infomueblesgacela/muebles-gacela-mvp/public/modelos_3d/linea-nordik/A732330/pasos/instructivo-caja-minifix.webp

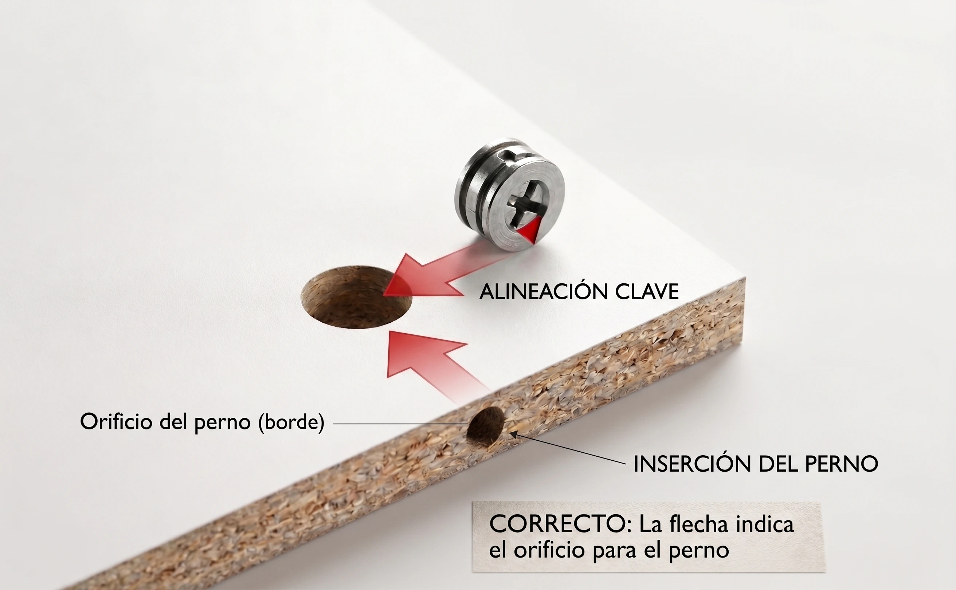
public/modelos_3d/linea-nordik/A732330/pasos/instructivo-caja-minifix.webp
