infomueblesgacela/muebles-gacela-mvp/herrajes/Pasados/cola.png

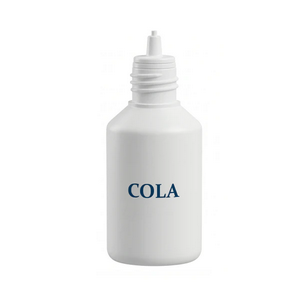
herrajes/Pasados/cola.png
