infomueblesgacela/muebles-gacela-mvp/herrajes/Pasados/manija-con-tornillos-de-3-cm.png

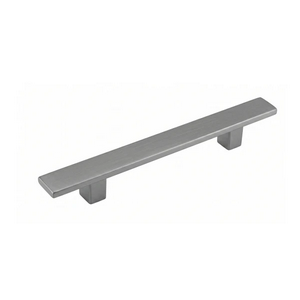
herrajes/Pasados/manija-con-tornillos-de-3-cm.png
