infomueblesgacela/muebles-gacela-mvp/image_0.jpg

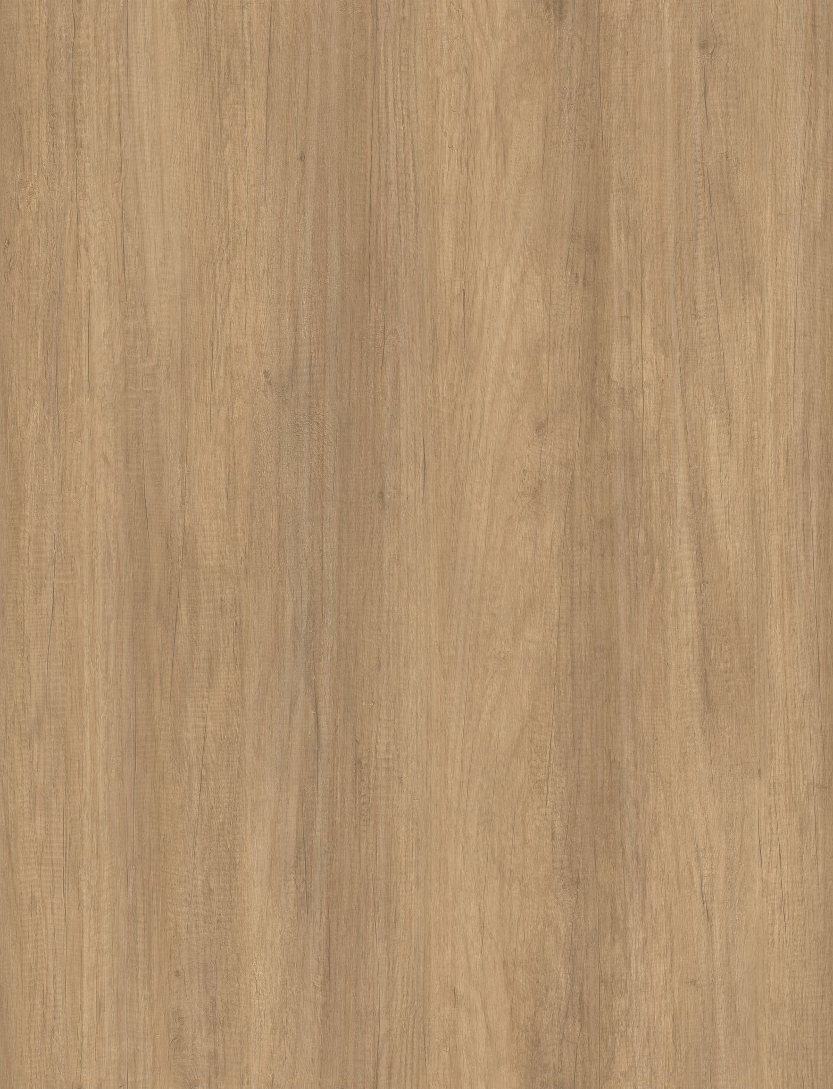
image_0.jpg
