infomueblesgacela/muebles-gacela-mvp/modelos_3d/linea-clasica/A009022/herrajes/tornillo-4-30.webp

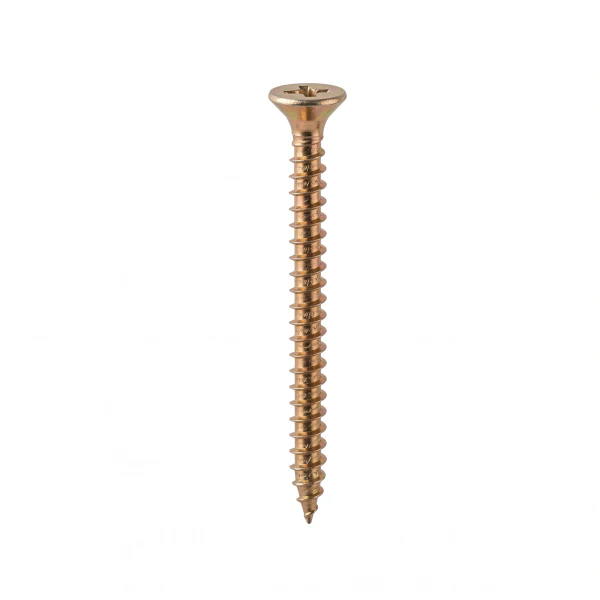
modelos_3d/linea-clasica/A009022/herrajes/tornillo-4-30.webp
