infomueblesgacela/muebles-gacela-mvp/modelos_3d/linea-clasica/A009022/herramientas/destornillador.webp

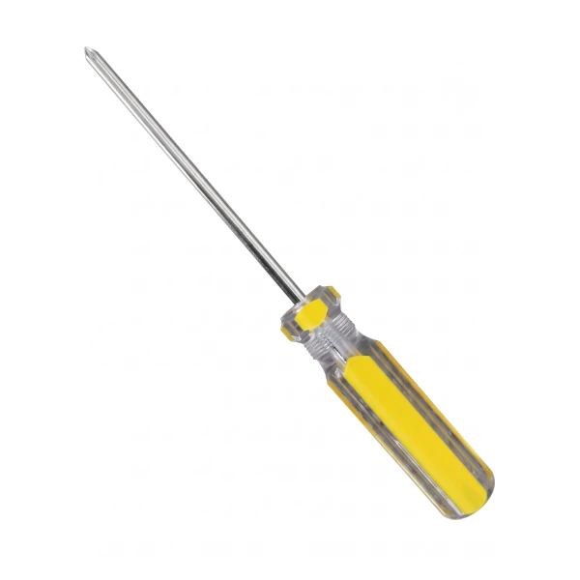
modelos_3d/linea-clasica/A009022/herramientas/destornillador.webp
