infomueblesgacela/muebles-gacela-mvp/modelos_3d/linea-clasica/A710150/herrajes/set-clavos.webp

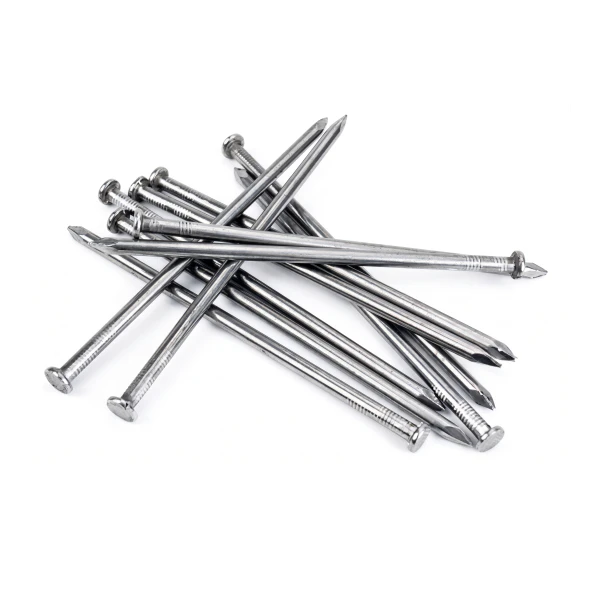
modelos_3d/linea-clasica/A710150/herrajes/set-clavos.webp
