infomueblesgacela/muebles-gacela-mvp/modelos_3d/linea-clasica/A710150/herrajes/tarugo-6-30.webp

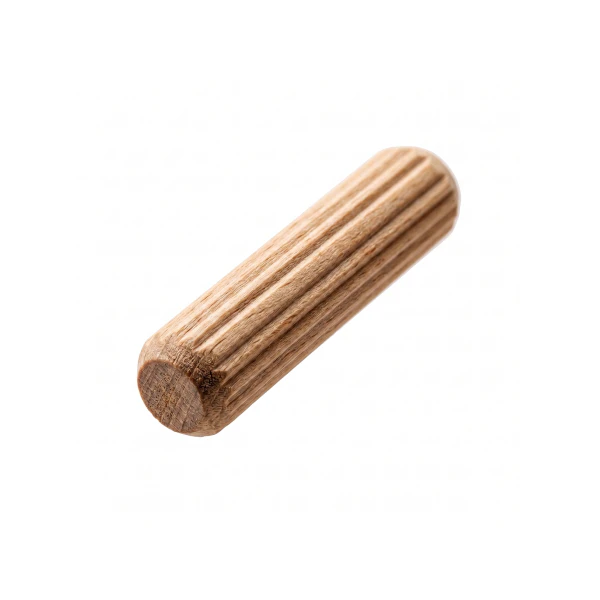
modelos_3d/linea-clasica/A710150/herrajes/tarugo-6-30.webp
