infomueblesgacela/muebles-gacela-mvp/modelos_3d/linea-clasica/A712151/herrajes/guias-metalicas.webp

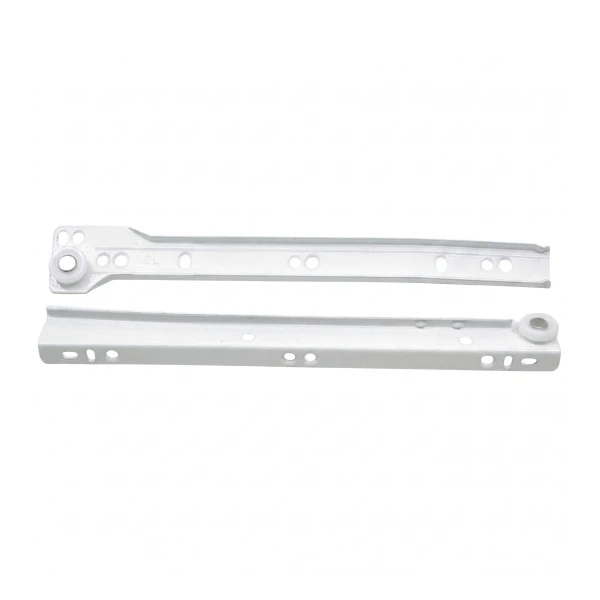
modelos_3d/linea-clasica/A712151/herrajes/guias-metalicas.webp
