infomueblesgacela/muebles-gacela-mvp/modelos_3d/linea-curvalba/A742272/herrajes/escuadra_plastica.webp

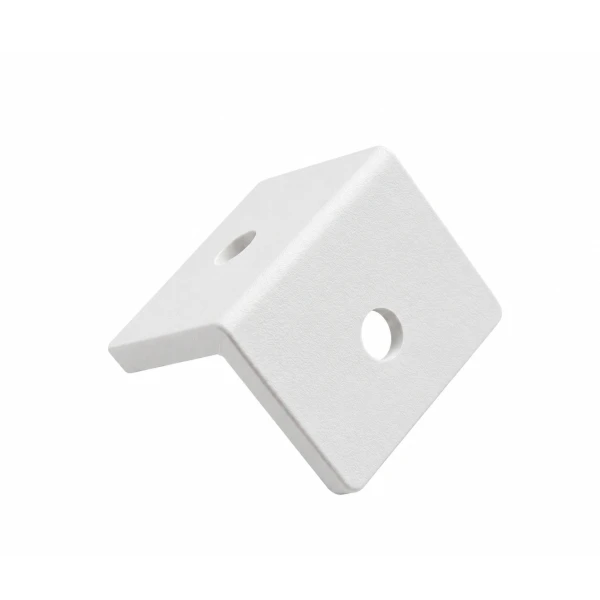
modelos_3d/linea-curvalba/A742272/herrajes/escuadra_plastica.webp
