infomueblesgacela/muebles-gacela-mvp/modelos_3d/linea-kyoto/A315251/herrajes/tornillo_allen.webp

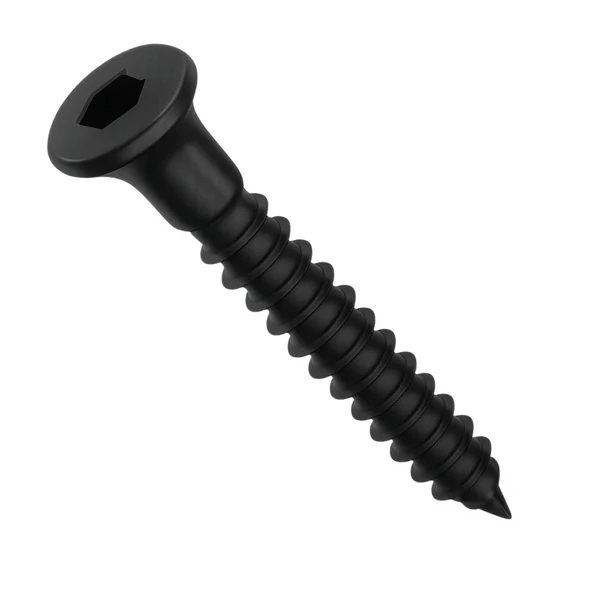
modelos_3d/linea-kyoto/A315251/herrajes/tornillo_allen.webp
