infomueblesgacela/muebles-gacela-mvp/modelos_3d/linea-nordik/A000116/herrajes/tornillo-3-5.webp

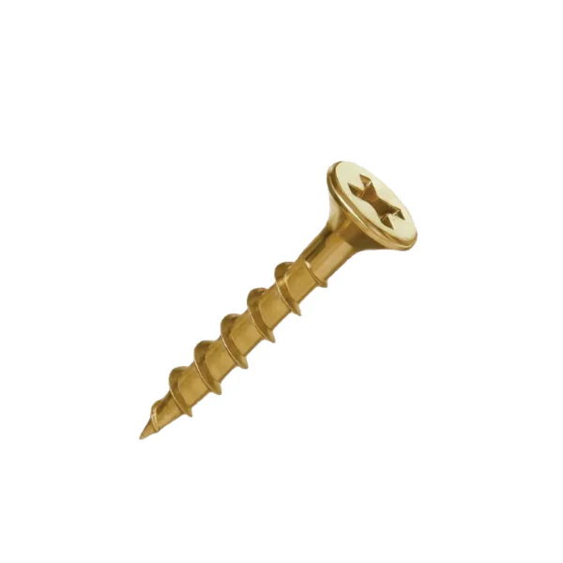
modelos_3d/linea-nordik/A000116/herrajes/tornillo-3-5.webp
