infomueblesgacela/muebles-gacela-mvp/modelos_3d/linea-nordik/A446330/herramientas/llave-allen.webp

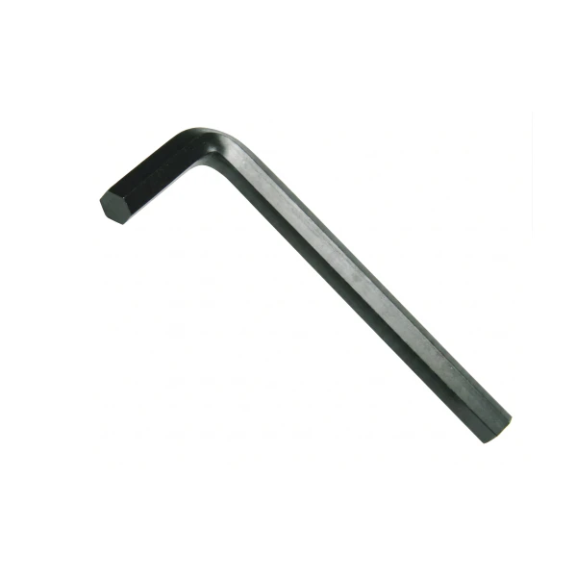
modelos_3d/linea-nordik/A446330/herramientas/llave-allen.webp
