infomueblesgacela/muebles-gacela-mvp/modelos_3d/linea-nordik/A742332/herramientas/martillo.webp

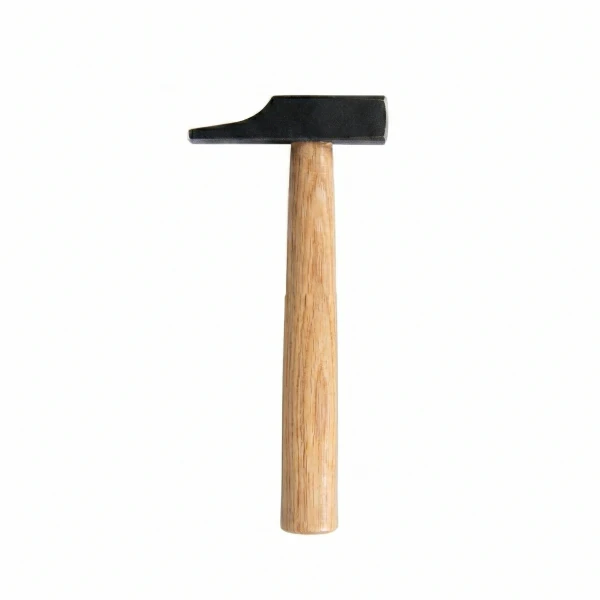
modelos_3d/linea-nordik/A742332/herramientas/martillo.webp
