infomueblesgacela/muebles-gacela-mvp/public/articulos-gacela-muebles-2026/linea-clasica/Art 839-5 (Cómoda ALBA)/roble-blanco/839-5-foto-real-4-v1-a.webp

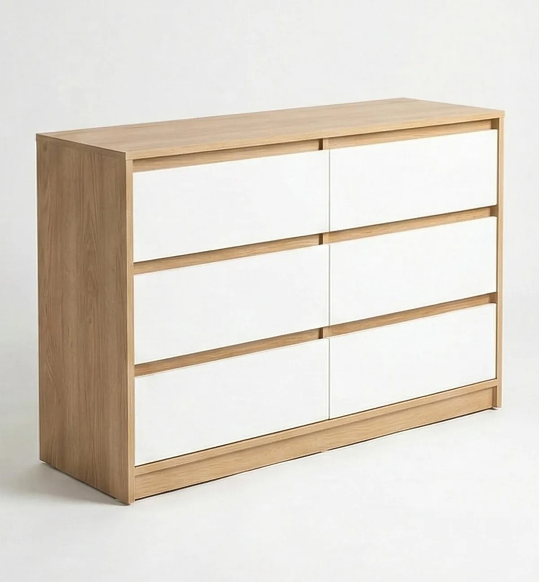
public/articulos-gacela-muebles-2026/linea-clasica/Art 839-5 (Cómoda ALBA)/roble-blanco/839-5-foto-real-4-v1-a.webp
