infomueblesgacela/muebles-gacela-mvp/public/articulos-gacela-muebles-2026/linea-clasica/Art 902-2 (Bahiut GAMMEL)/carvalho/escena-art-902-2-carvalho.webp

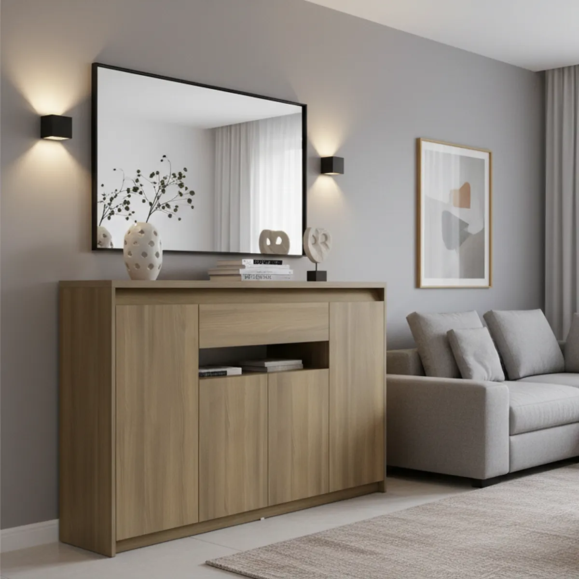
public/articulos-gacela-muebles-2026/linea-clasica/Art 902-2 (Bahiut GAMMEL)/carvalho/escena-art-902-2-carvalho.webp
