infomueblesgacela/muebles-gacela-mvp/public/articulos-gacela-muebles-2026/linea-clasica/art-320-13-placard-specula/art-320-13-medidas.webp

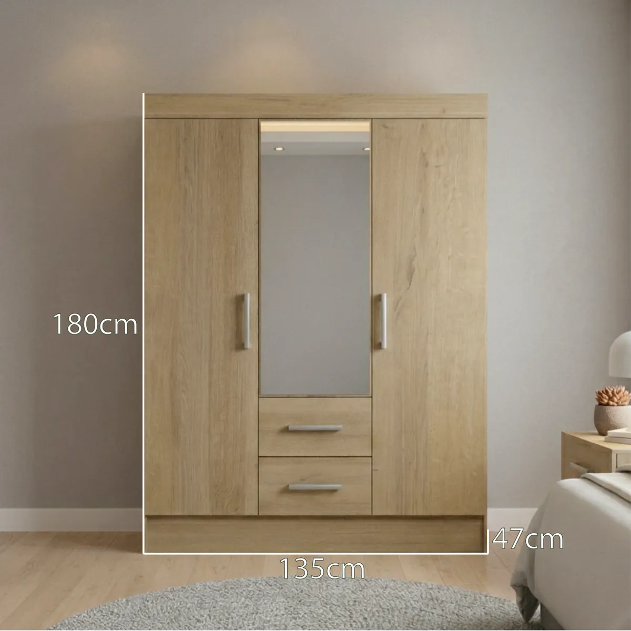
public/articulos-gacela-muebles-2026/linea-clasica/art-320-13-placard-specula/art-320-13-medidas.webp
