infomueblesgacela/muebles-gacela-mvp/public/articulos-gacela-muebles-2026/linea-clasica/art-320-13-placard-specula/escena-art-320-13-carvalho-pf-abierto.webp

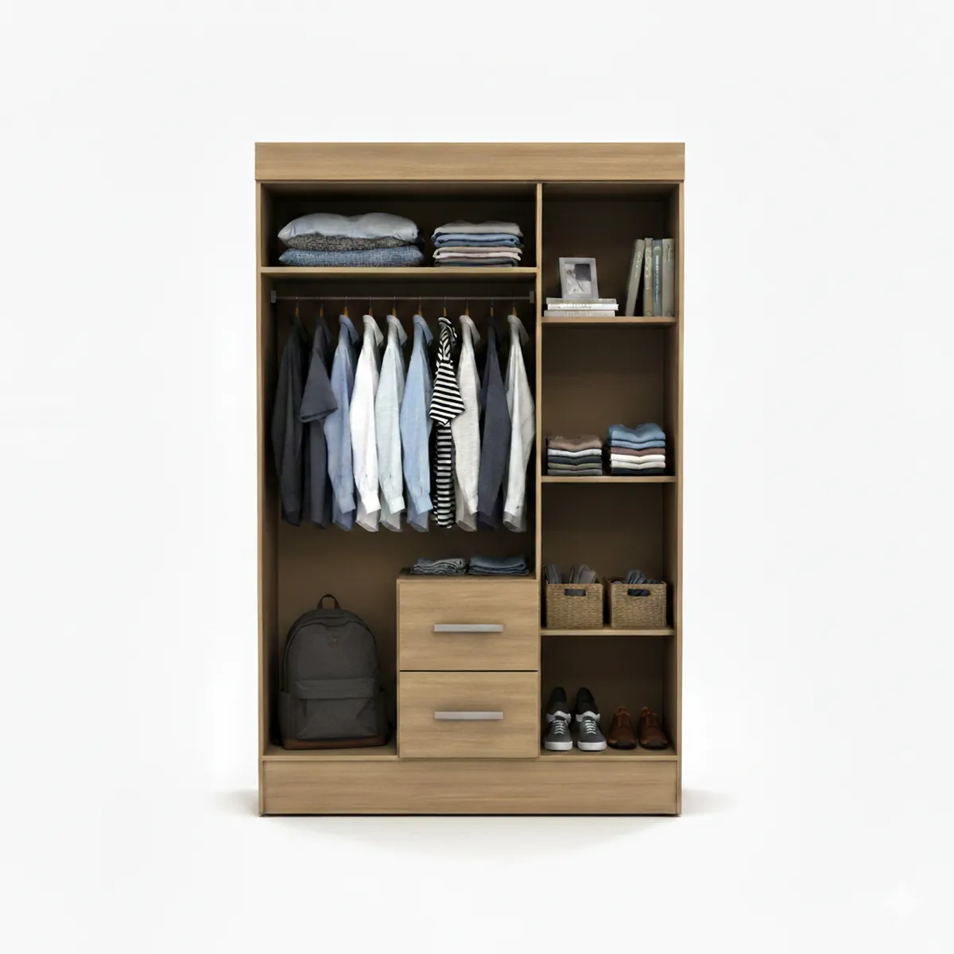
public/articulos-gacela-muebles-2026/linea-clasica/art-320-13-placard-specula/escena-art-320-13-carvalho-pf-abierto.webp
