infomueblesgacela/muebles-gacela-mvp/public/articulos-gacela-muebles-2026/linea-clasica/art-221150-escritorio-opus/art-221150-pf-real-1.webp

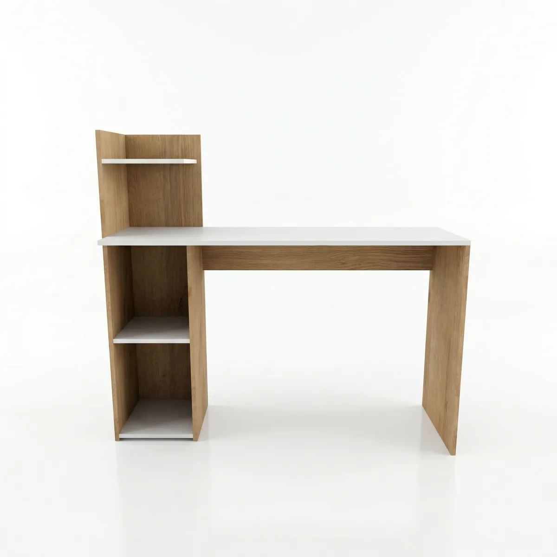
public/articulos-gacela-muebles-2026/linea-clasica/art-221150-escritorio-opus/art-221150-pf-real-1.webp
