infomueblesgacela/muebles-gacela-mvp/public/articulos-gacela-muebles-2026/linea-clasica/art-710150-botinero-arca/art-710150-silueta.webp

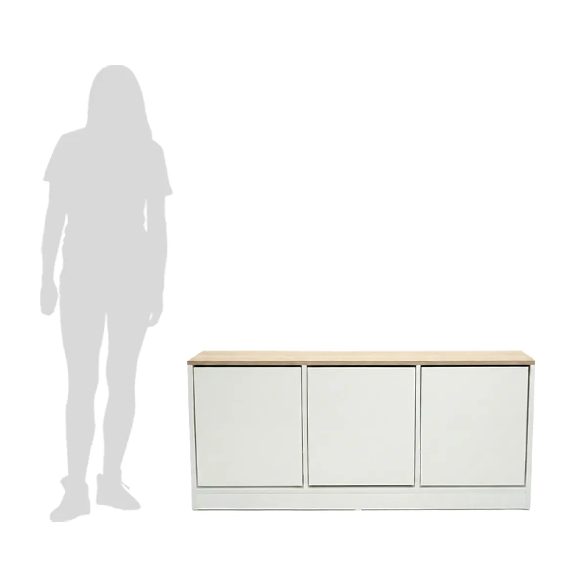
public/articulos-gacela-muebles-2026/linea-clasica/art-710150-botinero-arca/art-710150-silueta.webp
