infomueblesgacela/muebles-gacela-mvp/public/articulos-gacela-muebles-2026/linea-cocina/cocina-lumo/Art-101332.webp

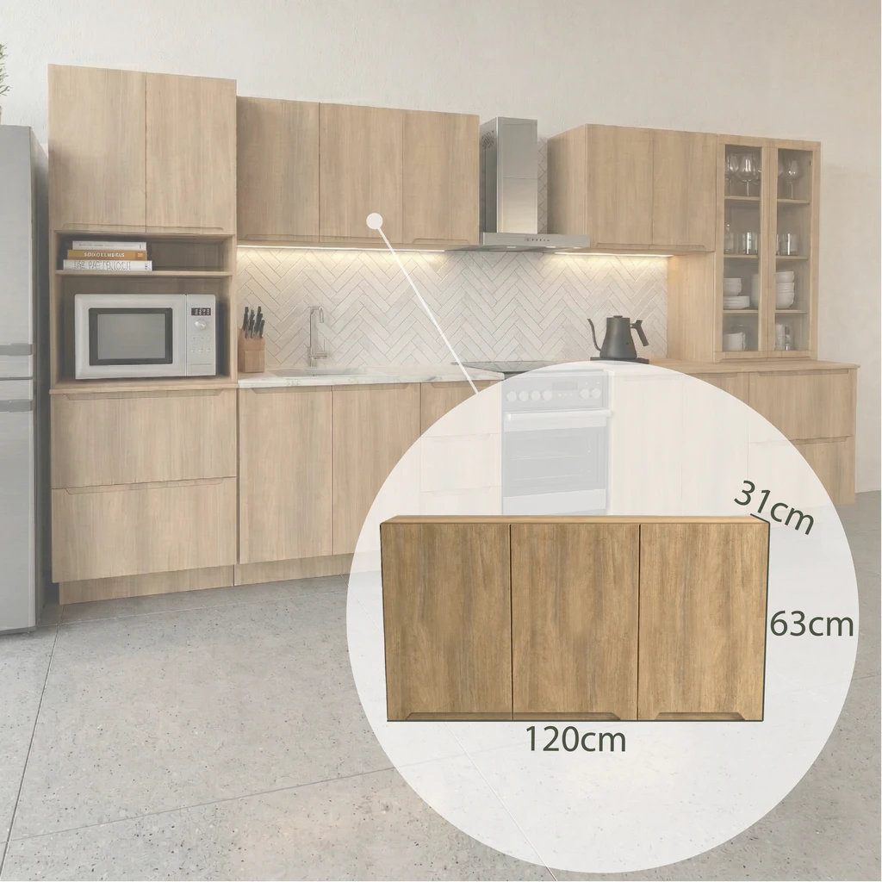
public/articulos-gacela-muebles-2026/linea-cocina/cocina-lumo/Art-101332.webp
