infomueblesgacela/muebles-gacela-mvp/public/articulos-gacela-muebles-2026/linea-comedores/art-557-2-mesa-tampere/art-557-2-pd.webp

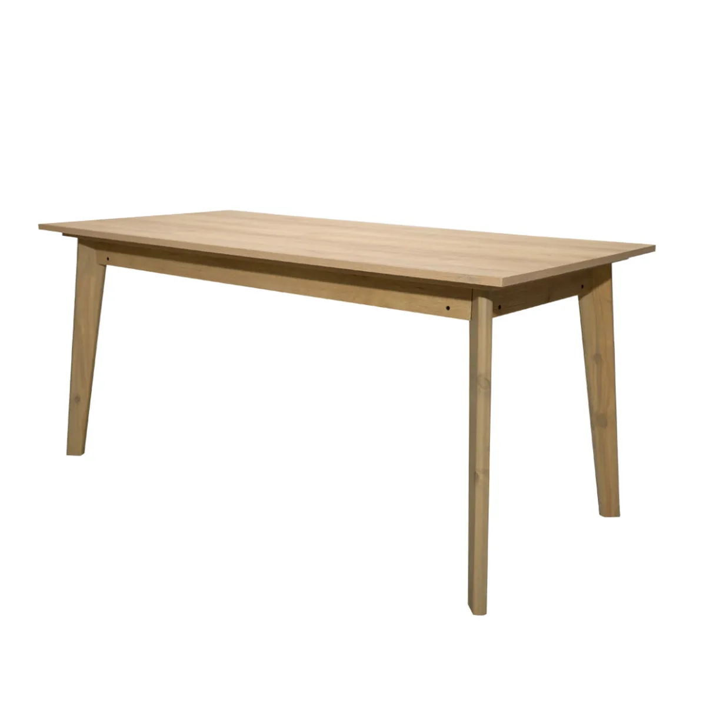
public/articulos-gacela-muebles-2026/linea-comedores/art-557-2-mesa-tampere/art-557-2-pd.webp
