infomueblesgacela/muebles-gacela-mvp/public/articulos-gacela-muebles-2026/linea-comedores/art-557-mesa-leir/art-557-pi.webp

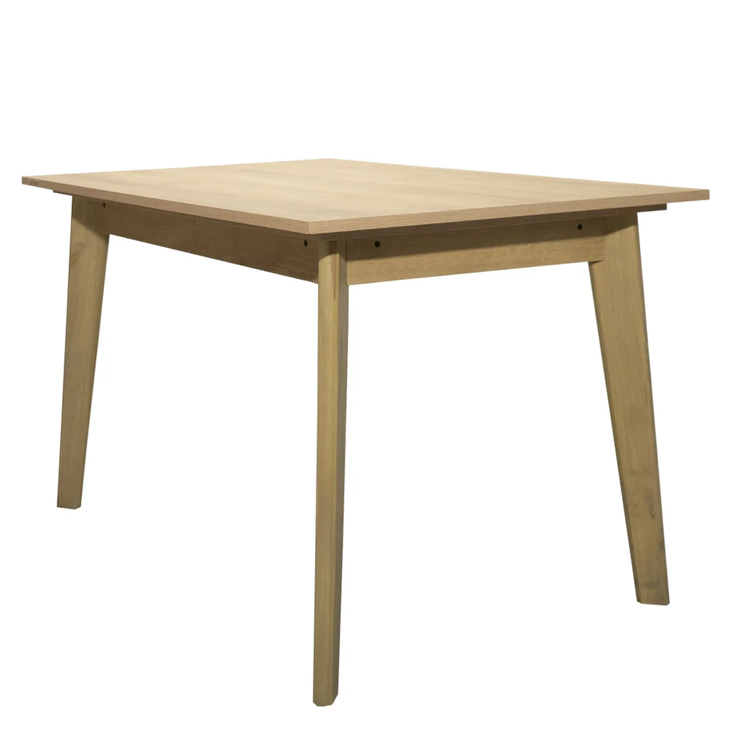
public/articulos-gacela-muebles-2026/linea-comedores/art-557-mesa-leir/art-557-pi.webp
