infomueblesgacela/muebles-gacela-mvp/public/articulos-gacela-muebles-2026/linea-comedores/art-429090-mesa-skien/escena-429090-riviera.webp

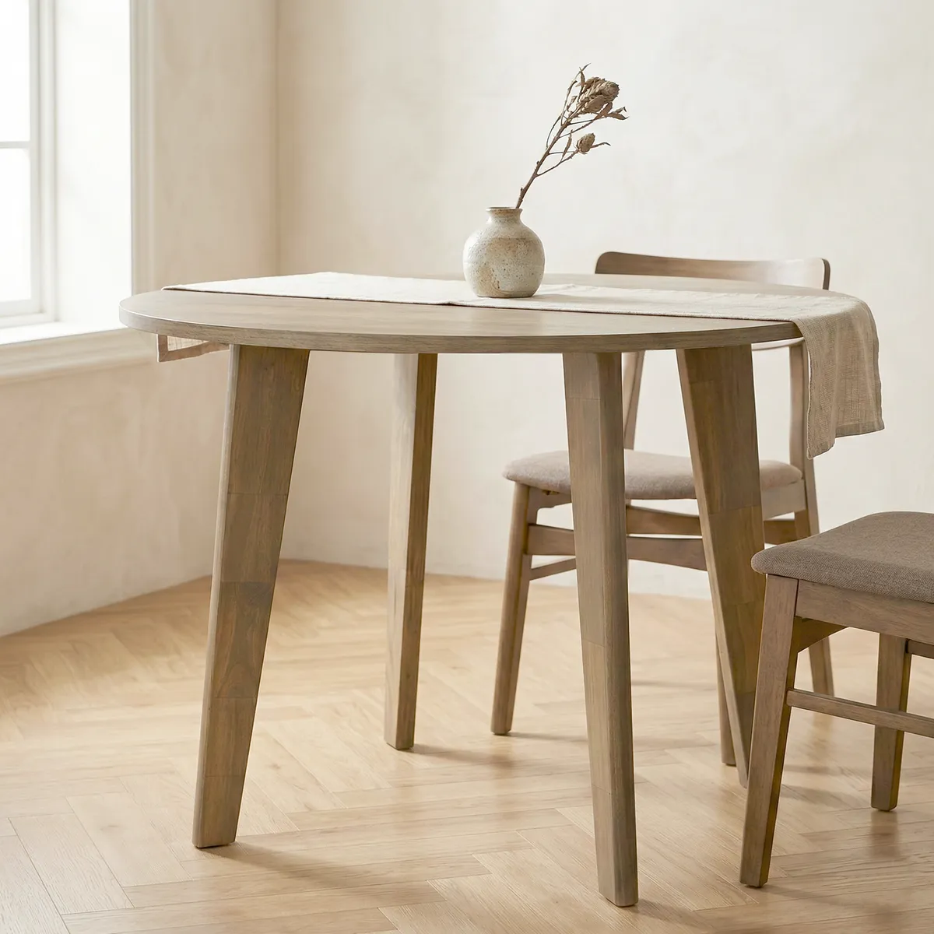
public/articulos-gacela-muebles-2026/linea-comedores/art-429090-mesa-skien/escena-429090-riviera.webp
