infomueblesgacela/muebles-gacela-mvp/public/articulos-gacela-muebles-2026/linea-comedores/art-455090-barra-desayunador-viken/art-455090-silueta.webp

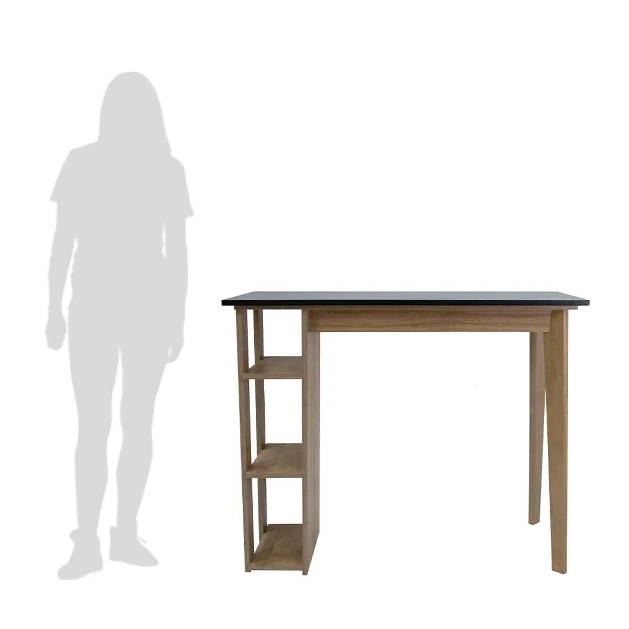
public/articulos-gacela-muebles-2026/linea-comedores/art-455090-barra-desayunador-viken/art-455090-silueta.webp
