infomueblesgacela/muebles-gacela-mvp/public/articulos-gacela-muebles-2026/linea-curvalba/art-372150-set-de-mesas-loire/art-372150-silueta.webp

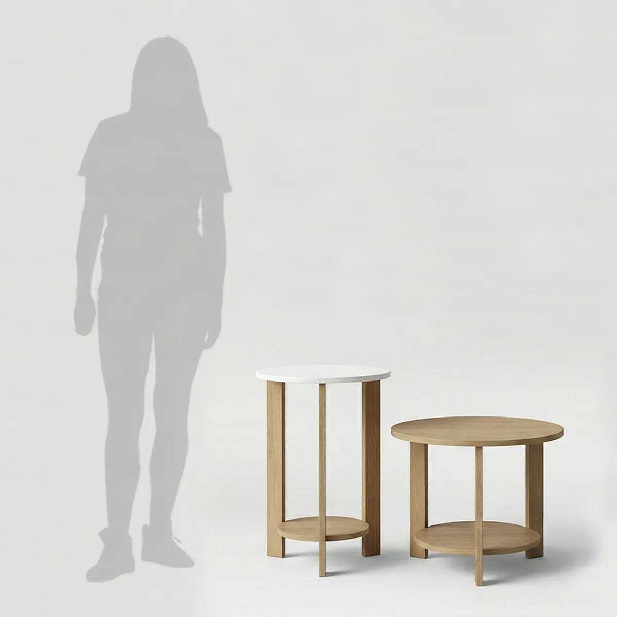
public/articulos-gacela-muebles-2026/linea-curvalba/art-372150-set-de-mesas-loire/art-372150-silueta.webp
