infomueblesgacela/muebles-gacela-mvp/public/articulos-gacela-muebles-2026/linea-curvalba/art-405270-bahiut-tagus/405270-foto-real-5.webp

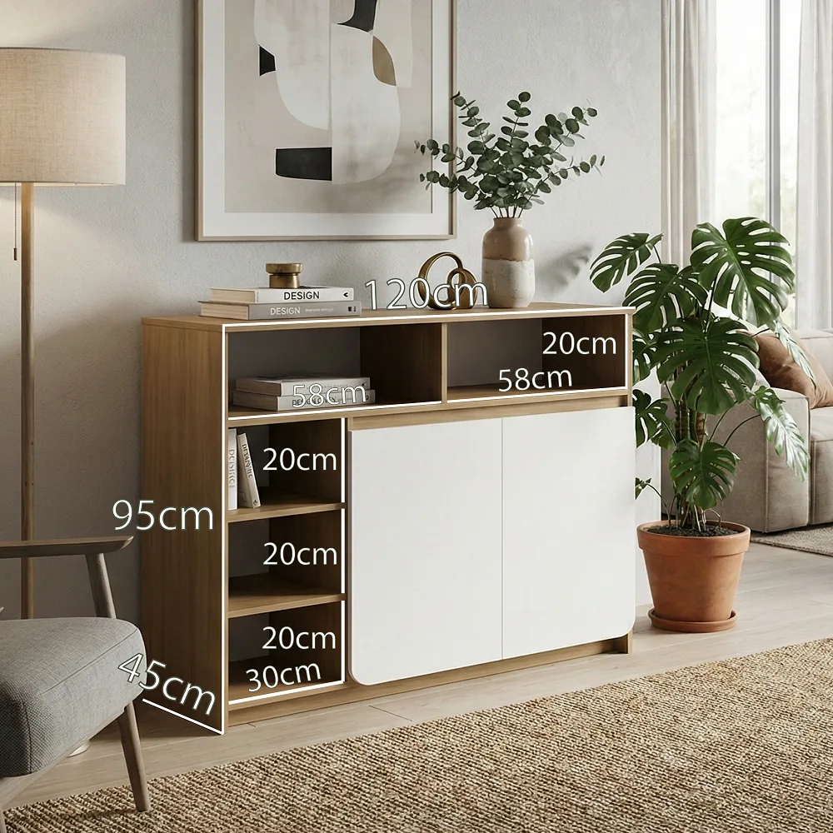
public/articulos-gacela-muebles-2026/linea-curvalba/art-405270-bahiut-tagus/405270-foto-real-5.webp
