infomueblesgacela/muebles-gacela-mvp/public/articulos-gacela-muebles-2026/linea-curvalba/art-732270-mesa-de-luz-limay/732270-foto-real-4.webp

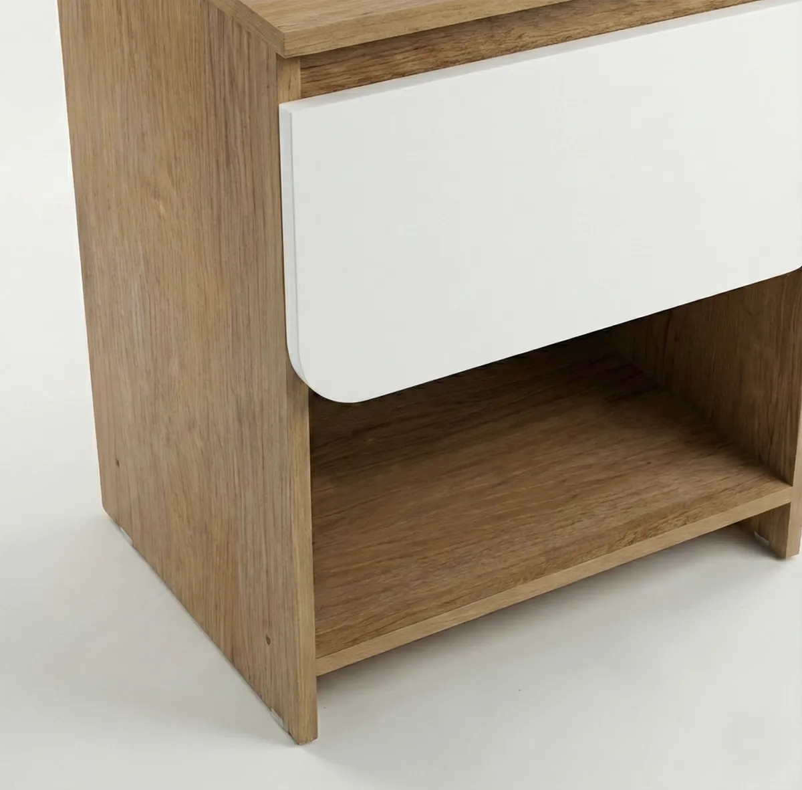
public/articulos-gacela-muebles-2026/linea-curvalba/art-732270-mesa-de-luz-limay/732270-foto-real-4.webp
