infomueblesgacela/muebles-gacela-mvp/public/articulos-gacela-muebles-2026/linea-curvalba/art-742272-placard-volga/art-742272-pi-real-2.webp

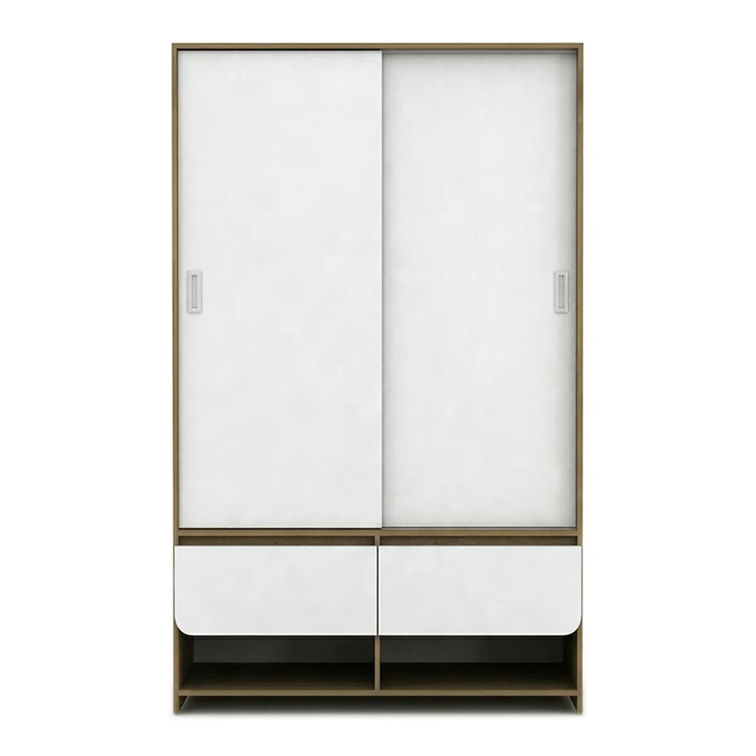
public/articulos-gacela-muebles-2026/linea-curvalba/art-742272-placard-volga/art-742272-pi-real-2.webp
