infomueblesgacela/muebles-gacela-mvp/public/articulos-gacela-muebles-2026/linea-curvalba/art-742273-placard-seine/art-742273-pf-con-ropa.webp

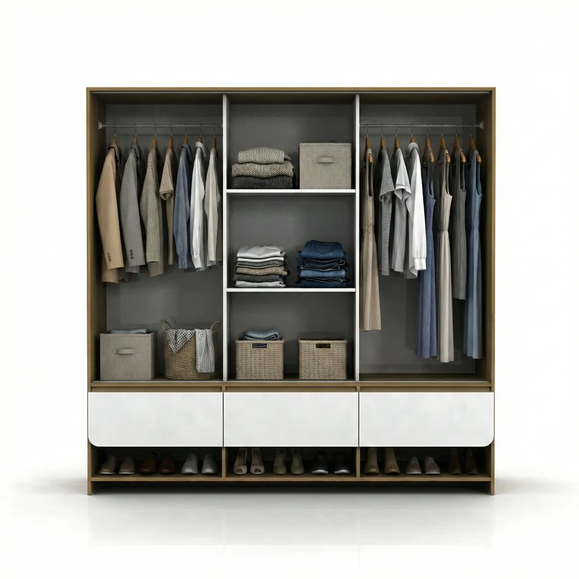
public/articulos-gacela-muebles-2026/linea-curvalba/art-742273-placard-seine/art-742273-pf-con-ropa.webp
