infomueblesgacela/muebles-gacela-mvp/public/articulos-gacela-muebles-2026/linea-gamer/Art 734222 (Escritorio FENIX)/blanco/escena-art-734222-blanco.webp

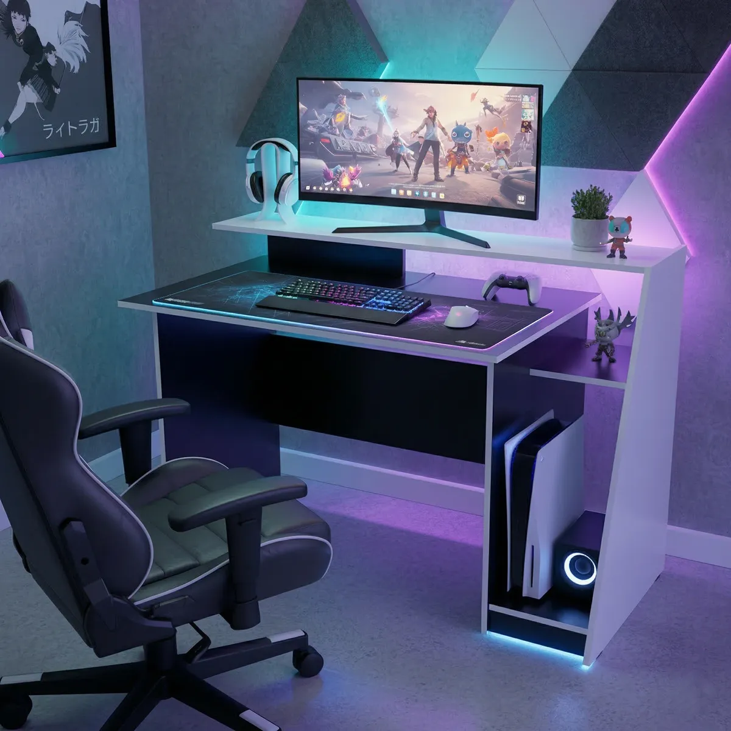
public/articulos-gacela-muebles-2026/linea-gamer/Art 734222 (Escritorio FENIX)/blanco/escena-art-734222-blanco.webp
