infomueblesgacela/muebles-gacela-mvp/public/articulos-gacela-muebles-2026/linea-infantil/art-740151-organizador-capibara/art-740151-capibara-medidas.webp

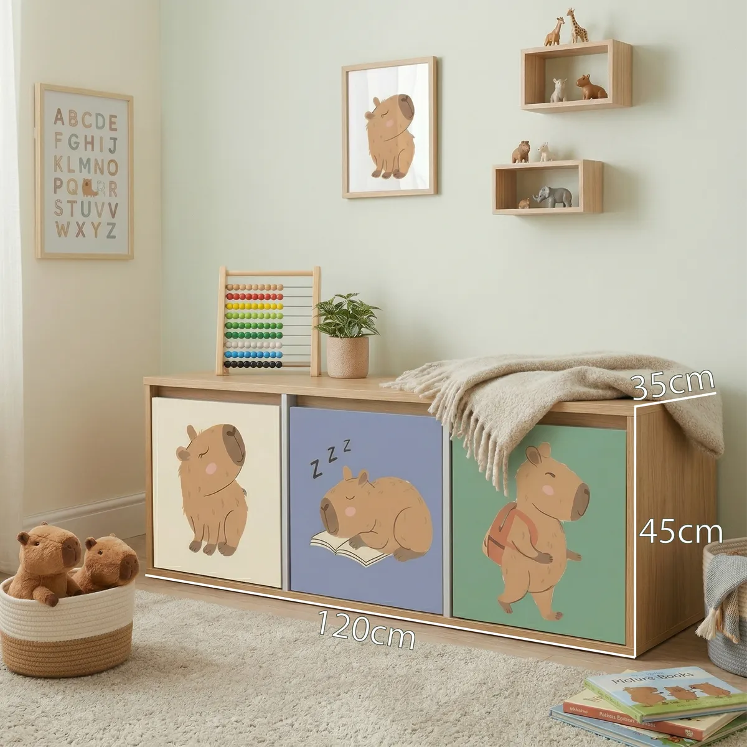
public/articulos-gacela-muebles-2026/linea-infantil/art-740151-organizador-capibara/art-740151-capibara-medidas.webp
