infomueblesgacela/muebles-gacela-mvp/public/articulos-gacela-muebles-2026/linea-kyoto/art-315250-centro-de-entretenimiento-kobe/art-315250-silueta-blanco.webp

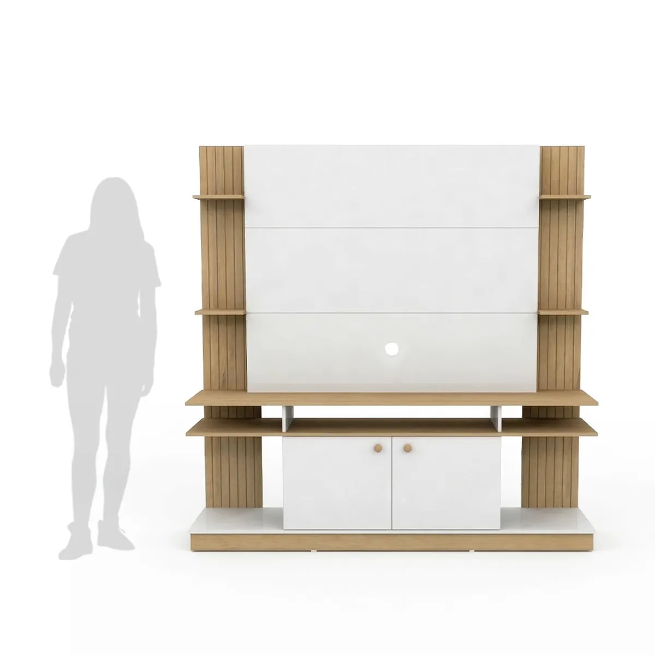
public/articulos-gacela-muebles-2026/linea-kyoto/art-315250-centro-de-entretenimiento-kobe/art-315250-silueta-blanco.webp
