infomueblesgacela/muebles-gacela-mvp/public/articulos-gacela-muebles-2026/linea-kyoto/art-446250-rack-fukuoka/446250-foto-real-1.webp

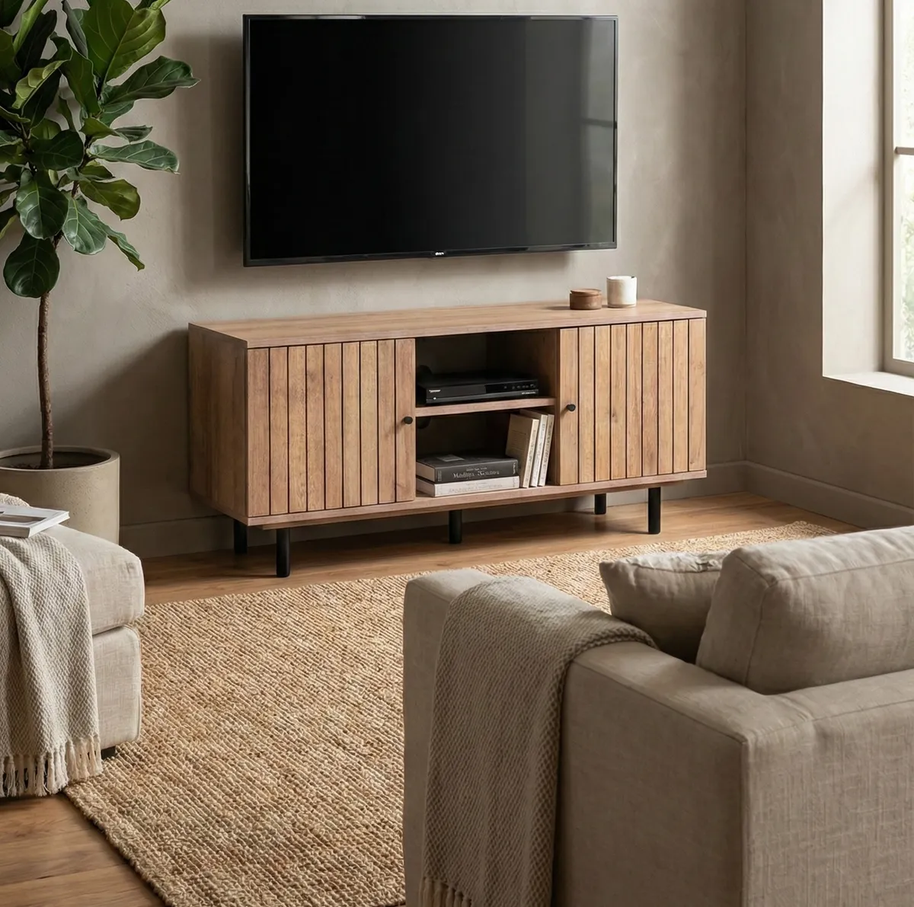
public/articulos-gacela-muebles-2026/linea-kyoto/art-446250-rack-fukuoka/446250-foto-real-1.webp
