infomueblesgacela/muebles-gacela-mvp/public/articulos-gacela-muebles-2026/linea-kyoto/art-760250-bahiut-nagoya/escena-art-760250-a.webp

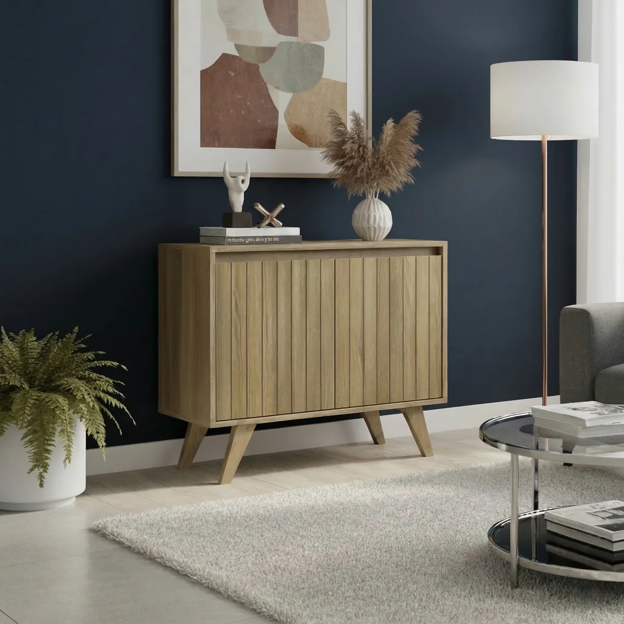
public/articulos-gacela-muebles-2026/linea-kyoto/art-760250-bahiut-nagoya/escena-art-760250-a.webp
