infomueblesgacela/muebles-gacela-mvp/public/articulos-gacela-muebles-2026/linea-nordik/art-234094-escritorio-hamar/234094-foto-real-2.webp

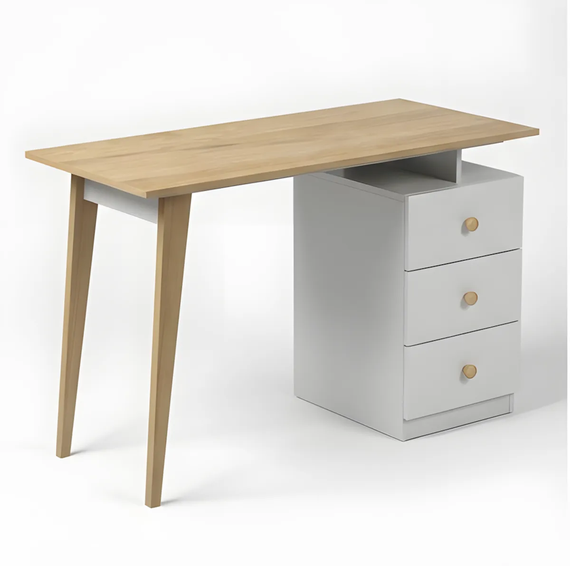
public/articulos-gacela-muebles-2026/linea-nordik/art-234094-escritorio-hamar/234094-foto-real-2.webp
