infomueblesgacela/muebles-gacela-mvp/public/articulos-gacela-muebles-2026/linea-nordik/art-334026-escritorio-skog/art-334026-medidas.webp

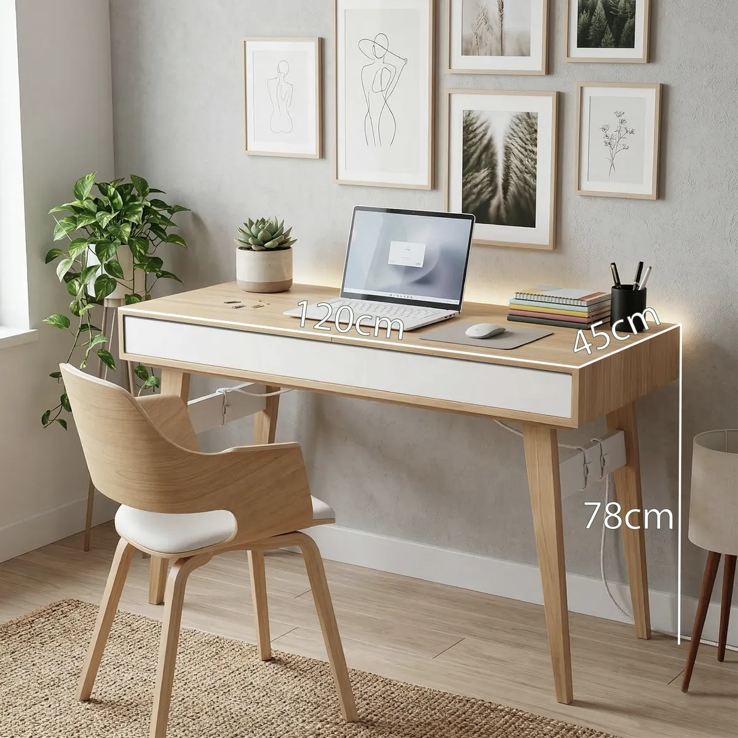
public/articulos-gacela-muebles-2026/linea-nordik/art-334026-escritorio-skog/art-334026-medidas.webp
