infomueblesgacela/muebles-gacela-mvp/public/articulos-gacela-muebles-2026/linea-nordik/art-334330-escritorio-tra/334330-foto-real-1.webp

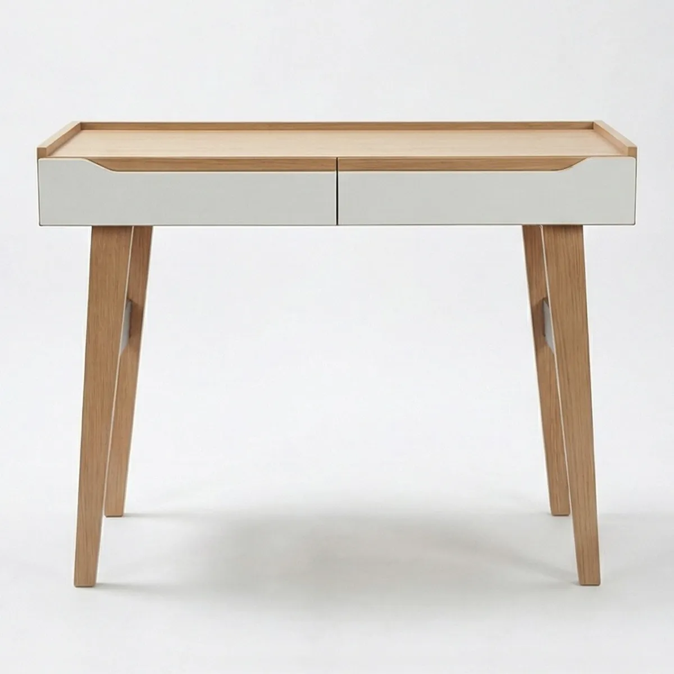
public/articulos-gacela-muebles-2026/linea-nordik/art-334330-escritorio-tra/334330-foto-real-1.webp
