infomueblesgacela/muebles-gacela-mvp/public/articulos-gacela-muebles-2026/linea-nordik/art-372080-set-de-mesas-crux-alde/372080-foto-real-medidas.webp

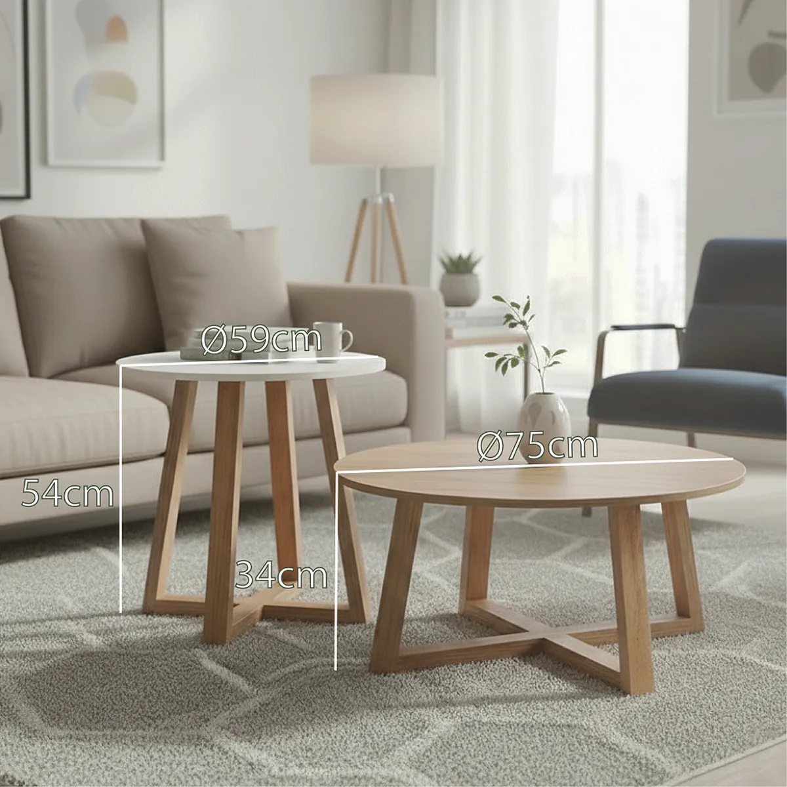
public/articulos-gacela-muebles-2026/linea-nordik/art-372080-set-de-mesas-crux-alde/372080-foto-real-medidas.webp
