infomueblesgacela/muebles-gacela-mvp/public/articulos-gacela-muebles-2026/linea-nordik/art-732330-mesa-de-luz-arka/art-732330-medidas.webp

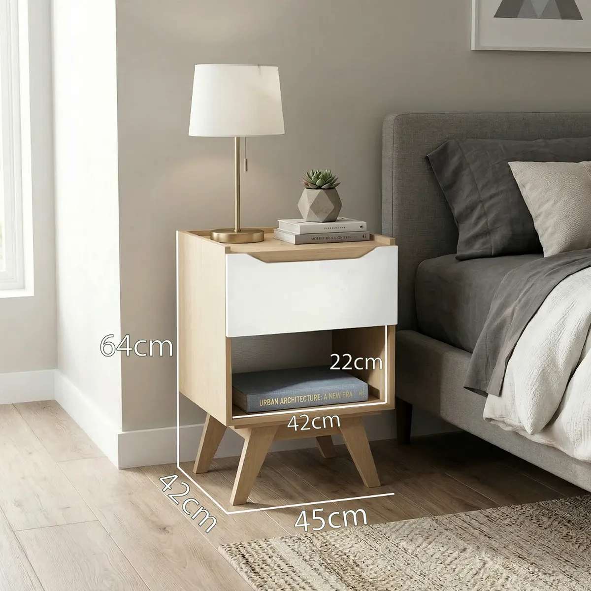
public/articulos-gacela-muebles-2026/linea-nordik/art-732330-mesa-de-luz-arka/art-732330-medidas.webp
