infomueblesgacela/muebles-gacela-mvp/public/images/1991.webp

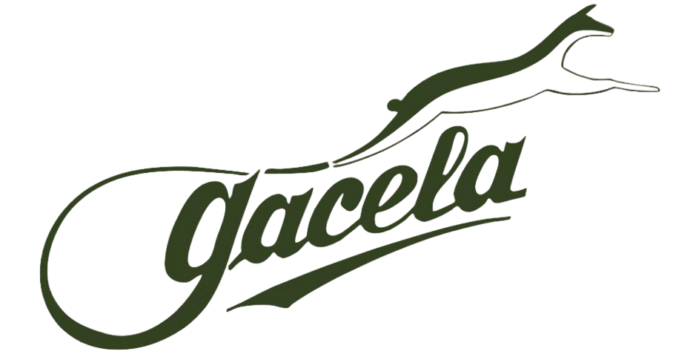
public/images/1991.webp
