infomueblesgacela/muebles-gacela-mvp/public/images/2016.webp

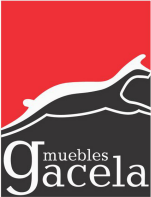
public/images/2016.webp
