infomueblesgacela/muebles-gacela-mvp/public/images/2025.webp

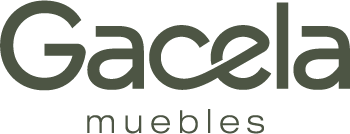
public/images/2025.webp
