infomueblesgacela/muebles-gacela-mvp/public/images/aberturas_obras/20161025_145010.webp

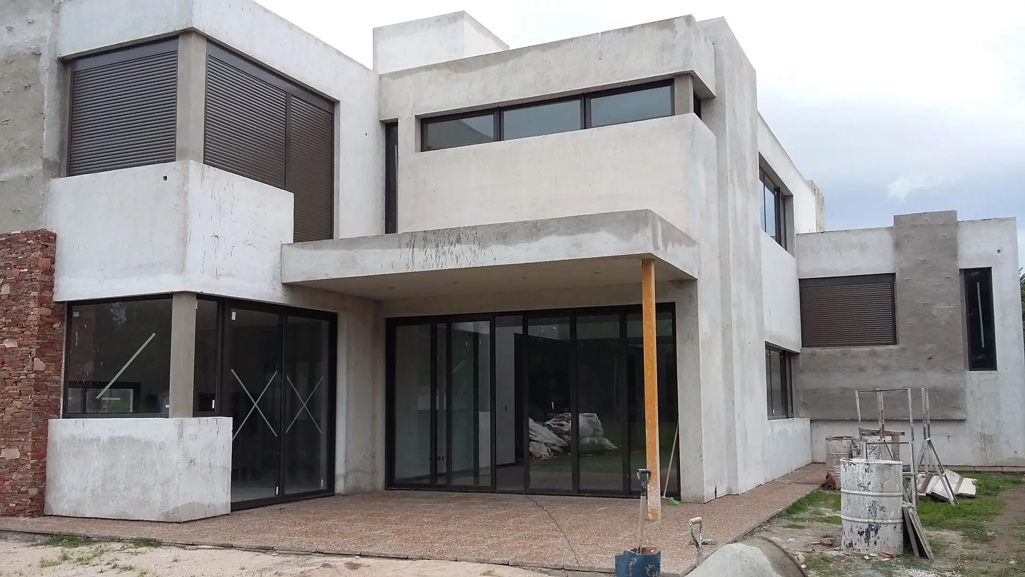
public/images/aberturas_obras/20161025_145010.webp
