infomueblesgacela/muebles-gacela-mvp/public/images/aberturas_obras/470191124_1106952170877088_8938724384557469885_n.webp

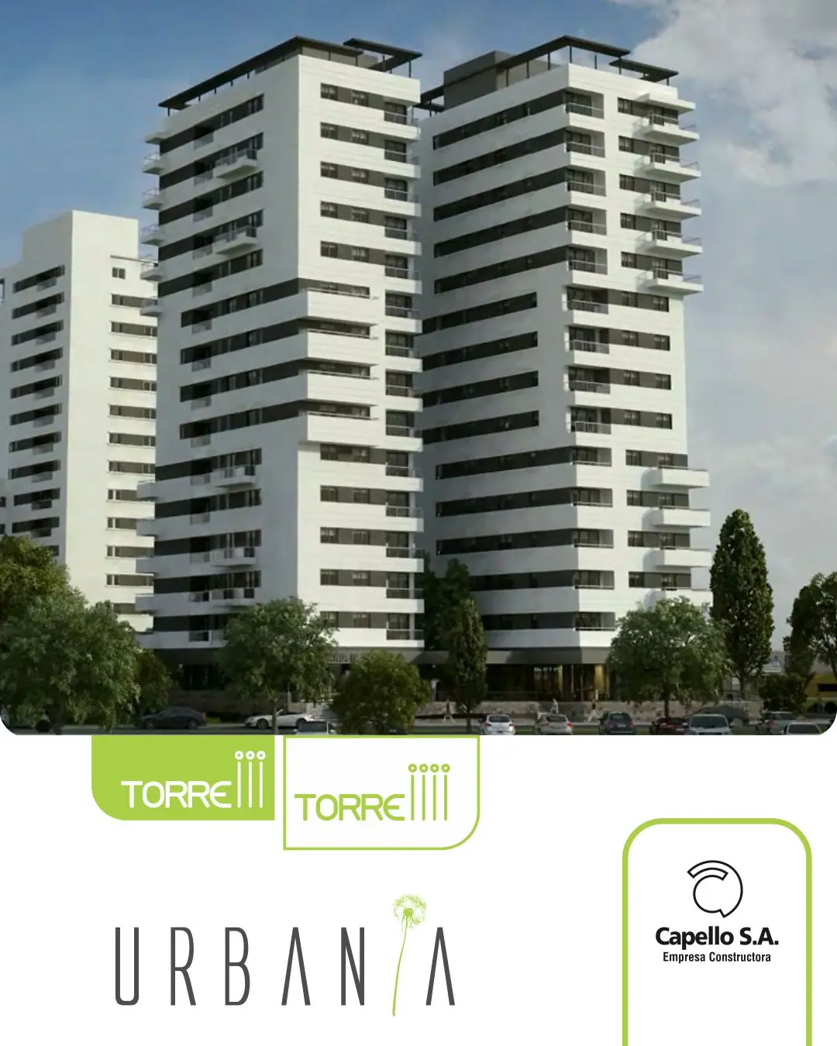
public/images/aberturas_obras/470191124_1106952170877088_8938724384557469885_n.webp
