infomueblesgacela/muebles-gacela-mvp/public/images/aberturas_obras/475082741_608613485253160_1745073460008066477_n.webp

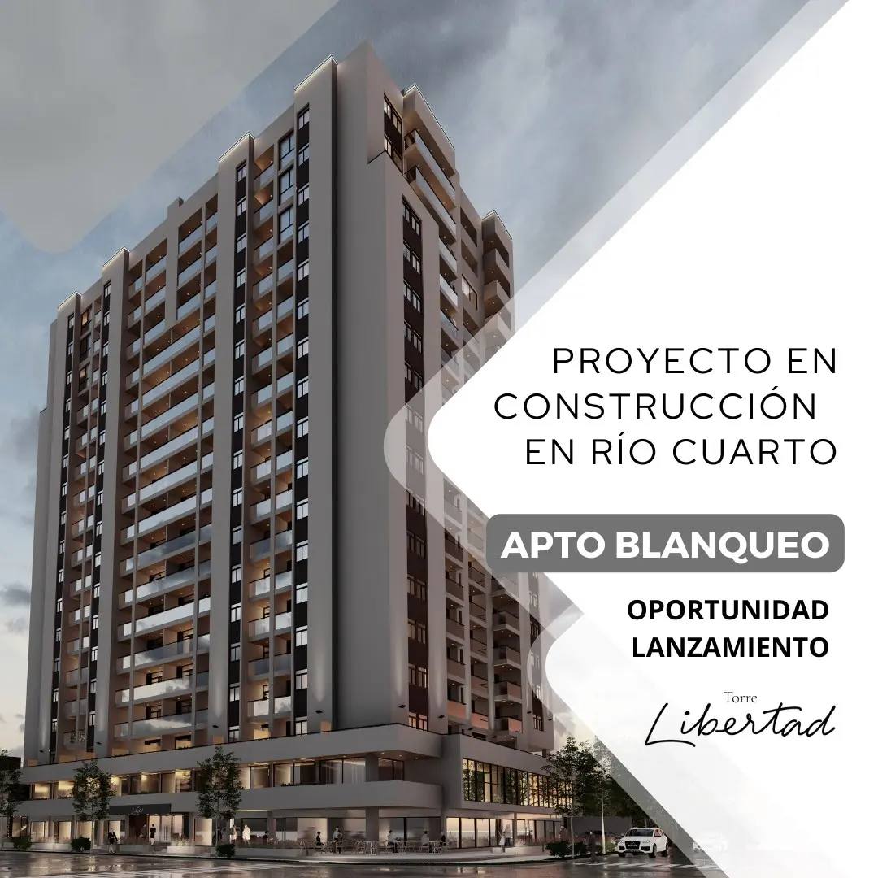
public/images/aberturas_obras/475082741_608613485253160_1745073460008066477_n.webp
