infomueblesgacela/muebles-gacela-mvp/public/images/aberturas_obras/Capello 2.webp

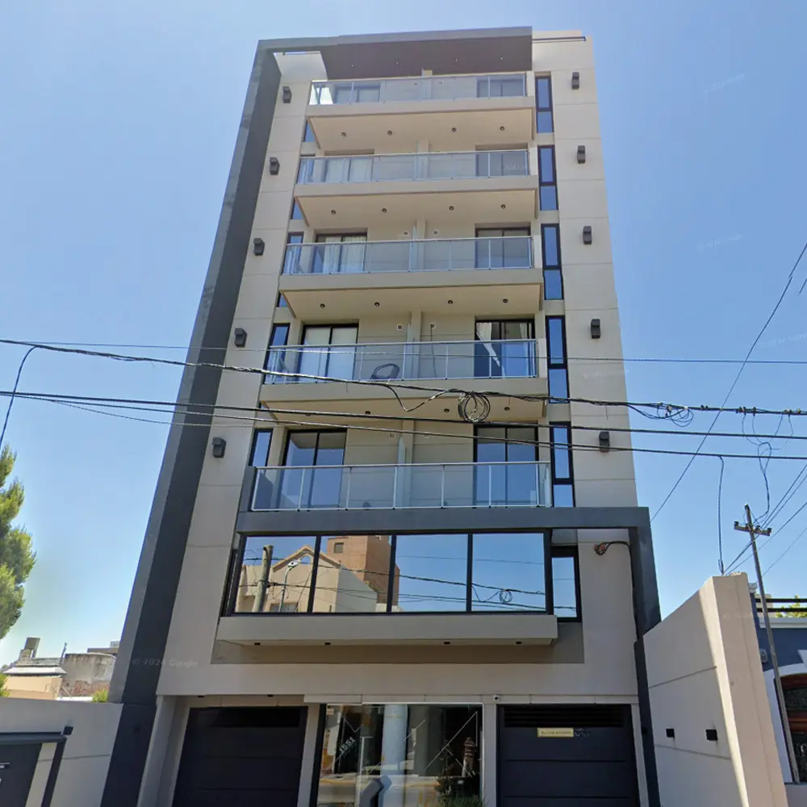
public/images/aberturas_obras/Capello 2.webp
