infomueblesgacela/muebles-gacela-mvp/public/images/aberturas_obras/Insignia-360-Insignia-360-.webp

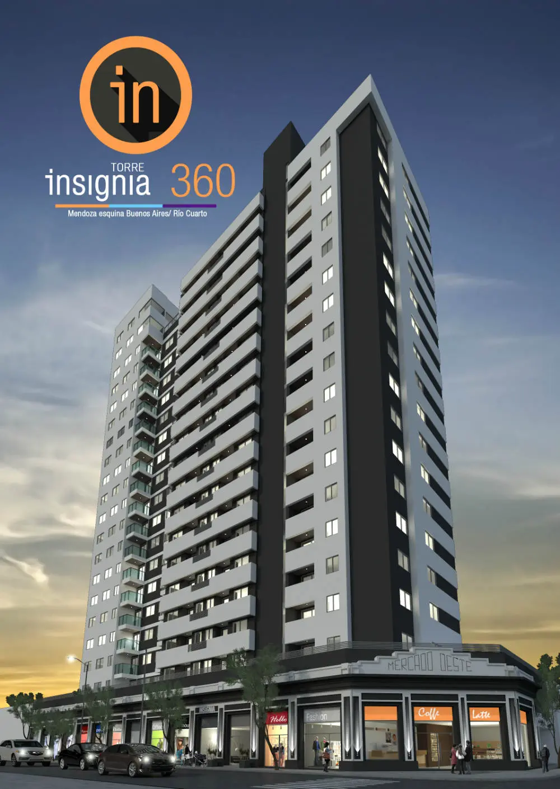
public/images/aberturas_obras/Insignia-360-Insignia-360-.webp
