infomueblesgacela/muebles-gacela-mvp/public/images/aberturas_obras/Sin título-1.webp

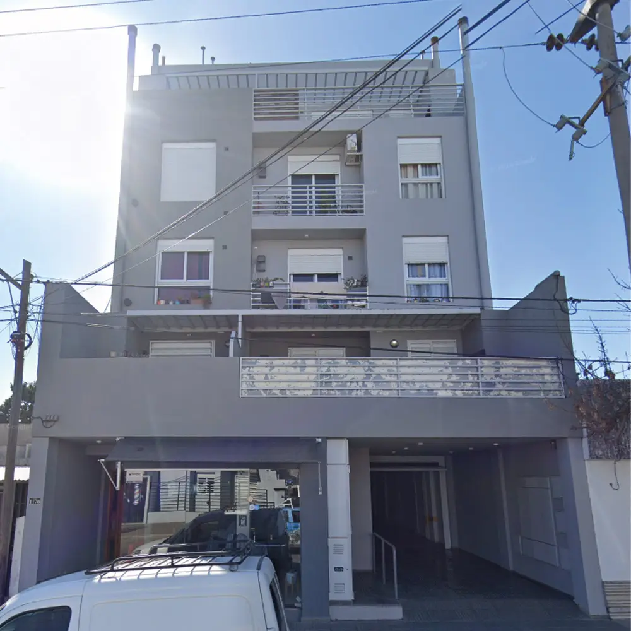
public/images/aberturas_obras/Sin título-1.webp
