infomueblesgacela/muebles-gacela-mvp/public/images/aberturas_obras/WhatsApp Image 2025-07-17 at 3.08.42 PM (1).webp

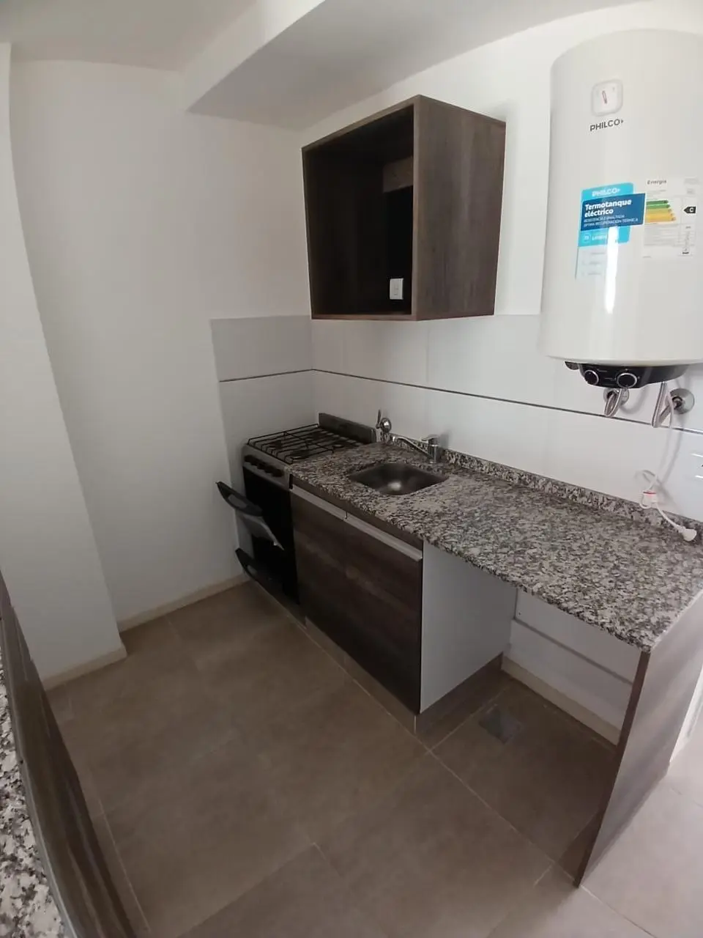
public/images/aberturas_obras/WhatsApp Image 2025-07-17 at 3.08.42 PM (1).webp
