infomueblesgacela/muebles-gacela-mvp/public/images/aberturas_obras/WhatsApp Image 2025-09-16 at 10.07.52.webp

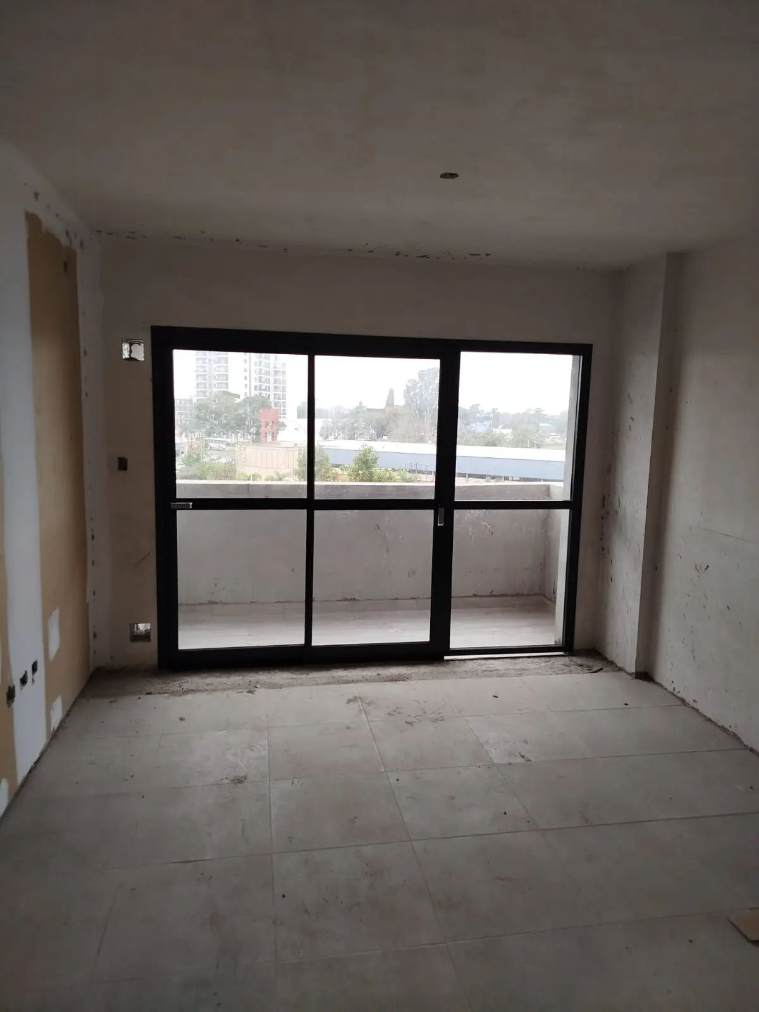
public/images/aberturas_obras/WhatsApp Image 2025-09-16 at 10.07.52.webp
