infomueblesgacela/muebles-gacela-mvp/public/images/aberturas_obras/WhatsApp Image 2025-11-05 at 16.02.42.webp

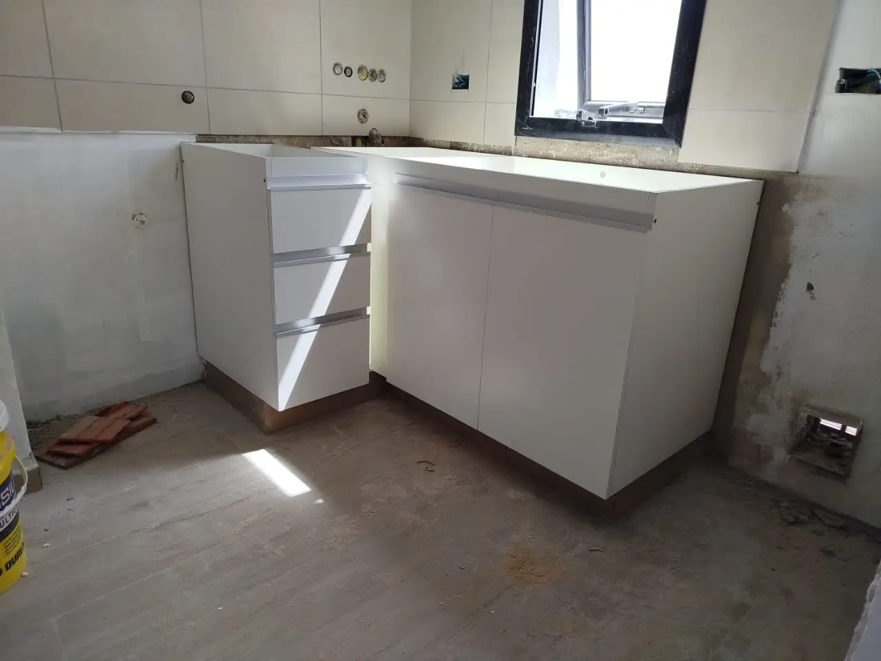
public/images/aberturas_obras/WhatsApp Image 2025-11-05 at 16.02.42.webp
