infomueblesgacela/muebles-gacela-mvp/public/images/aberturas_obras/WhatsApp Image 2025-11-13 at 07.58.39 (1).webp

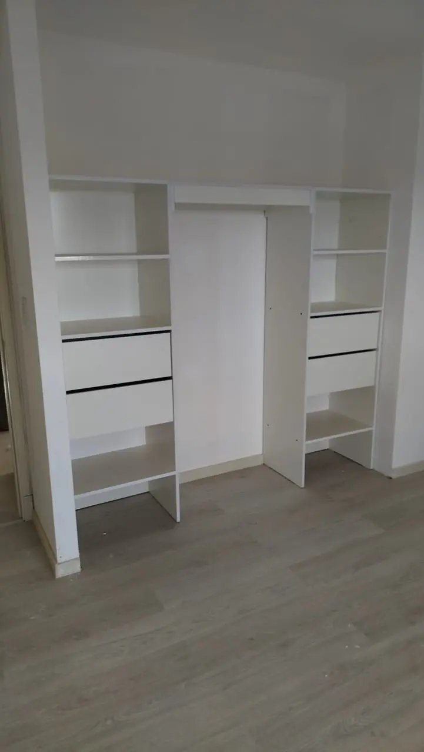
public/images/aberturas_obras/WhatsApp Image 2025-11-13 at 07.58.39 (1).webp
