infomueblesgacela/muebles-gacela-mvp/public/images/clientes/Recurso 4.webp

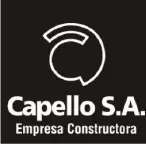
public/images/clientes/Recurso 4.webp
