infomueblesgacela/muebles-gacela-mvp/public/images/clientes/Recurso 5.webp

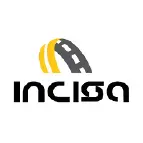
public/images/clientes/Recurso 5.webp
