infomueblesgacela/muebles-gacela-mvp/public/images/clientes/Recurso 6.webp

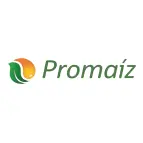
public/images/clientes/Recurso 6.webp
