infomueblesgacela/muebles-gacela-mvp/public/images/clientes/Recurso 7.webp

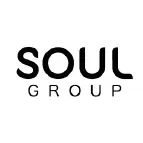
public/images/clientes/Recurso 7.webp
