infomueblesgacela/muebles-gacela-mvp/public/images/Cocina.webp

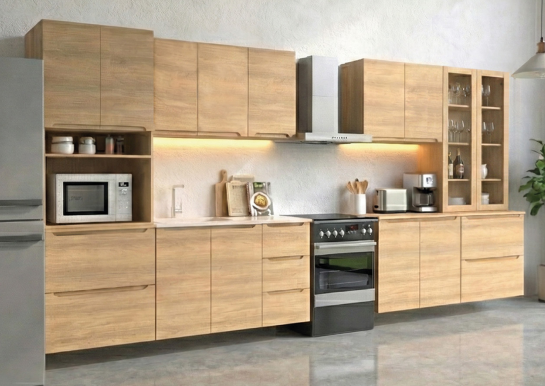
public/images/Cocina.webp
