infomueblesgacela/muebles-gacela-mvp/public/images/eco.png

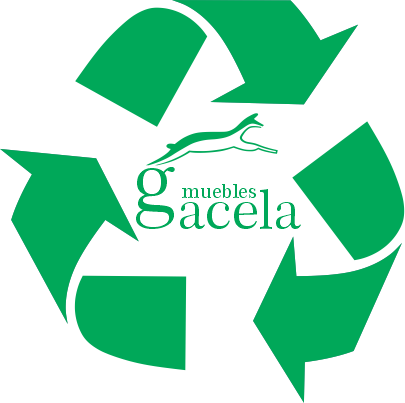
public/images/eco.png
