infomueblesgacela/muebles-gacela-mvp/public/images/Equipo.webp

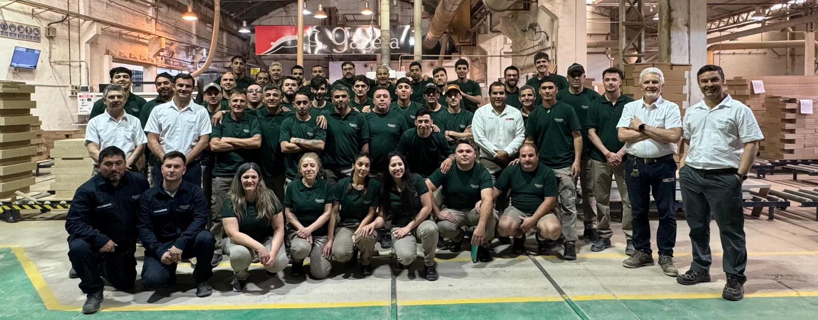
public/images/Equipo.webp
