infomueblesgacela/muebles-gacela-mvp/public/images/Fábrica.webp

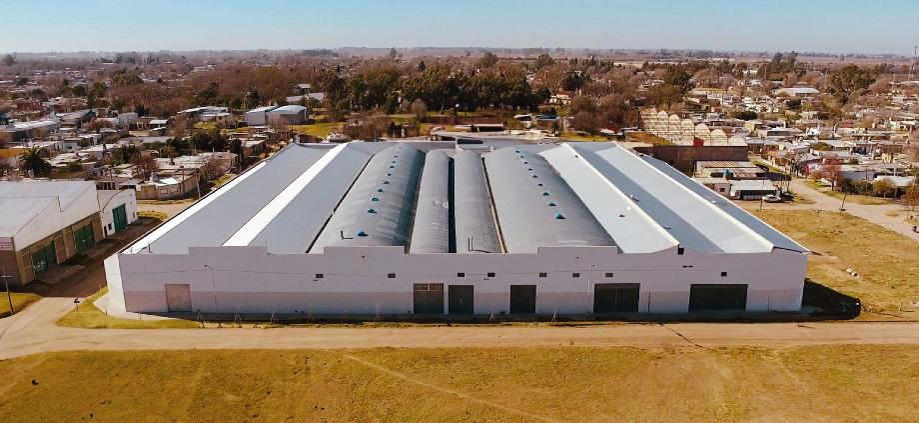
public/images/Fábrica.webp
