infomueblesgacela/muebles-gacela-mvp/public/images/Gacela.webp

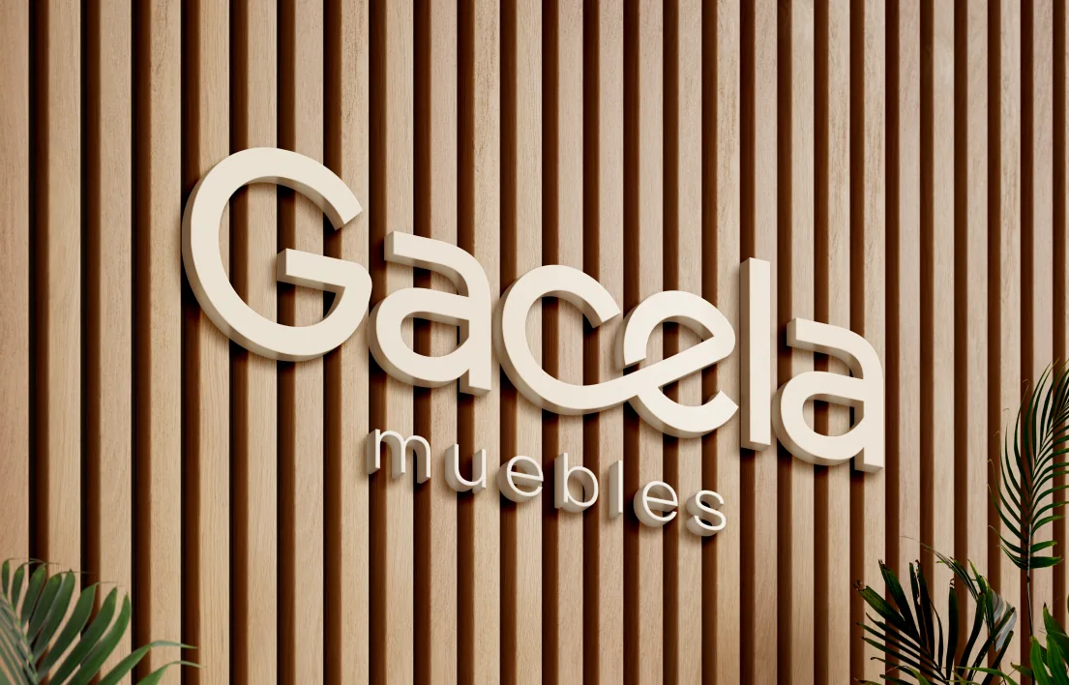
public/images/Gacela.webp
