infomueblesgacela/muebles-gacela-mvp/public/images/Galeria/Escena 315250 (blanco).webp

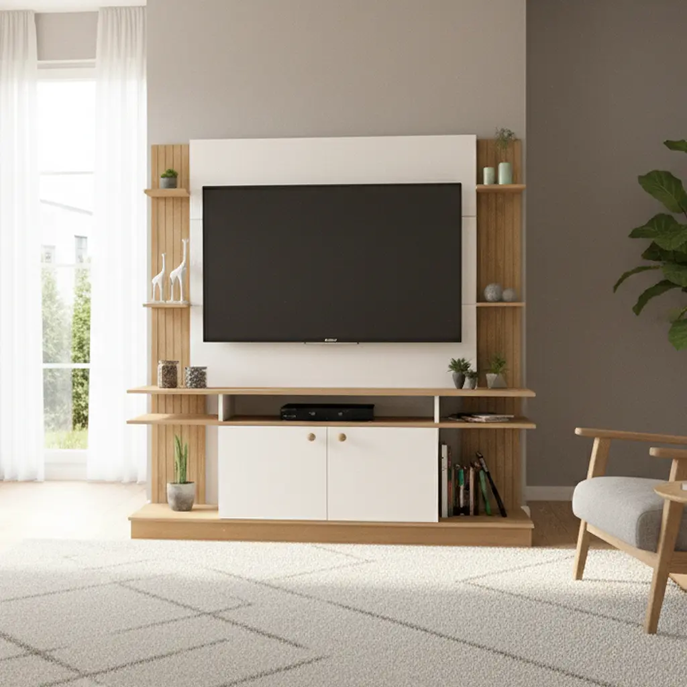
public/images/Galeria/Escena 315250 (blanco).webp
