infomueblesgacela/muebles-gacela-mvp/public/images/Galeria/Escena 326270.webp

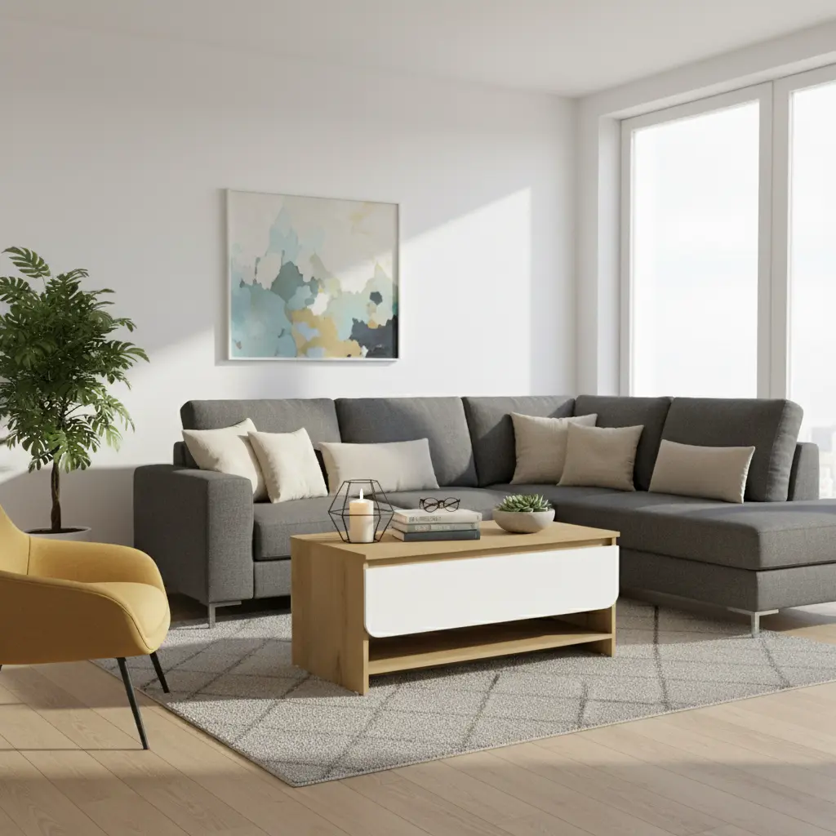
public/images/Galeria/Escena 326270.webp
