infomueblesgacela/muebles-gacela-mvp/public/images/Galeria/Escena 712152.webp

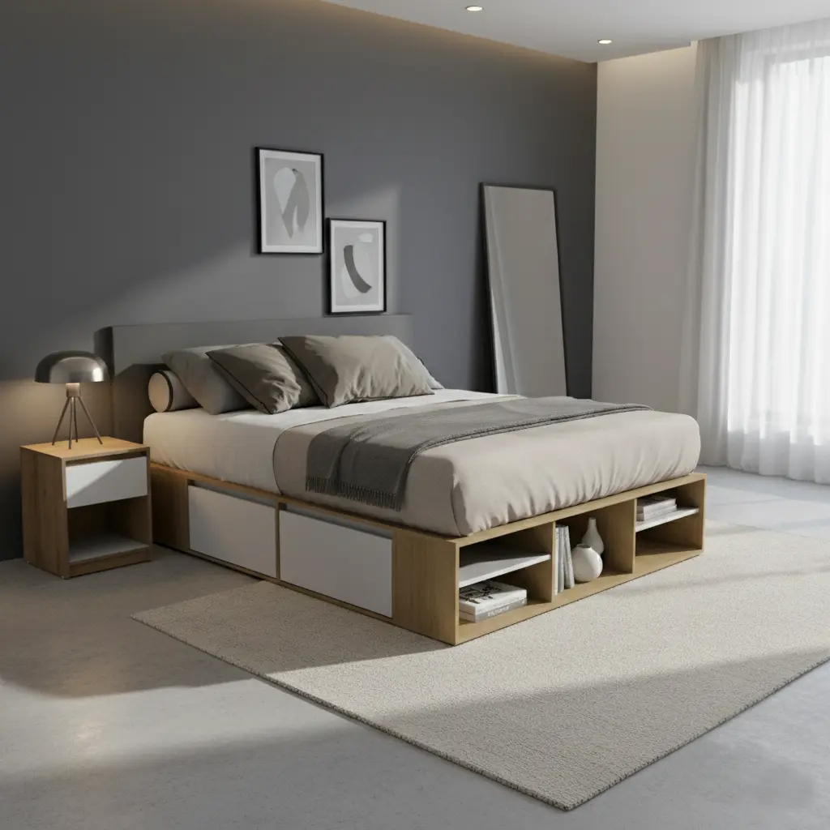
public/images/Galeria/Escena 712152.webp
