infomueblesgacela/muebles-gacela-mvp/public/images/Galeria/Escena Art 234093 (blanco).webp

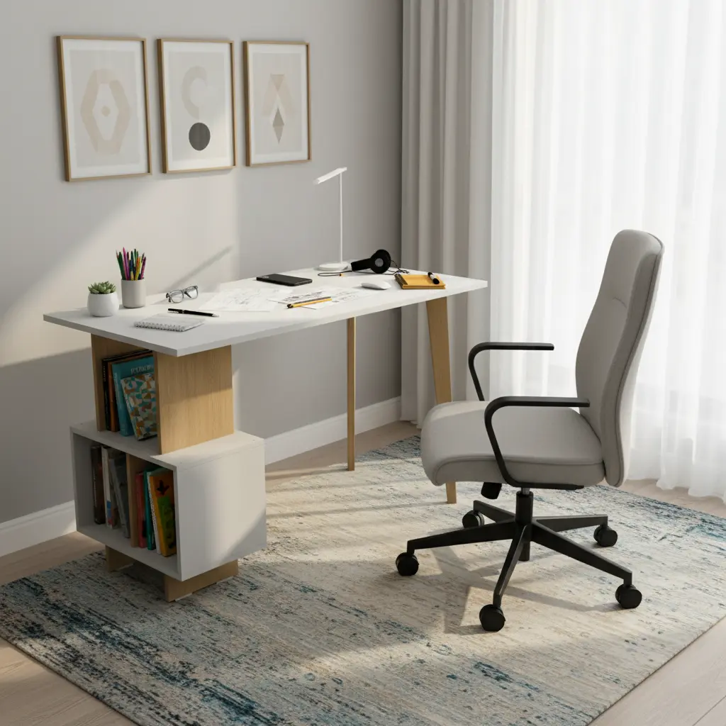
public/images/Galeria/Escena Art 234093 (blanco).webp
