infomueblesgacela/muebles-gacela-mvp/public/images/Galeria/Escena Art 326250.webp

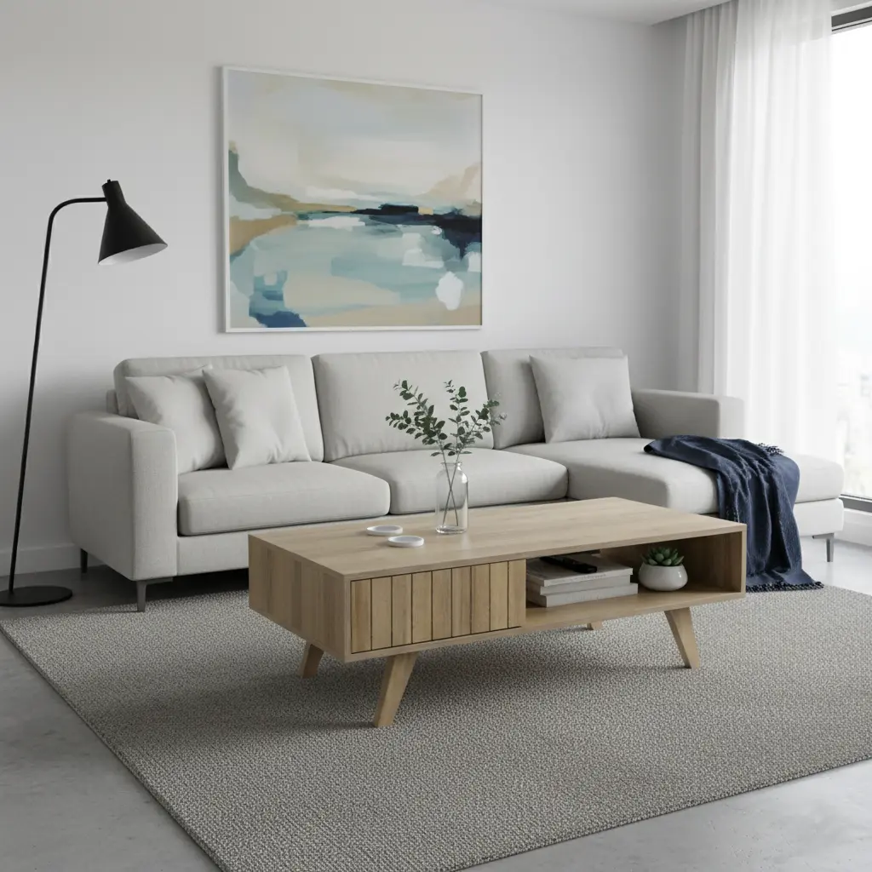
public/images/Galeria/Escena Art 326250.webp
