infomueblesgacela/muebles-gacela-mvp/public/images/Galeria/Escena Art 334093.webp

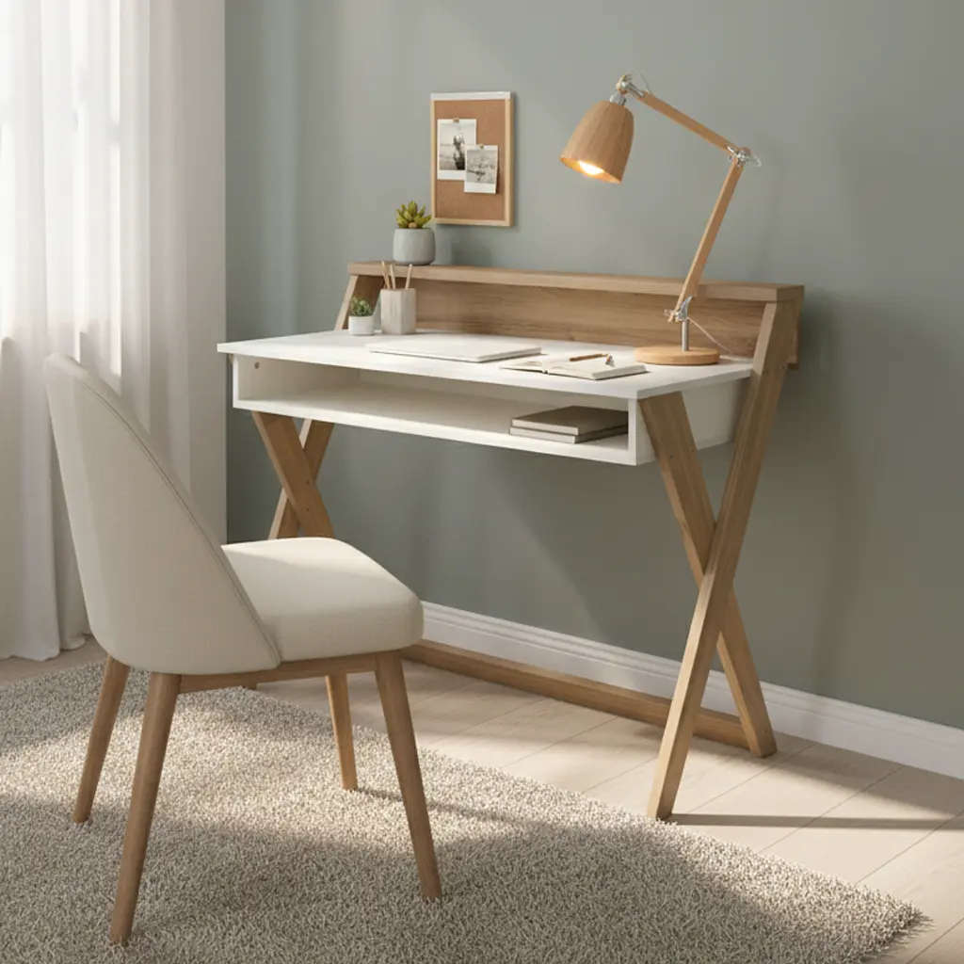
public/images/Galeria/Escena Art 334093.webp
