infomueblesgacela/muebles-gacela-mvp/public/images/Galeria/Escena Art 716270.webp

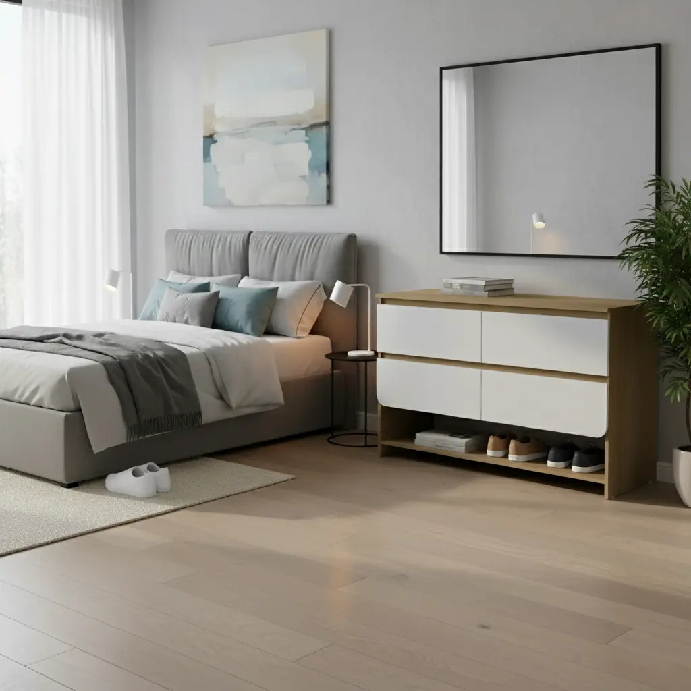
public/images/Galeria/Escena Art 716270.webp
