infomueblesgacela/muebles-gacela-mvp/public/images/Galeria/Escena Art 742026.webp

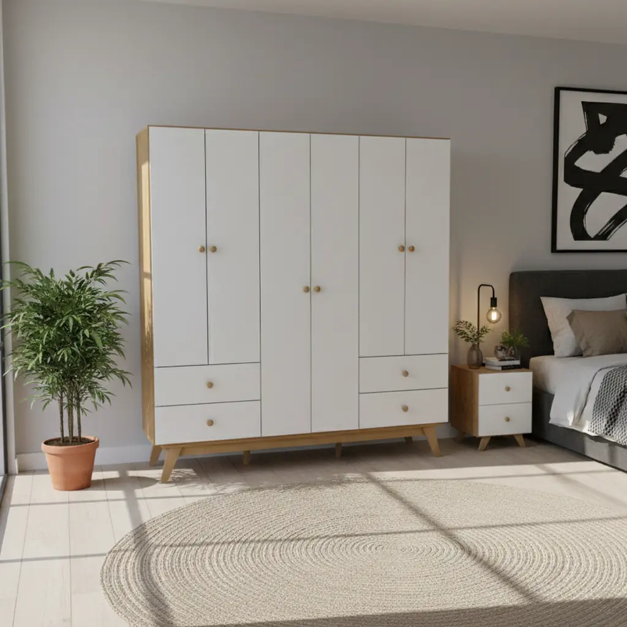
public/images/Galeria/Escena Art 742026.webp
