infomueblesgacela/muebles-gacela-mvp/public/images/Gamer.webp

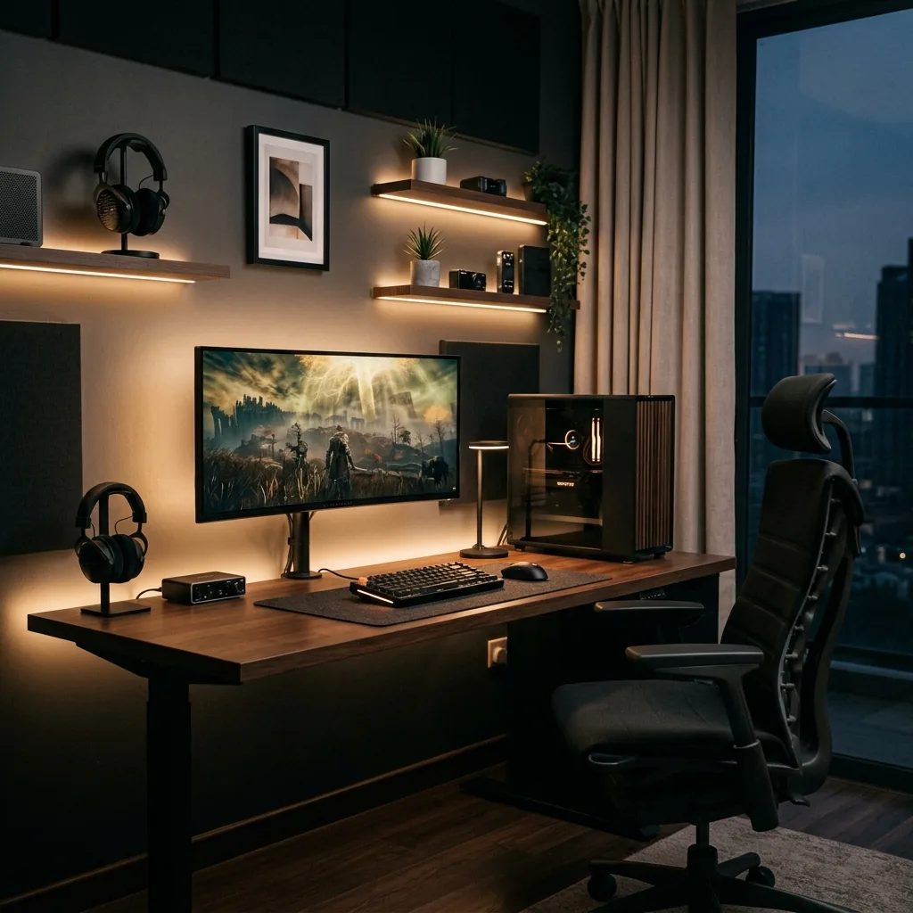
public/images/Gamer.webp
