infomueblesgacela/muebles-gacela-mvp/public/images/hero-home.webp

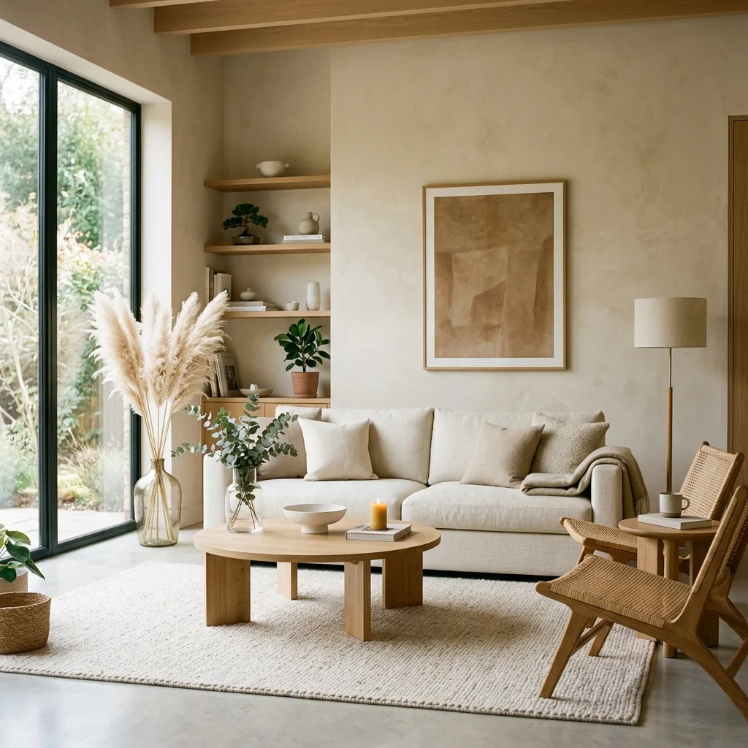
public/images/hero-home.webp
