infomueblesgacela/muebles-gacela-mvp/public/images/hero.webp

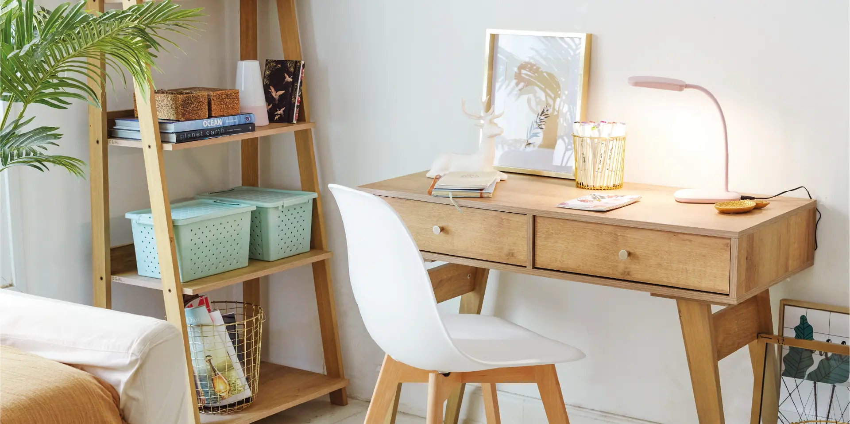
public/images/hero.webp
