infomueblesgacela/muebles-gacela-mvp/public/images/Infantil.webp

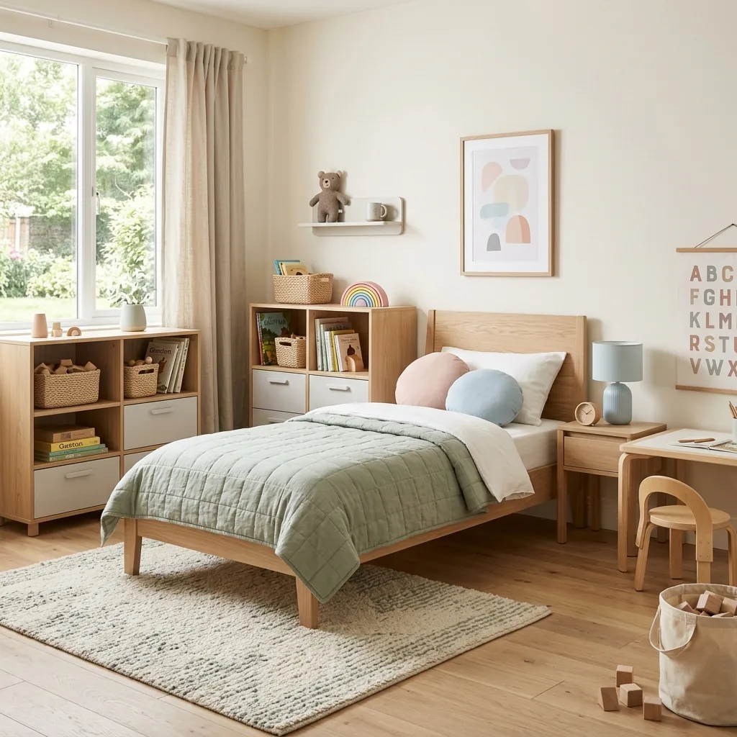
public/images/Infantil.webp
