infomueblesgacela/muebles-gacela-mvp/public/images/iso.png

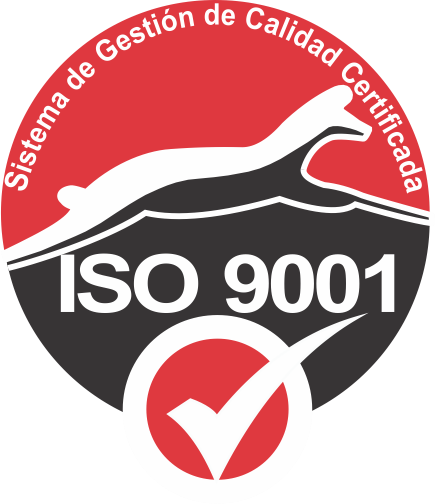
public/images/iso.png
