infomueblesgacela/muebles-gacela-mvp/public/images/Mel Avellana (Carvalho).jpg

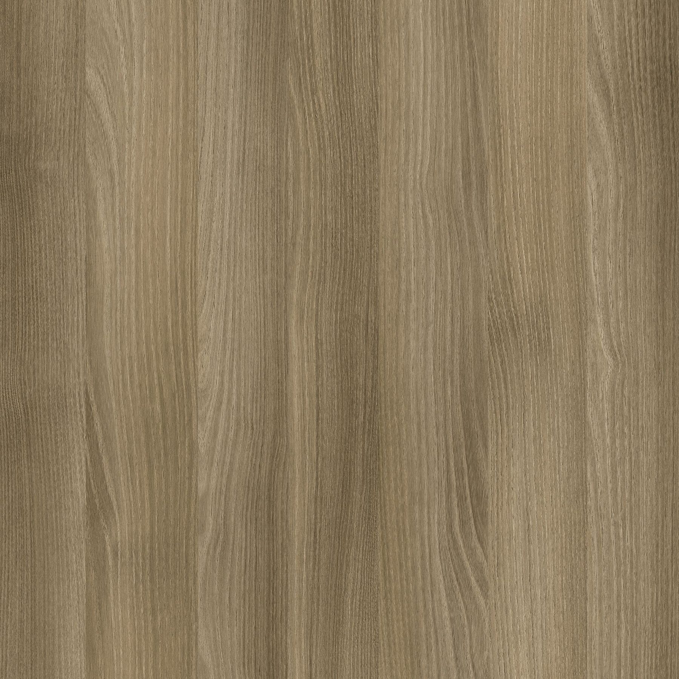
public/images/Mel Avellana (Carvalho).jpg
