infomueblesgacela/muebles-gacela-mvp/public/images/Mel Malta (Natural).jpg

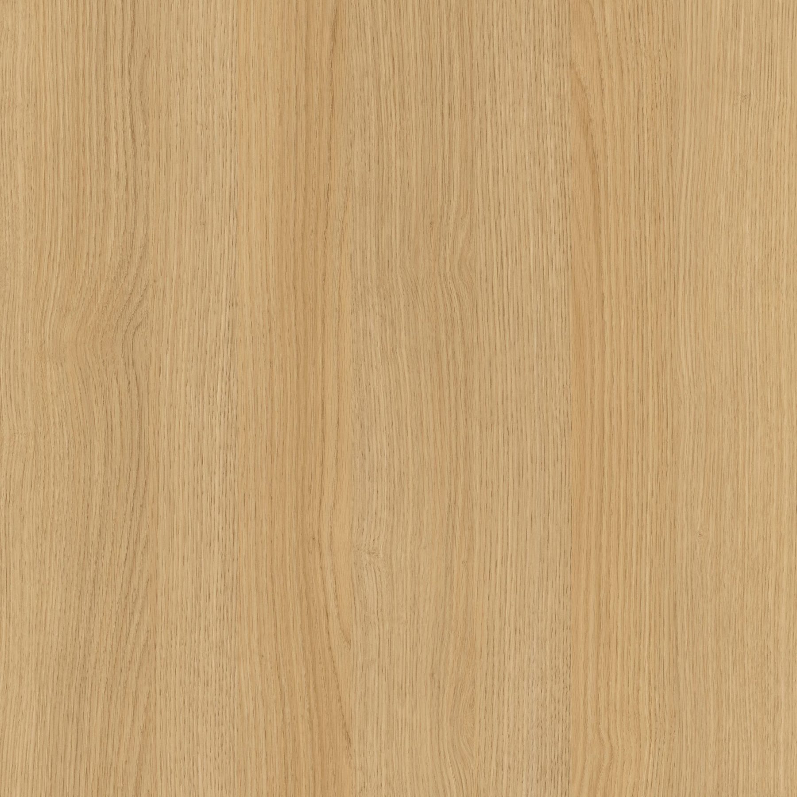
public/images/Mel Malta (Natural).jpg
