infomueblesgacela/muebles-gacela-mvp/public/images/room_industrial.png

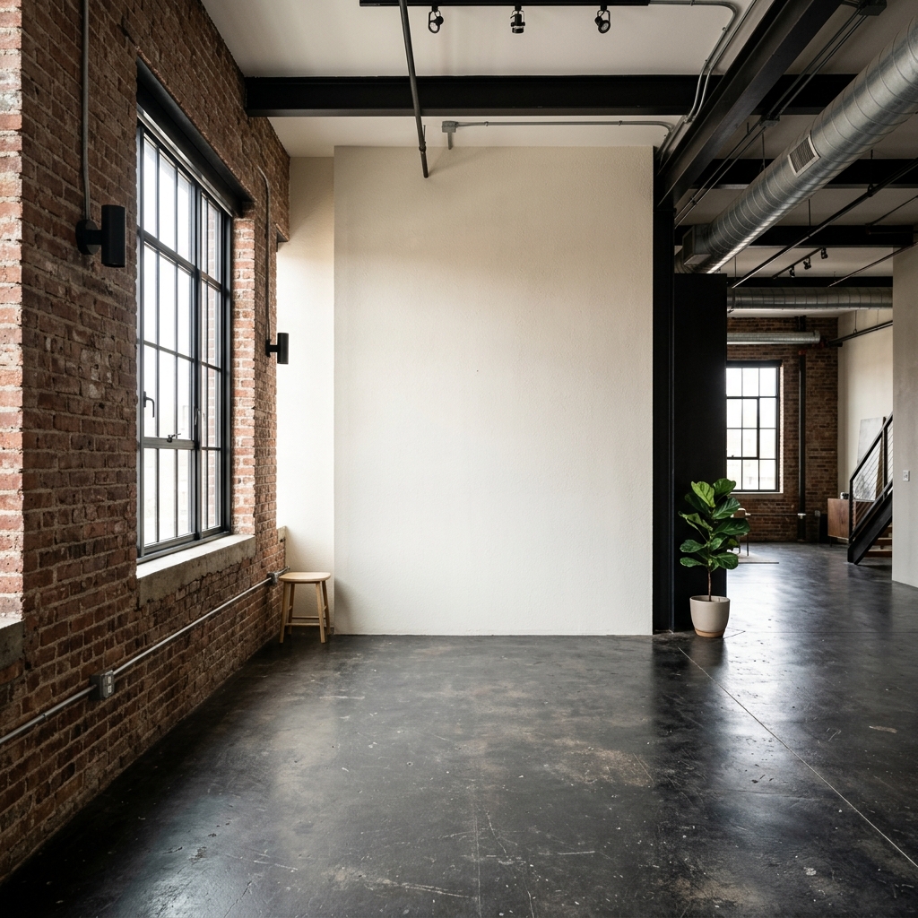
public/images/room_industrial.png
