infomueblesgacela/muebles-gacela-mvp/public/images/room_nordic.png

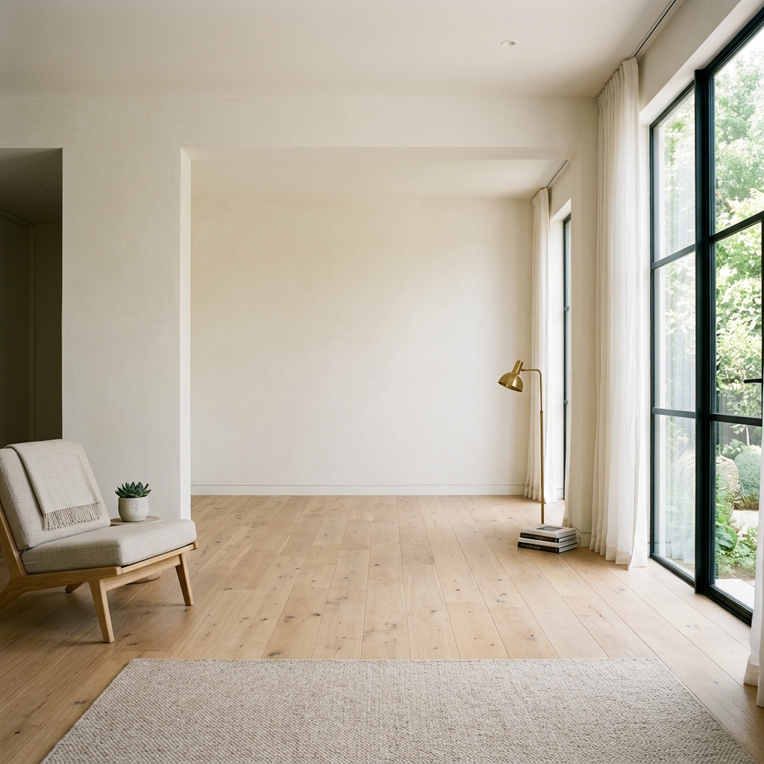
public/images/room_nordic.png
