infomueblesgacela/muebles-gacela-mvp/public/images/room_terracotta.png

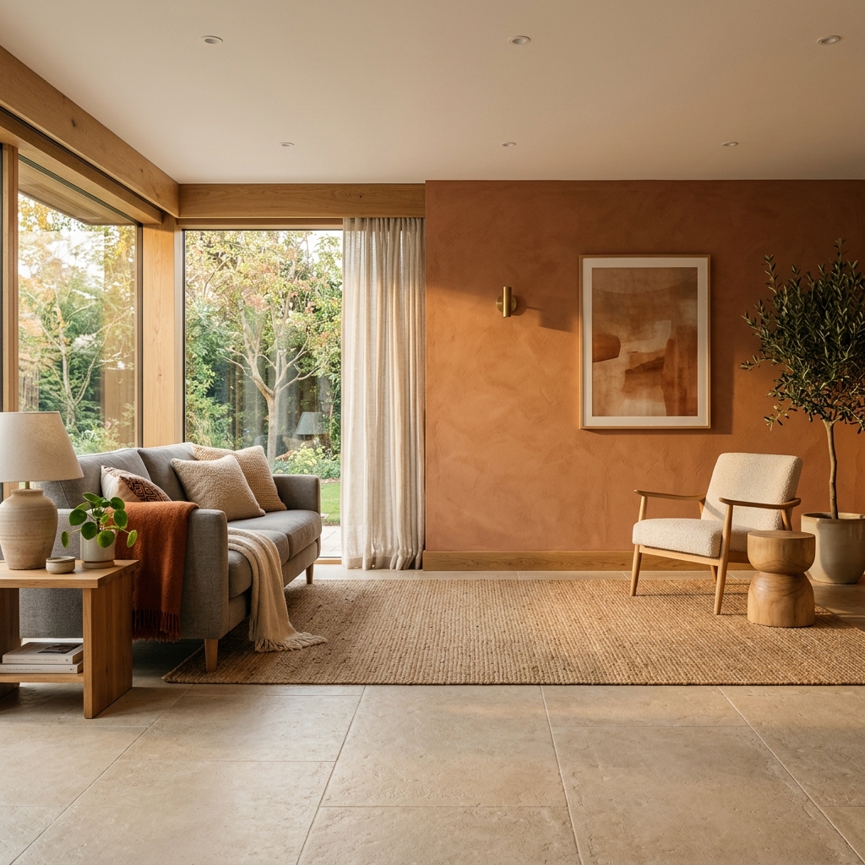
public/images/room_terracotta.png
