infomueblesgacela/muebles-gacela-mvp/public/images/rta.png

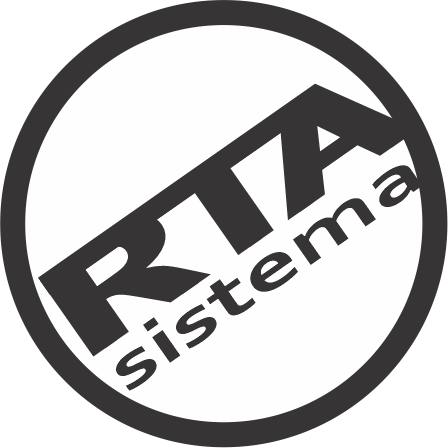
public/images/rta.png
