infomueblesgacela/muebles-gacela-mvp/public/images/talento.webp

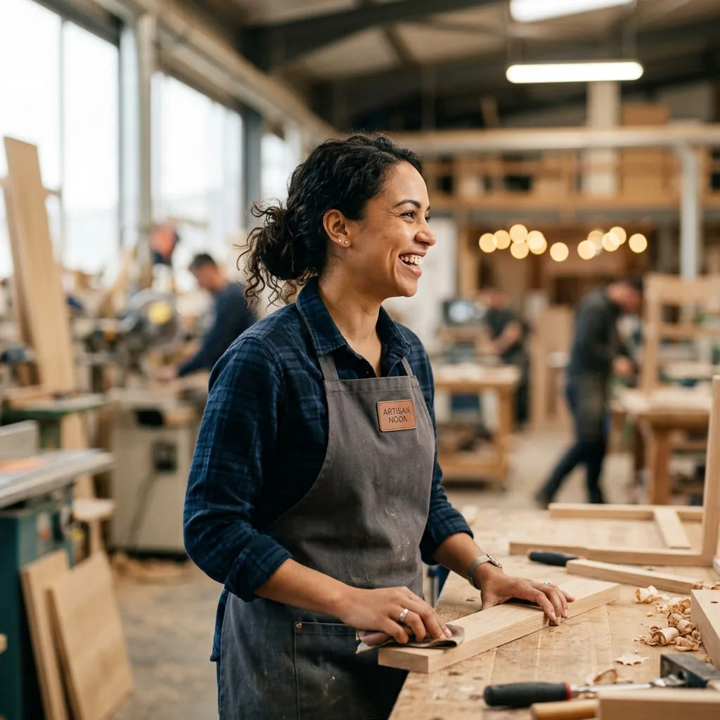
public/images/talento.webp
