infomueblesgacela/muebles-gacela-mvp/public/images/textura_madera.jpg

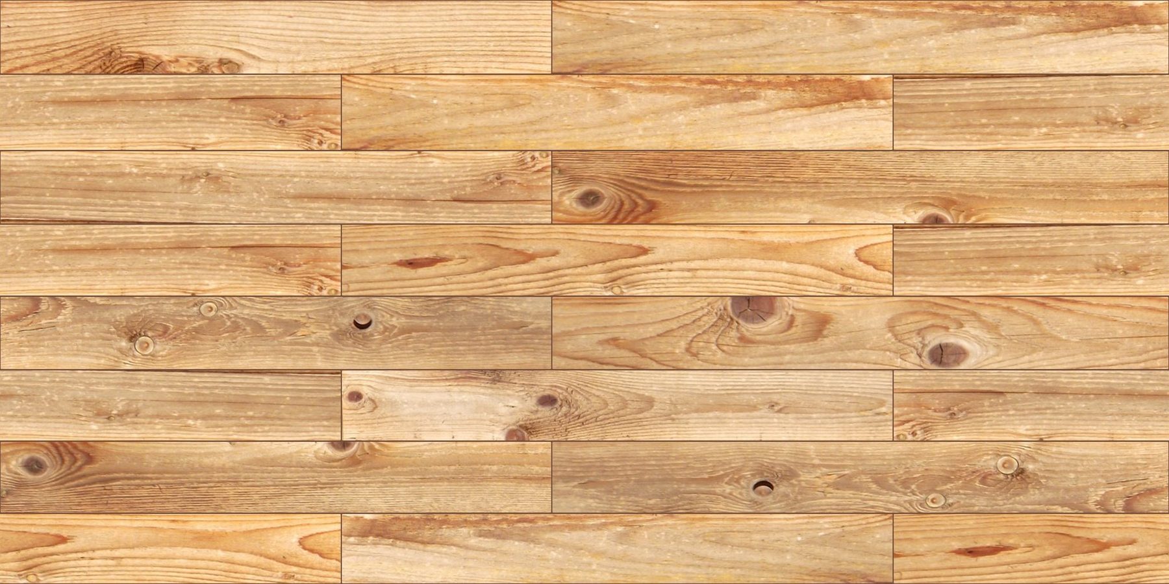
public/images/textura_madera.jpg
