infomueblesgacela/muebles-gacela-mvp/public/images/texture_normal.jpg

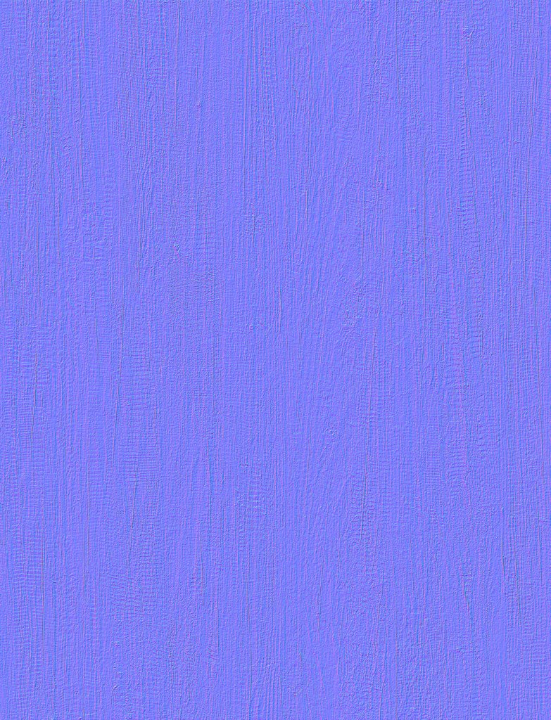
public/images/texture_normal.jpg
