infomueblesgacela/muebles-gacela-mvp/public/images/texture_normal.png

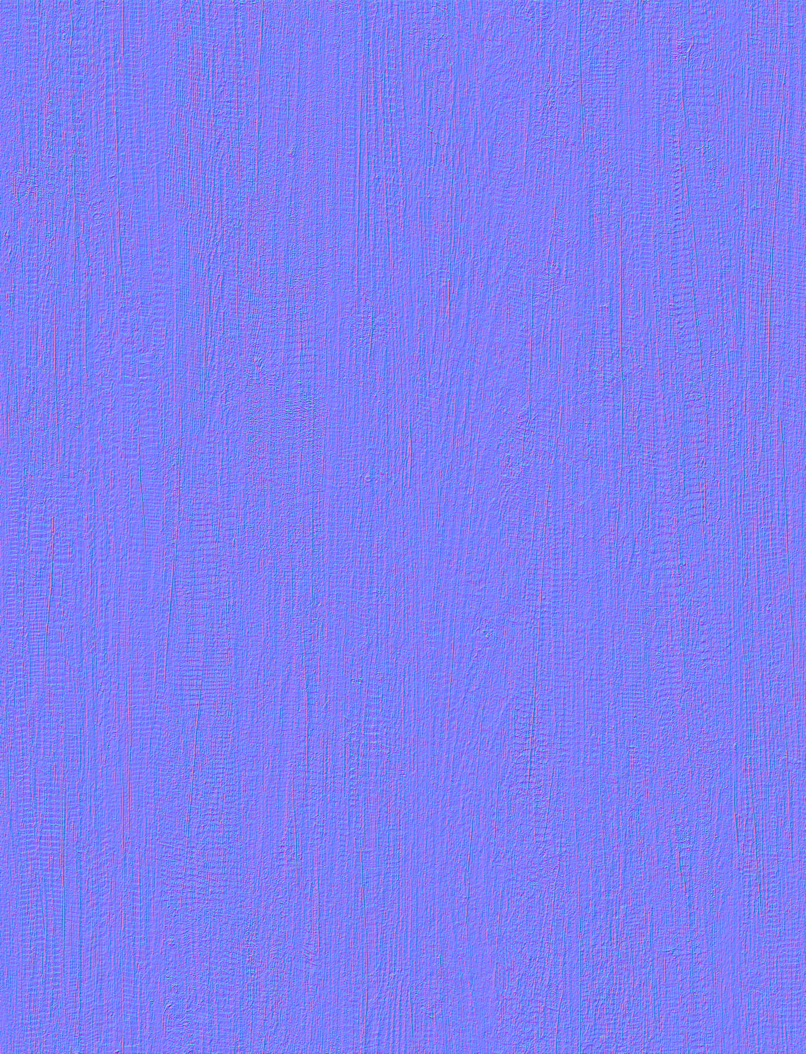
public/images/texture_normal.png
