infomueblesgacela/muebles-gacela-mvp/public/modelos_3d/linea-clasica/A009022/pasos/paso_03.png

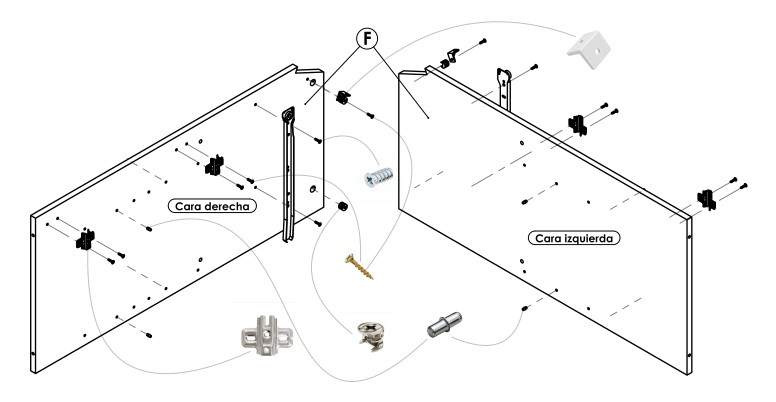
public/modelos_3d/linea-clasica/A009022/pasos/paso_03.png
