infomueblesgacela/muebles-gacela-mvp/public/modelos_3d/linea-clasica/A032013/pasos/paso_03.png

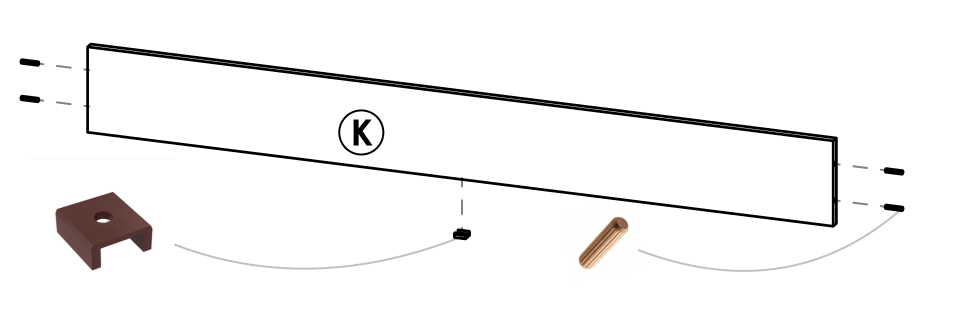
public/modelos_3d/linea-clasica/A032013/pasos/paso_03.png
