infomueblesgacela/muebles-gacela-mvp/public/modelos_3d/linea-comedores/A427091/pasos/paso_03.png

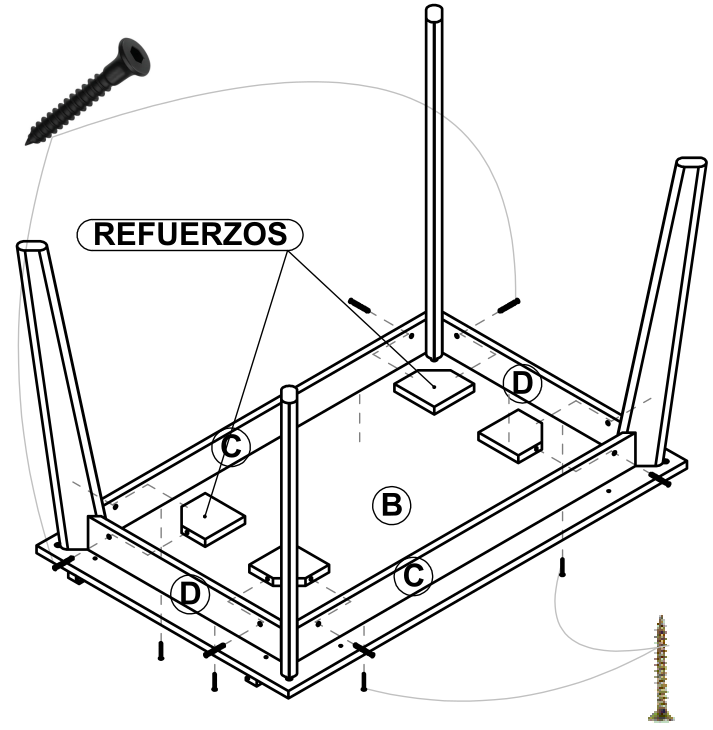
public/modelos_3d/linea-comedores/A427091/pasos/paso_03.png
