infomueblesgacela/muebles-gacela-mvp/public/modelos_3d/linea-curvalba/A326270/pasos/paso_07.png

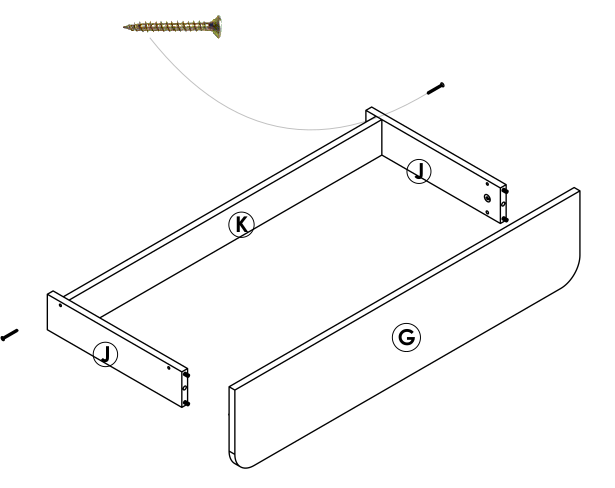
public/modelos_3d/linea-curvalba/A326270/pasos/paso_07.png
