infomueblesgacela/muebles-gacela-mvp/public/modelos_3d/linea-curvalba/A326270/pasos/paso_08.png

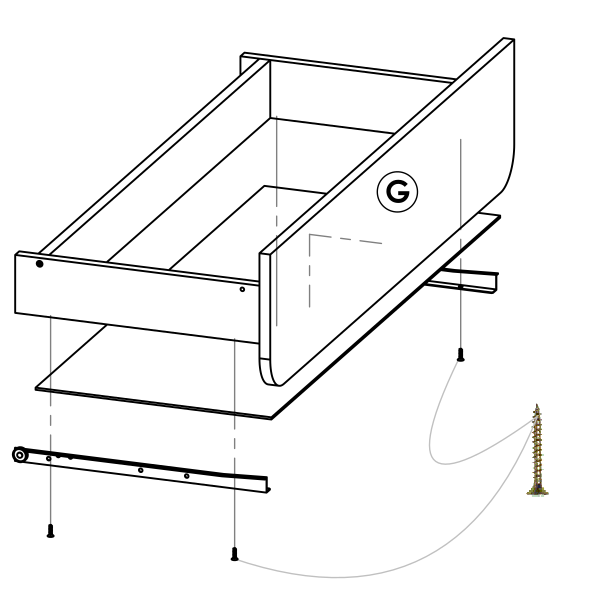
public/modelos_3d/linea-curvalba/A326270/pasos/paso_08.png
