infomueblesgacela/muebles-gacela-mvp/public/modelos_3d/linea-curvalba/A405270/herrajes/bisagra.webp

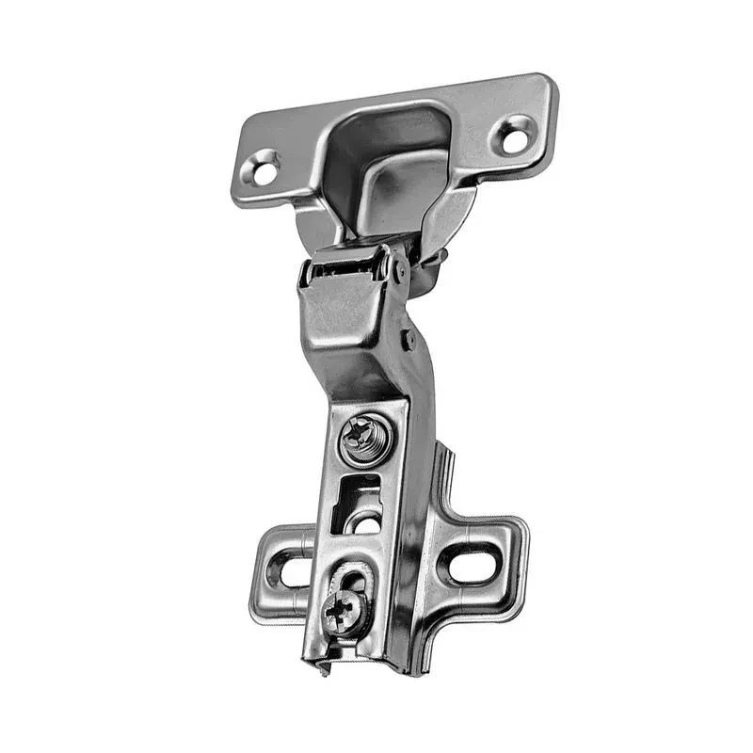
public/modelos_3d/linea-curvalba/A405270/herrajes/bisagra.webp
