infomueblesgacela/muebles-gacela-mvp/public/modelos_3d/linea-curvalba/A732270/pasos/paso_05.png

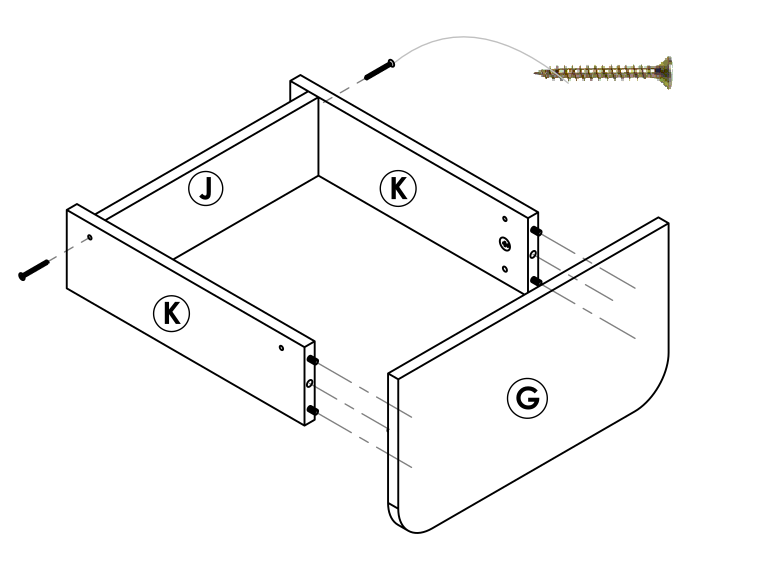
public/modelos_3d/linea-curvalba/A732270/pasos/paso_05.png
