infomueblesgacela/muebles-gacela-mvp/public/modelos_3d/linea-curvalba/A742270/herrajes/soporte-de-canos.webp

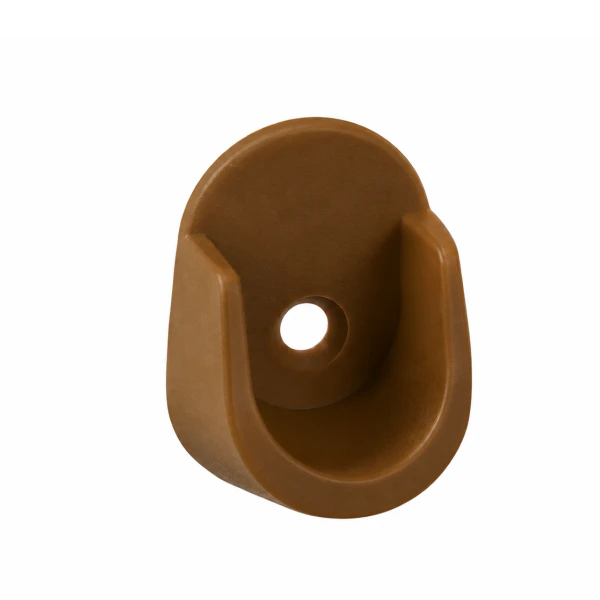
public/modelos_3d/linea-curvalba/A742270/herrajes/soporte-de-canos.webp
