infomueblesgacela/muebles-gacela-mvp/public/modelos_3d/linea-curvalba/A742270/pasos/paso_11.png

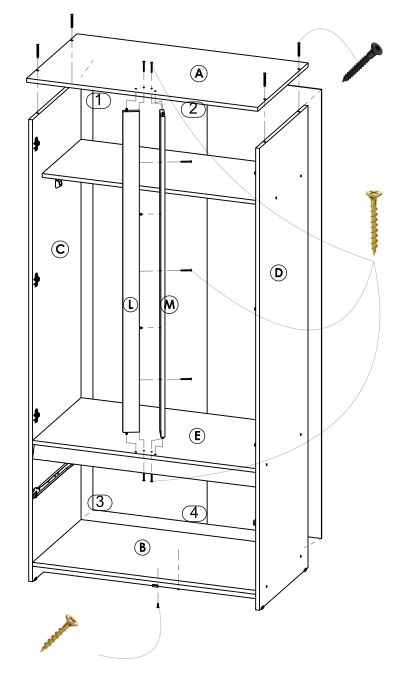
public/modelos_3d/linea-curvalba/A742270/pasos/paso_11.png
