infomueblesgacela/muebles-gacela-mvp/public/modelos_3d/linea-curvalba/A742273/herrajes/manija-athenas.webp

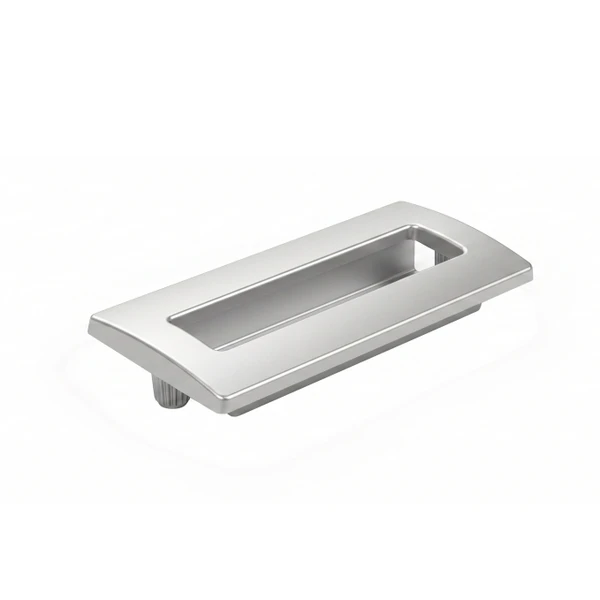
public/modelos_3d/linea-curvalba/A742273/herrajes/manija-athenas.webp
