infomueblesgacela/muebles-gacela-mvp/public/modelos_3d/linea-curvalba/A742273/pasos/paso_01.png

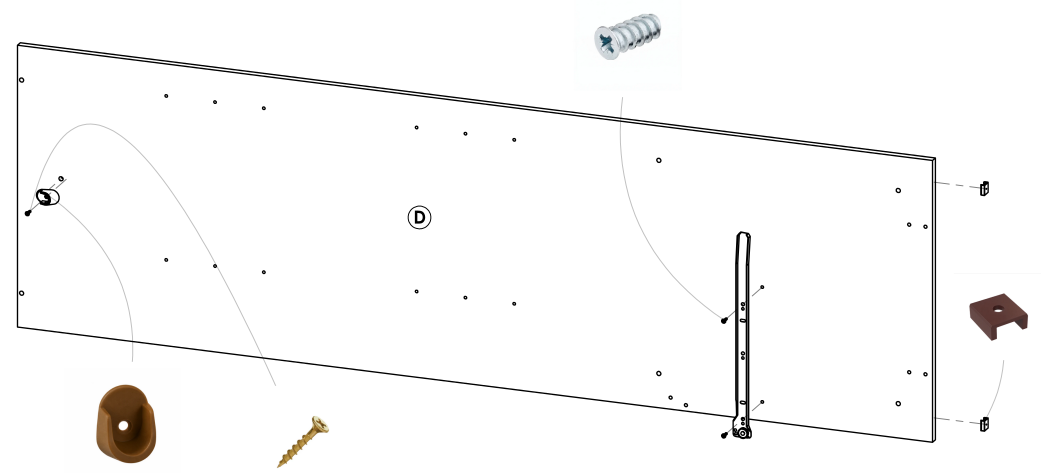
public/modelos_3d/linea-curvalba/A742273/pasos/paso_01.png
