infomueblesgacela/muebles-gacela-mvp/public/modelos_3d/linea-gamer/A734222/pasos/A734222-unboxing.png

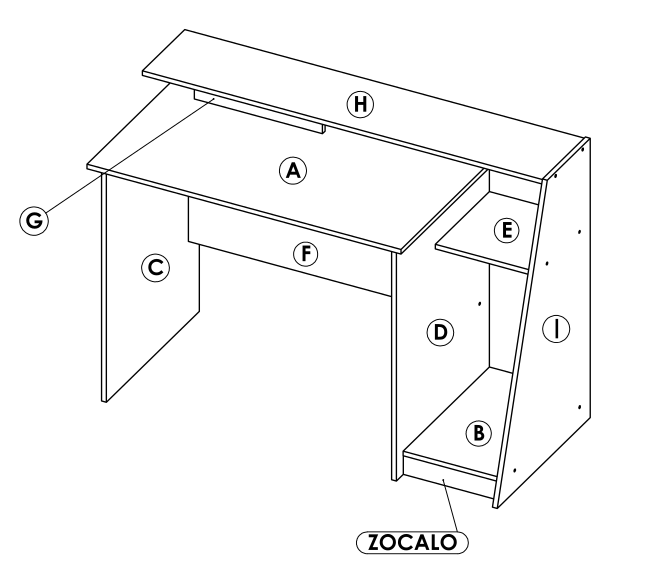
public/modelos_3d/linea-gamer/A734222/pasos/A734222-unboxing.png
