infomueblesgacela/muebles-gacela-mvp/public/modelos_3d/linea-gamer/A734222/pasos/paso_06.png

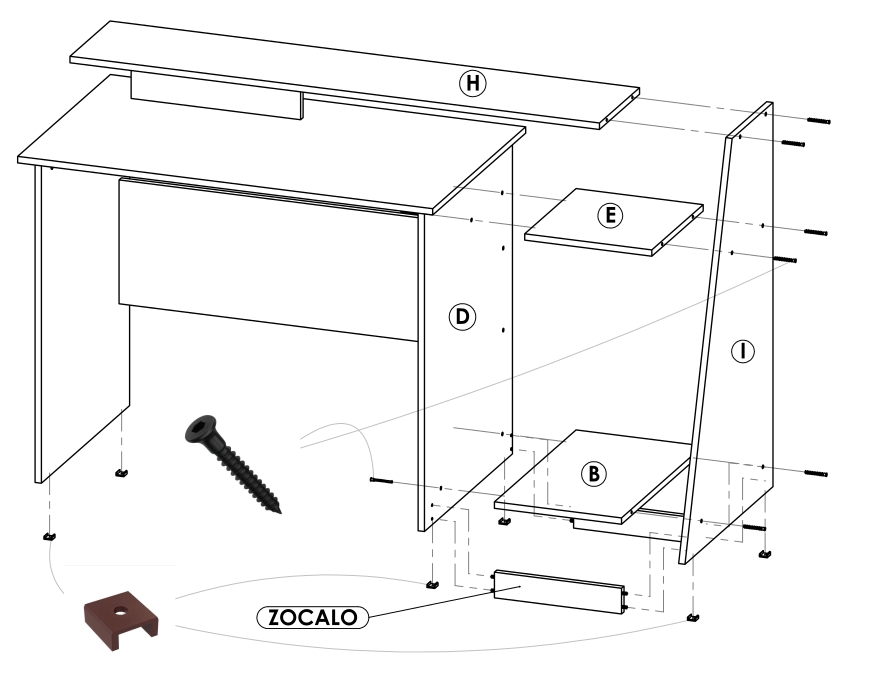
public/modelos_3d/linea-gamer/A734222/pasos/paso_06.png
