infomueblesgacela/muebles-gacela-mvp/public/modelos_3d/linea-infantil/A740150/pasos/paso_07.png

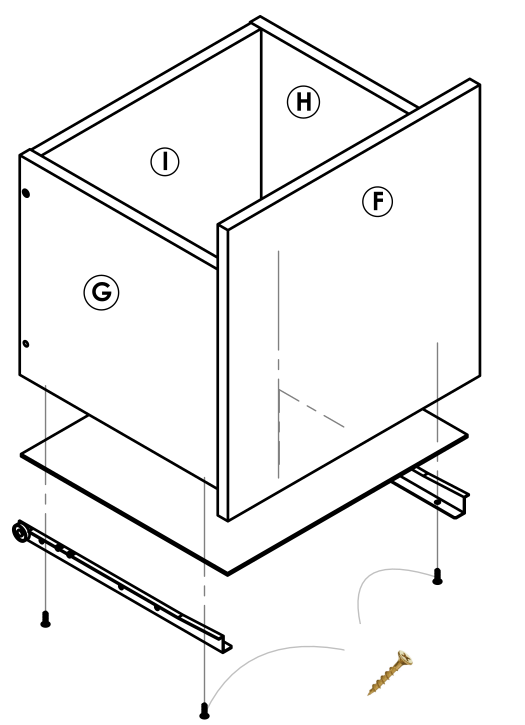
public/modelos_3d/linea-infantil/A740150/pasos/paso_07.png
