infomueblesgacela/muebles-gacela-mvp/public/modelos_3d/linea-infantil/A753153/pasos/paso_01.png

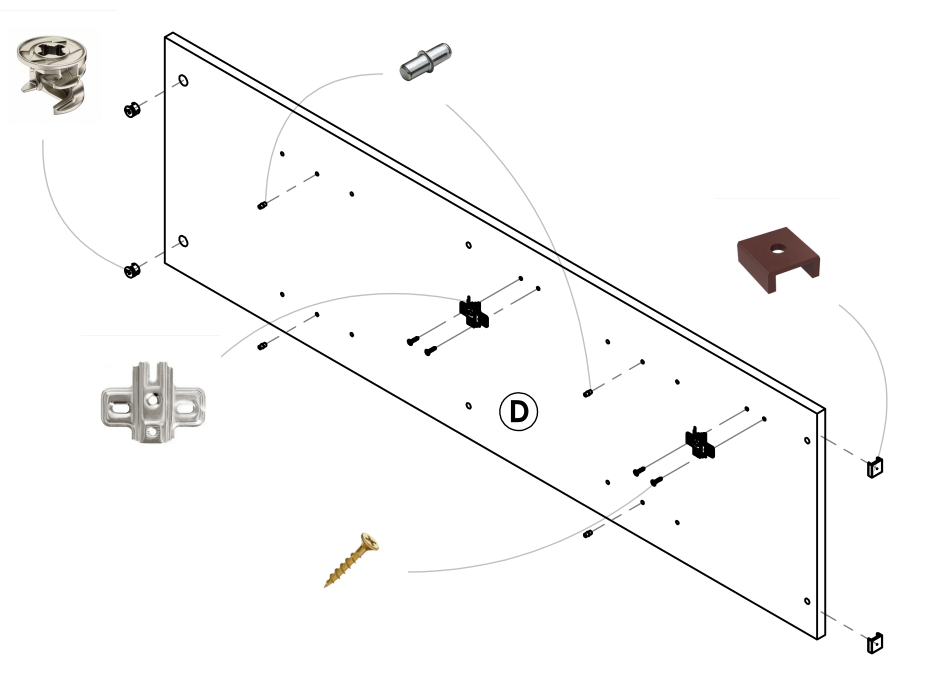
public/modelos_3d/linea-infantil/A753153/pasos/paso_01.png
