infomueblesgacela/muebles-gacela-mvp/public/modelos_3d/linea-kyoto/A315250/pasos/paso_11.png

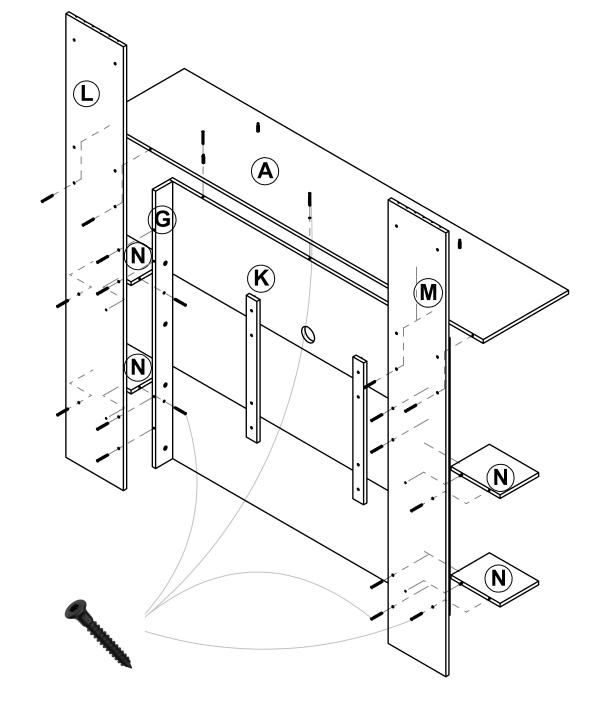
public/modelos_3d/linea-kyoto/A315250/pasos/paso_11.png
