infomueblesgacela/muebles-gacela-mvp/public/modelos_3d/linea-kyoto/A326250/pasos/A326250-unboxing.png

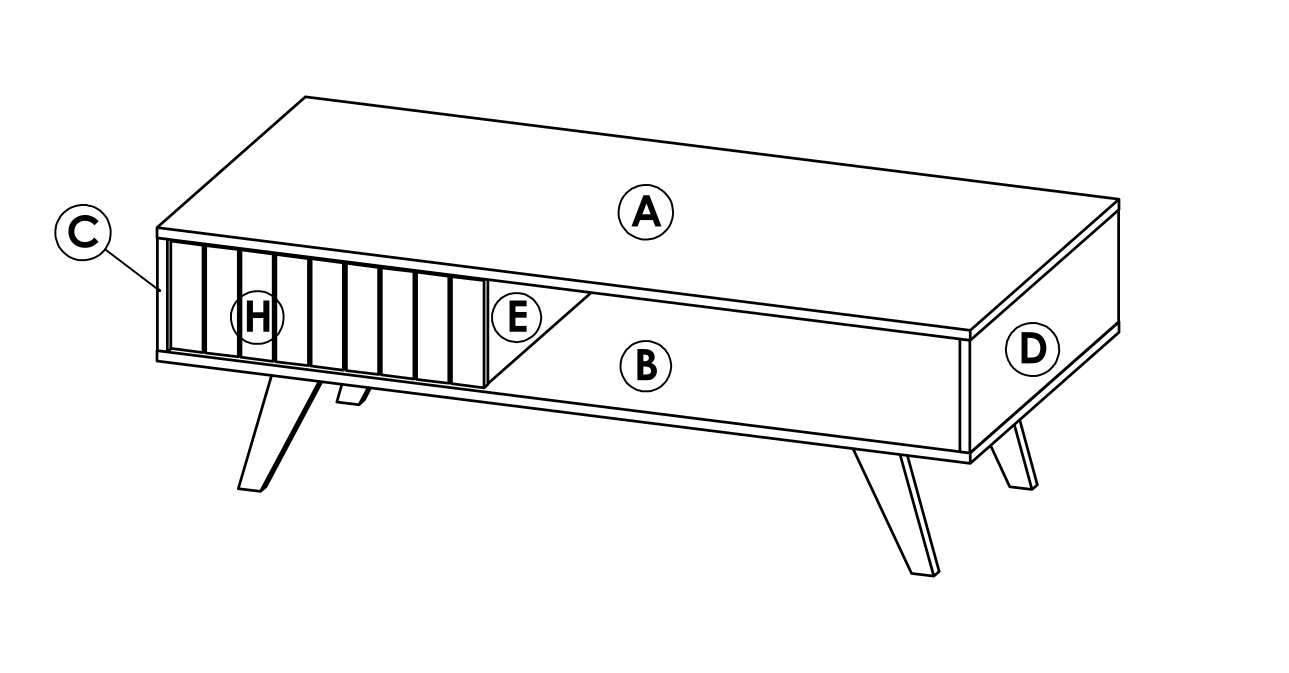
public/modelos_3d/linea-kyoto/A326250/pasos/A326250-unboxing.png
