infomueblesgacela/muebles-gacela-mvp/public/modelos_3d/linea-kyoto/A334250/pasos/paso_07.png

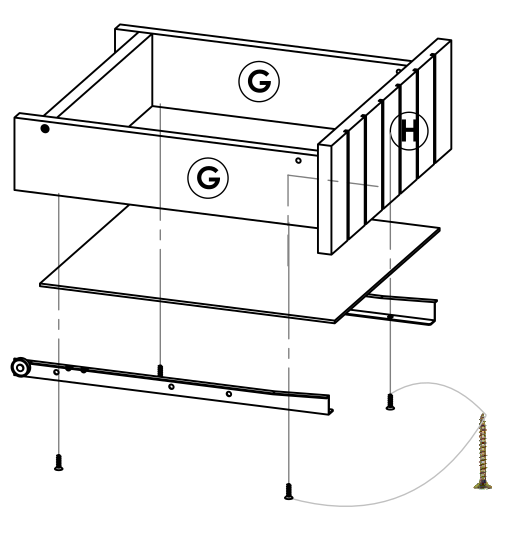
public/modelos_3d/linea-kyoto/A334250/pasos/paso_07.png
