infomueblesgacela/muebles-gacela-mvp/public/modelos_3d/linea-kyoto/A353250/pasos/paso_05.png

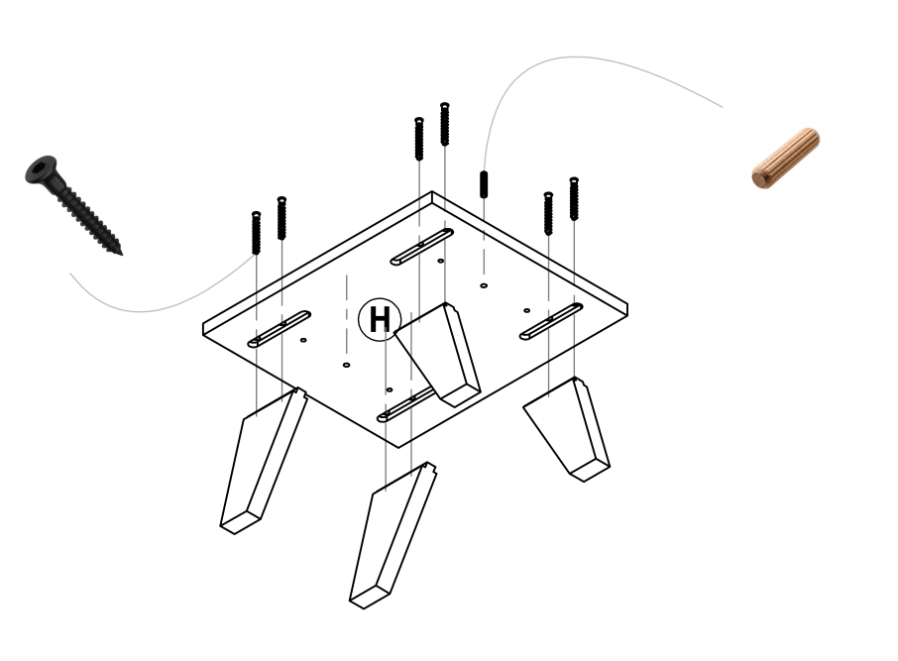
public/modelos_3d/linea-kyoto/A353250/pasos/paso_05.png
