infomueblesgacela/muebles-gacela-mvp/public/modelos_3d/linea-nordik/A321021/pasos/paso_10.png

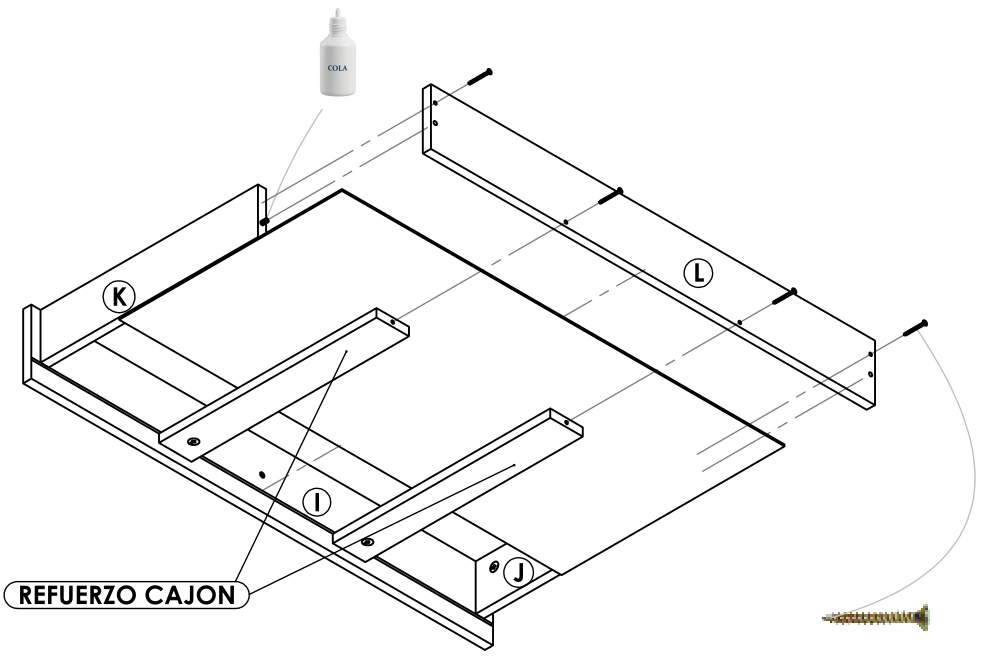
public/modelos_3d/linea-nordik/A321021/pasos/paso_10.png
