infomueblesgacela/muebles-gacela-mvp/public/modelos_3d/linea-nordik/A742332/pasos/paso_01.png

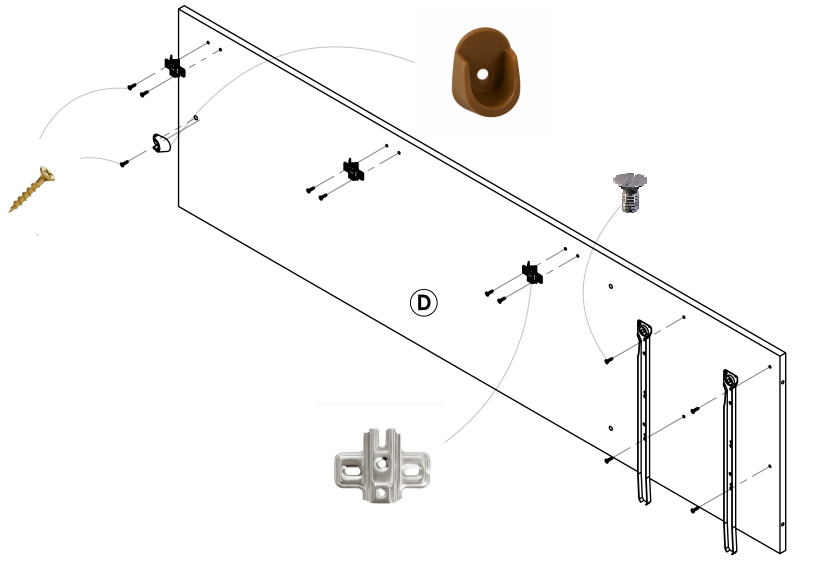
public/modelos_3d/linea-nordik/A742332/pasos/paso_01.png
