infomueblesgacela/muebles-gacela-mvp/public/modelos_3d/linea-nordik/A742334/pasos/paso_08.png

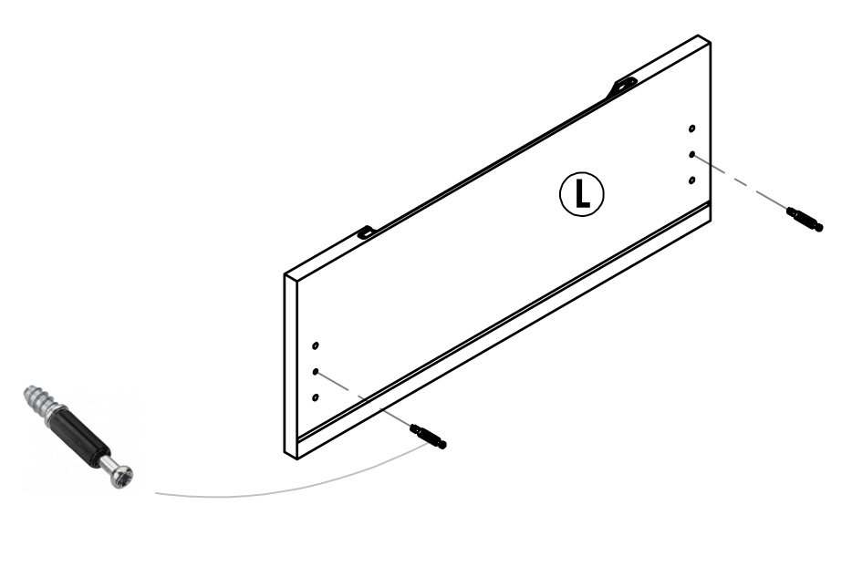
public/modelos_3d/linea-nordik/A742334/pasos/paso_08.png
