infomueblesgacela/muebles-gacela-mvp/public/images/materiales.png

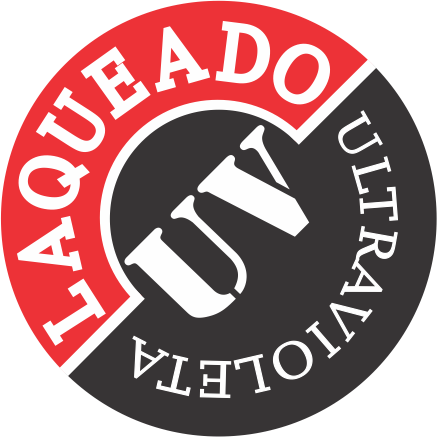
public/images/materiales.png
