infomueblesgacela/muebles-gacela-mvp/public/Modelos 3d/primera pieza terminada.obj

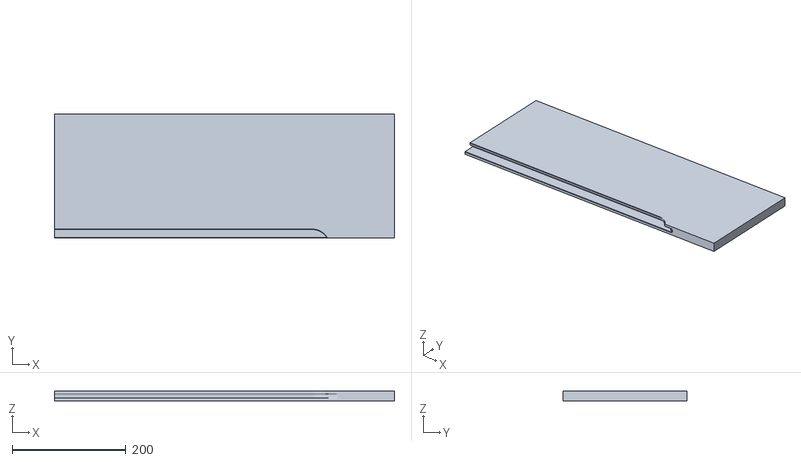
[picture p119: CAD file, 2026-07-28]
public/Modelos 3d/primera pieza terminada.obj
598.0 x 218.5 x 18.0
