infomueblesgacela/muebles-gacela-mvp/modelos_3d/linea-clasica/A008285/A008285.STEP

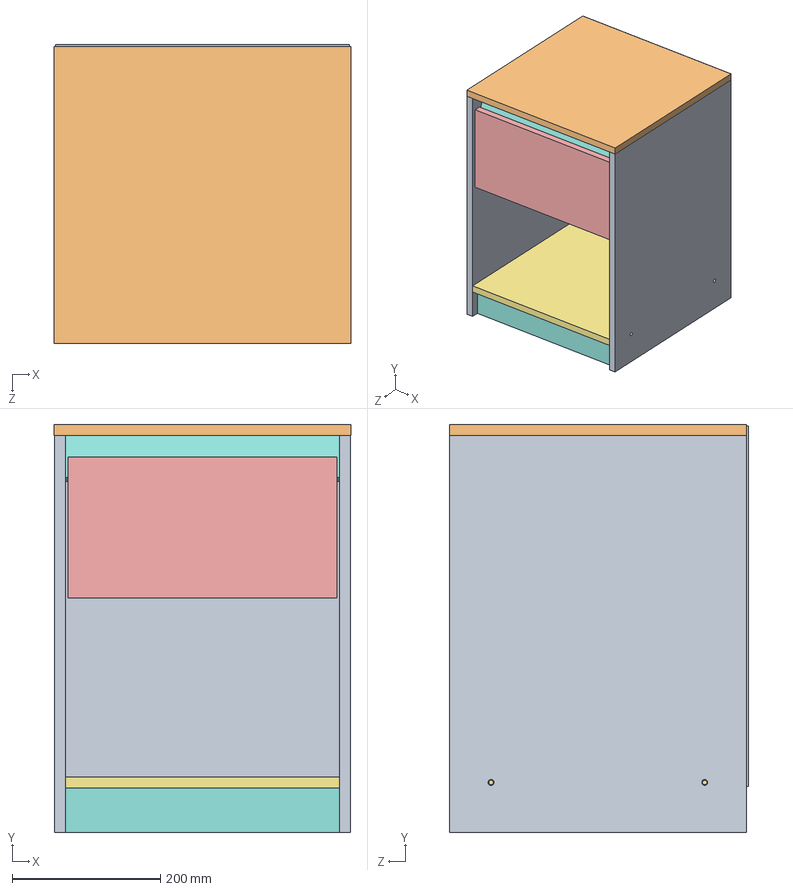
[picture p120: CAD file, 2026-07-28]
modelos_3d/linea-clasica/A008285/A008285.STEP
400.0 x 550.0 x 403.0 mm
A008285-COSTADOSCOST
A008285-TAPASXXXTAPA
SimetríaA008285-COSTADOSCOST
A008285-FONDOSXXCAJO
A008285-COSTADOSCAJO x 2
A008285-FRENTESXCAJO
A008285-PISOSXXCAJON
A008285-PISOSXXXPISO
A008285-ZOCALOSXZOCA
A008285-FAJASXXXFREN
A008285-FONDOSXXMUEB
