infomueblesgacela/muebles-gacela-mvp/modelos_3d/linea-clasica/A008395/A008395.STEP

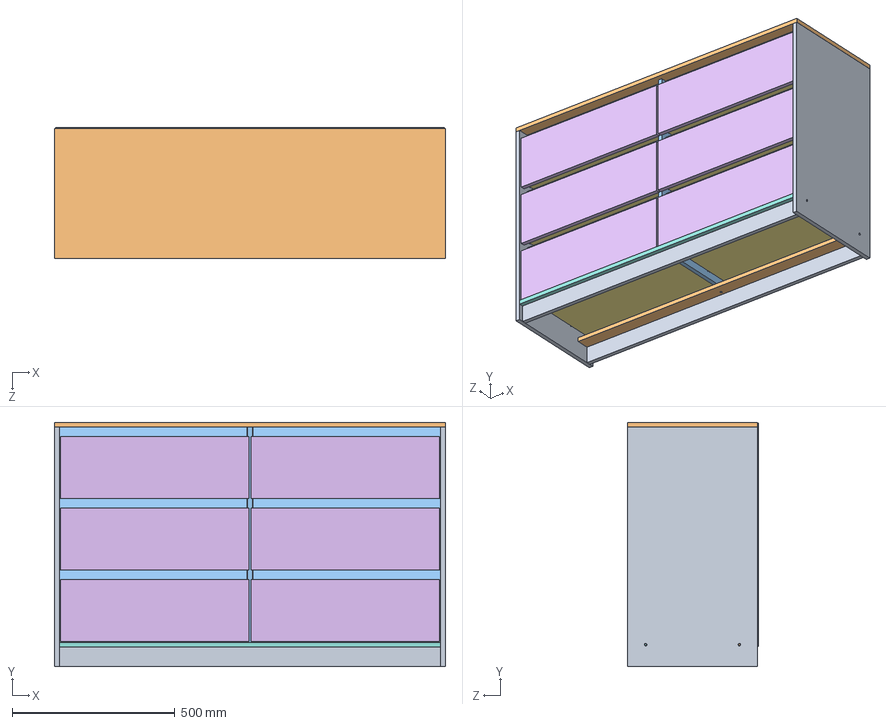
[picture p121: CAD file, 2026-07-28]
modelos_3d/linea-clasica/A008395/A008395.STEP
1200.0 x 750.0 x 403.0 mm
A008395-COSTADOSCOST
A008395-TAPASXXXTAPA
SimetríaA008395-COSTADOSCOST
A008395-SEPDORESSEPA
A008395-FONDOSXXCAJO x 6
A008395-COSTADOSCAJO x 12
A008395-FRENTESXCADE x 3
A008395-PISOSXXCAJON x 6
A008395-PISOSXXXFREN
A008395-ZOCALOSXZOCA x 2
A008395-PISOSXXXATRA
A008395-FAJASXXXFREN x 6
A008395-FRENTESXCAIZ x 3
A008395-FONDOSXXMUEB x 2
