infomueblesgacela/muebles-gacela-mvp/modelos_3d/linea-clasica/A009022/A009022.STEP

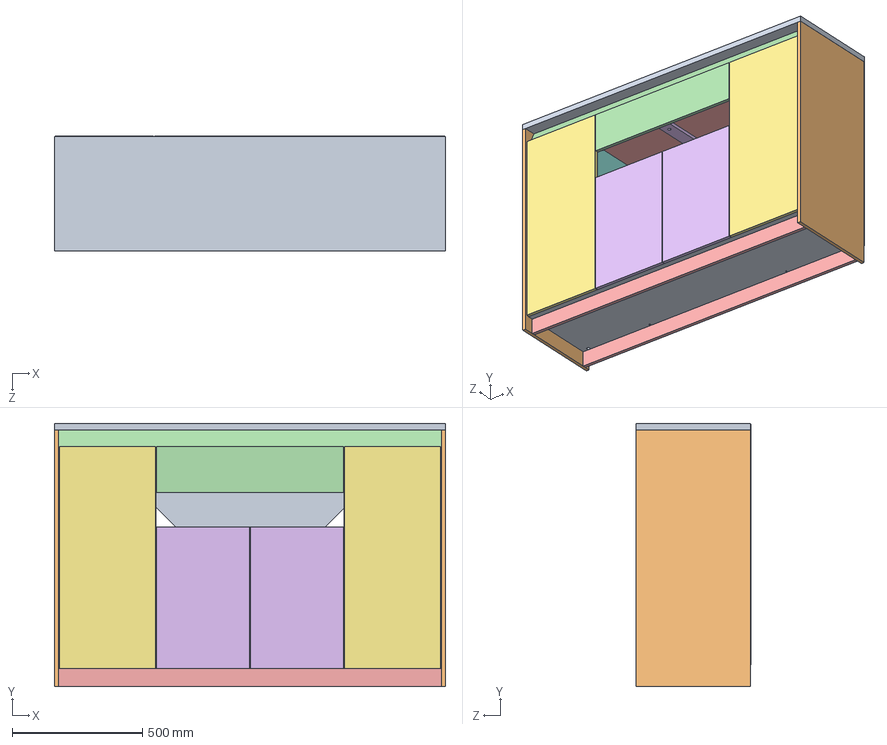
[picture p122: CAD file, 2026-07-28]
modelos_3d/linea-clasica/A009022/A009022.STEP
1500.0 x 1010.0 x 443.0 mm
A009022-PISOSXXXPISO
A009022-COSTADOSCOST
A009022-ESTANTESFIJO
A009022-FRENTESXXFTE
A009022-FRENTESXZOCA x 2
A009022-PUERTASXCHIC x 2
A009022-PUERTASXXGDE x 2
A009022-SEPDORESXSEP
A009022-TAPASXXXTAPA
SimetríaA009022-SEPDORESXSEP
SimetríaA009022-COSTADOSCOST
A009022-COSTADOSCAJO x 2
A009022-FONDOXXCAJON
A009022-FRENTEXCAJON
A009022-PISOXXXCAJON
A009022-REFUERZOCAJO
A009022-ESTXMOVXCHIC x 2
A009022-ESTXMOVXGRAN
A009022-FONDOMUEBLEY
A009022-FONDOMUEBLEZ x 2
A009022-FONDOMUEBLEX x 2
