infomueblesgacela/muebles-gacela-mvp/modelos_3d/linea-clasica/A032012/A032012.STEP

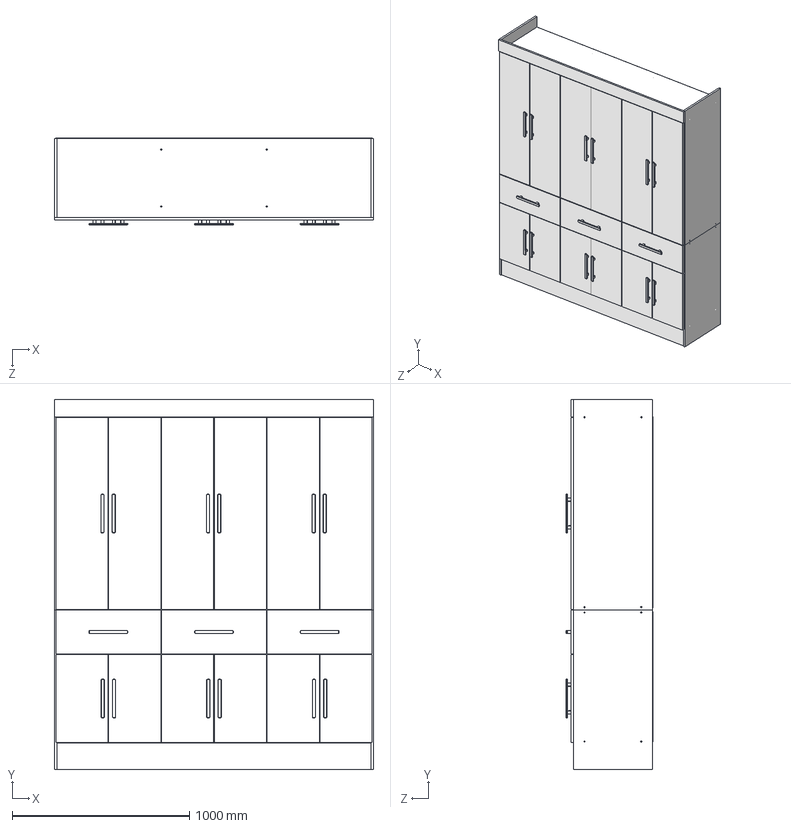
[picture p123: CAD file, 2026-07-28]
modelos_3d/linea-clasica/A032012/A032012.STEP
1800.0 x 2085.0 x 489.5 mm
A032012-COSTADOSAB
A032012-PISOSXXXPI x 2
A032012-TAPASXXXAB
A032012-SEPDORESAB x 2
A032012-ESTANTESMO x 2
A032012-COSTADOSAJ
A032012-TAPASXXXAJ x 2
A032012-SEPDORESAJ x 2
SimetríaA032012-COSTADOSAB
A032012-PUERTASXAJ x 6
A032012-PUERTASXAB x 6
A032012-FONDOSXXCA x 3
A032012-COSTADOSCA x 6
A032012-FRENTESXCA x 3
A032012-PISOSXXXCA x 3
Manija Gamma x 15
A032012-FRENTESXAB
A032012-FRENTESXZO x 2
A032012-FONDOSMUAJ x 3
A032012-FONDOSMUAB x 3
SimetríaA032012-COSTADOSAJ
A032012-CA埆575 x 2
A032012-FAJASXXXSU x 2
