infomueblesgacela/muebles-gacela-mvp/modelos_3d/linea-clasica/A032013/A032013.STEP

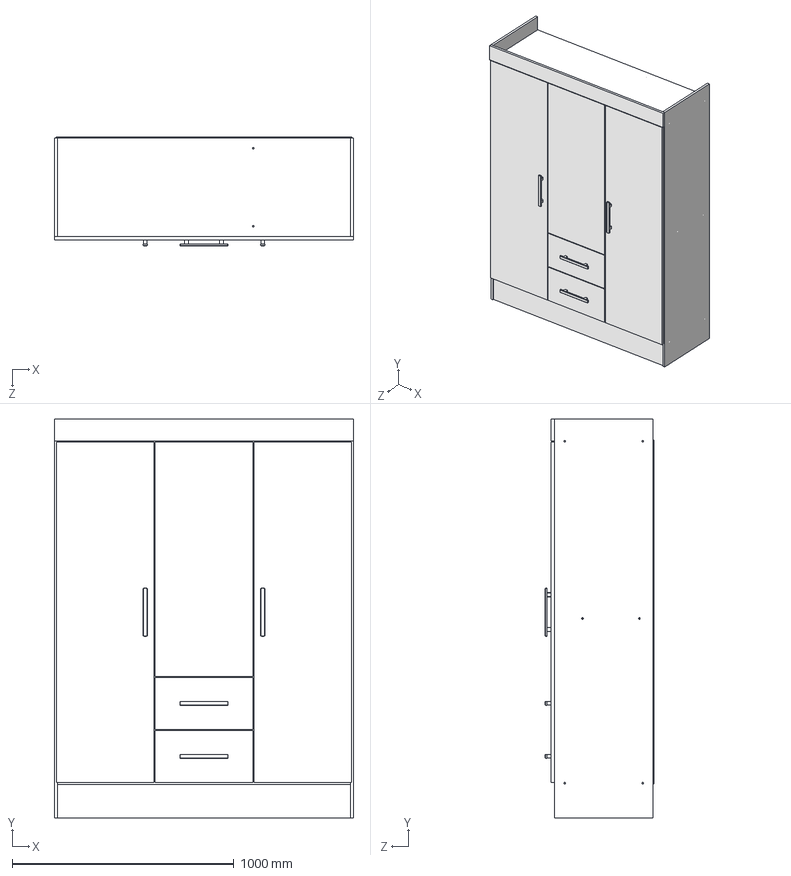
[picture p124: CAD file, 2026-07-28]
modelos_3d/linea-clasica/A032013/A032013.STEP
1350.0 x 1800.0 x 489.5 mm
A032013-COSTADOSIZ
A032013-ESTANTESFI
A032013-TAPASXXXTA
A032013-SEPDORESGR
A032013-ESTANTESMO x 2
A032013-COSTADOSDE
A032013-SEPDORESCH
A032013-PISOSXXXPI
A032013-PUERTASXGR x 2
A032013-FONDOSXXCA x 2
A032013-COSTADOSCA x 4
A032013-FRENTESXCA x 2
A032013-PISOSXXXCA x 2
Manija Gamma x 4
A032013-FRENTESXFR
A032013-ZOCALOSXFA x 2
A032013-FONDOSXXMU x 3
A032013-ESTANTESCH
A032013-PUERTASXCH
A032013-TAPASXXXCH
A032013-CA埆862
