infomueblesgacela/muebles-gacela-mvp/modelos_3d/linea-clasica/A221150/A221150.STEP

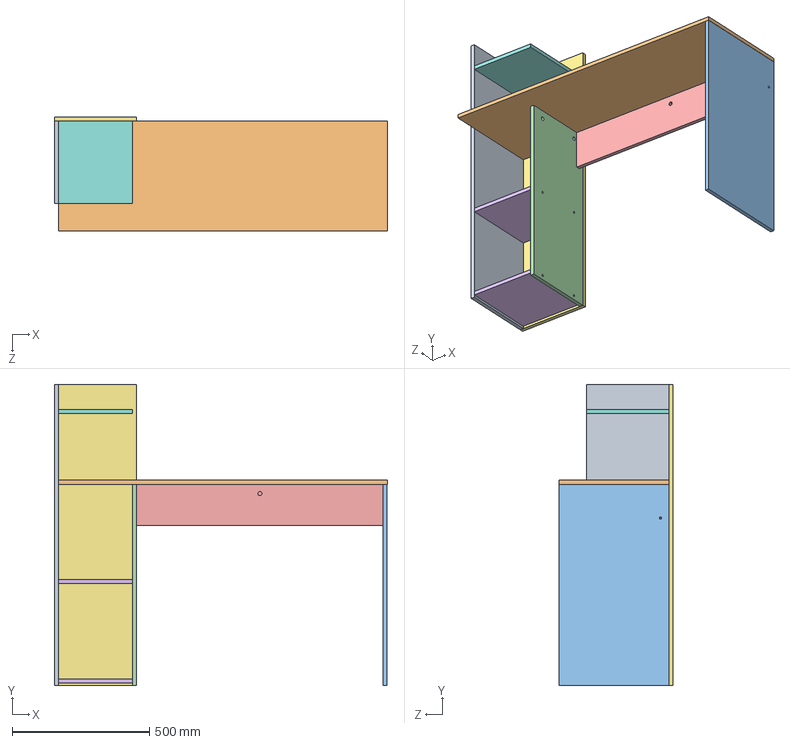
[picture p126: CAD file, 2026-07-28]
modelos_3d/linea-clasica/A221150/A221150.STEP
1215.0 x 1100.0 x 415.0 mm
A221150-COSTADOSIZ
A221150-TAPASXXXTA
A221150-COSTADOSDE
A221150-SEPDORESSE
A221150-FRENTESXFR
A221150-ESTANTESIN x 2
A221150-FONDOSXXVE
A221150-ESTANTESSU
