infomueblesgacela/muebles-gacela-mvp/modelos_3d/linea-clasica/A710150/A710150.STEP

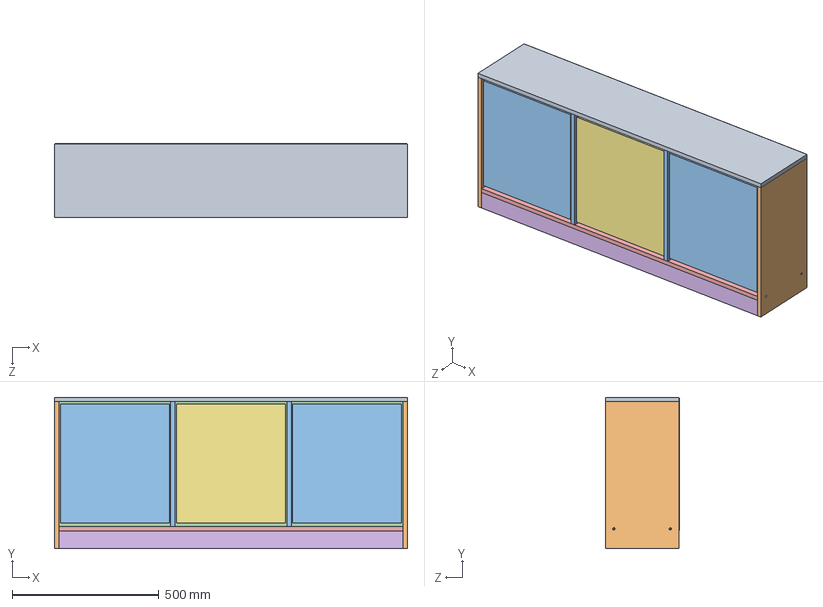
[picture p127: CAD file, 2026-07-28]
modelos_3d/linea-clasica/A710150/A710150.STEP
1201.0 x 515.0 x 253.0 mm
A710150-TAPASXXXTA
A710150-COSTADOSIZ
A710150-SEPDORESIZ
A710150-FONDOSXXFO
A710150-PISOSXXXPI
A710150-ZOCALOSXZO
SimetríaA710150-SEPDORESIZ
SimetríaA710150-COSTADOSIZ
A710150-FRENTESXCC
Costado botinero x 6
A710150-FONDOSXXDI x 6
A710150-PISOSXXXCA x 3
A710150-FRENTESXCL x 2
