infomueblesgacela/muebles-gacela-mvp/modelos_3d/linea-clasica/A712151/A712151.STEP

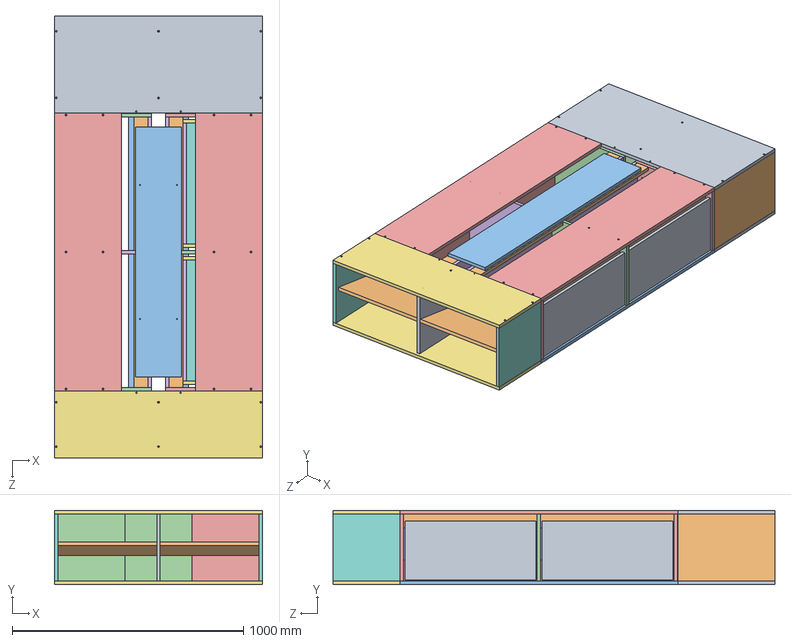
[picture p128: CAD file, 2026-07-28]
modelos_3d/linea-clasica/A712151/A712151.STEP
900.0 x 320.0 x 1910.0 mm
A712151-TAPYPISXCA x 2
A712151-COSTADOSCB x 2
A712151-SEPDORESCB
A712151-FRENTESXCB
A712151-COSTADOSMC
A712151-FONDOSXXCA x 2
A712151-COSTADOSCA x 4
A712151-PISOSXXXCA x 2
A712151-FRENTESXCA x 2
A712151-FAJASXXXRE x 6
A712151-PISOSXXXMC x 4
A712151-SEPDORESMC
A712151-TAPASADEMC x 2
A712151-FRENTESXMC x 2
SimetríaA712151-COSTADOSMC
A712151-TAPYPISXPI x 2
A712151-COSTADOSPI x 2
A712151-SEPDORESPI
A712151-FRENTESXPI
A712151-ESTANTESMO x 2
A712151-FAJASXXXPA
A712151-COSTADOSCC
A712151-FRENTESXCI x 2
A712151-SEPDORESCC
SimetríaA712151-COSTADOSCC
