infomueblesgacela/muebles-gacela-mvp/modelos_3d/linea-clasica/A712152/A712152.STEP

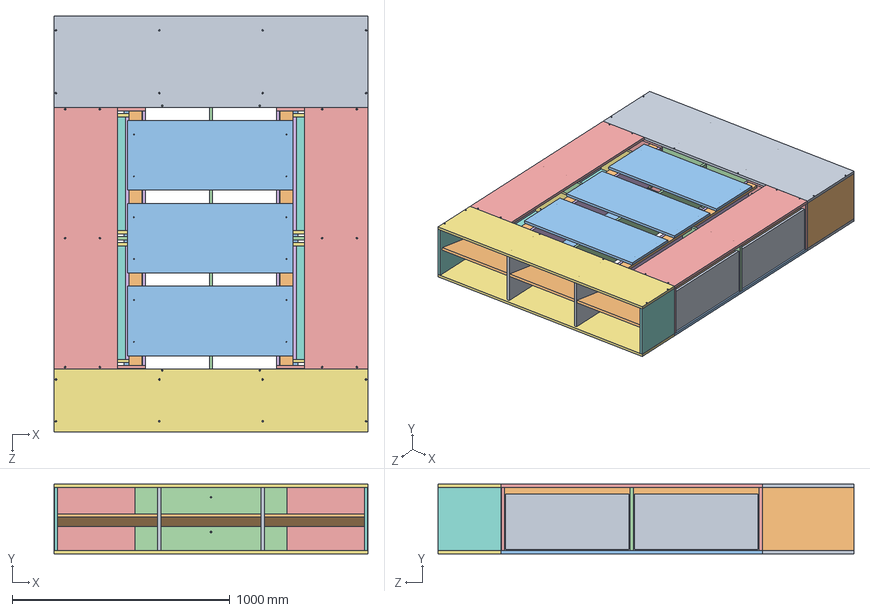
[picture p129: CAD file, 2026-07-28]
modelos_3d/linea-clasica/A712152/A712152.STEP
1440.0 x 320.0 x 1910.0 mm
A712152-TAPYPISXCA x 2
A712152-COSTADOSCB x 2
A712152-SEPDORESCB x 2
A712152-FRENTESXCP x 2
A712152-COSTADOSMC x 2
A712152-FONDOSXXCA x 4
A712152-COSTADOSCA x 8
A712152-PISOSXXXCA x 4
A712152-FRENTESXCA x 4
A712152-FAJASXXXRE x 8
A712152-PISOSXXXMC x 4
A712152-SEPDORESMC x 2
A712152-TAPASADEMC x 2
A712152-FRENTESXMC x 2
SimetríaA712152-COSTADOSMC x 2
A712152-TAPYPISXPI x 2
A712152-COSTADOSPI x 2
A712152-SEPDORESPI x 2
A712152-ESTANTESMO x 3
A712152-FAJASXXXPA x 3
A712152-REFUERZOUN
