infomueblesgacela/muebles-gacela-mvp/modelos_3d/linea-comedores/A000557/A000557.STEP

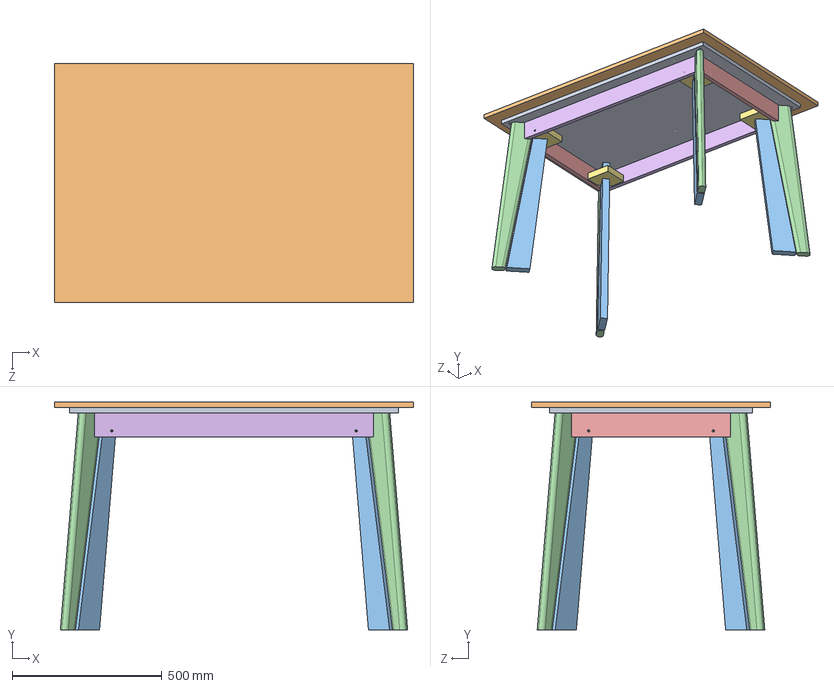
[picture p130: CAD file, 2026-07-28]
modelos_3d/linea-comedores/A000557/A000557.STEP
1200.0 x 761.0 x 800.0 mm
A000557-PATASXXXBASE
A000557-TAPASXXXTAPA
Pata 720 - 30mm x 4
A000557-FAJASXXXCORT x 2
A000557-FAJASXXXLARG x 2
A000557-REFUERZOREFU x 4
