infomueblesgacela/muebles-gacela-mvp/modelos_3d/linea-comedores/A005571/A005571.STEP

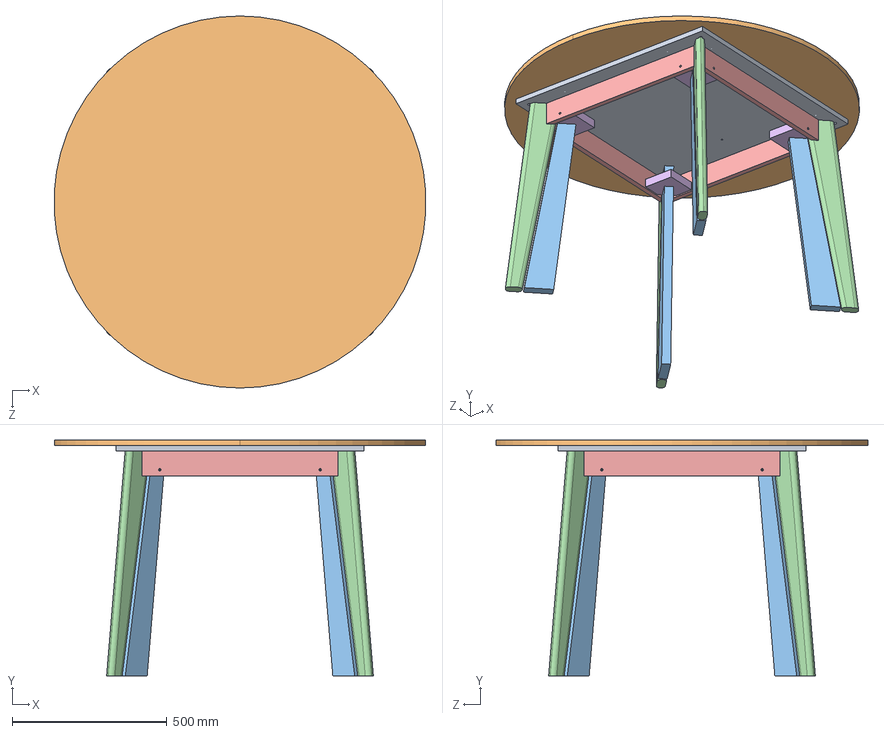
[picture p131: CAD file, 2026-07-28]
modelos_3d/linea-comedores/A005571/A005571.STEP
1198.2 x 761.0 x 1200.0 mm
A005571-PATASXXXBASE
A005571-TAPASXXXTAPA
Pata 720 - 30mm x 4
A005571-FAJASXXXFAJA x 4
A005571-REFUERZOREFU x 4
