infomueblesgacela/muebles-gacela-mvp/modelos_3d/linea-comedores/A005572/A005572.STEP

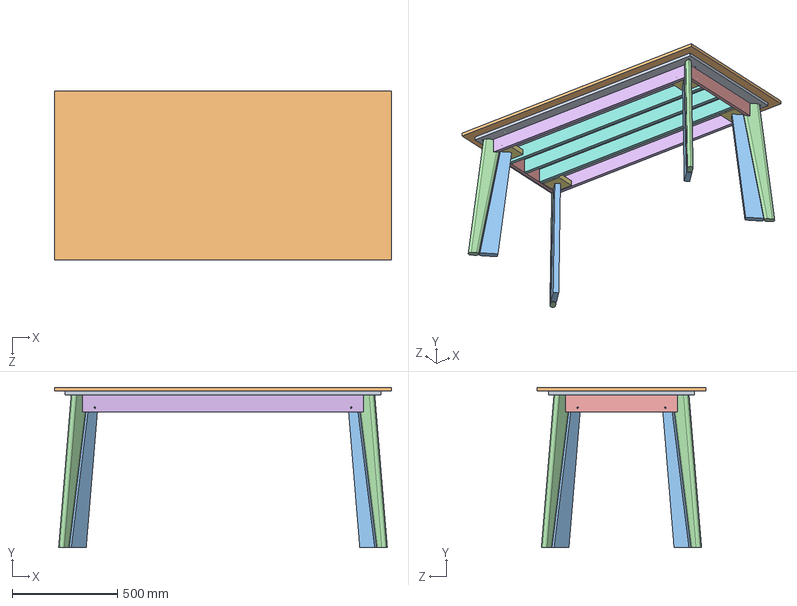
[picture p132: CAD file, 2026-07-28]
modelos_3d/linea-comedores/A005572/A005572.STEP
1600.0 x 761.0 x 800.0 mm
A005572-PATASXXXBASE
A005572-TAPASXXXTAPA
Pata 720 - 30mm x 4
A005572-FAJASXXXCORT x 2
A005572-FAJASXXXLARG x 2
A005572-REFUERZOREFU x 4
A005572-REFUERZOLARG x 3
