infomueblesgacela/muebles-gacela-mvp/modelos_3d/linea-comedores/A427091/A427091.STEP

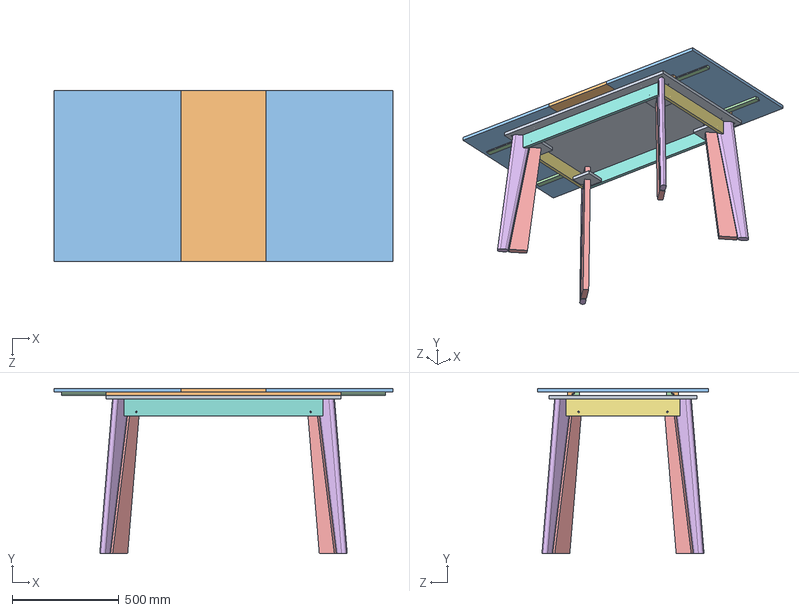
[picture p133: CAD file, 2026-07-28]
modelos_3d/linea-comedores/A427091/A427091.STEP
1590.0 x 776.0 x 800.0 mm
A427091-PATASXXXBA
A427091-TAPASXXXTA x 2
Pata 720 - 30mm x 4
A427091-FAJASXXXCO x 2
A427091-FAJASXXXLA x 2
A427091-REFUERZORE x 4
A427091-TAPASXXXAC
