infomueblesgacela/muebles-gacela-mvp/modelos_3d/linea-comedores/A429090/A429090.STEP

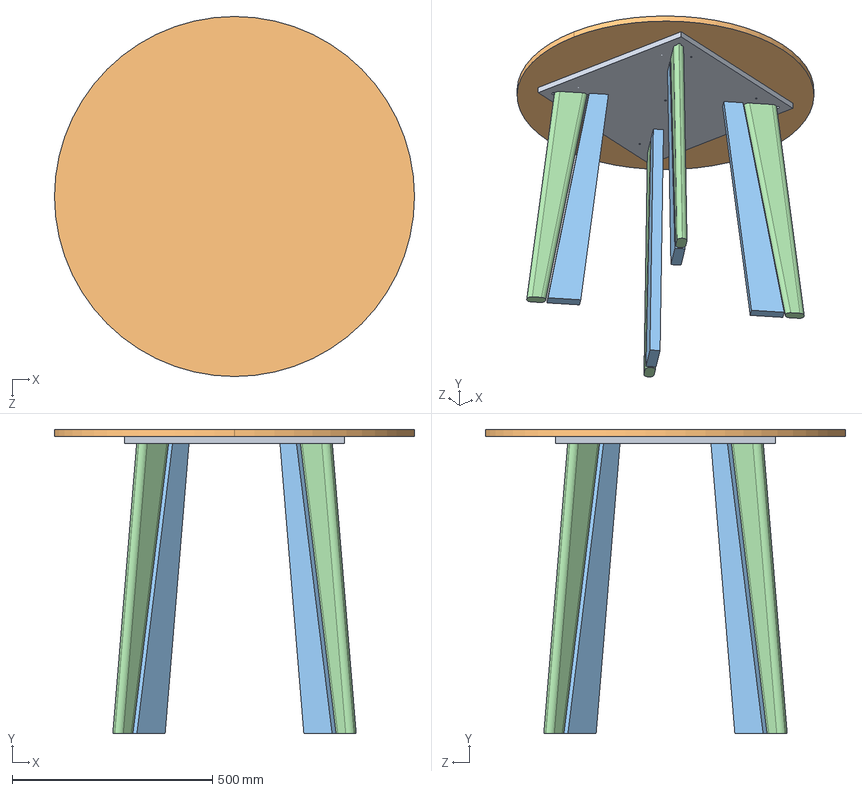
[picture p134: CAD file, 2026-07-28]
modelos_3d/linea-comedores/A429090/A429090.STEP
900.0 x 761.0 x 900.0 mm
A429090-BASESXXXPA
A429090-TAPASXXXTA
Pata 720 - 30mm x 4
