infomueblesgacela/muebles-gacela-mvp/modelos_3d/linea-comedores/A429091/A429091.STEP

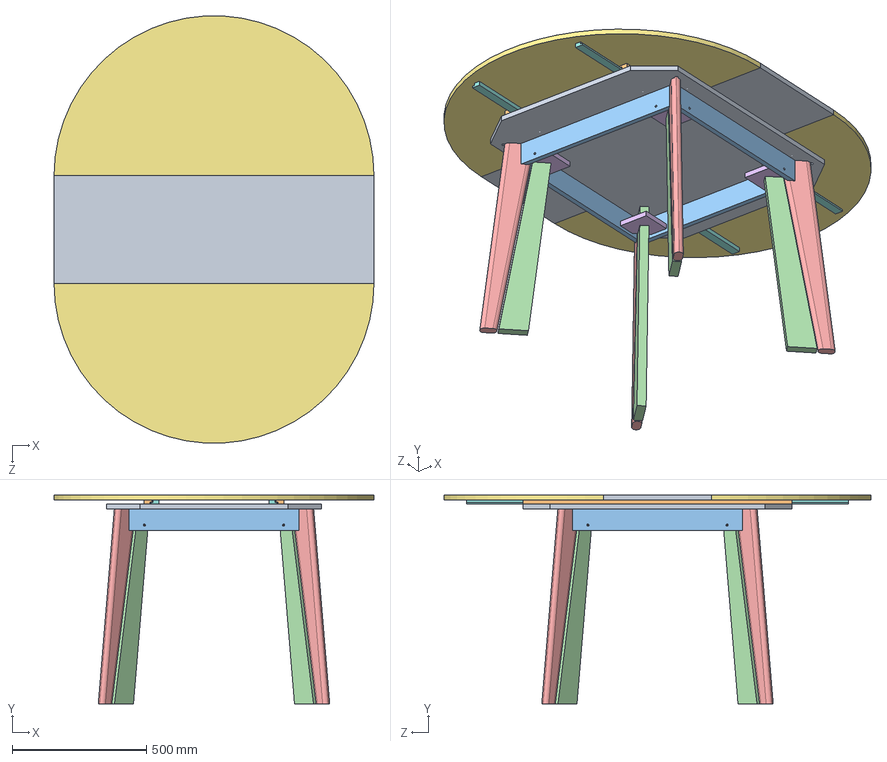
[picture p135: CAD file, 2026-07-28]
modelos_3d/linea-comedores/A429091/A429091.STEP
1190.0 x 776.0 x 1588.0 mm
A429091-PATASXXXBA
A429091-FAJASXXXFA x 4
Pata 720 - 30mm x 4
A429091-REFUERZORE x 4
A429091-TAPASXXXTA x 2
A429091-TAPASXXXEX
