infomueblesgacela/muebles-gacela-mvp/modelos_3d/linea-curvalba/A326270/A326270.STEP

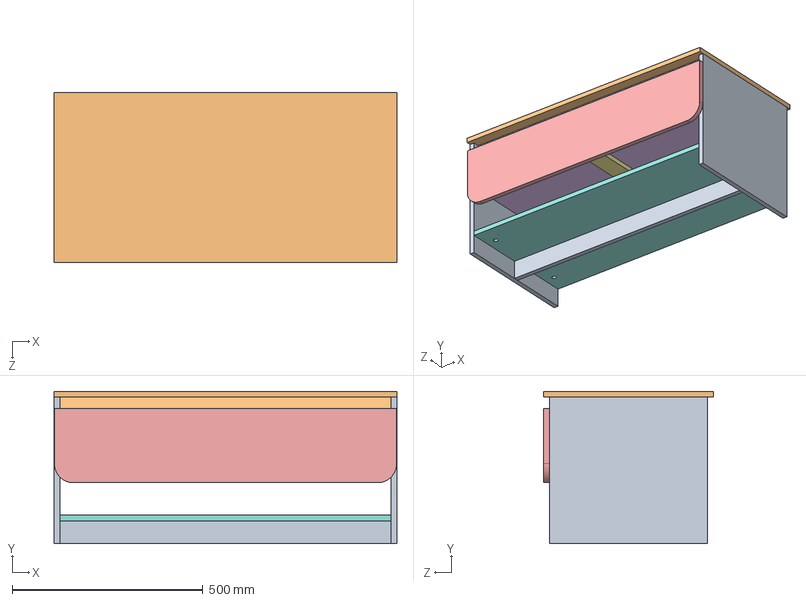
[picture p136: CAD file, 2026-07-28]
modelos_3d/linea-curvalba/A326270/A326270.STEP
900.0 x 400.0 x 445.0 mm
A326270-COSTADOSCO
A326270-TAPASXXXTA
SimetríaA326270-COSTADOSCO
A326270-FONDOSXXCA
A326270-COSTADOSCA x 2
A326270-FRENTECAJO
A326270-PISOSXXXCA
A326270-REFUERZOCA
A326270-PISOSXXXPI
A326270-ZOCALOSXZO
A326270-FAJASXXXFR
A326270-FAJASXXXRE
