infomueblesgacela/muebles-gacela-mvp/(list of files, cad)

Other CAD files:
modelos_3d/linea-curvalba/A334271/A334271.STEP
modelos_3d/linea-curvalba/A334272/A334272.STEP
modelos_3d/linea-curvalba/A353270/A353270.STEP
modelos_3d/linea-curvalba/A372150/A372150.STEP
modelos_3d/linea-curvalba/A405270/A405270.STEP
modelos_3d/linea-curvalba/A446270/A446270.STEP
modelos_3d/linea-curvalba/A732270/A732270.STEP
modelos_3d/linea-curvalba/A742270/A742270.STEP
modelos_3d/linea-curvalba/A742272/A742272.STEP
modelos_3d/linea-curvalba/A742273/A742273.STEP
modelos_3d/linea-gamer/A734222/A734222.STEP
modelos_3d/linea-infantil/A334090/A334090.STEP
modelos_3d/linea-infantil/A740150/A740151.STEP
modelos_3d/linea-infantil/A753153/A753153.STEP
modelos_3d/linea-kyoto/A315250/A315250.STEP
modelos_3d/linea-kyoto/A315251/A315251.STEP
modelos_3d/linea-kyoto/A322250/A322250.STEP
modelos_3d/linea-kyoto/A326250/A326250.STEP
modelos_3d/linea-kyoto/A331250/A331250.STEP
modelos_3d/linea-kyoto/A334250/A334250.STEP
modelos_3d/linea-kyoto/A353250/A353250.STEP
modelos_3d/linea-kyoto/A446250/A446250.STEP
modelos_3d/linea-kyoto/A760250/A760250.STEP
modelos_3d/linea-nordik/A000116/A000238-ALTA.STEP
modelos_3d/linea-nordik/A000116/A002381-BAJA.STEP
modelos_3d/linea-nordik/A234094/A234094.STEP
modelos_3d/linea-nordik/A321021/A321021.STEP
modelos_3d/linea-nordik/A331330/A331330.STEP
modelos_3d/linea-nordik/A334026/A334026.STEP
modelos_3d/linea-nordik/A334093/A334093.STEP
modelos_3d/linea-nordik/A372020/A372020.STEP
modelos_3d/linea-nordik/A372080/A372080_CHICA_ALTA.STEP
modelos_3d/linea-nordik/A372080/A372080_GRANDE_BAJA.STEP
modelos_3d/linea-nordik/A405330/A405330.STEP
modelos_3d/linea-nordik/A446330/A446330.STEP
modelos_3d/linea-nordik/A716330/A716330.STEP
modelos_3d/linea-nordik/A732330/A732330.STEP
modelos_3d/linea-nordik/A742332/A742332.STEP
modelos_3d/linea-nordik/A742334/A742334.STEP
modelos_3d/linea-nordik/A742336/A742336.STEP
