infomueblesgacela/muebles-gacela-mvp/INSTRUCTIVOS_ARMADO_COMPILADOS.md

# 🛠️ BASE OFICIAL DE INSTRUCTIVOS DE ARMADO - MUEBLES GACELA

Total de manuales técnicos compilados: **55 muebles**

---

## 📦 Mesa de Luz LUMA cajón y estante (Blanca) (SKU: 828-5-B)
- **Línea:** CLASICA
- **Dificultad:** Facil | **Tiempo estimado:** 30 min
- **Herramientas necesarias:** Martillo de carpintero, Destornillador de punta en cruz, Llave Allen 4
- **Visor 3D Interactivo:** https://www.mueblesgacela.com.ar/armado/828-5-B

### 🔩 Herrajes incluidos:
- Envase de cola (1 u.)
- Pernos mini fix con caja (6 u.)
- Pares de guías metálicas de 30 cm (1 u.)
- Bases plásticas (4 u.)
- Tornillos Phillips de 5 cm (4 u.)
- Tornillos varianta (4 u.)
- Tarugos 6x30 (14 u.)
- Tornillos de 4 cm (2 u.)
- Tornillos de 2 cm (4 u.)
- Set de Clavos (1 u.)

### 📐 Piezas y Despiece:
- Letra A: Tapa (1 u.) - Medidas: según plano cm
- Letra B: Piso (1 u.) - Medidas: según plano cm
- Letra D: Costado izquierdo (1 u.) - Medidas: según plano cm
- Letra E: Costado derecho (1 u.) - Medidas: según plano cm
- Letra J: Frente cajón (1 u.) - Medidas: según plano cm
- Letra L: Costados de cajón (2 u.) - Medidas: según plano cm
- Letra M: Fondo cajón (1 u.) - Medidas: según plano cm
- Faja (1 u.) - Medidas: según plano cm
- Zócalo (1 u.) - Medidas: según plano cm
- Fondo de mueble (1 u.) - Medidas: según plano cm
- Piso cajón (1 u.) - Medidas: según plano cm

### 🪜 Paso a Paso de Armado:
**Paso 1:** Prepare el costado derecho E, colocando a presión 2 cajas para mini fix, también la guía metálica mediante los tornillos varianta, como lo muestra la figura y desde abajo clave dos bases plásticas. Realice el mismo procedimiento para el costado izquierdo D, teniendo en cuenta que el mismo es simétrico. En las faja y zócalo coloque en los extremos 4 tarugos 6x30. En la tapa A atornillar 4 pernos mini fix.
  - *Herrajes:* Cajas para mini fix, Tornillos varianta, Bases plásticas, Tarugos 6x30, Pernos mini fix
  - 💡 *Consejo Pro:* Idéntico al modelo de referencia, omitido por brevedad estructural según acuerdo mutuo.

**Paso 2:** Una el piso B con los costados D-E mediante 4 tornillos Phillips de 5 cm introduciéndolo en las perforaciones que muestra la figura, previamente haciendo coincidir los tarugos colocados de las faja y zócalo, con las perforaciones de los costados. Desde arriba una la tapa A, a los costados haciendo coincidir los pernos mini fix de la tapa con las perforaciones de las cajas mini fix de los segundos, luego ajuste las piezas girando las cajas 180° en sentido horario.
  - *Herrajes:* Tornillos Phillips de 5 cm, Pernos mini fix, Cajas para mini fix
  - 💡 *Consejo Pro:* Idéntico al modelo de referencia, omitido por brevedad estructural según acuerdo mutuo.

**Paso 3:** Armado del cajón: Coloque 2 tarugos 6x30 en el fondo de cajón M, 2 mas en cada uno de los costados de cajón L a su vez encastrar las cajas mini fix. Agregar adhesivo en cada perforación donde lleve tarugo. Seguidamente coloque dos minifix en el frente de J.
  - *Herrajes:* Tarugos 6x30, Cajas para mini fix, Envase de cola, Pernos mini fix
  - 💡 *Consejo Pro:* Idéntico al modelo de referencia, omitido por brevedad estructural según acuerdo mutuo.

**Paso 4:** Armado de cajón: Una vez armada la estructura tipo 'U' entre L-M-L, ingrese el frente de cajón J ajuste los pernos mini fix girando 180 grados las cajas mini fix. Habiendo agregado el adhesivo anteriormente. Luego ajuste el fondo y los costados mediante los dos tornillos de 4 cm.
  - *Herrajes:* Pernos mini fix, Cajas para mini fix, Tornillos de 4 cm
  - 💡 *Consejo Pro:* Idéntico al modelo de referencia, omitido por brevedad estructural según acuerdo mutuo.

**Paso 5:** Paso 5 armado de cajón: Desde abajo introduzca el piso de cajón sobre el canal del frente de cajón J, y clave este siguiendo una escuadra correcta del cajón sobre los filos inferiores de los costados and del fondo. Finalmente atornille las guías metálicas como muestra la figura mediante 4 tornillos de 2 cm.
  - *Herrajes:* Set de Clavos, Guías metálicas de 30 cm, Tornillos de 2 cm

**Paso 6:** Clave el fondo de mueble, tal como lo indica el grafico, siguiendo el orden correcto y la escuadras justa del mueble. Posteriormente distribuya los clavos a una distancia aproximada de 15 cm entre ellos, proporcionándole la rigidez necesaria al mueble.
  - *Herrajes:* Set de Clavos

**Paso 7:** Finalmente ingrese el cajón haciendo coincidir las guías, como lo muestra la figura.
  - *Herrajes:* Pares de guías metálicas de 30 cm

---

## 📦 Cómoda ALBA con 6 cajones (Blanco-Roble) (SKU: 839-5-BR)
- **Línea:** CLASICA
- **Dificultad:** Medio | **Tiempo estimado:** 90 min
- **Herramientas necesarias:** Martillo de carpintero, Destornillador de punta en cruz, Llave Allen 4, Usar regla para verificar tamaño de tornillos
- **Visor 3D Interactivo:** https://www.mueblesgacela.com.ar/armado/839-5-BR

### 🔩 Herrajes incluidos:
- Envase de cola (1 u.)
- Tornillos Allen o Philips 5 cm (6 u.)
- Pares de guías metálicas de 30 cm (6 u.)
- Tornillos de 4 cm (16 u.)
- Bases plásticas (6 u.)
- Tornillos de 1,5 cm (8 u.)
- Set de Clavos (1 u.)
- Tarugos 6x30 (74 u.)
- Escuadras metálicas (4 u.)
- Tornillos varianta (24 u.)
- Pernos mini fix con caja (17 u.)
- Tornillos de 2 cm (24 u.)

### 📐 Piezas y Despiece:
- Letra A: Tapa (1 u.) - Medidas: 120 x 40 cm
- Letra B: Piso adelante (1 u.) - Medidas: 117 x 8 cm
- Piso atrás (1 u.) - Medidas: 117 x 8 cm
- Letra C: Costado izquierdo (1 u.) - Medidas: 73,5 x 40 cm
- Letra D: Costado derecho (1 u.) - Medidas: 73,5 x 40 cm
- Zócalo frente melamina (1 u.) - Medidas: 117 x 6 cm
- Zócalo atrás crudo (1 u.) - Medidas: 117 x 6 cm
- Letra E: Separador (1 u.) - Medidas: 66 x 38 cm
- Faja (6 u.) - Medidas: 57,6 x 6 cm
- Letra J: Frente cajón izquierdo (3 u.) - Medidas: 57,8 x 19 cm
- Letra K: Frente cajón derecho (3 u.) - Medidas: 57,8 x 19 cm
- Letra L: Costado cajón (12 u.) - Medidas: 35 x 10 cm
- Letra M: Fondo cajón (6 u.) - Medidas: 52 x 10 cm
- Fondo mueble (2 u.) - Medidas: 119,5 x 34,3 cm
- Piso cajón (6 u.) - Medidas: 55 x 32,8 cm

### 🪜 Paso a Paso de Armado:
**Paso 1:** Prepare el costado derecho E, colocando a presión 2 caja mini fix, colocando 3 guías metálicas fijas derechas mediante los tornillos varianta y clavando dos bases plásticas. Realice el mismo procedimiento en el costado izquierdo D, teniendo en cuenta que es simétrico.
  - *Herrajes:* Caja mini fix, Tornillos varianta, Bases plásticas, Guías metálicas
  - 💡 *Consejo Pro:* Observe que la flecha debe estar alineada al orificio para ingresar correctamente.

**Paso 2:** En las fajas frente coloque a presión 4 tarugos guías de 6x30 y solo a dos por medio de los tornillos de 1,5 cm 2 escuadras metálicas, quedando estas en línea con el filo. Prepare los zócalos (frente y atrás), colocando a presión 4 tarugos guías de 6x30 y clavando desde abajo una base plástica dejándola centrada.
  - *Herrajes:* Tarugos guías 6x30, Tornillos de 1,5 cm, Escuadras metálicas, Bases plásticas

**Paso 3:** En el separador E, coloque a presión una caja mini fix, en la cara izquierda atornille 3 guías metálicas fijas derechas mediante los tornillos varianta y en la cara derecha las guías metálicas fijas izquierdas. Verificando que los tornillos variantas no ingresen en la misma perforación. Desde arriba introduzca a presión dos tarugos.
  - *Herrajes:* Caja mini fix, Tornillos varianta, Tarugos 6x30, Guías metálicas

**Paso 4:** En la tapa A atornille 5 pernos mini fix.
  - *Herrajes:* Pernos mini fix

**Paso 5:** En el piso adelante B y en el piso atrás coloque en los extremos 2 tarugos 6x30, en las perforaciones que están en línea con las que muestra la imagen.
  - *Herrajes:* Tarugos 6x30

**Paso 6:** Una el piso adelante B y el piso atrás con el separador F mediante 2 tornillos allen de 5 cm introduciéndolo en las perforaciones que muestra la figura y teniendo en cuenta que los tarugos colocados queden hacia afuera. Luego haga coincidir los tarugos de las fajas frentes a las cuales se le colocaron las escuadras y fíjelas al separador por medio de 2 tornillos de 1,5 cm a través de las escuadras.
  - *Herrajes:* Tornillos allen 5 cm, Tornillos de 1,5 cm

**Paso 7:** Una el piso adelante B y el piso atrás con los costados D - E mediante 4 tornillos allen de 5 cm, introduciéndolo en las perforaciones que muestra la figura, previamente haciendo coincidir los tarugos colocados de las fajas frentes, los tarugos de los pisos y de los zócalos con las perforaciones de los costados y del separador F.
  - *Herrajes:* Tornillos allen 5 cm

**Paso 8:** Armado de cajones: Coloque 2 tarugos 6x30 en el fondo de cajón M, 2 mas en cada uno de los costados de cajón L a su vez encastrar las cajas mini fix. Agregar adhesivo en cada perforación donde lleve tarugo.
  - *Herrajes:* Tarugos 6x30, Cajas mini fix, Envase de cola

**Paso 9:** Armado de cajones: En el frente de cajón derecho K atornillar 2 pernos mini fix.
  - *Herrajes:* Pernos mini fix

**Paso 10:** Armado de cajones: Una vez armada la estructura tipo 'U' entre L-M-L, ingrese el frente de cajón derecho K ajuste los pernos mini fax girando 180 grados las cajas mini fix. Habiendo agregado el adhesivo anteriormente. Luego ajuste el fondo y los costados mediante los dos tornillos 4 cm.
  - *Herrajes:* Pernos mini fix, Cajas mini fix, Tornillos 4 cm
  - 💡 *Consejo Pro:* NOTA: Observe que la flecha debe estar alineada al orificio para ingresar correctamente.

**Paso 11:** Armado de cajones: Desde abajo introduzca el piso de cajón sobre el canal del frente de cajón derecho K, y clave este siguiendo una escuadra correcta del cajón sobre los filos inferiores de los costados y del fondo. Atornille las guías metálicas como muestra la figura mediante 4 tornillos 2 cm.
  - *Herrajes:* Set de Clavos, Guías metálicas, Tornillos 2 cm
  - 💡 *Consejo Pro:* Repetir el proceso con los dos cajones derechos restantes y con los tres cajones izquierdos.

**Paso 12:** Desde arriba una la tapa A, a los costados D - E y al separador F haciendo coincidir los pernos mini fix de la tapa con las perforaciones de las cajas mini fix de los segundos usando como guía los tarugos del separador, luego ajuste las piezas girando las cajas mini fix 180° en sentido horario.
  - *Herrajes:* Pernos mini fix, Cajas mini fix

**Paso 13:** Luego ajuste el zócalo delantero con el piso adelante B y el zócalo atrás con el piso atrás mediante los tornillos de 4 cm, teniendo la precaución que el tornillo entre en la mitad de los zócalos. Y a las fajas frentes con las escuadras metálicas unirla a los costados por medio de 2 tornillos de 1,5 cm.
  - *Herrajes:* Tornillos 4 cm, Escuadras metálicas, Tornillos 1,5 cm

**Paso 14:** Clave el fondo de mueble, tal como lo indica el grafico, siguiendo el orden correcto y la escuadras justa del mueble: 
1 Vértice A-E, 
2 Vértice A-D, 
3 Mitad E, 
4 Mitad D. 
Posteriormente distribuya los clavos a una distancia aproximada de 15 cm entre ellos, proporcionándole la rigidez necesaria al mueble. Repetir el procedimiento con el fondo restante.
  - *Herrajes:* Set de Clavos

**Paso 15:** Finalmente ingrese los cajones haciendo coincidir las guías, como lo muestra la figura. Y teniendo en cuenta que los frentes J son cajones izquierdos y los K derechos. Terminando así la parte de abajo del mueble.
  - *Herrajes:* Guías metálicas
  - 💡 *Consejo Pro:* Colocación de cajones: Colocar los cajones sobre las guías fijas que se encuentran ya en el mueble, como lo muestra la imagen.

---

## 📦 Bahiut GAMMEL con 4 puertas y cajón (Blanco-Roble) (SKU: 902-2-BR)
- **Línea:** CLASICA
- **Dificultad:** Medio | **Tiempo estimado:** 90 min
- **Herramientas necesarias:** Martillo de carpintero, Destornillador de punta en cruz, Llave Allen 4
- **Visor 3D Interactivo:** https://www.mueblesgacela.com.ar/armado/902-2-BR

### 🔩 Herrajes incluidos:
- Envase de cola (1 u.)
- Pernos mini fix con cajas (15 u.)
- Pares de guías metálicas de 350 (1 u.)
- Soporte de estantes (12 u.)
- Tarugos 6x30 (20 u.)
- Bases plásticas (6 u.)
- Escuadras plásticas (2 u.)
- Bisagras codo15 (8 u.)
- Tornillos Phillips de 7 x 50 (8 u.)
- Tornillos varianta (4 u.)
- Tornillos de 4x40 (3 u.)
- Tornillos de 4x30 (4 u.)
- Tornillos de 3.5x20 (4 u.)
- Tornillos de 3.5x16 (36 u.)
- Set de Clavos (1 u.)

### 📐 Piezas y Despiece:
- Letra A: Tapa (1 u.) - Medidas: según plano cm
- Letra B: Piso (1 u.) - Medidas: según plano cm
- Letra C: Costado izquierdo (1 u.) - Medidas: según plano cm
- Letra D: Costado derecho (1 u.) - Medidas: según plano cm
- Letra F: Separador izquierdo (1 u.) - Medidas: según plano cm
- Letra G: Separador derecho (1 u.) - Medidas: según plano cm
- Letra H: Estante grande (1 u.) - Medidas: según plano cm
- Letra I: Faja frente (1 u.) - Medidas: según plano cm
- Letra S: Zócalo delantero (1 u.) - Medidas: según plano cm
- Letra U: Zócalo trasero (1 u.) - Medidas: según plano cm
- Letra V: Estante móvil grande (1 u.) - Medidas: según plano cm
- Letra R: Estante móvil chico (2 u.) - Medidas: según plano cm
- Letra J: Puertas grandes (2 u.) - Medidas: según plano cm
- Letra L: Puertas chicas (2 u.) - Medidas: según plano cm
- Letra N: Frente cajón (1 u.) - Medidas: según plano cm
- Letra O: Costados de cajón (2 u.) - Medidas: 35 x 10 cm
- Letra Q: Fondo cajón (1 u.) - Medidas: según plano cm
- Piso cajón (1 u.) - Medidas: según plano cm
- Refuerzo cajón (1 u.) - Medidas: según plano cm
- Fondo mueble lateral (2 u.) - Medidas: según plano cm
- Fondo mueble centro (3 u.) - Medidas: según plano cm

### 🪜 Paso a Paso de Armado:
**Paso 1:** Prepare el costado derecho D, clavando 2 bases plásticas, atornillando 2 pernos mini fix, colocando a presión 2 soportes de estantes, 2 cajas mini fix y las 2 bases de bisagras por medio de los tornillos 3,5x15. Repetir el proceso con el costado izquierdo C teniendo en cuenta que este es simétrico.
  - *Herrajes:* Bases plásticas, Pernos mini fix, Soporte de estantes, Cajas mini fix, Bisagras codo15, Tornillos de 3.5x16
  - 💡 *Consejo Pro:* NOTA: Observe que la flecha debe estar alineada al orificio para ingresar correctamente.

**Paso 2:** A su vez coloque sobre la puertas chicas L las bisagras mediante los tornillos 3,5x15, hacer lo mismo para las puertas grandes J.
  - *Herrajes:* Bisagras codo15, Tornillos de 3.5x16

**Paso 3:** En el separador izquierdo F, en la cara izquierda colocar a presión dos soportes de estantes. Y en la cara derecha colocar a presión 2 cajas mini fix, 2 soporte de estantes, una guía metálicas por medio de los tornillos varianta y atornillar 2 bases de bisagras y una escuadra plástica por medio de los tornillos 3,5x15. Realizar la misma operación ara el separador derecho G, tener en cuenta que es simétrico.
  - *Herrajes:* Soporte de estantes, Cajas mini fix, Guías metálicas de 350, Tornillos varianta, Bisagras codo15, Escuadras plásticas, Tornillos de 3.5x16
  - 💡 *Consejo Pro:* NOTA: Observe que la flecha debe estar alineada al orificio para ingresar correctamente.

**Paso 4:** En el piso B coloque a presión 4 cajas de mini fix en la cara inferior. Y en los zócalos S-U colocar a presión 5 tarugos 6x30 2 por cada extremo y uno en el filo superior y clavar en el filo inferior 1 base plástica posicionándola en el centro.
  - *Herrajes:* Cajas mini fix, Tarugos 6x30, Bases plásticas
  - 💡 *Consejo Pro:* NOTA: Observe que la flecha debe estar alineada al orificio para ingresar correctamente.

**Paso 5:** Paso 5, armado de cajón: Coloque 2 tarugos 6x30 en el fondo de cajón Q, 2 mas en los costados de cajón O y a su vez en los costados encastrar las cajas mini fix. Agregar adhesivo en cada perforación donde lleve tarugo. Seguidamente coloque dos minifix y el tirador en el frente de cajón N.
  - *Herrajes:* Tarugos 6x30, Cajas mini fix, Envase de cola, Pernos mini fix con cajas
  - 💡 *Consejo Pro:* NOTA: Observe que la flecha debe estar alineada al orificio para ingresar correctamente.

**Paso 6:** Paso 6, armado de cajón: Una vez armada la estructura tipo 'U' entre OQ-O, ingrese el frente de cajón N ajuste los pernos mini fix girando 180 grados las cajas mini fix. Habiendo agregado el adhesivo anteriormente. Luego ajuste el fondo y los costados mediante los dos tornillos 4 x 40.
  - *Herrajes:* Pernos mini fix con cajas, Cajas mini fix, Tornillos de 4x40
  - 💡 *Consejo Pro:* NOTA: Observe que la flecha debe estar alineada al orificio para ingresar correctamente.

**Paso 7:** Paso 7 armado de cajón: Desde abajo introduzca el piso de cajón sobre el canal del frente de cajón I, y clave este siguiendo una escuadra correcta del cajón sobre los filos inferiores de los costados y del fondo. Finalmente atornille las guías metálicas como muestra la figura mediante 4 tornillos 3,5x20.
  - *Herrajes:* Set de Clavos, Guías metálicas de 350, Tornillos de 3.5x20

**Paso 8:** Paso 8 armado de cajón: Haga coincidir la perforación lateral del refuerzo de cajón con el perno mini fix colocado en el frente de cajón N, ajuste las piezas girando la caja mini fix media vuelta en sentido horario. Finalmente ajuste el refuerzo al fondo de cajón Q mediante 1 tornillo 4 x 40
  - *Herrajes:* Pernos mini fix con cajas, Cajas mini fix, Tornillos de 4x40
  - 💡 *Consejo Pro:* NOTA: Observe que la flecha debe estar alineada al orificio para ingresar correctamente.

**Paso 9:** paso 9: Una el separador izquierdo F y el separador derecho G al estante grande H por medio de 4 tornillos Phillips 7x50 como así también al piso B con los mismos tornillos, como lo muestra la figura.
  - *Herrajes:* Tornillos Phillips de 7 x 50

**Paso 10:** paso 10: Haga coincidir el tarugo vertical del zócalo delantero S y del zócalo trasero U con los agujeros centrales del piso B. Seguidamente haga coincidir los mini fix del costado izquierdo C y del derecho D con los agujeros laterales del piso. Previamente introduciendo los tarugos laterales de los zócalos y de la faja frente I, en las perforaciones de los costados. Luego para ajustar las piezas gire la caja para mini fix media vuelta y por medio de 4 tornillos 4x40 una los zócalos al piso. Tener en cuenta que el borde sin filo va hacia atrás. Ajuste la faja frente por medio de 2 tornillos 3,5x15 a través de las escuadras plásticas colocadas en los separadores F-G. Ajuste desde arriba la tapa A haciendo coincidir las perforaciones que se encuentran en los costados and in los separadores, con los pernos mini fix de la misma y posteriormente girando la caja mini fix 180°.
  - *Herrajes:* Tarugos 6x30, Pernos mini fix con cajas, Cajas mini fix, Tornillos de 4x40, Tornillos de 3.5x16, Escuadras plásticas
  - 💡 *Consejo Pro:* NOTA: Observe que la flecha debe estar alineada al orificio para ingresar correctamente.

**Paso 11:** paso 11: Clave los fondos de mueble en los vértices del mismo teniendo en cuenta las escuadras justas del mueble, posteriormente distribuya los clavos a una distancia aproximada de 15 cm entre ellos, proporcionándole la rigidez necesaria al mueble. Distribuya como muestra la figura.
  - *Herrajes:* Set de Clavos

**Paso 12:** paso 12 Luego deslice el estante móvil grande V y los estantes móviles chicos R sobre los soportes previamente colocados en los costados CD y los separadores F-G haciéndolo llegar hasta el fondo.
  - *Herrajes:* Soporte de estantes

**Paso 13:** paso 13: Coloque las puertas grandes J y las puertas chicas L teniendo en cuenta que el tornillo de ajuste lateral A se encuentre enroscado hasta por lo menos la mitad de su recorrido. Una vez ingresada, ajuste la puerta mediante el tornillo de ajuste y de regulación de profundidad C. Para terminar regúle la bisagra como muestra el video 'Regulación de bisagra'.
  - *Herrajes:* Bisagras codo15

**Paso 14:** Finalmente ingrese el cajón haciendo coincidir las guías. Como lo muestra la figura. Finalizando así el armado del mueble.
  - *Herrajes:* Pares de guías metálicas de 350

---

## 📦 Placard ORBIS con 12 puertas abrir, 3 cajones y estantes (SKU: 320-12)
- **Línea:** CLASICA
- **Dificultad:** Alto | **Tiempo estimado:** 240 min
- **Herramientas necesarias:** Martillo de carpintero, Destornillador de punta en cruz, Llave Allen 4
- **Visor 3D Interactivo:** https://www.mueblesgacela.com.ar/armado/320-12

### 🔩 Herrajes incluidos:
- Envase de cola (1 u.)
- Pernos mini fix con caja (6 u.)
- Pares de guías metálicas de 40 cm (3 u.)
- Soporte de estantes (8 u.)
- Tarugos 6x30 (38 u.)
- Bases plásticas (8 u.)
- Escuadras plásticas (5 u.)
- Bisagras codo 9 cazoleta 26 (30 u.)
- Tornillos Phillips 5 cm (32 u.)
- Tornillos varianta (12 u.)
- Tornillos de 4 cm (18 u.)
- Tornillos de 1,5 cm (134 u.)
- Tornillos de 2 cm (12 u.)
- Soporte de caños (4 u.)
- Caños de 57,5 cm (2 u.)
- Manijas cn tornillos de 3 cm (15 u.)
- Set de Clavos (1 u.)

### 📐 Piezas y Despiece:
- Letra A: Tapa arriba (1 u.) - Medidas: 177 x 44,5 cm
- Letra B: Pisos (2 u.) - Medidas: 177 x 44,5 cm
- Letra C: Costado arriba izquierdo (1 u.) - Medidas: 118,5 x 44,5 cm
- Letra D: Costado arriba derecho (1 u.) - Medidas: 118,5 x 44,5 cm
- Letra M: Costado abajo izquierdo (1 u.) - Medidas: 90 x 44,5 cm
- Letra N: Costado abajo derecho (1 u.) - Medidas: 90 x 44,5 cm
- Letra E: Separadores arriba (2 u.) - Medidas: 105,5 x 44,5 cm
- Letra Ñ: Separadores abajo (2 u.) - Medidas: 71,3 x 44,5 cm
- Letra G: Puertas arriba (6 u.) - Medidas: 108 x 29,4 cm
- Letra O: Puertas abajo (6 u.) - Medidas: 49,7 x 29,4 cm
- Letra K: Zócalo frente (1 u.) - Medidas: 177 x 15 cm
- Letra H: Estante móvil (2 u.) - Medidas: 58 x 35 cm
- Letra U: Frente arriba (1 u.) - Medidas: 180 x 10 cm
- Letra L: Zócalo fondo (1 u.) - Medidas: 177 x 15 cm
- Letra I: Tapa abajo frente (1 u.) - Medidas: 177 x 12,5 cm
- Letra J: Tapa abajo fondo (1 u.) - Medidas: 177 x 12,5 cm
- Piso cajón (3 u.) - Medidas: 55,3 x 37,8 cm
- Letra T: Frente cajón (3 u.) - Medidas: 59,1 x 24,7 cm
- Letra P: Costado cajón (6 u.) - Medidas: 40 x 18 cm
- Letra R: Fondo cajón (3 u.) - Medidas: 52,5 x 18 cm
- Fondo mueble arriba (3 u.) - Medidas: 108 x 59,5 cm
- Fondo mueble abajo (3 u.) - Medidas: 108 x 59,5 cm
- Faja frente unión módulos (1 u.) - Medidas: 177 x 8 cm
- Faja fondo unión módulos (1 u.) - Medidas: 108 x 59,5 cm

### 🪜 Paso a Paso de Armado:
**Paso 1:** paso 1: Prepare el costado derecho abajo N, colocando una guía metálica fija derecha mediante los tornillos varianta, dos bases de bisagra mediante los tornillos 1,5 cm y clavando dos bases plásticas en el canto inferior, como lo muestra la figura. Realice el mismo procedimiento para el costado izquierdo abajo M, tenga en cuenta que es simétrico por ende se coloca la guía metálica fija izquierda.
  - *Herrajes:* Guías metálicas, Tornillos varianta, Bases de bisagra, Tornillos 1,5 cm, Bases plásticas

**Paso 2:** paso 2: En los separadores abajo Ñ, en la cara derecha colocar una guía metálica fija izquierda partiendo de la primer perforación mediante los tornillos varianta, con los mismos tornillos colocar en la cara izquierda una guía metálica fija derecha como lo muestra la figura. También atornille dos bases de bisagra mediante los tornillos de 1,5 cm en cada cara.
  - *Herrajes:* Guías metálicas, Tornillos varianta, Bases de bisagra, Tornillos 1,5 cm

**Paso 3:** paso 3: En las puertas abajo O coloque 2 bisagra mediante los tornillos de 1,5 cm y una manija Gama por medio de los tornillos 3 cm.
  - *Herrajes:* Bisagras codo 9 cazoleta 26, Tornillos 1,5 cm, Manijas cn tornillos de 3 cm

**Paso 4:** paso 4: En el zócalo K y fondo L, 4 tarugos en los cantos cortos y dos en el canto superior, además clavar en el canto inferior 2 bases plásticas posicionándola en forma pareja. En las tapas abajo frente I y fondo J 4 tarugos 6x30 2 por cada extremo.
  - *Herrajes:* Tarugos 6x30, Bases plásticas

**Paso 5:** paso 5: Una la tapa abajo frente I y la tapa abajo fondo J con los separadores abajo Ñ por medio de los tornillos Phillips de 5 cm. Desde abajo una el piso B con los separadores mediante los mismos tornillos. Verifique que los filos de la tapa y el piso queden hacia adelante
  - *Herrajes:* Tornillos Phillips 5 cm

**Paso 6:** paso 6: Una el costado derecho abajo N con las tapas abajo I - J y el piso B por medio de los tornillos Phillips de 5 cm. Antes de colocar el costado izquierdo introducir los tarugos del canto corto del zócalo frente K y el zócalo fondo L, en las perforaciones del costado derecho y los tarugos del canto superior en las perforaciones del piso, verificando que la cara con lustre del zócalo frente quede hacia adelante. Una vez echo realice el mismo proceso para el costado izquierdo abajo M. Finalmente ajuste los zócalos al piso mediante 6 tornillos 4 cm introduciendo estos en las perforaciones libre del piso como lo muestra la figura.
  - *Herrajes:* Tornillos Phillips 5 cm, Tarugos 6x30, Tornillos 4 cm

**Paso 7:** paso 7 armado de cajón: Coloque 2 tarugos 6x30 en el fondo de cajón r, 2 mas en cada uno de los costados de cajón P a su vez encastrar las cajas mini fix. Agregar adhesivo en cada perforación donde lleve tarugo.
  - *Herrajes:* Tarugos 6x30, Pernos mini fix con caja
  - 💡 *Consejo Pro:* NOTA: Observe que la flecha debe estar alineada al orificio para ingresar correctamente.

**Paso 8:** paso 8 armado de cajon: Una vez armada la estructura tipo 'U' entre P-R-P, ingrese el frente de cajón T ajuste los pernos mini fix girando 180 grados las cajas mini fix. Habiendo agregado el adhesivo anteriormente. Luego ajuste el fondo y los costados mediante los dos tornillos 4 cm.
  - *Herrajes:* Pernos mini fix con caja, Tornillos 4 cm
  - 💡 *Consejo Pro:* NOTA: Observe que la flecha debe estar alineada al orificio para ingresar correctamente.

**Paso 9:** paso 9 armado de cajón: Atornille 2 minifix en el frente de cajón T. Y coloque la manija gama con 2 tornillo de 3 cm.
  - *Herrajes:* Pernos mini fix con caja, Manijas cn tornillos de 3 cm
  - 💡 *Consejo Pro:* NOTA: Observe que la flecha debe estar alineada al orificio para ingresar correctamente.

**Paso 10:** paso 10 armado de cajón: Desde abajo introduzca el piso de cajón sobre el canal del frente de cajón T, y clave este siguiendo una escuadra correcta del cajón sobre los filos inferiores de los costados y del fondo. Finalmente atornille las guías metálicas como muestra la figura mediante 4 tornillos 2 cm.
  - *Herrajes:* Set de Clavos, Guías metálicas de 40 cm, Tornillos de 2 cm

**Paso 11:** paso 11: Clave el fondo de mueble, tal como lo indica el grafico, siguiendo el orden correcto y la escuadras justa del mueble. Posteriormente distribuya los clavos a una distancia aproximada de 15 cm entre ellos, proporcionándole la rigidez necesaria al mueble. 1 vértice N-J, 2 vértice N-B, 3 vértice Ñ-J, 4 vértice Ñ-B. Luego seguir con los dos restantes.
  - *Herrajes:* Set de Clavos

**Paso 12:** paso 12: Prepare el costado izquierdo arriba C, colocando 3 bases de bisagra mediante los tornillos de 1,5 cm y un soporte plástico de caño haciéndolo encastrar en la perforación central superior y luego ajustándolo mediante un tornillo de 1,5 cm, como lo muestra la figura. Realice el mismo procedimiento para el costado derecho arriba D, teniendo en cuenta que es simétrico.
  - *Herrajes:* Bases de bisagra, Tornillos 1,5 cm, Soporte plástico de caño

**Paso 13:** paso 13: A los separadores arriba E hay que convertir uno en izquierdo y otro en derecho. Al derecho le colocamos 3 bases de bisagra en cada cara mediante los tornillos de 1,5 cm, luego en la cara que da hacia los laterales el soporte plástico de caño haciéndolo encastrar en la perforación central superior y luego ajustándolo mediante un tornillo de 1,5 cm, como lo muestra la figura. En la otra cara coloque a presión 4 soportes de estantes Para crear el separador izquierdo arriba. Realice el mismo procedimiento anterior pero invirtiendo las caras en el separador restante.
  - *Herrajes:* Bases de bisagra, Tornillos 1,5 cm, Soporte plástico de caño, Soportes de estantes

**Paso 14:** paso 14: En las puertas arriba G coloque 3 bisagras mediante los tornillos de 1,5 cm y una manija Gama por medio de los tornillos 3 cm.
  - *Herrajes:* Bisagras codo 9 cazoleta 26, Tornillos 1,5 cm, Manijas cn tornillos de 3 cm

**Paso 15:** paso 15: En el frente arriba U, coloque 5 escuadras plásticas mediante tornillos 3,5x15.
  - *Herrajes:* Escuadras plásticas, Tornillos 3,5x15

**Paso 16:** paso 16: Una la tapa arriba A y el piso B con los separadores arriba E, habiendo creado uno izquierdo y uno derecho y de esta manera colocándolo según su posición (ver imagen), mediante los tornillos Phillips de 5 cm introduciéndolo en las perforaciones que muestra la figura. Luego una los costados arriba C-D con la tapa y el piso mediante los mismos tornillos.
  - *Herrajes:* Tornillos Phillips 5 cm

**Paso 17:** paso 17: Clave el fondo de mueble, tal como lo indica el grafico, siguiendo el orden correcto y la escuadras justa del mueble. Posteriormente distribuya los clavos a una distancia aproximada de 15 cm entre ellos, proporcionándole la rigidez necesaria al mueble. 1 vértice A-C, 2 vértice C-B, 3 vértice B-E, 4 vértice A-E Repita el proceso para los fondos restantes. Luego alinee la faja arriba U con los bordes superiores de los costados C-D y seguidamente atornille la misma por medio de 5 tornillos de 1,5 cm aferrando la faja por medio de las 5 escuadras plásticas 2 con los costados arriba y 3 con la tapa. Finalmente introduzca los estantes móviles H sobre los soportes de estantes y los caños sobre los soportes plásticos para caño.
  - *Herrajes:* Set de Clavos, Tornillos 1,5 cm, Escuadras plásticas, Soportes de estantes, Soporte plástico de caño

**Paso 18:** paso 18: Vincule ambos módulos. Previamente colocando entre ellos las fajas unión de módulos. Las perforaciones deben quedar hacia las caras externas, por ende la faja frente quedara con el canto melaminico hacia el frente. Luego colocamos el modulo superior sobre el inferior, apoyando sobre las fajas y haciendo coincidir las perforaciones del piso B con las de las fajas, para luego unir los módulos mediante 6 tornillos de 4 cm y atornillado este a las tapas abajo I-J. Finalmente coloque las puertas arriba G en los costados arriba C-D y los separadores arriba E como lo indica la guía de 'Colocación de bisagras'.
  - *Herrajes:* Tornillos 4 cm

**Paso 19:** paso 19: Colocar los cajones sobre las guías fijas que se encuentran ya en el mueble, como lo muestra la imagen.
  - *Herrajes:* Guías metálicas

---

## 📦 Placard SPECULA 3 puertas ESPEJO, 2 cajones (SKU: 320-13)
- **Línea:** CLASICA
- **Dificultad:** Alto | **Tiempo estimado:** 120 min
- **Herramientas necesarias:** Martillo de carpintero, Destornillador de punta en cruz
- **Visor 3D Interactivo:** https://www.mueblesgacela.com.ar/armado/320-13

### 🔩 Herrajes incluidos:
- Tornillos Philips o Allen de 7 x 50 (26 u.)
- Caño 5/8 de 862 mm (1 u.)
- Envase de cola (1 u.)
- Escuadras plásticas (4 u.)
- Tornillos de 4x40 (8 u.)
- Tornillos de 3.5x20 (8 u.)
- Tarugos 6x30 (20 u.)
- Set de Clavos (1 u.)
- Bases plásticas (6 u.)
- Soporte de estantes (8 u.)
- Manijas gama con tornillos 3,5x30 (4 u.)
- Liave Allen (1 u.)
- Bisagras codo 9 cazoleta 26 y 3 cazoleta 35 (6 u.)
- Tornillos de 3.5x15 (46 u.)
- Tornillos varianta (8 u.)
- Soportes plásticos de 5/8 (2 u.)
- Pernos mini fix con cajas (4 u.)
- Pares de guías metálicas de 400 (2 u.)

### 📐 Piezas y Despiece:
- Letra A: Tapa (1 u.) - Medidas: S/M cm
- Letra B: Piso (1 u.) - Medidas: S/M cm
- Letra C: Costado izquierda (1 u.) - Medidas: S/M cm
- Letra D: Costado derecha (1 u.) - Medidas: S/M cm
- Letra U: Frente arriba (1 u.) - Medidas: S/M cm
- Letra E: Separador grande (1 u.) - Medidas: S/M cm
- Letra F: Estante fijo (1 u.) - Medidas: S/M cm
- Letra G: Puertas grandes (2 u.) - Medidas: S/M cm
- Letra H: Estante móvil (2 u.) - Medidas: S/M cm
- Letra I: Estante fijo chico (1 u.) - Medidas: S/M cm
- Letra J: Tapa chica (1 u.) - Medidas: S/M cm
- Letra K: Zócalo frente (1 u.) - Medidas: S/M cm
- Letra L: Zócalo fondo (1 u.) - Medidas: S/M cm
- Letra O: Puertas chica (1 u.) - Medidas: S/M cm
- Letra N: Separador chico (1 u.) - Medidas: S/M cm
- Letra T: Frente cajón (2 u.) - Medidas: S/M cm
- Letra P: Costados de cajón (4 u.) - Medidas: S/M cm
- Letra R: Fondo cajón (2 u.) - Medidas: S/M cm
- Letra -: Piso cajón (2 u.) - Medidas: S/M cm
- Letra -: Fondo de mueble (3 u.) - Medidas: S/M cm

### 🪜 Paso a Paso de Armado:
**Paso 1:** Paso 1: Prepare el costado izquierdo C, atornillando 3 bases de bisagra cazoleta 26 y por ultimo el soporte plástico de caño haciéndolo encastrar en la perforación central superior, todos mediante los tornillos 3,5x15. Clave dos bases plásticas, como lo muestra la figura.
  - *Herrajes:* Bases de bisagra cazoleta 26, Soporte plástico de caño, Tornillos 3,5x15, Bases plásticas

**Paso 2:** Paso 2: Prepare el costado derecho D, atornillando 3 bases de bisagra cazoleta 26 mediante los tornillos 3,5x15. Clave dos bases plásticas, como lo muestra la figura. y por ultimo encastrar 4 soporte de estantes.
  - *Herrajes:* Bases de bisagra cazoleta 26, Tornillos 3,5x15, Bases plásticas, Soporte de estantes

**Paso 3:** Paso 3: Y en los zócalos K-L 4 tarugos y clavar en el filo inferior una base plástica posicionándola al medio.
  - *Herrajes:* Tarugos, Bases plásticas

**Paso 4:** Paso 4: En el frente arriba U, coloque 4 escuadras plásticas mediante tornillos 3,5x15 dejando su cara libre hacia el filo mas cercano.
  - *Herrajes:* Escuadras plásticas, Tornillos 3,5x15

**Paso 5:** paso 5: En la cara izquierda del separador grande E, coloque 3 bases de bisagra cazoleta 35 un soporte plástico de caño haciéndolo encastrar en la perforación central superior, y ajustarlos mediante los tornillos 3,5x15. También 2 guías metálicas mediante los tornillos varianta. Y en la cara derecha coloque a presión 4 soporte de estantes.
  - *Herrajes:* Bases de bisagra cazoleta 35, Soporte plástico de caño, Tornillos 3,5x15, Guías metálicas, Tornillos varianta, Soporte de estantes

**Paso 6:** paso 6: En las puertas grandes G coloque 3 bisagra cazoleta 26 mediante los tornillos 3.5x15 y una manija Gama por medio des los tornillos 3.5x30. Haga lo mismo con la puerta chica O pero sin manija y las bisagras cazoleta 35. En el separador chico Ñ, coloque 2 guías metálicas mediante los tornillos varianta.
  - *Herrajes:* Bisagras cazoleta 26, Tornillos 3,5x15, Manija Gama, Tornillos 3,5x30, Bisagras cazoleta 35, Guías metálicas, Tornillos varianta

**Paso 7:** paso 7: Por medio de los tornillos 7x50 Phillips o Allen una la tapa A, el piso B, el estante fijo F y el estante fijo chico I con el separador grande E como muestra la figura.
  - *Herrajes:* Tornillos 7x50 Phillips o Allen

**Paso 8:** paso 8 armado de cajón: Coloque 2 tarugos 6x30 en el fondo de cajón R, 2 mas en cada uno de los costados de cajón P, a su vez en los costados encastrar las cajas mini fix. Agregar adhesivo en cada perforación donde lleve tarugo.
  - *Herrajes:* Tarugos 6x30, Cajas mini fix, Envase de cola

**Paso 9:** paso 9: En el frente de cajón T atornillar 2 pernos mini fix y una manija Gamma con los tornillos 3,5x30. Luego repetir el proceso con los otros dos frentes.
  - *Herrajes:* Pernos mini fix, Manija Gamma, Tornillos 3,5x30

**Paso 10:** paso 10 armado de cajones: Una vez armada la estructura tipo 'U' entre P-R-P, ingrese el frente de cajón T ajuste los pernos mini fix girando 180 grados las cajas mini fix. Habiendo agregado el adhesivo anteriormente. Luego ajuste el fondo y los costados mediante los dos tornillos 4x40.
  - *Herrajes:* Pernos mini fix, Cajas mini fix, Envase de cola, Tornillos 4x40

**Paso 11:** paso 11: Desde abajo introduzca el piso de cajón sobre el canal del frente de cajón T, y clave este siguiendo una escuadra correcta del cajón sobre los filos inferiores de los costados y del fondo. Finalmente atornille las guías metálicas como muestra la figura mediante 4 tornillos 3,5x20.
  - *Herrajes:* Set de Clavos, Guías metálicas, Tornillos 3,5x20

**Paso 12:** paso 12: Presente el costado derecho D haciendo coincidir las perforaciones pasantes de este con las perforaciones de la tapa A, el piso B y el estante fijo chico I luego ajuste con los tornillos Phillips o Allen de 7x50. Antes de colocar el costado izquierdo C introducir los tarugos de los zócalos frente K y fondo L en las perforaciones del costado derecho verificando que la cara con lustre del zócalo frente quede hacia adelante. Una vez echo realice el mismo proceso para el costado izquierdo con la tapa, el piso y el estante fijo F. Verifique que los filos melaminicos queden hacia adelante. Mediante los tornillos 7x50 Phillips o Allen, una el separador chico Ñ al piso B,la tapa chica J al separador chico y al separador grande E.
  - *Herrajes:* Tornillos 7x50 Phillips o Allen, Tarugos

**Paso 13:** paso 13: Clave el fondo de mueble, tal como lo indica el grafico, siguiendo el orden correcto y la escuadras justa del mueble. Posteriormente distribuya los clavos a una distancia aproximada de 15 cm entre ellos, proporcionándole la rigidez necesaria al mueble. Luego alinee la faja arriba U con el borde superior de los costados C-D y seguidamente atornille la misma por medio de 4 tornillos 3,5x15 aferrando la faja por medio de las escuadras plásticas. 
1 vértice A-D 
2 vértice D-B 
3 vértice B-E 
4 vértice A-E. 
Repita el proceso para los fondos restantes. Finalmente ajuste los zócalos a los pisos mediante 4 tornillos 4x40 introduciéndolo en las perforaciones que muestra la figura.
  - *Herrajes:* Set de Clavos, Tornillos 3,5x15, Escuadras plásticas, Tornillos 4x40

**Paso 14:** paso 14: Ingrese los cajones haciendo coincidir las guías móviles de este con las guías fijas colocadas en el separador chico Ñ y el separador grande E. También coloque el caño sobre los soportes de caño colocados en el costado izquierdo C y el separador grande. Y finalmente los estantes móviles H sobre los soporte de estantes del separador grande y del costado derecho D.
  - *Herrajes:* Guías metálicas, Soporte de caños, Soporte de estantes

**Paso 15:** paso 15: Finalmente coloque las puertas grandes G en los costados C-D y la puerta chica O, en el separadores E, teniendo en cuenta que el tornillo de ajuste lateral A se encuentre enroscado hasta por lo menos la mitad de su recorrido. Una vez ingresada, ajuste la puerta mediante el tornillo de ajuste y de regulación de profundidad C. Luego regúlelas según identifica el video 'Regulación de bisagra'.
  - *Herrajes:* Bisagras cazoleta 26, Bisagras cazoleta 35
  - 💡 *Consejo Pro:* Colocación de cajones: Colocar los cajones sobre las guías fijas que se encuentran ya en el mueble, como lo muestra la imagen.

---

## 📦 Placard SERENA 3 puertas corredizas, 6 cajones (SKU: 708-15)
- **Línea:** CLASICA
- **Dificultad:** Alto | **Tiempo estimado:** 150 min
- **Herramientas necesarias:** Martillo de carpintero, Destornillador de punta en cruz, Llave Allen 4 mm, Cinta métrica, Usar regla para verificar tamaño de tornillos
- **Visor 3D Interactivo:** https://www.mueblesgacela.com.ar/armado/708-15

### 🔩 Herrajes incluidos:
- Manijas con tornillos de 3 cm (6 u.)
- Carros inferiores (6 u.)
- Envase de cola (1 u.)
- Escuadras plásticas (10 u.)
- Pares de guías metálicas de 40 cm (6 u.)
- Manijas athenas (3 u.)
- Tornillos Allen de 5 cm (24 u.)
- Caños de 57,5 cm (2 u.)
- Pernos mini fix con caja (12 u.)
- Bases plásticas (8 u.)
- Tornillos de 2 cm (24 u.)
- Tornillos de 1.5 cm (60 u.)
- Soporte de estantes (8 u.)
- Tornillos varianta (24 u.)
- Tornillos de 4 cm (32 u.)
- Soporte de caños (4 u.)
- Set de Clavos (1 u.)
- Trabas (6 u.)
- Clips (6 u.)
- Perfil guía inferior de 176 cm (2 u.)
- Tarugos 6x30 (72 u.)
- Perfil guía superior de 176 cm (2 u.)

### 📐 Piezas y Despiece:
- Letra M: Costado abajo izquierdo (1 u.) - Medidas: 63 x 55 cm
- Letra N: Costado abajo derecho (1 u.) - Medidas: 63 x 55 cm
- Letra A: Tapa y piso arriba (2 u.) - Medidas: 177 x 55 cm
- Letra C: Costado arriba izquierdo (1 u.) - Medidas: 143,5 x 55 cm
- Letra D: Costado arriba derecho (1 u.) - Medidas: 143,5 x 55 cm
- Letra E: Separador arriba (2 u.) - Medidas: 133,2 x 44,5 cm
- Letra G: Puerta lateral izquierda (1 u.) - Medidas: 132 x 61,4 cm
- Letra H: Puerta lateral derecha (1 u.) - Medidas: 132 x 61,4 cm
- Letra T: Puerta centro (1 u.) - Medidas: 132 x 59,1 cm
- Letra -: Zócalo frente (1 u.) - Medidas: 177 x 12,5 cm
- Letra -: Zócalo fondo (1 u.) - Medidas: 177 x 12,5 cm
- Letra Z: Estante móvil (2 u.) - Medidas: 58 x 40 cm
- Letra V: Frente arriba (1 u.) - Medidas: 180 x 12 cm
- Letra -: Piso cajón (6 u.) - Medidas: 55,3 x 37,8 cm
- Letra N: Separador abajo (2 u.) - Medidas: 46,8 x 55 cm
- Letra -: Faja unión módulos (2 u.) - Medidas: 177 x 8 cm
- Letra W: Frente medio (1 u.) - Medidas: 180 x 7 cm
- Letra -: Tapa y piso abajo (3 u.) - Medidas: 177 x 12,5 cm
- Letra I: Piso abajo (1 u.) - Medidas: 177 x 12,5 cm
- Letra R: Frente cajón izquierdo (2 u.) - Medidas: 60 x 23,7 cm
- Letra S: Frente cajón derecho (2 u.) - Medidas: 60 x 23,7 cm
- Letra U: Frente cajón centro (2 u.) - Medidas: 59,1 x 23,7 cm
- Letra O: Costado cajón (12 u.) - Medidas: 40 x 18 cm
- Letra Q: Fondo cajón (6 u.) - Medidas: 52,5 x 18 cm
- Letra -: Fondo mueble arriba (3 u.) - Medidas: 136 x 59,5 cm
- Letra -: Fondo mueble abajo (1 u.) - Medidas: 179,5 x 49,3 cm

### 🪜 Paso a Paso de Armado:
**Paso 1:** Prepare el costado derecho abajo N, colocando dos guías metálicas fijas derecha mediante los tornillos varianta y clavando dos bases plásticas en el canto inferior, como lo muestra la figura. Realice el mismo procedimiento para el costado izquierdo abajo M, tenga en cuenta que es simétrico por ende se coloca la guía metálica fija izquierda.
  - *Herrajes:* Guías metálicas, Tornillos varianta, Bases plásticas

**Paso 2:** En los separadores abajo Ñ, en la cara derecha colocar dos guías metálicas fijas izquierda partiendo de la primer perforación mediante los tornillos varianta, con los mismos tornillos colocar en la cara izquierda dos guías metálicas fijas derecha como lo muestra la figura.
  - *Herrajes:* Guías metálicas, Tornillos varianta

**Paso 3:** En las tapas y pisos I-J colocar a presión dos cajas mini fix y 4 tarugos de 3 cm 2 por cada extremo. En el zócalo K y fondo L, 4 tarugos en los cantos cortos y dos en el canto superior, además clavar en el canto inferior 2 bases plásticas posicionándola en forma pareja.
  - *Herrajes:* Cajas mini fix, Tarugos, Bases plásticas

**Paso 4:** Una las tapas y pisos I-J con los separadores abajo Ñ haciendo coincidir los tarugos que se encuentran en estos con las perforaciones que tiene las tapas y los pisos. Verificar que el filo del piso I quede hacia adelante. Luego ajuste las piezas mediante 8 tornillos de 4 cm introduciéndolo en las perforaciones que muestra la figura.
  - *Herrajes:* Tornillos de 4 cm

**Paso 5:** Una el costado derecho abajo N con las tapas y piso abajo por medio de los tornillos Allen de 5 cm, previamente haciendo coincidir los tarugos de las tapa y piso abajo en las perforaciones en los costados. Antes de colocar el costado izquierdo introducir los tarugos del canto corto del zócalo frente y del zócalo fondo, en las perforaciones del costado derecho y los tarugos del canto superior en las perforaciones de los pisos, verificando que la cara con lustre del zócalo frente quede hacia adelante. Una vez echo realice el mismo proceso para el costado izquierdo abajo M.
  - *Herrajes:* Tornillos Allen 5 cm, Tarugos

**Paso 6:** Ajuste los zócalos al piso mediante 6 tornillos 4 cm introduciendo estos en las perforaciones libre de los pisos abajo como lo muestra la figura. Clave el fondo de mueble, tal como lo indica el grafico, siguiendo el orden correcto y la escuadras justa del mueble. Posteriormente distribuya los clavos a una distancia aproximada de 15 cm entre ellos, proporcionándole la rigidez necesaria al mueble. 1 vértice N-J arriba 2 vértice N-J abajo 3 vértice M-J arriba 4 vértice M-J abajo. Luego clavar a los separadores.
  - *Herrajes:* Tornillos 4 cm, Set de Clavos

**Paso 7:** A los separadores arriba E hay que convertir uno en izquierdo y otro en derecho. Al derecho le colocamos en la cara que da hacia los laterales el soporte plástico de caño haciéndolo encastrar en la perforación central superior y luego ajustándolo mediante un tornillo de 1,5 cm, como lo muestra la figura. En la otra cara coloque a presión 4 soportes de estantes. Para crear el separador izquierdo arriba. Realice el mismo procedimiento anterior pero invirtiendo las caras en el separador restante. Prepare el costado izquierdo C y el costado derecho arriba D, colocando un soporte plástico de caño haciéndolo encastrar en la perforación central superior y luego ajustándolo mediante un tornillo de 1,5 cm.
  - *Herrajes:* Soporte plástico de caño, Tornillos 1,5 cm, Soporte de estantes

**Paso 8:** En el frente arriba V y en el frente medio W coloque 5 escuadras plásticas mediante tornillos de 1,5 cm, quedando la cara de apoyo hacia el lado de mayor superficie.
  - *Herrajes:* Escuadras plásticas, Tornillos 1,5 cm

**Paso 9:** A la tapa A cerca del canto donde esta mas despejado de las perforaciones, colocamos 2 rieles superiores (a las medidas que muestra la figura) mediante 6 tornillos de 1,5 cm en las perforaciones que tienen estos, centrándolos en el ancho.
  - *Herrajes:* Perfil guía superior, Tornillos 1,5 cm

**Paso 10:** Al piso A cerca del canto donde esta mas despejado de las perforaciones, colocamos 2 rieles inferiores (a las medidas que muestra la figura) mediante 6 tornillos de 1,5 cm en las perforaciones que tienen estos, centrándolos en el ancho.
  - *Herrajes:* Perfil guía inferior, Tornillos 1,5 cm

**Paso 11:** En las puertas G-H-T introduzca a presión las manijas athenas en las perforaciones que se encuentran en la cara frontal. En la cara posterior introduzca el perno del carro inferior en la perforación grande y luego atorníllelo mediante 2 tornillos 1,5 cm, el carro debe quedar horizontal, haga lo mismo para el carro restante. Luego coloque los clips en las marcas superiores con 4 tornillos 1,5.
  - *Herrajes:* Manijas athenas, Carros inferiores, Tornillos 1,5 cm, Clips
  - 💡 *Consejo Pro:* SOLO CUANDO SE COLOQUE LA PUERTA coloque la traba deslizando sobre el clip como muestra la figura hasta que la media esfera entre en el circulo de la traba.

**Paso 12:** Una la tapa y piso arriba, teniendo en cuenta que las guías superiores e inferiores queden enfrentadas como muestra la imagen, con los separadores arriba E, habiendo creado uno izquierdo y uno derecho y de esta manera colocándolo según su posición (ver imagen), mediante los tornillos Phillips de 5 cm introduciéndolo en las perforaciones que muestra la figura. Luego una los costados arriba C-D con la tapa y el piso mediante los mismos tornillos.
  - *Herrajes:* Tornillos Phillips 5 cm

**Paso 13:** Clave el fondo de mueble, tal como lo indica el grafico, siguiendo el orden correcto y la escuadras justa del mueble. Posteriormente distribuya los clavos a una distancia aproximada de 15 cm entre ellos, proporcionándole la rigidez necesaria al mueble. 1 vértice TAPA-C arriba 2 vértice PISO-C abajo 3 vértice PISO-E abajo 4 vértice TAPA-E arriba. Repita el proceso para los fondos restantes. Luego alinee la faja arriba V con los bordes superiores de los costados C-D y seguidamente atornille la misma por medio de 5 tornillos de 1,5 cm aferrando la faja por medio de las 5 escuadras plásticas 2 con los costados arriba y 3 con la tapa. Finalmente introduzca los estantes móviles Z sobre los soportes de estantes y los caños sobre los soportes plásticos para caño.
  - *Herrajes:* Set de Clavos, Tornillos 1,5 cm, Escuadras plásticas, Soporte de estantes, Soportes plásticos de caño

**Paso 14:** Armado de cajones: Coloque 2 tarugos 6x30 en el fondo de cajón Q, 2 mas en cada uno de los costados de cajón O a su vez encastrar las cajas mini fix. Agregar adhesivo en cada perforación donde lleve tarugo.
  - *Herrajes:* Tarugos 6x30, Cajas mini fix, Envase de cola

**Paso 15:** Armado de cajones: Una vez armada la estructura tipo 'U' entre O-Q-O, ingrese el frente de cajón T ajuste los pernos mini fix girando 180 grados las cajas mini fix. Habiendo agregado el adhesivo anteriormente. Luego ajuste el fondo y los costados mediante los dos tornillos 4 cm.
  - *Herrajes:* Pernos mini fix, Cajas mini fix, Envase de cola, Tornillos 4 cm

**Paso 16:** Armado de cajones: Atornille 2 minifix en el frente de cajón U. Y coloque la manija gama con 2 tornillo de 3 cm.
  - *Herrajes:* Pernos mini fix, Manija Gama, Tornillos 3 cm

**Paso 17:** Armado de cajones: Desde abajo introduzca el piso de cajón sobre el canal del frente de cajón U, y clave este siguiendo una escuadra correcta del cajón sobre los filos inferiores de los costados y del fondo. Finalmente atornille las guías metálicas como muestra la figura mediante 4 tornillos de 2 cm. Repita la operación para el resto de los cajones, solo cambian los frente de cajones ya que dependen de su posición en el mueble.
  - *Herrajes:* Set de Clavos, Guías metálicas, Tornillos 2 cm

**Paso 18:** Definiendo la ubicación final del mueble (requiere la ayuda de otra persona), vincule ambos módulos. Previamente colocando entre ellos las fajas unión de módulos. Con las perforaciones cercanas a borde hacia las caras externas y deben coincidir con las perforaciones pasantes restantes de las tapa y piso abajo. Luego colocamos el modulo superior sobre el inferior, apoyando sobre las fajas unión de módulos, para luego ser unidos desde abajo mediante 6 tornillos de 4 cm y atornillado este al piso arriba A. Coloque las puertas en las posiciones que muestra la figura. Los rieles del fondo son para la puerta derecha H y la puerta Izquierda G y los del frente para la puerta centro I. Introduzca primero las puertas derecha e izquierda ingresando la parte superior de las mismas entre los rieles superiores, luego apoye los carros en los rieles inferiores (ver detalle detalle en pagina 9). Finalmente coloque la traba en los clips fijos quedando la guía superior completa corriendo en el riel superior. Repita el proceso para la puerta centro.
  - *Herrajes:* Tornillos 4 cm, Carros inferiores, Trabas, Clips

**Paso 19:** Ingrese los cajones según su posición como lo muestra la imagen, haciendo coincidir las guías, como lo indica la guía de 'Colocación de cajones'.
  - *Herrajes:* Guías metálicas

**Paso 20:** Finalmente alinee la faja media W con el borde inferior de la tapa abajo y los bordes de los costados C-D y seguidamente atornille la misma por medio de 5 tornillos de 1,5 cm aferrando la faja por medio de las 5 escuadras plásticas 2 con los costados arriba y 3 con el piso arriba.
  - *Herrajes:* Tornillos 1,5 cm, Escuadras plásticas

---

## 📦 Escritorio OPUS con repisas (SKU: 221150)
- **Línea:** CLASICA
- **Dificultad:** Bajo | **Tiempo estimado:** 30 min
- **Herramientas necesarias:** Martillo de carpintero, Destornillador de punta en cruz, Usar regla para verificar tamaño de tornillos
- **Visor 3D Interactivo:** https://www.mueblesgacela.com.ar/armado/221150

### 🔩 Herrajes incluidos:
- Tornillos de 4 cm (15 u.)
- Tornillos Phillips de 5 cm (4 u.)
- Bases plásticas con clavos (6 u.)
- Pernos mini fix con caja (5 u.)
- Tarugos 6x30 (4 u.)
- Set de Clavos (1 u.)

### 📐 Piezas y Despiece:
- Letra A: Tapa (1 u.) - Medidas: 120 x 40 cm
- Letra B: Costado izquierdo (1 u.) - Medidas: 110 x 30 cm
- Letra C: Costado derecho (1 u.) - Medidas: 73,5 x 40 cm
- Letra D: Separador (1 u.) - Medidas: 73,5 x 30 cm
- Letra E: Fondo vertical (1 u.) - Medidas: 110 x 30 cm
- Letra H: Frente (1 u.) - Medidas: 90 x 15 cm
- Letra F: Estante arriba (1 u.) - Medidas: 27 x 30 cm
- Letra G: Estante abajo (2 u.) - Medidas: 27 x 30 cm

### 🪜 Paso a Paso de Armado:
**Paso 1:** Prepare el estante arriba F colocando a presión 2 tarugos 6x30 como muestra la figura, en el canto con 3 perforaciones. En el frente H, coloque a presión una caja mini fix, y dos tarugos 6x30. En la tapa A atornille 5 pernos mini fix. Tanto en el costado derecho C como en el separador D coloque a presión 2 cajas para mini fix y desde abajo clave 2 bases plásticas. En el costado izquierdo B clave 2 bases plásticas.
  - *Herrajes:* Tarugos 6x30, Caja mini fix, Pernos mini fix, Cajas para mini fix, Bases plásticas
  - 💡 *Consejo Pro:* NOTA: Observe que la flecha debe estar alineada al orificio para ingresar correctamente.

**Paso 2:** Una el separador D con el frente H y el costado derecho C mediante dos tornillos Phillips de 5 cm usando de guía los tarugos del frente. Luego desde arriba una la tapa A al costado derecho al separador y al frente, introduciendo los pernos minifix de la tapa en las perforaciones de las cajas minifix de estos. Para ajustar las piezas gire 180 grados en sentido horario las cajas mini fix.
  - *Herrajes:* Tornillos Phillips de 5 cm, Cajas mini fix, Pernos mini fix

**Paso 3:** Una el separador D con los estantes abajo G y el costado izquierdo B mediante 4 tornillos Phillips de 5 cm. A su vez una la tapa A con el costado izquierdo este al estante arriba por medio de 4 tornillos mas. Finalmente desde atrás una el fondo vertical E a los estantes abajo por medio de 4 tornillos de 4 cm y al estante arriba por medio de 1 tornillo phillips de 5 cm y usando como guía los tarugos.
  - *Herrajes:* Tornillos Phillips de 5 cm, Tornillos de 4 cm

---

## 📦 Botinero ARCA con 3 cajones rebatibles (SKU: 710150)
- **Línea:** CLASICA
- **Dificultad:** Alto | **Tiempo estimado:** 90 min
- **Herramientas necesarias:** Martillo de carpintero, Destornillador de punta en cruz
- **Visor 3D Interactivo:** https://www.mueblesgacela.com.ar/armado/710150

### 🔩 Herrajes incluidos:
- Tornillos Philips de 7 x 50 (8 u.)
- Kit botineros (3 u.)
- Bases plásticas (5 u.)
- Pernos mini fix con cajas (8 u.)
- Tornillos de 3.5x25 (30 u.)
- Tarugos 6x30 (6 u.)
- Set de clavos (1 u.)
- Tornillos de 3.5x15 (12 u.)

### 📐 Piezas y Despiece:
- Letra A: Tapa (1 u.) - Medidas: S/M cm
- Letra B: Piso (1 u.) - Medidas: S/M cm
- Letra C: Costado izquierdo (1 u.) - Medidas: S/M cm
- Letra D: Costado derecho (1 u.) - Medidas: S/M cm
- Letra E: Separador izq. (1 u.) - Medidas: S/M cm
- Letra F: Separador der. (1 u.) - Medidas: S/M cm
- Letra G: Frente cajón lateral (2 u.) - Medidas: S/M cm
- Letra H: Frente cajón centro (1 u.) - Medidas: S/M cm
- Letra J: Fondo y divisor de cajón (6 u.) - Medidas: S/M cm
- Letra -: Piso de cajón (3 u.) - Medidas: S/M cm
- Letra -: Fondo mueble (1 u.) - Medidas: S/M cm
- Letra -: Zócalo (1 u.) - Medidas: S/M cm

### 🪜 Paso a Paso de Armado:
**Paso 1:** Prepare el costado izquierdo C, colocando a presión 1 soporte de eje y 2 cajas mini fix. A su vez, coloque 1 tope por medio de 1 tornillo 3,5x25 y, desde abajo, clave 2 bases plásticas. Repita el proceso para el costado derecho D, teniendo en cuenta que es simétrico.
  - *Herrajes:* Soporte de eje, Cajas mini fix, Tornillo 3,5x25, Bases plásticas

**Paso 2:** En el separador izquierdo E, en la cara izquierda, coloque a presión 1 soporte de eje y 2 cajas mini fix. A su vez, coloque 1 tope por medio de 1 tornillo 3,5x25. Repita el proceso en la cara derecha, sin las cajas, y note que las perforaciones se encuentran hacia arriba desplazadas. Repita el proceso para el separador derecho F, teniendo en cuenta que es simétrico.
  - *Herrajes:* Soporte de eje, Cajas mini fix, Tornillo 3,5x25

**Paso 3:** En el zócalo, coloque a presión 6 tarugos 6x30 y, desde abajo, clave 1 base plástica. En la tapa A, atornille 8 pernos mini fix en las perforaciones de bordes.
  - *Herrajes:* Tarugos 6x30, Base plástica, Pernos mini fix

**Paso 4:** Una el piso B con el separador izquierdo E y con el separador F por medio de 4 tornillos Phillips 7x50. Luego, encastre los tarugos superiores del zócalo en las perforaciones inferiores del piso y, seguidamente, una el costado izquierdo C y el costado derecho D al piso por medio de los tornillos Phillips 7x50 restantes, previamente haciendo coincidir los tarugos de los zócalos con las perforaciones de los costados. Desde arriba, una la tapa A con los costados y los separadores, haciendo coincidir las perforaciones que se encuentran en estos últimos con los pernos mini fix de la tapa. Luego, ajuste las piezas girando las cajas para mini fix media vuelta en sentido horario.
  - *Herrajes:* Tornillos Phillips 7x50, Tarugos, Pernos mini fix, Cajas mini fix

**Paso 5:** Atornille los costados plásticos al fondo de cajón J y al piso de cajón por medio de 6 tornillos 3,5x25: 4 para el fondo y 2 para el piso. Note que los costados plásticos tienen una letra impresa: 'I' (costado izquierdo) y 'D' (costado derecho). Colóquelas según su posición y como muestra la figura.
  - *Herrajes:* Tornillos 3,5x25

**Paso 6:** Atornille los costados plásticos al frente de cajón centro H por medio de 4 tornillos 3,5x15. Realice esta operación para los frentes de cajones laterales G, teniendo en cuenta que las perforaciones están levemente desplazadas.
  - *Herrajes:* Tornillos 3,5x15

**Paso 7:** Clave el fondo de mueble de 3 mm, tal como lo indica el gráfico, siguiendo el orden correcto y la escuadra justa del mueble. Posteriormente, distribuya los clavos a una distancia aproximada de 15 cm entre ellos, proporcionándole la rigidez necesaria al mueble. Orden de los vértices: Vértice A-C, Vértice A-D, Vértice B-D, Vértice B-C. Introduzca los cajones haciendo coincidir el círculo de los costados plásticos con el soporte de eje ya colocado en los costados C-D y en los separadores E-F. Manteniendo el cajón abierto y los costados plásticos tocando los topes ya colocados, introduzca los ejes y ajústelos mediante los tornillos que vienen en el kit. Una vez ajustados los ejes, introduzca el divisorio J y fíjelo mediante 2 tornillos 3,5x25.
  - *Herrajes:* Set de clavos, Tornillos 3,5x25

---

## 📦 Cama BOX NIDUS 1 plaza 2 cajones (SKU: 712151)
- **Línea:** CLASICA
- **Dificultad:** Alto | **Tiempo estimado:** 105 min
- **Herramientas necesarias:** Martillo de carpintero, Destornillador de punta en cruz, Llave Allen N°4
- **Visor 3D Interactivo:** https://www.mueblesgacela.com.ar/armado/712151

### 🔩 Herrajes incluidos:
- Envase de cola (1 u.)
- Tornillos Allen 5 cm (60 u.)
- Pernos mini fix con caja (4 u.)
- Tarugos 6x30 (52 u.)
- Tornillos de 2.5 cm (16 u.)
- Pares de guías metálicas de 35 cm (2 u.)
- Bases plásticas (24 u.)
- Tornillos varianta (8 u.)
- Tornillos de 2 cm (8 u.)
- Tornillos de 4 cm (4 u.)
- Set de Clavos (1 u.)
- Soportes de estantes (8 u.)

### 📐 Piezas y Despiece:
- Letra A: Tapa cabecera (1 u.) - Medidas: 90 x 42 cm
- Letra B: Piso cabecera (1 u.) - Medidas: 90 x 42 cm
- Letra C: Tapa piecera (1 u.) - Medidas: 90 x 29 cm
- Letra D: Piso piecera (1 u.) - Medidas: 90 x 29 cm
- Letra E: Costado cabecera (2 u.) - Medidas: 42 x 29 cm
- Letra O: Costado izquierdo cajonera (1 u.) - Medidas: 42 x 29 cm
- Letra P: Costado derecho cajonera (1 u.) - Medidas: 42 x 29 cm
- Letra Q: Costado izquierdo módulo ciego (1 u.) - Medidas: 42 x 29 cm
- Letra R: Costado derecho módulo ciego (1 u.) - Medidas: 42 x 29 cm
- Letra H: Separador piecera (1 u.) - Medidas: 29 x 26 cm
- Letra G: Costado piecera (2 u.) - Medidas: 29 x 29 cm
- Letra J: Fondo piecera (1 u.) - Medidas: 29 x 29 cm
- Letra L: Tapa cajonera (2 u.) - Medidas: 120 x 29 cm
- Letra N: Separador cajonera (1 u.) - Medidas: 40,5 x 29 cm
- Letra F: Faja parrilla (1 u.) - Medidas: 108 x 20 cm
- Letra M: Piso adelante cajonera (2 u.) - Medidas: 120 x 10 cm
- Letra -: Piso atrás cajonera (2 u.) - Medidas: 120 x 10 cm

### 🪜 Paso a Paso de Armado:
**Paso 1:** paso 1: Prepare el separador cajonera Ñ atornillando una guía metálica fija derecha en la cara izquierda y una guía metálica izquierda en la cara derecha mediante los tornillos varianta. En el costado cajonera derecho P, atornille una guía metálica derecha y en el costado cajonera izquierdo O una guía metálica izquierda mediante los tornillos varianta[cite: 17].
  - *Herrajes:* Pares de guías metálicas de 35 cm, Tornillos varianta

**Paso 2:** paso 2: Tanto en las fajas refuerzo adelante como en las fajas refuerzo atrás como en frente modulo ciego coloque a presión 4 tarugos en las perforaciones que muestra la figura[cite: 17].
  - *Herrajes:* Tarugos 6x30

**Paso 3:** paso 3: Desde atrás y mediante dos tornillos Allen de 5 cm, una el separador cajonera Ñ con el fondo cajonera, seguidamente a este mismo unirle el costado izquierdo cajonera O y el costado derecho cajonera P. Previamente haga coincidir los tarugos guías de las fajas refuerzo adelanta y atrás, con las perforaciones de los costados y el separador. Verifique que los cantos melaminicos de las fajas refuerzo atrás queden hacia el frente[cite: 17].
  - *Herrajes:* Tornillos Allen 5 cm, Tarugos 6x30

**Paso 4:** paso 4: esde arriba y mediante seis tornillos Allen 5 cm, una la tapa cajonera L con el separador cajonera Ñ, el costado izquierdo cajonera O y el costado derecho cajonera P. Desde abajo y por medio de seis tornillos Allen de 5 cm una el piso cajonera adelante M y el piso cajonera atrás a los costados y al separador. Finalmente coloque a presión las 6 bases plásticas en las perforaciones libres de los pisos[cite: 17].
  - *Herrajes:* Tornillos Allen 5 cm, Bases plásticas

**Paso 5:** paso 5: Desde arriba y mediante 6 tornillos Allen de 5cm, una la tapa piecera C con el separador piecera H y los costados piecera G (verificando que los cantos melaminicos queden hacia adelante). Colocar a presión en el fondo piecera J 4 tarugos guías en las perforaciones que indica la figura. Desde abajo y mediante 6 tornillos Allen de 5 cm, una el piso piecera D con el separador piecera y los costados piecera (verificando que los cantos melaminicos queden hacia adelante). Previamente haciendo coincidir los tarugos guías del fondo con las perforaciones de la tapa y el piso.. Finalmente coloque a presión los soporte de estantes uno fijo al frente y el trasero puede tener 2 posiciones abajo quedando el estante inclinado hacia abajo y al medio quedando el estante horizontal[cite: 17].
  - *Herrajes:* Tornillos Allen 5 cm, Tarugos 6x30, Soportes de estantes

**Paso 6:** paso 6: Coloque los estantes K sobre los soporte de estantes clocados en los costados piecera G y en el separador piecera H. Finalmente coloque a presión las 6 bases plásticas en las perforaciones libres de los pisos. Repetir los pasos 4-5 para la cabecera teniendo en cuenta que no lleva estantes ni soporte de estantes[cite: 17].
  - *Herrajes:* Bases plásticas

**Paso 7:** paso 7: Arme el modulo ciego, usando los pasos 2 y 3 de cajonera pero utilizando el costado modulo ciego izquierdo Q, el costado modulo ciego derecho R, el separador ciego S y los frentes ciegos. Realizar el mismo procedimiento pero tener en cuenta que no lleva guías metálicas y los frentes ciegos cubren todos el cubo[cite: 17].
  - *Herrajes:* Tornillos Allen 5 cm, Tarugos 6x30

**Paso 8:** paso 8 armado de cajones: Coloque 2 tarugos 6x30 en el fondo de cajón V, 2 mas en cada uno de los costados de cajón U a su vez encastrar las cajas mini fix. Agregar adhesivo en cada perforación donde lleve tarugo[cite: 17].
  - *Herrajes:* Tarugos 6x30, Cajas mini fix, Envase de cola

**Paso 9:** paso 9 armado de cajones: Atornille 2 minifix en el frente de cajón T[cite: 17].
  - *Herrajes:* Pernos mini fix con caja

**Paso 10:** paso 10 armado de cajones: Una vez armada la estructura tipo "U" entre UV-U, ingrese el frente de cajón T ajuste los pernos mini fix girando 180 grados las cajas mini fix.Habiendo agregado el adhesivo anteriormente. Luego ajuste el fondo y los costados mediante los dos tornillos 4x40[cite: 17].
  - *Herrajes:* Pernos mini fix con caja, Cajas mini fix, Envase de cola, Tornillos de 4 cm

**Paso 11:** paso 11 armado de cajones: Desde abajo introduzca el piso de cajón sobre el canal del frente de cajón T, y clave este siguiendo una escuadra correcta del cajón sobre los filos inferiores de los costados y del fondo. Finalmente atornille las guías metálicas como muestra la figura mediante 4 tornillos 3,5x20[cite: 17].
  - *Herrajes:* Set de Clavos, Pares de guías metálicas de 35 cm, Tornillos de 2 cm

**Paso 12:** Paso 12: Una la cajonera a la cabecera y a la piecera por medio de 6 tornillos de 2,5 cm a través de los costados de las cajonera y ajustando a los fondos de cabecera y piecera. Ajuste el modulo ciego al resto de componentes uniendo la faja parrilla F a las fajas refuerzo atrás por medio de 4 tornillos de 2,5 cm. Finalmente coloque los cajones en las cajoneras como se explica en la guía de "colocación de cajones"[cite: 17].
  - *Herrajes:* Tornillos de 2.5 cm

**Paso 13:** Paso 13: Colocar los cajones sobre las guías fijas que se encuentran ya en el mueble, como lo muestra la imagen[cite: 17].
  - *Herrajes:* Pares de guías metálicas de 35 cm
  - 💡 *Consejo Pro:* Colocación de cajones: Colocar los cajones sobre las guías fijas que se encuentran ya en el mueble, como lo muestra la imagen[cite: 17].

---

## 📦 Cama BOX AUREA 2 plazas 4 cajones (SKU: 712152)
- **Línea:** CLASICA
- **Dificultad:** Alto | **Tiempo estimado:** 105 min
- **Herramientas necesarias:** Martillo de carpintero, Destornillador de punta en cruz, Llave Allen N°4
- **Visor 3D Interactivo:** https://www.mueblesgacela.com.ar/armado/712152

### 🔩 Herrajes incluidos:
- Envase de cola (1 u.)
- Tornillos Allen 5 cm (80 u.)
- Pernos mini fix con caja (8 u.)
- Tarugos 6x30 (56 u.)
- Tornillos de 2.5 cm (24 u.)
- Pares de guías metálicas de 35 cm (4 u.)
- Bases plásticas (28 u.)
- Tornillos varianta (16 u.)
- Tornillos de 2 cm (16 u.)
- Soportes de estantes (12 u.)
- Set de clavos (1 u.)

### 📐 Piezas y Despiece:
- Letra A: Tapa cabecera (1 u.) - Medidas: 144 x 42 cm
- Letra B: Piso cabecera (1 u.) - Medidas: 144 x 42 cm
- Letra C: Tapa piecera (1 u.) - Medidas: 144 x 29 cm
- Letra D: Piso piecera (1 u.) - Medidas: 144 x 29 cm
- Letra E: Costado cabecera (2 u.) - Medidas: 42 x 29 cm
- Letra F: Costado izquierdo cajonera (2 u.) - Medidas: 42 x 29 cm
- Letra G: Costado derecho cajonera (2 u.) - Medidas: 42 x 29 cm
- Letra H: Separador piecera (2 u.) - Medidas: 29 x 26 cm
- Letra I: Costado piecera (2 u.) - Medidas: 29 x 29 cm
- Letra J: Fondo piecera (1 u.) - Medidas: 70 x 29 cm
- Letra K: Tapa cajonera (2 u.) - Medidas: 120 x 29 cm
- Letra L: Separador cajonera (2 u.) - Medidas: 40,2 x 29 cm
- Letra M: Faja parrilla (3 u.) - Medidas: 760 x 320 cm
- Letra N: Estantes (3 u.) - Medidas: 46 x 26 cm
- Letra -: Piso adelante cajonera (2 u.) - Medidas: 120 x 10 cm
- Letra P: Piso atrás cajonera (2 u.) - Medidas: 120 x 10 cm

### 🪜 Paso a Paso de Armado:
**Paso 1:** Paso 1: Prepare los separadores cajonera Ñ atornillando una guía metálica fija derecha en la cara izquierda y una guía metálica izquierda en la cara derecha mediante los tornillos varianta. En los costados cajonera derechos P, atornille una guía metálica derecha y en los costados cajonera izquierdos O una guía metálica izquierda mediante los tornillos variantas.
  - *Herrajes:* Pares de guías metálicas de 35 cm, Tornillos varianta

**Paso 2:** Paso 2: Tanto en las fajas refuerzo adelante como en las fajas refuerzo atrás coloque a presión 4 tarugos en las perforaciones que muestra la figura.
  - *Herrajes:* Tarugos 6x30

**Paso 3:** paso 3: Desde atrás y mediante dos tornillos Allen 7 x 50, una el separador cajonera Ñ con el fondo cajonera, seguidamente a este mismo unirle el costado izquierdo cajonera O y el costado derecho cajonera P. Previamente haga coincidir los tarugos guías de las fajas refuerzo adelanta y atrás, con las perforaciones de los costados y el separador.
  - *Herrajes:* Tornillos Allen 5 cm, Tarugos 6x30
  - 💡 *Consejo Pro:* consejo gaci bot: Verifique que los cantos melaminicos de las fajas refuerzo atrás queden hacia el frente.

**Paso 4:** paso 4: Desde arriba y mediante seis tornillos Allen 7 x 50, una la tapa cajonera L con el separador cajonera Ñ, el costado izquierdo cajonera O y el costado derecho cajonera P. Desde abajo y por medio de seis tornillos Allen de 7 x 50 una el piso cajonera adelante M y el piso cajonera atrás a los costados y al separador. Finalmente coloque a presión las 6 bases plásticas en las perforaciones libres de los pisos. Son dos cuerpos de cajonera, repetir paso 2-3 para la restante.
  - *Herrajes:* Tornillos Allen 5 cm, Bases plásticas

**Paso 5:** paso 5: Desde arriba y mediante ocho tornillos Allen 7 x 50, una la tapa piecera C con los separador piecera H y los costados piecera G (verificando que los cantos melaminicos queden hacia adelante). A su vez unir el fondo piecera J a la tapa por medio de dos tornillos Allen dejando la distancia mas corta de las perforaciones de la cara hacia arriba. Desde abajo y mediante ocho tornillos Allen 7 x 50, una el piso piecera D con los separador piecera y los costados piecera (verificando que los cantos melaminicos queden hacia adelante). A su vez unir al fondo piecera. Finalmente coloque a presión los soporte de estantes uno fijo al frente y el trasero puede tener 2 posiciones abajo quedando el estante inclinado hacia abajo y al medio quedando el estante horizontal.
  - *Herrajes:* Tornillos Allen 5 cm, Soportes de estantes

**Paso 6:** paso 6: Coloque los estantes K sobre los soporte de estantes clocados en los costados piecera G y en los separadores pieceras H. Finalmente coloque a presión las 6 bases plásticas en las perforaciones libres de los pisos. Repetir los pasos 4-5 para la cabecera teniendo en cuenta que no lleva estantes ni soporte de estantes.
  - *Herrajes:* Bases plásticas

**Paso 7:** paso 7: Unir la cabecera con la piecera al refuerzo cama por medio de 4 tornillos Allen 7 x 50 a través de las perforaciones de los fondos de la cabecera y la piecera J, verificando que el canto melaminico quede hacia arriba. Unir las cajoneras a la piecera y a la cabecera por medio de 12 tornillos de 2,5 cm a través de las perforaciones de los costados cajonera O-P.
  - *Herrajes:* Tornillos Allen 5 cm, Tornillos de 2.5 cm

**Paso 8:** paso 8 armado de cajones: Coloque 2 tarugos 6x30 en el fondo de cajón V, 2 mas en cada uno de los costados de cajón U a su vez encastrar las cajas mini fix. Agregar adhesivo en cada perforación donde lleve tarugo.
  - *Herrajes:* Tarugos 6x30, Pernos mini fix con caja, Envase de cola

**Paso 9:** paso 9 armado de cajones: Atornille 2 minifix en el frente de cajón T.
  - *Herrajes:* Pernos mini fix con caja

**Paso 10:** paso 10 armado de cajones: Una vez armada la estructura tipo "U" entre UV-U, ingrese el frente de cajón T ajuste los pernos mini fix girando 180 grados las cajas mini fix.Habiendo agregado el adhesivo anteriormente. Luego ajuste el fondo y los costados mediante los dos tornillos 4x40.
  - *Herrajes:* Pernos mini fix con caja, Tornillos de 4 cm, Envase de cola

**Paso 11:** paso 11 armado de cajones: Desde abajo introduzca el piso de cajón sobre el canal del frente de cajón T, y clave este siguiendo una escuadra correcta del cajón sobre los filos inferiores de los costados y del fondo. Finalmente atornille las guías metálicas como muestra la figura mediante 4 tornillos 3,5x20.
  - *Herrajes:* Set de clavos, Pares de guías metálicas de 35 cm, Tornillos de 2 cm

**Paso 12:** paso 12: Finalmente coloque los cajones en las cajoneras como se explica en la guía de "colocación de cajones". Desde arriba por medio de 12 tornillos de 2,5 cm, unir la fajas parrilla F a las fajas refuerzo atrás de las cajoneras. Colocar las fajas a una distance aproximada de 4 cm.
  - *Herrajes:* Tornillos de 2.5 cm

**Paso 13:** paso 13. Colocar los cajones sobre las guías fijas que se encuentran ya en el mueble, como lo muestra la imagen.
  - *Herrajes:* Pares de guías metálicas de 35 cm
  - 💡 *Consejo Pro:* Colocación de cajones: Colocar los cajones sobre las guías fijas que se encuentran ya en el mueble, como lo muestra la imagen.

---

## 📦 Mesa LEIR (SKU: 557)
- **Línea:** COMEDORES
- **Dificultad:** Bajo | **Tiempo estimado:** 45 min
- **Herramientas necesarias:** Martillo de carpintero, Destornillador de punta en cruz, Llave Allen 4 mm
- **Visor 3D Interactivo:** https://www.mueblesgacela.com.ar/armado/557

### 🔩 Herrajes incluidos:
- Tornillos Allen de 7 x 50 (16 u.)
- Tarugos 6x30 (18 u.)
- Tornillos de 3.5x30 (8 u.)
- Tornillos de 4x40 (8 u.)

### 📐 Piezas y Despiece:
- Letra A: Tapa (1 u.) - Medidas: 120 x 80 cm
- Letra B: Base de patas (1 u.) - Medidas: S/M cm
- Letra C: Faja grande (2 u.) - Medidas: S/M cm
- Letra D: Faja chica (2 u.) - Medidas: S/M cm
- Refuerzos (4 u.) - Medidas: S/M cm
- Patas (4 u.) - Medidas: S/M cm

### 🪜 Paso a Paso de Armado:
**Paso 1:** Paso 1 Prepare las fajas largas C, y las fajas cortas D, colocando a presión en el filo superior 4 tarugos 6x30.
  - *Herrajes:* Tarugos 6x30

**Paso 2:** paso 2 ncastre las patas macizas, para luego ajustarlas desde arriba mediante los tornillos Allen 7x50 hacia la base de las patas B. Seguidamente encastre los tarugos de las fajas C-D en la base de patas.
  - *Herrajes:* Tornillos Allen de 7 x 50, Tarugos 6x30

**Paso 3:** Paso 3: Unir las fajas C-D a los refuerzos por medio de los tornillos Allen 7x50. Teniendo en cuenta que tienen un pequeño desfasaje entre las perforaciones de las primeras con las del refuerzo, introduzca primero los 2 tornillos por refuerzo y luego ajuste, este desfasaje es para un mejor aferre de pata.
  - *Herrajes:* Tornillos Allen de 7 x 50
  - 💡 *Consejo Pro:* Teniendo en cuenta que tienen un pequeño desfasaje entre las perforaciones de las primeras con las del refuerzo, introduzca primero los 2 tornillos por refuerzo y luego ajuste, este desfasaje es para un mejor aferre de pata.

**Paso 4:** Paso 4: Ajustar las fajas C-D a la base de patas B por medio de 8 tornillos 4x40. Luego introducir 2 tarugos guías en la base de patas en las perforaciones que muestra la figura.
  - *Herrajes:* Tornillos de 4x40, Tarugos 6x30

**Paso 5:** Paso 5: Luego una la base de patas B con la tapa A, a través de 8 tornillos Philips de 3,5x30 y utilizando como guía los dos tarugos 6 x 30.
  - *Herrajes:* Tornillos de 3.5x30, Tarugos 6x30

---

## 📦 Mesa ODENSE (SKU: 557-1)
- **Línea:** COMEDORES
- **Dificultad:** Bajo | **Tiempo estimado:** 45 min
- **Herramientas necesarias:** Martillo de carpintero, Destornillador de punta en cruz, Llave Allen 4 mm
- **Visor 3D Interactivo:** https://www.mueblesgacela.com.ar/armado/557-1

### 🔩 Herrajes incluidos:
- Tornillos Allen de 7 x 50 (16 u.)
- Tarugos 6x30 (18 u.)
- Tornillos de 3.5x30 (8 u.)
- Tornillos de 4x35 (8 u.)

### 📐 Piezas y Despiece:
- Letra A: Tapa (1 u.) - Medidas: 120 cm
- Letra B: Base de patas (1 u.) - Medidas: S/M cm
- Letra C: Faja (4 u.) - Medidas: S/M cm
- Refuerzos (4 u.) - Medidas: S/M cm
- Patas (4 u.) - Medidas: S/M cm

### 🪜 Paso a Paso de Armado:
**Paso 1:** Paso 1: Prepare las fajas C, colocando a presión en el filo superior 4 tarugos 6x30.
  - *Herrajes:* Tarugos 6x30

**Paso 2:** Paso 2: Encastre las patas macizas, para luego ajustarlas desde arriba mediante los tornillos Allen 7x50 hacia la base de las patas B. Seguidamente encastre los tarugos de las fajas C en la base de patas.
  - *Herrajes:* Tornillos Allen de 7 x 50, Tarugos 6x30

**Paso 3:** Paso 3: Unir las fajas C a los refuerzos por medio de los tornillos Allen 7x50. Teniendo en cuenta que tienen un pequeño desfasaje entre las perforaciones de las primeras con las del refuerzo, introduzca primero los 2 tornillos por refuerzo y luego ajuste, este desfasaje es para un mejor aferre de pata.
  - *Herrajes:* Tornillos Allen de 7 x 50
  - 💡 *Consejo Pro:* Teniendo en cuenta que tienen un pequeño desfasaje entre las perforaciones de las primeras con las del refuerzo, introduzca primero los 2 tornillos por refuerzo y luego ajuste, este desfasaje es para un mejor aferre de pata.

**Paso 4:** Paso 4: Ajustar las fajas C a la base de patas B por medio de 8 tornillos 4x35. Luego introducir 2 tarugos guías en la base de patas en las perforaciones que muestra la figura.
  - *Herrajes:* Tornillos de 4x35, Tarugos 6x30

**Paso 5:** Paso 5: Luego una la base de patas B con la tapa A, a través de 8 tornillos Philips de 3,5x30 y utilizando como guía los dos tarugos 6 x 30.
  - *Herrajes:* Tornillos de 3.5x30, Tarugos 6x30

---

## 📦 Mesa TAMPERE (SKU: 557-2)
- **Línea:** COMEDORES
- **Dificultad:** Alto | **Tiempo estimado:** 45 min
- **Herramientas necesarias:** Martillo de carpintero, Destornillador de punta en cruz, Llave Allen 4 mm
- **Visor 3D Interactivo:** https://www.mueblesgacela.com.ar/armado/557-2

### 🔩 Herrajes incluidos:
- Tornillos Allen de 7 x 50 (16 u.)
- Tarugos 6x30 (36 u.)
- Tornillos de 3.5x30 (10 u.)
- Tornillos de 4x40 (19 u.)

### 📐 Piezas y Despiece:
- Letra A: Tapa (1 u.) - Medidas: 160 x 80 cm
- Letra B: Base de patas (1 u.) - Medidas: S/M cm
- Letra C: Faja grande (2 u.) - Medidas: S/M cm
- Letra D: Faja chica (2 u.) - Medidas: S/M cm
- Letra -: Refuerzo largo (3 u.) - Medidas: S/M cm
- Letra -: Refuerzos (4 u.) - Medidas: S/M cm
- Letra -: Patas (4 u.) - Medidas: S/M cm

### 🪜 Paso a Paso de Armado:
**Paso 1:** Paso 1: Prepare las fajas largas C, y las fajas cortas D, colocando a presión en el filo superior 4 tarugos 6x30 en las primeras y 4 mas en las segundas. En los 3 refuerzos largos coloque a presión 6 tarugos 6x30.
  - *Herrajes:* Tarugos 6x30

**Paso 2:** Paso 2: Encastre las patas macizas, para luego ajustarlas desde arriba mediante los tornillos Allen 7x70 hacia la base de las patas B. Seguidamente encastre los tarugos de los refuerzos en las fajas cortas C y luego los tarugos de las fajas C-D y del refuerzo largo en la base de patas.
  - *Herrajes:* Tornillos Allen, Tarugos 6x30

**Paso 3:** Paso 3: Unir las fajas C-D a los refuerzos por medio de los tornillos Allen 7x50. Teniendo en cuenta que tienen un pequeño desfasaje entre las perforaciones de las primeras con las del refuerzo, introduzca primero los 2 tornillos por refuerzo y luego ajuste, este desfasaje es para un mejor aferre de pata.
  - *Herrajes:* Tornillos Allen de 7 x 50
  - 💡 *Consejo Pro:* Teniendo en cuenta que tienen un pequeño desfasaje entre las perforaciones de las primeras con las del refuerzo, introduzca primero los 2 tornillos por refuerzo y luego ajuste, este desfasaje es para un mejor aferre de pata.

**Paso 4:** paso 4: Ajustar las fajas C-D y los refuerzos largos a la base de patas B por medio de 19 tornillos 4x40. Luego introducir 2 tarugos guías en la base de patas en las perforaciones que muestra la figura.
  - *Herrajes:* Tornillos de 4x40, Tarugos 6x30

**Paso 5:** Paso 5: Luego una la base de patas B con la tapa A, a través de 10 tornillos Philips de 3,5x30 y utilizando como guía los dos tarugos 6 x 30.
  - *Herrajes:* Tornillos de 3.5x30, Tarugos 6x30

---

## 📦 Mesa UPPSALA EXTENSIBLE (SKU: 427091)
- **Línea:** COMEDORES
- **Dificultad:** Bajo | **Tiempo estimado:** 45 min
- **Herramientas necesarias:** Martillo de carpintero, Destornillador de punta en cruz, Llave Allen
- **Visor 3D Interactivo:** https://www.mueblesgacela.com.ar/armado/427091

### 🔩 Herrajes incluidos:
- Tornillos Allen de 5 cm (16 u.)
- Tarugos 6x30 (16 u.)
- Tornillos de 4x40 (8 u.)

### 📐 Piezas y Despiece:
- Letra A: Tapa (2 u.) - Medidas: 80 x 59,5 cm
- Letra B: Base de patas (1 u.) - Medidas: 110 x 69,5 cm
- Letra C: Faja larga (2 u.) - Medidas: 93,3 x 8 cm
- Letra D: Faja corta (2 u.) - Medidas: 53,3 x 8 cm
- Letra E: Accesorio (1 u.) - Medidas: 80 x 40 cm
- Letra -: Refuerzos (4 u.) - Medidas: 11 x 11 cm
- Letra -: Patas (4 u.) - Medidas: 73 x 10 cm

### 🪜 Paso a Paso de Armado:
**Paso 1:** Paso 1: Prepare las fajas largas C, y las fajas cortas D, colocando a presión en el filo superior 4 tarugos de 3 cm.
  - *Herrajes:* Tarugos 6x30

**Paso 2:** Paso 2: Encastre las patas macizas, para luego ajustarlas desde arriba mediante los tornillos Allen de 5 cm hacia la base de las patas B. Seguidamente encastre los tarugos de las fajas C-D en la base de patas.
  - *Herrajes:* Tornillos Allen de 5 cm, Tarugos 6x30
  - 💡 *Consejo Pro:* IMPORTANTE: Para poder armar la mesa debe separar las tapas de la base de patas deslizando las partes por las guías que ya vienen ensambladas.

**Paso 3:** Paso 3: Unir las fajas C-D a los refuerzos por medio de los tornillos Allen de 5 cm. Teniendo en cuenta que tienen un pequeño desfasaje entre las perforaciones de las primeras con las del refuerzo, introduzca primero los 2 tornillos por refuerzo y luego ajuste, este desfasaje es para un mejor aferre de pata. Luego ajustar las fajas a la base de patas B por medio de 8 tornillos de 4 cm.
  - *Herrajes:* Tornillos Allen de 5 cm, Tornillos de 4x40
  - 💡 *Consejo Pro:* Teniendo en cuenta que tienen un pequeño desfasaje entre las perforaciones de las primeras con las del refuerzo, introduzca primero los 2 tornillos por refuerzo y luego ajuste, este desfasaje es para un mejor aferre de pata.

**Paso 4:** Paso 4: Finalmente conecte las tapas A a la base de patas B deslizando las guias de las primeras sobre las guias de la segunda. Si se usa el accesorio E hacer coincidir los tarugos de este sobre las perforaciones de las tapas, en caso de no usarse dejar en un espacio donde no se golpee.
  - *Herrajes:* Tarugos 6x30

---

## 📦 Mesa SKIEN (SKU: 429090)
- **Línea:** COMEDORES
- **Dificultad:** Bajo | **Tiempo estimado:** 15 min
- **Herramientas necesarias:** Martillo de carpintero, Destornillador de punta en cruz, LLave allen 4 mm, Usar regla para verificar tamaño de tornillos
- **Visor 3D Interactivo:** https://www.mueblesgacela.com.ar/armado/429090

### 🔩 Herrajes incluidos:
- Tornillos Allen 5 cm (8 u.)
- Tornillos de 3 cm (8 u.)
- Tarugos 6 x 30 (1 u.)

### 📐 Piezas y Despiece:
- Letra -: Tapa chica (1 u.) - Medidas: Ø 90 cm
- Letra B: Base de patas (1 u.) - Medidas: 55 x 55 cm
- Letra -: Patas largas (4 u.) - Medidas: 73 x 10 cm

### 🪜 Paso a Paso de Armado:
**Paso 1:** Paso 1: Coloque un tarugo guía de 6x30 en la base de patas B, en la perforación que muestra la imagen. Luego encastre las espigas de las patas en los canales de las bases aplicando fuerza y desde arriba atornille con los tornillos Allen de 5 cm.
  - *Herrajes:* Tarugos 6 x 30, Tornillos Allen 5 cm

**Paso 2:** Paso 2: Usando como guía el tarugo de 6x30, presente la base de patas B con la tapa y ajuste con los tornillos de 3 cm. El tarugo solo sirve de guía y sobresale hacia abajo (no golpear).
  - *Herrajes:* Tarugos 6 x 30, Tornillos de 3 cm
  - 💡 *Consejo Pro:* El tarugo solo sirve de guía y sobresale hacia abajo (no golpear).

---

## 📦 Mesa SKARA EXTENSIBLE (SKU: 429091)
- **Línea:** COMEDORES
- **Dificultad:** Medio | **Tiempo estimado:** 15 min
- **Herramientas necesarias:** Martillo de carpintero, Destornillador de punta en cruz, LLave allen 4 mm, Usar regla para verificar tamaño de tornillos
- **Visor 3D Interactivo:** https://www.mueblesgacela.com.ar/armado/429091

### 🔩 Herrajes incluidos:
- Tornillos Allen 5 cm (16 u.)
- Tarugos 3 cm (16 u.)
- Tornillos de 4 cm (8 u.)

### 📐 Piezas y Despiece:
- Letra A: Tapa (2 u.) - Medidas: Ø119 x 59,5 cm
- Letra B: Base de patas (1 u.) - Medidas: 100 x 80 cm
- Letra C: Fajas (4 u.) - Medidas: 63,3 x 8 cm
- Letra E: Accesorio (1 u.) - Medidas: 119 x 40 cm
- Letra -: Refuerzos (4 u.) - Medidas: 11 x 11 cm
- Letra -: Patas (4 u.) - Medidas: 73 x 10 cm

### 🪜 Paso a Paso de Armado:
**Paso 1:** Paso 1: Prepare las fajas C colocando a presión en el filo superior 4 tarugos de 3 cm.
  - *Herrajes:* Tarugos 3 cm

**Paso 2:** Paso 2: Encastre las patas macizas, para luego ajustarlas desde arriba mediante los tornillos Allen de 5 cm hacia la base de las patas B. Seguidamente encastre los tarugos de las fajas C en la base de patas.
  - *Herrajes:* Tornillos Allen 5 cm, Tarugos 3 cm

**Paso 3:** Paso 3: Unir las fajas C a los refuerzos por medio de los tornillos Allen de 5 cm. Teniendo en cuenta que tienen un pequeño desfasaje entre las perforaciones de las primeras con las del refuerzo, introduzca primero los 2 tornillos por refuerzo y luego ajuste, este desfasaje es para un mejor aferre de pata. Luego ajustar las fajas a la base de patas B por medio de 8 tornillos de 4 cm.
  - *Herrajes:* Tornillos Allen 5 cm, Tornillos de 4 cm
  - 💡 *Consejo Pro:* Teniendo en cuenta que tienen un pequeño desfasaje entre las perforaciones de las primeras con las del refuerzo, introduzca primero los 2 tornillos por refuerzo y luego ajuste, este desfasaje es para un mejor aferre de pata.

**Paso 4:** Paso 4: Finalmente conecte las tapas A a la base de patas B deslizando las guias de las primeras sobre las guias de la segunda. Si se usa el accesorio E hacer coincidir los tarugos de este sobre las perforaciones de las tapas, en caso de no usarse dejar en un espacio donde no se golpee.
  - *Herrajes:* Tarugos 3 cm

---

## 📦 Mesa centro LOA con cajón y estante (SKU: 336270)
- **Línea:** CURVALBA
- **Dificultad:** Bajo | **Tiempo estimado:** 45 min
- **Herramientas necesarias:** Martillo de carpintero, Destornillador de punta en cruz
- **Visor 3D Interactivo:** https://www.mueblesgacela.com.ar/armado/336270

### 🔩 Herrajes incluidos:
- Envase de cola (1 u.)
- Escuadras plásticas (1 u.)
- Tornillos varianta (4 u.)
- Par de guías metálicas de 35 cm (1 u.)
- Bases plásticas (4 u.)
- Pernos mini fix con caja (14 u.)
- Tornillos de 4 cm (3 u.)
- Tornillos de 1,5 cm (2 u.)
- Tarugos 6x30 (17 u.)
- Tornillos de 2 cm (4 u.)
- Set de Clavos (1 u.)

### 📐 Piezas y Despiece:
- Letra A: Tapa (1 u.) - Medidas: 90 x 44,5 cm
- Letra B: Piso (1 u.) - Medidas: 87 x 41,5 cm
- Letra C: Costado izquierdo (1 u.) - Medidas: 38,5 x 41,5 cm
- Letra D: Costado derecho (1 u.) - Medidas: 38,5 x 41,5 cm
- Letra G: Frente cajón (1 u.) - Medidas: 89,8 x 19,5 cm
- Letra E: Fondo (1 u.) - Medidas: 87 x 20 cm
- Letra J: Costado cajón (2 u.) - Medidas: 35 x 8 cm
- Letra K: Fondo cajón (1 u.) - Medidas: 81,4 x 8 cm
- Letra -: Piso cajón (1 u.) - Medidas: 84,2 x 32,8 cm
- Letra -: Faja frente (1 u.) - Medidas: 87 x 6 cm
- Letra -: Refuerzo cajón (1 u.) - Medidas: 32,4 x 6 cm
- Letra -: Zócalo (1 u.) - Medidas: 87 x 6 cm

### 🪜 Paso a Paso de Armado:
**Paso 1:** Paso 1: Prepare el costado derecho D, colocando a presión 2 caja mini fix, colocando la guía metálica fija derecha mediante los tornillos varianta, también atornille 3 pernos mini fix en las perforaciones que muestra la figura y clave dos bases plásticas. Realice el mismo procedimiento en el costado izquierdo C, teniendo en cuenta que es simétrico.
  - *Herrajes:* Caja mini fix, Par de guías metálicas de 35 cm, Tornillos varianta, Pernos mini fix con caja, Bases plásticas

**Paso 2:** paso 2: En el fondo coloque a presión 3 cajas mini fix en las perforaciones de la cara y 2 tarugos guías de 6x30 en el canto laterales como lo muestra la figura.
  - *Herrajes:* Pernos mini fix con caja, Tarugos 6x30

**Paso 3:** paso 3: Prepare el zócalo, colocando a presión 5 tarugos guías de 6x30 y atornillando la escuadra plásticas con un tornillo de 1,5 cm (la escuadra deben quedar en línea con el tarugo superior). En la faja frente coloque 4 tarugos guías de 6x30, ocupando todas las perforaciones. En la tapa A atornille 5 pernos mini fix.
  - *Herrajes:* Tarugos 6x30, Escuadras plásticas, Tornillos de 1,5 cm, Pernos mini fix con caja

**Paso 4:** paso 4: Una el fondo E y el piso B a los costados C - D, introduciendo los pernos minifix de estos en las perforaciones de las cajas minifix de los primeros, luego ajuste las piezas girando 180 grados en sentido horario las cajas mini fix. Previamente haciendo coincidir los tarugos de la faja frente y el zócalo con las perforaciones de los costados. Además el tarugo superior del zócalo debe coincidir con la perforación inferior del piso.
  - *Herrajes:* Pernos mini fix con caja, Tarugos 6x30

**Paso 5:** Paso 5 Armado de cajon: Coloque 2 tarugos 6x30 en el fondo de cajón K, 2 mas en cada uno de los costados de cajón J a su vez encastrar las cajas mini fix. Agregar adhesivo en cada perforación donde lleve tarugo.
  - *Herrajes:* Tarugos 6x30, Pernos mini fix con caja, Envase de cola

**Paso 6:** Paso 6 Armado de cajón: En el frente de cajón G atornillar 3 pernos mini fix.
  - *Herrajes:* Pernos mini fix con caja

**Paso 7:** Paso 7 Armado de cajón: Una vez armada la estructura tipo "U" entre J-K-J, ingrese el frente de cajón I ajuste los pernos mini fax girando 180 grados las cajas mini fix. Habiendo agregado el adhesivo anteriormente. Luego ajuste el fondo y los costados mediante los dos tornillos 4 cm.
  - *Herrajes:* Pernos mini fix con caja, Envase de cola, Tornillos de 4 cm

**Paso 8:** Paso 8 Armado de cajón: Desde abajo introduzca el piso de cajón sobre el canal del frente de cajón G, y clave este siguiendo una escuadra correcta del cajón sobre los filos inferiores de los costados y del fondo. Atornille las guías metálicas como muestra la figura mediante 4 tornillos 2 cm.
  - *Herrajes:* Set de Clavos, Par de guías metálicas de 35 cm, Tornillos de 2 cm

**Paso 9:** paso 9: Haga coincidir la perforación lateral del refuerzo de cajón con el perno mini fix colocado en el frente de cajón G, ajuste las piezas girando la caja mini fix media vuelta en sentido horario. Finalmente ajuste el refuerzo al fondo de cajón K mediante 1 tornillo de 4 cm.
  - *Herrajes:* Pernos mini fix con caja, Tornillos de 4 cm

**Paso 10:** Paso 10: Una la tapa A a los costados C - D, introduciendo los pernos minifix de la tapa en las perforaciones de las cajas minifix de estos, luego ajuste las piezas girando 180 grados en sentido horario las cajas mini fix. Desde abajo ajuste el zócalo por medio de un tornillo de 1,5 cm al piso B y a través de la escuadra plástica. Finalmente coloque el cajón ya armado sobre las guías fijas ya colocadas en los costados.
  - *Herrajes:* Pernos mini fix con caja, Tornillos de 1,5 cm, Escuadras plásticas, Par de guías metálicas de 35 cm

**Paso 11:** Paso 11: Colocar los cajones sobre las guías fijas que se encuentran ya en el mueble, como lo muestra la imagen.
  - *Herrajes:* Par de guías metálicas de 35 cm
  - 💡 *Consejo Pro:* Colocar los cajones sobre las guías fijas que se encuentran ya en el mueble, como lo muestra la imagen.

---

## 📦 Escritorio ATUEL cajón y estantes (SKU: 334271)
- **Línea:** CURVALBA
- **Dificultad:** Bajo | **Tiempo estimado:** 45 min
- **Herramientas necesarias:** Martillo de carpintero, Destornillador de punta en cruz, Llave Allen
- **Visor 3D Interactivo:** https://www.mueblesgacela.com.ar/armado/334271

### 🔩 Herrajes incluidos:
- Envase de cola (1 u.)
- Tornillos Allen 5 cm (14 u.)
- Pernos mini fix con caja (12 u.)
- Par de guías metálicas de 35 cm (1 u.)
- Tarugos 6x30 (22 u.)
- Set de Clavos (1 u.)
- Llave Allen (1 u.)
- Tornillos varianta (4 u.)
- Tornillos de 2 cm (4 u.)
- Tornillos de 2.5 cm (8 u.)
- Tornillos de 4 cm (2 u.)

### 📐 Piezas y Despiece:
- Letra A: Tapa (1 u.) - Medidas: 100 x 44,5 cm
- Letra B: Piso (1 u.) - Medidas: 100 x 44,5 cm
- Letra C: Costado izquierdo (1 u.) - Medidas: 44,5 x 10,6 cm
- Letra D: Costado derecho (1 u.) - Medidas: 44,5 x 10,6 cm
- Letra F: Separador (1 u.) - Medidas: 40,5 x 10,6 cm
- Letra L: Refuerzo patas (2 u.) - Medidas: 29,8 x 10 cm
- Letra J: Fondo de cajón (1 u.) - Medidas: 28 x 6 cm
- Letra I: Frente cajón (1 u.) - Medidas: 37,2 x 10 cm
- Letra K: Base patas (2 u.) - Medidas: 39 x 18 cm
- Letra -: Piso de cajón (1 u.) - Medidas: 33 x 31 cm
- Letra -: Patas macizas der. (2 u.) - Medidas: 63 x 7,5 cm
- Letra -: Patas macizas izq. (2 u.) - Medidas: 63 x 7,5 cm

### 🪜 Paso a Paso de Armado:
**Paso 1:** Paso 1: Prepare el costado derecho D y el separador F, colocando a presión 2 caja mini fix y atornille mediante 2 tornillos varianta 1 guía metálica fija derecha para el costado e izquierda para el separador. En el costado izquierdo C, coloque solo las cajas mini fix.
  - *Herrajes:* Pernos mini fix con caja, Tornillos varianta, Par de guías metálicas de 35 cm

**Paso 2:** Paso 2: En los fondos M, coloque a presión 4 tarugos 6x30 en los cantos cortos Y 2 en los cantos largos. En la tapa A atornille 6 mini fix.
  - *Herrajes:* Tarugos 6x30, Pernos mini fix con caja

**Paso 3:** Paso 3: Arme la estructura tipo "U" entre los costados C-D y el fondo M, haciendo coincidir los tarugos de este con las perforaciones de los primeros, seguidamente haga coincidir las cajas para mini fix de los costados y del separador F con los pernos mini fix de la tapa A y utilizando el tarugo del fondo como guía, luego gire media vuelta en sentido horario las cajas, para ajustar dichas piezas. Luego ajuste el piso B por medio de 6 tornillos Allen de 5 cm, 4 a los costados C-D y 2 al separador F, usando el tarugo del fondo como guía.
  - *Herrajes:* Pernos mini fix con caja, Tarugos 6x30, Tornillos Allen 5 cm

**Paso 4:** Paso 4: Prepare los Refuerzos de patas L, colocando a presión 4 tarugos guías 6x30 y dos cajas minifix, como así también las patas atornillando un minifix por cada una.
  - *Herrajes:* Tarugos 6x30, Pernos mini fix con caja

**Paso 5:** Paso 5: Encastre las patas macizas, para luego ajustarlas desde arriba mediante los tornillos Allen de 5 cm hacia la base de las patas K. A su vez coloque a presión dos tarugos guías 6x30. Repetir el proceso para el otro juego de patas y base de patas. Una las tres piezas introduciendo los pernos minifix de las patas en las perforaciones con caja minifix de los refuerzos de patas utilizando los tarugos como guía, luego ajuste las piezas girando 180 grados en sentido horario las cajas mini fix.
  - *Herrajes:* Tornillos Allen 5 cm, Tarugos 6x30, Pernos mini fix con caja

**Paso 6:** paso 6: Una vez armado las bases de patas K con las patas macizas, ajuste estas hacia el piso B, a través de los 8 tornillos de 2,5 cm y utilizando como guía los tarugos colocados en la base de patas, los cuales solo sirven de guía (not golpear).
  - *Herrajes:* Tornillos de 2.5 cm, Tarugos 6x30

**Paso 7:** Paso 7 armado de cajón: Coloque 2 tarugos 6x30 en el fondo de cajón J, 2 mas en cada uno de los costados de cajón G a su vez encastrar las cajas mini fix. Agregar adhesivo en cada perforación donde lleve tarugo.
  - *Herrajes:* Tarugos 6x30, Pernos mini fix con caja, Envase de cola

**Paso 8:** paso 8 armado de cajón: Una vez armada la estructura tipo "U" entre G-J-G, ingrese el frente de cajón derecho I ajuste los pernos mini fix girando 180 grados las cajas mini fix.Habiendo agregado el adhesivo anteriormente. Luego ajuste el fondo y los costados mediante los dos tornillos de 4 cm.
  - *Herrajes:* Pernos mini fix con caja, Envase de cola, Tornillos de 4 cm

**Paso 9:** Paso 9 Armado de cajon: Atornille 2 minifix en el frente de cajón I.
  - *Herrajes:* Pernos mini fix con caja

**Paso 10:** Paso 10 Armado de cajón: Desde abajo introduzca el piso de cajón sobre el canal del frente de cajón I, y clave este siguiendo una escuadra correcta del cajón sobre los filos inferiores de los costados y del fondo. Finalmente atornille las guías metálicas como muestra la figura mediante 4 tornillos de 2 cm.
  - *Herrajes:* Set de Clavos, Par de guías metálicas de 35 cm, Tornillos de 2 cm

**Paso 11:** Paso 11: Finalmente ingrese el cajon como indica la "Colocación de cajones" haciendo coincidir las guías que se encuentran en el costado y el separador con las de los cajones, como muestra la figura.
  - *Herrajes:* Par de guías metálicas de 35 cm

**Paso 12:** Paso 12: Colocación de cajones

---

## 📦 Escritorio HUDSON con 2 cajones y estantes (SKU: 334272)
- **Línea:** CURVALBA
- **Dificultad:** Medio | **Tiempo estimado:** 75 min
- **Herramientas necesarias:** Martillo de carpintero, Destornillador de punta en cruz, Llave Allen, Usar regla para verificar tamaño de tornillos
- **Visor 3D Interactivo:** https://www.mueblesgacela.com.ar/armado/334272

### 🔩 Herrajes incluidos:
- Envase de cola (1 u.)
- Tornillos Allen 5 cm (16 u.)
- Pernos mini fix con caja (16 u.)
- Pares de guías metálicas de 35 cm (2 u.)
- Tarugos 6x30 (26 u.)
- Set de Clavos (1 u.)
- Llave Allen (1 u.)
- Tornillos varianta (8 u.)
- Tornillos de 2 cm (8 u.)
- Tornillos de 2.5 cm (8 u.)
- Tornillos de 4 cm (4 u.)

### 📐 Piezas y Despiece:
- Letra A: Tapa (1 u.) - Medidas: 120 x 44,5 cm
- Letra C: Costado izquierdo (1 u.) - Medidas: 44,5 x 10,6 cm
- Letra D: Costado derecho (1 u.) - Medidas: 44,5 x 10,6 cm
- Letra E: Separador izquierdo (1 u.) - Medidas: 40,5 x 10,6 cm
- Letra F: Separador izquierdo (1 u.) - Medidas: 40,5 x 10,6 cm
- Letra H: Frente cajón izq. (1 u.) - Medidas: 37,2 x 10 cm
- Letra G: Costado de cajón (4 u.) - Medidas: 35 x 6 cm
- Letra J: Fondo de cajón (2 u.) - Medidas: 28 x 6 cm
- Letra L: Refuerzo patas (2 u.) - Medidas: 29,8 x 10 cm
- Letra M: Fondos (1 u.) - Medidas: 116,8 x 10,6 cm
- Letra H: Frente cajón der. (1 u.) - Medidas: 37,2 x 10 cm
- Letra B: Piso (1 u.) - Medidas: 120 x 44,5 cm
- Letra K: Base patas (2 u.) - Medidas: 39 x 18 cm
- Letra -: Piso de cajón (2 u.) - Medidas: 33 x 31 cm
- Letra -: Patas macizas der. (2 u.) - Medidas: 63 x 7,5 cm
- Letra -: Patas macizas izq. (2 u.) - Medidas: 63 x 7,5 cm

### 🪜 Paso a Paso de Armado:
**Paso 1:** Paso 1: Prepare el costado derecho D y el separador izquierdo E, colocando a presión 2 caja mini fix y atornille mediante 2 tornillos varianta 1 guía metálica fija derecha[cite: 12]. Realice las mismas operaciones tanto como para el costado izquierdo C, como para el separador derecho F[cite: 12]. Teniendo en cuenta que estos son espejos respecto a los primeros y llevan guía fija izquierda[cite: 12].
  - *Herrajes:* Pernos mini fix con caja, Tornillos varianta, Pares de guías metálicas de 35 cm

**Paso 2:** paso 2: En los fondos M, coloque a presión 4 tarugos 6x30 en los cantos cortos Y 2 en los cantos largos[cite: 12]. En la tapa A atornille 8 mini fix[cite: 12].
  - *Herrajes:* Tarugos 6x30, Pernos mini fix con caja

**Paso 3:** Paso 3: Arme la estructura tipo "U" entre los costados C-D and el fondo M, haciendo coincidir los tarugos de este con las perforaciones de los primeros, seguidamente haga coincidir las cajas para mini fix de los costados y los separadores E-F con los pernos mini fix de la tapa A y utilizando el tarugo del fondo como guía, luego gire media vuelta en sentido horario las cajas, para ajustar dichas piezas[cite: 12]. Luego ajuste el piso B por medio de 8 tornillos Allen de 5 cm, 4 a los costados C-D y 4 a los separadores E-F, usando el tarugo del fondo como guía[cite: 12].
  - *Herrajes:* Tarugos 6x30, Pernos mini fix con caja, Tornillos Allen 5 cm

**Paso 4:** Paso 4: Prepare los Refuerzos de patas L, colocando a presión 4 tarugos guías 6x30 y dos cajas minifix, como así también las patas atornillando un minifix por cada una[cite: 12].
  - *Herrajes:* Tarugos 6x30, Pernos mini fix con caja

**Paso 5:** Paso 5: Encastre las patas macizas, para luego ajustarlas desde arriba mediante los tornillos Allen de 5 cm hacia la base de las patas K[cite: 12]. A su vez coloque a presión dos tarugos guías 6x30[cite: 12]. Repetir el proceso para el otro juego de patas y base de patas[cite: 12]. Una las tres piezas introduciendo los pernos minifix de las patas en las perforaciones con caja minifix de los refuerzos de patas utilizando los tarugos como guía, luego ajuste las piezas girando 180 grados en sentido horario las cajas mini fix[cite: 12].
  - *Herrajes:* Tornillos Allen 5 cm, Tarugos 6x30, Pernos mini fix con caja

**Paso 6:** Paso 6: Una vez armado las bases de patas K con las patas macizas, ajuste estas hacia el piso B, a través de los 8 tornillos de 2,5 cm y utilizando como guía los tarugos colocados en la base de patas, los cuales solo sirven de guía (no golpear)[cite: 12].
  - *Herrajes:* Tornillos de 2.5 cm, Tarugos 6x30

**Paso 7:** Paso 7 armado de cajón: Coloque 2 tarugos 6x30 en el fondo de cajón J, 2 mas en cada uno de los costados de cajón G a su vez encastrar las cajas mini fix[cite: 12]. Agregar adhesivo en cada perforación donde lleve tarugo[cite: 12].
  - *Herrajes:* Tarugos 6x30, Pernos mini fix con caja, Envase de cola

**Paso 8:** Paso 8 armado de cajón: Una vez armada la estructura tipo "U" entre G-J-G, ingrese el frente de cajón derecho I ajuste los pernos mini fix girando 180 grados las cajas mini fix[cite: 12]. Habiendo agregado el adhesivo anteriormente[cite: 12]. Luego ajuste el fondo y los costados mediante los dos tornillos de 4 cm[cite: 12].
  - *Herrajes:* Pernos mini fix con caja, Envase de cola, Tornillos de 4 cm

**Paso 9:** paso 9 armado de cajón: Atornille 2 minifix en el frente de cajón derecho I[cite: 12].
  - *Herrajes:* Pernos mini fix con caja

**Paso 10:** Paso 10 armado de cajón: Desde abajo introduzca el piso de cajón sobre el canal del frente de cajón derecho I, y clave este siguiendo una escuadra correcta del cajón sobre los filos inferiores de los costados y del fondo[cite: 12]. Finalmente atornille las guías metálicas como muestra la figura mediante 4 tornillos de 2 cm[cite: 12]. Repetir el proceso para el frente de cajón izquierdo H[cite: 12].
  - *Herrajes:* Set de Clavos, Pares de guías metálicas de 35 cm, Tornillos de 2 cm

**Paso 11:** paso 11: Finalmente ingrese los cajones como indica la "Colocación de cajones" haciendo coincidir las guías que se encuentran en el costados y los separadores con las de los cajones, como muestra la figura[cite: 12].
  - *Herrajes:* Pares de guías metálicas de 35 cm

**Paso 12:** Paso 12: Colocación de cajones[cite: 12]

---

## 📦 Biblioteca ARNO con puerta y estantes (SKU: 353270)
- **Línea:** CURVALBA
- **Dificultad:** Medio | **Tiempo estimado:** 45 min
- **Herramientas necesarias:** Martillo de carpintero, Destornillador de punta en cruz, Llave Allen 4 mm, Usar regla para verificar tamaño de tornillos
- **Visor 3D Interactivo:** https://www.mueblesgacela.com.ar/armado/353270

### 🔩 Herrajes incluidos:
- Bisagras codo 0 cazoleta 26 (2 u.)
- Tornillos Allen de 5 cm (8 u.)
- Pernos mini fix con caja (4 u.)
- Bases plásticas (4 u.)
- Soportes de estantes (4 u.)
- Tarugos 6x30 (8 u.)
- Set de Clavos (1 u.)
- Tornillos de 1.5 cm (8 u.)

### 📐 Piezas y Despiece:
- Letra A: Tapa (1 u.) - Medidas: 39 x 31 cm
- Letra B: Piso y estante (2 u.) - Medidas: 36 x 29,5 cm
- Letra C: Costado izquierdo (1 u.) - Medidas: 118,5 x 29,5 cm
- Letra D: Costado derecho (1 u.) - Medidas: 118,5 x 29,5 cm
- Letra F: Estante móvil (1 u.) - Medidas: 36 x 29,5 cm
- Letra -: Faja y zócalo (1 u.) - Medidas: 36 x 6 cm
- Letra G: Puerta (1 u.) - Medidas: 43 x 38,8 cm
- Letra -: Fondo mueble (1 u.) - Medidas: 47 x 38,5 cm

### 🪜 Paso a Paso de Armado:
**Paso 1:** Paso 1: Prepare el costado izquierdo C, colocando 2 bases de bisagra mediante los tornillos de 1,5 cm, a presión coloque 2 soporte de estantes y 2 caja mini fix. Realice el mismo procedimiento para el costado derecho D, pero sin las bases de bisagras[cite: 11].
  - *Herrajes:* Tornillos de 1.5 cm, Soportes de estantes, Pernos mini fix con caja

**Paso 2:** Paso 2: En las faja - zócalo coloque a presión 4 tarugos 6x30 en los filos[cite: 11].
  - *Herrajes:* Tarugos 6x30

**Paso 3:** Paso 3: En la puerta G coloque 2 bisagra mediante los tornillos de 1.5cm. En la tapa A atornille 4 pernos mini fix[cite: 11].
  - *Herrajes:* Bisagras codo 0 cazoleta 26, Tornillos de 1.5 cm, Pernos mini fix con caja

**Paso 4:** Paso 4: Una los costados C - D a los estantes y piso B mediante 4 tornillos Allen de 5 cm previamente haciendo coincidir los tarugos de la faja y zócalo con las perforaciones de los costados. Desde arriba encastre los pernos mini fix que se encuentran en la tapa A con las perforaciones superiores de los costados, tenga en cuenta que la marca guía quede hacia atrás y luego para ajustar las piezas gire las caja mini fix media vuelta en sentido horario. Desde abajo clave las bases plásticas en los filos inferiores de los costados[cite: 11].
  - *Herrajes:* Tornillos Allen de 5 cm, Tarugos 6x30, Pernos mini fix con caja, Bases plásticas

**Paso 5:** Paso 5: Clave el fondo de mueble de 3 mm, tal como lo indica el grafico, siguiendo el orden correcto y la escuadras justa del mueble. Posteriormente distribuya los clavos a una distancia aproximada de 15 cm entre ellos, proporcionándole la rigidez necesaria al mueble. 1 vértice B piso - C, 2 vértice B piso - D, 3 vértice B estante - D, 4 vértice B estante - C. Coloque la puerta G en las bases de bisagras colocadas en el costado izquierdo C, Utilizando como guía las indicaciones de 'Colocación de bisagra' y 'Regulación de bisagra'. Finalmente deslice el estante móvil F sobre los soportes previamente colocados en los costados C-D haciéndolo llegar hasta el fondo[cite: 11].
  - *Herrajes:* Set de Clavos, Bisagras codo 0 cazoleta 26, Soportes de estantes

---

## 📦 Set mesa de Living LOIRE (SKU: 372150)
- **Línea:** CURVALBA
- **Dificultad:** Bajo | **Tiempo estimado:** 15 min
- **Herramientas necesarias:** Martillo de carpintero, Destornillador de punta en cruz, Usar regla para verificar tamaño de tornillos
- **Visor 3D Interactivo:** https://www.mueblesgacela.com.ar/armado/372150

### 🔩 Herrajes incluidos:
- Pernos mini fix con caja (6 u.)
- Tornillos de 1,5 cm (12 u.)
- Corner (6 u.)
- Clavos cabeza caucho (6 u.)
- Tarugos 6x30 (12 u.)

### 📐 Piezas y Despiece:
- Letra A: Tapa grande (1 u.) - Medidas: Ø 59 cm
- Letra B: Tapa chica (1 u.) - Medidas: Ø 44 cm
- Letra C: Estante grande (1 u.) - Medidas: Ø 44 cm
- Letra D: Estante chico (1 u.) - Medidas: Ø 29 cm
- Letra E: Patas largas (3 u.) - Medidas: 58,5 x 6 cm
- Letra F: Patas cortas (3 u.) - Medidas: 43,5 x 6 cm

### 🪜 Paso a Paso de Armado:
**Paso 1:** Paso 1: En la tapa grande A y en la tapa chica B, atornille 3 pernos mini fix en las perforaciones internas[cite: 10].
  - *Herrajes:* Pernos mini fix con caja

**Paso 2:** Paso 2: Tanto en las patas largas E como en las patas cortas F, colocar a presión un tarugo 6x30 y una caja mini fix en las perforaciones que muestra la figura, por último clavar un clavo cabeza de caucho en la parte inferior, tratando de que este quede centrado[cite: 10].
  - *Herrajes:* Tarugos 6x30, Pernos mini fix con caja, Clavos cabeza caucho

**Paso 3:** Paso 3: En el estante grande C y en el estante chico D colocar a presión 3 tarugos 6 x 30 en las perforaciones del canto y atornillando 3 córner por medio de 3 tornillos de 1,5 cm[cite: 10].
  - *Herrajes:* Tarugos 6x30, Corner, Tornillos de 1,5 cm

**Paso 4:** Paso 4: Una las patas chicas F con la tapa grande A haciendo coincidir los mini fix de esta con las cajas mini fix de las patas y usando los tarugos como guía, una vez encastrados girar las cajas de los mini fix 180 grados en sentido horario[cite: 10]. Previamente haga coincidir los tarugos del estante grande C con las perforaciones en el canto de las patas[cite: 10]. Finalmente atornille las escuadras ya colocadas en el estante, a las patas por medio de 3 tornillos de 1,5 cm[cite: 10]. Repita el proceso para la mesa restante usando las patas largas E, la tapa chica B y el estante chico D[cite: 10].
  - *Herrajes:* Pernos mini fix con caja, Tarugos 6x30, Corner, Tornillos de 1,5 cm

---

## 📦 Bahiut TAGUS 2 puertas y estantes (SKU: 405270)
- **Línea:** CURVALBA
- **Dificultad:** Medio | **Tiempo estimado:** 60 min
- **Herramientas necesarias:** Martillo de carpintero, Destornillador de punta en cruz, Llave allen de 4, Usar regla para verificar tamaño de tornillos
- **Visor 3D Interactivo:** https://www.mueblesgacela.com.ar/armado/405270

### 🔩 Herrajes incluidos:
- Bisagras codo 0 cazoleta 26 (4 u.)
- Tornillos Allen de 5 cm (8 u.)
- Soporte de estantes (4 u.)
- Pernos mini fix con caja (20 u.)
- Tarugos 6x30 (14 u.)
- Escuadras plásticas (2 u.)
- Tornillos de 1.5 cm (20 u.)
- Bases plásticas (6 u.)
- Set de Clavos (1 u.)

### 📐 Piezas y Despiece:
- Letra A: Tapa (1 u.) - Medidas: 120 x 44,5 cm
- Letra B: Piso (1 u.) - Medidas: 117 x 43 cm
- Letra C: Entre tapa (1 u.) - Medidas: 117 x 43 cm
- Letra D: Costado izquierdo (1 u.) - Medidas: 93,5 x 43 cm
- Letra E: Costado derecho (1 u.) - Medidas: 93,5 x 43 cm
- Letra F: Estante fijo (2 u.) - Medidas: 30,5 x 43 cm
- Letra G: Separador arriba (1 u.) - Medidas: 20,3 x 43 cm
- Letra H: Separador abajo (1 u.) - Medidas: 64,2 x 43 cm
- Letra I: Estante móvil (1 u.) - Medidas: 84,8 x 38 cm
- Letra J: Puerta izquierda (1 u.) - Medidas: 62,7 x 43,7 cm
- Letra K: Puerta derecha (1 u.) - Medidas: 62,7 x 43,7 cm
- Letra -: Faja frente (1 u.) - Medidas: 84,8 x 6 cm
- Letra -: Zócalo (2 u.) - Medidas: 117 x 6 cm
- Letra -: Fondo de mueble (2 u.) - Medidas: 66,7 x 43,7 cm

### 🪜 Paso a Paso de Armado:
**Paso 1:** Paso 1: Prepare el costado izquierdo D, colocando a presión 2 cajas para mini fix, atornillando 8 pernos mini fix y clavando en el filo inferior dos bases plásticas[cite: 10].
  - *Herrajes:* Pernos mini fix con caja, Bases plásticas

**Paso 2:** paso 2: En el costado derecho E, coloque a presión 2 soporte de estantes y 2 cajas para mini fix, atornille 4 pernos mini fix y adhiera 2 bases de bisagra mediante los tornillos de 1,5 cm por ultimo clave en el filo inferior dos bases plásticas[cite: 10]. De igual manera prepare el separador abajo H, pero sin los pernos mini fix ni las bases plásticas, teniendo en cuenta que es simétrico a este último[cite: 10].
  - *Herrajes:* Soporte de estantes, Pernos mini fix con caja, Bisagras codo 0 cazoleta 26, Tornillos de 1.5 cm, Bases plásticas

**Paso 3:** paso 3 Prepare los zócalos, colocando a presión 5 tarugos guías de 6x30 atornillando la escuadra plástica con un tornillo de 1,5 cm y clavando desde abajo una base plástica ( tanto la base como la escuadra deben quedar centrados)[cite: 10]. En la faja frente coloque 4 tarugos guías de 6x30, ocupando todas las perforaciones[cite: 10].
  - *Herrajes:* Tarugos 6x30, Escuadras plásticas, Tornillos de 1.5 cm, Bases plásticas

**Paso 4:** paso 4: A la entre tapa C, coloque a presión 4 cajas para mini fix y atornille 2 pernos mini fix[cite: 10]. En el piso B, solo coloque a presión 4 cajas para mini fix[cite: 10]. Y en la tapa A, solo atornille 6 pernos mini fix[cite: 10].
  - *Herrajes:* Pernos mini fix con caja

**Paso 5:** Paso 5: En las puertas J-K coloque 2 bisagra mediante los tornillos de 1,5 cm[cite: 10]. Tanto en los estantes fijos F como en el separador arriba G coloque a presión 2 cajas para mini fix[cite: 10].
  - *Herrajes:* Bisagras codo 0 cazoleta 26, Tornillos de 1.5 cm, Pernos mini fix con caja

**Paso 6:** paso 6: Mediante los tornillos Allen de 5 cm, una el separador abajo H con el piso B[cite: 10]. Luego los estantes fijos F al separador abajo[cite: 10]. Por otro lado la entre tapa C con el separador arriba G[cite: 10]. Finalmente introduzca los pernos mini fix de la entre tapa en las perforaciones del separador abajo, luego gire las cajas mini fix 180° en sentido horario, para ajustar las piezas[cite: 10].
  - *Herrajes:* Tornillos Allen de 5 cm, Pernos mini fix con caja

**Paso 7:** paso 7: Introduzca los pernos mini fix del costado izquierdo D en las perforaciones de la entre tapa C, el piso B y los estantes fijos F, luego gire las cajas mini fix 180° en sentido horario, para ajustar las piezas[cite: 10]. Luego introduzca los pernos mini fix del costado derecho E en las perforaciones de la entre tapa y del piso[cite: 10]. PREVIAMENTE habiendo echo coincidir los tarugos de la faja frente y de los zócalos con las perforaciones de los costados, del piso y del separador H[cite: 10]. Para luego ajustar las piezas por medio de las cajas mini fix[cite: 10]. Desde arriba introduzca los pernos mini fix de la tapa A en las perforaciones de los costados y del separador arriba G, luego gire las cajas mini fix 180° en sentido horario, para ajustar las piezas[cite: 10].
  - *Herrajes:* Pernos mini fix con caja, Tarugos 6x30

**Paso 8:** Paso 8: Desde abajo ajuste los zócalos al piso B por medio de dos tornillos de 1,5 cm y a través de las escuadras plásticas[cite: 10]. Luego clave el fondo de 3 mm, tal como lo indica el grafico, siguiendo el orden correcto y la escuadras justa del mueble[cite: 10]. Posteriormente distribuya los clavos a una distancia aproximada de 15 cm entre ellos, proporcionándole la rigidez necesaria al mueble (Vértices: 1 vértice H-C, 2 vértice C medio, 3 vértice H-B, 4 vértice B medio)[cite: 10]. Realizar la misma operación con el fondo restante uniéndolos por medio de la H plástica provista[cite: 10]. Deslice el estante móvil E sobre los soportes previamente colocados en el costado derecho E y en el separador H haciéndolo llegar hasta el fondo[cite: 10]. Coloque las puertas J - K en las bases de bisagras colocadas en el costado derecho E y en el separador H utilizando como guía el contenido de 'Regulación y colocación de bisagra'[cite: 10].
  - *Herrajes:* Tornillos de 1.5 cm, Escuadras plásticas, Set de Clavos, Soporte de estantes, Bisagras codo 0 cazoleta 26
  - 💡 *Consejo Pro:* Colocación y regulación de bisagras: El tornillo de regulación de profundidad debe encontrarse en la mitad de su recorrido[cite: 10]. Luego ingrese la bisagra en la base de bisagra haciendo coincidir el tornillo de regulación lateral con la ranura en U de la base, y finalmente ajuste el tornillo de regulación de profundidad[cite: 10].

---

## 📦 Rack NIGER con 3 cajones y estantes (SKU: 446270)
- **Línea:** CURVALBA
- **Dificultad:** Medio | **Tiempo estimado:** 90 min
- **Herramientas necesarias:** Martillo de carpintero, Destornillador de punta en cruz, Llave Allen 4, Usar regla para verificar tamaño de tornillos
- **Visor 3D Interactivo:** https://www.mueblesgacela.com.ar/armado/446270

### 🔩 Herrajes incluidos:
- Envase de cola (1 u.)
- Escuadras plásticas (2 u.)
- Tornillos Allen de 5 cm (8 u.)
- Pares de guías metálicas de 35 cm (3 u.)
- Tornillos varianta (12 u.)
- Bases plásticas (6 u.)
- Tornillos de 4 cm (6 u.)
- Tornillos de 1,5 cm (4 u.)
- Pernos mini fix con caja (22 u.)
- Tornillos de 2 cm (12 u.)
- Tarugos 6x30 (30 u.)
- Set de Clavos (1 u.)

### 📐 Piezas y Despiece:
- Letra A: Tapa (1 u.) - Medidas: 160 x 40 cm
- Letra B: Piso (1 u.) - Medidas: 157 x 38,5 cm
- Letra E: Separador (2 u.) - Medidas: 20 x 35,5 cm
- Letra C: Costado izquierdo (1 u.) - Medidas: 53,5 x 38,5 cm
- Letra D: Costado derecho (1 u.) - Medidas: 53,5 x 38,5 cm
- Letra G: Frente cajón lateral izquierdo (1 u.) - Medidas: 53,3 x 21,5 cm
- Letra H: Frente cajón lateral derecho (1 u.) - Medidas: 53,3 x 21,5 cm
- Letra I: Frente cajón centro (1 u.) - Medidas: 52,4 x 21,5 cm
- Letra -: Fondo mueble (1 u.) - Medidas: 159,5 x 48,5 cm
- Letra -: Zócalo (1 u.) - Medidas: 157 x 6 cm
- Letra J: Costado cajón (6 u.) - Medidas: 35 x 10 cm
- Letra K: Fondo cajón (3 u.) - Medidas: 52 x 10 cm
- Letra -: Piso cajón (3 u.) - Medidas: 48,6 x 32,8 cm
- Letra -: Faja frente (1 u.) - Medidas: 157 x 6 cm
- Letra F: Entre piso (1 u.) - Medidas: 157 x 10 cm
- Letra -: Fondo (1 u.) - Medidas: 157 x 24 cm

### 🪜 Paso a Paso de Armado:
**Paso 1:** Paso 1: Prepare el costado derecho D, colocando a presión 2 caja mini fix, colocando la guía metálica fija derecha mediante los tornillos varianta, también atornille 4 pernos mini fix en las perforaciones que muestra la figura y clave dos bases plásticas. Realice el mismo procedimiento en el costado izquierdo C, teniendo en cuenta que es simétrico.
  - *Herrajes:* Pernos mini fix con caja, Tornillos varianta, Pares de guías metálicas de 35 cm, Bases plásticas

**Paso 2:** Paso 2: En el separador E, coloque a presión 2 caja mini fix, en la cara izquierda atornille la guía metálica fija derecha mediante los tornillos varianta y en la cara derecha la guía metálica fija izquierda. Verificando que los tornillos variantas no ingresen en la misma perforación.
  - *Herrajes:* Pernos mini fix con caja, Tornillos varianta, Pares de guías metálicas de 35 cm

**Paso 3:** Paso 3: Prepare el zócalo, colocando a presión 6 tarugos guías de 6x30, atornillando 2 escuadras plásticas con dos tornillos de 1,5 cm y clavando desde abajo dos bases plásticas (tanto la base como la escuadra deben quedar en línea con los tarugos superiores).
  - *Herrajes:* Tarugos 6x30, Escuadras plásticas, Tornillos de 1,5 cm, Bases plásticas

**Paso 4:** Paso 4: En el fondo coloque a presión 4 cajas mini fix en las perforaciones de la cara y 2 tarugos guías de 6x30 en el canto superior como lo muestra la figura. En la faja frente coloque 4 tarugos guías de 6x30, ocupando todas las perforaciones. En la tapa A atornille 8 pernos mini fix.
  - *Herrajes:* Pernos mini fix con caja, Tarugos 6x30

**Paso 5:** Paso 5: Una el fondo y el entre piso F con los separadores E por medio de cuatro tornillos Allen de 5 cm. Luego coloque a presión cuatro cajas mini fix en el entrepiso F en las perforaciones que muestra la figura.
  - *Herrajes:* Tornillos Allen de 5 cm, Pernos mini fix con caja

**Paso 6:** Paso 6: Una el fondo y el entre piso F a los costados C - D, introduciendo los pernos minifix de estos en las perforaciones de las cajas minifix de los primeros, luego ajuste las piezas girando 180 grados en sentido horario las cajas mini fix. Por medio de los tornillos Allen de 5 cm una el piso B a los costados, previamente haciendo coincidir los tarugos de la faja frente y el zócalo con las perforaciones de los costados. Además el tarugo superior del zócalo debe coincidir con la perforación inferior del piso.
  - *Herrajes:* Pernos mini fix con caja, Tornillos Allen de 5 cm, Tarugos 6x30

**Paso 7:** Paso 7: Armado de cajones (procedimiento base con el Frente de cajón centro I): Coloque 2 tarugos 6x30 en el fondo de cajón K, 2 más en cada uno de los costados de cajón J a su vez encastrar las cajas mini fix. Agregar adhesivo en cada perforación donde lleve tarugo.
  - *Herrajes:* Tarugos 6x30, Pernos mini fix con caja, Envase de cola

**Paso 8:** Paso 8: En el frente de cajón centro I atornillar 2 pernos mini fix.
  - *Herrajes:* Pernos mini fix con caja

**Paso 9:** Paso 9: Una vez armada la estructura tipo 'U' entre J-K-J, ingrese el frente de cajón centro I ajuste los pernos mini fix girando 180 grados las cajas mini fix. Habiendo agregado el adhesivo anteriormente. Luego ajuste el fondo y los costados mediante los dos tornillos 4 cm.
  - *Herrajes:* Pernos mini fix con caja, Envase de cola, Tornillos de 4 cm

**Paso 10:** Paso 10: Desde abajo introduzca el piso de cajón sobre el canal del frente de cajón centro I, y clave este siguiendo una escuadra correcta del cajón sobre los filos inferiores de los costados y del fondo. Atornille las guías metálicas como muestra la figura mediante 4 tornillos 2 cm. Repetir los pasos de armado para los cajones laterales usando el Frente de cajón lateral izquierdo G y el Frente de cajón lateral derecho H.
  - *Herrajes:* Set de Clavos, Pares de guías metálicas de 35 cm, Tornillos de 2 cm

**Paso 11:** Paso 11: Una la tapa A a los costados C - D y a los separadores E, introduciendo los pernos minifix de la tapa en las perforaciones de las cajas minifix de estos, luego ajuste las piezas girando 180 grados en sentido horario las cajas mini fix. Desde abajo ajuste el zócalo por medio de dos tornillos de 1,5 cm al piso B y a través de la escuadra plástica. Con el mueble acostado clave el fondo de mueble de 3 mm, tal como lo indica el gráfico, siguiendo el orden correcto y las escuadras justas del mueble. Posteriormente distribuya los clavos a una distancia aproximada de 15 cm entre ellos, proporcionándole la rigidez necesaria al mueble (Vértices: 1 A-C, 2 A-D, 3 B-C, 4 B-D).
  - *Herrajes:* Pernos mini fix con caja, Tornillos de 1,5 cm, Escuadras plásticas, Set de Clavos

**Paso 12:** Paso 12: Finalmente coloque los cajones ya armados sobre las guías fijas ya colocadas en los costados y siguiendo el orden correcto de los frentes de cajón.
  - *Herrajes:* Pares de guías metálicas de 35 cm
  - 💡 *Consejo Pro:* Colocación de cajones: Colocar los cajones sobre las guías fijas que se encuentran ya en el mueble, como lo muestra la imagen.

---

## 📦 Mesa de Luz LIMAY con cajón y estantes (SKU: 732270)
- **Línea:** CURVALBA
- **Dificultad:** Medio | **Tiempo estimado:** 30 min
- **Herramientas necesarias:** Martillo de carpintero, Destornillador de punta en cruz, Llave Allen 4, Usar regla para verificar tamaño de tornillos
- **Visor 3D Interactivo:** https://www.mueblesgacela.com.ar/armado/732270

### 🔩 Herrajes incluidos:
- Envase de cola (1 u.)
- Tornillos Allen de 5 cm (4 u.)
- Bases plásticas (4 u.)
- Par de guías metálicas de 35 cm (1 u.)
- Tornillos de 4 cm (2 u.)
- Tarugos 6x30 (14 u.)
- Tornillos varianta (4 u.)
- Pernos mini fix con caja (6 u.)
- Tornillos de 2 cm (4 u.)
- Set de Clavos (1 u.)

### 📐 Piezas y Despiece:
- Letra A: Tapa (1 u.) - Medidas: 40 x 40 cm
- Letra B: Piso (1 u.) - Medidas: 37 x 38,5 cm
- Letra C: Costado izquierdo (1 u.) - Medidas: 53,5 x 38,5 cm
- Letra D: Costado derecho (1 u.) - Medidas: 53,5 x 38,5 cm
- Letra -: Faja frente (2 u.) - Medidas: 37 x 6 cm
- Letra G: Frente cajón (1 u.) - Medidas: 39,8 x 21,5 cm
- Letra J: Costado cajón (2 u.) - Medidas: 35 x 10 cm
- Letra K: Fondo cajón (1 u.) - Medidas: 31,4 x 10 cm
- Letra -: Fondo mueble (1 u.) - Medidas: 48,6 x 39,5 cm
- Letra -: Piso cajón (1 u.) - Medidas: 34,2 x 32,8 cm

### 🪜 Paso a Paso de Armado:
**Paso 1:** Paso 1: Prepare el costado derecho D, colocando a presión 2 caja mini fix, colocando la guía metálica fija derecha mediante los tornillos varianta y clavando desde abajo dos bases plásticas[cite: 11]. Realice el mismo procedimiento en el costado izquierdo C, teniendo en cuenta que es simétrico[cite: 11]. En la tapa A atornille 4 pernos mini fix[cite: 11]. En las fajas frente coloque 4 tarugos guías de 6x30, ocupando todas las perforaciones[cite: 11].
  - *Herrajes:* Pernos mini fix con caja, Par de guías metálicas de 35 cm, Tornillos varianta, Bases plásticas, Tarugos 6x30

**Paso 2:** Paso 2: Una el piso B con los costados C - D, por medio de 4 tornillos Allen de 5 cm previamente haga coincidir los tarugos de las fajas frente, con las perforaciones de los costados[cite: 11]. Desde arriba una la tapa A a los costados, introduciendo los pernos minifix de la tapa en las perforaciones de las cajas minifix de los costados[cite: 11]. Luego ajuste las piezas girando 180 grados en sentido horario las cajas mini fix[cite: 11].
  - *Herrajes:* Tornillos Allen de 5 cm, Tarugos 6x30, Pernos mini fix con caja

**Paso 3:** Paso 3 Armado de cajones: Coloque 2 tarugos 6x30 en el fondo de cajón K, 2 mas en cada uno de los costados de cajón J a su vez encastrar las cajas mini fix[cite: 11]. Agregar adhesivo en cada perforación donde lleve tarugo[cite: 11].
  - *Herrajes:* Tarugos 6x30, Pernos mini fix con caja, Envase de cola

**Paso 4:** paso 4 armado de cajon: En el frente de cajón G atornillar dos pernos mini fix[cite: 11].
  - *Herrajes:* Pernos mini fix con caja

**Paso 5:** paso 5 armado de cajones: Una vez armada la estructura tipo "U" entre K-J-K, ingrese el frente de cajón G ajuste los pernos mini fix girando 180 grados las cajas mini fix[cite: 11]. Habiendo agregado el adhesivo anteriormente[cite: 11]. Luego ajuste el fondo y los costados mediante los dos tornillos 4 cm[cite: 11].
  - *Herrajes:* Pernos mini fix con caja, Envase de cola, Tornillos de 4 cm

**Paso 6:** paso 6: Desde abajo introduzca el piso de cajón sobre el canal del frente de cajón G, y clave este siguiendo una escuadra correcta del cajón sobre los filos inferiores de los costados y del fondo[cite: 11]. Atornille las guías metálicas como muestra la figura mediante 4 tornillos 2 cm[cite: 11].
  - *Herrajes:* Set de Clavos, Par de guías metálicas de 35 cm, Tornillos de 2 cm

**Paso 7:** paso 7: Con el mueble acostado clave el fondo de mueble de 3 mm, tal como lo indica el grafico, siguiendo el orden correcto y la escuadras justa del mueble[cite: 11]. Posteriormente distribuya los clavos a una distancia aproximada de 15 cm entre ellos, proporcionándole la rigidez necesaria al mueble[cite: 11]. Vértices: 1 vértice A-C, 2 vértice A-D, 3 vértice B-D, 4 vértice B-C[cite: 11].
  - *Herrajes:* Set de Clavos

**Paso 8:** paso 8: Finalmente coloque el cajón ya armado sobre las guías fijas ya colocadas en los costados[cite: 11]. Colocar los cajones sobre las guías fijas que se encuentran ya en el mueble, como lo muestra la imagen[cite: 11].
  - *Herrajes:* Par de guías metálicas de 35 cm
  - 💡 *Consejo Pro:* Colocación de cajones: Colocar los cajones sobre las guías fijas que se encuentran ya en el mueble, como lo muestra la imagen[cite: 11].

---

## 📦 Placard RHINE 2 puertas de abrir, cajón barral y estantes (SKU: 742270)
- **Línea:** CURVALBA
- **Dificultad:** Alto | **Tiempo estimado:** 105 min
- **Herramientas necesarias:** Martillo de carpintero, Destornillador de punta en cruz, Llave Allen, Usar regla para verificar tamaño de tornillos
- **Visor 3D Interactivo:** https://www.mueblesgacela.com.ar/armado/742270

### 🔩 Herrajes incluidos:
- Envase de cola (1 u.)
- Tornillos Allen 5 cm (16 u.)
- Bisagras codo 0 cazoleta 26 (6 u.)
- Llave Allen (1 u.)
- Pernos mini fix con caja (3 u.)
- Tornillos varianta (4 u.)
- Tornillos de 1.5 cm (30 u.)
- Par de guías metálicas de 40 cm (1 u.)
- Tornillos de 2 cm (4 u.)
- Tornillos de 4 cm (10 u.)
- Escuadras plásticas (2 u.)
- Caño de 86 cm (1 u.)
- Bases plásticas (6 u.)
- Tarugos 6x30 (30 u.)
- Soporte de caños (2 u.)
- Set de Clavos (1 u.)

### 📐 Piezas y Despiece:
- Letra A: Tapa (1 u.) - Medidas: 90 x 52 cm
- Letra B: Piso (1 u.) - Medidas: 87 x 50 cm
- Letra C: Costado izquierdo (1 u.) - Medidas: 178,5 x 50 cm
- Letra D: Costado derecho (1 u.) - Medidas: 178,5 x 50 cm
- Letra E: Entre tapa (1 u.) - Medidas: 87 x 50 cm
- Letra F: Estante (1 u.) - Medidas: 87 x 40 cm
- Letra -: Zócalo (3 u.) - Medidas: 87 x 6 cm
- Letra -: Faja frente (1 u.) - Medidas: 87 x 6 cm
- Letra L: Faja parante izquierdo (1 u.) - Medidas: 124 x 6 cm
- Letra O: Faja parante derecho (1 u.) - Medidas: 124 x 7,5 cm
- Letra G: Puerta (2 u.) - Medidas: 125 x 43,5 cm
- Letra -: Refuerzo cajón (1 u.) - Medidas: 42,3 x 6 cm
- Letra H: Frente cajón (1 u.) - Medidas: 89,8 x 23,5 cm
- Letra J: Costado cajón (2 u.) - Medidas: 450 x 12 cm
- Letra K: Fondo cajón (1 u.) - Medidas: 81,4 x 12 cm
- Letra -: Fondo mueble (2 u.) - Medidas: 173,5 x 44,5 cm
- Letra -: Piso cajón (1 u.) - Medidas: 84,2 x 42,8 cm

### 🪜 Paso a Paso de Armado:
**Paso 1:** Paso 1: Prepare el costado derecho D, colocando 3 bases de bisagra mediante los tornillos de 1,5 cm, también el soporte plástico de caño haciéndolo encastrar en la perforación central y luego ajustándolo mediante un tornillo de estos[cite: 12]. Atornille las guías metálica fijas derechas mediante los tornillos varianta y clave desde abajo 2 bases plásticas[cite: 12]. Realice el mismo procedimiento en el costado izquierdo C, teniendo en cuenta que es simétrico[cite: 12].
  - *Herrajes:* Tornillos de 1.5 cm, Soporte de caños, Par de guías metálicas de 40 cm, Tornillos varianta, Bases plásticas

**Paso 2:** Paso 2: En las puertas G coloque 3 bisagra mediante los tornillos de 1,5 cm[cite: 12].
  - *Herrajes:* Bisagras codo 0 cazoleta 26, Tornillos de 1.5 cm

**Paso 3:** Paso 3: En el parante izquierdo L coloque 4 tarugos guías de 6x30, como lo muestra la figura y en el parante derecho M coloque 2 tarugos guías en los extremos[cite: 12].
  - *Herrajes:* Tarugos 6x30

**Paso 4:** Paso 4: Prepare 2 zócalos, colocando a presión 5 tarugos guías de 6x30 atornillando la escuadra plástica con un tornillo de 1,5 cm y clavando desde abajo una base plástica (tanto la base como la escuadra deben quedar centrados)[cite: 12]. Prepare el zócalo restante y la faja frente, colocando a presión 4 tarugos guías solo en los extremos[cite: 12].
  - *Herrajes:* Tarugos 6x30, Escuadras plásticas, Tornillos de 1.5 cm, Bases plásticas

**Paso 5:** Paso 5: Mediante los tornillos Allen de 5 cm, una el estante F, el piso B y la entre tapa E con el costado derecho D y con el costado izquierdo C[cite: 12]. Previamente haciendo coincidir los tarugos guías de los zócalos y la faja frente en las perforaciones de los costados, a vez el tarugo superior de los zócalos inferiores con las perforaciones del piso[cite: 12]. Verifique que los cantos melaminicos queden hacia el frente[cite: 12].
  - *Herrajes:* Tornillos Allen 5 cm, Tarugos 6x30

**Paso 6:** Paso 6 armado de cajón: Coloque 2 tarugos 6x30 en el fondo de cajón K, 2 más en cada uno de los costados de cajón J a su vez encastrar las cajas mini fix[cite: 12]. Agregar adhesivo en cada perforación donde lleve tarugo[cite: 12].
  - *Herrajes:* Tarugos 6x30, Pernos mini fix con caja, Envase de cola

**Paso 7:** Paso 7 armado de cajón: Atornille 3 minifix en el frente de cajón H[cite: 12].
  - *Herrajes:* Pernos mini fix con caja

**Paso 8:** Paso 8 Armado de cajón: Una vez armada la estructura tipo 'U' entre J-K-J, ingrese el frente de cajón H ajuste los pernos mini fix girando 180 grados las cajas mini fix. Habiendo agregado el adhesivo anteriormente[cite: 12]. Luego ajuste el fondo y los costados mediante los dos tornillos 4x40[cite: 12].
  - *Herrajes:* Pernos mini fix con caja, Envase de cola, Tornillos de 4 cm

**Paso 9:** Paso 9 armado de cajón: Desde abajo introduzca el piso de cajón sobre el canal del frente de cajón H, y clave este siguiendo una escuadra correcta del cajón sobre los filos inferiores de los costados y del fondo[cite: 12]. Finalmente atornille las guías metálicas como muestra la figura mediante 4 tornillos 3,5x20[cite: 12].
  - *Herrajes:* Set de Clavos, Par de guías metálicas de 40 cm, Tornillos de 2 cm

**Paso 10:** Paso 10 armado de cajón: Haga coincidir la perforación lateral del refuerzo de cajón con el perno mini fix colocado en el frente de cajón H, ajuste las piezas girando la caja mini fix media vuelta en sentido horario[cite: 12]. Finalmente ajuste el refuerzo al fondo de cajón K mediante 1 tornillo de 4 cm[cite: 12].
  - *Herrajes:* Pernos mini fix con caja, Tornillos de 4 cm

**Paso 11:** Paso 11: Primero por medio de 3 tornillos de 4 cm una el parante izquierdo L con el parante derecho O utilizando como guía los tarugos del primero[cite: 12]. Luego desde arriba una la tapa A a los costados C-D por medio de los tornillos Allen de 5 cm, previamente haciendo coincidir los tarugos de los parantes con las perforaciones de la tapa y de la entre tapa E, para luego ajustar los parantes a estas por medio de 4 tornillos de 4 cm[cite: 12]. Segundo, con el mueble acostado clave los fondos de mueble de 3 mm, tal como lo indica el gráfico, siguiendo el orden correcto y las escuadras justas del mueble[cite: 12]. Posteriormente distribuya los clavos a una distancia aproximada de 15 cm entre ellos, proporcionándole la rigidez necesaria al mueble (Vértices: 1 vértice A-C, 2 medio de A, 3 vértice B-C, 4 medio B)[cite: 12]. Repita para el fondo restante pero colocando la H plástica[cite: 12]. Por último desde abajo por medio de 2 tornillos de 1,5 cm una los zócalos al piso B a través de las escuadras plásticas[cite: 12].
  - *Herrajes:* Tornillos de 4 cm, Tornillos Allen 5 cm, Set de Clavos, Tornillos de 1.5 cm, Escuadras plásticas

**Paso 12:** Paso 12: Finalmente coloque las puertas G en los costados C-D. Utilizando como guía las indicaciones de 'Regulación de bisagra'[cite: 12]. Luego ingrese los cajones como indica la 'Colocación de cajones'[cite: 12]. También coloque el caño sobre los soportes plásticos previamente colocados en los costados[cite: 12].
  - *Herrajes:* Bisagras codo 0 cazoleta 26, Par de guías metálicas de 40 cm, Soporte de caños
  - 💡 *Consejo Pro:* Colocación de cajones: Colocar los cajones sobre las guías fijas que se encuentran ya en el mueble, como lo muestra la imagen[cite: 12].

---

## 📦 Placard VOLGA 2 puertas corredizas, 2 cajones barrales y estantes (SKU: 742272)
- **Línea:** CURVALBA
- **Dificultad:** Alto | **Tiempo estimado:** 135 min
- **Herramientas necesarias:** Martillo de carpintero, Destornillador de punta en cruz, Llave allen, Cinta metrica, Usar regla para verificar tamaño de tornillos
- **Visor 3D Interactivo:** https://www.mueblesgacela.com.ar/armado/742272

### 🔩 Herrajes incluidos:
- Envase de cola (1 u.)
- Pares de guías metálicas de 40 cm (2 u.)
- Caño de 57,2 cm (1 u.)
- Tornillos phillips de 5 cm (18 u.)
- Pernos mini fix con caja (6 u.)
- Tornillos varianta (8 u.)
- Soporte de caños (2 u.)
- Soporte de estantes (8 u.)
- Escuadras plásticas (2 u.)
- Tornillos de 2 cm (8 u.)
- Tornillos de 4 cm (4 u.)
- Carros inferiores (4 u.)
- Manijas athenas (2 u.)
- Bases plásticas (6 u.)
- Tornillos de 1.5 cm (42 u.)
- Clips (4 u.)
- Trabas (4 u.)
- Set de Clavos (1 u.)
- Tarugos 6x30 (30 u.)
- Guia inferiores (rieles) (2 u.)
- Guia superiores (rieles) (2 u.)

### 📐 Piezas y Despiece:
- Letra A: Tapa (1 u.) - Medidas: 117,5 x 55 cm
- Letra B: Piso (1 u.) - Medidas: 117,5 x 55 cm
- Letra C: Entre tapa (1 u.) - Medidas: 117,5 x 55 cm
- Letra D: Costado izquierdo (1 u.) - Medidas: 180 x 55 cm
- Letra E: Costado derecho (1 u.) - Medidas: 180 x 55 cm
- Letra F: Separador arriba (1 u.) - Medidas: 123,9 x 44,5 cm
- Letra J: Separador abajo (1 u.) - Medidas: 45,6 x 55 cm
- Letra P: Estante móvil (2 u.) - Medidas: 58 x 44,5 cm
- Letra -: Frentes (2 u.) - Medidas: 58 x 6 cm
- Letra -: Zócalo (2 u.) - Medidas: 117,5 x 6 cm
- Letra G: Puerta izquierda (1 u.) - Medidas: 122,6 x 61 cm
- Letra H: Puerta derecha (1 u.) - Medidas: 122,6 x 61 cm
- Letra K: Frente cajón izquierdo (1 u.) - Medidas: 60 x 23,5 cm
- Letra L: Frente cajón derecho (1 u.) - Medidas: 60 x 23,5 cm
- Letra N: Costado cajón (4 u.) - Medidas: 45 x 12 cm
- Letra O: Fondo cajón (2 u.) - Medidas: 52,3 x 12 cm
- Letra -: Piso cajón (2 u.) - Medidas: 55,1 x 42,8 cm
- Letra -: Fondo mueble (2 u.) - Medidas: 173,5 x 59,5 cm

### 🪜 Paso a Paso de Armado:
**Paso 1:** Paso 1: Prepare el costado izquierdo D, colocando una guía metálica fija izquierda mediante los tornillos varianta, clavando dos bases plásticas en el canto inferior y fijando por medio de un tornillo de 1,5 cm un soporte de caño, como lo muestra la figura. Realice el mismo procedimiento para el costado derecho E, tenga en cuenta que es simétrico por ende se coloca la guía metálica fija izquierda y además este no llevara soporte de caño pero si soporte de estantes.
  - *Herrajes:* Tornillos varianta, Bases plásticas, Tornillos de 1.5 cm, Soporte de caños, Soporte de estantes

**Paso 2:** Paso 2: Al separador arriba F le colocamos en la cara izquierda el soporte plástico de caño haciéndolo encastrar en la perforación central superior y luego ajustándolo mediante un tornillo de 1,5 cm, como lo muestra la figura. En la cara derecha coloque a presión 4 soportes de estantes.
  - *Herrajes:* Soporte de caños, Tornillos de 1.5 cm, Soporte de estantes

**Paso 3:** Paso 3: En el separador abajo J, en la cara derecha colocar una guía metálica fija izquierda partiendo de la primer perforación mediante los tornillos varianta, con los mismos tornillos colocar en la cara izquierda una guía metálica fija derecha como lo muestra la figura en la pagina anterior. Luego colocar a presión dos cajas mini fix.
  - *Herrajes:* Tornillos varianta, Pernos mini fix con caja

**Paso 4:** Paso 4: En los zócalos, colocar a presión 4 tarugos en los cantos cortos y uno en el canto superior, además clavar en el canto inferior una base plástica posicionándola en forma centrada y por último por medio de un tornillo de 1,5 cm coloque una escuadra plástica. En las fajas frente, colocar a presión 4 tarugos en los cantos cortos.
  - *Herrajes:* Tarugos 6x30, Bases plásticas, Escuadras plásticas, Tornillos de 1.5 cm

**Paso 5:** Paso 5: A la entre tapa C en la cara superior cerca del canto melaminico, colocamos 2 rieles inferiores (a las medidas que muestra la figura) mediante 6 tornillos de 1,5 cm en las perforaciones que tienen estos, centrándolos en el ancho, dejando aproximadamente 5 mm por lado y desde abajo atornillamos dos pernos mini fix. A la tapa A cerca del canto melaminico, colocamos 2 rieles superiores (a las medidas que muestra la figura) mediante 6 tornillos de 1,5 cm en las perforaciones que tienen estos, centrándolos en el ancho, dejando aproximadamente 5 mm por lado.
  - *Herrajes:* Guia inferiores (rieles), Guia superiores (rieles), Tornillos de 1.5 cm, Pernos mini fix con caja

**Paso 6:** Paso 6: Una la tapa A y la entre tapa C con el separador arriba F por medio de los tornillos Allen de 5 cm, (verifique que el canto melaminico del separador quede hacia adelante). Luego una el separador abajo J con la entre tapa haciendo coincidir los pernos mini fix de esta con las perforaciones con las cajas mini fix del separador abajo; ajuste las piezas haciendo girar las cajas mini fix media vuelta en sentido horario. Por último una el piso B al separador abajo por medio de los tornillos Allen teniendo en cuenta que las perforaciones chicas queden hacia abajo.
  - *Herrajes:* Tornillos phillips de 5 cm, Pernos mini fix con caja

**Paso 7:** Paso 7: Una los costados D y E a la tapa A, la entre tapa C y el piso B por medio de los tornillos Allen de 5 cm, PREVIAMENTE hacer coincidir los tarugos de las fajas frente con las perforaciones de los costados y del separador abajo J. Como así también los tarugos de los zócalos con las perforaciones de los costados y del piso. Desde abajo ajuste los zócalos atornillando las escuadras al piso por medio de dos tornillos de 1,5 cm. Clave el fondo de mueble, tal como lo indica el grafico, siguiendo el orden correcto y la escuadras justa del mueble. Posteriormente distribuya los clavos a una distancia aproximada de 15 cm entre ellos, proporcionándole la rigidez necesaria al mueble. (1 vértice A-D 2 vértice A-F, 3 vértice D-B 4 vértice J-B). Repita el proceso para el fondo restante. Finalmente introduzca los estantes móviles P sobre los soportes de estantes y el caño sobre los soportes plásticos para caño.
  - *Herrajes:* Tornillos phillips de 5 cm, Escuadras plásticas, Tornillos de 1.5 cm, Set de Clavos, Soporte de estantes, Soporte de caños, Caño de 57,2 cm

**Paso 8:** Paso 8 armado de cajones: Coloque 2 tarugos 6x30 en el fondo de cajón O, 2 mas en cada uno de los costados de cajón N a su vez encastrar las cajas mini fix. Agregar adhesivo en cada perforación donde lleve tarugo.
  - *Herrajes:* Tarugos 6x30, Pernos mini fix con caja, Envase de cola

**Paso 9:** Paso 9 armado de cajones: Atornille 2 minifix en el frente de cajón L.
  - *Herrajes:* Pernos mini fix con caja

**Paso 10:** Paso 10 armado de cajones: Una vez armada la estructura tipo "U" entre NO-N, ingrese el frente de cajón L ajuste los pernos mini fix girando 180 grados las cajas mini fix. Habiendo agregado el adhesivo anteriormente. Luego ajuste el fondo y los costados mediante los dos tornillos 4 cm.
  - *Herrajes:* Pernos mini fix con caja, Envase de cola, Tornillos de 4 cm

**Paso 11:** Paso 11 armado de cajones: Desde abajo introduzca el piso de cajón sobre el canal del frente de cajón L, y clave este siguiendo una escuadra correcta del cajón sobre los filos inferiores de los costados y del fondo. Finalmente atornille las guías metálicas como muestra la figura mediante 4 tornillos de 2 cm. Repita la operación para el cajón restante, solo cambian los frente de cajones ya que dependen de su posición en el mueble.
  - *Herrajes:* Set de Clavos, Pares de guías metálicas de 40 cm, Tornillos de 2 cm

**Paso 12:** Paso 12: En las puertas G-H introduzca a presión las manijas athenas en las perforaciones que se encuentran en la cara frontal. En la cara posterior introduzca el perno del carro inferior en la perforación grande y luego atorníllelo mediante 2 tornillos 1,5 cm, el carro debe quedar horizontal, haga lo mismo para el carro restante. Luego coloque los clips en las marcas superiores con 4 tornillos 1,5.
  - *Herrajes:* Manijas athenas, Carros inferiores, Clips, Tornillos de 1.5 cm

**Paso 13:** Paso 13: SOLO CUANDO SE COLOQUE LA PUERTA coloque la traba deslizando sobre el clip como muestra la figura hasta que la media esfera entre en el circulo de la traba.
  - *Herrajes:* Trabas, Clips

**Paso 14:** Paso 14: Definiendo la ubicación final del mueble (requiere la ayuda de otra persona). Coloque las puertas en las posiciones que muestra la figura. Los rieles del fondo son para la puerta derecha H y los del frente para la puerta izquierda G. Introduzca primero la puerta derecha ingresando la parte superior de las mismas entre los rieles superiores, luego apoye los carros en los rieles inferiores (ver detalle). Finalmente coloque la traba en los clips fijos quedando la guía superior completa corriendo en el riel superior. Repita el proceso para la puerta izquierda. Colocar los cajones sobre las guías fijas que se encuentran ya en el mueble, en la posición que muestra la imagen.
  - *Herrajes:* Trabas, Pares de guías metálicas de 40 cm

**Paso 15:** Paso 15: Colocación de puertas en los rieles.
  - *Herrajes:* Guia inferiores (rieles), Guia superiores (rieles)

**Paso 16:** Paso 16: Colocacion de cajones.
  - *Herrajes:* Pares de guías metálicas de 40 cm

---

## 📦 Placard SEINE 3 puertas corredizas, 3 cajones, barrales y estantes (SKU: 742273)
- **Línea:** CURVALBA
- **Dificultad:** Alto | **Tiempo estimado:** 165 min
- **Herramientas necesarias:** Martillo de carpintero, Destornillador de punta en cruz, 1 Llave allen, Cinta metrica, Usar regla para verificar tamaño de tornillos
- **Visor 3D Interactivo:** https://www.mueblesgacela.com.ar/armado/742273

### 🔩 Herrajes incluidos:
- Envase de cola (1 u.)
- Pares de guías metálicas de 40 cm (3 u.)
- Caños de 57,2 cm (2 u.)
- Tornillos phillips 5 cm (24 u.)
- Pernos mini fix con caja (10 u.)
- Tornillos varianta (12 u.)
- Soporte de caños (4 u.)
- Soporte de estantes (8 u.)
- Escuadras plásticas (4 u.)
- Tornillos de 2 cm (12 u.)
- Tornillos de 4 cm (6 u.)
- Tornillos de 1,5 cm (58 u.)
- Tarugos 6x30 (4 u.)
- Carros inferiores (6 u.)
- Trabas (6 u.)
- Clips (6 u.)
- Guia inferiores (2 u.)
- Guia superiores (2 u.)
- Set de clavos (1 u.)

### 📐 Piezas y Despiece:
- Letra A: Tapa (1 u.) - Medidas: 177 x 55 cm
- Letra B: Piso (1 u.) - Medidas: 177 x 55 cm
- Letra C: Entre tapa (1 u.) - Medidas: 177 x 55 cm
- Letra D: Costado izquierdo (1 u.) - Medidas: 180 x 55 cm
- Letra E: Costado derecho (1 u.) - Medidas: 180 x 55 cm
- Letra F: Separador arriba (2 u.) - Medidas: 123,9 x 44,5 cm
- Letra J: Separador abajo (2 u.) - Medidas: 45,6 x 55 cm
- Letra P: Estante móvil (2 u.) - Medidas: 58 x 44,5 cm
- Letra -: Frentes (3 u.) - Medidas: 58 x 6 cm
- Letra -: Zócalo (2 u.) - Medidas: 177 x 6 cm
- Letra G: Puerta izquierda (1 u.) - Medidas: 122,6 x 61 cm
- Letra I: Puerta centro (1 u.) - Medidas: 122,6 x 59 cm
- Letra H: Puerta derecha (1 u.) - Medidas: 122,6 x 61 cm
- Letra K: Frente cajón izquierdo (1 u.) - Medidas: 60 x 23,5 cm
- Letra L: Frente cajón derecho (1 u.) - Medidas: 60 x 23,5 cm
- Letra N: Costado cajón (6 u.) - Medidas: 45 x 12 cm
- Letra O: Fondo cajón (3 u.) - Medidas: 52,3 x 12 cm
- Letra -: Piso cajón (3 u.) - Medidas: 55,1 x 42,8 cm
- Letra M: Frente cajón centro (1 u.) - Medidas: 59 x 23,5 cm
- Letra -: Fondo mueble (3 u.) - Medidas: 173,5 x 59,5 cm

### 🪜 Paso a Paso de Armado:
**Paso 1:** Paso 1: Prepare el costado izquierdo D, colocando una guía metálica fija izquierda mediante los tornillos varianta, clavando dos bases plásticas en el canto inferior y fijando por medio de un tornillo de 1,5 cm un soporte de caño, como lo muestra la figura. Realice el mismo procedimiento para el costado derecho E, tenga en cuenta que es simétrico.
  - *Herrajes:* Tornillos varianta, Tornillos de 1.5 cm, Soporte de caños

**Paso 2:** paso 2: Convertiremos a los separadores arriba F uno en derecho y uno en izquierdo. Para hacer el izquierdo le colocamos en la cara izquierda el soporte plástico de caño haciéndolo encastrar en la perforación central superior y luego ajustándolo mediante un tornillo de 1,5 cm, como lo muestra la figura. En la cara derecha coloque a presión 4 soportes de estantes. Para hacer el derecho lo aremos a la inversa, colocamos en la cara derecha el soporte plástico de caño. En la cara izquierda los 4 soportes de estantes.
  - *Herrajes:* Soporte de caños, Tornillos de 1.5 cm, Soporte de estantes

**Paso 3:** paso 3: En los separador abajo J, en la cara derecha colocar una guía metálica fija izquierda partiendo de la primer perforación mediante los tornillos varianta, con los mismos tornillos colocar en la cara izquierda una guía metálica fija derecha como lo muestra la figura en la pagina anterior. Luego colocar a presión dos cajas mini fix.
  - *Herrajes:* Tornillos varianta, Pernos mini fix con caja

**Paso 4:** paso 4: A la entre tapa C en la cara superior cerca del canto melaminico, colocamos 2 rieles inferiores (a las medidas que muestra la figura) mediante 6 tornillos de 1,5 cm en las perforaciones que tienen estos, centrándolos en el ancho, dejando aproximadamente 5 mm por lado y desde abajo atornillamos dos pernos mini fix.
  - *Herrajes:* Guia inferiores, Tornillos de 1.5 cm, Pernos mini fix con caja

**Paso 5:** Paso 5: A la tapa A cerca del canto melaminico, colocamos 2 rieles superiores (a las medidas que muestra la figura) mediante 6 tornillos de 1,5 cm en las perforaciones que tienen estos, centrándolos en el ancho, dejando aproximadamente 5 mm por lado.
  - *Herrajes:* Guia superiores, Tornillos de 1.5 cm

**Paso 6:** paso 6: En los zócalos, colocar a presión 4 tarugos en los cantos cortos y 2 en el canto superior, además clavar en el canto inferior 2 bases plásticas como muestra la imagen y por último por medio de 2 tornillo de 1,5 cm coloque 2 escuadras plásticas. En las fajas frente, colocar a presión 4 tarugos en los cantos cortos.
  - *Herrajes:* Tarugos 6x30, Tornillos de 1.5 cm, Escuadras plásticas

**Paso 7:** paso 7: Una la tapa A y la entre tapa C con los separadores arriba F por medio de los tornillos Allen de 5 cm, ubicando izquierdo y derecho como muestra la imagen. (verifique que el canto melaminico del separador quede hacia adelante). Luego una los separadores abajo J con la entre tapa haciendo coincidir los pernos mini fix de esta con las perforaciones con las cajas mini fix de los separadores abajo; PREVIAMENTE hacer coincidir los tarugos de una fajas frente con las perforaciones de los separadores abajo J, solo una ves listo esto ajuste las piezas haciendo girar las cajas mini fix media vuelta en sentido horario. Por último una el piso B a los separadores abajo por medio de los tornillos Allen teniendo en cuenta que las perforaciones chicas queden hacia abajo.
  - *Herrajes:* Tornillos phillips 5 cm, Pernos mini fix con caja

**Paso 8:** paso 8: Una los costados D y E a la tapa A, la entre tapa C y el piso B por medio de los tornillos Allen de 5 cm, PREVIAMENTE hacer coincidir los tarugos de las fajas frente restantes con las perforaciones de los costados y de los separador abajo J. Como así también los tarugos de los zócalos con las perforaciones de los costados y del piso. Desde abajo ajuste los zócalos atornillando las escuadras al piso por medio de cuatro tornillos de 1,5 cm. Clave el fondo de mueble, tal como lo indica el grafico, siguiendo el orden correcto y la escuadras justa del mueble. Posteriormente distribuya los clavos a una distancia aproximada de 15 cm entre ellos, proporcionándole la rigidez necesaria al mueble. 1 vértice A-D 2 vértice A-F 3 vértice D-B 4 vértice J-B. Repita el proceso para los fondos restantes. Finalmente introduzca los estantes móviles P sobre los soportes de estantes y los caños sobre los soportes plásticos para caño.
  - *Herrajes:* Tornillos phillips 5 cm, Tornillos de 1.5 cm, Set de clavos, Soporte de estantes, Soporte de caños

**Paso 9:** Paso 9 armado de cajones: Coloque 2 tarugos 6x30 en el fondo de cajón O, 2 mas en cada uno de los costados de cajón N a su vez encastrar las cajas mini fix. Agregar adhesivo en cada perforación donde lleve tarugo.
  - *Herrajes:* Tarugos 6x30, Pernos mini fix con caja, Envase de cola

**Paso 10:** Paso 10 armado de cajones: Atornille 2 minifix en el frente de cajón L.
  - *Herrajes:* Pernos mini fix con caja

**Paso 11:** paso 11 armado de cajones: Una vez armada la estructura tipo "U" entre NO-N, ingrese el frente de cajón L ajuste los pernos mini fix girando 180 grados las cajas mini fix. Habiendo agregado el adhesivo anteriormente. Luego ajuste el fondo y los costados mediante los dos tornillos 4 cm.
  - *Herrajes:* Pernos mini fix con caja, Envase de cola, Tornillos de 4 cm

**Paso 12:** paso 12 armado de cajones: Desde abajo introduzca el piso de cajón sobre el canal del frente de cajón L, y clave este siguiendo una escuadra correcta del cajón sobre los filos inferiores de los costados y del fondo. Finalmente atornille las guías metálicas como muestra la figura mediante 4 tornillos de 2 cm. Repita la operación para el cajón restante, solo cambian los frente de cajones ya que dependen de su posición en el mueble.
  - *Herrajes:* Set de clavos, Tornillos de 2 cm, Pares de guías metálicas de 40 cm

**Paso 13:** paso 13: En las puertas G-H-I introduzca a presión las manijas athenas en las perforaciones que se encuentran en la cara frontal. En la cara posterior introduzca el perno del carro inferior en la perforación grande y luego atorníllelo mediante 2 tornillos 1,5 cm, el carro debe quedar horizontal, haga lo mismo para el carro restante. Luego coloque los clips en las marcas superiores con 4 tornillos 1,5.
  - *Herrajes:* Manijas athenas, Carros inferiores, Tornillos de 1.5 cm, Clips

**Paso 14:** paso 14: SOLO CUANDO SE COLOQUE LA PUERTA coloque la traba deslizando sobre el clip como muestra la figura hasta que la media esfera entre en el circulo de la traba.
  - *Herrajes:* Trabas, Clips

**Paso 15:** Paso 15: Definiendo la ubicación final del mueble (requiere la ayuda de otra persona). Coloque las puertas en las posiciones que muestra la figura. Los rieles del fondo son para la puerta derecha H y la puerta Izquierda G y los del frente para la puerta centro I. Introduzca primero las puertas derecha e izquierda ingresando la parte superior de las mismas entre los rieles superiores, luego apoye los carros en los rieles inferiores (ver detalle). Finalmente coloque la traba en los clips fijos quedando la guía superior completa corriendo en el riel superior. Repita el proceso para la puerta centro. Colocar los cajones sobre las guías fijas que se encuentran ya en el mueble, en la posición que muestra la imagen.
  - *Herrajes:* Trabas, Pares de guías metálicas de 40 cm

**Paso 16:** Paso 16 Colocación de puertas en los rieles
  - *Herrajes:* guia inferiores, guia superiores

**Paso 17:** Paso 17 Colocacion de cajones
  - *Herrajes:* Pares de guías metálicas de 40 cm

---

## 📦 Escritorio FENIX Negro/Blanco (SKU: 734222-NB)
- **Línea:** GAMER
- **Dificultad:** Bajo | **Tiempo estimado:** 60 min
- **Herramientas necesarias:** Martillo de carpintero, Destornillador de punta en cruz, Llave allen 4 mm, Usar regla para verificar tamaño de tornillos
- **Visor 3D Interactivo:** https://www.mueblesgacela.com.ar/armado/734222-NB

### 🔩 Herrajes incluidos:
- Tornillos allen 5 cm (16 u.)
- Pernos mini fix con caja (6 u.)
- Tarugos 6x30 (13 u.)
- Bases plásticas con clavos (6 u.)

### 📐 Piezas y Despiece:
- Letra A: Tapa (1 u.) - Medidas: 98 x 58 cm
- Letra B: Piso (1 u.) - Medidas: 51 x 30 cm
- Letra D: Separador abajo (1 u.) - Medidas: 75,5 x 55 cm
- Letra C: Costado izquierdo (1 u.) - Medidas: 75,5 x 55 cm
- Letra I: Costado derecho (1 u.) - Medidas: 90 x 55 cm
- Letra -: Zócalo (2 u.) - Medidas: 30 x 6 cm
- Letra F: Frente (1 u.) - Medidas: 89 x 29 cm
- Letra E: Estante (1 u.) - Medidas: 32 x 30 cm
- Letra G: Separador arriba (1 u.) - Medidas: 40 x 11 cm
- Letra -: Refuerzo tapa (1 u.) - Medidas: 89 x 8 cm
- Letra H: Tapa arriba (1 u.) - Medidas: 125 x 25 cm

### 🪜 Paso a Paso de Armado:
**Paso 1:** Paso 1: Prepare el separador D y el costado izquierdo C colocando a presión 2 cajas para mini fix[cite: 13].
  - *Herrajes:* Pernos mini fix con caja

**Paso 2:** Paso 2: En la tapa A atornille 4 pernos mini fix en las perforaciones que muestra la figura[cite: 13]. En la tapa arriba H atornille 2 pernos[cite: 13].
  - *Herrajes:* Pernos mini fix con caja

**Paso 3:** Paso 3: En el refuerzo de tapa coloque a presión 1 tarugo de 3 cm en el canto largo y 2 en cada canto corto[cite: 13]. En los zócalos frente coloque a presión 4 tarugos[cite: 13].
  - *Herrajes:* Tarugos 6x30

**Paso 4:** Paso 4: Una el costado izquierdo C y el separador abajo D al frente F por medio de los tornillos Allen de 5 cm, previamente haciendo coincidir los tarugos del refuerzo de tapa en las perforaciones del costado y el separador, dejando el tarugo del canto largo hacia arriba[cite: 13].
  - *Herrajes:* Tornillos allen 5 cm, Tarugos 6x30

**Paso 5:** Paso 5: Haga coincidir las cajas para mini fix del costado izquierdo C y del separador D, con los pernos de la tapa A y gire media vuelta en sentido horario las cajas, para ajustar dichas piezas, previamente haciendo coincidir el tarugo del refuerzo de tapa con la perforación de la tapa[cite: 13]. Una el separador arriba G y la tapa desde abajo con dos tornillos Allen de 5 cm[cite: 13]. Luego desde arriba haga coincidir las cajas para mini fix del separador arriba, con los pernos de la tapa arriba H y ajustar las piezas como previamente se indico[cite: 13].
  - *Herrajes:* Pernos mini fix con caja, Tornillos allen 5 cm, Tarugos 6x30

**Paso 6:** Paso 6: Una el costado derecho I y el separador abajo D al estante E y al piso B por medio de los tornillos Allen de 5 cm, previamente haciendo coincidir los tarugos de los zócalos en las perforaciones del costado y el separador[cite: 13]. Luego una el costado derecho a la tapa arriba H por medio de los tornillos Allen de 5 cm[cite: 13]. Clave desde abajo 6 bases plásticas: 2 en el costado derecho, 2 en el costado izquierdo y 2 en el separador[cite: 13].
  - *Herrajes:* Tornillos allen 5 cm, Tarugos 6x30, Bases plásticas con clavos

---

## 📦 Escritorio CAPIBARA tapa impresa (SKU: 334090)
- **Línea:** INFANTIL
- **Dificultad:** Bajo | **Tiempo estimado:** 30 min
- **Herramientas necesarias:** Martillo de carpintero, Destornillador de punta en cruz, Llave allen, Usar regla para verificar tamaño de tornillos
- **Visor 3D Interactivo:** https://www.mueblesgacela.com.ar/armado/334090

### 🔩 Herrajes incluidos:
- Escuadras metálicas (2 u.)
- Tornillos Allen 5 cm (8 u.)
- Llave Allen (1 u.)
- Tornillos de 1.5 cm (4 u.)
- Tarugos 6x30 (6 u.)
- Tornillos de 4 cm (8 u.)
- Tornillos de 3 cm (8 u.)
- Tornillos de 2.5 cm (6 u.)

### 📐 Piezas y Despiece:
- Letra A: Tapa (1 u.) - Medidas: 94 x 57 cm
- Letra D: Frente (1 u.) - Medidas: 80 x 19,6 cm
- Letra E: Faja larga (1 u.) - Medidas: 80 x 8 cm
- Letra G: Faja corta (2 u.) - Medidas: 37 x 8 cm
- Letra L: Base de patas (1 u.) - Medidas: 90 x 48 cm
- Letra M: Patas (4 u.) - Medidas: 74 x 7,5 cm

### 🪜 Paso a Paso de Armado:
**Paso 1:** Paso 1: Prepare el frente D, colocando a presión 1 tarugo de 6x30 en el filo superior, de igual manera prepare la faja larga E y las fajas cortas G[cite: 13]. En el frente además atornille 2 escuadras metálicas, con los tornillos de 1,5 cm[cite: 13].
  - *Herrajes:* Tarugos 6x30, Escuadras metálicas, Tornillos de 1.5 cm

**Paso 2:** paso 2: Encastre las patas macizas, para luego ajustarlas desde arriba mediante los tornillos Allen hacia la base de las patas L[cite: 13]. A su vez coloque a presión dos tarugos guías 6x30[cite: 13].
  - *Herrajes:* Tornillos Allen 5 cm, Tarugos 6x30

**Paso 3:** paso 3: Desde abajo haga coincidir el tarugo guía de las fajas cortas G con la perforación de la base de patas y lleve las fajas hacia la misma[cite: 13]. Finalmente ajuste las fajas con las patas mediante los tornillos de 3 cm[cite: 13].
  - *Herrajes:* Tarugos 6x30, Tornillos de 3 cm

**Paso 4:** paso 4: Desde abajo haga coincidir el tarugo guía de la faja larga E y del frente D con la perforación de la base de patas y lleve las fajas hacia la misma[cite: 13]. Luego ajuste estas con las fajas cortas G mediante los tornillos de 4 cm[cite: 13]. Ajuste la faja larga y el frente a la base de patas mediante los tornillos de 4 cm[cite: 13].
  - *Herrajes:* Tarugos 6x30, Tornillos de 4 cm

**Paso 5:** paso 5: Una la base de patas L con la tapa A, a través de 6 tornillos de 2,5 cm y utilizando como guía los dos tarugos 6 x 30[cite: 13]. Finalmente por medio de los tornillos de 1,5 cm ajuste el frente a las patas por medio de las escuadras metálicas[cite: 13].
  - *Herrajes:* Tornillos de 2.5 cm, Tarugos 6x30, Tornillos de 1.5 cm, Escuadras metálicas

---

## 📦 Organizador CAPIBARA con cajones impresos (SKU: 740151)
- **Línea:** INFANTIL
- **Dificultad:** Medio | **Tiempo estimado:** 75 min
- **Herramientas necesarias:** Martillo de carpintero, Destornillador de punta en cruz, Usar regla para verificar tamaño de tornillos
- **Visor 3D Interactivo:** https://www.mueblesgacela.com.ar/armado/740151

### 🔩 Herrajes incluidos:
- Tornillos phillips 5 cm (8 u.)
- Pernos mini fix con caja (18 u.)
- Pares de guías metálicas de 30 cm (3 u.)
- Bases plásticas (8 u.)
- Tornillos varianta (12 u.)
- Tornillos de 4 cm (6 u.)
- Tornillos de 2 cm (12 u.)
- Tarugos 6x30 (22 u.)
- Set de Clavos (1 u.)

### 📐 Piezas y Despiece:
- Letra A: Tapa (1 u.) - Medidas: 120 x 34 cm
- Letra B: Costado izquierdo (1 u.) - Medidas: 42,5 x 34 cm
- Letra C: Costado derecho (1 u.) - Medidas: 42,5 x 34 cm
- Letra E: Separadores (2 u.) - Medidas: 41 x 34 cm
- Letra F: Frente cajón (3 u.) - Medidas: 37 x 37 cm
- Letra D: Piso frente (1 u.) - Medidas: 116,7 x 8,4 cm
- Letra G: Costado de cajón izquierdo (3 u.) - Medidas: 30 x 28 cm
- Letra H: Costados de cajón derecho (3 u.) - Medidas: 30 x 28 cm
- Letra -: Fajas (3 u.) - Medidas: 37,9 x 6 cm
- Letra I: Fondo de cajón (3 u.) - Medidas: 32,4 x 28 cm
- Letra -: Fondo de mueble (1 u.) - Medidas: 119,4 x 43,6 cm
- Letra -: Piso atrás (1 u.) - Medidas: 116,7 x 8,4 cm

### 🪜 Paso a Paso de Armado:
**Paso 1:** Paso 1: Prepare el costado derecho C, colocando a presión 2 cajas para mini fix y 2 bases plásticas en el filo inferior. Además mediante 2 tornillos varianta 1 guía metálica. Realizar la misma operación para el costado izquierdo B, tener en cuenta que es simétrico.
  - *Herrajes:* Pernos mini fix con caja, Bases plásticas, Tornillos varianta, Pares de guías metálicas de 30 cm

**Paso 2:** paso 2: En los separadores E, colocando a presión 1 caja para mini fix y 2 tarugos guías 6x30 en el filo superior. Además mediante 2 tornillos varianta 1 guía metálica en cada cara. En las fajas coloque a presión 4 tarugos guías 6x30 en los filos perforados.
  - *Herrajes:* Pernos mini fix con caja, Tarugos 6x30, Tornillos varianta, Pares de guías metálicas de 30 cm

**Paso 3:** Paso 3: Prepare la tapa A, atornillando 6 pernos mini fix.
  - *Herrajes:* Pernos mini fix con caja

**Paso 4:** Paso 4 Coloque 2 tarugos 6x30 en el fondo de cajón I, en los costados de cajón G-H encastre 4 cajas mini fix.
  - *Herrajes:* Tarugos 6x30, Pernos mini fix con caja

**Paso 5:** Paso 5: Seguidamente atornille 4 minifix en el frente de cajón F.
  - *Herrajes:* Pernos mini fix con caja

**Paso 6:** paso 6: Una vez armada la estructura tipo "U" entre G-I-H, ingrese el frente de cajón F ajuste los pernos mini fix girando 180 grados las cajas mini fix en sentido horario. Luego ajuste el fondo y los costados mediante los dos tornillos 4 cm.
  - *Herrajes:* Pernos mini fix con caja, Tornillos de 4 cm

**Paso 7:** Paso 7: Desde abajo introduzca el piso de cajón sobre el canal del frente de cajón F, y clave este siguiendo una escuadra correcta del cajón sobre los filos inferiores de los costados y del fondo. Finalmente atornille las guías metálicas como muestra la figura mediante 4 tornillos de 2 cm.
  - *Herrajes:* Set de Clavos, Tornillos de 2 cm, Pares de guías metálicas de 30 cm

**Paso 8:** paso 8: Ajuste el piso frente D y el piso atrás a los costados B-C y a los separadores E, a través de 8 tornillos Phillips de 5 cm como muestra la figura, verifique que el filo del piso quede hacia adelante. Previamente coloque los tarugos de las fajas en las perforaciones de los costados y los separadores. Luego desde arriba conecte la tapa A, haciendo coincidir las cajas para minifix de los costados y los separadores con los pernos mini fix de la tapa usando como guía los tarugos de los separadores. Aferre las piezas girando media vuelta en sentido horario las cajas.
  - *Herrajes:* Tornillos phillips 5 cm, Tarugos 6x30, Pernos mini fix con caja

**Paso 9:** Paso 9: Clave el fondo de 3 mm, tal como lo indica el grafico, siguiendo el orden correcto y la escuadras justa del mueble. Posteriormente distribuya los clavos a una distancia aproximada de 15 cm entre ellos, proporcionándole la rigidez necesaria. En el piso frente D y en el piso atrás, coloque a presión 4 base plástica en las perforaciones que muestra la figura. (1 vértice A-B, 2 vértice A-C, 3 vértice --B, 4 vértice --C).
  - *Herrajes:* Set de Clavos, Bases plásticas

**Paso 10:** Paso 10: Finalmente ingrese los cajones haciendo coincidir las guías, como muestra la figura.
  - *Herrajes:* Pares de guías metálicas de 30 cm
  - 💡 *Consejo Pro:* Colocación de cajones: Hacer coincidir la guía móvil en cajones con la guía fija en mueble.

---

## 📦 Biblioteca CAPIBARA con puertas impresas y estantes (SKU: 753153)
- **Línea:** INFANTIL
- **Dificultad:** Medio | **Tiempo estimado:** 45 min
- **Herramientas necesarias:** Martillo de carpintero, Destornillador de punta en cruz, Llave allen 4 mm, Usar regla para verificar tamaño de tornillos
- **Visor 3D Interactivo:** https://www.mueblesgacela.com.ar/armado/753153

### 🔩 Herrajes incluidos:
- Bisagras codo 15 cazoleta 26 (4 u.)
- Tornillos Allen 5 cm (8 u.)
- Pernos mini fix con caja (4 u.)
- Soporte de estantes (8 u.)
- Bases plásticas (4 u.)
- Tornillos de 1.5 cm (16 u.)
- Set de Clavos (1 u.)

### 📐 Piezas y Despiece:
- Letra A: Tapa (1 u.) - Medidas: 75 x 36 cm
- Letra C: Costado izquierdo (1 u.) - Medidas: 120 x 36 cm
- Letra D: Costado derecho (1 u.) - Medidas: 120 x 36 cm
- Letra B: Piso-Estante (2 u.) - Medidas: 72 x 36 cm
- Letra E: Estante móvil (2 u.) - Medidas: 72 x 36 cm
- Letra I: Puerta izquierdo (1 u.) - Medidas: 35,5 x 58,5 cm
- Letra J: Puerta derecha (1 u.) - Medidas: 35,5 x 58,5 cm
- Letra -: Fondo de mueble (2 u.) - Medidas: 120 x 37,3 cm

### 🪜 Paso a Paso de Armado:
**Paso 1:** Paso 1: Prepare el costado derecho D, colocando a presión 4 soporte de estantes y 2 cajas para mini fix, además atornillando 2 bases de bisagra mediante los tornillos de 1,5 cm y clavando en el filo inferior dos bases plásticas[cite: 13]. De igual manera prepare el costado izquierdo C, teniendo en cuenta que es simétrico[cite: 13].
  - *Herrajes:* Soporte de estantes, Pernos mini fix con caja, Tornillos de 1.5 cm, Bases plásticas

**Paso 2:** Paso 2: En las puertas I - J coloque 2 bisagra mediante los tornillos de 1,5 cm[cite: 13]. En las tapas A, atornille las 4 pernos mini fix[cite: 13].
  - *Herrajes:* Bisagras codo 15 cazoleta 26, Tornillos de 1.5 cm, Pernos mini fix con caja

**Paso 3:** Paso 3: Una los costados C-D con los estantes fijos F mediante los tornillos Allen de 5 cm[cite: 13]. Luego desde arriba introduzca los pernos mini fix de la tapa A en las perforaciones de los costados y luego gire las cajas mini fix 180° para ajustar las piezas[cite: 13].
  - *Herrajes:* Tornillos Allen 5 cm, Pernos mini fix con caja

**Paso 4:** Paso 4: Clave el fondo de 3 mm, tal como lo indica el grafico, siguiendo el orden correcto y la escuadras justa del mueble[cite: 13]. Posteriormente distribuya los clavos a una distancia aproximada de 15 cm entre ellos, proporcionándole la rigidez necesaria al mueble[cite: 13]. (1 vértice C - A, 2 vértice A medio, 3 vértice C - F, 4 vértice F medio)[cite: 13]. Realizar la misma operación con el fondo restante, previamente colocando el plástico H de unión[cite: 13]. Deslice los estantes móviles E sobre los soportes previamente colocados en los costados haciéndolo llegar hasta el fondo[cite: 13]. Coloque las puertas I - J en las bases de bisagras colocadas en los costados C-D utilizando como guía el contenido de 'Regulación y colocación de bisagra'[cite: 13].
  - *Herrajes:* Set de Clavos, Soporte de estantes, Bisagras codo 15 cazoleta 26
  - 💡 *Consejo Pro:* Colocación y regulación de bisagras: El tornillo de regulación de profundidad debe encontrarse en la mitad de su recorrido[cite: 13]. Luego ingrese la bisagra en la base de bisagra haciendo coincidir el tornillo de regulación lateral con la ranura en U de la base, y finalmente ajuste el tornillo de regulación de profundidad[cite: 13].

---

## 📦 Centro Entretenimiento KOBE LCD 55' con 2 puertas y estantes (SKU: 315250)
- **Línea:** KYOTO
- **Dificultad:** Medio | **Tiempo estimado:** 75 min
- **Herramientas necesarias:** Martillo de carpintero, Destornillador de punta en cruz, Llave Allen de 4 mm, Usar regla para verificar tamaño de tornillos
- **Visor 3D Interactivo:** https://www.mueblesgacela.com.ar/armado/315250

### 🔩 Herrajes incluidos:
- Bisagras codo 0 cazoleta 26 (4 u.)
- Tornillos Allen 5 cm (39 u.)
- Pernos mini fix con caja (16 u.)
- Soporte de estantes (2 u.)
- Tiradores botón con tornillos (2 u.)
- Tornillos de 1.5 cm (36 u.)
- Tornillos de 2,5 cm (8 u.)
- Escuadras (10 u.)
- Tornillos de 3 cm (2 u.)
- Bases plásticas (8 u.)
- Tarugos de 6x30 (18 u.)
- Set de Clavos (1 u.)

### 📐 Piezas y Despiece:
- Letra A: Tapa (1 u.) - Medidas: 180 x 40 cm
- Letra B: Piso (1 u.) - Medidas: 180 x 40 cm
- Letra C: Entre tapa (1 u.) - Medidas: 180 x 40 cm
- Letra D: Costado izquierdo (1 u.) - Medidas: 42 x 38 cm
- Letra E: Costado derecho (1 u.) - Medidas: 42 x 38 cm
- Letra F: Separador abajo (2 u.) - Medidas: 38 x 13 cm
- Letra G: Separador arriba izquierdo (1 u.) - Medidas: 112,5 x 8 cm
- Letra H: Separador arriba derecho (1 u.) - Medidas: 112,5 x 8 cm
- Letra I: Frente arriba (1 u.) - Medidas: 130 x 37,5 cm
- Letra J: Frente medio (1 u.) - Medidas: 130 x 37,5 cm
- Letra K: Frente abajo (1 u.) - Medidas: 130 x 37,5 cm
- Letra L: Fondo izquierdo (1 u.) - Medidas: 180 x 27 cm
- Letra M: Fondo derecho (1 u.) - Medidas: 180 x 27 cm
- Letra N: Estante (4 u.) - Medidas: 23 x 18 cm
- Letra O: Puerta (2 u.) - Medidas: 47,8 x 41,2 cm
- Letra P: Zócalo frente (1 u.) - Medidas: 178 x 8 cm
- Letra -: Faja unión (2 u.) - Medidas: 57,5 x 5 cm
- Letra -: Fondo de mueble (1 u.) - Medidas: 95,6 x 44,6 cm
- Letra -: Zócalo lateral (2 u.) - Medidas: 37,5 x 8 cm
- Letra -: Zócalo atrás (1 u.) - Medidas: 175 x 8 cm

### 🪜 Paso a Paso de Armado:
**Paso 1:** Paso 1: Prepare el costado Izquierdo D, colocando a presión 2 cajas para mini fix, además atornillando 2 bases de bisagra mediante los tornillos de 1,5 cm[cite: 14]. De igual manera prepare el costado derecho E, teniendo en cuenta que es simétrico[cite: 14]. En los separadores abajo F, coloque a presión 2 cajas para mini fix[cite: 14].
  - *Herrajes:* Pernos mini fix con caja, Bisagras codo 0 cazoleta 26, Tornillos de 1.5 cm

**Paso 2:** Paso 2: Prepare los zócalos laterales colocando a presión 2 tarugos, además atornille una escuadra (colocándola a borde) mediante un tornillo de 1,5 cm y clavando en el filo inferior dos bases plásticas, quedando de esta manera un zócalo lateral izquierdo[cite: 14]. Al zócalo lateral restante realice la misma operación pero clave las dos bases plásticas en el filo superior, quedando el zócalo lateral derecho[cite: 14].
  - *Herrajes:* Tarugos de 6x30, Escuadras, Tornillos de 1.5 cm, Bases plásticas

**Paso 3:** Paso 3: En el zócalo atrás coloque a presión 2 tarugos en cada canto corto y 3 en el canto superior, además atornille 2 escuadras, colocándolas a borde con los cantos cortos y 3 colocándolas a borde con el canto superior, mediante los tornillos de 1,5 cm finalmente clave en el filo inferior dos bases plásticas[cite: 14]. En el zócalo frente P solo coloque a presión 3 tarugos en el canto superior y atornille 3 escuadras a borde con el canto superior, mediante los tornillos de 1,5 cm finalmente clave en el filo inferior dos bases plásticas[cite: 14].
  - *Herrajes:* Tarugos de 6x30, Escuadras, Tornillos de 1.5 cm, Bases plásticas

**Paso 4:** Paso 4: En la entre tapa C, atornille 4 pernos mini fix en las perforaciones no pasantes[cite: 14].
  - *Herrajes:* Pernos mini fix con caja

**Paso 5:** Paso 5: Una los zócalos laterales (izquierdo y derecho) con el zócalo atrás haciendo coincidir los tarugos de este con las perforaciones de los primeros y luego fijar las piezas a través de las escuadras por medio de los tornillos de 1,5 cm[cite: 14]. De la misma manera una los zócalos laterales con el zócalo frente P[cite: 14]. Seguidamente haga coincidir los tarugos de los zócalos frente y atrás con las perforaciones del piso B y ajuste con los tornillos de 1,5 cm a través de las escuadras[cite: 14]. Por último coloque a presión los soporte de estantes en el piso que luego servirán como tope de puerta[cite: 14].
  - *Herrajes:* Tarugos de 6x30, Escuadras, Tornillos de 1.5 cm, Soporte de estantes

**Paso 6:** Paso 6: Primero, una los separadores abajo F con la entre tapa C, desde abajo mediante los tornillos Allen de 5 cm[cite: 14]. Segundo, desde arriba introduzca los pernos mini fix de la entre tapa en las perforaciones de los costados D-E y luego gire las cajas mini fix 180° para ajustar las piezas[cite: 14]. Tercero, desde abajo una el piso B (ya armado con los zócalos) a los costados por medio de los tornillos Allen de 5 cm[cite: 14]. Finalmente clave el fondo de 3 mm, tal como lo indica el gráfico, siguiendo el orden correcto y las escuadras justas del mueble[cite: 14]. Posteriormente distribuya los clavos a una distancia aproximada de 15 cm entre ellos, proporcionándole la rigidez necesaria al mueble[cite: 14]. (1 vértice B - D, 2 vértice B - E, 3 vértice C - D, 4 vértice C - E)[cite: 14].
  - *Herrajes:* Tornillos Allen 5 cm, Pernos mini fix con caja, Set de Clavos

**Paso 7:** Paso 7: Prepare los estantes N, colocando a presión un tarugo en la perforación que indica la imagen[cite: 14].
  - *Herrajes:* Tarugos de 6x30

**Paso 8:** Paso 8: En los separadores arriba izquierdo y derecho, coloque a presión 4 cajas para mini fix a cada uno[cite: 14]. En las puertas O coloque 2 bisagras mediante los tornillos de 1,5 cm, y en la cara contraria el tirador botón, ajustando desde atrás por medio de los tornillos[cite: 14]. Como muestra la figura nos queda una puerta derecha, la restante para que nos quede izquierda colocar en la otra perforación el tirador botón[cite: 14].
  - *Herrajes:* Pernos mini fix con caja, Bisagras codo 0 cazoleta 26, Tornillos de 1.5 cm, Tiradores botón con tornillos

**Paso 9:** Paso 9: En el frente arriba I atornille 4 pernos mini fix[cite: 14]. En el frente abajo K 2 pernos mini fix[cite: 14]. Y en el frente medio J coloque 2 pernos mini fix[cite: 14]. En la tapa A, atornille 4 pernos mini fix en las perforaciones no pasantes[cite: 14].
  - *Herrajes:* Pernos mini fix con caja

**Paso 10:** Paso 10: Coloque el frente arriba I, el frente medio J y el frente abajo K en orden y boca abajo, quedando los pernos mini fix hacia arriba, seguidamente introduzca los pernos mini fix de los frentes en las perforaciones de los separadores arriba G-H y luego gire las cajas mini fix 180° para ajustar las piezas[cite: 14]. Luego ajuste las piezas a través de las fajas de unión y por medio de 8 tornillos de 2,5 cm usando como referencia para su ubicación las marcas de los frentes arriba y abajo, centrando las fajas[cite: 14].
  - *Herrajes:* Pernos mini fix con caja, Tornillos de 2,5 cm

**Paso 11:** Paso 11: Coloque el panel en forma vertical e invertido[cite: 14]. Primero, una los fondos L-M a los separadores arriba G-H, mediante los tornillos Allen de 5 cm[cite: 14]. Segundo, desde arriba con los mismos tornillos una la tapa A (en forma invertida con los pernos hacia arriba) a el frente abajo K, y seguidamente a los fondos[cite: 14]. Tercero, por medio de los tornillos Allen de 5 cm y usando como guía el tarugo colocado en los estantes N vincule estos a los fondos y a los separadores[cite: 14].
  - *Herrajes:* Tornillos Allen 5 cm, Tarugos de 6x30

**Paso 12:** Paso 12: Gire el panel ya armado e introduzca los pernos mini fix de la tapa A en las perforaciones de los separadores abajo F, y luego gire las cajas mini fix 180° para ajustar las piezas[cite: 14]. Luego desde atrás y por medio de los tornillos Allen de 5 cm vincule los fondos L-M al piso B y a la entre tapa C[cite: 14]. Finalmente coloque las puertas O ya hechas izquierda y derecha en las bases de bisagras colocadas en los costados D-E utilizando como guía el contenido de 'Regulación y colocación de bisagra'[cite: 14].
  - *Herrajes:* Pernos mini fix con caja, Tornillos Allen 5 cm, Bisagras codo 0 cazoleta 26
  - 💡 *Consejo Pro:* Colocación y regulación de bisagras: El tornillo de regulación de profundidad debe encontrarse en la mitad de su recorrido[cite: 14]. Luego ingrese la bisagra en la base haciendo coincidir el tornillo de regulación lateral con la ranura en U y finalmente ajuste el tornillo de profundidad[cite: 14].

---

## 📦 Centro Entretenimiento SAPPORO para LCD 55' con puerta corrediza (SKU: 315251)
- **Línea:** KYOTO
- **Dificultad:** Alto | **Tiempo estimado:** 135 min
- **Herramientas necesarias:** Martillo de carpintero, Destornillador de punta en cruz, 1 Llave allen, Cinta metrica, Usar regla para verificar tamaño de tornillos
- **Visor 3D Interactivo:** https://www.mueblesgacela.com.ar/armado/315251

### 🔩 Herrajes incluidos:
- Tornillos allen 5 cm (20 u.)
- Soporte de estantes (8 u.)
- Bases plásticas (6 u.)
- Tarugos 6x30 (22 u.)
- Set de Clavos (1 u.)
- Pernos mini fix con caja (24 u.)
- Escuadras plásticas (2 u.)
- Tornillos de 1.5 cm (28 u.)
- guía inferior (1 u.)
- guía superiores (1 u.)
- Carros inferiores (2 u.)
- Trabas (2 u.)
- Clips (2 u.)

### 📐 Piezas y Despiece:
- Letra A: Tapa (1 u.) - Medidas: 150 x 40 cm
- Letra B: Piso (1 u.) - Medidas: 150 x 40 cm
- Letra E: Sobre tapa (1 u.) - Medidas: 136 x 29 cm
- Letra C: Costado izquierdo (1 u.) - Medidas: 47 x 40 cm
- Letra D: Costado derecho (1 u.) - Medidas: 47 x 40 cm
- Letra F: Estante (1 u.) - Medidas: 136 x 14 cm
- Letra G: Separador arriba (2 u.) - Medidas: 12 x 24 cm
- Letra H: Separador abajo (1 u.) - Medidas: 47 x 36 cm
- Letra N: Puerta (1 u.) - Medidas: 46 x 74 cm
- Letra M: Estante móvil (2 u.) - Medidas: 72,7 x 35 cm
- Letra -: Zócalo frente (2 u.) - Medidas: 136,5 x 8 cm
- Letra O: Zócalo lateral (2 u.) - Medidas: 33,6 x 8 cm
- Letra -: Fondo mueble (1 u.) - Medidas: 149,5 x 49,5 cm
- Letra -: Parantes fondo (4 u.) - Medidas: 122 x 6 cm
- Letra K: Frente izquierdo (1 u.) - Medidas: 61 x 75 cm
- Letra L: Frente derecho (1 u.) - Medidas: 61 x 75 cm
- Letra I: Frente ripiado izquierdo (1 u.) - Medidas: 61 x 75 cm
- Letra J: Frente ripiado derecho (1 u.) - Medidas: 61 x 75 cm

### 🪜 Paso a Paso de Armado:
**Paso 1:** Paso 1: Prepare el costado derecho D, colocando a presión dos cajas para mini fix como lo indica la figura y 2 soporte de estantes. Realice el mismo procedimiento para el costado izquierdo C, tenga en cuenta que es simétrico, y para el separador abajo H tenga en cuenta de colocar soporte de estantes en las dos caras.
  - *Herrajes:* Pernos mini fix con caja, Soporte de estantes

**Paso 2:** Paso 2: En los separadores arriba G coloque a presión una cajas para mini fix y 4 tarugos guías de 3 cm.
  - *Herrajes:* Pernos mini fix con caja, Tarugos 6x30

**Paso 3:** Paso 3: En los frentes I - J - K - L atornillar en las perforaciones no pasantes 4 pernos mini fix.
  - *Herrajes:* Pernos mini fix con caja

**Paso 4:** Paso 4: En los zócalos laterales O, colocar a presión 1 tarugo en el canto superior, además clavar en el canto inferior dos bases plásticas posicionándola a 2 cm de los bordes.
  - *Herrajes:* Tarugos 6x30, Bases plásticas

**Paso 5:** Paso 5: En los zócalos frentes, colocar a presión 4 tarugos en los cantos cortos y 2 en el canto superior, además clavar en el canto inferior una base plástica posicionándola en forma centrada y por último por medio de 3 tornillos de 1,5 cm coloque 3 escuadra plástica en las posiciones que muestra la figura.
  - *Herrajes:* Tarugos 6x30, Bases plásticas, Tornillos de 1.5 cm, Escuadras plásticas

**Paso 6:** Paso 6: En la sobre tapa E atornillamos 2 pernos mini fix en las perforaciones que muestra la figura.
  - *Herrajes:* Pernos mini fix con caja

**Paso 7:** Paso 7: En la puerta N introduzca el perno del carro inferior en la perforación grande y luego atorníllelo mediante 2 tornillos 1,5 cm, el carro debe quedar horizontal, haga lo mismo para el carro restante. Luego coloque los clips en las marcas superiores con 4 tornillos 1,5.
  - *Herrajes:* Carros inferiores, Tornillos de 1.5 cm, Clips

**Paso 8:** Paso 8: A la tapa A cerca del canto melaminico, colocamos un riel superior (a las medidas que muestra la figura) mediante 3 tornillos de 1,5 cm en las perforaciones que tienen estos, centrándolos en el ancho, dejando aproximadamente 2 cm por lado y desde abajo atornillamos 4 pernos mini fix.
  - *Herrajes:* guía superiores, Tornillos de 1.5 cm, Pernos mini fix con caja

**Paso 4:** Paso 9: Al piso B en la cara que contiene solo las perforaciones pasante colocamos un riel inferior (a las medidas que muestra la figura) mediante 3 tornillos de 1,5 cm en las perforaciones que tienen estos, centrándolos en el ancho, dejando aproximadamente 2 cm por lado.
  - *Herrajes:* guía inferior, Tornillos de 1.5 cm

**Paso 10:** Paso 10: En los parantes fondos colocar 4 cajas para mini fix. Una el frente izquierdo K, el frente ripiado derecho J, el frente ripiado izquierdo I y el frente derecho L con los parantes fondo haciendo coincidir los pernos mini fix de los primeros con las perforaciones con las cajas mini fix de los segundos; ajuste las piezas haciendo girar las cajas mini fix media vuelta en sentido horario. Por último una el estante F a los frentes I - L por medio de los tornillos Allen de 5 cm.
  - *Herrajes:* Pernos mini fix con caja, Tornillos allen 5 cm

**Paso 11:** Paso 11: Una el frente izquierdo K y el frente ripiado derecho J, con la sobre tapa E por medio de los tornillos Allen de 5 cm. Luego los separadores arriba G por medio del sistema mini fix unir a la sobre tapa E usando como guía los tarugos de los separadores. Desde abajo unir la tapa A con los separadores arriba por medio de los tornillos Allen de 5 cm usando como guía los tarugos de estos. Y finalmente unir la tapa a los parantes fondos por medio de tornillos Allen de 5 cm.
  - *Herrajes:* Tornillos allen 5 cm, Pernos mini fix con caja, Tarugos 6x30

**Paso 12:** Paso 12: Una el separador abajo H con el piso B por medio de los tornillos Allen de 5 cm. Arme un cajón haciendo coincidir los tarugos de los zócalos frente con las perforaciones de los zócalos laterales O y luego uniendo las piezas con los tornillos de 1,5 cm a través de las escuadras plásticas. Una vez armado el cajón hacer coincidir los tarugos de los zócalos frente y de los zócalos laterales con las perforaciones del piso y unir el cajón al piso mediante 2 tornillos de 1,5 cm a través de las escuadras plásticas.
  - *Herrajes:* Tornillos allen 5 cm, Tarugos 6x30, Tornillos de 1.5 cm, Escuadras plásticas

**Paso 13:** Paso 13: Una los costados C y D a la tapa A, haciendo coincidir los pernos mini fix de la tapa con las perforaciones con las cajas mini fix de los costados; ajuste las piezas haciendo girar las cajas mini fix media vuelta en sentido horario. Luego una el separador abajo H con la tapa A de igual manera y finalmente desde abajo una el piso B a los costados por medio de los tornillos Allen de 5 cm. Clave el fondo de mueble, tal como lo indica el grafico, siguiendo el orden correcto y la escuadras justa del mueble. Posteriormente distribuya los clavos a una distancia aproximada de 15 cm entre ellos, proporcionándole la rigidez necesaria al mueble. 1 vértice C-A, 2 vértice D-A, 3 vértice C-B, 4 vértice D-B. Finalmente introduzca los estantes móviles M sobre los soportes de estantes.
  - *Herrajes:* Pernos mini fix con caja, Tornillos allen 5 cm, Set de Clavos, Soporte de estantes

**Paso 14:** Paso 14: SOLO CUANDO SE COLOQUE LA PUERTA coloque la traba deslizando sobre el clip como muestra la figura hasta que la media esfera entre en el circulo de la traba.
  - *Herrajes:* Trabas, Clips

**Paso 15:** Paso 15: Finalmente coloque la traba en los clips fijos quedando la guía superior completa corriendo en el riel superior.
  - *Herrajes:* Trabas, Clips, guía superiores

---

## 📦 Biblioteca KANAZAWA con puerta de abrir y estantes (SKU: 322250)
- **Línea:** KYOTO
- **Dificultad:** Medio | **Tiempo estimado:** 90 min
- **Herramientas necesarias:** Martillo de carpintero, Destornillador de punta en cruz, Llave allen 4 mm, Usar regla para verificar tamaño de tornillos
- **Visor 3D Interactivo:** https://www.mueblesgacela.com.ar/armado/322250

### 🔩 Herrajes incluidos:
- Bisagras codo 15 cazoleta 26 (3 u.)
- Soporte de estantes (8 u.)
- Tornillos de 1.5 cm (12 u.)
- Set de Clavos (1 u.)
- Tornillos Allen 5 cm (28 u.)
- Tarugos 6x30 (48 u.)
- Bases plásticas (6 u.)

### 📐 Piezas y Despiece:
- Letra A: Tapa (1 u.) - Medidas: 90 x 31,5 cm
- Letra -: Fondo de mueble (1 u.) - Medidas: 159,5 x 30 cm
- Letra C: Costado izquierdo (1 u.) - Medidas: 157,3 x 31,5 cm
- Letra D: Costado derecho (1 u.) - Medidas: 157,3 x 31,5 cm
- Letra B: Piso (1 u.) - Medidas: 90 x 31,5 cm
- Letra E: Separador (1 u.) - Medidas: 157,3 x 29,5 cm
- Letra F: Puerta (1 u.) - Medidas: 156,7 x 290 cm
- Letra G: Estante fijo chico (1 u.) - Medidas: 27,4 x 29,5 cm
- Letra H: Estante móvil (2 u.) - Medidas: 27,4 x 29,5 cm
- Letra I: Estante fijo arriba abajo (2 u.) - Medidas: 58 x 29,5 cm
- Letra J: Estante fijo centro (1 u.) - Medidas: 58 x 29,5 cm
- Letra K: Separador chico (4 u.) - Medidas: 38,2 x 29,5 cm
- Letra L: Fondo ripiado (4 u.) - Medidas: 38,2 x 14 cm

### 🪜 Paso a Paso de Armado:
**Paso 1:** Paso 1: Prepare el costado izquierdo C, colocando a presión 4 soporte de estantes y atornillando 3 bases de bisagra mediante los tornillos de 1,5 cm. En el separador E solo coloque los 4 soporte de estantes.
  - *Herrajes:* Soporte de estantes, Tornillos de 1.5 cm

**Paso 2:** Paso 2: En la puerta F coloque 3 bisagras mediante los tornillos de 1,5 cm.
  - *Herrajes:* Bisagras codo 15 cazoleta 26, Tornillos de 1.5 cm

**Paso 3:** Paso 3: Prepare los estantes fijos arriba y abajo I, colocando a presión 4 tarugos en los cantos y en las perforaciones extremas. De igual manera prepare el estante fijo centro J, el estante fijo chico G y los separadores chicos K. En los fondos ripiados L coloque a presión 4 tarugos en las perforaciones de los cantos.
  - *Herrajes:* Tarugos 6x30

**Paso 4:** Paso 4: Mediante los tornillos Allen de 5 cm, una el estante fijo centro J con los separadores chicos K usando los tarugos como guía. Repita el proceso con los estantes fijos arriba abajo I, previamente haciendo coincidir los tarugos guías en las perforaciones de los fondos ripiados L.
  - *Herrajes:* Tornillos Allen 5 cm, Tarugos 6x30

**Paso 5:** Paso 5: Mediante los tornillos Allen de 5 cm, una el estante fijo centro J y los estantes fijos arriba abajo I con el separador E y el costado derecho D usando los tarugos como guía (dejar el sobresaliente del costado hacia adelante). Repita el proceso con el estante fijo chico G, el costado izquierdo C y el separador E (dejar el sobresaliente del costado hacia adelante).
  - *Herrajes:* Tornillos Allen 5 cm, Tarugos 6x30

**Paso 6:** Paso 6: Desde arriba y por medio de los tornillos Allen de 5 cm, una la tapa A al costado izquierdo C, al costado derecho D, al separador E y al separador chico K previamente haciendo coincidir los tarugos guías de estos y de los fondos L en las perforaciones de la tapa. Repita el proceso pero desde abajo y con el piso B. Clave el fondo de mueble, tal como lo indica el gráfico, siguiendo el orden correcto y las escuadras justas del mueble. Posteriormente distribuya los clavos a una distancia aproximada de 15 cm entre ellos, proporcionándole la rigidez necesaria al mueble. (1 vértice C - A, 2 vértice E - A, 3 vértice C - B, 4 vértice E - B). Por último introduzca los estantes móviles H apoyándolos en los soportes de estantes colocados en el costado izquierdo y el separador.
  - *Herrajes:* Tornillos Allen 5 cm, Tarugos 6x30, Set de Clavos, Soporte de estantes

**Paso 7:** Paso 7: Desde abajo y en las perforaciones grandes del piso B incrustar las bases plásticas. Finalmente coloque la puerta F en las bases de bisagras colocadas en el costado izquierdo C utilizando como guía el contenido de 'Regulación y colocación de bisagra'.
  - *Herrajes:* Bases plásticas, Bisagras codo 15 cazoleta 26
  - 💡 *Consejo Pro:* Colocación y regulación de bisagras: El tornillo de regulación de profundidad debe encontrarse en la mitad de su recorrido. Luego ingrese la bisagra en la base haciendo coincidir el tornillo de regulación lateral con la ranura en U y finalmente ajuste el tornillo de profundidad.

---

## 📦 Mesa de Centro OSAKA con cajón (SKU: 326250)
- **Línea:** KYOTO
- **Dificultad:** Medio | **Tiempo estimado:** 45 min
- **Herramientas necesarias:** Martillo de carpintero, Destornillador de punta en cruz, 1 Llave Allen, Usar regla para verificar tamaño de tornillos
- **Visor 3D Interactivo:** https://www.mueblesgacela.com.ar/armado/326250

### 🔩 Herrajes incluidos:
- Envase de cola (1 u.)
- Tornillos Allen de 5 cm (14 u.)
- Par de guías metálicas de 40 cm (1 u.)
- Tornillos de 4 cm (2 u.)
- Set de Clavos (1 u.)
- Tornillos varianta (4 u.)
- Tornillos de 2,5 cm (6 u.)
- Tarugos 6x30 (11 u.)
- Pernos mini fix con caja (8 u.)
- Tornillos de 2 cm (4 u.)

### 📐 Piezas y Despiece:
- Letra A: Tapa (1 u.) - Medidas: 120 x 58 cm
- Letra B: Piso (1 u.) - Medidas: 120 x 58 cm
- Letra K: Base de patas (1 u.) - Medidas: 100 x 48 cm
- Letra C: Costado izquierdo (1 u.) - Medidas: 58 x 16,5 cm
- Letra D: Costado derecho (1 u.) - Medidas: 58 x 16,5 cm
- Letra E: Separador (1 u.) - Medidas: 56 x 16,5 cm
- Letra H: Frente cajón (1 u.) - Medidas: 46,2 x 15,7 cm
- Letra G: Costado cajón (2 u.) - Medidas: 40 x 10 cm
- Letra I: Fondo cajón (1 u.) - Medidas: 39 x 10 cm
- Letra -: Fondo (1 u.) - Medidas: 44,5 x 16,5 cm
- Letra -: Patas (4 u.) - Medidas: 19 x 7,5 cm
- Letra -: Piso cajón (1 u.) - Medidas: 41,7 x 37,8 cm

### 🪜 Paso a Paso de Armado:
**Paso 1:** Paso 1: Prepare el costado izquierdo C, colocando a presión dos cajas para mini fix y la guía metálica mediante los tornillos varianta[cite: 16]. Realice la misma operación con el separador, teniendo en cuenta que es simétrico[cite: 16].
  - *Herrajes:* Pernos mini fix con caja, Tornillos varianta, Par de guías metálicas de 40 cm

**Paso 2:** Paso 2: En el fondo coloque a presión 3 tarugos 6x30[cite: 16]. Y en el costado derecho D 2 cajas para mini fix[cite: 16]. En la tapa A atornille 6 pernos mini fix[cite: 16].
  - *Herrajes:* Tarugos 6x30, Pernos mini fix con caja

**Paso 3:** Paso 3: Unir los costados C - D y el separadores E a la tapa A introduciendo los pernos minifix de esta en las perforaciones con caja minifix de los primeros mencionados[cite: 16]. Luego ajuste las piezas girando 180 grados en sentido horario las cajas mini fix[cite: 16]. Encastre el tarugo del fondo en la perforación libre de la tapa, y luego desde abajo los dos tarugos con el piso B[cite: 16]. Por ultimo desde abajo ajuste por medio de 6 tornillos Allen de 5 cm el piso los costados y al separador[cite: 16].
  - *Herrajes:* Pernos mini fix con caja, Tarugos 6x30, Tornillos Allen de 5 cm

**Paso 4:** Paso 4 Armado de cajones: Coloque 2 tarugos 6x30 en el fondo de cajón I, 2 mas en cada uno de los costados de cajón G a su vez encastrar las cajas mini fix[cite: 16]. Agregar adhesivo en cada perforación donde lleve tarugo[cite: 16].
  - *Herrajes:* Tarugos 6x30, Pernos mini fix con caja, Envase de cola

**Paso 5:** Paso 5 armado de cajones: Atornille 2 pernos minifix en el frente de cajón H[cite: 16].
  - *Herrajes:* Pernos mini fix con caja

**Paso 6:** Paso 6 armado de cajones: Una vez armada la estructura tipo 'U' entre G-I-G, ingrese el frente de cajón H ajuste los pernos mini fix girando 180 grados las cajas mini fix[cite: 16]. Habiendo agregado el adhesivo anteriormente[cite: 16]. Luego ajuste el fondo y los costados mediante los dos tornillos 4 cm[cite: 16].
  - *Herrajes:* Pernos mini fix con caja, Envase de cola, Tornillos de 4 cm

**Paso 7:** Paso 7 Armado de cajones: Desde abajo introduzca el piso de cajón sobre el canal del frente de cajón H, y clave este siguiendo una escuadra correcta del cajón sobre los filos inferiores de los costados y del fondo[cite: 16]. Finalmente atornille las guías metálicas como muestra la figura mediante 4 tornillos de 2 cm[cite: 16].
  - *Herrajes:* Set de Clavos, Tornillos de 2 cm, Par de guías metálicas de 40 cm

**Paso 8:** Paso 8: Encastre las patas macizas, para luego ajustarlas desde arriba mediante los tornillos Allen de 5 cm hacia la base de las patas K[cite: 16]. A su vez coloque a presión dos tarugos guías 6x30[cite: 16].
  - *Herrajes:* Tornillos Allen de 5 cm, Tarugos 6x30

**Paso 9:** Paso 9: Una vez armado la base de patas K con las patas macizas, ajuste este hacia el piso B, a través de los 6 tornillos de 2,5 cm y utilizando como guía las perforaciones donde van los dos tarugos 6x30[cite: 16].
  - *Herrajes:* Tornillos de 2,5 cm, Tarugos 6x30

**Paso 10:** Paso 10: Finalmente ingrese el cajón haciendo coincidir las guías, como muestra la figura[cite: 16]. Colocar los cajones sobre las guías fijas que se encuentran ya en el mueble, como lo muestra la imagen[cite: 16].
  - *Herrajes:* Par de guías metálicas de 40 cm
  - 💡 *Consejo Pro:* Colocación de cajones: Colocar los cajones sobre las guías fijas que se encuentran ya en el mueble, asegurando que la rueda de la guía móvil calce correctamente sobre la guía fija[cite: 16].

---

## 📦 Mesa de centro oval NARA (SKU: 331250)
- **Línea:** KYOTO
- **Dificultad:** Bajo | **Tiempo estimado:** 30 min
- **Herramientas necesarias:** Martillo de carpintero, Destornillador de punta en cruz, Llave allen 4 mm, Usar regla para verificar tamaño de tornillos
- **Visor 3D Interactivo:** https://www.mueblesgacela.com.ar/armado/331250

### 🔩 Herrajes incluidos:
- Tornillos Allen de 5 cm (12 u.)
- Tarugos 6 x 30 (4 u.)
- Tornillos de 2 cm (10 u.)
- Bases redondas para clavar (4 u.)

### 📐 Piezas y Despiece:
- Letra A: Tapa (1 u.) - Medidas: 119 x 59 cm
- Letra B: Estante (1 u.) - Medidas: 80 x 32 cm
- Letra -: Patas (4 u.) - Medidas: 41 x 7,5 cm
- Letra -: Base de patas (2 u.) - Medidas: 37 x 18 cm

### 🪜 Paso a Paso de Armado:
**Paso 1:** Paso 1: Coloque dos tarugos guía de 6x30 en las perforaciones que muestra la imagen en la base de patas, luego atornille 2 patas con los tornillos Allen de 5 cm[cite: 16]. Realice el mismo procedimiento para las patas y la base de patas restante[cite: 16].
  - *Herrajes:* Tarugos 6 x 30, Tornillos Allen de 5 cm

**Paso 2:** Paso 2: Usando como guía los tarugos de 6x30, presente la base de patas a la tapa A luego atornille la base con la tapa con los tornillos de 2 cm[cite: 16]. Los tarugos solo sirven de guía y sobresalen hacia abajo (no golpear)[cite: 16]. Repita el proceso con la base de pata ya armada restante[cite: 16]. Por medio de los tornillos Allen de 5 cm una el estante B con las 4 patas dejando la cara ripiada hacia arriba[cite: 16]. Finalmente clave las bases en las patas[cite: 16].
  - *Herrajes:* Tarugos 6 x 30, Tornillos de 2 cm, Tornillos Allen de 5 cm, Bases redondas para clavar

---

## 📦 Escritorio NIKKO con cajón y estante (SKU: 334250)
- **Línea:** KYOTO
- **Dificultad:** Medio | **Tiempo estimado:** 60 min
- **Herramientas necesarias:** Martillo de carpintero, Destornillador de punta en cruz, 1 Llave Allen, Usar regla para verificar tamaño de tornillos
- **Visor 3D Interactivo:** https://www.mueblesgacela.com.ar/armado/334250

### 🔩 Herrajes incluidos:
- Envase de cola (1 u.)
- Tornillos Allen de 5 cm (14 u.)
- Par de guías metálicas de 35 cm (1 u.)
- Tornillos de 4 cm (2 u.)
- Set de Clavos (1 u.)
- Tornillos varianta (4 u.)
- Tornillos de 2,5 cm (8 u.)
- Tarugos 6x30 (22 u.)
- Pernos mini fix con caja (12 u.)
- Tornillos de 2 cm (4 u.)

### 📐 Piezas y Despiece:
- Letra A: Tapa (1 u.) - Medidas: 100 x 44,5 cm
- Letra B: Piso (1 u.) - Medidas: 100 x 44,5 cm
- Letra K: Base de patas (2 u.) - Medidas: 39 x 18 cm
- Letra C: Costado izquierdo (1 u.) - Medidas: 44,5 x 12,6 cm
- Letra D: Costado derecho (1 u.) - Medidas: 44,5 x 12,6 cm
- Letra E: Separador (1 u.) - Medidas: 40,5 x 12,6 cm
- Letra H: Frente cajón (1 u.) - Medidas: 35 x 12 cm
- Letra G: Costado cajón (2 u.) - Medidas: 35 x 8 cm
- Letra I: Fondo cajón (1 u.) - Medidas: 28 x 8 cm
- Letra M: Fondo (1 u.) - Medidas: 33,6 x 12,6 cm
- Letra L: Refuerzo de patas (2 u.) - Medidas: 29,8 x 10 cm
- Letra N: Pata izquierda (2 u.) - Medidas: 59 x 7,5 cm
- Letra O: Pata derecha (2 u.) - Medidas: 59 x 7,5 cm
- Letra -: Piso cajón (1 u.) - Medidas: 32,8 x 31 cm

### 🪜 Paso a Paso de Armado:
**Paso 1:** Paso 1: Prepare el costado derecho D, colocando a presión 2 caja mini fix y atornille mediante 2 tornillos varianta la guía metálica derecha[cite: 16]. Realice esta misma operación para el separador E, pero con la guía metálica izquierda[cite: 16]. En el costado izquierdo C, solo coloque a presión 2 caja mini fix[cite: 16].
  - *Herrajes:* Pernos mini fix con caja, Tornillos varianta, Par de guías metálicas de 35 cm

**Paso 2:** Paso 2: En el fondo M, coloque a presión 4 tarugos 6x30[cite: 16]. En la tapa A atornille 6 mini fix[cite: 16].
  - *Herrajes:* Tarugos 6x30, Pernos mini fix con caja

**Paso 3:** Paso 3: Haga coincidir las cajas para minifix de los costados C-D y del separador E con los pernos mini fix de la tapa A, luego gire media vuelta en sentido horario las cajas, para ajustar dichas piezas, previamente haga coincidir los tarugos del fondo M con las perforación libres del costado derecho y del separador[cite: 16]. Luego desde abajo ajuste el piso B por medio de 6 tornillos Allen de 5 cm a las piezas nombradas[cite: 16].
  - *Herrajes:* Pernos mini fix con caja, Tarugos 6x30, Tornillos Allen de 5 cm

**Paso 4:** Paso 4 Armado de cajon: Coloque 2 tarugos 6x30 en el fondo de cajón I, 2 mas en cada uno de los costados de cajón G a su vez encastrar las cajas mini fix[cite: 16]. Agregar adhesivo en cada perforación donde lleve tarugo[cite: 16].
  - *Herrajes:* Tarugos 6x30, Pernos mini fix con caja, Envase de cola

**Paso 5:** Paso 5 armado de cajon: En el frente de cajón atornille dos pernos mini fix en las perforación que indica la figura para que sea derecho[cite: 16]. Si lo requiere izquierdo atornille los pernos en la perforación adyacente[cite: 16].
  - *Herrajes:* Pernos mini fix con caja

**Paso 6:** Paso 6: Una vez armada la estructura tipo "U" entre G-I-G, agregue adhesivo en los tarugos y haga coincidir las cajas para minifix de los costados con los pernos mini fix del frente de cajón H, ajuste las piezas girando media vuelta en sentido horario las cajas mini fix y el fondo con los costados mediante 2 tornillos de 4 cm[cite: 16].
  - *Herrajes:* Envase de cola, Pernos mini fix con caja, Tornillos de 4 cm

**Paso 7:** Paso 7: Finalmente ingrese el piso de cajón en el canal del frente de cajón y clávelo desde abajo a los costados y el fondo[cite: 16]. Atornille las guías metálicas sobre los cantos inferiores de los costados de cajón G, mediante 4 tornillos de 2 cm[cite: 16].
  - *Herrajes:* Set de Clavos, Par de guías metálicas de 35 cm, Tornillos de 2 cm

**Paso 8:** Paso 8: Prepare los Refuerzos de patas L, colocando a presión 4 tarugos guías 6x30 y dos cajas minifix, como así también las patas N-O atornillando un minifix por cada una[cite: 16]. Una las tres piezas introduciendo los pernos minifix de las patas en las perforaciones con caja minifix de los refuerzos de patas utilizando los tarugos como guía, luego ajuste las piezas girando 180 grados en sentido horario las cajas mini fix[cite: 16].
  - *Herrajes:* Tarugos 6x30, Pernos mini fix con caja

**Paso 9:** Paso 9: Encastre las patas macizas NO, para luego ajustarlas desde arriba mediante los tornillos Allen de 5 cm hacia la base de las patas K[cite: 16]. A su vez coloque a presión dos tarugos guías 6x30[cite: 16]. Repetir el proceso para el otro juego de patas y base de patas[cite: 16].
  - *Herrajes:* Tornillos Allen de 5 cm, Tarugos 6x30

**Paso 10:** Paso 10: Una vez armado las bases de patas K con las patas macizas, ajuste estas hacia el piso B, a través de los 8 tornillos de 2,5 cm y utilizando como guía las perforaciones del piso donde van los tarugos 6x30 colocados en las bases (los cuales solo sirven de guía no golpear!)[cite: 16].
  - *Herrajes:* Tornillos de 2,5 cm, Tarugos 6x30

**Paso 11:** Paso 11: Finalmente ingrese los cajones haciendo coincidir las guías que se encuentran en el costado derecho D y el separador E con las de los cajones, como muestra la figura[cite: 16].
  - *Herrajes:* Par de guías metálicas de 35 cm

**Paso 12:** Paso 12: Colocar los cajones sobre las guías fijas que se encuentran ya en el mueble, como lo muestra la imagen[cite: 16].
  - *Herrajes:* Par de guías metálicas de 35 cm
  - 💡 *Consejo Pro:* Colocación de cajones: Colocar los cajones sobre las guías fijas que se encuentran ya en el mueble, como lo muestra la imagen[cite: 16].

---

## 📦 Torre Biblioteca TAKAYAMA con puerta y estantes (SKU: 353250)
- **Línea:** KYOTO
- **Dificultad:** Medio | **Tiempo estimado:** 45 min
- **Herramientas necesarias:** Martillo de carpintero, Destornillador de punta en cruz, 1 Llave Allen, Usar regla para verificar tamaño de tornillos
- **Visor 3D Interactivo:** https://www.mueblesgacela.com.ar/armado/353250

### 🔩 Herrajes incluidos:
- Bisagras codo 15 cazoleta 26 (2 u.)
- Tornillos Allen o Phillips de 5 cm (12 u.)
- Pernos mini fix con caja (6 u.)
- Tornillos de 2.5 cm (4 u.)
- Soportes de estantes (4 u.)
- Tarugos 6x30 (6 u.)
- Tornillos de 1.5 cm (8 u.)
- Set de Clavos (1 u.)

### 📐 Piezas y Despiece:
- Letra A: Tapa (1 u.) - Medidas: 39 x 29,5 cm
- Letra B: Piso (1 u.) - Medidas: 39 x 29,5 cm
- Letra C: Costado izquierdo (1 u.) - Medidas: 109,5 x 29,5 cm
- Letra H: Base patas (1 u.) - Medidas: 34 x 29 cm
- Letra -: Fondo mueble (1 u.) - Medidas: 38,6 x 38,6 cm
- Letra -: Patas macizas (4 u.) - Medidas: 12 x 7,5 cm
- Letra D: Costado derecho (1 u.) - Medidas: 109,5 x 29,5 cm
- Letra E: Estante fijo (1 u.) - Medidas: 36 x 27,5 cm
- Letra F: Estante móvil (1 u.) - Medidas: 36 x 27,5 cm
- Letra G: Puerta (1 u.) - Medidas: 37,6 x 35,3 cm

### 🪜 Paso a Paso de Armado:
**Paso 1:** Paso 1: Prepare el costado derecho D, colocando 2 bases de bisagra mediante los tornillos de 1,5 cm, atornille un perno mini fix, a presión coloque 2 soporte de estantes y 2 caja mini fix[cite: 17]. Realice el mismo procedimiento para el costado izquierdo C, pero sin las bases de bisagras[cite: 17]. De esta manera queda una puerta derecha, si quiere que sea izquierda coloque las bisagras en el costado izquierdo y no en el derecho[cite: 17].
  - *Herrajes:* Tornillos de 1.5 cm, Pernos mini fix con caja, Soportes de estantes

**Paso 2:** Paso 2: En el estante fijo E coloque a presión 2 cajas mini fix y 4 tarugos 6x30 en los filos[cite: 17].
  - *Herrajes:* Pernos mini fix con caja, Tarugos 6x30

**Paso 3:** Paso 3: En las puerta G coloque 2 bisagra mediante los tornillos de 1.5. En la tapa A atornille 4 pernos mini fix[cite: 17].
  - *Herrajes:* Bisagras codo 15 cazoleta 26, Tornillos de 1.5 cm, Pernos mini fix con caja

**Paso 4:** Paso 4: Haga encastrar los pernos mini fix que se encuentran en los costados C-D con las perforaciones de las cajas mini fix estante fijo E usando como guía los tarugos guías, y luego para ajustar las piezas gire las caja mini fix media vuelta en sentido horario[cite: 17]. De igual manera encastre los pernos mini fix que se encuentran en la tapa A con las perforaciones superiores de los costados, luego ajuste las piezas[cite: 17]. Desde abajo ajuste el piso B mediante 4 tornillos Allen de 5 cm[cite: 17].
  - *Herrajes:* Pernos mini fix con caja, Tarugos 6x30, Tornillos Allen o Phillips de 5 cm

**Paso 5:** Paso 5: Encastre las patas macizas, para luego ajustarla desde arriba con la base de patas H, por medio de los tornillos Allen de 5 cm[cite: 17]. A su vez coloque a presión dos tarugos guías 6x30[cite: 17].
  - *Herrajes:* Tornillos Allen o Phillips de 5 cm, Tarugos 6x30

**Paso 6:** Paso 6: Clave los fondos de 3 mm, tal como lo indica el grafico, siguiendo el orden correcto y la escuadras justa del mueble[cite: 17]. Posteriormente distribuya los clavos a una distancia aproximada de 15 cm entre ellos, proporcionándole la rigidez necesaria al mueble (1 vértice B-C, 2 vértice B-D, 3 vértice D-E, 4 vértice C-E)[cite: 17]. Una vez armado la base de patas H con las patas macizas, ajuste este hacia el piso B, a través de los 4 tornillos de 2,5 cm y utilizando como guía las perforaciones donde van los dos tarugos 6 x 30, los cuales solo cumplen la función de guía (no golpear)[cite: 17].
  - *Herrajes:* Set de Clavos, Tornillos de 2.5 cm, Tarugos 6x30

**Paso 7:** Paso 7: Coloque la puerta G en las bases de bisagras colocadas en el costado derecho D, Utilizando como guía las indicaciones de 'Colocación de bisagra' y 'Regulación de bisagra'[cite: 17]. Finalmente deslice el estante móvil F sobre los soportes previamente colocados en los costados C-D haciéndolo llegar hasta el fondo[cite: 17].
  - *Herrajes:* Bisagras codo 15 cazoleta 26, Soportes de estantes
  - 💡 *Consejo Pro:* Colocación de bisagras: El tornillo de regulación de profundidad debe encontrarse en la mitad de su recorrido[cite: 17]. Luego ingrese la bisagra en la base de bisagra haciendo coincidir el tornillo de regulación lateral con la ranura en U de la base, y finalmente ajuste el tornillo de regulación de profundidad[cite: 17].

---

## 📦 Rack FUKUOKA 2 puertas y estantes (SKU: 446250)
- **Línea:** KYOTO
- **Dificultad:** Medio | **Tiempo estimado:** 45 min
- **Herramientas necesarias:** Martillo de carpintero, Destornillador de punta en cruz, 1 Llave Allen, Usar regla para verificar tamaño de tornillos
- **Visor 3D Interactivo:** https://www.mueblesgacela.com.ar/armado/446250

### 🔩 Herrajes incluidos:
- Bisagras codo 0 cazoleta 26 (4 u.)
- Llave Allen (1 u.)
- Tornillos Allen 5 cm (13 u.)
- Pernos mini fix con caja (8 u.)
- Tornillos de 2.5 cm (6 u.)
- Tiradores Bruno con tornillos de 2.5 cm (2 u.)
- Tarugos 6x30 (2 u.)
- Soportes de estantes (4 u.)
- Set de Clavos (1 u.)
- Tornillos de 1.5 cm (16 u.)

### 📐 Piezas y Despiece:
- Letra A: Tapa (1 u.) - Medidas: 120 x 40 cm
- Letra B: Piso (1 u.) - Medidas: 120 x 40 cm
- Letra C: Costado izquierdo (1 u.) - Medidas: 38 x 38 cm
- Letra D: Costado derecho (1 u.) - Medidas: 38 x 38 cm
- Letra E: Separador izquierdo (1 u.) - Medidas: 38 x 38 cm
- Letra F: Separador derecho (1 u.) - Medidas: 38 x 38 cm
- Letra G: Estante móvil (1 u.) - Medidas: 38 x 38 cm
- Letra H: Puerta (2 u.) - Medidas: 37,4 x 41 cm
- Letra E: Base patas (1 u.) - Medidas: 110 x 35 cm
- Letra -: Fondo mueble (2 u.) - Medidas: 40,5 x 40,5 cm
- Letra -: Patas macizas (5 u.) - Medidas: 12 x 3 cm

### 🪜 Paso a Paso de Armado:
**Paso 1:** Paso 1: Prepare el costado izquierdo C, colocando a presión 2 caja para mini fix y 2 bases de bisagra mediante 4 tornillos de 1,5 cm[cite: 17]. Prepare de igual modo el costado derecho D, tener en cuenta que son simétricos[cite: 17].
  - *Herrajes:* Pernos mini fix con caja, Bisagras codo 0 cazoleta 26, Tornillos de 1.5 cm

**Paso 2:** Paso 2: En el separador izquierdo E, coloque a presión 2 caja para mini fix y 2 soporte de estantes[cite: 17]. Prepare de igual modo el Separador derecho F[cite: 17].
  - *Herrajes:* Pernos mini fix con caja, Soportes de estantes

**Paso 3:** Paso 3: En las puertas H coloque 2 bisagra mediante los tornillos de 1,5 cm, además un tirador por medio de un tornillo de 2,5 cm[cite: 17]. En la Tapa A, atornille 8 Pernos mini fix cubriendo todas las perforaciones[cite: 17].
  - *Herrajes:* Bisagras codo 0 cazoleta 26, Tornillos de 1.5 cm, Tiradores Bruno con tornillos de 2.5 cm, Tornillos de 2.5 cm, Pernos mini fix con caja

**Paso 4:** Paso 4: Acoplar los costados C-D y los separadores E-F a la Tapa A introduciendo los pernos minifix de esta en las perforaciones con caja minifix de los primeros mencionados luego ajuste las piezas girando 180 grados en sentido horario las cajas mini fix[cite: 17]. Por ultimo desde abajo ajuste por medio de 8 tornillos Allen de 5 cm el piso B a los costados, los separadores[cite: 17].
  - *Herrajes:* Pernos mini fix con caja, Tornillos Allen 5 cm

**Paso 5:** Paso 5: Una las patas de palo con la base de patas M, por medio de los tornillos Allen de 5 cm[cite: 17]. A su vez coloque a presión dos tarugos guías 6x30[cite: 17].
  - *Herrajes:* Tornillos Allen 5 cm, Tarugos 6x30

**Paso 6:** Paso 6: Clave los fondos de 3 mm, tal como lo indica el grafico, siguiendo el orden correcto y la escuadras justa del mueble[cite: 17]. Posteriormente distribuya los clavos a una distancia aproximada de 15 cm entre ellos, proporcionándole la rigidez necesaria al mueble. 1 vértice A-C, 2 vértice A-E, 3 vértice C-B, 4 vértice B-E. Repetir para el otro fondo[cite: 17]. Una vez armado la base de patas M con las patas macizas, ajuste este hacia el piso B, a través de los 6 tornillos de 2,5 cm y utilizando como guía las perforaciones donde van los dos tarugos 6 x 30, los cuales solo cumplen la función de guía (no golpear)[cite: 17].
  - *Herrajes:* Set de Clavos, Tornillos de 2.5 cm, Tarugos 6x30

**Paso 7:** Paso 7: Coloque las Puertas H en las bases de bisagras colocadas en los Costados C-D, Utilizando como guía las indicaciones de 'Colocación de bisagra' y 'Regulación de bisagra'[cite: 17]. Finalmente deslice el estante móvil G sobre los soportes previamente colocados en los Separadores E-F haciéndolo llegar hasta el fondo[cite: 17].
  - *Herrajes:* Bisagras codo 0 cazoleta 26, Soportes de estantes
  - 💡 *Consejo Pro:* Colocación y regulación de bisagras: El tornillo de regulación de profundidad debe encontrarse en la mitad de su recorrido[cite: 17]. Luego ingrese la bisagra en la base de bisagra haciendo coincidir el tornillo de regulación lateral con la ranura en U de la base, y finalmente ajuste el tornillo de regulación de profundidad[cite: 17].

---

## 📦 Bahiut NAGOYA 2 puertas y estante interno (SKU: 760250)
- **Línea:** KYOTO
- **Dificultad:** Medio | **Tiempo estimado:** 45 min
- **Herramientas necesarias:** Martillo de carpintero, Destornillador de punta en cruz, 1 Llave Allen, Usar regla para verificar tamaño de tornillos
- **Visor 3D Interactivo:** https://www.mueblesgacela.com.ar/armado/760250

### 🔩 Herrajes incluidos:
- Bisagras codo 15 cazoleta 26 (4 u.)
- Llave Allen (1 u.)
- Tornillos Allen 5 cm (12 u.)
- Pernos mini fix con caja (4 u.)
- Tornillos de 2.5 cm (4 u.)
- Soportes de estantes (4 u.)
- Tarugos 6x30 (6 u.)
- Set de Clavos (1 u.)
- Tornillos de 1.5 cm (16 u.)

### 📐 Piezas y Despiece:
- Letra A: Tapa (1 u.) - Medidas: 80 x 38 cm
- Letra B: Piso (1 u.) - Medidas: 80 x 38 cm
- Letra C: Costado izquierdo (1 u.) - Medidas: 48,5 x 38 cm
- Letra I: Base patas (1 u.) - Medidas: 110 x 35 cm
- Letra -: Fondo mueble (2 u.) - Medidas: 51 x 40,5 cm
- Letra -: Patas macizas (4 u.) - Medidas: 19 x 7,5 cm
- Letra D: Costado derecho (1 u.) - Medidas: 48,5 x 38 cm
- Letra -: Faja frente (1 u.) - Medidas: 77 x 6 cm
- Letra G: Estante móvil (1 u.) - Medidas: 77 x 32 cm
- Letra H: Puerta (2 u.) - Medidas: 45,2 x 38 cm

### 🪜 Paso a Paso de Armado:
**Paso 1:** Paso 1: Prepare el costado izquierdo C, colocando a presión 2 caja para mini fix, 2 soporte de estantes y 2 bases de bisagra mediante 4 tornillos de 1,5 cm. Prepare de igual modo el costado derecho D, tener en cuenta que son simétricos.
  - *Herrajes:* Pernos mini fix con caja, Soportes de estantes, Bisagras codo 15 cazoleta 26, Tornillos de 1.5 cm

**Paso 2:** Paso 2: En las puertas H coloque 2 bisagra mediante los tornillos de 1,5 cm. En la Tapa A, atornille 4 Pernos mini fix cubriendo todas las perforaciones.
  - *Herrajes:* Bisagras codo 15 cazoleta 26, Tornillos de 1.5 cm, Pernos mini fix con caja

**Paso 3:** Paso 3: En la faja frente coloque a presión 4 tarugos guías.
  - *Herrajes:* Tarugos 6x30

**Paso 4:** Paso 4: Colocar la faja frente entre los costados C-D introduciendo los tarugos guía de la faja en las perforaciones de los costados. Luego acoplar los costados a la Tapa A introduciendo los pernos minifix de esta en las perforaciones con caja minifix de los primeros mencionados luego ajuste las piezas girando 180 grados en sentido horario las cajas mini fix. Por ultimo desde abajo ajuste por medio de 4 tornillos Allen de 5 cm el piso B a los costados.
  - *Herrajes:* Tarugos 6x30, Pernos mini fix con caja, Tornillos Allen 5 cm

**Paso 5:** Paso 5: Encastre las patas macizas, para luego ajustarla desde arriba con la base de patas I, por medio de los tornillos Allen de 5 cm. A su vez coloque a presión dos tarugos guías 6x30.
  - *Herrajes:* Tornillos Allen 5 cm, Tarugos 6x30

**Paso 6:** Paso 6: Clave los fondos de 3 mm, tal como lo indica el grafico, siguiendo el orden correcto y la escuadras justa del mueble. Posteriormente distribuya los clavos a una distancia aproximada de 15 cm entre ellos, proporcionándole la rigidez necesaria al mueble. 1 vértice A-C, 2 vértice mitad de A, 3 vértice C-B, 4 vértice mitad de B. Repetir para el otro fondo. Una vez armado la base de patas I con las patas macizas, ajuste este hacia el piso B, a través de los 4 tornillos de 2,5 cm y utilizando como guía las perforaciones donde van los dos tarugos 6 x 30, los cuales solo cumplen la función de guía (no golpear).
  - *Herrajes:* Set de Clavos, Tornillos de 2.5 cm, Tarugos 6x30

**Paso 7:** Paso 7: Coloque las Puertas H en las bases de bisagras colocadas en los Costados C-D, Utilizando como guía las indicaciones de 'Colocación de bisagra' y 'Regulación de bisagra'. Finalmente deslice el estante móvil G sobre los soportes previamente colocados en los costados haciéndolo llegar hasta el fondo.
  - *Herrajes:* Bisagras codo 15 cazoleta 26, Soportes de estantes
  - 💡 *Consejo Pro:* Colocación y regulación de bisagras: El tornillo de regulación de profundidad debe encontrarse en la mitad de su recorrido. Luego ingrese la bisagra en la base de bisagra haciendo coincidir el tornillo de regulación lateral con la ranura en U de la base, y finalmente ajuste el tornillo de regulación de profundidad.

---

## 📦 Mesas de arrime redondas (SKU: SET 116 / 116-1 / 116-2)
- **Línea:** NORDIK
- **Dificultad:** Bajo | **Tiempo estimado:** 15 min
- **Herramientas necesarias:** Martillo de carpintero, Destornillador de punta en cruz
- **Visor 3D Interactivo:** https://www.mueblesgacela.com.ar/armado/SET%20116%20%2F%20116-1%20%2F%20116-2

### 🔩 Herrajes incluidos:
- Tornillos allen 7x50 (12 u.)
- Bases redondas para clavar (6 u.)
- Tornillos de 3,5x20 (8 u.)
- Tarugos 6x30 (2 u.)

### 📐 Piezas y Despiece:
- Letra A: Tapa chica y grande (2 u.) - Medidas: especificación no provista cm
- Letra -: Pata bases chica y grande (2 u.) - Medidas: especificación no provista cm
- Letra -: Patas largas y cortas (6 u.) - Medidas: especificación no provista cm

### 🪜 Paso a Paso de Armado:
**Paso 1:** Paso 1: Armaremos el artículo 238-1 (tapa grande, base grande y patas cortas). Coloque el tarugo guía de 6x30 en el centro de la base de patas grande, luego atornille las 3 patas cortas hacia la base con los tornillos phillips 7x50. Para el artículo 238 (tapa chica, base chica y patas largas) realizar el mismo procedimiento.
  - *Herrajes:* Tarugos 6x30, Tornillos allen 7x50

**Paso 2:** Paso 2: Usando como guía el tarugo de 6x30, presente la base de patas grande a la tapa grande A luego atornille la base con la tapa con los tornillos Phillips 3.5x20. Los tarugos solo sirven de guía y sobresalen hacia abajo (no golpear). Finalmente clave las bases en las patas.
  - *Herrajes:* Tarugos 6x30, Tornillos de 3,5x20, Bases redondas para clavar

---

## 📦 Escritorio HAMAR con 3 cajones (SKU: 234094)
- **Línea:** NORDIK
- **Dificultad:** Medio | **Tiempo estimado:** 90 min
- **Herramientas necesarias:** Martillo de carpintero, Destornillador de punta en cruz, 1 Llave Allen, Usar regla para verificar tamaño de tornillos
- **Visor 3D Interactivo:** https://www.mueblesgacela.com.ar/armado/234094

### 🔩 Herrajes incluidos:
- Envase de cola (1 u.)
- Tornillos Allen 5 cm (18 u.)
- Escuadra metálica (1 u.)
- Pernos mini fix con caja (10 u.)
- Tornillos varianta (12 u.)
- Llave Allen (1 u.)
- Par de guías metálicas de 35 cm (3 u.)
- Tornillos de 1.5 cm (2 u.)
- Tiradores botón con tornillos (3 u.)
- Tornillos de 2.5 cm (7 u.)
- Tornillos de 3 cm (3 u.)
- Tornillos de 4 cm (7 u.)
- Tornillos de 2 cm (12 u.)
- Tarugos 6x30 (36 u.)
- Bases plásticas (4 u.)
- Set de Clavos (1 u.)

### 📐 Piezas y Despiece:
- Letra A: Tapa (1 u.) - Medidas: 120 x 58 cm
- Letra B: Piso adelante (1 u.) - Medidas: 35 x 9 cm
- Letra C: Piso atrás (1 u.) - Medidas: 35 x 9 cm
- Letra J: Frente cajón (3 u.) - Medidas: 38 x 19 cm
- Letra K: Costado cajón (6 u.) - Medidas: 40 x 12 cm
- Letra L: Fondo cajón (3 u.) - Medidas: 29,5 x 12 cm
- Letra M: Base patas (1 u.) - Medidas: 110 x 48 cm
- Letra -: Zócalos (2 u.) - Medidas: 35 x 6 cm
- Letra -: Fondo mueble (1 u.) - Medidas: 55,5 x 36 cm
- Letra -: Patas macizas (2 u.) - Medidas: 74 x 7,5 cm
- Letra -: Piso cajón (3 u.) - Medidas: 32,3 x 37,8 cm
- Letra G: Separador derecho (1 u.) - Medidas: 39,4 x 10 cm
- Letra H: Separador izquierdo (1 u.) - Medidas: 39,4 x 10 cm
- Letra I: Fondo (1 u.) - Medidas: 90 x 10 cm
- Letra D: Costado izquierdo (1 u.) - Medidas: 62 x 48 cm
- Letra E: Costado derecho (1 u.) - Medidas: 62 x 48 cm
- Letra F: Entre tapa (1 u.) - Medidas: 48 x 38 cm

### 🪜 Paso a Paso de Armado:
**Paso 1:** Paso 1: Prepare el costado derecho E, colocando a presión dos cajas para minifix, atornillando la guía metálica fijas derechas mediante los tornillos varianta y clavando dos bases plásticas. En el costado izquierdo D, realice el mismo procedimiento usando las guías fijas izquierdas y teniendo en cuenta que el costado es simétrico respecto al otro.
  - *Herrajes:* Pernos mini fix con caja, Tornillos varianta, Par de guías metálicas de 35 cm, Bases plásticas

**Paso 2:** Paso 2: En fondo I colocar a presión 4 tarugos de 6 x 30 en las perforaciones que muestra la figura.
  - *Herrajes:* Tarugos 6x30

**Paso 3:** Paso 3: Tanto en el piso adelante B como en el piso atrás C (con ranura) colocar a presión 2 tarugos de 6 x 30 en los cantos cortos en la perforación cercana al canto con filo melamínico. En los zócalos colocar a presión 4 tarugos de 6 x 30 en los cantos cortos.
  - *Herrajes:* Tarugos 6x30

**Paso 4:** Paso 4: En la entre tapa F atornillar 4 pernos minifix en las perforaciones que muestra la figura.
  - *Herrajes:* Pernos mini fix con caja

**Paso 5:** Paso 5: Mediante los tornillos Allen de 5 cm, una el piso adelante B y el piso atrás C con el costado derecho D, y con el costado izquierdo C usando como guía los tarugos y previamente colocando los tarugos de los zócalos en las perforaciones de los costados. En el piso atrás dejar el canal hacia arriba.
  - *Herrajes:* Tornillos Allen 5 cm, Tarugos 6x30

**Paso 6:** Paso 6: Encastre las patas macizas, para luego ajustarlas desde arriba mediante los tornillos Allen 5 cm hacia la base de las patas M. A su vez coloque a presión dos tarugos guías 6x30. Mediante los tornillos Allen de 5 cm, una el fondo I a la base de patas y luego el separador derecho G y el separador izquierdo H con el fondo usando como guía los tarugos. Finalmente ajuste el fondo a la pata por medio de un tornillo de 2,5cm y el separador izquierdo a la otra pata por medio de la escuadra metálica con dos tornillos de 1,5 cm. NOTA: Este instructivo de armado es para que el gabinete quede hacia la derecha. Si el cliente necesita que quede a la izquierda, en este paso el fondo queda hacia adelante y los separadores se giran.
  - *Herrajes:* Tornillos Allen 5 cm, Tarugos 6x30, Tornillos de 2.5 cm, Escuadra metálica, Tornillos de 1.5 cm

**Paso 7:** Paso 7 Armado de cajones: Coloque 2 tarugos 6x30 en el fondo de cajón L, 2 mas en cada uno de los costados de cajón K a su vez encastrar las cajas mini fix. Agregar adhesivo en cada perforación donde lleve tarugo.
  - *Herrajes:* Tarugos 6x30, Pernos mini fix con caja, Envase de cola

**Paso 8:** Paso 8 Armado de cajones: Atornille 2 minifix en el frente de cajón J. Y coloque el tirador botón con un tornillo de 3 cm.
  - *Herrajes:* Pernos mini fix con caja, Tiradores botón con tornillos, Tornillos de 3 cm

**Paso 9:** Paso 9 armado de cajones: Una vez armada la estructura tipo "U" entre K-L-K, ingrese el frente de cajón J ajuste los pernos mini fix girando 180 grados las cajas mini fix. Habiendo agregado el adhesivo anteriormente. Luego ajuste el fondo y los costados mediante los dos tornillos de 4 cm.
  - *Herrajes:* Pernos mini fix con caja, Envase de cola, Tornillos de 4 cm

**Paso 10:** Paso 10 armado de cajones: Desde abajo introduzca el piso de cajón sobre el canal del frente de cajón J, y clave este siguiendo una escuadra correcta del cajón sobre los filos inferiores de los costados y del fondo. Finalmente atornille las guías metálicas como muestra la figura mediante 4 tornillos de 2 cm.
  - *Herrajes:* Set de Clavos, Tornillos de 2 cm, Par de guías metálicas de 35 cm

**Paso 11:** Paso 11: Primero una la tapa A con la base de patas M, ya terminada con las patas los separadores y el fondo, mediante los tornillos de 2,5 cm y utilizando como guía los tarugos colocados en la base de patas, los cuales solo sirven de guía (no golpear). Segundo deslice el fondo de mueble en los canales de los costados D-E hasta el canal del piso atrás C y seguidamente desde arriba una la entre tapa F introduciendo los pernos minifix en las perforaciones de los costados y ajuste girando 180 grados las cajas mini fix, previamente colocando el sobrante del fondo de mueble en el canal de la entre tapa. Tercero por medio de los tornillos Allen de 5 cm una la entre tapa con el separador derecho G y con un tornillo de 4 cm al fondo I. NOTA: Este instructivo de armado es para que el gabinete quede hacia la derecha. Si el cliente necesita que quede a la izquierda, en este paso colocar la base de patas con el fondo hacia atrás previamente habiendo echo el paso antes mencionado.
  - *Herrajes:* Tornillos de 2.5 cm, Tarugos 6x30, Pernos mini fix con caja, Tornillos Allen 5 cm, Tornillos de 4 cm

**Paso 12:** Paso 12: Colocar los cajones sobre las guías fijas que se encuentran ya en el mueble, como lo muestra la imagen.
  - *Herrajes:* Par de guías metálicas de 35 cm
  - 💡 *Consejo Pro:* Colocación de cajones: Deslice los cajones de forma nivelada sobre las guías fijas hasta que las ruedas encastren adecuadamente.

---

## 📦 Escritorio ELIN con cajón (SKU: 321021)
- **Línea:** NORDIK
- **Dificultad:** Medio | **Tiempo estimado:** 90 min
- **Herramientas necesarias:** Martillo de carpintero, Destornillador de punta en cruz, 1 Llave allen, Cinta metrica, Usar regla para verificar tamaño de tornillos
- **Visor 3D Interactivo:** https://www.mueblesgacela.com.ar/armado/321021

### 🔩 Herrajes incluidos:
- Envase de cola (1 u.)
- Bases con tarugo (2 u.)
- Pernos mini fix con caja (8 u.)
- Tarugos 6x30 (24 u.)
- Set de Clavos (1 u.)
- Tornillos de 2.5 cm (6 u.)
- Tornillos de 4 cm (5 u.)
- Tornillos Allen 5 cm (23 u.)
- Tirador botón (1 u.)

### 📐 Piezas y Despiece:
- Letra A: Tapa (1 u.) - Medidas: 85 x 52 cm
- Letra C: Costado abajo izquierdo (1 u.) - Medidas: 50 x 10,6 cm
- Letra D: Costado abajo derecho (1 u.) - Medidas: 50 x 10,6 cm
- Letra J: Cost. cajón izquierdo (1 u.) - Medidas: 40 x 8,4 cm
- Letra K: Cost. cajón derecho (1 u.) - Medidas: 40 x 8,4 cm
- Letra H: Fondo arriba (1 u.) - Medidas: 85 x 35 cm
- Letra B: Piso (1 u.) - Medidas: 85 x 50 cm
- Letra M: Base pata (1 u.) - Medidas: 77 x 42 cm
- Letra E: Costado arriba (2 u.) - Medidas: 35 x 10 cm
- Letra I: Frente cajón (1 u.) - Medidas: 85 x 11,8 cm
- Letra J: Fondo de cajón (1 u.) - Medidas: 81,7 x 10,3 cm
- Letra -: Piso de cajón (1 u.) - Medidas: 81,4 x 41 cm
- Letra F: Separador abajo (2 u.) - Medidas: 23,5 x 10 cm
- Letra -: Separador arriba (1 u.) - Medidas: 10 x 10 cm
- Letra G: Estante (1 u.) - Medidas: 82 x 10 cm
- Letra -: Patas macizas (4 u.) - Medidas: 63 x 7,5 cm
- Letra -: Refuerzo cajón (2 u.) - Medidas: 40 x 6 cm
- Letra H: Fondo abajo (1 u.) - Medidas: 81,8 x 10,6 cm

### 🪜 Paso a Paso de Armado:
**Paso 1:** Paso 1: Prepare el costado abajo derecho D y el costado abajo izquierdo C, colocando a presión 2 caja mini fix[cite: 5802].
  - *Herrajes:* Pernos mini fix con caja

**Paso 2:** Paso 2: En la tapa A atornille 4 pernos mini fix en las perforaciones que muestra la figura[cite: 5804, 5805].
  - *Herrajes:* Pernos mini fix con caja

**Paso 3:** Paso 3: En los costados arriba E coloque a presión un tarugo de 6x30 en la perforación que marca la figura[cite: 5803]. En los separadores abajo F, coloque a presión 4 tarugos 6x30 en los cantos cortos, y coloque 2 en el separador arriba[cite: 5810, 5811]. En el fondo, coloque a presión 4 tarugos 6x30 en los cantos cortos y 2 en los largos[cite: 5812].
  - *Herrajes:* Tarugos 6x30

**Paso 4:** Paso 4: Una los costados arriba E y el estante G por medio de 2 tornillos Allen de 5 cm[cite: 5814]. Luego haga coincidir los tarugos de los separadores abajo F con las perforaciones del estante G y luego con las perforaciones de la tapa A para luego ajustar de abajo con 2 tornillos de 5 cm[cite: 5815]. Verifique que los cantos melaminicos queden hacia adelante[cite: 5816]. Desde arriba una el separador arriba con el estante introduciendo los tarugos en las perforaciones de este ultimo[cite: 5817, 5818].
  - *Herrajes:* Tornillos Allen 5 cm, Tarugos 6x30

**Paso 5:** Paso 5: Por medio de tornillos Allen de 5 cm una el fondo arriba H con los costados arriba E, el estante G y el separador arriba, luego desde abajo con la tapa A[cite: 5828]. Seguidamente una los costados abajo C - D con la tapa A introduciendo los pernos minifix de esta en las perforaciones con caja minifix de las primeras, previamente haciendo coincidir los tarugos del fondo abajo con las perforaciones de los costados abajo y la perforación de la tapa[cite: 5829, 5830, 5831]. Luego ajuste las piezas girando 180 grados en sentido horario las cajas mini fix[cite: 5832, 5833]. Por ultimo y desde abajo por medio de 4 tornillos Allen de 5 cm una el piso B con los costados abajo C - D, previamente haciendo coincidir el tarugo del fondo con la perforación del piso[cite: 5842].
  - *Herrajes:* Tornillos Allen 5 cm, Pernos mini fix con caja, Tarugos 6x30

**Paso 6:** Paso 6: Encastre las patas macizas, para luego ajustarlas desde arriba mediante los tornillos Allen de 5 cm hacia la base de las patas M[cite: 5844]. A su vez coloque a presión dos tarugos guías 6x30 como muestra la imagen[cite: 5844].
  - *Herrajes:* Tornillos Allen 5 cm, Tarugos 6x30

**Paso 7:** Paso 7: En el frente de cajón I atornille 4 pernos mini fix en las perforaciones que muestra la figura, y por medio de un tornillo de 4 cm el tirador botón[cite: 5849]. Agregar una caja mini fix a cada refuerzo de cajón[cite: 5850].
  - *Herrajes:* Pernos mini fix con caja, Tornillos de 4 cm, Tirador botón

**Paso 8:** Paso 8: En el costado de cajón izquierdo J coloque a presión 2 tarugos 6x30 en los cantos cortos y a su vez encastrar una caja mini fix[cite: 5851]. Realizar el mismo procedimiento para el costado de cajón derecho K teniendo en cuenta que es simétrico[cite: 5852]. Agregar adhesivo en cada perforación donde lleve tarugo[cite: 5853].
  - *Herrajes:* Tarugos 6x30, Pernos mini fix con caja, Envase de cola

**Paso 9:** Paso 9: Una los costados de cajón J - K con el frente de cajón I, introduciendo los pernos de este ultimo con las perforaciones de los primeros, usando como guía los tarugos de estos[cite: 5854]. Ajuste los mini fix girando 180 grados las cajas mini fix. Habiendo agregado el adhesivo anteriormente[cite: 5855]. Usando el mismo sistema mini fix, una los refuerzos de cajón con el frente[cite: 5856].
  - *Herrajes:* Pernos mini fix con caja, Tarugos 6x30, Envase de cola

**Paso 10:** Paso 10: Introduzca el piso de cajón sobre el canal del frente de cajón I, luego desde atrás introduciendo el piso en el fondo de cajón L, una el fondo a los costados y a los refuerzos por medio de 4 tornillos de 4 cm[cite: 5861]. Seguidamente clave el piso sobre los filos inferiores de los costados siguiendo una escuadra correcta del cajón[cite: 5862]. Habiendo agregado el adhesivo anteriormente[cite: 5863].
  - *Herrajes:* Tornillos de 4 cm, Set de Clavos, Envase de cola

**Paso 11:** Paso 11: Una vez armada la base de patas M con las patas macizas, ajuste esta hacia el piso B, a través de los 6 tornillos de 2,5 cm y utilizando como guía los tarugos colocados en la base de patas, los cuales solo sirven de guía (no golpear)[cite: 5867]. Finalmente ingrese el cajón hasta una profundidad que pueda quedar el acceso para colocar a presión 2 bases con tarugos en las perforaciones para bases que están en la tapa A. Dichas bases sirven de tope para el cajón[cite: 5871].
  - *Herrajes:* Tornillos de 2.5 cm, Tarugos 6x30, Bases con tarugo

---

## 📦 Mesa centro LYS con cajón (SKU: 331330)
- **Línea:** NORDIK
- **Dificultad:** Medio | **Tiempo estimado:** 30 min
- **Herramientas necesarias:** Martillo de carpintero, Destornillador de punta en cruz, Llave Allen 4 mm, Usar regla para verificar tamaño de tornillos
- **Visor 3D Interactivo:** https://www.mueblesgacela.com.ar/armado/331330

### 🔩 Herrajes incluidos:
- Envase de cola (1 u.)
- Tornillos de 2,5 cm (4 u.)
- Tornillos Allen o phillips de 5 cm (16 u.)
- Tornillos varianta (4 u.)
- Par de guías metálicas de 35 cm (1 u.)
- Pernos mini fix con caja (3 u.)
- Tornillos de 4 cm (13 u.)
- Tarugos 6x30 (17 u.)
- Tornillos de 2 cm (4 u.)
- Set de Clavos (1 u.)

### 📐 Piezas y Despiece:
- Letra A: Tapa (1 u.) - Medidas: 87 x 43 cm
- Letra B: Piso (1 u.) - Medidas: 90 x 44,5 cm
- Letra C: Costado izquierdo (1 u.) - Medidas: 44,5 x 24 cm
- Letra O: Frente cajón (1 u.) - Medidas: 90 x 24 cm
- Letra M: Costado cajón (2 u.) - Medidas: 40 x 10 cm
- Letra N: Fondo cajón (1 u.) - Medidas: 81,4 x 10 cm
- Letra -: Refuerzo cajón (1 u.) - Medidas: 37,4 x 6 cm
- Letra -: Patas (4 u.) - Medidas: 19 x 7,5 cm
- Letra -: Piso cajón (1 u.) - Medidas: 84,2 x 37,8 cm
- Letra D: Costado derecho (1 u.) - Medidas: 44,5 x 24 cm
- Letra E: Fondo (1 u.) - Medidas: 87 x 24 cm
- Letra F: Base de patas (1 u.) - Medidas: 80 x 39,5 cm
- Letra -: Zócalo frente (2 u.) - Medidas: 65,5 x 8 cm
- Letra -: Zócalo lateral (2 u.) - Medidas: 32 x 8 cm
- Letra -: Faja refuerzo (1 u.) - Medidas: 87 x 6 cm

### 🪜 Paso a Paso de Armado:
**Paso 1:** Paso 1: Prepare el costado derecho D, colocando la guía metálica fija derecha mediante los tornillos varianta. Realice el mismo procedimiento en el costado izquierdo C, teniendo en cuenta que es simétrico. En el fondo E coloque 4 tarugos guías de 6x30 y en la faja refuerzo 5, ocupando todas las perforaciones en cantos.
  - *Herrajes:* Par de guías metálicas de 35 cm, Tornillos varianta, Tarugos 6x30

**Paso 2:** Paso 2: Una la tapa A a los costados C - D, por medio de 4 tornillos Allen de 5, previamente haga coincidir los tarugos del fondo E y de la faja refuerzo, con las perforaciones de los costados y de la tapa. Una el piso B desde abajo ajustando con 4 tornillos Allen de 5 cm a los costados.
  - *Herrajes:* Tornillos Allen o phillips de 5 cm, Tarugos 6x30

**Paso 3:** Paso 3: armado de cajón: Coloque 2 tarugos 6x30 en el fondo de cajón N, 2 mas en cada uno de los costados de cajón M a su vez encastrar las cajas mini fix. Agregar adhesivo en cada perforación donde lleve tarugo.
  - *Herrajes:* Tarugos 6x30, Pernos mini fix con caja, Envase de cola

**Paso 4:** Paso 4 armado de cajón: En el frente de cajón O atornillar tres pernos mini fix.
  - *Herrajes:* Pernos mini fix con caja

**Paso 5:** Paso 5 armado de cajón: Una vez armada la estructura tipo "U" entre M-N-M, ingrese el frente de cajón O ajuste los pernos mini fix girando 180 grados las cajas mini fix. Habiendo agregado el adhesivo anteriormente. Luego ajuste el fondo y los costados mediante los dos tornillos 4 cm.
  - *Herrajes:* Pernos mini fix con caja, Envase de cola, Tornillos de 4 cm

**Paso 6:** Paso 6 armado de cajón: Desde abajo introduzca el piso de cajón sobre el canal del frente de cajón O, y clave este siguiendo una escuadra correcta del cajón sobre los filos inferiores de los costados and del fondo. Atornille las guías metálicas como muestra la figura mediante 4 tornillos 2 cm.
  - *Herrajes:* Set de Clavos, Par de guías metálicas de 35 cm, Tornillos de 2 cm

**Paso 7:** Paso 7 armado de cajón: Haga coincidir la perforación lateral del refuerzo de cajón con el perno mini fix colocado en el frente de cajón E, ajuste las piezas girando la caja mini fix media vuelta en sentido horario. Finalmente ajuste el refuerzo al fondo de cajón G mediante un tornillo de 4 cm.
  - *Herrajes:* Pernos mini fix con caja, Tornillos de 4 cm

**Paso 8:** Paso 8: Encastre las patas macizas, para luego ajustarlas desde arriba mediante los tornillos Allen de 5 cm hacia la base de las patas F. A su vez coloque a presión dos tarugos guías 6x30.
  - *Herrajes:* Tornillos Allen o phillips de 5 cm, Tarugos 6x30

**Paso 9:** Paso 9: Luego y mediante los tornillos de 4 cm, vincule las fajas laterales hacia las fajas frentes, para finalmente unir estas hacia las patas Macizas, tal como lo indica la figura.
  - *Herrajes:* Tornillos de 4 cm

**Paso 10:** Paso 10: A través de los 2 tornillos de 4 cm, una el fondo E con el piso B y con la tapa A. Una vez armado la base de patas F ajuste este hacia el piso B, a través de los 4 tornillos de 2,5 cm y utilizando como guía las perforaciones donde van los dos tarugos 6 x 30. LOS TARUGOS SOLO SIRVEN DE GUIA NO GOLPEARLOS. Finalmente coloque el cajón ya armado sobre las guías fijas ya colocadas en los costados.
  - *Herrajes:* Tornillos de 4 cm, Tornillos de 2,5 cm, Tarugos 6x30, Par de guías metálicas de 35 cm

**Paso 11:** Paso 11: Colocar los cajones sobre las guías fijas que se encuentran ya en el mueble, como lo muestra la imagen.
  - *Herrajes:* Par de guías metálicas de 35 cm

---

## 📦 Escritorio SKOG con 2 tapas rebatibles (SKU: 334026)
- **Línea:** NORDIK
- **Dificultad:** Medio | **Tiempo estimado:** 45 min
- **Herramientas necesarias:** Martillo de carpintero, Destornillador de punta en cruz, 1 Llave allen, Usar regla para verificar tamaño de tornillos
- **Visor 3D Interactivo:** https://www.mueblesgacela.com.ar/armado/334026

### 🔩 Herrajes incluidos:
- Pernos mini fix con caja (4 u.)
- Tornillos Allen 5 cm (20 u.)
- Bisagras codo 0 casoleta 26 (4 u.)
- Tarugos 6x30 (14 u.)
- Tornillos de 1,5 cm (16 u.)
- Tornillos de 2,5 cm (6 u.)

### 📐 Piezas y Despiece:
- Letra A: Tapa (2 u.) - Medidas: 60 x 44,5 cm
- Letra C: Costado izquierdo (1 u.) - Medidas: 44,5 x 10,6 cm
- Letra D: Costado derecho (1 u.) - Medidas: 44,5 x 10,6 cm
- Letra B: Piso (1 u.) - Medidas: 120 x 44,5 cm
- Letra K: Base pata (1 u.) - Medidas: 110 x 39,5 cm
- Letra -: Patas macizas der. (2 u.) - Medidas: 63 x 7,5 cm
- Letra -: Patas macizas izq. (2 u.) - Medidas: 63 x 7,5 cm
- Letra L: Refuerzo patas (2 u.) - Medidas: 33 x 10 cm
- Letra M: Fondo (1 u.) - Medidas: 116,8 x 10,6 cm
- Letra N: Frente (1 u.) - Medidas: 116,8 x 10,6 cm

### 🪜 Paso a Paso de Armado:
**Paso 1:** Paso 1: Prepare las tapas A, atornillando 2 bisagras mediante los tornillos de 1,5 cm.
  - *Herrajes:* Bisagras codo 0 casoleta 26, Tornillos de 1,5 cm

**Paso 2:** Paso 2: Al fondo M, atornille 4 bases de bisagras mediante los tornillos de 1,5 cm y en las perforaciones de los cantos que muestra la figura coloque a presión 2 tarugos de 6x30. En el frente N solo coloque a presión los tarugos.
  - *Herrajes:* Tornillos de 1,5 cm, Tarugos 6x30

**Paso 3:** Paso 3: Una los costados C - D, con el fondo M y el frente N por medio de 4 tornillos Allen de 5 cm previamente haciendo coincidir los tarugos de estos últimos con las perforaciones de los primeros. Luego desde abajo ajuste el piso B por medio de 8 tornillos Allen de 5 cm, 4 a los costados C - D y 4 al fondo y al frente M - N.
  - *Herrajes:* Tornillos Allen 5 cm, Tarugos 6x30

**Paso 4:** Paso 4: Prepare los Refuerzos de patas L, colocando a presión 4 tarugos guías 6x30 y dos cajas minifix, como así también las patas atornillando un minifix por cada una. Una las tres piezas introduciendo los pernos minifix de las patas en las perforaciones con caja minifix de los refuerzos de patas utilizando los tarugos como guía, luego ajuste las piezas girando 180 grados en sentido horario las cajas mini fix.
  - *Herrajes:* Tarugos 6x30, Pernos mini fix con caja

**Paso 5:** Paso 5: Encastre las patas macizas, para luego ajustarlas desde arriba mediante los tornillos Allen de 5 cm hacia la base de las patas K. A su vez coloque a presión dos tarugos guías 6x30.
  - *Herrajes:* Tornillos Allen 5 cm, Tarugos 6x30

**Paso 6:** Paso 6: Una vez armada la base de patas K con las patas macizas, ajuste esta hacia el piso B, a través de los 6 tornillos de 2,5 cm y utilizando como guía los tarugos colocados en la base de patas, los cuales solo sirven de guía (no golpear). Coloque las tapas A en las bases de bisagras colocadas en el fondo M utilizando como guía el contenido de 'Regulación y colocación de bisagra'.
  - *Herrajes:* Tornillos de 2,5 cm, Tarugos 6x30, Bisagras codo 0 casoleta 26
  - 💡 *Consejo Pro:* Regulación de bisagras: El tornillo de regulación de profundidad debe encontrarse en la mitad de su recorrido. Luego ingrese la bisagra en la base de bisagra haciendo coincidir el tornillo de regulación lateral con la ranura en U de la base, y finalmente ajuste el tornillo de regulación de profundidad.

---

## 📦 Escritorio CRUX con patas en X (SKU: 334093)
- **Línea:** NORDIK
- **Dificultad:** Bajo | **Tiempo estimado:** 30 min
- **Herramientas necesarias:** Martillo de carpintero, Destornillador de punta en cruz, Llave Allen 4 mm, Usar regla para verificar tamaño de tornillos
- **Visor 3D Interactivo:** https://www.mueblesgacela.com.ar/armado/334093

### 🔩 Herrajes incluidos:
- Tornillos de 5 cm (8 u.)
- Tornillos Allen de 5 cm (8 u.)
- Tornillos Allen de 7 cm (8 u.)
- Pernos mini fix con caja (8 u.)
- Tarugos de 3 cm (8 u.)

### 📐 Piezas y Despiece:
- Letra A: Tapa (1 u.) - Medidas: 100 x 52 cm
- Letra B: Piso (1 u.) - Medidas: 93,7 x 38 cm
- Letra C: Costados (2 u.) - Medidas: 36,5 x 10 cm
- Letra D: Fondo abajo (1 u.) - Medidas: 93,6 x 10 cm
- Letra E: Fondo arriba (1 u.) - Medidas: 100 x 12 cm
- Letra F: Sobre tapa (1 u.) - Medidas: 107 x 11 cm
- Letra -: Patas larga (2 u.) - Medidas: 105 x 10 cm
- Letra -: Patas cortas (2 u.) - Medidas: 90 x 10 cm
- Letra -: Faja (1 u.) - Medidas: 93,7 x 6 cm

### 🪜 Paso a Paso de Armado:
**Paso 1:** Paso 1: Arme el fondo arriba E, colocando a presión 4 tarugos de 3 cm y 2 cajas mini fix en las perforaciones que muestra la figura. Hacer lo mismo para el fondo abajo D. Y en los costados C colocar solo las cajas mini fix.
  - *Herrajes:* Tarugos de 3 cm, Pernos mini fix con caja

**Paso 2:** Paso 2: Arme la tapa A, atornillando 6 mini fix en las perforaciones que muestra la figura. Luego introduzca los pernos minifix de la tapa en las perforaciones de las cajas minifix del fondo abajo D y de los costados C, en el fondo previamente haciendo coincidir los tarugos guías. Luego ajuste las piezas girando 180 grados en sentido horario las cajas mini fix. Desde abajo una el piso B con los costados y el fondo abajo por medio de los tornillos Allen de 5 cm, previamente haciendo coincidir los tarugos guías.
  - *Herrajes:* Pernos mini fix con caja, Tornillos Allen de 5 cm

**Paso 3:** Paso 3: Arme la sobre tapa F, atornillando 2 mini fix en las perforaciones que muestra la figura. Luego introduzca los pernos minifix de la sobre tapa en las perforaciones de las cajas minifix del fondo arriba E, previamente haciendo coincidir los tarugos guías. Luego ajuste las piezas girando 180 grados en sentido horario las cajas mini fix. Desde abajo una el fondo arriba con la tapa A por medio de los tornillos Allen de 5 cm, previamente haciendo coincidir los tarugos guías. Se recomienda armarlo en forma invertida y al borde de una mesa apoyando la tapa A y dejando en un nivel mas bajo la sobre tapa F.
  - *Herrajes:* Pernos mini fix con caja, Tornillos Allen de 5 cm

**Paso 4:** Paso 4: Una las patas cortas al piso B por medio de los tornillos Allen de 7 cm y a la faja por medio de los tornillos de 5 cm, asentando la cara superior sobre la tapa A. Luego una las patas largas a la tapa A por medio de los tornillos Allen de 7 cm, asentando la cara superior en la sobre tapa F. Antes de ajustar las patas verifique la altura de base de patas como lo indica la figura (76 cm) y con el mueble invertido. Una vez confirmadas las medidas ajuste las patas a través de las perforaciones pasantes de las patas cortas por medio de los tornillos de 5 cm desde adentro.
  - *Herrajes:* Tornillos Allen de 7 cm, Tornillos de 5 cm
  - 💡 *Consejo Pro:* Control de escuadra en patas: Antes del ajuste definitivo de los tornillos de 5 cm desde adentro, asegúrese con una cinta métrica que la altura total de la base de las patas invertidas quede perfectamente a 76 cm.

---

## 📦 Set de mesas Oval LUND (SKU: 372020)
- **Línea:** NORDIK
- **Dificultad:** Bajo | **Tiempo estimado:** 15 min
- **Herramientas necesarias:** Martillo de carpintero, Destornillador de punta en cruz, Usar regla para verificar tamaño de tornillos
- **Visor 3D Interactivo:** https://www.mueblesgacela.com.ar/armado/372020

### 🔩 Herrajes incluidos:
- Tornillos Phillips 7x50 (12 u.)
- Bases redonda para clavar (6 u.)
- Tornillo de 3.5x20 (14 u.)
- Tarugos 6 x 30 (8 u.)

### 📐 Piezas y Despiece:
- Letra A: Tapa grande (1 u.) - Medidas: especificación no provista cm
- Letra B: Tapa chica (1 u.) - Medidas: especificación no provista cm
- Letra C: Bases de patas ancha grande (1 u.) - Medidas: especificación no provista cm
- Letra D: Bases de patas ancha chica (1 u.) - Medidas: especificación no provista cm
- Letra E: Bases de patas larga (2 u.) - Medidas: especificación no provista cm
- Letra -: Patas grandes (3 u.) - Medidas: especificación no provista cm
- Letra -: Patas chicas (3 u.) - Medidas: especificación no provista cm

### 🪜 Paso a Paso de Armado:
**Paso 1:** Paso 1: Coloque dos tarugos guías de 6x30 en la base de patas grande C, luego atornille 2 patas grandes hacia la base con los tornillos Phillips 7x50. Hacer lo mismo para la base de patas chica D, con las patas chicas. En las bases largas E coloque dos tarugos guías de 6x30, luego atornille 1 pata grande y 1 chica en cada una con los tornillos Phillips 7x50.
  - *Herrajes:* Tarugos 6 x 30, Tornillos Phillips 7x50

**Paso 2:** Paso 2: Usando como guía los tarugos de 6x30, presente la base de patas grande C a la tapa grande A luego atornille la base con la tapa con los tornillos Phillips 3.5x20, lo mismo con las bases largas E. LOS TARUGOS SIRVEN SOLO COMO GUIA ¡NO GOLPEAR! Finalmente clave las bases en las patas. Haga lo mismo con la tapa chica B y la base de patas chicas D.
  - *Herrajes:* Tarugos 6 x 30, Tornillo de 3.5x20, Bases redonda para clavar

---

## 📦 Set de mesas con pata crux ALDE (SKU: 372080)
- **Línea:** NORDIK
- **Dificultad:** Bajo | **Tiempo estimado:** 15 min
- **Herramientas necesarias:** Martillo de carpintero, Destornillador de punta en cruz, Usar regla para verificar tamaño de tornillos
- **Visor 3D Interactivo:** https://www.mueblesgacela.com.ar/armado/372080

### 🔩 Herrajes incluidos:
- Pernos mini fix con caja (16 u.)
- Tornillos de 2 cm (2 u.)
- Clavos cabeza caucho (8 u.)
- Tarugos 6x30 (8 u.)

### 📐 Piezas y Despiece:
- Letra A: Tapa grande (di 75) (1 u.) - Medidas: 75 cm
- Letra B: Tapa chica (di 59) (1 u.) - Medidas: 59 cm
- Letra C: Patas largas x4 (4 u.) - Medidas: 53 x 5 cm
- Letra D: Patas cortas x4 (4 u.) - Medidas: 33 x 5 cm
- Letra E: Travesaño grande superior (1 u.) - Medidas: 61 x 5 cm
- Letra F: Travesaño grande inferior (1 u.) - Medidas: 61 x 5 cm
- Letra G: Travesaño chico superior (1 u.) - Medidas: 45 x 5 cm
- Letra H: Travesaño chico inferior (1 u.) - Medidas: 45 x 5 cm

### 🪜 Paso a Paso de Armado:
**Paso 1:** Paso 1: Tanto en las patas largas C como en las patas chicas D, atornillar 1 mini fix, colocar a presión 1 tarugo 6x30 y 1 caja mini fix en las perforaciones que muestra la figura, por último clavar un clavo cabeza de caucho en la parte inferior, tratando de que este quede centrado[cite: 18].
  - *Herrajes:* Pernos mini fix con caja, Tarugos 6x30, Clavos cabeza caucho

**Paso 2:** Paso 2: En los travesaños grandes E-F como así también en los travesaños chicos G-H, colocar a presión 2 cajas mini fix por travesaño[cite: 18]. En la tapa grande A y en la tapa chica B, atornille 4 mini fix en las perforaciones[cite: 18].
  - *Herrajes:* Pernos mini fix con caja

**Paso 3:** Paso 3: Una un par de patas chicas D con el travesaño grande inferior F, usando como guía los tarugos que se encuentran en las patas y una vez encastrados girar las cajas de los mini fix 180 grados en sentido horario[cite: 18]. Luego repetir la operación con el par de patas chicas restantes y el travesaño grande superior E[cite: 18]. Finalmente una los travesaños haciendo coincidir el encastre y colocando desde abajo un tornillo de 2 cm (3,5x20)[cite: 18].
  - *Herrajes:* Pernos mini fix con caja, Tarugos 6x30, Tornillos de 2 cm

**Paso 4:** Paso 4: Una las patas chicas D con la tapa grande A haciendo coincidir los mini fix de esta con las cajas mini fix de las patas, una vez encastrados girar las cajas de los mini fix 180 grados en sentido horario, terminando así el armado de la mesa baja[cite: 18]. Repita el paso 2 y 3 utilizando las patas largas C, los travesaños chicos G-H y la tapa chica B para el armado de la mesa alta[cite: 18].
  - *Herrajes:* Pernos mini fix con caja, Tarugos 6x30, Tornillos de 2 cm
  - 💡 *Consejo Pro:* Alineación de cajas de fijación: Observe que la flecha grabada en cada caja para mini fix debe estar perfectamente alineada hacia el orificio de entrada para que el perno pueda ingresar correctamente[cite: 18].

---

## 📦 Bahiut VIND con 3 puertas abrir (SKU: 405330)
- **Línea:** NORDIK
- **Dificultad:** Medio | **Tiempo estimado:** 45 min
- **Herramientas necesarias:** Martillo de carpintero, Destornillador de punta en cruz, 1 Llave Allen, Usar regla para verificar tamaño de tornillos
- **Visor 3D Interactivo:** https://www.mueblesgacela.com.ar/armado/405330

### 🔩 Herrajes incluidos:
- Bisagras codo 0 cazoleta 26 (6 u.)
- Tornillos Allen o Phillips de 5 cm (30 u.)
- Pernos mini fix con caja (4 u.)
- Soporte de estantes (4 u.)
- Tornillos de 4 cm (10 u.)
- Tarugos 6x30 (6 u.)
- Set de Clavos (1 u.)
- Tornillos de 1.5 cm (24 u.)
- Tornillos de 2,5 cm (6 u.)

### 📐 Piezas y Despiece:
- Letra A: Tapa (1 u.) - Medidas: 136,8 x 43 cm
- Letra B: Piso (1 u.) - Medidas: 140 x 44,5 cm
- Letra C: Costado izquierdo (1 u.) - Medidas: 80 x 44,5 cm
- Letra D: Costado derecho (1 u.) - Medidas: 80 x 44,5 cm
- Letra I: Base patas (1 u.) - Medidas: 130 x 39,5 cm
- Letra E: Faja fondo (1 u.) - Medidas: 136,8 x 6 cm
- Letra F: Estante fijo (2 u.) - Medidas: 44,6 x 40 cm
- Letra G: Estante móvil (1 u.) - Medidas: 44,6 x 40 cm
- Letra M: Separador izquierdo (1 u.) - Medidas: 77 x 44,5 cm
- Letra N: Separador derecho (1 u.) - Medidas: 77 x 44,5 cm
- Letra J: Puerta izquierda (1 u.) - Medidas: 80 x 45,8 cm
- Letra K: Puerta derecha (1 u.) - Medidas: 80 x 45,8 cm
- Letra L: Puerta centro (1 u.) - Medidas: 80 x 47,6 cm
- Letra -: Zócalo frente (2 u.) - Medidas: 115,5 x 8 cm
- Letra -: Zócalo lateral (2 u.) - Medidas: 32 x 8 cm
- Letra -: Fondo mueble (3 u.) - Medidas: 79,5 x 46 cm
- Letra -: Patas macizas (5 u.) - Medidas: 19 x 7,5 cm

### 🪜 Paso a Paso de Armado:
**Paso 1:** Paso 1: Prepare el separador derecho N, colocando a presión 2 cajas para mini fix, 2 soportes de estantes y 2 bases de bisagra mediante 4 tornillos de 1,5 cm, en las perforaciones que muestra la figura. En el separador izquierdo M solo coloque a presión 2 cajas para mini fix, 2 soportes de estantes, tener en cuenta que son simétricos. Tanto en el costado izquierdo C como en el derecho D solo atornille las bases de bisagras. [cite: 2329, 2330, 2331]
  - *Herrajes:* Pernos mini fix con caja, Soportes de estantes, Tornillos de 1.5 cm

**Paso 2:** Paso 2: Tanto en la puerta central L como en las puertas laterales J - K coloque 2 bisagras mediante los tornillos de 1,5 cm. [cite: 2334]
  - *Herrajes:* Bisagras codo 0 cazoleta 26, Tornillos de 1.5 cm

**Paso 3:** Paso 3: En la Tapa A, atornille 4 Pernos mini fix cubriendo todas las perforaciones. [cite: 2335]
  - *Herrajes:* Pernos mini fix con caja

**Paso 4:** Paso 4: En la faja fondo E coloque a presión 4 tarugos guías. [cite: 2336]
  - *Herrajes:* Tarugos 6x30

**Paso 5:** Paso 5: Encastre las patas macizas en la base de patas I, para luego ajustarla desde arriba por medio de los tornillos Allen de 5 cm. A su vez coloque a presión dos tarugos guías 6x30. [cite: 2342, 2343]
  - *Herrajes:* Tornillos Allen o Phillips de 5 cm, Tarugos 6x30

**Paso 6:** Paso 6: Acoplar los separadores M - N a la Tapa A introduciendo los pernos mini fix de esta en las perforaciones con caja mini fix de los primeros mencionados, luego ajuste las piezas girando 180 grados en sentido horario las cajas mini fix. Luego por medio de los tornillos Allen de 5 cm una el costado derecho D con la tapa A y un estante fijo F y este unirlo al separador derecho N. De igual manera unir el costado izquierdo C con el estante fijo restante y el separador izquierdo M. Previamente a la unión de los costados con la tapa introducir los tarugos de la faja fondo E in las perforaciones de los costados. [cite: 2346, 2347, 2348, 2349, 2350, 2351, 2360]
  - *Herrajes:* Pernos mini fix con caja, Tornillos Allen o Phillips de 5 cm, Tarugos 6x30

**Paso 7:** Paso 7: Desde atrás unir la faja fondo E a la tapa A por medio de dos tornillos de 4 cm. Luego por medio de 8 tornillos Allen de 5 cm una el piso B a los costados C-D y a los separadores M-N. Seguidamente clave los fondos de 3 mm, tal como lo indica el gráfico, siguiendo el orden correcto y las escuadras justas del mueble. Posteriormente distribuya los clavos a una distancia aproximada de 15 cm entre ellos, proporcionándole la rigidez necesaria al mueble. (1 vértice A-C, 2 vértice de A-M, 3 vértice C-B, 4 vértice de B-M). Repetir para el resto de los fondos. Finalmente deslice el estante móvil G sobre los soportes previamente colocados en los separadores. [cite: 2368, 2369, 2370, 2371, 2374, 2375, 2376, 2377, 2378, 2379]
  - *Herrajes:* Tornillos de 4 cm, Tornillos Allen o Phillips de 5 cm, Set de Clavos, Soportes de estantes

**Paso 8:** Paso 8: Para terminar de armar la base de patas I, mediante los tornillos de 4 cm vincule las fajas laterales hacia las fajas frentes, para finalmente unir estas hacia las patas Macizas, tal como lo indica la figura. [cite: 2389, 2390]
  - *Herrajes:* Tornillos de 4 cm

**Paso 9:** Paso 9: Una vez armado la base de patas I ajuste este hacia el piso B, a través de los 6 tornillos de 2,5 cm y utilizando como guía las perforaciones donde van los dos tarugos 6 x 30. LOS TARUGOS SOLO SIRVEN DE GUÍA NO GOLPEARLOS. Finalmente coloque las Puertas J-L-K en las bases de bisagras colocadas en los Costados C-D y del separador derecho N, Utilizando como guía las indicaciones de 'Colocación de bisagra' y 'Regulación de bisagra'. [cite: 2383, 2384, 2385, 2386]
  - *Herrajes:* Tornillos de 2,5 cm, Tarugos 6x30, Bisagras codo 0 cazoleta 26
  - 💡 *Consejo Pro:* Regulación de puertas: El tornillo de regulación de profundidad debe encontrarse en la mitad de su recorrido antes de encastrar la bisagra en su base. [cite: 2395, 2402]

---

## 📦 Rack NORDEN con 3 puertas abrir (SKU: 446330)
- **Línea:** NORDIK
- **Dificultad:** Medio | **Tiempo estimado:** 45 min
- **Herramientas necesarias:** Martillo de carpintero, Destornillador de punta en cruz, 1 Llave Allen, Usar regla para verificar tamaño de tornillos
- **Visor 3D Interactivo:** https://www.mueblesgacela.com.ar/armado/446330

### 🔩 Herrajes incluidos:
- Bisagras codo 0 cazoleta 26 (6 u.)
- Tornillos Allen o Phillips de 5 cm (20 u.)
- Pernos mini fix con caja (4 u.)
- Soporte de estantes (12 u.)
- Tornillos de 4 cm (12 u.)
- Tarugos 6x30 (6 u.)
- Set de Clavos (1 u.)
- Tornillos de 2.5 cm (6 u.)
- Tornillos de 1.5 cm (24 u.)

### 📐 Piezas y Despiece:
- Letra A: Tapa (1 u.) - Medidas: 157 x 38,5 cm
- Letra B: Piso (1 u.) - Medidas: 160 x 40 cm
- Letra C: Costado izquierdo (1 u.) - Medidas: 40 x 40 cm
- Letra D: Costado derecho (1 u.) - Medidas: 40 x 40 cm
- Letra E: Faja fondo (1 u.) - Medidas: 137 x 6 cm
- Letra M: Separador izquierdo (1 u.) - Medidas: 37 x 38,5 cm
- Letra N: Separador derecho (1 u.) - Medidas: 37 x 38,5 cm
- Letra G: Estante móvil (3 u.) - Medidas: 51,3 x 32 cm
- Letra J: Puerta izquierda (1 u.) - Medidas: 52,5 x 40 cm
- Letra K: Puerta derecha (1 u.) - Medidas: 54,3 x 40 cm
- Letra L: Puerta centro (1 u.) - Medidas: 52,5 x 40 cm
- Letra I: Base patas (1 u.) - Medidas: 150 x 35 cm
- Letra -: Zócalo frente (2 u.) - Medidas: 135,5 x 8 cm
- Letra -: Zócalo lateral (2 u.) - Medidas: 25,7 x 8 cm
- Letra -: Fondo mueble (1 u.) - Medidas: 159,5 x 39,5 cm
- Letra -: Patas macizas (5 u.) - Medidas: 19 x 7,5 cm

### 🪜 Paso a Paso de Armado:
**Paso 1:** Paso 1: Prepare el separador derecho N, colocando a presión 2 cajas para mini fix, 2 soportes de estantes y 2 bases de bisagra mediante 4 tornillos de 1,5 cm en las perforaciones de la pieza[cite: 18]. En el separador izquierdo M solo coloque a presión 2 cajas para mini fix y 2 soportes de estantes, teniendo en cuenta que son simétricos[cite: 18]. Tanto en el costado izquierdo C como en el derecho D solo coloque a presión los soportes de estantes y atornille las bases de bisagras[cite: 18].
  - *Herrajes:* Pernos mini fix con caja, Soporte de estantes, Tornillos de 1.5 cm

**Paso 2:** Paso 2: Tanto en la puerta central L como en las puertas laterales J - K coloque 2 bisagras mediante los tornillos de 1,5 cm[cite: 18].
  - *Herrajes:* Bisagras codo 0 cazoleta 26, Tornillos de 1.5 cm

**Paso 3:** Paso 3: En la Tapa A, atornille 4 Pernos mini fix cubriendo todas las perforaciones[cite: 18].
  - *Herrajes:* Pernos mini fix con caja

**Paso 4:** Paso 4: En la faja fondo E coloque a presión 4 tarugos guías[cite: 18].
  - *Herrajes:* Tarugos 6x30

**Paso 5:** Paso 5: Encastre las patas macizas en la base de patas I, para luego ajustarla desde arriba por medio de los tornillos Allen de 5 cm[cite: 18]. A su vez coloque a presión dos tarugos guías 6x30[cite: 18].
  - *Herrajes:* Tornillos Allen o Phillips de 5 cm, Tarugos 6x30

**Paso 6:** Paso 6: Acoplar los separadores M - N a la tapa A introduciendo los pernos minifix de esta en las perforaciones con caja minifix de los primeros mencionados, luego ajuste las piezas girando 180 grados en sentido horario las cajas mini fix[cite: 18]. Verifique que el canto frente de los separadores coincida con el canto frente de la tapa[cite: 18]. Luego por medio de 4 tornillos Allen de 5 cm una los costados C-D[cite: 18]. Previamente a la unión de los costados con la tapa introducir los tarugos de la faja fondo E en las perforaciones de los costados[cite: 18]. Seguidamente por medio de 8 tornillos Allen de 5 cm una el piso B a los costados C-D y a los separadores M-N[cite: 18].
  - *Herrajes:* Pernos mini fix con caja, Tornillos Allen o Phillips de 5 cm, Tarugos 6x30

**Paso 7:** Paso 7: Desde atrás unir la faja fondo E a la tapa A por medio de dos tornillos de 4 cm[cite: 18]. Seguidamente clave los fondos de 3 mm, tal como lo indica el gráfico, siguiendo el orden correcto y la escuadra justa del mueble[cite: 18]. Posteriormente distribuya los clavos a una distancia aproximada de 15 cm entre ellos, proporcionándole la rigidez necesaria al mueble (1 vértice B-C, 2 vértice B-D, 3 vértice A-B, 4 vértice A-D)[cite: 18]. Finalmente deslice los estantes móviles G sobre los soportes previamente colocados en los separadores y los costados[cite: 18].
  - *Herrajes:* Tornillos de 4 cm, Set de Clavos, Soporte de estantes

**Paso 8:** Paso 8: Para terminar de armar la base de patas I, mediante los tornillos de 4 cm vincule las fajas laterales hacia las fajas frentes, para finalmente unir estas hacia las patas Macizas, tal como lo indica la figura[cite: 18]. Luego desde arriba una los zócalos frente con la base por medio de los mismos tornillos[cite: 18].
  - *Herrajes:* Tornillos de 4 cm

**Paso 9:** Paso 9: Una vez armado la base de patas I ajuste este hacia el piso B, a través de los 6 tornillos de 2,5 cm y utilizando como guía las perforaciones donde van los dos tarugos 6 x 30[cite: 18]. LOS TARUGOS SOLO SIRVEN DE GUÍA NO GOLPEARLOS[cite: 18]. Finalmente coloque las Puertas J-L-K en las bases de bisagras colocadas en los Costados C-D y del separador derecho N, Utilizando como guía las indicaciones de 'Colocación de bisagra' y 'Regulación de bisagra'[cite: 18].
  - *Herrajes:* Tornillos de 2.5 cm, Tarugos 6x30, Bisagras codo 0 cazoleta 26
  - 💡 *Consejo Pro:* Regulación de bisagras: El tornillo de regulación de profundidad debe encontrarse en la mitad de su recorrido antes de encastrar el cuerpo de la bisagra en la ranura en U de la base montada[cite: 18].

---

## 📦 Cómoda EIRA con 6 cajones (SKU: 716330)
- **Línea:** NORDIK
- **Dificultad:** Medio | **Tiempo estimado:** 90 min
- **Herramientas necesarias:** Martillo de carpintero, Destornillador de punta en cruz, 1 Llave Allen, Usar regla para verificar tamaño de tornillos
- **Visor 3D Interactivo:** https://www.mueblesgacela.com.ar/armado/716330

### 🔩 Herrajes incluidos:
- Envase de cola (1 u.)
- Tornillos Allen o phillips de 5 cm (20 u.)
- Tornillos de 2,5 cm (6 u.)
- Corner (4 u.)
- Pares de guías metálicas de 35 cm (6 u.)
- Tornillos varianta (24 u.)
- Tornillos de 1,5 cm (8 u.)
- Tornillos de 4 cm (21 u.)
- Pernos mini fix con caja (14 u.)
- Tarugos 6x30 (50 u.)
- Tornillos de 2 cm (20 u.)
- Set de Clavos (1 u.)

### 📐 Piezas y Despiece:
- Letra A: Tapa (1 u.) - Medidas: 117 x 43 cm
- Letra B: Piso (1 u.) - Medidas: 120 x 44,5 cm
- Letra C: Costado izquierdo (1 u.) - Medidas: 44,5 x 66,3 cm
- Letra D: Costado derecho (1 u.) - Medidas: 44,5 x 66,3 cm
- Letra E: Faja fondo (1 u.) - Medidas: 117 x 6 cm
- Letra F: Base de patas (1 u.) - Medidas: 110 x 39,5 cm
- Letra -: Zócalo frente (2 u.) - Medidas: 95,5 x 8 cm
- Letra -: Zócalo lateral (2 u.) - Medidas: 32 x 8 cm
- Letra -: Faja unión (2 u.) - Medidas: 57,7 x 6 cm
- Letra O: Frente cajón izquierdo (3 u.) - Medidas: 59,8 x 21,9 cm
- Letra P: Frente cajón derecho (3 u.) - Medidas: 59,8 x 21,9 cm
- Letra -: Fondo de mueble (2 u.) - Medidas: 119,5 x 32,5 cm
- Letra -: Patas (5 u.) - Medidas: 19 x 7,5 cm
- Letra -: Piso cajón (6 u.) - Medidas: 55 x 37,8 cm
- Letra G: Separador (1 u.) - Medidas: 63,3 x 44,5 cm
- Letra M: Costado cajón (12 u.) - Medidas: 40 x 14 cm
- Letra N: Fondo cajón (6 u.) - Medidas: 52 x 14 cm

### 🪜 Paso a Paso de Armado:
**Paso 1:** Paso 1: Prepare el costado derecho D, colocando 3 guías metálica fijas derechas mediante los tornillos varianta[cite: 18]. Realice el mismo procedimiento en el costado izquierdo C, teniendo en cuenta que es simétrico[cite: 18]. En el separador G, coloque a presión dos cajas mini fix; en la cara izquierda atornille 3 guías metálicas fijas derechas mediante los tornillos varianta y en la cara derecha las guías metálicas fijas izquierdas, verificando que los tornillos variantas no ingresen en la misma perforación[cite: 18]. En la tapa A atornille 2 pernos mini fix[cite: 18].
  - *Herrajes:* Pares de guías metálicas de 35 cm, Tornillos varianta, Pernos mini fix con caja

**Paso 2:** Paso 2: En las fajas unión coloque a presión 4 tarugos guías de 6x30, y por medio de los tornillos de 1,5 cm fije 2 escuadras metálicas (corner), quedando estas en línea con el borde[cite: 18]. En la faja fondo E coloque 4 tarugos guías de 6x30[cite: 18].
  - *Herrajes:* Tarugos 6x30, Tornillos de 1,5 cm, Corner

**Paso 3:** Paso 3: Encastre las patas macizas, para luego ajustarlas desde arriba mediante los tornillos Allen de 5 cm hacia la base de las patas F[cite: 18]. A su vez coloque a presión dos tarugos guías 6x30[cite: 18].
  - *Herrajes:* Tornillos Allen o phillips de 5 cm, Tarugos 6x30

**Paso 4:** Paso 4: Luego y mediante los tornillos de 4 cm, vincule las fajas laterales (zócalos laterales) hacia las fajas frentes (zócalos frente), para finalmente unir estas hacia las patas Macizas, tal como lo indica la figura[cite: 18].
  - *Herrajes:* Tornillos de 4 cm

**Paso 5:** Paso 5: Desde arriba una la tapa A al separador G haciendo coincidir los pernos mini fix del primero con las perforaciones de las cajas mini fix del segundo usando como guía los tarugos del separador, luego ajuste las piezas girando las cajas mini fix 180° en sentido horario[cite: 18]. Luego haga coincidir los tarugos de las fajas unión y fíjelas al separador por medio de 2 tornillos de 1,5 cm a través de las escuadras[cite: 18]. Seguidamente una la tapa A a los costados C - D, por medio de 4 tornillos Allen de 5, previamente haga coincidir los tarugos de la faja fondo E y de las fajas unión con las perforaciones de los costados, y fije estas últimas por medio de 2 tornillos de 1,5 cm a través de las escuadras[cite: 18].
  - *Herrajes:* Pernos mini fix con caja, Tarugos 6x30, Tornillos de 1,5 cm, Tornillos Allen o phillips de 5 cm

**Paso 6:** Paso 6: Una el piso B con los costados C - D y el separador G mediante 6 tornillos Allen de 5 cm, verificando que el canto melamínico quede hacia el frente y las perforaciones del piso que sirven como guía queden hacia abajo[cite: 18]. Desde atrás y por medio de un tornillo de 4 cm una la faja fondo E con la tapa A[cite: 18]. Clave los fondos de mueble, tal como lo indica el gráfico, siguiendo el orden correcto y las escuadras justas del mueble[cite: 18]. Posteriormente distribuya los clavos a una distancia aproximada de 15 cm entre ellos, proporcionándole la rigidez necesaria al mueble (1 Vértice B - C, 2 Vértice B - D, 3 Mitad de C, 4 Mitad de D) y repita el procedimiento con el fondo restante[cite: 18].
  - *Herrajes:* Tornillos Allen o phillips de 5 cm, Tornillos de 4 cm, Set de Clavos

**Paso 7:** Paso 7 armado de cajones: Los 6 cajones se arman de igual manera, en este ejemplo armamos el cajón con frente derecho[cite: 18]. Coloque 2 tarugos 6 x 30 en el fondo de cajón N, 2 más en cada uno de los costados de cajón M a su vez encastrar las cajas mini fix[cite: 18]. Agregar adhesivo en cada perforación donde lleve tarugo[cite: 18].
  - *Herrajes:* Tarugos 6x30, Pernos mini fix con caja, Envase de cola

**Paso 8:** Paso 8 armado de cajones: En el frente de cajón derecho P (u O para el izquierdo) atornillar dos pernos mini fix[cite: 18].
  - *Herrajes:* Pernos mini fix con caja

**Paso 9:** Paso 9 armado de cajones: Una vez armada la estructura tipo 'U' entre M-N-M, ingrese el frente de cajón derecho P (u O) y ajuste los pernos mini fix girando 180 grados las cajas mini fix, habiendo agregado el adhesivo anteriormente[cite: 18]. Luego ajuste el fondo y los costados mediante los dos tornillos 4 cm[cite: 18].
  - *Herrajes:* Pernos mini fix con caja, Envase de cola, Tornillos de 4 cm

**Paso 10:** Paso 10 armado de cajones: Desde abajo introduzca el piso de cajón sobre el canal del frente de cajón, y clave este siguiendo una escuadra correcta del cajón sobre los filos inferiores de los costados y del fondo[cite: 18]. Atornille las guías metálicas como muestra la figura mediante 4 tornillos 2 cm[cite: 18].
  - *Herrajes:* Set de Clavos, Pares de guías metálicas de 35 cm, Tornillos de 2 cm

**Paso 11:** Paso 11: Una vez armada la base de patas F ajuste esta hacia el piso B, a través de los 6 tornillos de 2,5 cm y utilizando como guía las perforaciones donde van los dos tarugos 6 x 30. LOS TARUGOS SOLO SIRVEN DE GUÍA NO GOLPEARLOS[cite: 18]. Finalmente coloque los cajones ya armados sobre las guías fijas ya colocadas en los costados C - D y el separador G según la posición que indica el frente[cite: 18].
  - *Herrajes:* Tornillos de 2,5 cm, Tarugos 6x30, Pares de guías metálicas de 35 cm

**Paso 12:** Paso 12 Colocación de cajones: Colocar los cajones sobre las guías fijas que se encuentran ya en el mueble, como lo muestra la imagen[cite: 18].
  - *Herrajes:* Pares de guías metálicas de 35 cm
  - 💡 *Consejo Pro:* Desplazamiento inicial: Al insertar los cajones por primera vez, verifique que las ruedas de la guía móvil calcen correctamente sobre la pista de la guía fija en el mueble para evitar atascos[cite: 18].

---

## 📦 Mesa de Luz ARKA con 1 cajón (SKU: 732330)
- **Línea:** NORDIK
- **Dificultad:** Medio | **Tiempo estimado:** 30 min
- **Herramientas necesarias:** Martillo de carpintero, Destornillador de punta en cruz, 1 Llave Allen, Usar regla para verificar tamaño de tornillos
- **Visor 3D Interactivo:** https://www.mueblesgacela.com.ar/armado/732330

### 🔩 Herrajes incluidos:
- Envase de cola (1 u.)
- Tornillos Allen o philips de 5 cm (16 u.)
- Tornillos de 2,5 cm (4 u.)
- Tornillos varianta (4 u.)
- Par de guías metálicas de 35 cm (1 u.)
- Pernos mini fix con caja (2 u.)
- Tornillos de 4 cm (10 u.)
- Tarugos 6x30 (12 u.)
- Tornillos de 2 cm (4 u.)
- Set de Clavos (1 u.)

### 📐 Piezas y Despiece:
- Letra A: Tapa (1 u.) - Medidas: 42 x 38,5 cm
- Letra B: Piso (1 u.) - Medidas: 45 x 40 cm
- Letra C: Costado izquierdo (1 u.) - Medidas: 42 x 40 cm
- Letra D: Costado derecho (1 u.) - Medidas: 42 x 40 cm
- Letra E: Fondo (1 u.) - Medidas: 42 x 6 cm
- Letra F: Base de patas (1 u.) - Medidas: 40 x 35 cm
- Letra -: Zócalo frente (2 u.) - Medidas: 30 x 8 cm
- Letra -: Zócalo lateral (4 u.) - Medidas: 25,7 x 8 cm
- Letra O: Frente cajón (1 u.) - Medidas: 45 x 18 cm
- Letra M: Costado cajón (2 u.) - Medidas: 35 x 10 cm
- Letra N: Fondo cajón (1 u.) - Medidas: 36,4 x 10 cm
- Letra -: Fondo mueble (1 u.) - Medidas: 44,6 x 41 cm
- Letra -: Patas (4 u.) - Medidas: 19 x 7,5 cm
- Letra -: Piso cajón (1 u.) - Medidas: 39,2 x 32,8 cm

### 🪜 Paso a Paso de Armado:
**Paso 1:** Paso 1: Prepare el costado derecho D, colocando la guía metálica fija derecha mediante los tornillos varianta[cite: 18]. Realice el mismo procedimiento en el costado izquierdo C, teniendo en cuenta que es simétrico[cite: 18]. En el fondo E coloque 4 tarugos guías de 6x30, ocupando todas las perforaciones[cite: 18].
  - *Herrajes:* Par de guías metálicas de 35 cm, Tornillos varianta, Tarugos 6x30

**Paso 2:** Paso 2: Una la tapa A a los costados C - D, por medio de 4 tornillos Allen de 5, previamente haga coincidir los tarugos del fondo E, con las perforaciones de los costados[cite: 18]. Una el piso B desde abajo ajustando con 4 tornillos Allen de 5 cm a los costados[cite: 18].
  - *Herrajes:* Tornillos Allen o philips de 5 cm, Tarugos 6x30

**Paso 3:** Paso 3: Encastre las patas macizas, para luego ajustarlas desde arriba mediante los tornillos Allen de 5 cm hacia la base de las patas F[cite: 18]. A su vez coloque a presión dos tarugos guías 6x30[cite: 18].
  - *Herrajes:* Tornillos Allen o philips de 5 cm, Tarugos 6x30

**Paso 4:** Paso 4: Luego y mediante los tornillos de 4 cm, vincule las fajas laterales hacia las fajas frentes, para finalmente unir estas hacia las patas Macizas, tal como lo indica la figura[cite: 18].
  - *Herrajes:* Tornillos de 4 cm

**Paso 5:** Paso 5 armado de cajones: Coloque 2 tarugos 6x30 en el fondo de cajón N, 2 mas en cada uno de los costados de cajón M a su vez encastrar las cajas mini fix[cite: 18]. Agregar adhesivo en cada perforación donde lleve tarugo[cite: 18].
  - *Herrajes:* Tarugos 6x30, Pernos mini fix con caja, Envase de cola

**Paso 6:** Paso 6 armado de cajones: En el frente de cajón O atornillar dos pernos mini fix[cite: 18].
  - *Herrajes:* Pernos mini fix con caja

**Paso 7:** Paso 7 armado de cajones: Una vez armada la estructura tipo 'U' entre M-N-M, ingrese el frente de cajón O ajuste los pernos mini fix girando 180 grados las cajas mini fix[cite: 18]. Habiendo agregado el adhesivo anteriormente[cite: 18]. Luego ajuste el fondo y los costados mediante los dos tornillos 4 cm[cite: 18].
  - *Herrajes:* Pernos mini fix con caja, Envase de cola, Tornillos de 4 cm

**Paso 8:** Paso 8 armado de cajones: Desde abajo introduzca el piso de cajón sobre el canal del frente de cajón O, y clave este siguiendo una escuadra correcta del cajón sobre los filos inferiores de los costados y del fondo[cite: 18]. Atornille las guías metálicas como muestra la figura mediante 4 tornillos 2 cm[cite: 18].
  - *Herrajes:* Set de Clavos, Par de guías metálicas de 35 cm, Tornillos de 2 cm

**Paso 9:** Paso 9: Con el mueble acostado clave el fondo de mueble de 3 mm, tal como lo indica el grafico, siguiendo el orden correcto y la escuadras justa del mueble (1 vértice C - E, 2 vértice E - D, 3 vértice B - D, 4 vértice B - C)[cite: 18]. Posteriormente distribuya los clavos a una distancia aproximada de 15 cm entre ellos, proporcionándole la rigidez necesaria al mueble[cite: 18]. Una vez armado la base de patas F ajuste este hacia el piso B, a través de los 4 tornillos de 2,5 cm y utilizando como guía las perforaciones donde van los dos tarugos 6 x 30[cite: 18]. LOS TARUGOS SOLO SIRVEN DE GUIA NO GOLPEARLOS[cite: 18]. Finalmente coloque el cajón ya armado sobre las guías fijas ya colocadas en los costados[cite: 18].
  - *Herrajes:* Set de Clavos, Tornillos de 2,5 cm, Tarugos 6x30, Par de guías metálicas de 35 cm

**Paso 10:** Paso 10 colocación de cajones: Colocar los cajones sobre las guías fijas que se encuentran ya en el mueble, como lo muestra la imagen[cite: 18].
  - *Herrajes:* Par de guías metálicas de 35 cm
  - 💡 *Consejo Pro:* Colocación de cajones: Colocar los cajones de forma alineada sobre las guías fijas instaladas en los costados del mueble para asegurar su correcto deslizamiento[cite: 18].

---

## 📦 Placard VINTER con 2 puertas de abrir y 2 cajones (SKU: 742332)
- **Línea:** NORDIK
- **Dificultad:** Alto | **Tiempo estimado:** 90 min
- **Herramientas necesarias:** Martillo de carpintero, Destornillador de punta en cruz, 1 Llave Allen, Usar regla para verificar tamaño de tornillos
- **Visor 3D Interactivo:** https://www.mueblesgacela.com.ar/armado/742332

### 🔩 Herrajes incluidos:
- Envase de cola (1 u.)
- Tornillos Allen 5 cm (20 u.)
- Bisagras codo 9 cazoleta 26 (6 u.)
- Pernos mini fix con caja (4 u.)
- Pares de guías metálicas de 40 cm (2 u.)
- Caño de 57 cm (1 u.)
- Soporte de caños (2 u.)
- Tarugos 6x30 (14 u.)
- Llave Allen (1 u.)
- Tornillos varianta (8 u.)
- Tornillos de 1.5 cm (26 u.)
- Tornillos de 2 cm (8 u.)
- Tornillos de 2.5 cm (4 u.)
- Tornillos de 4 cm (12 u.)
- Set de Clavos (1 u.)

### 📐 Piezas y Despiece:
- Letra A: Tapa (1 u.) - Medidas: 60,8 x 44,5 cm
- Letra B: Piso (1 u.) - Medidas: 60,8 x 44,5 cm
- Letra C: Costado izquierdo (1 u.) - Medidas: 156,5 x 44,5 cm
- Letra D: Costado derecho (1 u.) - Medidas: 156,5 x 44,5 cm
- Letra F: Estante fijo (1 u.) - Medidas: 57,7 x 44,5 cm
- Letra J: Puerta corta sin manija (1 u.) - Medidas: 113 x 29,3 cm
- Letra K: Puerta corta con manija (1 u.) - Medidas: 113 x 29,3 cm
- Letra L: Frente cajón (2 u.) - Medidas: 59 x 22 cm
- Letra M: Costado cajón (4 u.) - Medidas: 40 x 14 cm
- Letra N: Fondo cajón (2 u.) - Medidas: 52,2 x 14 cm
- Letra -: Zócalo lateral (2 u.) - Medidas: 32 x 8 cm
- Letra -: Zócalo frente (2 u.) - Medidas: 37,5 x 8 cm
- Letra I: Base patas (1 u.) - Medidas: 50,8 x 39,5 cm
- Letra -: Fondo mueble (1 u.) - Medidas: 159 x 59,2 cm
- Letra -: Patas macizas (4 u.) - Medidas: 19 x 7,5 cm
- Letra -: Piso cajón (2 u.) - Medidas: 55 x 37,8 cm

### 🪜 Paso a Paso de Armado:
**Paso 1:** Paso 1: Prepare el costado derecho D, colocando 3 bases de bisagra mediante los tornillos de 1,5 cm, también el soporte plástico de caño haciéndolo encastrar en la perforación central y luego ajustándolo mediante un tornillo de 1,5 cm, como lo muestra la figura y atornille las guías metálica fijas derechas mediante los tornillos varianta. Realice el mismo procedimiento en el costado izquierdo C, teniendo en cuenta que es simétrico[cite: 18].
  - *Herrajes:* Tornillos de 1.5 cm, Soporte de caños, Pares de guías metálicas de 40 cm, Tornillos varianta

**Paso 2:** Paso 2: Tanto en la puerta cortas con manija K como en la puerta corta sin manija J coloque 3 bisagras mediante los tornillos 1,5 cm[cite: 18].
  - *Herrajes:* Bisagras codo 9 cazoleta 26, Tornillos de 1.5 cm

**Paso 3:** Paso 3: Encastre las patas macizas, para luego ajustarlas desde arriba mediante los tornillos Allen hacia la base de las patas I. A su vez coloque a presión dos tarugos guías 6x30[cite: 18].
  - *Herrajes:* Tornillos Allen 5 cm, Tarugos 6x30

**Paso 4:** Paso 4: Luego y mediante los tornillos de 4 cm, vincule las fajas laterales hacia las fajas frentes, para finalmente unir estas hacia las patas Macizas, tal como lo indica la figura[cite: 18].
  - *Herrajes:* Tornillos de 4 cm

**Paso 5:** Paso 5 armado de cajones: Coloque 2 tarugos 6x30 en el fondo de cajón N, 2 mas en cada uno de los costados de cajón M a su vez encastrar las cajas mini fix. Agregar adhesivo en cada perforación donde lleve tarugo[cite: 18].
  - *Herrajes:* Tarugos 6x30, Pernos mini fix con caja, Envase de cola

**Paso 6:** Paso 6: Atornille 2 minifix en el frente de cajón L[cite: 18].
  - *Herrajes:* Pernos mini fix con caja

**Paso 7:** Paso 7: Una vez armada la estructura tipo 'U' entre M-N-M, ingrese el frente de cajón L ajuste los pernos mini fix girando 180 grados las cajas mini fix. Habiendo agregado el adhesivo anteriormente. Luego ajuste el fondo y los costados mediante los dos tornillos de 4 cm[cite: 18].
  - *Herrajes:* Pernos mini fix con caja, Envase de cola, Tornillos de 4 cm

**Paso 8:** Paso 8: Desde abajo introduzca el piso de cajón sobre el canal del frente de cajón L, y clave este siguiendo una escuadra correcta del cajón sobre los filos inferiores de los costados y del fondo. Finalmente atornille las guías metálicas como muestra la figura mediante 4 tornillos de 2 cm[cite: 18].
  - *Herrajes:* Set de Clavos, Pares de guías metálicas de 40 cm, Tornillos de 2 cm

**Paso 9:** Paso 9: Mediante los tornillos Allen de 5 cm, una un estante fijo F con el costado derecho D y el costado izquierdo C. Desde arriba una la tapa A con los costados y luego desde abajo el piso B, teniendo en cuenta que las perforaciones de guía queden hacia abajo. Verifique que los cantos melaminicos queden hacia el frente[cite: 18].
  - *Herrajes:* Tornillos Allen 5 cm

**Paso 10:** Paso 10: Primero, con el mueble acostado clave los fondos de mueble de 3 mm, tal como lo indica el grafico, siguiendo el orden correcto y la escuadras justa del mueble. Posteriormente distribuya los clavos a una distancia aproximada de 15 cm entre ellos, proporcionándole la rigidez necesaria al mueble. (1 vértice A-D, 2 vértice A-C, 3 vértice B-D, 4 vértice B-C). Segundo, una vez armado la base de patas I con las patas macizas, ajuste este hacia el piso B, a través de los 4 tornillos de 2,5 cm y utilizando como guía las perforaciones donde van los dos tarugos 6 x 30, los cuales solo cumplen la función de guía (no golpear). También coloque el caño sobre los soportes plásticos previamente colocados en los costados C-D[cite: 18].
  - *Herrajes:* Set de Clavos, Tornillos de 2.5 cm, Tarugos 6x30

**Paso 11:** Paso 11: Finalmente coloque la puerta corta con manija K en el costados derecho D y la puerta corta sin manija J en el costados izquierdo C. Utilizando como guía las indicaciones de 'Regulación de bisagra'. Si lo requiere puede intercambiar la posición de las mismas[cite: 18].
  - *Herrajes:* Bisagras codo 9 cazoleta 26

**Paso 12:** Paso 12: Luego ingrese los cajones como indica la 'Colocación de cajones'[cite: 18].
  - *Herrajes:* Pares de guías metálicas de 40 cm
  - 💡 *Consejo Pro:* Alineación inicial: El tornillo de regulación de profundidad debe encontrarse en la mitad de su recorrido al colocar las bisagras por primera vez[cite: 18].

---

## 📦 Placard KLAR con 4 puertas de abrir y 2 cajones (SKU: 742334)
- **Línea:** NORDIK
- **Dificultad:** Alto | **Tiempo estimado:** 120 min
- **Herramientas necesarias:** Martillo de carpintero, Destornillador de punta en cruz, 1 Llave Allen, Usar regla para verificar tamaño de tornillos
- **Visor 3D Interactivo:** https://www.mueblesgacela.com.ar/armado/742334

### 🔩 Herrajes incluidos:
- Envase de cola (1 u.)
- Tornillos Allen 5 cm (30 u.)
- Bisagras cazoleta 26 (12 u.)
- Pernos mini fix con caja (4 u.)
- Pares de guías metálicas de 40 cm (2 u.)
- Soporte de estantes (8 u.)
- Tornillos varianta (8 u.)
- Tornillos de 1.5 cm (50 u.)
- Tornillos de 2 cm (8 u.)
- Tornillos de 2.5 cm (6 u.)
- Tornillos de 4 cm (12 u.)
- Set de Clavos (1 u.)
- Tarugos 6x30 (14 u.)
- Caño de 57 cm (1 u.)
- Soporte de caños (2 u.)

### 📐 Piezas y Despiece:
- Letra A: Tapa (1 u.) - Medidas: 120 x 44,5 cm
- Letra B: Piso (1 u.) - Medidas: 120 x 44,5 cm
- Letra E: Separador (1 u.) - Medidas: 156,5 x 44,5 cm
- Letra C: Costado izquierdo (1 u.) - Medidas: 156,5 x 44,5 cm
- Letra D: Costado derecho (1 u.) - Medidas: 156,5 x 44,5 cm
- Letra F: Estante fijo (1 u.) - Medidas: 57,7 x 44,5 cm
- Letra G: Estantes móviles (2 u.) - Medidas: 57,7 x 36 cm
- Letra H: Estante fijo chico (1 u.) - Medidas: 57,7 x 36 cm
- Letra J: Puerta corta sin manija (1 u.) - Medidas: 113 x 29,3 cm
- Letra K: Puerta corta con manija (1 u.) - Medidas: 113 x 29,3 cm
- Letra O: Puerta larga sin manija (1 u.) - Medidas: 157,7 x 29,3 cm
- Letra P: Puerta larga con manija (1 u.) - Medidas: 157,7 x 29,3 cm
- Letra -: Zócalo lateral (2 u.) - Medidas: 32 x 8 cm
- Letra -: Zócalo frente (2 u.) - Medidas: 95,5 x 8 cm
- Letra I: Base patas (1 u.) - Medidas: 110 x 39,5 cm
- Letra L: Frente cajón (2 u.) - Medidas: 59 x 22 cm
- Letra M: Costado cajón (4 u.) - Medidas: 40 x 14 cm
- Letra N: Fondo cajón (2 u.) - Medidas: 52,2 x 14 cm
- Letra -: Fondo mueble (2 u.) - Medidas: 159 x 59,2 cm
- Letra -: Patas macizas (5 u.) - Medidas: 19 x 7,5 cm
- Letra -: Piso cajón (2 u.) - Medidas: 55 x 37,8 cm

### 🪜 Paso a Paso de Armado:
**Paso 1:** Paso 1: Prepare el costado derecho D, colocando 3 bases de bisagra mediante los tornillos de 1,5 cm, también el soporte plástico de caño haciéndolo encastrar en la perforación central y luego ajustándolo mediante un tornillo de 1,5 cm, como lo muestra la figura y atornille las guías metálicas fijas derechas mediante los tornillos varianta. Repita el proceso en la cara derecha del separador E teniendo en cuenta que es simétrica, y debe colocar las guías metálicas fijas izquierdas[cite: 18].
  - *Herrajes:* Tornillos de 1.5 cm, Soporte de caños, Pares de guías metálicas de 40 cm, Tornillos varianta

**Paso 2:** Paso 2: Prepare el costado izquierdo C, colocando 3 bases de bisagra mediante los tornillos de 1,5 cm y a presión 4 soporte de estantes[cite: 18].
  - *Herrajes:* Tornillos de 1.5 cm, Soporte de estantes

**Paso 3:** Paso 3: Repita el proceso en la cara izquierda del separador E teniendo en cuenta que es simétrico[cite: 18].
  - *Herrajes:* Tornillos de 1.5 cm, Soporte de estantes

**Paso 4:** Paso 4: Tanto en la puerta corta con manija K como en la puerta corta sin manija J coloque 3 bisagras mediante los tornillos 1,5 cm. Repita el proceso en la puerta larga con manija P como en la puerta larga sin manija O[cite: 18].
  - *Herrajes:* Bisagras cazoleta 26, Tornillos de 1.5 cm

**Paso 5:** Paso 5: Encastre las patas macizas, para luego ajustarlas desde arriba mediante los tornillos Allen hacia la base de las patas I. A su vez coloque a presión dos tarugos guías 6x30[cite: 18].
  - *Herrajes:* Tornillos Allen 5 cm, Tarugos 6x30

**Paso 6:** Paso 6: Luego y mediante los tornillos de 4 cm, vincule las fajas laterales hacia las fajas frentes, para finalmente unir estas hacia las patas Macizas, tal como lo indica la figura[cite: 18].
  - *Herrajes:* Tornillos de 4 cm

**Paso 7:** Paso 7 Armado de cajones: Coloque 2 tarugos 6x30 en el fondo de cajón N, 2 mas en cada uno de los costados de cajón M a su vez encastrar las cajas mini fix. Agregar adhesivo en cada perforación donde lleve tarugo[cite: 18].
  - *Herrajes:* Tarugos 6x30, Pernos mini fix con caja, Envase de cola

**Paso 8:** Paso 8 Armado de cajones: Atornille 2 minifix en el frente de cajón L[cite: 18].
  - *Herrajes:* Pernos mini fix con caja

**Paso 9:** Paso 9 Armado de cajones: Una vez armada la estructura tipo 'U' entre M-N-M, ingrese el frente de cajón L ajuste los pernos mini fix girando 180 grados las cajas mini fix. Habiendo agregado el adhesivo anteriormente. Luego ajuste el fondo y los costados mediante los dos tornillos de 4 cm[cite: 18].
  - *Herrajes:* Pernos mini fix con caja, Envase de cola, Tornillos de 4 cm

**Paso 10:** Paso 10 Armado de cajones: Desde abajo introduzca el piso de cajón sobre el canal del frente de cajón L, y clave este siguiendo una escuadra correcta del cajón sobre los filos inferiores de los costados y del fondo. Finalmente atornille las guías metálicas como muestra la figura mediante 4 tornillos de 2 cm[cite: 18].
  - *Herrajes:* Set de Clavos, Pares de guías metálicas de 40 cm, Tornillos de 2 cm

**Paso 11:** Paso 11: Mediante los tornillos Allen de 5 cm, una el estante fijo F con el costado derecho D, y con el separador E. Luego el separador con el estante fijo chico H y este con el costado izquierdo C. Desde arriba una la tapa A con el costado derecho, el costado izquierdo y el separador y luego desde abajo el piso B, corroborando que las perforaciones no pasantes queden hacia abajo. Verifique que los cantos melaminicos queden hacia el frente[cite: 18].
  - *Herrajes:* Tornillos Allen 5 cm

**Paso 12:** Paso 12: Primero, con el mueble acostado clave los fondos de mueble de 3 mm, tal como lo indica el grafico, siguiendo el orden correcto y la escuadras justa del mueble. Posteriormente distribuya los clavos a una distancia aproximada de 15 cm entre ellos, proporcionándole la rigidez necesaria al mueble. (1 vértice A - D, 2 vértice A - E, 3 vértice B - D, 4 vértice B - E). Repita el proceso para el fondo restante. Una vez armado la base de patas I con las patas macizas, ajuste este hacia el piso B, a través de los 4 tornillos de 2,5 cm y utilizando como guía las perforaciones donde van los dos tarugos 6 x 30, los cuales solo cumplen la función de guía (no golpear). Finalmente deslice los estantes móviles G sobre los soportes de estantes colocados en el costado C y en el separador E. También coloque el caño sobre los soportes plásticos previamente colocados en el costado D y en el separador E[cite: 18].
  - *Herrajes:* Set de Clavos, Tornillos de 2.5 cm, Tarugos 6x30, Soporte de estantes

**Paso 13:** Paso 13: Finalmente coloque la puerta corta con manija K en el separador E y la puerta corta sin manija J en el costado derecho D. Utilizando como guía las indicaciones de 'Regulación de bisagra'. Si lo requiere puede intercambiar la posición de las mismas. Coloque la puerta larga con manija P en el separador E y la puerta larga sin manija O en el costado izquierdo C. Si lo requiere puede intercambiar la posición de las mismas[cite: 18].
  - *Herrajes:* Bisagras cazoleta 26

**Paso 14:** Paso 14: Luego ingrese los cajones como indica la 'Colocación de cajones'[cite: 18].
  - *Herrajes:* Pares de guías metálicas de 40 cm
  - 💡 *Consejo Pro:* Regulación de bisagras: El tornillo de regulación de profundidad debe encontrarse en la mitad de su recorrido al colocar las bisagras por primera vez[cite: 18].

---

## 📦 Placard STRAND con 6 puertas de abrir y 4 cajones (SKU: 742336)
- **Línea:** NORDIK
- **Dificultad:** Alto | **Tiempo estimado:** 150 min
- **Herramientas necesarias:** Martillo de carpintero, Destornillador de punta en cruz, 1 Llave Allen, Usar regla para verificar tamaño de tornillos
- **Visor 3D Interactivo:** https://www.mueblesgacela.com.ar/armado/742336

### 🔩 Herrajes incluidos:
- Envase de cola (1 u.)
- Tornillos Allen 5 cm (40 u.)
- Bisagras codo 9 cazoleta 26 (18 u.)
- Pernos mini fix con caja (8 u.)
- Tornillos varianta (16 u.)
- Pares de guías metálicas de 40 cm (4 u.)
- Tornillos de 1.5 cm (76 u.)
- Tornillos de 2 cm (16 u.)
- Tornillos de 2.5 cm (8 u.)
- Tornillos de 4 cm (18 u.)
- Tarugos 6x30 (26 u.)
- Caños de 57 cm (2 u.)
- Soporte de caños (4 u.)
- Soporte de estantes (8 u.)
- Set de Clavos (1 u.)

### 📐 Piezas y Despiece:
- Letra A: Tapa (1 u.) - Medidas: 179,2 x 44,5 cm
- Letra B: Piso (1 u.) - Medidas: 179,2 x 44,5 cm
- Letra C: Costado izquierdo (1 u.) - Medidas: 156,5 x 44,5 cm
- Letra D: Costado derecho (1 u.) - Medidas: 156,5 x 44,5 cm
- Letra E: Separador derecho (1 u.) - Medidas: 156,5 x 44,5 cm
- Letra Q: Separador izquierdo (1 u.) - Medidas: 156,5 x 44,5 cm
- Letra F: Estante fijo (2 u.) - Medidas: 57,7 x 44,5 cm
- Letra G: Estante móvil (2 u.) - Medidas: 57,7 x 36 cm
- Letra H: Estante fijo chico (1 u.) - Medidas: 57,7 x 36 cm
- Letra I: Base patas (1 u.) - Medidas: 169,2 x 39,5 cm
- Letra J: Puerta corta sin manija (2 u.) - Medidas: 113 x 29,3 cm
- Letra K: Puerta corta con manija (2 u.) - Medidas: 113 x 29,3 cm
- Letra O: Puerta larga sin manija (1 u.) - Medidas: 157,7 x 29,3 cm
- Letra P: Puerta larga con manija (1 u.) - Medidas: 157,7 x 29,3 cm
- Letra L: Frente cajón (4 u.) - Medidas: 59 x 22 cm
- Letra M: Costado cajón (8 u.) - Medidas: 40 x 14 cm
- Letra N: Fondo cajón (4 u.) - Medidas: 52,2 x 14 cm
- Letra -: Fondo mueble (3 u.) - Medidas: 159 x 59,2 cm
- Letra -: Patas macizas (6 u.) - Medidas: 19 x 7,5 cm
- Letra -: Piso cajón (4 u.) - Medidas: 55 x 37,8 cm
- Letra -: Zócalo lateral (2 u.) - Medidas: 32 x 8 cm
- Letra -: Zócalo frente (2 u.) - Medidas: 32 x 8 cm

### 🪜 Paso a Paso de Armado:
**Paso 1:** Paso 1: Prepare el costado derecho D, colocando 3 bases de bisagra mediante los tornillos de 1,5 cm, también el soporte plástico de caño haciéndolo encastrar en la perforación central y luego ajustándolo mediante un tornillo de 1,5 cm, como lo muestra la figura y atornille las guías metálica fijas derechas mediante los tornillos varianta[cite: 19]. Realice el mismo procedimiento en el costado izquierdo C, teniendo en cuenta que es simétrico[cite: 19].
  - *Herrajes:* Tornillos de 1.5 cm, Soporte de caños, Pares de guías metálicas de 40 cm, Tornillos varianta

**Paso 2:** Paso 2: Prepare la cara derecha del separador derecho E, colocando 3 bases de bisagra mediante los tornillos 1,5 cm, también el soporte plástico de caño haciéndolo encastrar en la perforación central y luego ajustándolo mediante un tornillo 1,5, como lo muestra la figura y atornille las guías metálica fijas izquierdas mediante los tornillos varianta[cite: 19]. En la cara izquierda coloque 3 bases de bisagra mediante los tornillos 1,5 cm, también a presión 4 soportes de estantes[cite: 19]. Realice el mismo procedimiento en las caras del separador izquierdo Q, teniendo en cuenta que es simétrico[cite: 19].
  - *Herrajes:* Tornillos de 1.5 cm, Soporte de caños, Pares de guías metálicas de 40 cm, Tornillos varianta, Soporte de estantes

**Paso 3:** Paso 3: Tanto en las puertas cortas con y sin manija K y J respectivamente, como en las puertas largas con y sin manija P y O, coloque 3 bisagras mediante los tornillos de 1,5 cm[cite: 19].
  - *Herrajes:* Bisagras codo 9 cazoleta 26, Tornillos de 1.5 cm

**Paso 4:** Paso 4: Encastre las patas macizas, para luego ajustarlas desde arriba mediante los tornillos Allen de 5 cm hacia la base de las patas I[cite: 19]. A su vez coloque a presión dos tarugos guías 6x30[cite: 19].
  - *Herrajes:* Tornillos Allen 5 cm, Tarugos 6x30

**Paso 5:** Paso 5: Luego y mediante los tornillos de 4 cm, vincule los zócalos laterales hacia los zócalos frentes, para finalmente unir estas hacia las patas Macizas, tal como lo indica la figura[cite: 19]. Con los mismos tornillos ajuste desde arriba los zócalos frentes a la base de patas[cite: 19].
  - *Herrajes:* Tornillos de 4 cm

**Paso 6:** Paso 6 Armado de cajones: Coloque 2 tarugos 6x30 en el fondo de cajón N, 2 más en cada uno de los costados de cajón M a su vez encastrar las cajas mini fix[cite: 19]. Agregar adhesivo en cada perforación donde lleve tarugo[cite: 19].
  - *Herrajes:* Tarugos 6x30, Pernos mini fix con caja, Envase de cola

**Paso 7:** Paso 7 armado de cajones: Atornille 2 minifix en el frente de cajón L[cite: 19].
  - *Herrajes:* Pernos mini fix con caja

**Paso 8:** Paso 8 armado de cajones: Una vez armada la estructura tipo 'U' entre M-N-M, ingrese el frente de cajón L ajuste los pernos mini fix girando 180 grados las cajas mini fix[cite: 19]. Habiendo agregado el adhesivo anteriormente[cite: 19]. Luego ajuste el fondo y los costados mediante los dos tornillos de 4 cm[cite: 19].
  - *Herrajes:* Pernos mini fix con caja, Envase de cola, Tornillos de 4 cm

**Paso 9:** Paso 9 armado de cajones: Desde abajo introduzca el piso de cajón sobre el canal del frente de cajón L, y clave este siguiendo una escuadra correcta del cajón sobre los filos inferiores de los costados y del fondo[cite: 19]. Finalmente atornille las guías metálicas como muestra la figura mediante 4 tornillos de 2 cm[cite: 19].
  - *Herrajes:* Set de Clavos, Pares de guías metálicas de 40 cm, Tornillos de 2 cm

**Paso 10:** Paso 10: Mediante los tornillos Allen de 5 cm, una un estante fijo F con el costado derecho D, y con el separador derecho E[cite: 19]. El estante fijo restante con el costado izquierdo C, y con el separador izquierdo Q[cite: 19]. Luego el estante fijo chico H con los separadores[cite: 19]. Desde arriba una la tapa A con los costados y con los separadores y luego desde abajo el piso B, teniendo en cuenta que las perforaciones de guía queden hacia abajo[cite: 19]. Verifique que los cantos melamínicos queden hacia el frente[cite: 19].
  - *Herrajes:* Tornillos Allen 5 cm

**Paso 11:** Paso 11: Primero, con el mueble acostado clave los fondos de mueble de 3 mm, tal como lo indica el gráfico, siguiendo el orden correcto y las escuadras justas del mueble[cite: 19]. Posteriormente distribuya los clavos a una distancia aproximada de 15 cm entre ellos, proporcionándole la rigidez necesaria al mueble (1 vértice A-D, 2 vértice A-E, 3 vértice B-D, 4 vértice B-E y repetir para los fondos restantes)[cite: 19]. Segundo, una vez armada la base de patas I con las patas macizas, ajuste esta hacia el piso B, a través de los 8 tornillos de 2,5 cm y utilizando como guía las perforaciones donde van los dos tarugos 6 x 30, los cuales solo cumplen la función de guía (no golpear)[cite: 19]. Por último, una vez vertical y ya ubicado, deslice los estantes móviles G sobre los soportes de estantes colocados en el separador izquierdo Q y en el separador derecho E[cite: 19]. También coloque los caños sobre los soportes plásticos previamente colocados en los costados C-D y en los separadores Q-E[cite: 19].
  - *Herrajes:* Set de Clavos, Tornillos de 2.5 cm, Tarugos 6x30, Soporte de estantes

**Paso 12:** Paso 12: Finalmente coloque las puertas cortas con manija K en los costados C - D y las puertas cortas sin manija J en los separadores E - Q. Utilizando como guía las indicaciones de 'Regulación de bisagra'[cite: 19]. Si lo requiere puede intercambiar la posición de las mismas[cite: 19]. Coloque la puerta larga con manija P en el separador izquierdo Q y la puerta larga sin manija O en el separador derecho E[cite: 19]. Si lo requiere puede intercambiar la posición de las mismas[cite: 19].
  - *Herrajes:* Bisagras codo 9 cazoleta 26

**Paso 13:** Paso 13: Luego ingrese los cajones como indica la 'Colocación de cajones'[cite: 19].
  - *Herrajes:* Pares de guías metálicas de 40 cm
  - 💡 *Consejo Pro:* Verticalización segura: Con la ayuda de otra persona verticalice el mueble evitando cargar todo el peso sobre dos patas, dándole preferentemente la ubicación final en el hogar[cite: 19].

---
