infomueblesgacela/muebles-gacela-mvp/herrajes/Pasados/pernos-mini-fix-con-cajas.png

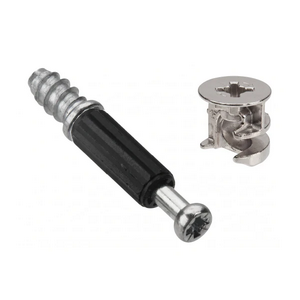
herrajes/Pasados/pernos-mini-fix-con-cajas.png
