infomueblesgacela/muebles-gacela-mvp/public/articulos-gacela-muebles-2026/linea-comedores/art-455090-barra-desayunador-viken/a455090-ia-im00.pdf

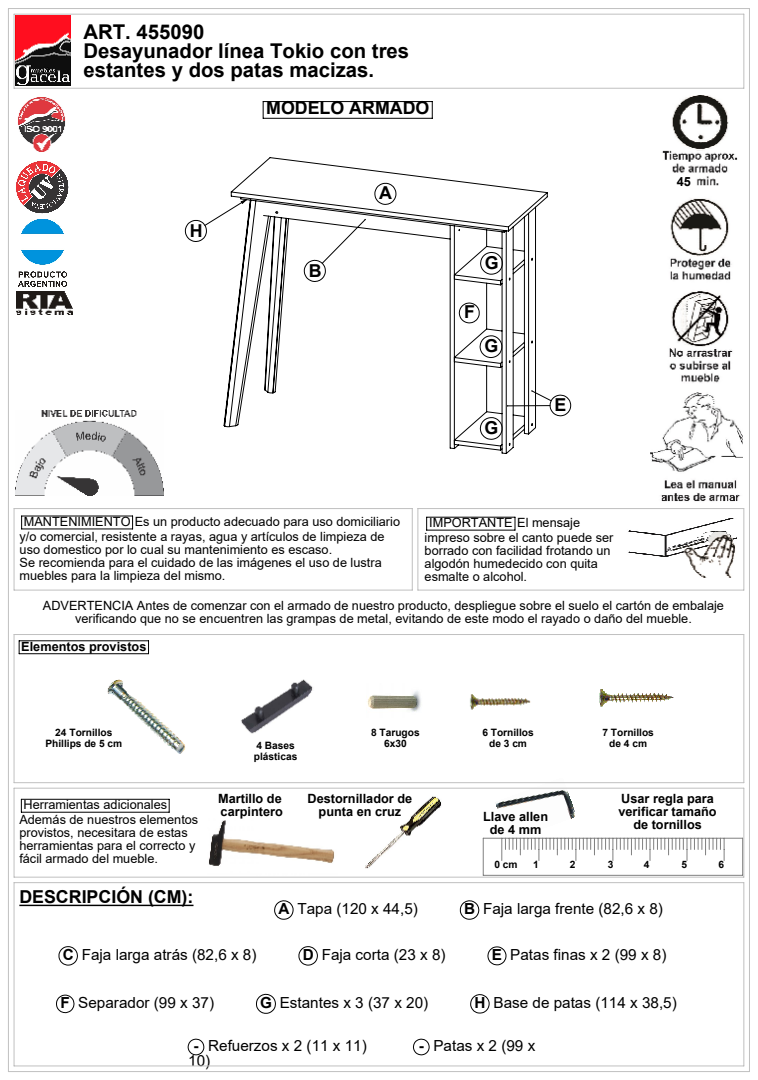
[picture p138: page 1]
A Tapa (120 x 44,5); B Faja larga frente (82,6 x 8); F Separador (99 x 37); G Estantes x 3 (37 x 20); H Base de patas (114 x 38,5); - Refuerzos x 2 (11 x 11); - Patas x 2 (99 x; C Faja larga atrás (82,6 x 8); D Faja corta (23 x 8); E Patas finas x 2 (99 x 8); 8 Tarugos; Martillo de; MODELO ARMADO; 6 Tornillos de 3 cm; 4 Bases; 7 Tornillos de 4 cm; Llave allen de 4 mm

ART. 455090
Desayunador línea Tokio con tres
estantes y dos patas macizas.

MANTENIMIENTO Es un producto adecuado para uso domiciliario
y/o comercial, resistente a rayas, agua y artículos de limpieza de
uso domestico por lo cual su mantenimiento es escaso.
Se recomienda para el cuidado de las imágenes el uso de lustra
muebles para la limpieza del mismo.
ADVERTENCIA Antes de comenzar con el armado de nuestro producto, despliegue sobre el suelo el cartón de embalaje
verificando que no se encuentren las grampas de metal, evitando de este modo el rayado o daño del mueble.
Elementos provistos

IMPORTANTE El mensaje
impreso sobre el canto puede ser
borrado con facilidad frotando un
algodón humedecido con quita
esmalte o alcohol.

24 Tornillos
Phillips de 5 cm

Destornillador de
punta en cruz

Herramientas adicionales
Además de nuestros elementos
provistos, necesitara de estas
herramientas para el correcto y
fácil armado del mueble.
DESCRIPCIÓN (CM):

Usar regla para
verificar tamaño
de tornillos

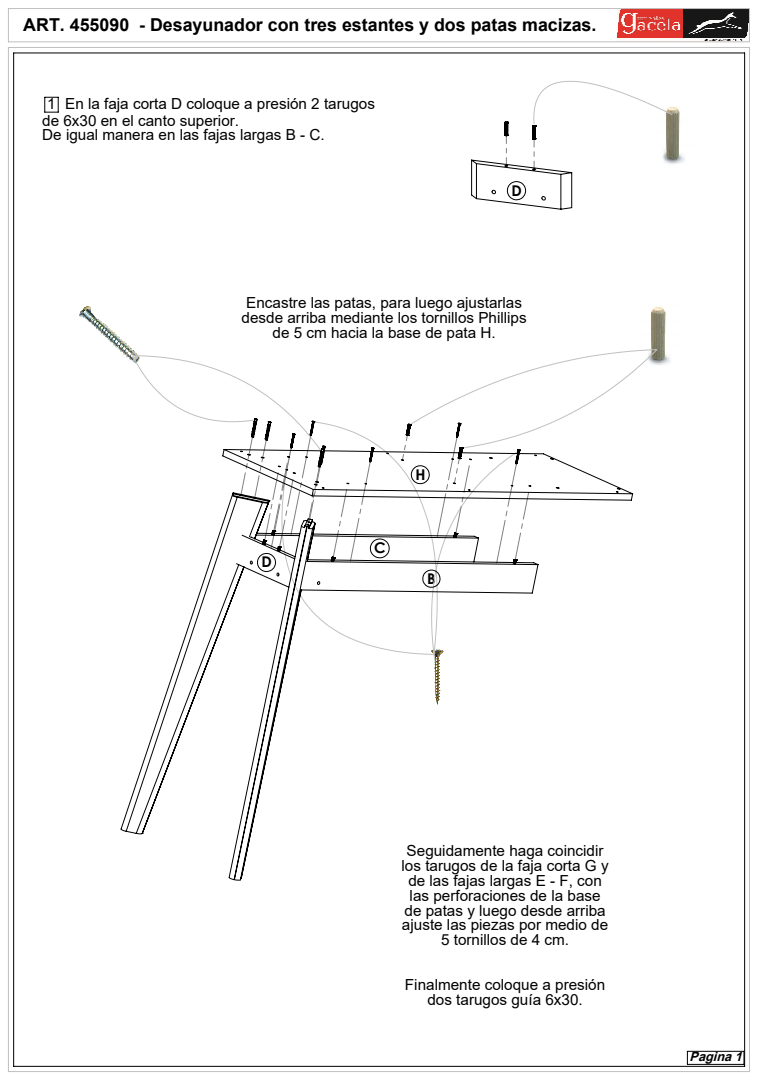
[picture p139: page 2]
En la faja corta D coloque a presión 2 tarugos; Pagina 1

ART. 455090 - Desayunador con tres estantes y dos patas macizas.

de 6x30 en el canto superior.
De igual manera en las fajas largas B - C.

Encastre las patas, para luego ajustarlas
desde arriba mediante los tornillos Phillips
de 5 cm hacia la base de pata H.

Seguidamente haga coincidir
los tarugos de la faja corta G y
de las fajas largas E - F, con
las perforaciones de la base
de patas y luego desde arriba
ajuste las piezas por medio de
5 tornillos de 4 cm.

Finalmente coloque a presión
dos tarugos guía 6x30.

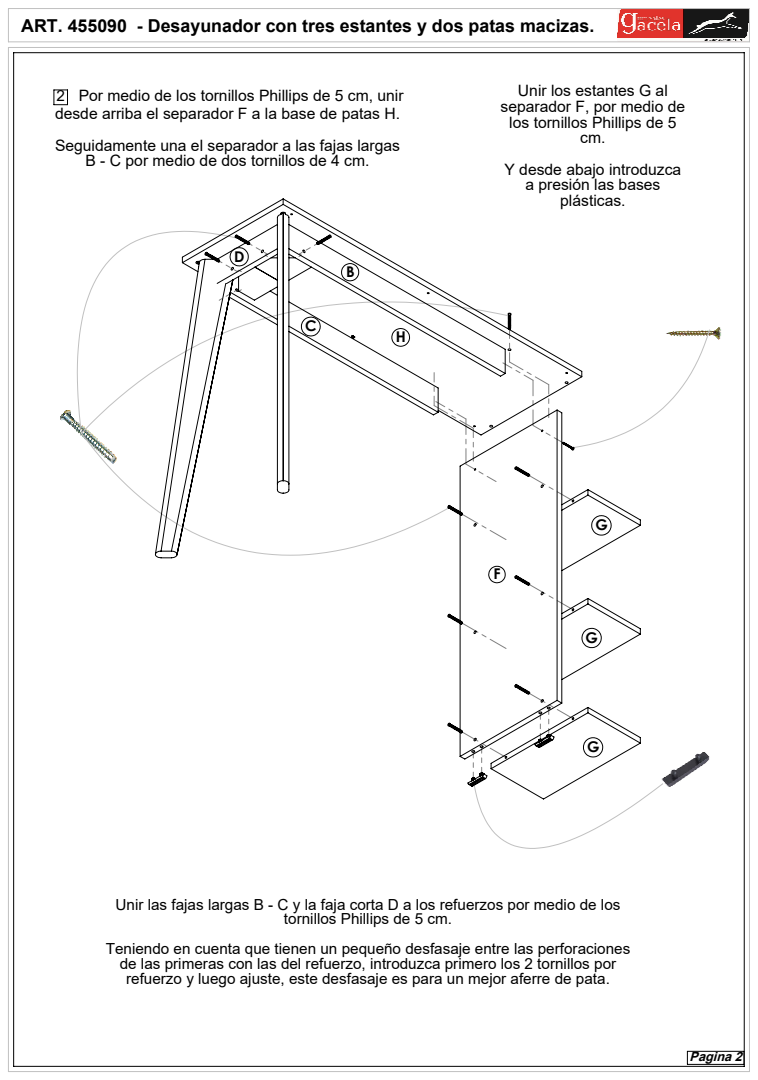
[picture p140: page 3]
Por medio de los tornillos Phillips de 5 cm, unir; Pagina 2

desde arriba el separador F a la base de patas H.
Seguidamente una el separador a las fajas largas
B - C por medio de dos tornillos de 4 cm.

Unir los estantes G al
separador F, por medio de
los tornillos Phillips de 5

Y desde abajo introduzca
a presión las bases
plásticas.

Unir las fajas largas B - C y la faja corta D a los refuerzos por medio de los

tornillos Phillips de 5 cm.

Teniendo en cuenta que tienen un pequeño desfasaje entre las perforaciones
de las primeras con las del refuerzo, introduzca primero los 2 tornillos por
refuerzo y luego ajuste, este desfasaje es para un mejor aferre de pata.

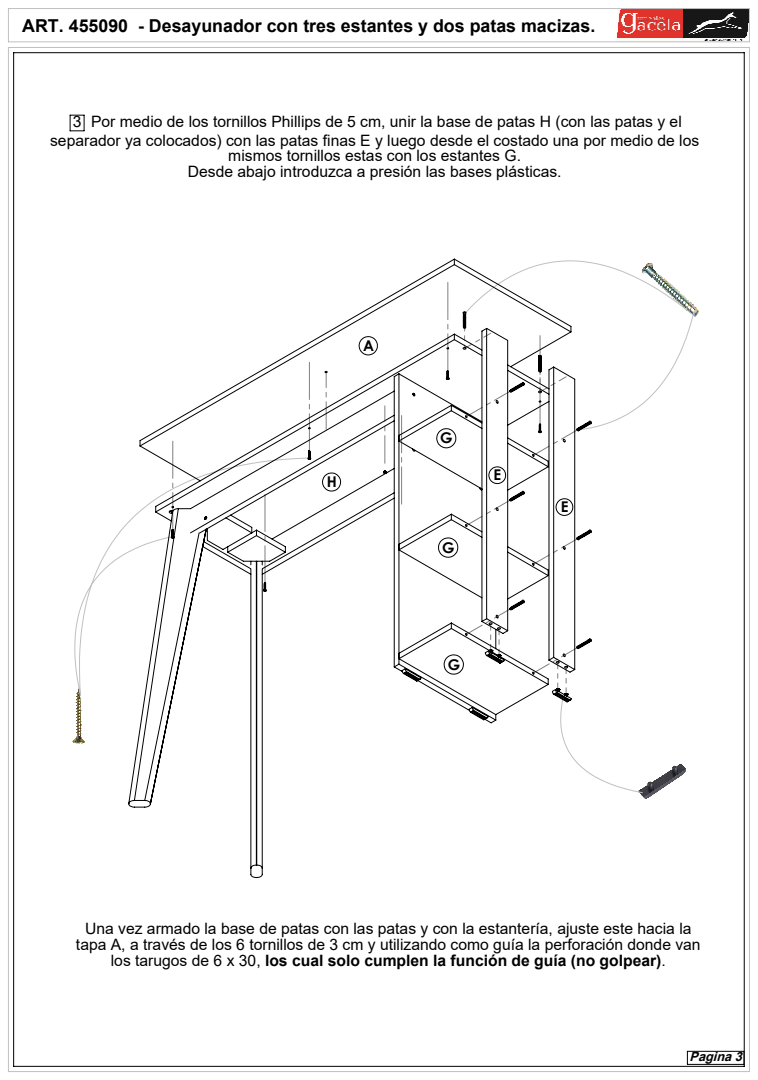
[picture p141: page 4]
Por medio de los tornillos Phillips de 5 cm, unir la base de patas H (con las patas y el; Pagina 3

separador ya colocados) con las patas finas E y luego desde el costado una por medio de los

mismos tornillos estas con los estantes G.
Desde abajo introduzca a presión las bases plásticas.

Una vez armado la base de patas con las patas y con la estantería, ajuste este hacia la
tapa A, a través de los 6 tornillos de 3 cm y utilizando como guía la perforación donde van
los tarugos de 6 x 30, los cual solo cumplen la función de guía (no golpear).
