infomueblesgacela/muebles-gacela-mvp/public/modelos_3d/linea-clasica/A032012/A032012.PDF

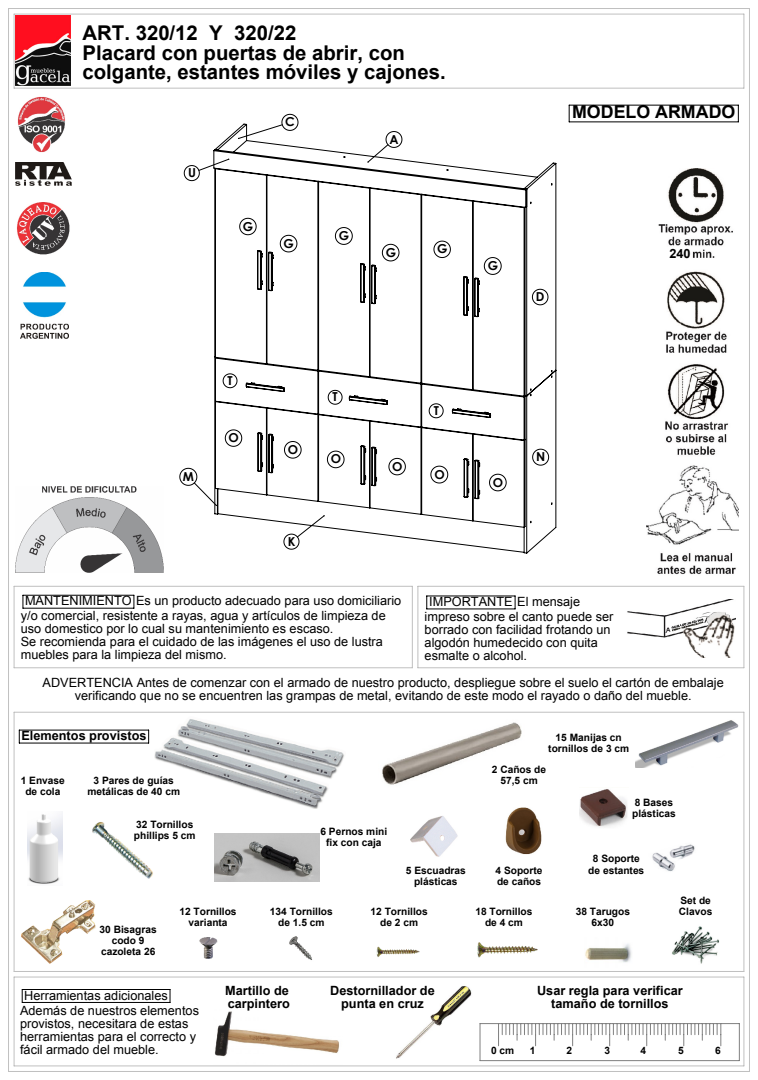
[picture p142: page 1]
4 Soporte de caños; 12 Tornillos de 2 cm; 38 Tarugos; Set de; Martillo de; Destornillador de; Elementos provistos; MODELO ARMADO; 18 Tornillos de 4 cm; 12 Tornillos; 1 Envase de cola; 32 Tornillos phillips 5 cm; 134 Tornillos de 1.5 cm; 8 Soporte de estantes; 30 Bisagras codo 9 cazoleta 26; 2 Caños de 57,5 cm; 5 Escuadras; 8 Bases

ART. 320/12 Y 320/22
Placard con puertas de abrir, con
colgante, estantes móviles y cajones.

MANTENIMIENTO Es un producto adecuado para uso domiciliario
y/o comercial, resistente a rayas, agua y artículos de limpieza de
uso domestico por lo cual su mantenimiento es escaso.
Se recomienda para el cuidado de las imágenes el uso de lustra
muebles para la limpieza del mismo.
ADVERTENCIA Antes de comenzar con el armado de nuestro producto, despliegue sobre el suelo el cartón de embalaje
verificando que no se encuentren las grampas de metal, evitando de este modo el rayado o daño del mueble.

IMPORTANTE El mensaje
impreso sobre el canto puede ser
borrado con facilidad frotando un
algodón humedecido con quita
esmalte o alcohol.

15 Manijas cn
tornillos de 3 cm

3 Pares de guías
metálicas de 40 cm

6 Pernos mini
fix con caja

Herramientas adicionales
Además de nuestros elementos
provistos, necesitara de estas
herramientas para el correcto y
fácil armado del mueble.

Usar regla para verificar

tamaño de tornillos carpintero punta en cruz

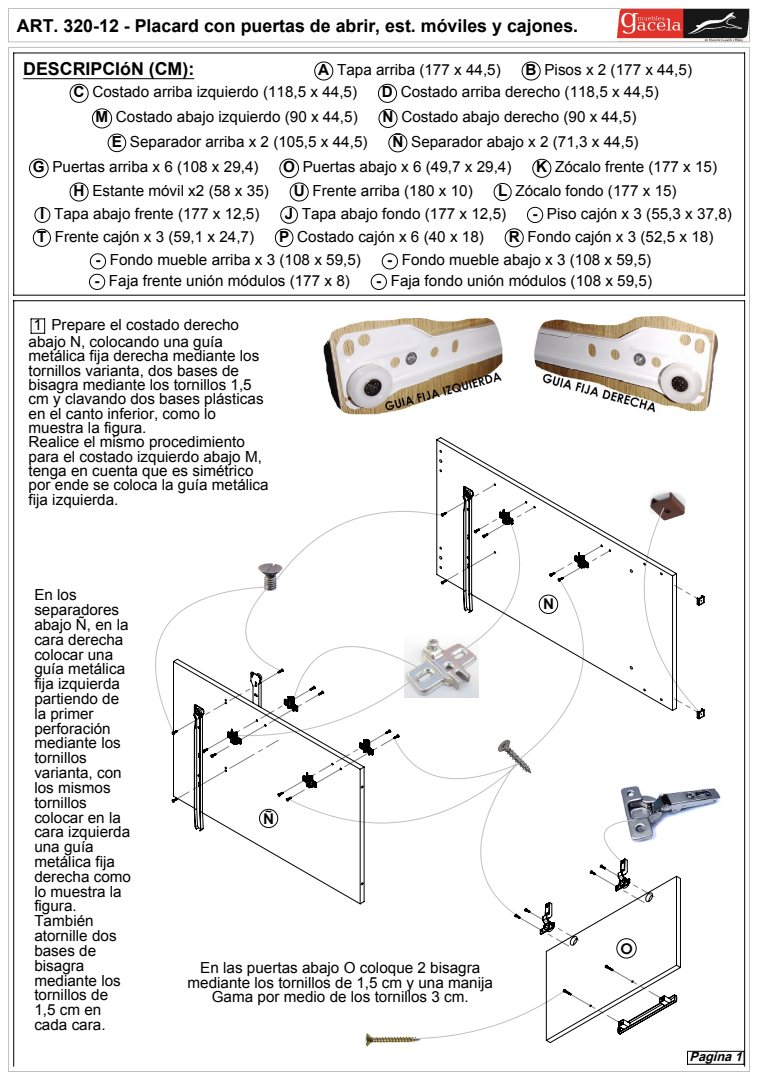
[picture p143: page 2]
E Separador arriba x 2 (105,5 x 44,5); Ñ Separador abajo x 2 (71,3 x 44,5); - Fondo mueble arriba x 3 (108 x 59,5); - Fondo mueble abajo x 3 (108 x 59,5); G Puertas arriba x 6 (108 x 29,4); O Puertas abajo x 6 (49,7 x 29,4); K Zócalo frente (177 x 15); T Frente cajón x 3 (59,1 x 24,7); P Costado cajón x 6 (40 x 18); R Fondo cajón x 3 (52,5 x 18); H Estante móvil x2 (58 x 35); U Frente arriba (180 x 10); L Zócalo fondo (177 x 15); DESCRIPCIóN (CM):; A Tapa arriba (177 x 44,5)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

ART. 320-12 - Placard con puertas de abrir, est. móviles y cajones.

abajo N, colocando una guía
metálica fija derecha mediante los
tornillos varianta, dos bases de
bisagra mediante los tornillos 1,5
cm y clavando dos bases plásticas
en el canto inferior, como lo
muestra la figura.
Realice el mismo procedimiento
para el costado izquierdo abajo M,
tenga en cuenta que es simétrico
por ende se coloca la guía metálica
fija izquierda.

En los
separadores
abajo Ñ, en la
cara derecha
colocar una
guía metálica
fija izquierda
partiendo de
la primer
perforación
mediante los
tornillos
varianta, con
los mismos
colocar en la
cara izquierda
una guía
metálica fija
derecha como
lo muestra la
figura.
También
atornille dos
bases de
bisagra
tornillos de
cada cara.

En las puertas abajo O coloque 2 bisagra
mediante los tornillos de 1,5 cm y una manija Gama por medio de los tornillos 3 cm.

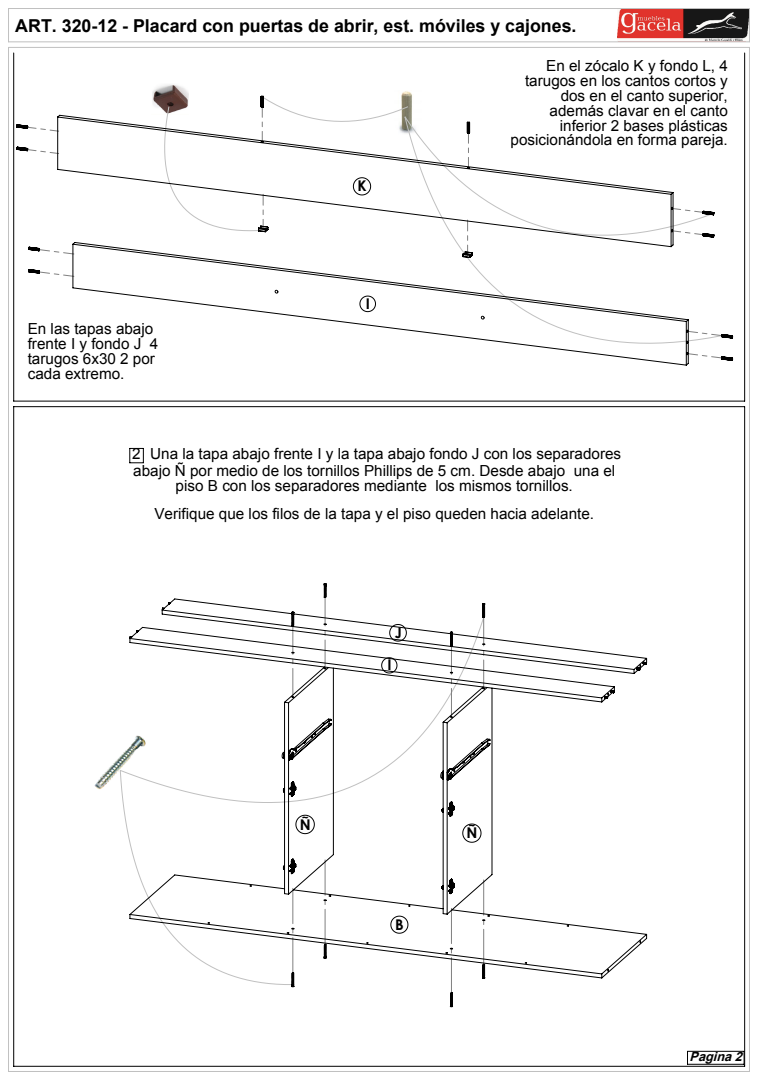
[picture p144: page 3]
Una la tapa abajo frente I y la tapa abajo fondo J con los separadores; Pagina 2

En el zócalo K y fondo L, 4
tarugos en los cantos cortos y
dos en el canto superior,
además clavar en el canto
inferior 2 bases plásticas
posicionándola en forma pareja.

En las tapas abajo
frente I y fondo J 4
tarugos 6x30 2 por
cada extremo.

abajo Ñ por medio de los tornillos Phillips de 5 cm. Desde abajo una el
piso B con los separadores mediante los mismos tornillos.
Verifique que los filos de la tapa y el piso queden hacia adelante.

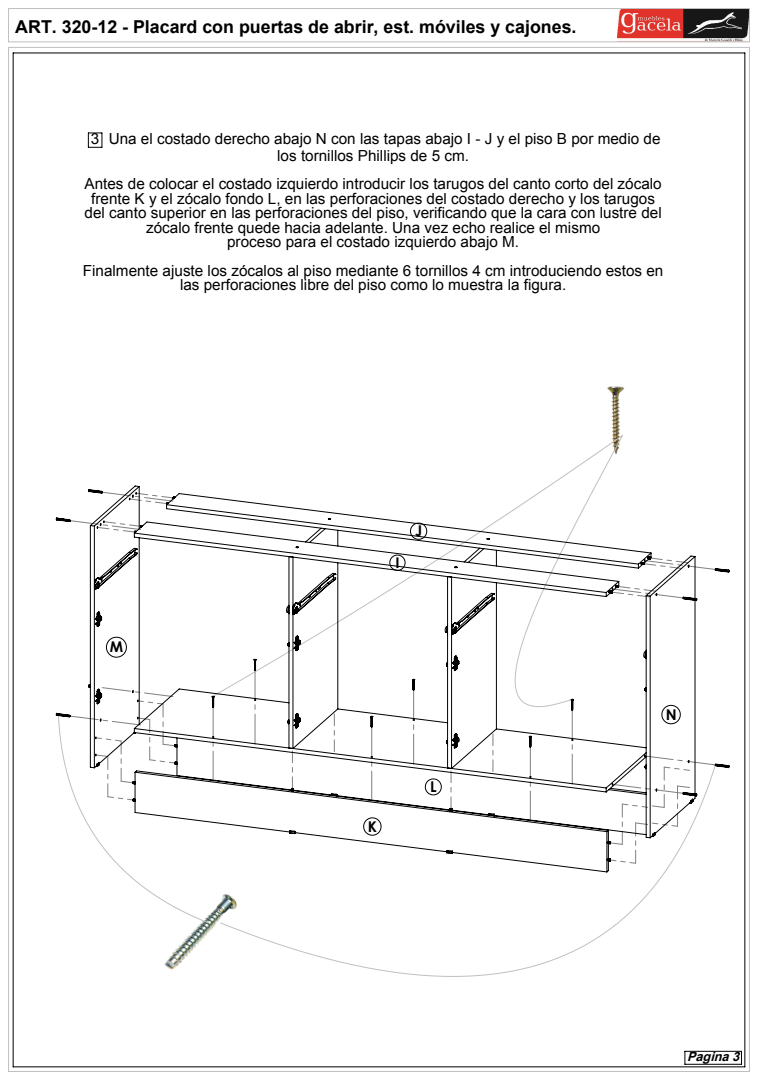
[picture p145: page 4]
Una el costado derecho abajo N con las tapas abajo I - J y el piso B por medio de; Pagina 3

los tornillos Phillips de 5 cm.

Antes de colocar el costado izquierdo introducir los tarugos del canto corto del zócalo
frente K y el zócalo fondo L, en las perforaciones del costado derecho y los tarugos
del canto superior en las perforaciones del piso, verificando que la cara con lustre del

zócalo frente quede hacia adelante. Una vez echo realice el mismo

proceso para el costado izquierdo abajo M.

Finalmente ajuste los zócalos al piso mediante 6 tornillos 4 cm introduciendo estos en las perforaciones libre del piso como lo muestra la figura.

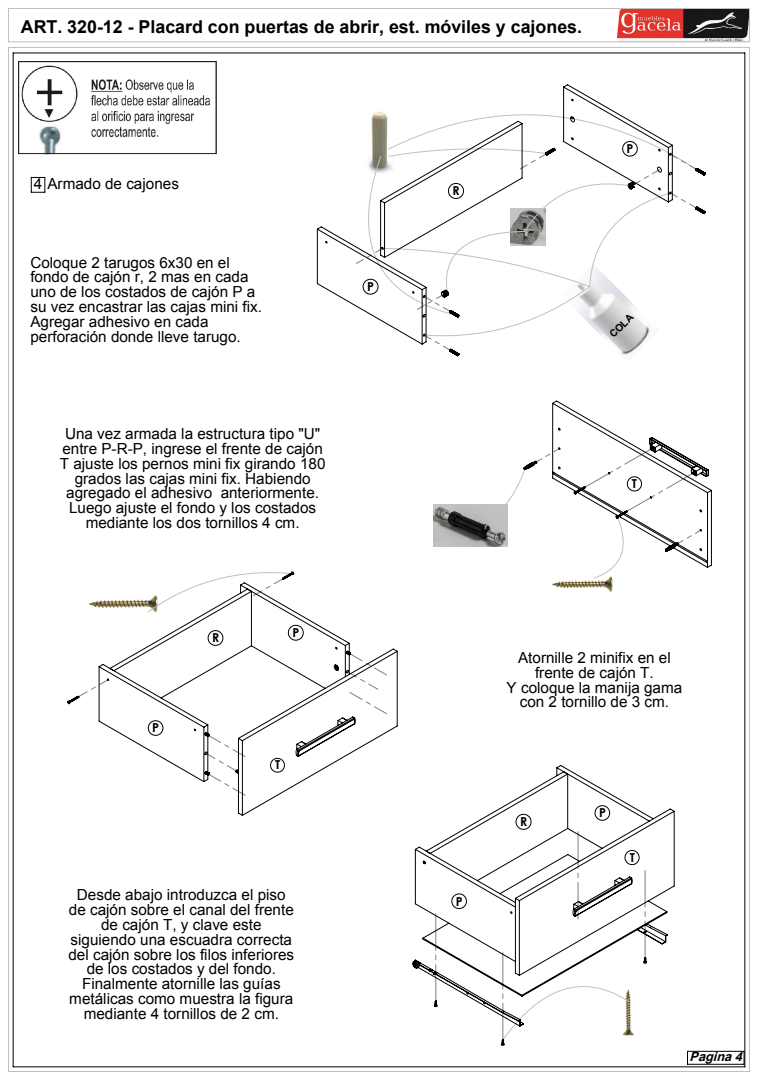
[picture p146: page 5]
Pagina 4

4 Armado de cajones

Coloque 2 tarugos 6x30 en el
fondo de cajón r, 2 mas en cada
uno de los costados de cajón P a
su vez encastrar las cajas mini fix.
Agregar adhesivo en cada
perforación donde lleve tarugo.

Una vez armada la estructura tipo "U"
entre P-R-P, ingrese el frente de cajón
T ajuste los pernos mini fix girando 180
grados las cajas mini fix. Habiendo
agregado el adhesivo anteriormente.
Luego ajuste el fondo y los costados
mediante los dos tornillos 4 cm.

Atornille 2 minifix en el
frente de cajón T.
Y coloque la manija gama
con 2 tornillo de 3 cm.

Desde abajo introduzca el piso
de cajón sobre el canal del frente
de cajón T, y clave este
siguiendo una escuadra correcta
del cajón sobre los filos inferiores
de los costados y del fondo.
Finalmente atornille las guías
metálicas como muestra la figura
mediante 4 tornillos de 2 cm.

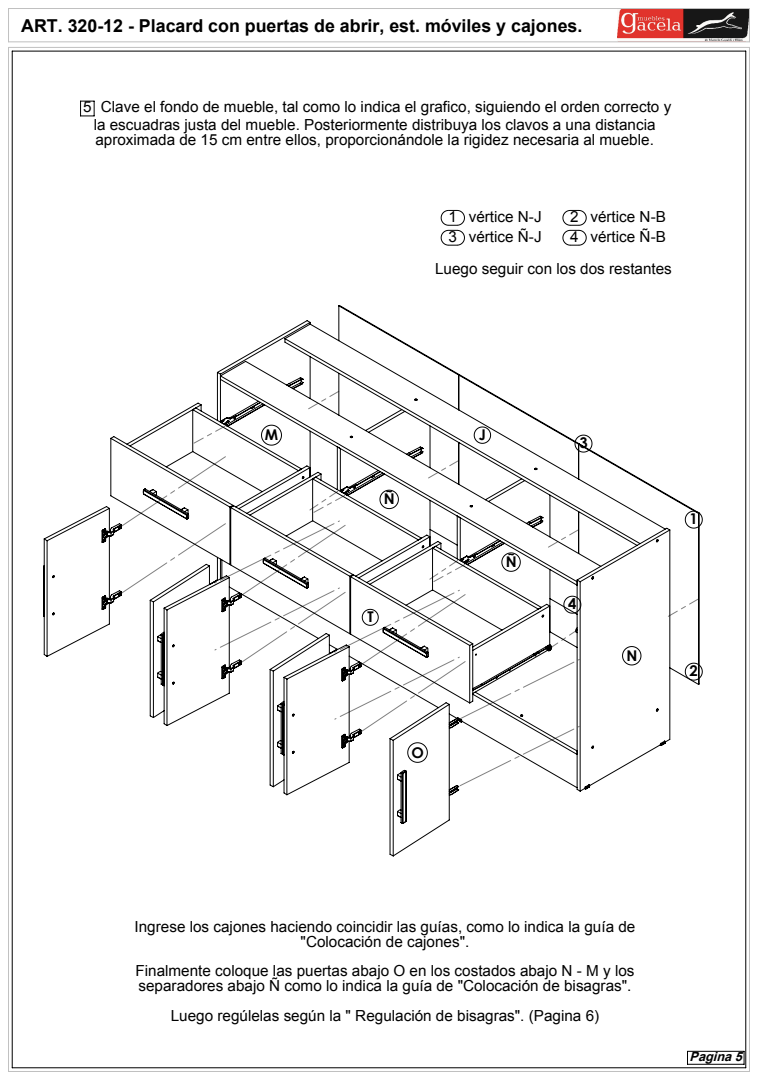
[picture p147: page 6]
1 vértice N-J; 2 vértice N-B; 3 vértice Ñ-J; 4 vértice Ñ-B; Clave el fondo de mueble, tal como lo indica el grafico, siguiendo el orden correcto y; Pagina 5

la escuadras justa del mueble. Posteriormente distribuya los clavos a una distancia
aproximada de 15 cm entre ellos, proporcionándole la rigidez necesaria al mueble.

Luego seguir con los dos restantes

Ingrese los cajones haciendo coincidir las guías, como lo indica la guía de

"Colocación de cajones".

Finalmente coloque las puertas abajo O en los costados abajo N - M y los
separadores abajo Ñ como lo indica la guía de "Colocación de bisagras".
Luego regúlelas según la " Regulación de bisagras". (Pagina 6)

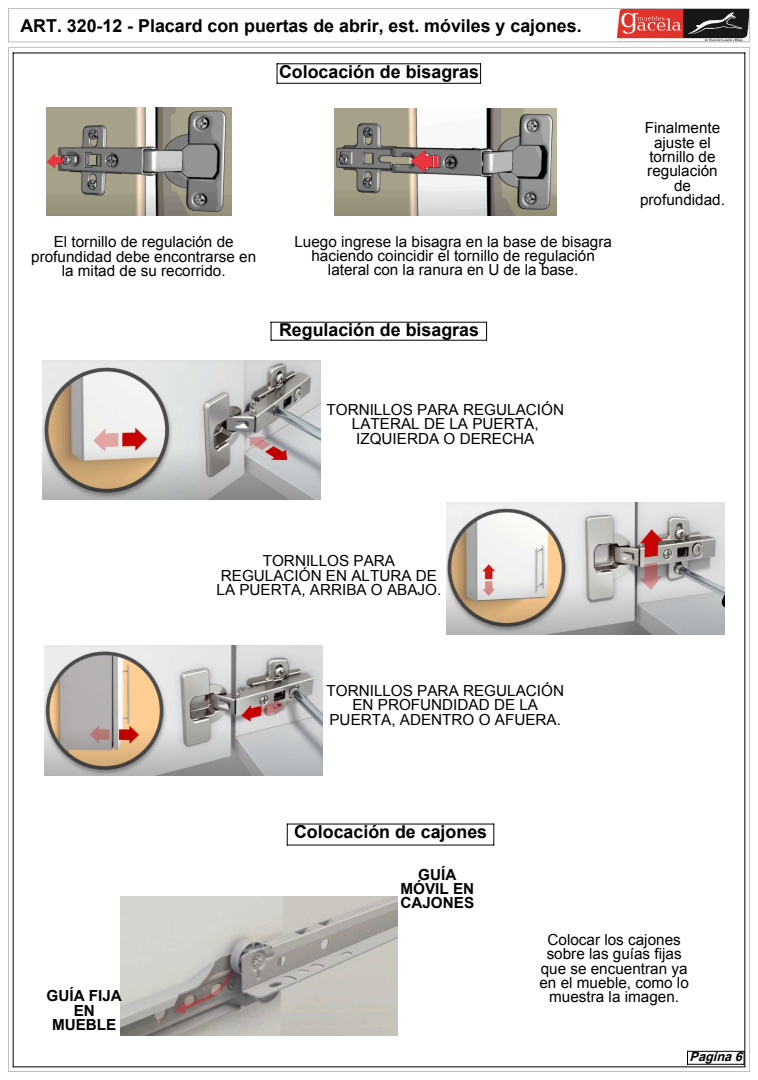
[picture p148: page 7]
ajuste el tornillo de; GUÍA FIJA; MÓVIL EN; Pagina 6

Colocación de bisagras

El tornillo de regulación de profundidad debe encontrarse en
la mitad de su recorrido.

Luego ingrese la bisagra en la base de bisagra
haciendo coincidir el tornillo de regulación
lateral con la ranura en U de la base.

Regulación de bisagras

TORNILLOS PARA REGULACIÓN
LATERAL DE LA PUERTA,
IZQUIERDA O DERECHA

TORNILLOS PARA
REGULACIÓN EN ALTURA DE
LA PUERTA, ARRIBA O ABAJO.

EN PROFUNDIDAD DE LA
PUERTA, ADENTRO O AFUERA.

Colocación de cajones

Colocar los cajones
sobre las guías fijas
que se encuentran ya
en el mueble, como lo
muestra la imagen.

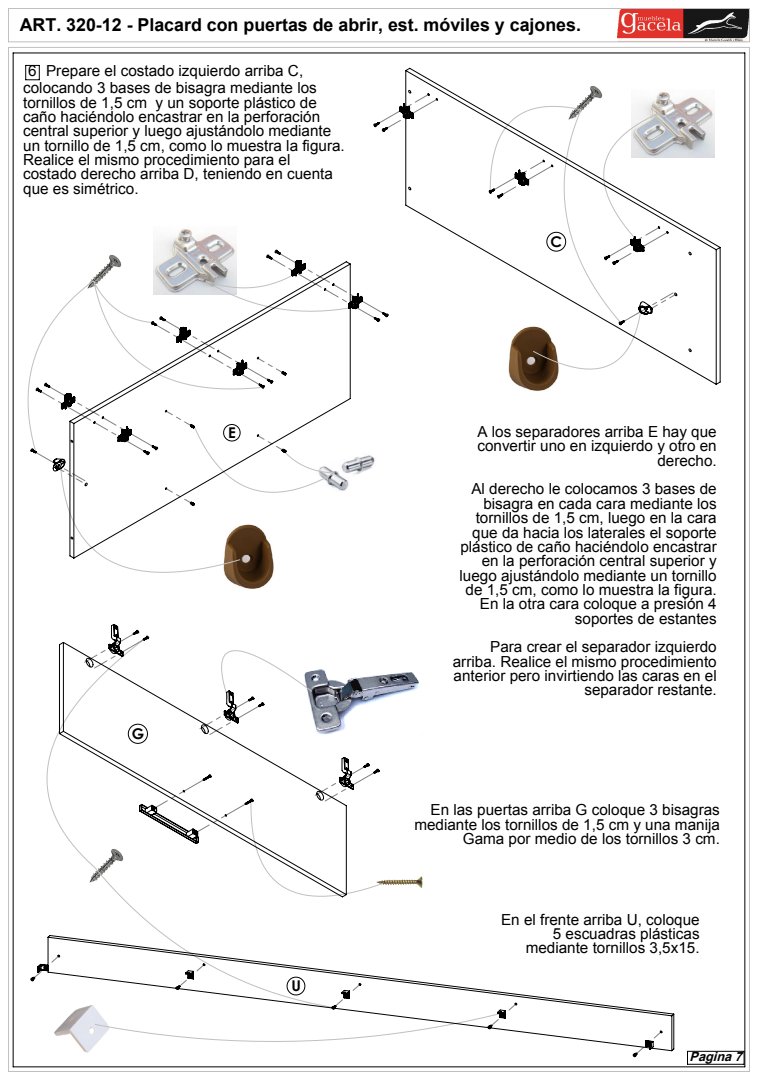
[picture p149: page 8]
Prepare el costado izquierdo arriba C,; separador restante.; Pagina 7

colocando 3 bases de bisagra mediante los
tornillos de 1,5 cm y un soporte plástico de
caño haciéndolo encastrar en la perforación
central superior y luego ajustándolo mediante
un tornillo de 1,5 cm, como lo muestra la figura.
Realice el mismo procedimiento para el
costado derecho arriba D, teniendo en cuenta
que es simétrico.

A los separadores arriba E hay que
convertir uno en izquierdo y otro en

Al derecho le colocamos 3 bases de
bisagra en cada cara mediante los
tornillos de 1,5 cm, luego en la cara
que da hacia los laterales el soporte
plástico de caño haciéndolo encastrar
en la perforación central superior y
luego ajustándolo mediante un tornillo
de 1,5 cm, como lo muestra la figura.
En la otra cara coloque a presión 4

soportes de estantes

Para crear el separador izquierdo
arriba. Realice el mismo procedimiento
anterior pero invirtiendo las caras en el

En las puertas arriba G coloque 3 bisagras
mediante los tornillos de 1,5 cm y una manija Gama por medio de los tornillos 3 cm.

En el frente arriba U, coloque
5 escuadras plásticas
mediante tornillos 3,5x15.

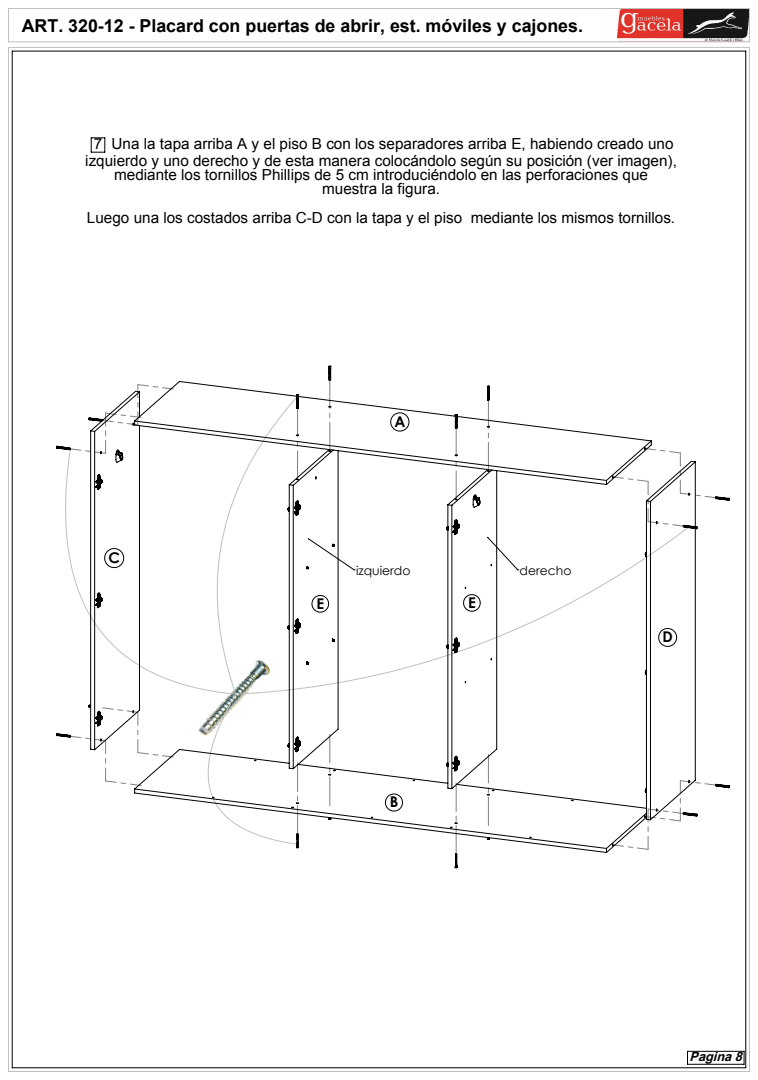
[picture p150: page 9]
Una la tapa arriba A y el piso B con los separadores arriba E, habiendo creado uno; Pagina 8

izquierdo y uno derecho y de esta manera colocándolo según su posición (ver imagen), mediante los tornillos Phillips de 5 cm introduciéndolo en las perforaciones que

muestra la figura.

Luego una los costados arriba C-D con la tapa y el piso mediante los mismos tornillos.

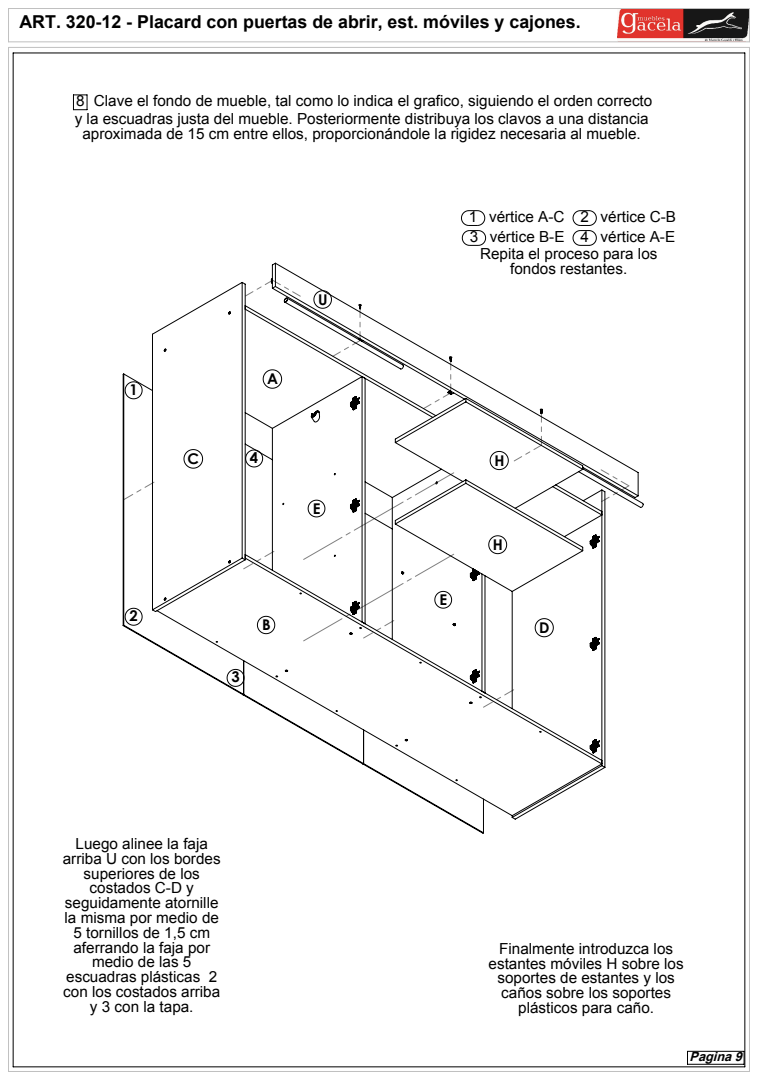
[picture p151: page 10]
Clave el fondo de mueble, tal como lo indica el grafico, siguiendo el orden correcto; Pagina 9

y la escuadras justa del mueble. Posteriormente distribuya los clavos a una distancia
aproximada de 15 cm entre ellos, proporcionándole la rigidez necesaria al mueble.

1 vértice A-C 2 vértice C-B
3 vértice B-E 4 vértice A-E
Repita el proceso para los
fondos restantes.

Luego alinee la faja
arriba U con los bordes
superiores de los
costados C-D y
seguidamente atornille
la misma por medio de
5 tornillos de 1,5 cm
aferrando la faja por
medio de las 5
escuadras plásticas 2
con los costados arriba
y 3 con la tapa.

Finalmente introduzca los
estantes móviles H sobre los
soportes de estantes y los
caños sobre los soportes
plásticos para caño.

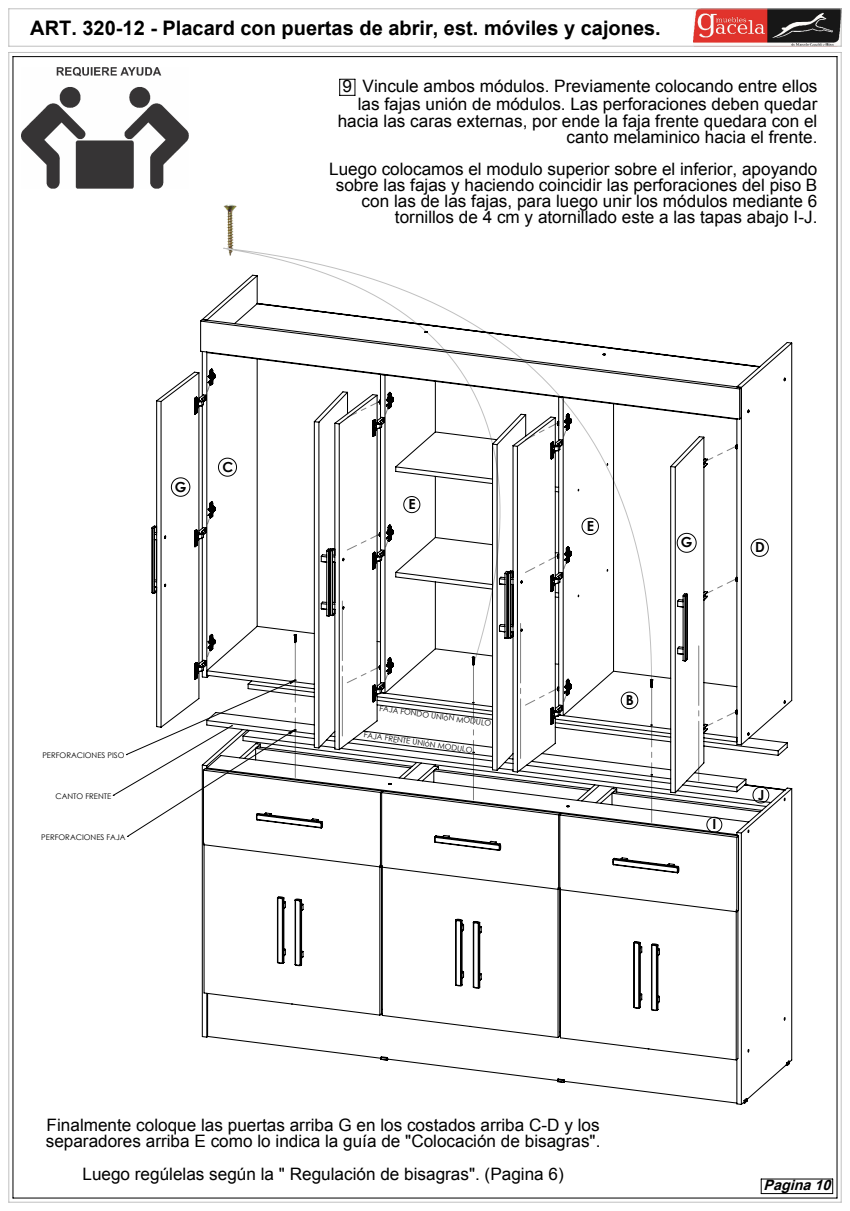
[picture p152: page 11]
CANTO FRENTE; PERFORACIONES FAJA; PERFORACIONES PISO; Vincule ambos módulos. Previamente colocando entre ellos; Luego regúlelas según la " Regulación de bisagras". (Pagina 6); Pagina 10

las fajas unión de módulos. Las perforaciones deben quedar hacia las caras externas, por ende la faja frente quedara con el canto melaminico hacia el frente.

Luego colocamos el modulo superior sobre el inferior, apoyando
sobre las fajas y haciendo coincidir las perforaciones del piso B con las de las fajas, para luego unir los módulos mediante 6
tornillos de 4 cm y atornillado este a las tapas abajo I-J.

FAJA FONDO UNIóN MODULO

FAJA FRENTE UNIóN MODULO

Finalmente coloque las puertas arriba G en los costados arriba C-D y los
separadores arriba E como lo indica la guía de "Colocación de bisagras".
