infomueblesgacela/muebles-gacela-mvp/public/modelos_3d/linea-clasica/A070815/A070815.PDF

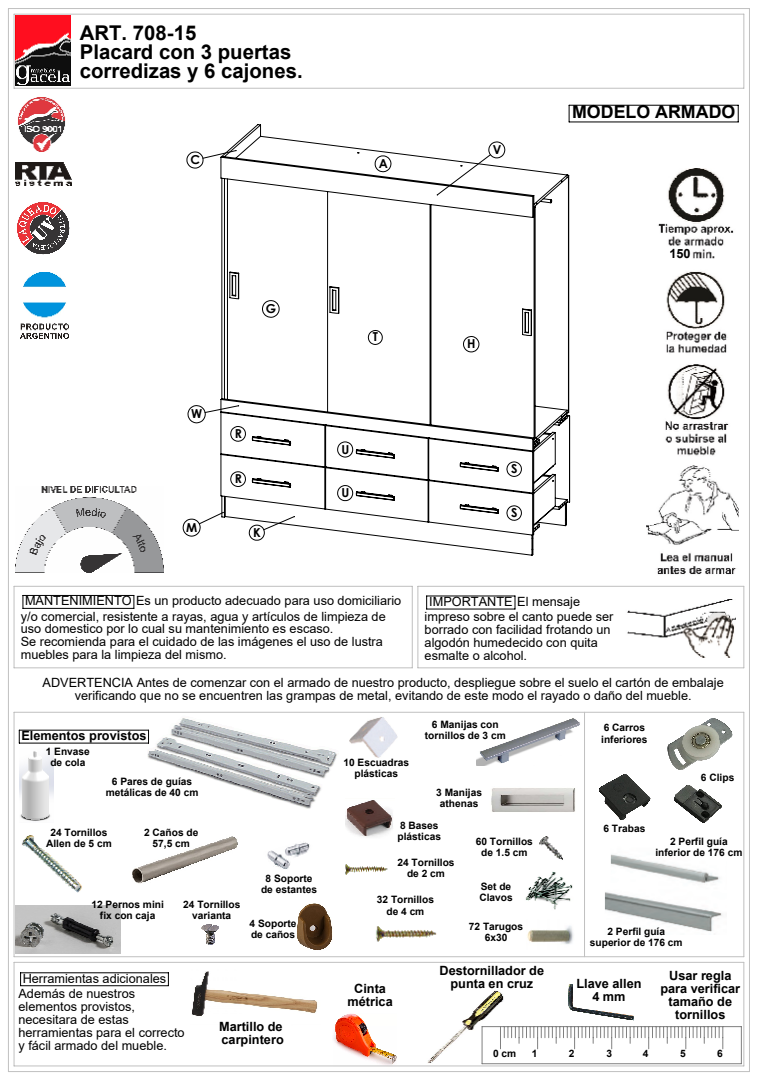
[picture p153: page 1]
4 Soporte de caños; 24 Tornillos de 2 cm; Set de; Martillo de; Elementos provistos; MODELO ARMADO; 32 Tornillos; 1 Envase de cola; 24 Tornillos; Allen de 5 cm; 60 Tornillos; 8 Soporte de estantes; Usar regla para verificar tamaño de; 2 Caños de 57,5 cm; 10 Escuadras; 8 Bases; 3 Manijas; 6 Trabas; 6 Carros; Llave allen 4 mm; 6 Clips

ART. 708-15
Placard con 3 puertas
corredizas y 6 cajones.

MANTENIMIENTO Es un producto adecuado para uso domiciliario
y/o comercial, resistente a rayas, agua y artículos de limpieza de
uso domestico por lo cual su mantenimiento es escaso.
Se recomienda para el cuidado de las imágenes el uso de lustra
muebles para la limpieza del mismo.
ADVERTENCIA Antes de comenzar con el armado de nuestro producto, despliegue sobre el suelo el cartón de embalaje
verificando que no se encuentren las grampas de metal, evitando de este modo el rayado o daño del mueble.

IMPORTANTE El mensaje
impreso sobre el canto puede ser
borrado con facilidad frotando un
algodón humedecido con quita
esmalte o alcohol.

6 Manijas con
tornillos de 3 cm

6 Pares de guías
metálicas de 40 cm

2 Perfil guía
inferior de 176 cm

12 Pernos mini
fix con caja

de 4 cm 24 Tornillos
varianta

72 Tarugos
Destornillador de
punta en cruz

superior de 176 cm

Herramientas adicionales
Además de nuestros
elementos provistos,
necesitara de estas
herramientas para el correcto
y fácil armado del mueble.

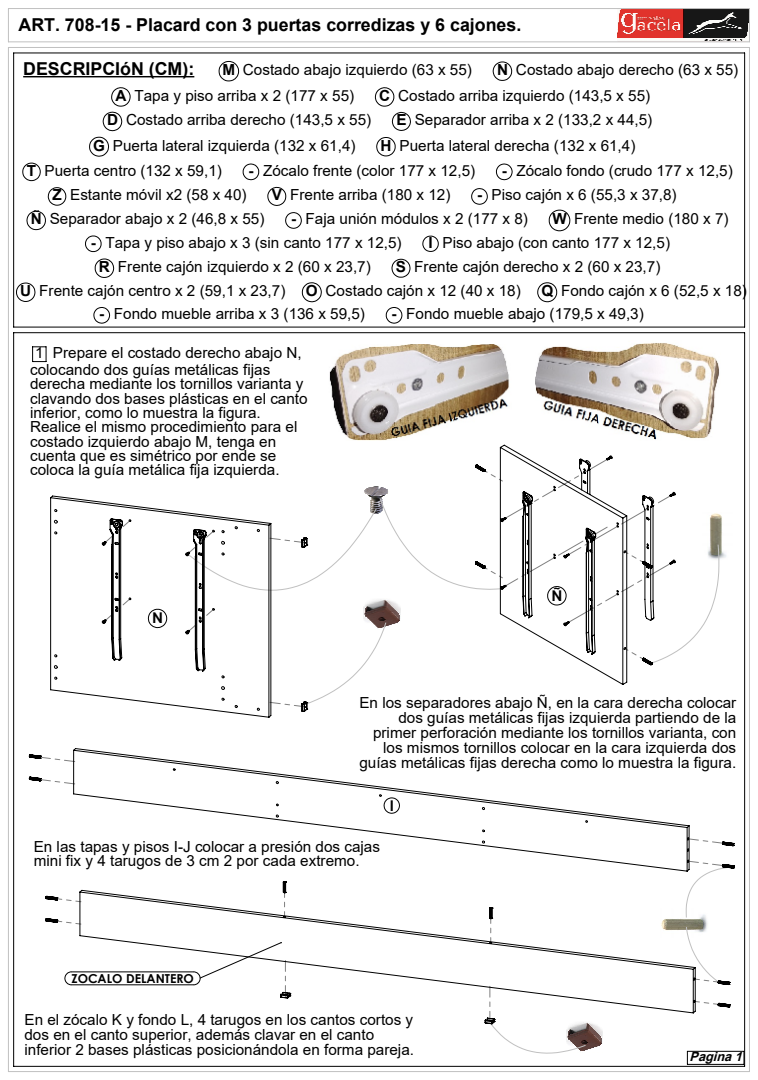
[picture p154: page 2]
ZOCALO DELANTERO; R Frente cajón izquierdo x 2 (60 x 23,7); S Frente cajón derecho x 2 (60 x 23,7); - Fondo mueble arriba x 3 (136 x 59,5); - Fondo mueble abajo (179,5 x 49,3); Z Estante móvil x2 (58 x 40); V Frente arriba (180 x 12); - Piso cajón x 6 (55,3 x 37,8); D Costado arriba derecho (143,5 x 55); E Separador arriba x 2 (133,2 x 44,5); - Tapa y piso abajo x 3 (sin canto 177 x 12,5); I Piso abajo (con canto 177 x 12,5); Prepare el costado derecho abajo N,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

ART. 708-15 - Placard con 3 puertas corredizas y 6 cajones.
DESCRIPCIóN (CM):

M Costado abajo izquierdo (63 x 55) N Costado abajo derecho (63 x 55)

A Tapa y piso arriba x 2 (177 x 55) C Costado arriba izquierdo (143,5 x 55)
G Puerta lateral izquierda (132 x 61,4) H Puerta lateral derecha (132 x 61,4)

U Frente cajón centro x 2 (59,1 x 23,7) O Costado cajón x 12 (40 x 18) Q Fondo cajón x 6 (52,5 x 18)

colocando dos guías metálicas fijas
derecha mediante los tornillos varianta y
clavando dos bases plásticas en el canto
inferior, como lo muestra la figura.
Realice el mismo procedimiento para el
costado izquierdo abajo M, tenga en
cuenta que es simétrico por ende se
coloca la guía metálica fija izquierda.

En los separadores abajo Ñ, en la cara derecha colocar
dos guías metálicas fijas izquierda partiendo de la
primer perforación mediante los tornillos varianta, con
los mismos tornillos colocar en la cara izquierda dos
guías metálicas fijas derecha como lo muestra la figura.

En las tapas y pisos I-J colocar a presión dos cajas
mini fix y 4 tarugos de 3 cm 2 por cada extremo.

En el zócalo K y fondo L, 4 tarugos en los cantos cortos y
dos en el canto superior, además clavar en el canto
inferior 2 bases plásticas posicionándola en forma pareja.

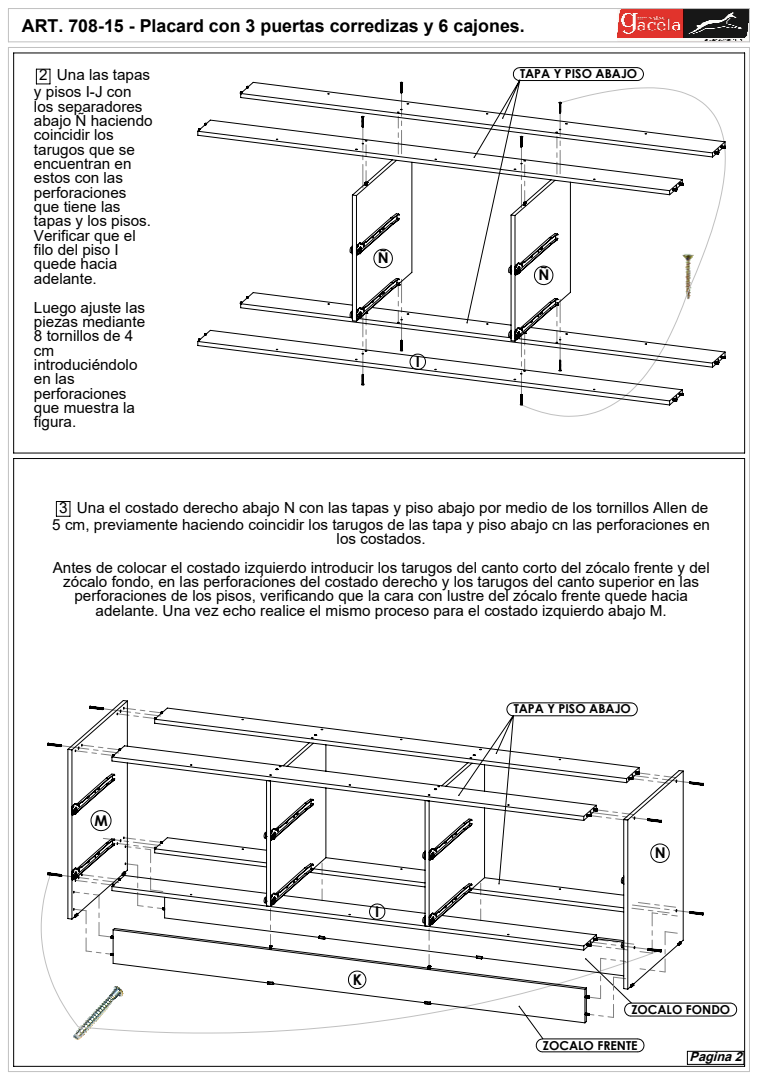
[picture p155: page 3]
ZOCALO FRENTE; ZOCALO FONDO; Una las tapas; Una el costado derecho abajo N con las tapas y piso abajo por medio de los tornillos Allen de; los costados.; Pagina 2

y pisos I-J con
los separadores
abajo Ñ haciendo
coincidir los
tarugos que se
encuentran en
estos con las
perforaciones
que tiene las
tapas y los pisos.
Verificar que el
filo del piso I
quede hacia
adelante.
Luego ajuste las
piezas mediante
8 tornillos de 4
introduciéndolo
en las
que muestra la
figura.

TAPA Y PISO ABAJO

5 cm, previamente haciendo coincidir los tarugos de las tapa y piso abajo cn las perforaciones en

Antes de colocar el costado izquierdo introducir los tarugos del canto corto del zócalo frente y del
zócalo fondo, en las perforaciones del costado derecho y los tarugos del canto superior en las
perforaciones de los pisos, verificando que la cara con lustre del zócalo frente quede hacia
adelante. Una vez echo realice el mismo proceso para el costado izquierdo abajo M.

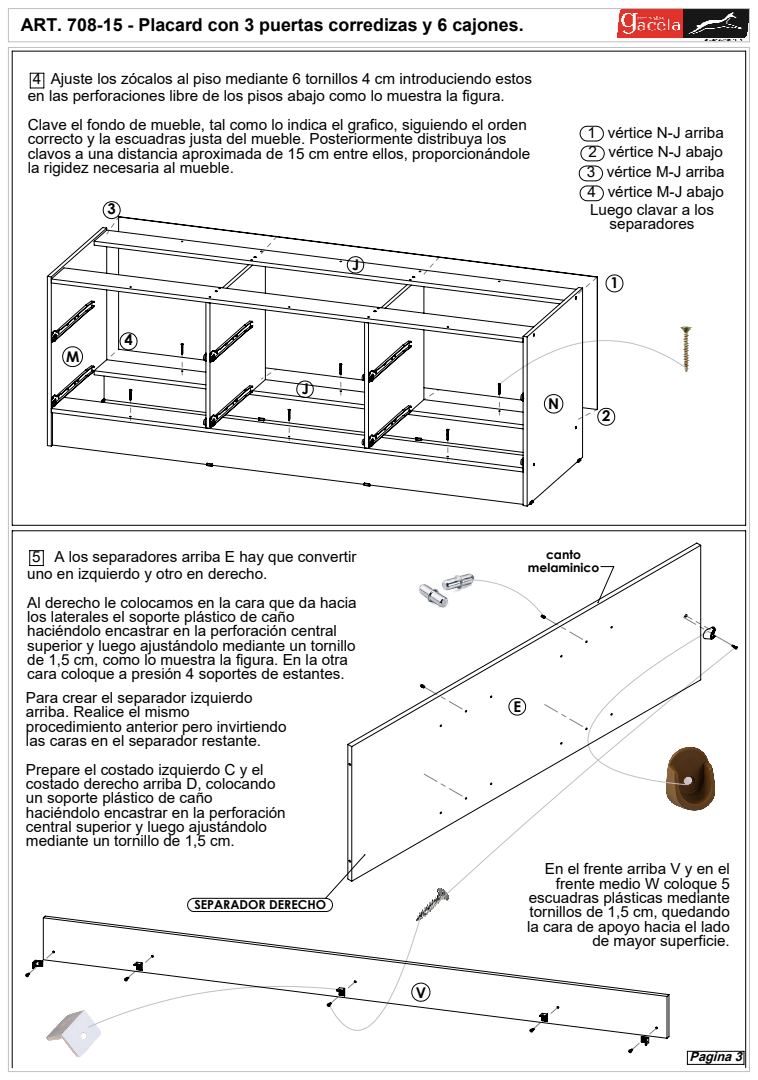
[picture p156: page 4]
SEPARADOR DERECHO; Ajuste los zócalos al piso mediante 6 tornillos 4 cm introduciendo estos; A los separadores arriba E hay que convertir; Pagina 3

en las perforaciones libre de los pisos abajo como lo muestra la figura.
Clave el fondo de mueble, tal como lo indica el grafico, siguiendo el orden
correcto y la escuadras justa del mueble. Posteriormente distribuya los
clavos a una distancia aproximada de 15 cm entre ellos, proporcionándole
la rigidez necesaria al mueble.

1 vértice N-J arriba
2 vértice N-J abajo
3 vértice M-J arriba
4 vértice M-J abajo
Luego clavar a los
separadores

uno en izquierdo y otro en derecho.
Al derecho le colocamos en la cara que da hacia
los laterales el soporte plástico de caño
haciéndolo encastrar en la perforación central
superior y luego ajustándolo mediante un tornillo
de 1,5 cm, como lo muestra la figura. En la otra
cara coloque a presión 4 soportes de estantes.
Para crear el separador izquierdo
arriba. Realice el mismo
procedimiento anterior pero invirtiendo
las caras en el separador restante.
Prepare el costado izquierdo C y el
costado derecho arriba D, colocando
un soporte plástico de caño
haciéndolo encastrar en la perforación
central superior y luego ajustándolo
mediante un tornillo de 1,5 cm.

En el frente arriba V y en el
frente medio W coloque 5
escuadras plásticas mediante
tornillos de 1,5 cm, quedando
la cara de apoyo hacia el lado de mayor superficie.

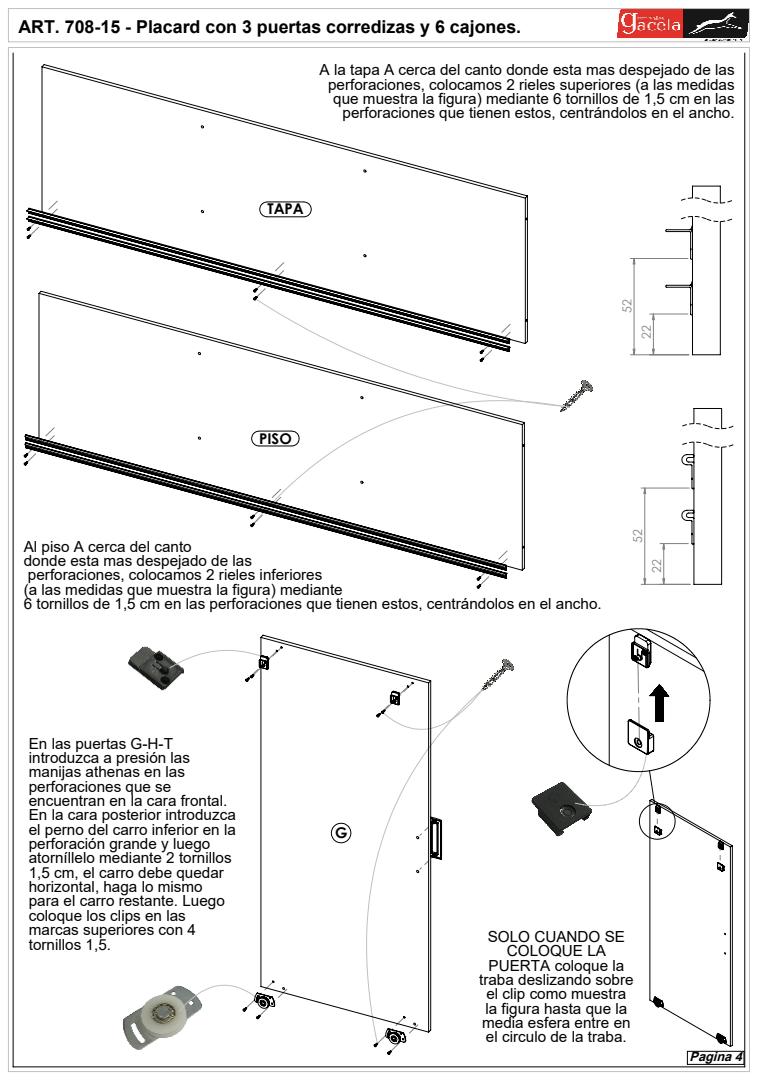
[picture p157: page 5]
tornillos 1,5.; SOLO CUANDO SE; Pagina 4

A la tapa A cerca del canto donde esta mas despejado de las
perforaciones, colocamos 2 rieles superiores (a las medidas
que muestra la figura) mediante 6 tornillos de 1,5 cm en las
perforaciones que tienen estos, centrándolos en el ancho.

Al piso A cerca del canto
donde esta mas despejado de las
perforaciones, colocamos 2 rieles inferiores
(a las medidas que muestra la figura) mediante
6 tornillos de 1,5 cm en las perforaciones que tienen estos, centrándolos en el ancho.

En las puertas G-H-T
introduzca a presión las
manijas athenas en las
perforaciones que se
encuentran en la cara frontal.
En la cara posterior introduzca
el perno del carro inferior en la
perforación grande y luego
atorníllelo mediante 2 tornillos
1,5 cm, el carro debe quedar
horizontal, haga lo mismo
para el carro restante. Luego
coloque los clips en las
marcas superiores con 4

COLOQUE LA
PUERTA coloque la
traba deslizando sobre
el clip como muestra
la figura hasta que la
media esfera entre en
el circulo de la traba.

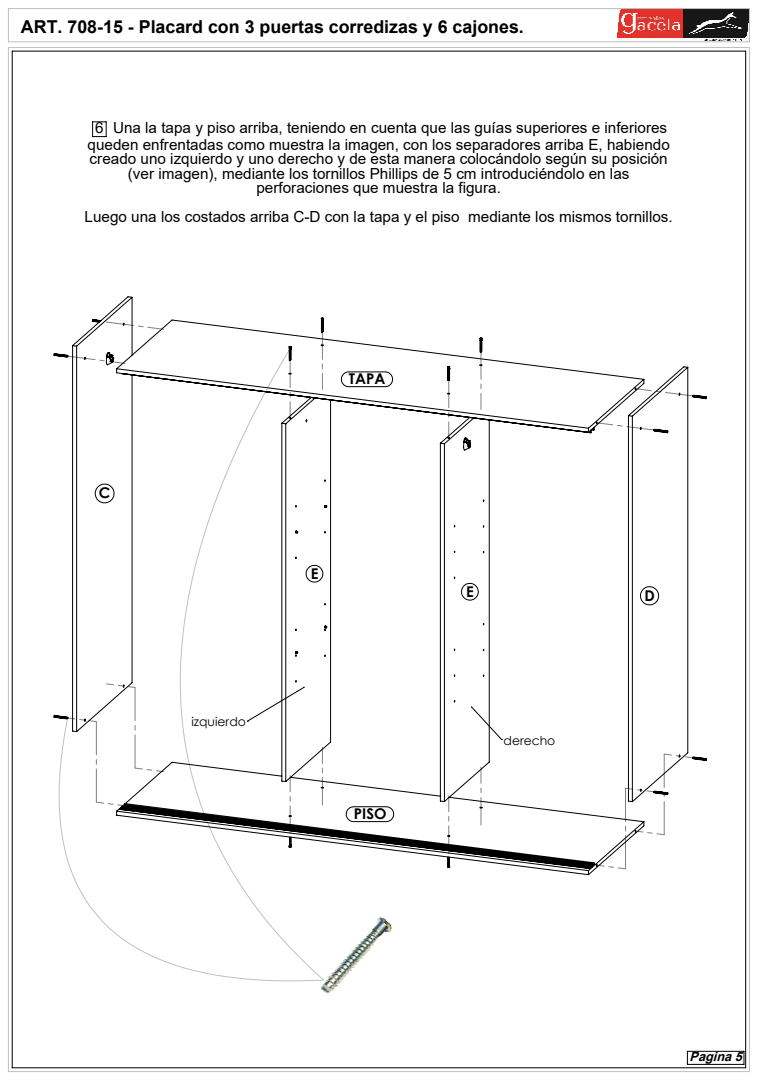
[picture p158: page 6]
Una la tapa y piso arriba, teniendo en cuenta que las guías superiores e inferiores; Pagina 5

queden enfrentadas como muestra la imagen, con los separadores arriba E, habiendo
creado uno izquierdo y uno derecho y de esta manera colocándolo según su posición (ver imagen), mediante los tornillos Phillips de 5 cm introduciéndolo en las perforaciones que muestra la figura.

Luego una los costados arriba C-D con la tapa y el piso mediante los mismos tornillos.

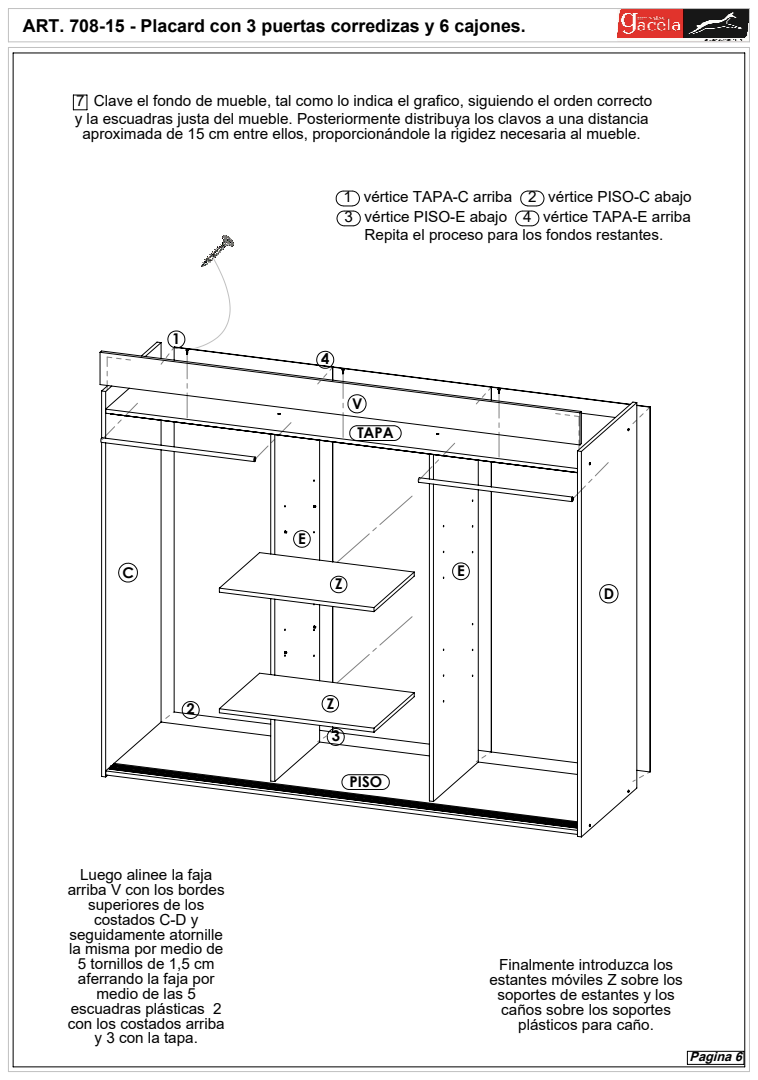
[picture p159: page 7]
Clave el fondo de mueble, tal como lo indica el grafico, siguiendo el orden correcto; Pagina 6

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

1 vértice TAPA-C arriba 2 vértice PISO-C abajo
3 vértice PISO-E abajo 4 vértice TAPA-E arriba
Repita el proceso para los fondos restantes.

Luego alinee la faja
arriba V con los bordes
superiores de los
costados C-D y
seguidamente atornille
la misma por medio de
5 tornillos de 1,5 cm
aferrando la faja por
medio de las 5
escuadras plásticas 2
con los costados arriba
y 3 con la tapa.

Finalmente introduzca los
estantes móviles Z sobre los
soportes de estantes y los
caños sobre los soportes
plásticos para caño.

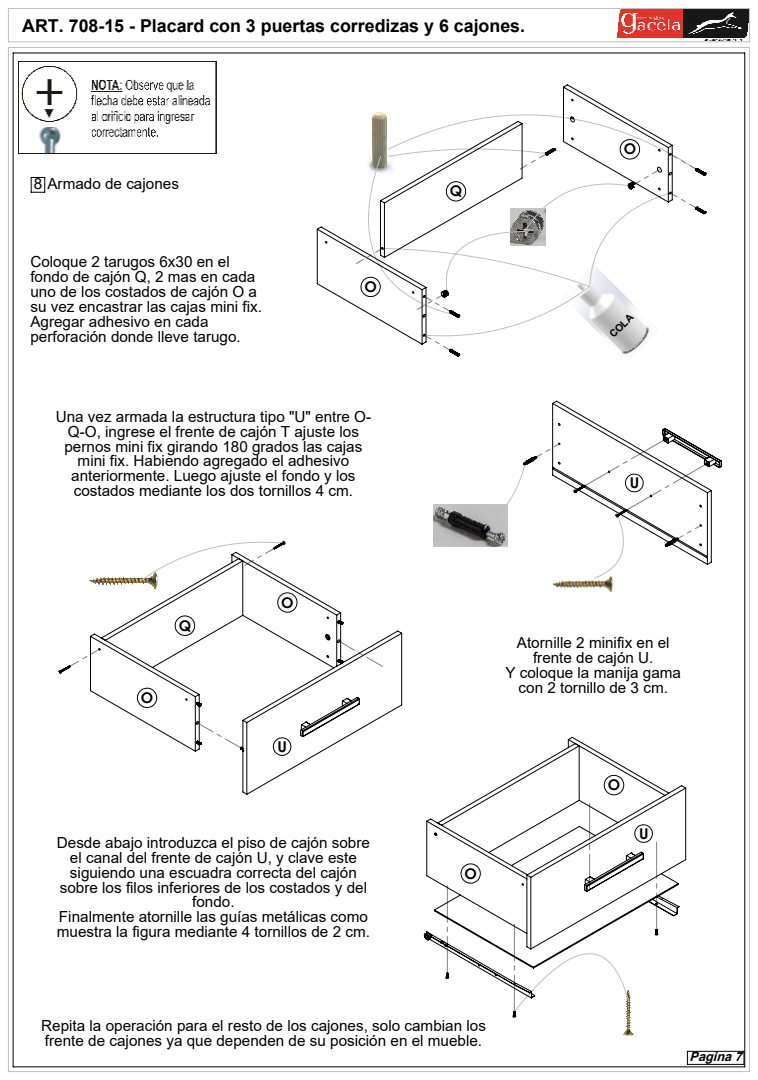
[picture p160: page 8]
Pagina 7

8 Armado de cajones

Coloque 2 tarugos 6x30 en el
fondo de cajón Q, 2 mas en cada
uno de los costados de cajón O a
su vez encastrar las cajas mini fix.
Agregar adhesivo en cada
perforación donde lleve tarugo.

Una vez armada la estructura tipo "U" entre O-
Q-O, ingrese el frente de cajón T ajuste los
pernos mini fix girando 180 grados las cajas
mini fix. Habiendo agregado el adhesivo
anteriormente. Luego ajuste el fondo y los
costados mediante los dos tornillos 4 cm.

Atornille 2 minifix en el
frente de cajón U.
Y coloque la manija gama
con 2 tornillo de 3 cm.

Desde abajo introduzca el piso de cajón sobre
el canal del frente de cajón U, y clave este
siguiendo una escuadra correcta del cajón
sobre los filos inferiores de los costados y del
Finalmente atornille las guías metálicas como
muestra la figura mediante 4 tornillos de 2 cm.

Repita la operación para el resto de los cajones, solo cambian los
frente de cajones ya que dependen de su posición en el mueble.

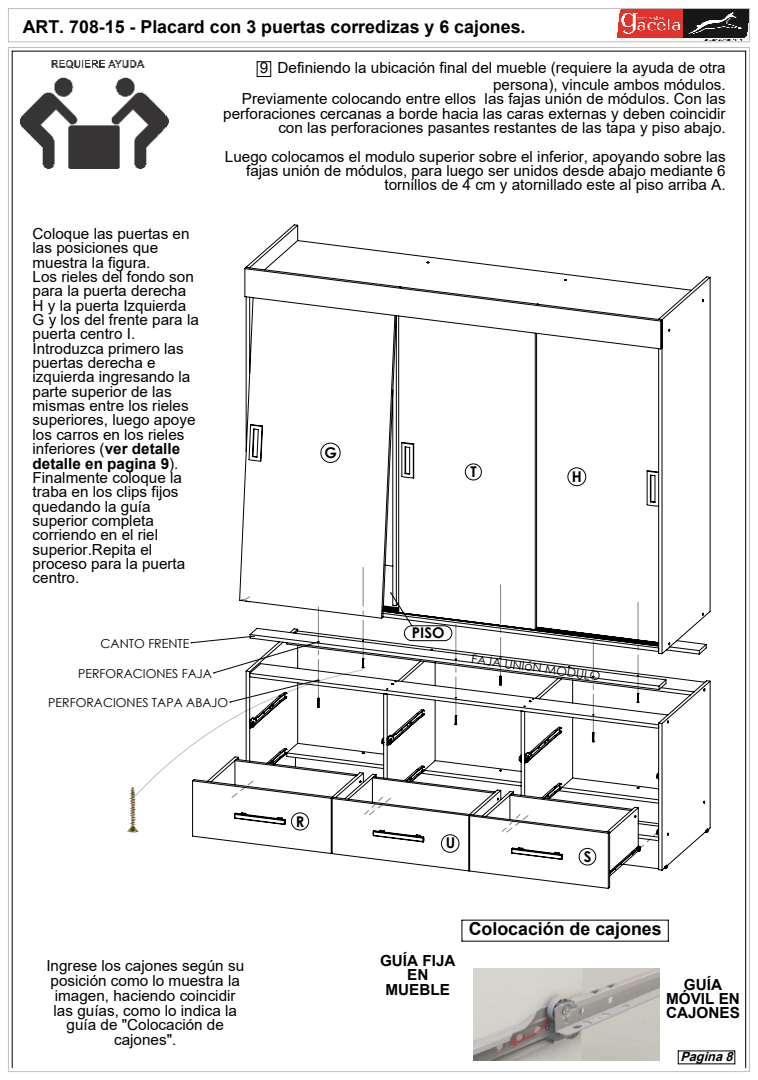
[picture p161: page 9]
Definiendo la ubicación final del mueble (requiere la ayuda de otra; MÓVIL EN; GUÍA FIJA; Pagina 8

persona), vincule ambos módulos. Previamente colocando entre ellos las fajas unión de módulos. Con las perforaciones cercanas a borde hacia las caras externas y deben coincidir con las perforaciones pasantes restantes de las tapa y piso abajo.

Luego colocamos el modulo superior sobre el inferior, apoyando sobre las fajas unión de módulos, para luego ser unidos desde abajo mediante 6

tornillos de 4 cm y atornillado este al piso arriba A.

Coloque las puertas en
las posiciones que
muestra la figura.
Los rieles del fondo son
para la puerta derecha
H y la puerta Izquierda
G y los del frente para la
puerta centro I.
Introduzca primero las
puertas derecha e
izquierda ingresando la
parte superior de las
mismas entre los rieles
superiores, luego apoye
los carros en los rieles
inferiores (ver detalle
detalle en pagina 9).
Finalmente coloque la
traba en los clips fijos
quedando la guía
superior completa
corriendo en el riel
superior.Repita el
proceso para la puerta
centro.

CANTO FRENTE
PERFORACIONES FAJA
PERFORACIONES TAPA ABAJO

FAJA UNIóN MODULO

Colocación de cajones

Ingrese los cajones según su
posición como lo muestra la
imagen, haciendo coincidir
las guías, como lo indica la
guía de "Colocación de
cajones".

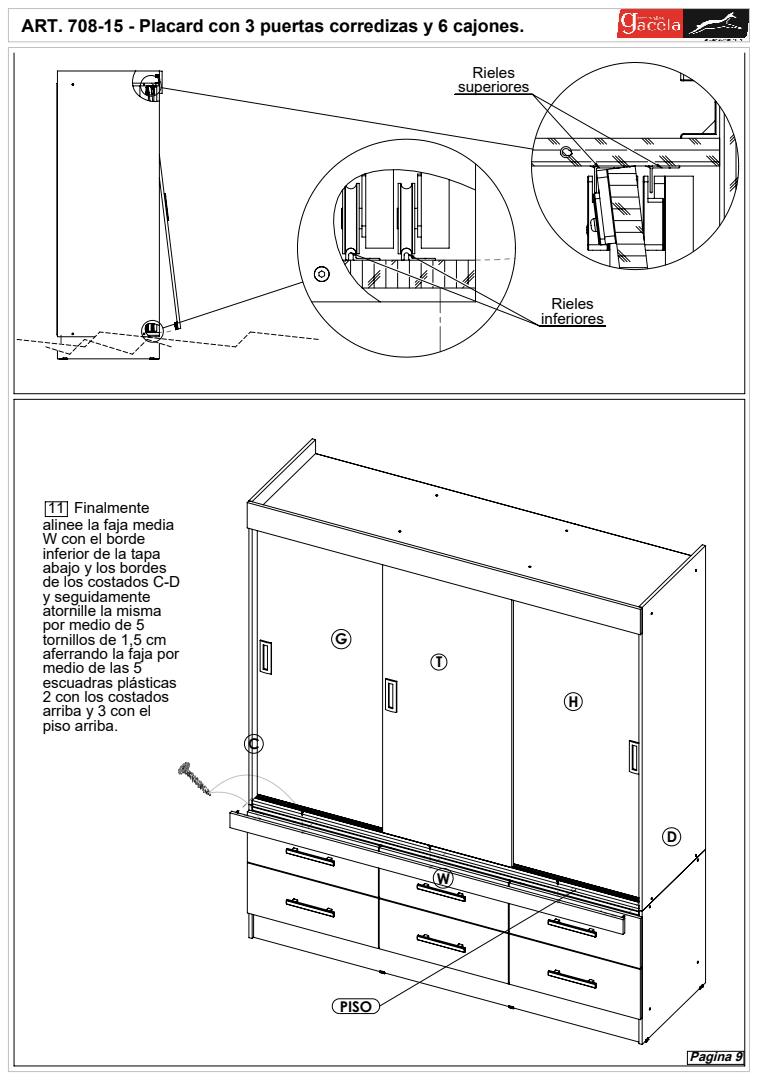
[picture p162: page 10]
Pagina 9

11 Finalmente
alinee la faja media
W con el borde
inferior de la tapa
abajo y los bordes
de los costados C-D
y seguidamente
atornille la misma
por medio de 5
tornillos de 1,5 cm
aferrando la faja por
medio de las 5
escuadras plásticas
2 con los costados
arriba y 3 con el
piso arriba.
