infomueblesgacela/muebles-gacela-mvp/public/modelos_3d/linea-clasica/A221150/A221150.PDF

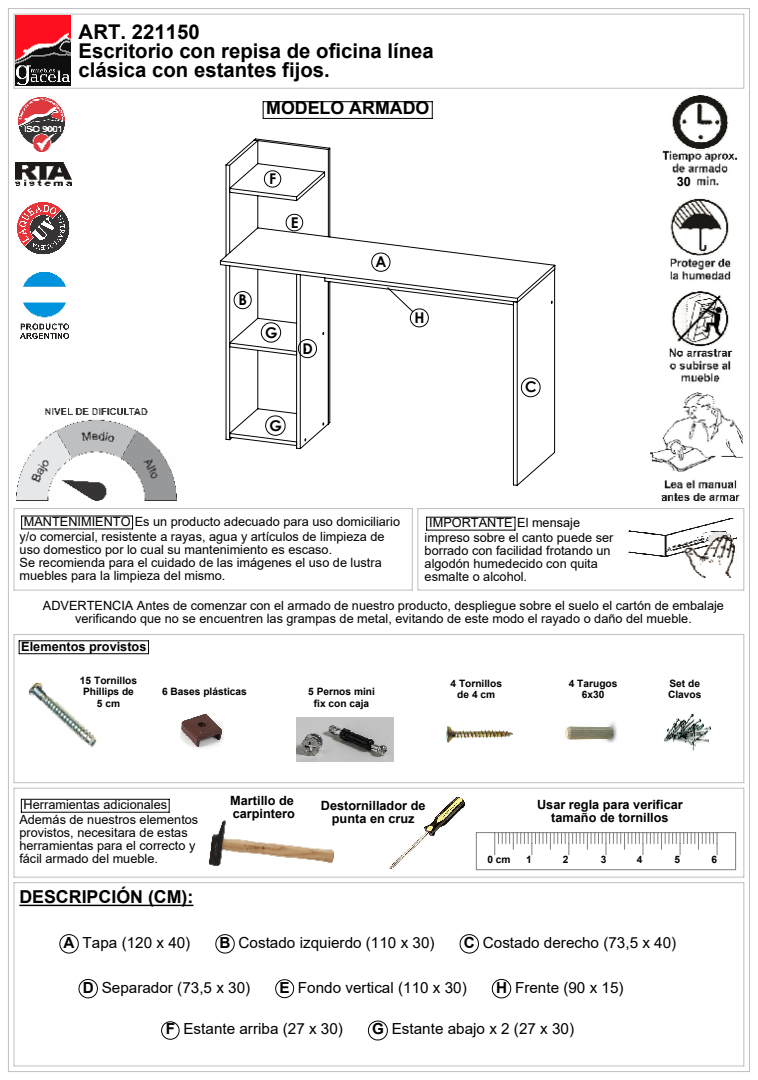
[picture p163: page 1]
A Tapa (120 x 40); B Costado izquierdo (110 x 30); C Costado derecho (73,5 x 40); D Separador (73,5 x 30); E Fondo vertical (110 x 30); H Frente (90 x 15); F Estante arriba (27 x 30); G Estante abajo x 2 (27 x 30); 4 Tarugos; Set de; Martillo de; carpintero; Destornillador de; MODELO ARMADO; 15 Tornillos Phillips de 5 cm; 6 Bases plásticas; 4 Tornillos de 4 cm

ART. 221150
Escritorio con repisa de oficina línea
clásica con estantes fijos.

MANTENIMIENTO Es un producto adecuado para uso domiciliario
y/o comercial, resistente a rayas, agua y artículos de limpieza de
uso domestico por lo cual su mantenimiento es escaso.
Se recomienda para el cuidado de las imágenes el uso de lustra
muebles para la limpieza del mismo.
ADVERTENCIA Antes de comenzar con el armado de nuestro producto, despliegue sobre el suelo el cartón de embalaje
verificando que no se encuentren las grampas de metal, evitando de este modo el rayado o daño del mueble.
Elementos provistos

IMPORTANTE El mensaje
impreso sobre el canto puede ser
borrado con facilidad frotando un
algodón humedecido con quita
esmalte o alcohol.

5 Pernos mini
fix con caja

Herramientas adicionales
Además de nuestros elementos
provistos, necesitara de estas
herramientas para el correcto y
fácil armado del mueble.
DESCRIPCIÓN (CM):

Usar regla para verificar

punta en cruz tamaño de tornillos

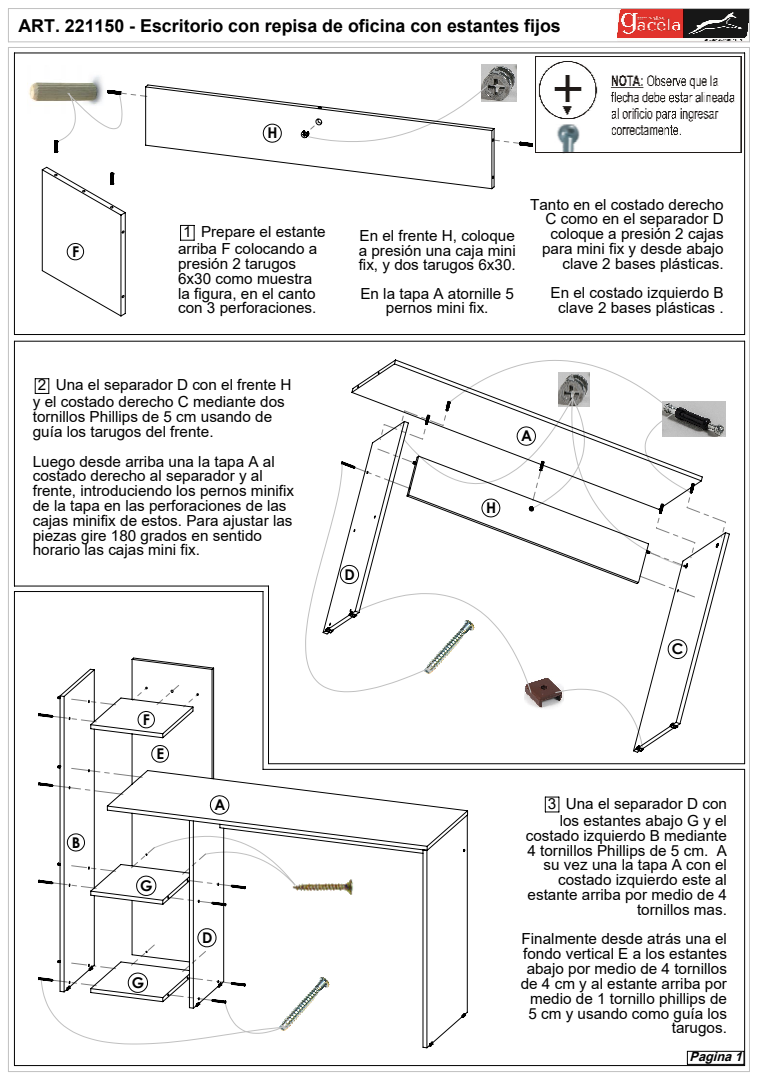
[picture p164: page 2]
Una el separador D con el frente H; Prepare el estante; Una el separador D con; tornillos mas.; Pagina 1

ART. 221150 - Escritorio con repisa de oficina con estantes fijos

Tanto en el costado derecho
C como en el separador D
coloque a presión 2 cajas
para mini fix y desde abajo
clave 2 bases plásticas.
En el costado izquierdo B
clave 2 bases plásticas .

arriba F colocando a
presión 2 tarugos
6x30 como muestra
la figura, en el canto
con 3 perforaciones.

En el frente H, coloque
a presión una caja mini
fix, y dos tarugos 6x30.
En la tapa A atornille 5
pernos mini fix.

y el costado derecho C mediante dos
tornillos Phillips de 5 cm usando de
guía los tarugos del frente.
Luego desde arriba una la tapa A al
costado derecho al separador y al
frente, introduciendo los pernos minifix
de la tapa en las perforaciones de las
cajas minifix de estos. Para ajustar las
piezas gire 180 grados en sentido
horario las cajas mini fix.

los estantes abajo G y el
costado izquierdo B mediante
4 tornillos Phillips de 5 cm. A
su vez una la tapa A con el
costado izquierdo este al
estante arriba por medio de 4

Finalmente desde atrás una el
fondo vertical E a los estantes
abajo por medio de 4 tornillos
de 4 cm y al estante arriba por
medio de 1 tornillo phillips de
5 cm y usando como guía los
