infomueblesgacela/muebles-gacela-mvp/public/modelos_3d/linea-comedores/A427091/A427091.PDF

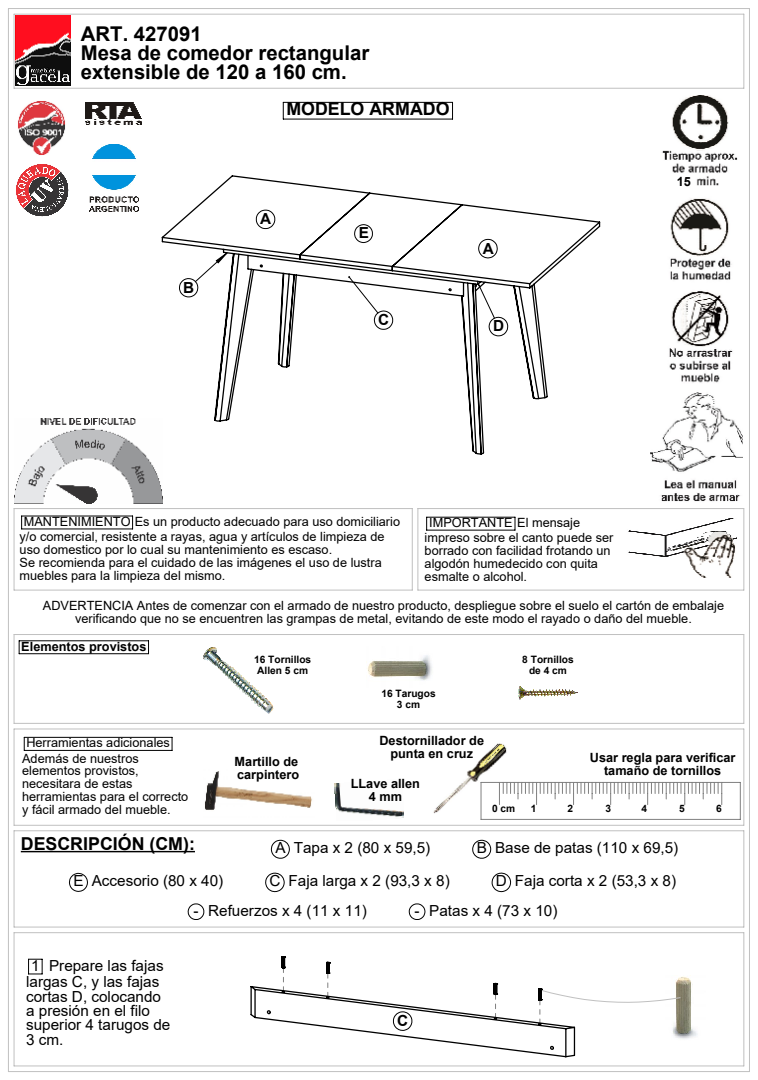
[picture p165: page 1]
A Tapa x 2 (80 x 59,5); B Base de patas (110 x 69,5); E Accesorio (80 x 40); C Faja larga x 2 (93,3 x 8); D Faja corta x 2 (53,3 x 8); - Refuerzos x 4 (11 x 11); - Patas x 4 (73 x 10); Prepare las fajas; Martillo de; MODELO ARMADO; 16 Tornillos Allen 5 cm; 16 Tarugos 3 cm; 8 Tornillos de 4 cm

ART. 427091
Mesa de comedor rectangular
extensible de 120 a 160 cm.

MANTENIMIENTO Es un producto adecuado para uso domiciliario
y/o comercial, resistente a rayas, agua y artículos de limpieza de
uso domestico por lo cual su mantenimiento es escaso.
Se recomienda para el cuidado de las imágenes el uso de lustra
muebles para la limpieza del mismo.
ADVERTENCIA Antes de comenzar con el armado de nuestro producto, despliegue sobre el suelo el cartón de embalaje
verificando que no se encuentren las grampas de metal, evitando de este modo el rayado o daño del mueble.
Elementos provistos

IMPORTANTE El mensaje
impreso sobre el canto puede ser
borrado con facilidad frotando un
algodón humedecido con quita
esmalte o alcohol.

Herramientas adicionales
Además de nuestros
elementos provistos,
necesitara de estas
herramientas para el correcto
y fácil armado del mueble.
DESCRIPCIÓN (CM):

Destornillador de
punta en cruz
LLave allen

Usar regla para verificar
tamaño de tornillos

largas C, y las fajas
cortas D, colocando
a presión en el filo
superior 4 tarugos de

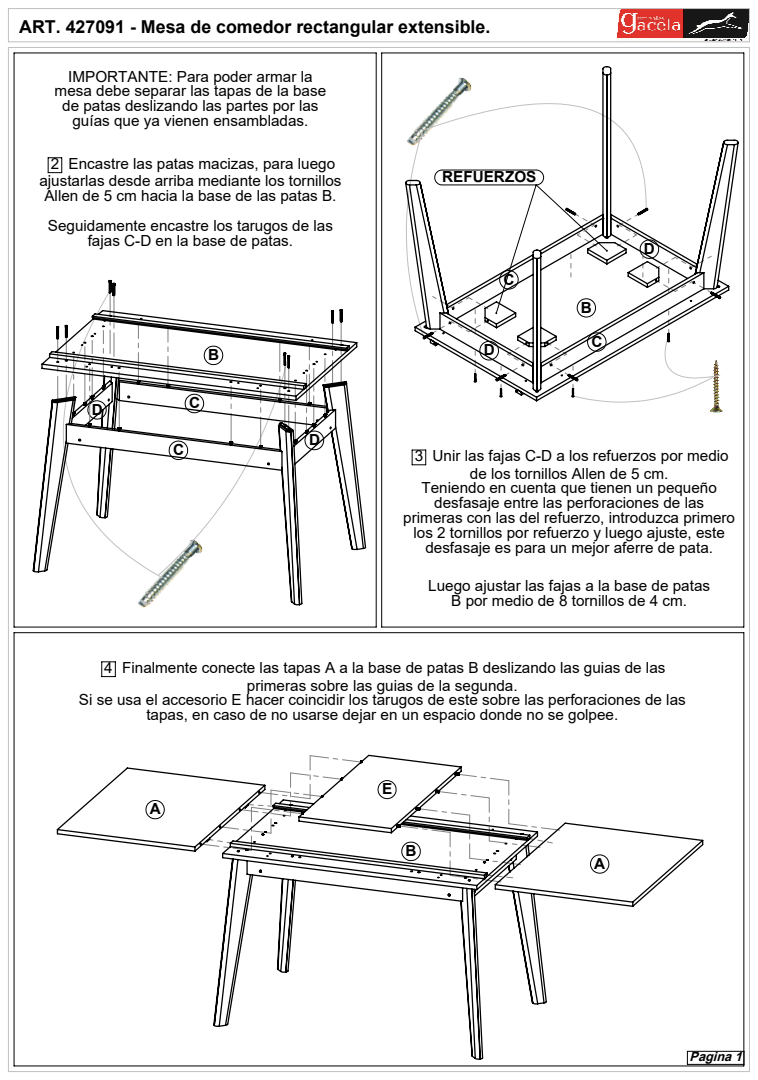
[picture p166: page 2]
Finalmente conecte las tapas A a la base de patas B deslizando las guias de las; Encastre las patas macizas, para luego; Unir las fajas C-D a los refuerzos por medio; Pagina 1

ART. 427091 - Mesa de comedor rectangular extensible.

IMPORTANTE: Para poder armar la
mesa debe separar las tapas de la base
de patas deslizando las partes por las
guías que ya vienen ensambladas.

ajustarlas desde arriba mediante los tornillos
Allen de 5 cm hacia la base de las patas B.
Seguidamente encastre los tarugos de las
fajas C-D en la base de patas.

de los tornillos Allen de 5 cm.
Teniendo en cuenta que tienen un pequeño
desfasaje entre las perforaciones de las
primeras con las del refuerzo, introduzca primero
los 2 tornillos por refuerzo y luego ajuste, este
desfasaje es para un mejor aferre de pata.
Luego ajustar las fajas a la base de patas
B por medio de 8 tornillos de 4 cm.

Si se usa el accesorio E hacer coincidir los tarugos de este sobre las perforaciones de las

primeras sobre las guias de la segunda.

tapas, en caso de no usarse dejar en un espacio donde no se golpee.
