infomueblesgacela/muebles-gacela-mvp/public/modelos_3d/linea-comedores/A429090/A429090.PDF

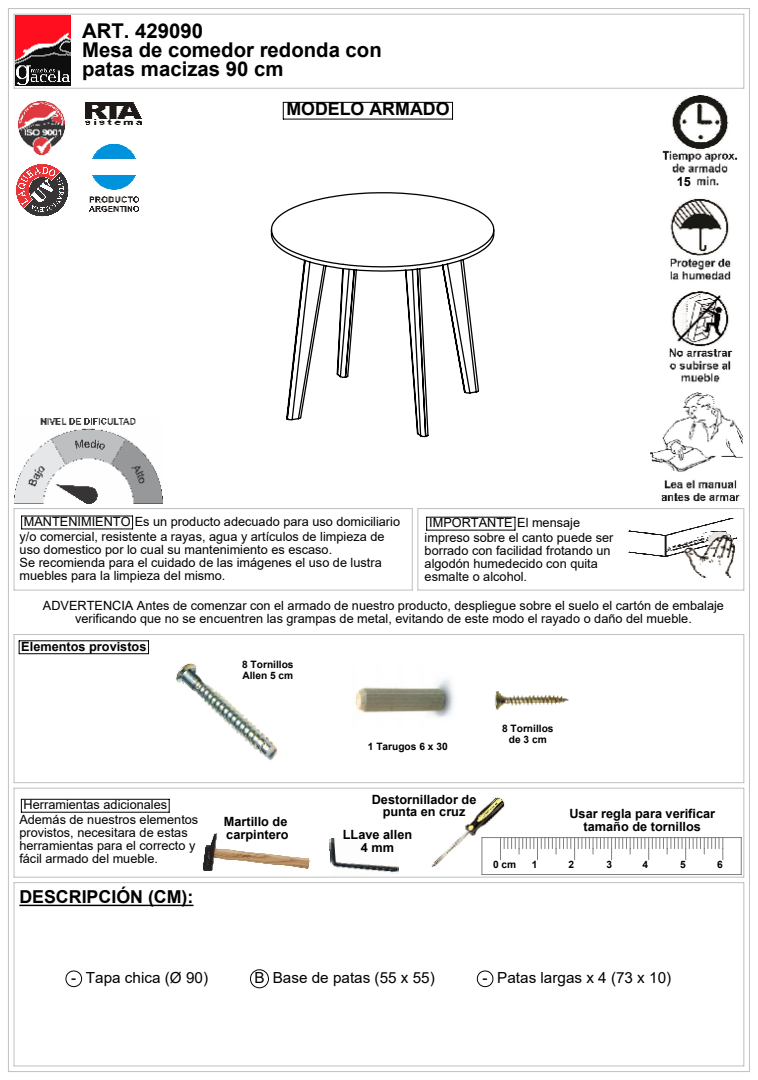
[picture p167: page 1]
- Tapa chica (Ø 90); B Base de patas (55 x 55); - Patas largas x 4 (73 x 10); Martillo de; MODELO ARMADO; 8 Tornillos Allen 5 cm; 1 Tarugos 6 x 30; 8 Tornillos de 3 cm

ART. 429090
Mesa de comedor redonda con
patas macizas 90 cm

MANTENIMIENTO Es un producto adecuado para uso domiciliario
y/o comercial, resistente a rayas, agua y artículos de limpieza de
uso domestico por lo cual su mantenimiento es escaso.
Se recomienda para el cuidado de las imágenes el uso de lustra
muebles para la limpieza del mismo.
ADVERTENCIA Antes de comenzar con el armado de nuestro producto, despliegue sobre el suelo el cartón de embalaje
verificando que no se encuentren las grampas de metal, evitando de este modo el rayado o daño del mueble.
Elementos provistos

IMPORTANTE El mensaje
impreso sobre el canto puede ser
borrado con facilidad frotando un
algodón humedecido con quita
esmalte o alcohol.

Herramientas adicionales
Además de nuestros elementos
provistos, necesitara de estas
herramientas para el correcto y
fácil armado del mueble.
DESCRIPCIÓN (CM):

Destornillador de
punta en cruz
LLave allen

Usar regla para verificar
tamaño de tornillos

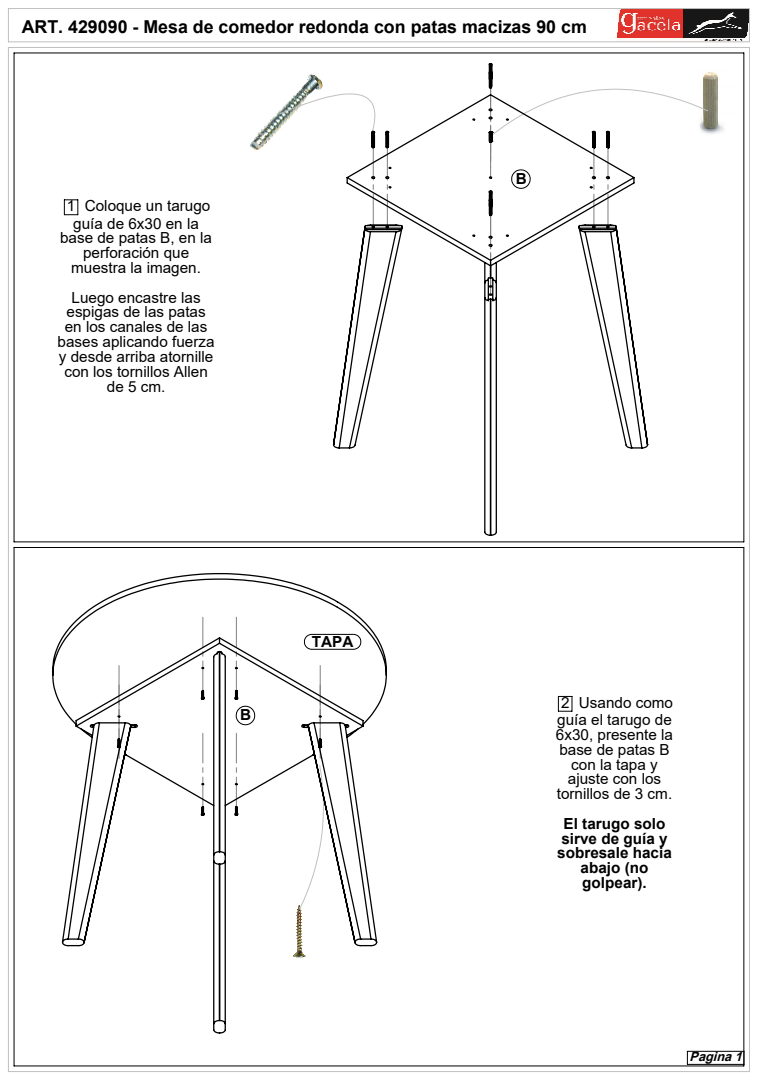
[picture p168: page 2]
Usando como; Coloque un tarugo; Pagina 1

ART. 429090 - Mesa de comedor redonda con patas macizas 90 cm

guía de 6x30 en la
base de patas B, en la
perforación que
muestra la imagen.
Luego encastre las
espigas de las patas
en los canales de las
bases aplicando fuerza
y desde arriba atornille
con los tornillos Allen

guía el tarugo de
6x30, presente la
base de patas B
con la tapa y
ajuste con los
tornillos de 3 cm.
El tarugo solo
sirve de guía y
sobresale hacia
abajo (no
golpear).
