infomueblesgacela/muebles-gacela-mvp/public/modelos_3d/linea-comedores/A429091/A429091.PDF

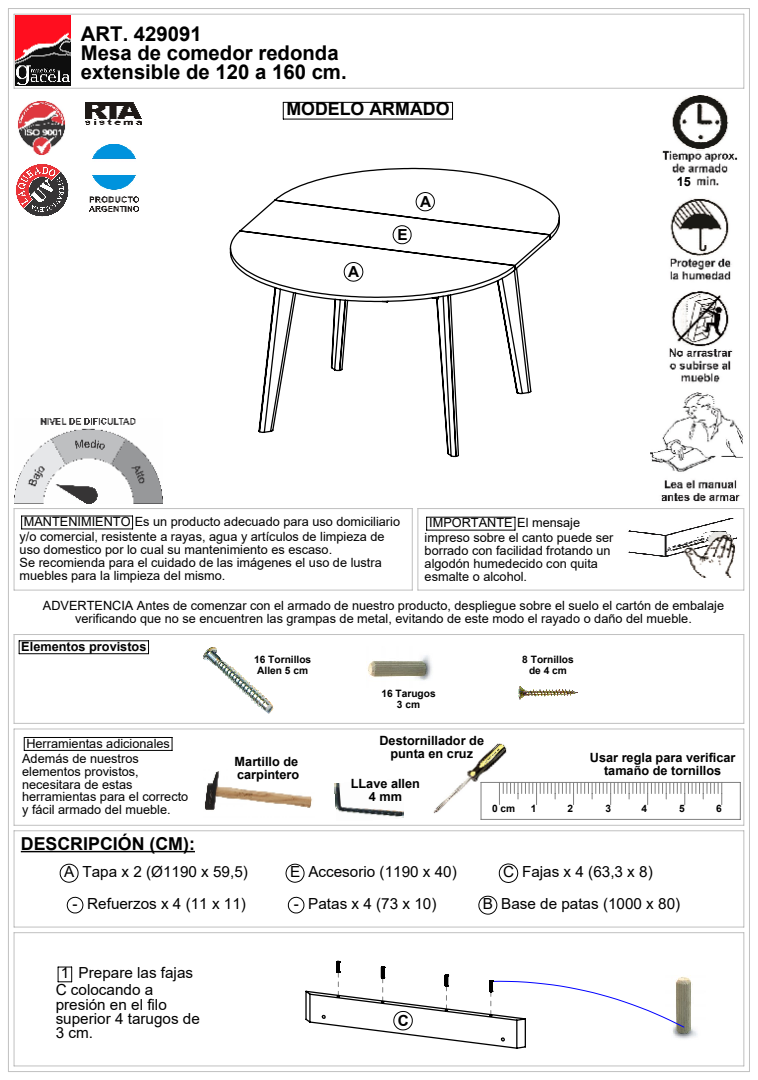
[picture p169: page 1]
A Tapa x 2 (Ø1190 x 59,5); E Accesorio (1190 x 40); C Fajas x 4 (63,3 x 8); - Refuerzos x 4 (11 x 11); - Patas x 4 (73 x 10); B Base de patas (1000 x 80); Prepare las fajas; Martillo de; MODELO ARMADO; 16 Tornillos Allen 5 cm; 16 Tarugos 3 cm; 8 Tornillos de 4 cm

ART. 429091
Mesa de comedor redonda
extensible de 120 a 160 cm.

MANTENIMIENTO Es un producto adecuado para uso domiciliario
y/o comercial, resistente a rayas, agua y artículos de limpieza de
uso domestico por lo cual su mantenimiento es escaso.
Se recomienda para el cuidado de las imágenes el uso de lustra
muebles para la limpieza del mismo.
ADVERTENCIA Antes de comenzar con el armado de nuestro producto, despliegue sobre el suelo el cartón de embalaje
verificando que no se encuentren las grampas de metal, evitando de este modo el rayado o daño del mueble.
Elementos provistos

IMPORTANTE El mensaje
impreso sobre el canto puede ser
borrado con facilidad frotando un
algodón humedecido con quita
esmalte o alcohol.

Herramientas adicionales
Además de nuestros
elementos provistos,
necesitara de estas
herramientas para el correcto
y fácil armado del mueble.
DESCRIPCIÓN (CM):

Destornillador de
punta en cruz
LLave allen

Usar regla para verificar
tamaño de tornillos

C colocando a
presión en el filo
superior 4 tarugos de

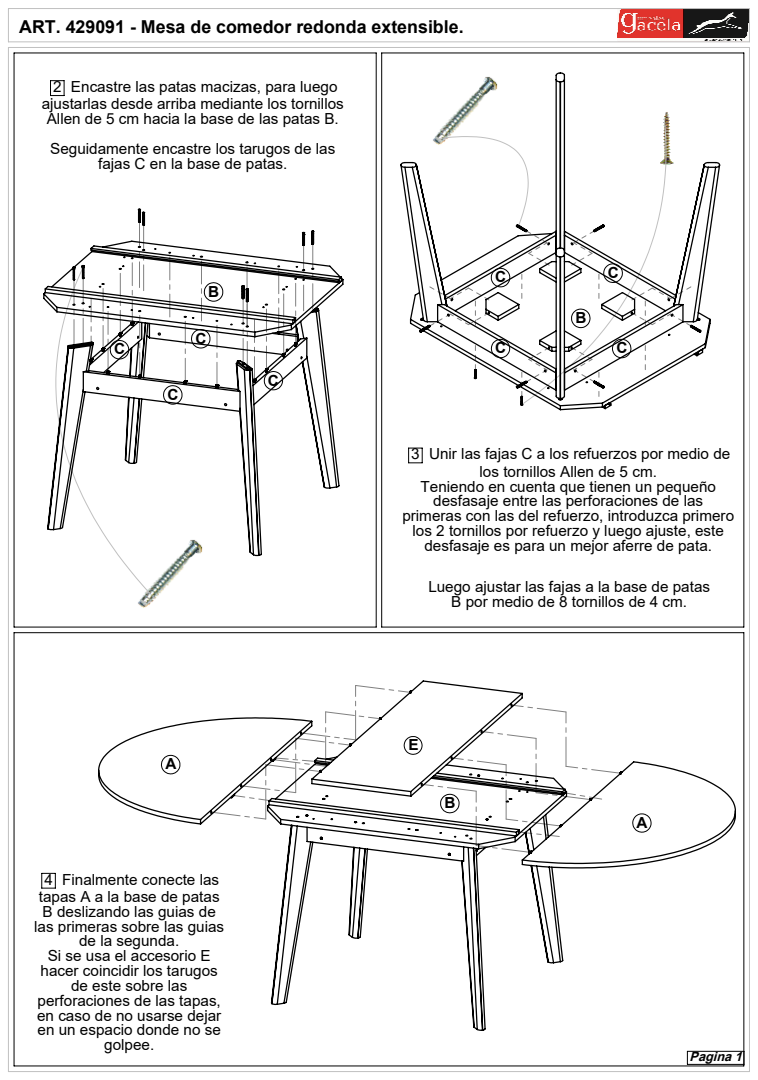
[picture p170: page 2]
Finalmente conecte las; Encastre las patas macizas, para luego; Unir las fajas C a los refuerzos por medio de; Pagina 1

ART. 429091 - Mesa de comedor redonda extensible.

ajustarlas desde arriba mediante los tornillos
Allen de 5 cm hacia la base de las patas B.
Seguidamente encastre los tarugos de las
fajas C en la base de patas.

Teniendo en cuenta que tienen un pequeño
desfasaje entre las perforaciones de las
primeras con las del refuerzo, introduzca primero
los 2 tornillos por refuerzo y luego ajuste, este
desfasaje es para un mejor aferre de pata.

los tornillos Allen de 5 cm.

Luego ajustar las fajas a la base de patas
B por medio de 8 tornillos de 4 cm.

tapas A a la base de patas
B deslizando las guias de
las primeras sobre las guias
de la segunda.
Si se usa el accesorio E
hacer coincidir los tarugos
de este sobre las
perforaciones de las tapas,
en caso de no usarse dejar
en un espacio donde no se
