infomueblesgacela/muebles-gacela-mvp/public/modelos_3d/linea-infantil/A334090/A334090.PDF

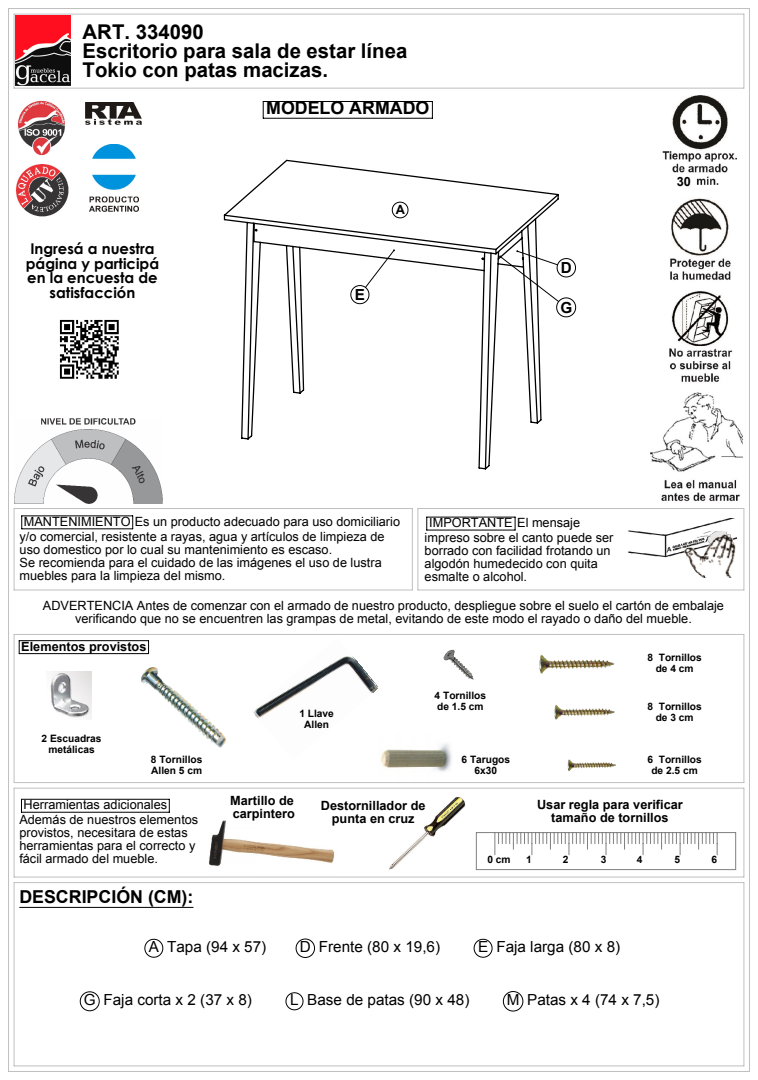
[picture p171: page 1]
A Tapa (94 x 57); D Frente (80 x 19,6); E Faja larga (80 x 8); G Faja corta x 2 (37 x 8); L Base de patas (90 x 48); M Patas x 4 (74 x 7,5); 1 Llave; 6 Tarugos; Martillo de; carpintero; Destornillador de; Elementos provistos; MODELO ARMADO; 8 Tornillos Allen 5 cm; 4 Tornillos de 1.5 cm; 6 Tornillos de 2.5 cm; 8 Tornillos de 4 cm; 8 Tornillos de 3 cm; 2 Escuadras

ART. 334090
Escritorio para sala de estar línea
Tokio con patas macizas.

Ingresá a nuestra
página y participá
en la encuesta de
satisfacción

MANTENIMIENTO Es un producto adecuado para uso domiciliario
y/o comercial, resistente a rayas, agua y artículos de limpieza de
uso domestico por lo cual su mantenimiento es escaso.
Se recomienda para el cuidado de las imágenes el uso de lustra
muebles para la limpieza del mismo.
ADVERTENCIA Antes de comenzar con el armado de nuestro producto, despliegue sobre el suelo el cartón de embalaje
verificando que no se encuentren las grampas de metal, evitando de este modo el rayado o daño del mueble.

IMPORTANTE El mensaje
impreso sobre el canto puede ser
borrado con facilidad frotando un
algodón humedecido con quita
esmalte o alcohol.

Herramientas adicionales
Además de nuestros elementos
provistos, necesitara de estas
herramientas para el correcto y
fácil armado del mueble.
DESCRIPCIÓN (CM):

Usar regla para verificar

punta en cruz tamaño de tornillos

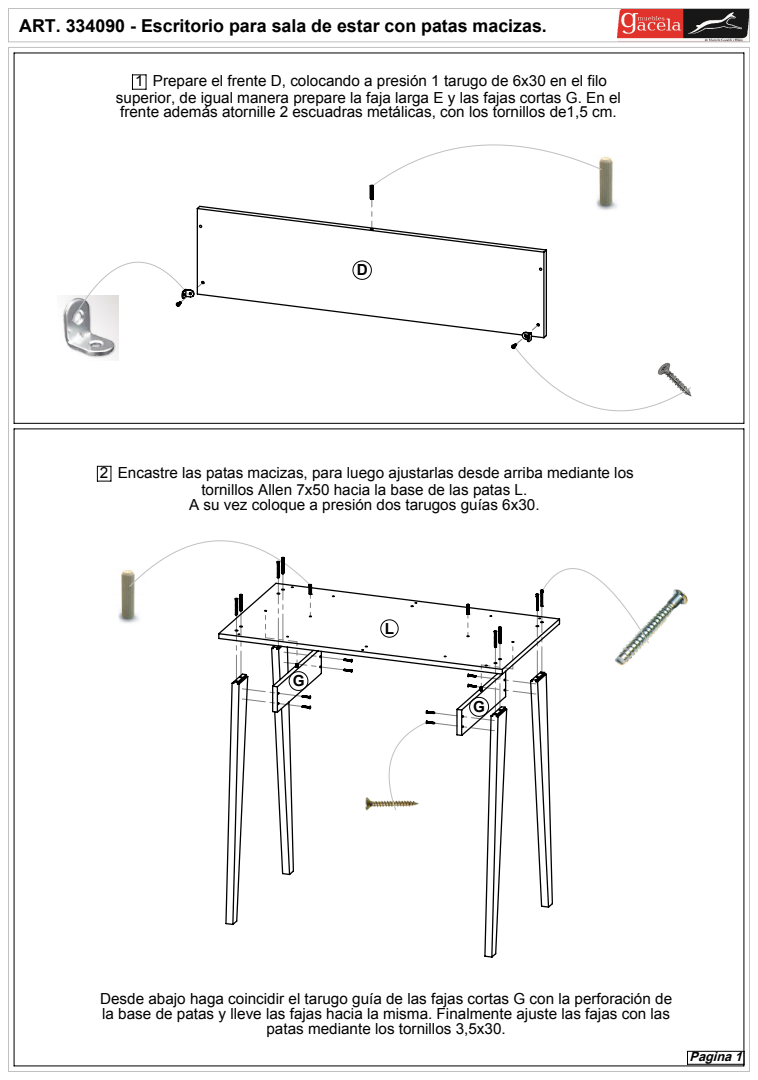
[picture p172: page 2]
Encastre las patas macizas, para luego ajustarlas desde arriba mediante los; Prepare el frente D, colocando a presión 1 tarugo de 6x30 en el filo; Pagina 1

ART. 334090 - Escritorio para sala de estar con patas macizas.

superior, de igual manera prepare la faja larga E y las fajas cortas G. En el
frente además atornille 2 escuadras metálicas, con los tornillos de1,5 cm.

tornillos Allen 7x50 hacia la base de las patas L.
A su vez coloque a presión dos tarugos guías 6x30.

Desde abajo haga coincidir el tarugo guía de las fajas cortas G con la perforación de
la base de patas y lleve las fajas hacia la misma. Finalmente ajuste las fajas con las

patas mediante los tornillos 3,5x30.

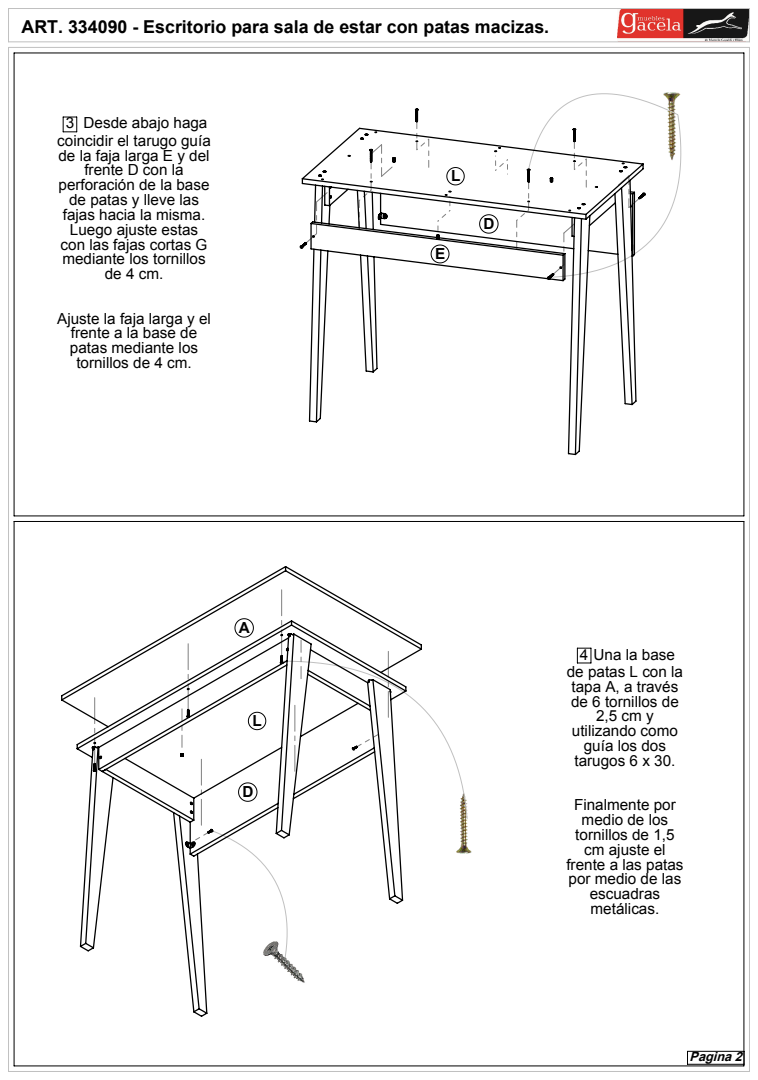
[picture p173: page 3]
Desde abajo haga; Pagina 2

ART. 334090 - Escritorio para sala de estar con patas macizas.

coincidir el tarugo guía
de la faja larga E y del
frente D con la
perforación de la base
de patas y lleve las
fajas hacia la misma.
Luego ajuste estas
con las fajas cortas G
mediante los tornillos

Ajuste la faja larga y el
frente a la base de
patas mediante los
tornillos de 4 cm.

4 Una la base
de patas L con la
tapa A, a través
de 6 tornillos de
utilizando como
guía los dos
tarugos 6 x 30.

Finalmente por
medio de los
tornillos de 1,5
cm ajuste el
frente a las patas
por medio de las
escuadras
metálicas.
