infomueblesgacela/muebles-gacela-mvp/public/modelos_3d/linea-infantil/A753153/A753153.PDF

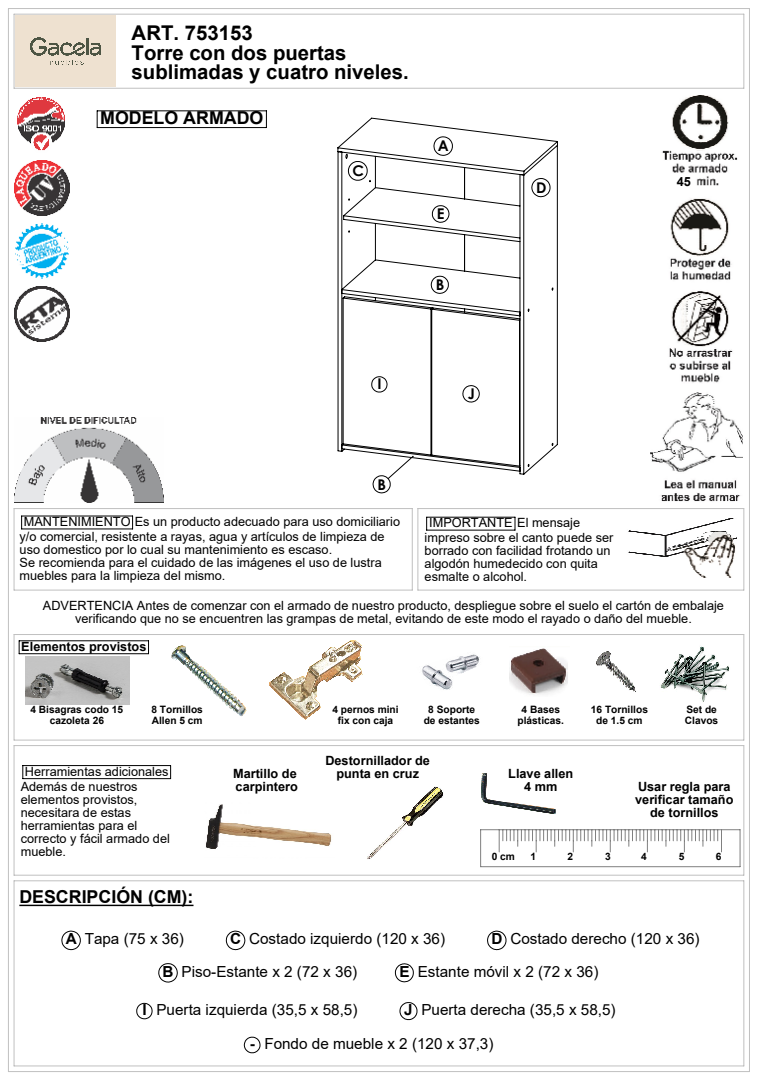
[picture p174: page 1]
B Piso-Estante x 2 (72 x 36); E Estante móvil x 2 (72 x 36); A Tapa (75 x 36); C Costado izquierdo (120 x 36); D Costado derecho (120 x 36); I Puerta izquierda (35,5 x 58,5); J Puerta derecha (35,5 x 58,5); Set de; Martillo de; 8 Tornillos Allen 5 cm; 16 Tornillos de 1.5 cm; 4 Bisagras codo 15 cazoleta 26; 8 Soporte de estantes; 4 Bases; Llave allen 4 mm

ART. 753153
Torre con dos puertas
sublimadas y cuatro niveles.
MODELO ARMADO

MANTENIMIENTO Es un producto adecuado para uso domiciliario
y/o comercial, resistente a rayas, agua y artículos de limpieza de
uso domestico por lo cual su mantenimiento es escaso.
Se recomienda para el cuidado de las imágenes el uso de lustra
muebles para la limpieza del mismo.
ADVERTENCIA Antes de comenzar con el armado de nuestro producto, despliegue sobre el suelo el cartón de embalaje
verificando que no se encuentren las grampas de metal, evitando de este modo el rayado o daño del mueble.
Elementos provistos

IMPORTANTE El mensaje
impreso sobre el canto puede ser
borrado con facilidad frotando un
algodón humedecido con quita
esmalte o alcohol.

4 pernos mini
fix con caja

Destornillador de
punta en cruz

Herramientas adicionales
Además de nuestros
elementos provistos,
necesitara de estas
herramientas para el
correcto y fácil armado del
mueble.
DESCRIPCIÓN (CM):

Usar regla para
verificar tamaño
de tornillos

- Fondo de mueble x 2 (120 x 37,3)

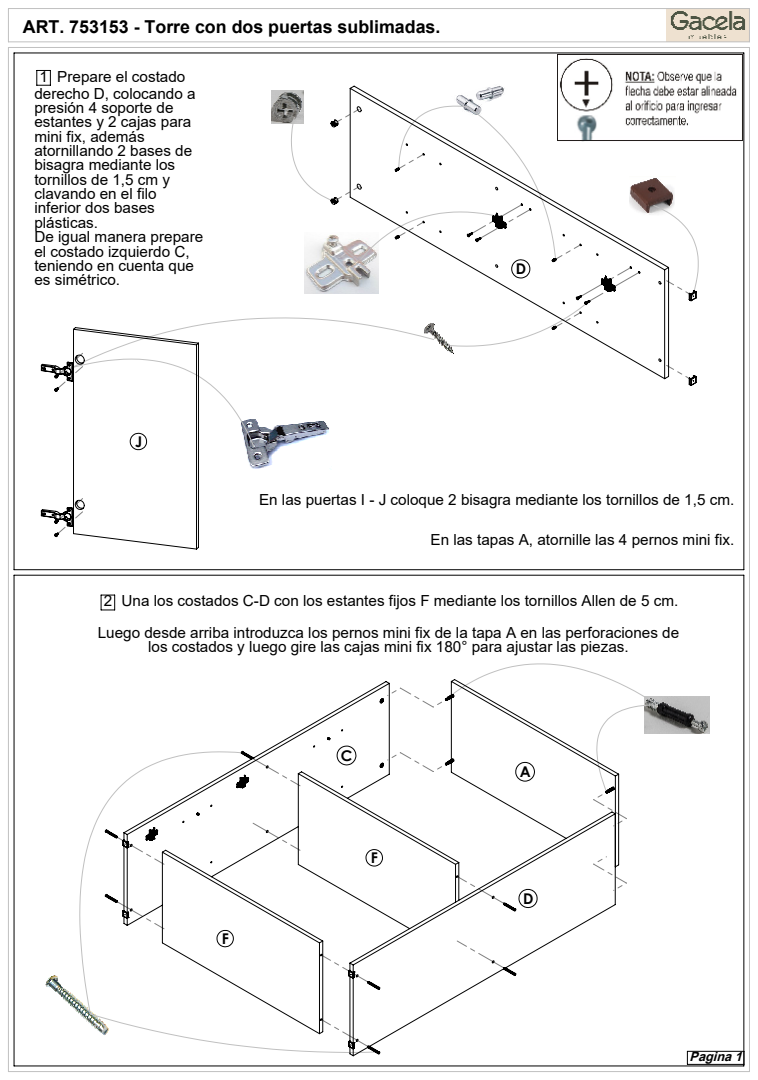
[picture p175: page 2]
Prepare el costado; Una los costados C-D con los estantes fijos F mediante los tornillos Allen de 5 cm.; Pagina 1

ART. 753153 - Torre con dos puertas sublimadas.

derecho D, colocando a
presión 4 soporte de
estantes y 2 cajas para
mini fix, además
atornillando 2 bases de
bisagra mediante los
tornillos de 1,5 cm y
clavando en el filo
inferior dos bases
plásticas.
De igual manera prepare
el costado izquierdo C,
teniendo en cuenta que
es simétrico.

En las puertas I - J coloque 2 bisagra mediante los tornillos de 1,5 cm.

En las tapas A, atornille las 4 pernos mini fix.

Luego desde arriba introduzca los pernos mini fix de la tapa A en las perforaciones de los costados y luego gire las cajas mini fix 180° para ajustar las piezas.

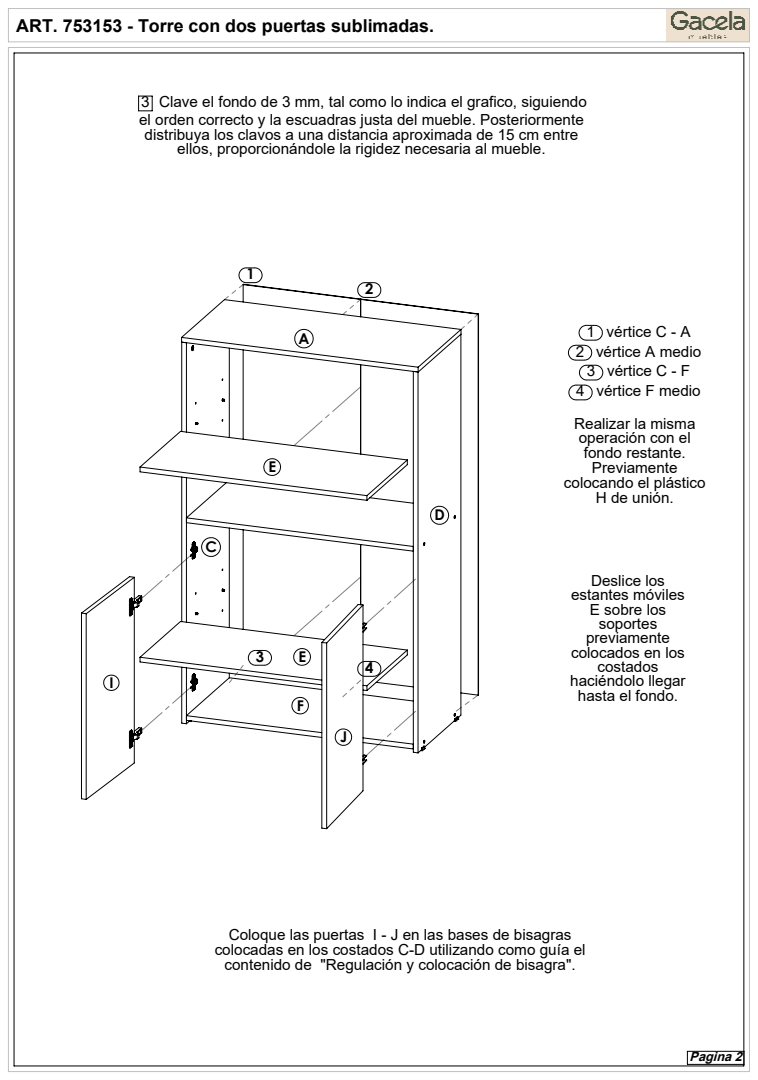
[picture p176: page 3]
Clave el fondo de 3 mm, tal como lo indica el grafico, siguiendo; Pagina 2

el orden correcto y la escuadras justa del mueble. Posteriormente
distribuya los clavos a una distancia aproximada de 15 cm entre
ellos, proporcionándole la rigidez necesaria al mueble.

1 vértice C - A
2 vértice A medio
3 vértice C - F
4 vértice F medio
Realizar la misma
operación con el
fondo restante.
Previamente
colocando el plástico
H de unión.

Deslice los
estantes móviles
E sobre los
soportes
previamente
colocados en los
costados
haciéndolo llegar
hasta el fondo.

Coloque las puertas I - J en las bases de bisagras
colocadas en los costados C-D utilizando como guía el
contenido de "Regulación y colocación de bisagra".

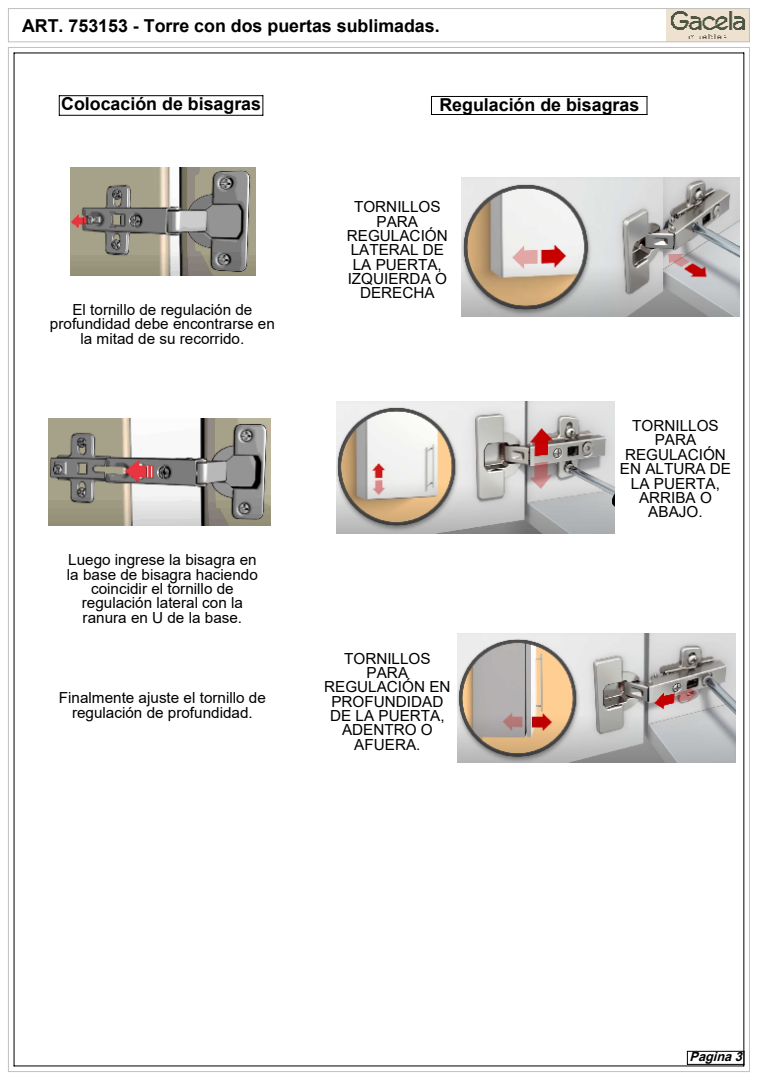
[picture p177: page 4]
Colocación de bisagras; Regulación de bisagras; REGULACIÓN EN DE LA PUERTA, ADENTRO O; EN ALTURA DE LA PUERTA, ARRIBA O; LATERAL DE LA PUERTA, IZQUIERDA O; Pagina 3

El tornillo de regulación de profundidad debe encontrarse en
la mitad de su recorrido.

Luego ingrese la bisagra en
la base de bisagra haciendo
coincidir el tornillo de
regulación lateral con la
ranura en U de la base.

Finalmente ajuste el tornillo de
regulación de profundidad.
