infomueblesgacela/muebles-gacela-mvp/public/modelos_3d/linea-kyoto/A331250/A331250.PDF

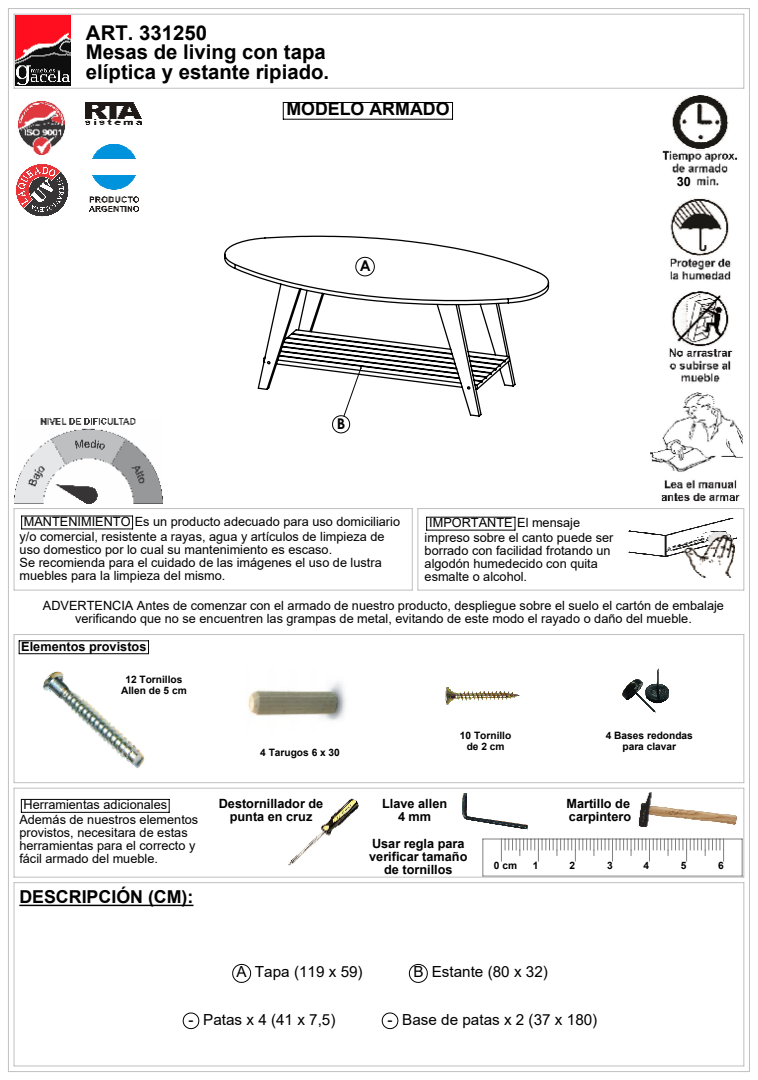
[picture p178: page 1]
A Tapa (119 x 59); B Estante (80 x 32); - Patas x 4 (41 x 7,5); - Base de patas x 2 (37 x 180); Martillo de; MODELO ARMADO; 4 Bases redondas; 10 Tornillo de 2 cm

ART. 331250
Mesas de living con tapa
elíptica y estante ripiado.

MANTENIMIENTO Es un producto adecuado para uso domiciliario
y/o comercial, resistente a rayas, agua y artículos de limpieza de
uso domestico por lo cual su mantenimiento es escaso.
Se recomienda para el cuidado de las imágenes el uso de lustra
muebles para la limpieza del mismo.
ADVERTENCIA Antes de comenzar con el armado de nuestro producto, despliegue sobre el suelo el cartón de embalaje
verificando que no se encuentren las grampas de metal, evitando de este modo el rayado o daño del mueble.
Elementos provistos

IMPORTANTE El mensaje
impreso sobre el canto puede ser
borrado con facilidad frotando un
algodón humedecido con quita
esmalte o alcohol.

12 Tornillos
Allen de 5 cm

para clavar 4 Tarugos 6 x 30

Herramientas adicionales
Además de nuestros elementos
provistos, necesitara de estas
herramientas para el correcto y
fácil armado del mueble.
DESCRIPCIÓN (CM):

Destornillador de
punta en cruz

Llave allen
Usar regla para
verificar tamaño
de tornillos

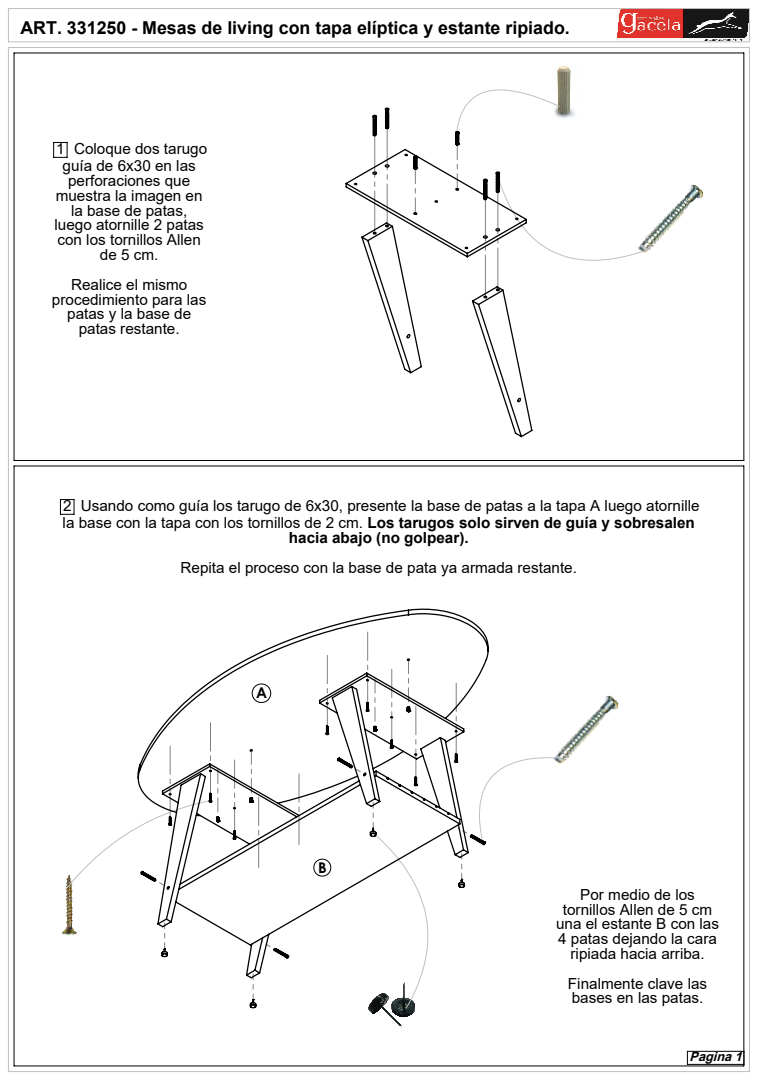
[picture p179: page 2]
Usando como guía los tarugo de 6x30, presente la base de patas a la tapa A luego atornille; Coloque dos tarugo; Pagina 1

ART. 331250 - Mesas de living con tapa elíptica y estante ripiado.

guía de 6x30 en las
perforaciones que
muestra la imagen en
la base de patas,
luego atornille 2 patas
con los tornillos Allen
Realice el mismo
procedimiento para las
patas y la base de
patas restante.

la base con la tapa con los tornillos de 2 cm. Los tarugos solo sirven de guía y sobresalen

hacia abajo (no golpear).

Repita el proceso con la base de pata ya armada restante.

Por medio de los
tornillos Allen de 5 cm
una el estante B con las
4 patas dejando la cara
ripiada hacia arriba.
Finalmente clave las
bases en las patas.
