infomueblesgacela/muebles-gacela-mvp/public/modelos_3d/linea-kyoto/A446250/A446250.PDF

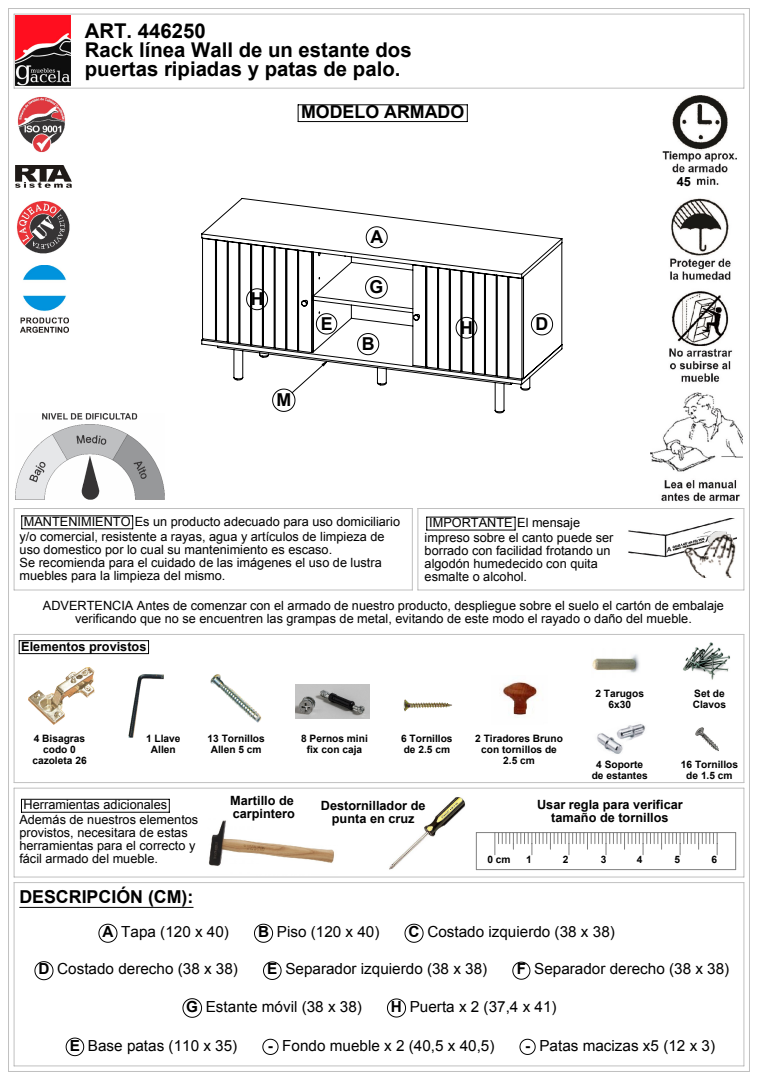
[picture p180: page 1]
A Tapa (120 x 40); B Piso (120 x 40); C Costado izquierdo (38 x 38); E Base patas (110 x 35); - Fondo mueble x 2 (40,5 x 40,5); - Patas macizas x5 (12 x 3); D Costado derecho (38 x 38); E Separador izquierdo (38 x 38); F Separador derecho (38 x 38); G Estante móvil (38 x 38); H Puerta x 2 (37,4 x 41); 1 Llave; 2 Tarugos; Set de; Martillo de; carpintero; Destornillador de; Elementos provistos; MODELO ARMADO; 6 Tornillos de 2.5 cm; 13 Tornillos Allen 5 cm; 16 Tornillos de 1.5 cm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

ART. 446250
Rack línea Wall de un estante dos
puertas ripiadas y patas de palo.

MANTENIMIENTO Es un producto adecuado para uso domiciliario
y/o comercial, resistente a rayas, agua y artículos de limpieza de
uso domestico por lo cual su mantenimiento es escaso.
Se recomienda para el cuidado de las imágenes el uso de lustra
muebles para la limpieza del mismo.
ADVERTENCIA Antes de comenzar con el armado de nuestro producto, despliegue sobre el suelo el cartón de embalaje
verificando que no se encuentren las grampas de metal, evitando de este modo el rayado o daño del mueble.

IMPORTANTE El mensaje
impreso sobre el canto puede ser
borrado con facilidad frotando un
algodón humedecido con quita
esmalte o alcohol.

8 Pernos mini
fix con caja

2 Tiradores Bruno
con tornillos de

Herramientas adicionales
Además de nuestros elementos
provistos, necesitara de estas
herramientas para el correcto y
fácil armado del mueble.
DESCRIPCIÓN (CM):

Usar regla para verificar

punta en cruz tamaño de tornillos

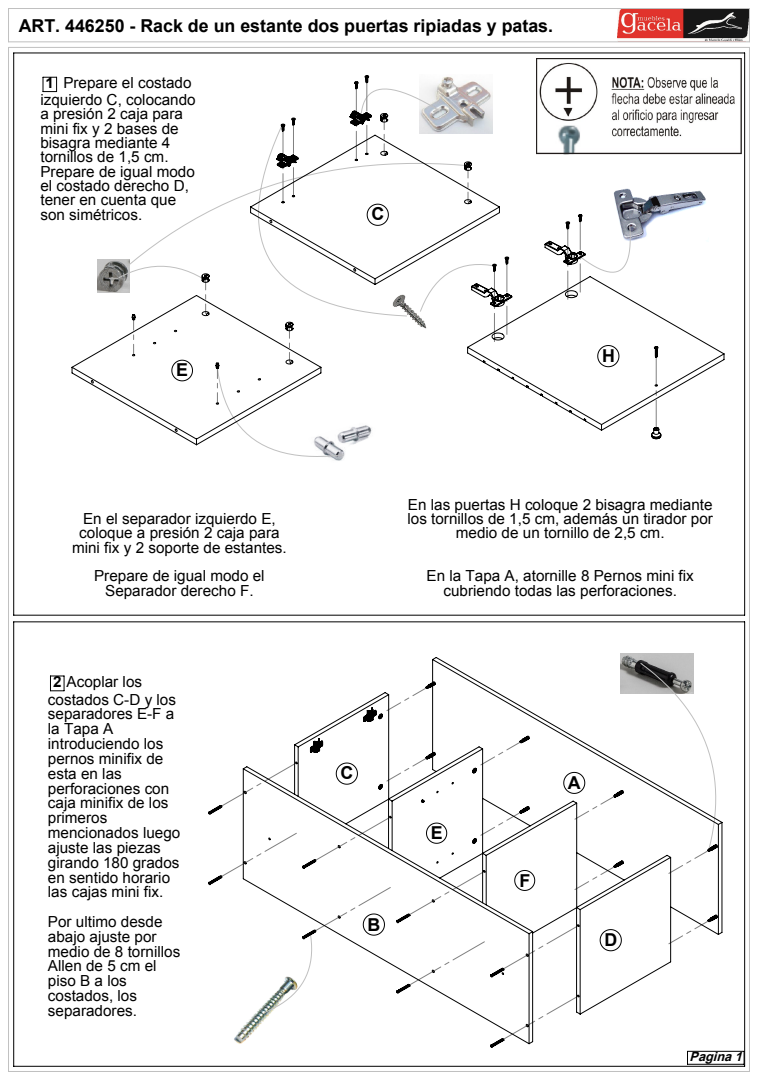
[picture p181: page 2]
Pagina 1

ART. 446250 - Rack de un estante dos puertas ripiadas y patas.

1 Prepare el costado
izquierdo C, colocando
a presión 2 caja para
mini fix y 2 bases de
bisagra mediante 4
tornillos de 1,5 cm.
Prepare de igual modo
el costado derecho D,
tener en cuenta que
son simétricos.

En las puertas H coloque 2 bisagra mediante
los tornillos de 1,5 cm, además un tirador por
medio de un tornillo de 2,5 cm.

En el separador izquierdo E,
coloque a presión 2 caja para
mini fix y 2 soporte de estantes.
Prepare de igual modo el
Separador derecho F.

En la Tapa A, atornille 8 Pernos mini fix
cubriendo todas las perforaciones.

2 Acoplar los
costados C-D y los
separadores E-F a
la Tapa A
introduciendo los
pernos minifix de
esta en las
perforaciones con
caja minifix de los
primeros
mencionados luego
ajuste las piezas
girando 180 grados
en sentido horario
las cajas mini fix.
Por ultimo desde
abajo ajuste por
medio de 8 tornillos
Allen de 5 cm el
piso B a los
costados, los
separadores.

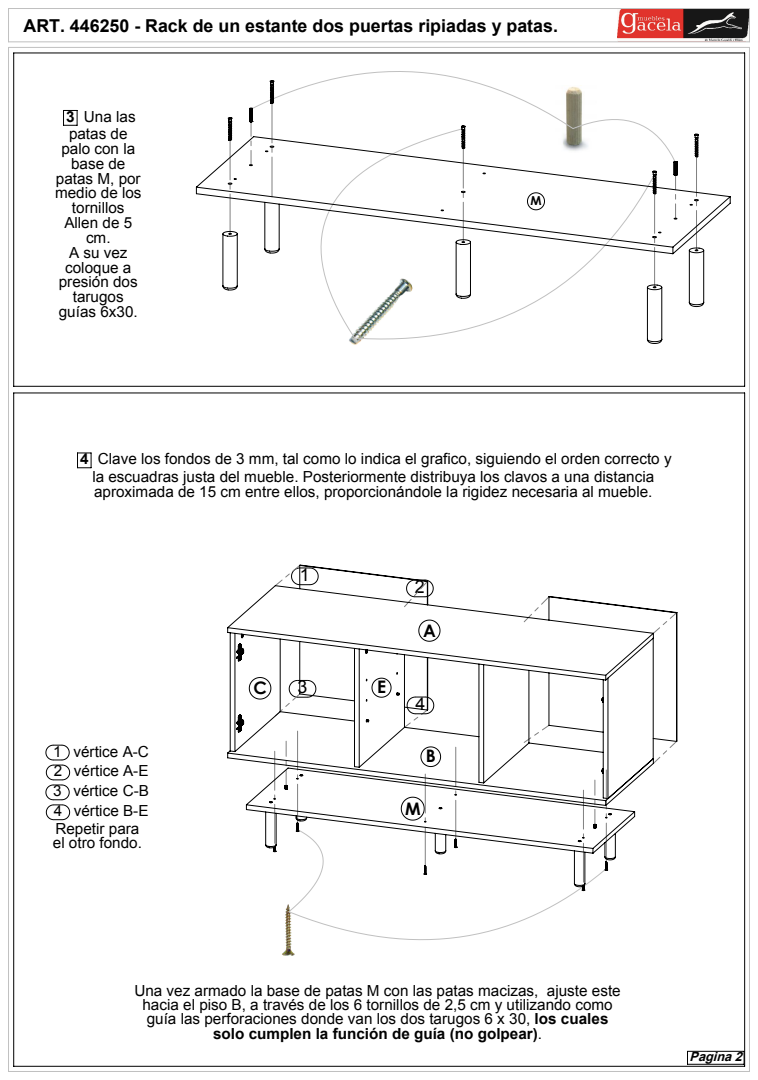
[picture p182: page 3]
Pagina 2

3 Una las
patas de
palo con la
base de
patas M, por
medio de los
tornillos
Allen de 5
A su vez
coloque a
presión dos
tarugos
guías 6x30.

4 Clave los fondos de 3 mm, tal como lo indica el grafico, siguiendo el orden correcto y
la escuadras justa del mueble. Posteriormente distribuya los clavos a una distancia
aproximada de 15 cm entre ellos, proporcionándole la rigidez necesaria al mueble.

1 vértice A-C
2 vértice A-E
3 vértice C-B
4 vértice B-E
Repetir para
el otro fondo.

Una vez armado la base de patas M con las patas macizas, ajuste este
hacia el piso B, a través de los 6 tornillos de 2,5 cm y utilizando como
guía las perforaciones donde van los dos tarugos 6 x 30, los cuales

solo cumplen la función de guía (no golpear).

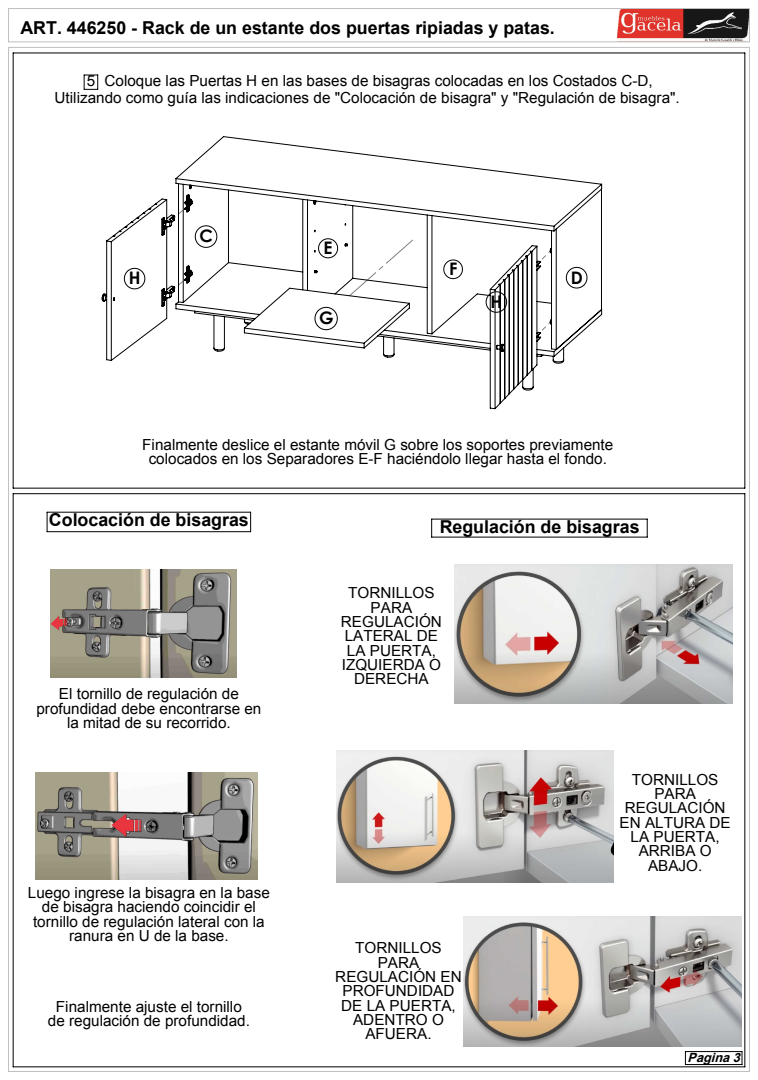
[picture p183: page 4]
EN ALTURA DE LA PUERTA, ARRIBA O; REGULACIÓN EN DE LA PUERTA, ADENTRO O; LATERAL DE LA PUERTA, IZQUIERDA O; Coloque las Puertas H en las bases de bisagras colocadas en los Costados C-D,; Pagina 3

Utilizando como guía las indicaciones de "Colocación de bisagra" y "Regulación de bisagra".

Finalmente deslice el estante móvil G sobre los soportes previamente
colocados en los Separadores E-F haciéndolo llegar hasta el fondo.

Colocación de bisagras

Regulación de bisagras

El tornillo de regulación de profundidad debe encontrarse en
la mitad de su recorrido.

Luego ingrese la bisagra en la base
de bisagra haciendo coincidir el
tornillo de regulación lateral con la
ranura en U de la base.

Finalmente ajuste el tornillo
de regulación de profundidad.
