infomueblesgacela/muebles-gacela-mvp/public/modelos_3d/linea-nordik/A334093/A334093.PDF

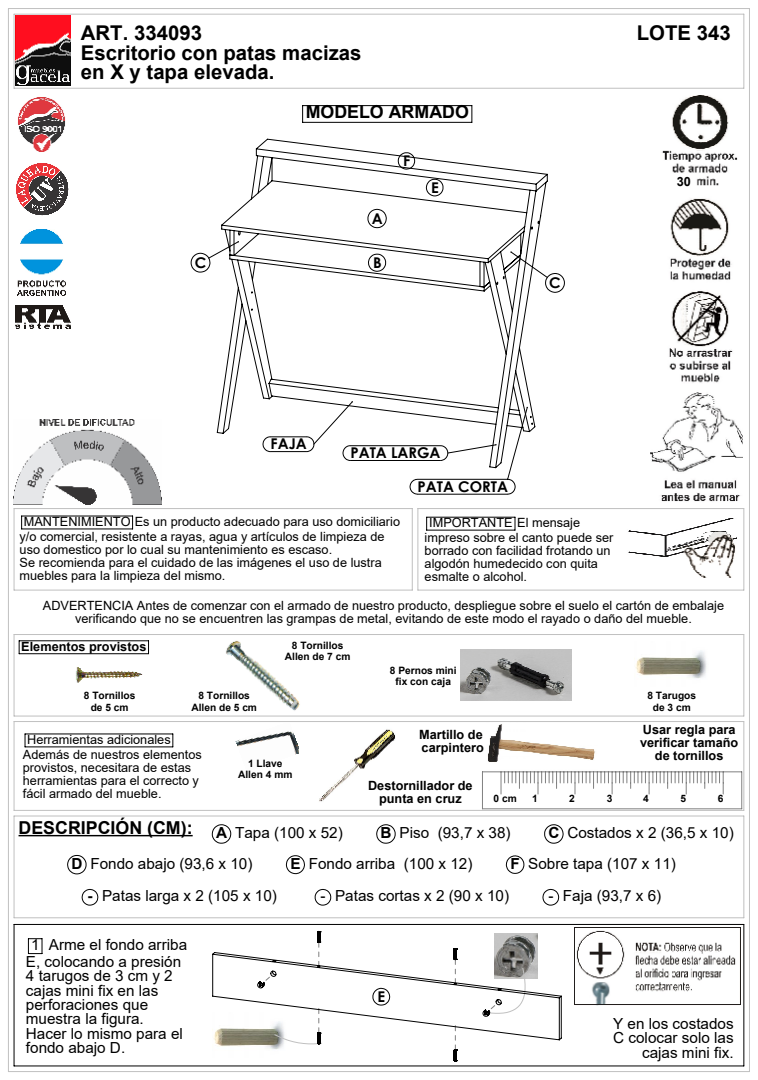
[picture p184: page 1]
FAJA; PATA LARGA; PATA CORTA; D Fondo abajo (93,6 x 10); E Fondo arriba (100 x 12); F Sobre tapa (107 x 11); - Patas larga x 2 (105 x 10); - Patas cortas x 2 (90 x 10); - Faja (93,7 x 6); A Tapa (100 x 52); B Piso (93,7 x 38); C Costados x 2 (36,5 x 10); Arme el fondo arriba; 8 Tarugos de 3 cm; Martillo de; MODELO ARMADO; verificar tamaño; Allen 4 mm; 8 Tornillos de 5 cm; LOTE 343

ART. 334093
Escritorio con patas macizas
en X y tapa elevada.

MANTENIMIENTO Es un producto adecuado para uso domiciliario
y/o comercial, resistente a rayas, agua y artículos de limpieza de
uso domestico por lo cual su mantenimiento es escaso.
Se recomienda para el cuidado de las imágenes el uso de lustra
muebles para la limpieza del mismo.
ADVERTENCIA Antes de comenzar con el armado de nuestro producto, despliegue sobre el suelo el cartón de embalaje
verificando que no se encuentren las grampas de metal, evitando de este modo el rayado o daño del mueble.
Elementos provistos

IMPORTANTE El mensaje
impreso sobre el canto puede ser
borrado con facilidad frotando un
algodón humedecido con quita
esmalte o alcohol.

8 Tornillos
Allen de 7 cm

8 Pernos mini
fix con caja

Allen de 5 cm

Usar regla para de tornillos 1 Llave

Herramientas adicionales
Además de nuestros elementos
provistos, necesitara de estas
herramientas para el correcto y
fácil armado del mueble.
DESCRIPCIÓN (CM):

Destornillador de
punta en cruz

E, colocando a presión
4 tarugos de 3 cm y 2
cajas mini fix en las
perforaciones que
muestra la figura.
Hacer lo mismo para el
fondo abajo D.

Y en los costados
C colocar solo las
cajas mini fix.

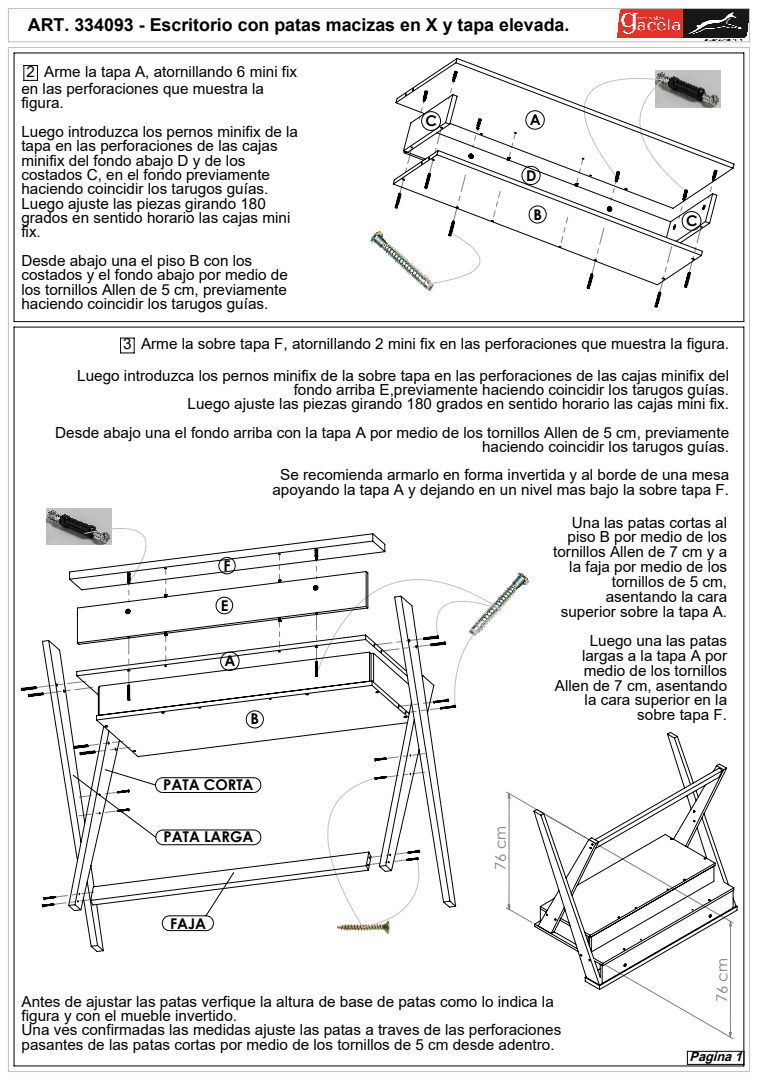
[picture p185: page 2]
PATA CORTA; PATA LARGA; Arme la tapa A, atornillando 6 mini fix; Arme la sobre tapa F, atornillando 2 mini fix en las perforaciones que muestra la figura.; Pagina 1

ART. 334093 - Escritorio con patas macizas en X y tapa elevada.

en las perforaciones que muestra la
figura.
Luego introduzca los pernos minifix de la
tapa en las perforaciones de las cajas
minifix del fondo abajo D y de los
costados C, en el fondo previamente
haciendo coincidir los tarugos guías.
Luego ajuste las piezas girando 180
grados en sentido horario las cajas mini
fix.
Desde abajo una el piso B con los
costados y el fondo abajo por medio de
los tornillos Allen de 5 cm, previamente

Luego introduzca los pernos minifix de la sobre tapa en las perforaciones de las cajas minifix del fondo arriba E,previamente haciendo coincidir los tarugos guías. Luego ajuste las piezas girando 180 grados en sentido horario las cajas mini fix.

Desde abajo una el fondo arriba con la tapa A por medio de los tornillos Allen de 5 cm, previamente

Se recomienda armarlo en forma invertida y al borde de una mesa
apoyando la tapa A y dejando en un nivel mas bajo la sobre tapa F.

Una las patas cortas al
piso B por medio de los
tornillos Allen de 7 cm y a
la faja por medio de los
tornillos de 5 cm,
asentando la cara
superior sobre la tapa A.
Luego una las patas
largas a la tapa A por
medio de los tornillos
Allen de 7 cm, asentando
la cara superior en la
sobre tapa F.

Antes de ajustar las patas verfique la altura de base de patas como lo indica la
figura y con el mueble invertido.
Una ves confirmadas las medidas ajuste las patas a traves de las perforaciones
pasantes de las patas cortas por medio de los tornillos de 5 cm desde adentro.
