infomueblesgacela/muebles-gacela-mvp/public/modelos_3d/linea-nordik/A446330/A446330.PDF

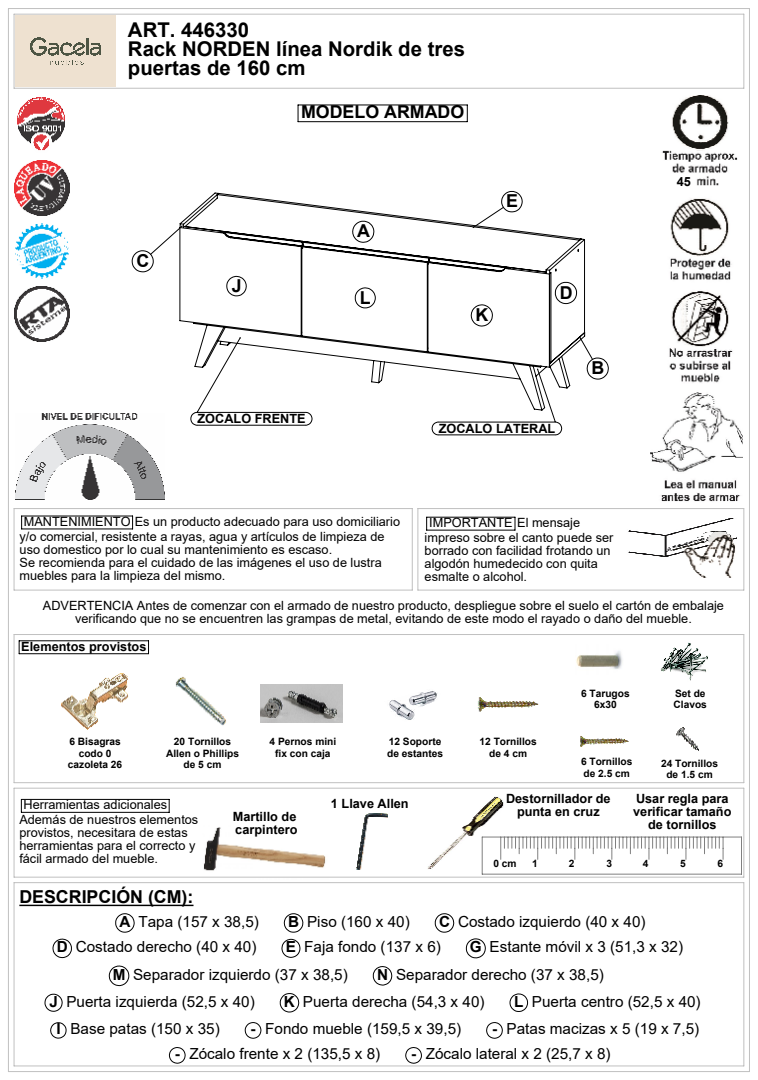
[picture p186: page 1]
ZOCALO FRENTE; ZOCALO LATERAL; A Tapa (157 x 38,5); B Piso (160 x 40); C Costado izquierdo (40 x 40); I Base patas (150 x 35); - Fondo mueble (159,5 x 39,5); - Patas macizas x 5 (19 x 7,5); D Costado derecho (40 x 40); E Faja fondo (137 x 6); G Estante móvil x 3 (51,3 x 32); M Separador izquierdo (37 x 38,5); N Separador derecho (37 x 38,5); J Puerta izquierda (52,5 x 40); K Puerta derecha (54,3 x 40); L Puerta centro (52,5 x 40); - Zócalo frente x 2 (135,5 x 8)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

ART. 446330
Rack NORDEN línea Nordik de tres
puertas de 160 cm

MANTENIMIENTO Es un producto adecuado para uso domiciliario
y/o comercial, resistente a rayas, agua y artículos de limpieza de
uso domestico por lo cual su mantenimiento es escaso.
Se recomienda para el cuidado de las imágenes el uso de lustra
muebles para la limpieza del mismo.
ADVERTENCIA Antes de comenzar con el armado de nuestro producto, despliegue sobre el suelo el cartón de embalaje
verificando que no se encuentren las grampas de metal, evitando de este modo el rayado o daño del mueble.
Elementos provistos

IMPORTANTE El mensaje
impreso sobre el canto puede ser
borrado con facilidad frotando un
algodón humedecido con quita
esmalte o alcohol.

Usar regla para
verificar tamaño
de tornillos

Herramientas adicionales
Además de nuestros elementos
provistos, necesitara de estas
herramientas para el correcto y
fácil armado del mueble.
DESCRIPCIÓN (CM):

Destornillador de
punta en cruz

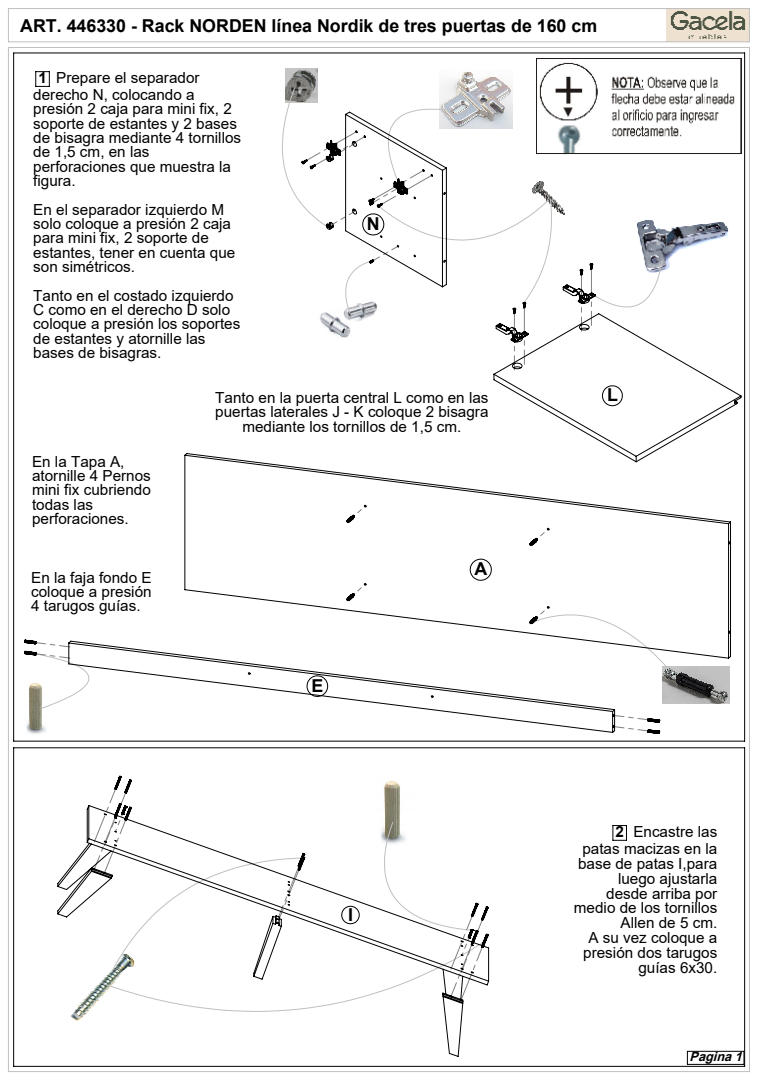
[picture p187: page 2]
Pagina 1

ART. 446330 - Rack NORDEN línea Nordik de tres puertas de 160 cm

1 Prepare el separador
derecho N, colocando a
presión 2 caja para mini fix, 2
soporte de estantes y 2 bases
de bisagra mediante 4 tornillos
de 1,5 cm, en las
perforaciones que muestra la
figura.
En el separador izquierdo M
solo coloque a presión 2 caja
para mini fix, 2 soporte de
estantes, tener en cuenta que
son simétricos.
Tanto en el costado izquierdo
C como en el derecho D solo
coloque a presión los soportes
de estantes y atornille las
bases de bisagras.

Tanto en la puerta central L como en las
puertas laterales J - K coloque 2 bisagra
mediante los tornillos de 1,5 cm.

En la Tapa A,
atornille 4 Pernos
mini fix cubriendo
todas las
perforaciones.

En la faja fondo E
coloque a presión
4 tarugos guías.

2 Encastre las
patas macizas en la
base de patas I,para
luego ajustarla
desde arriba por
medio de los tornillos
Allen de 5 cm.
A su vez coloque a
presión dos tarugos
guías 6x30.

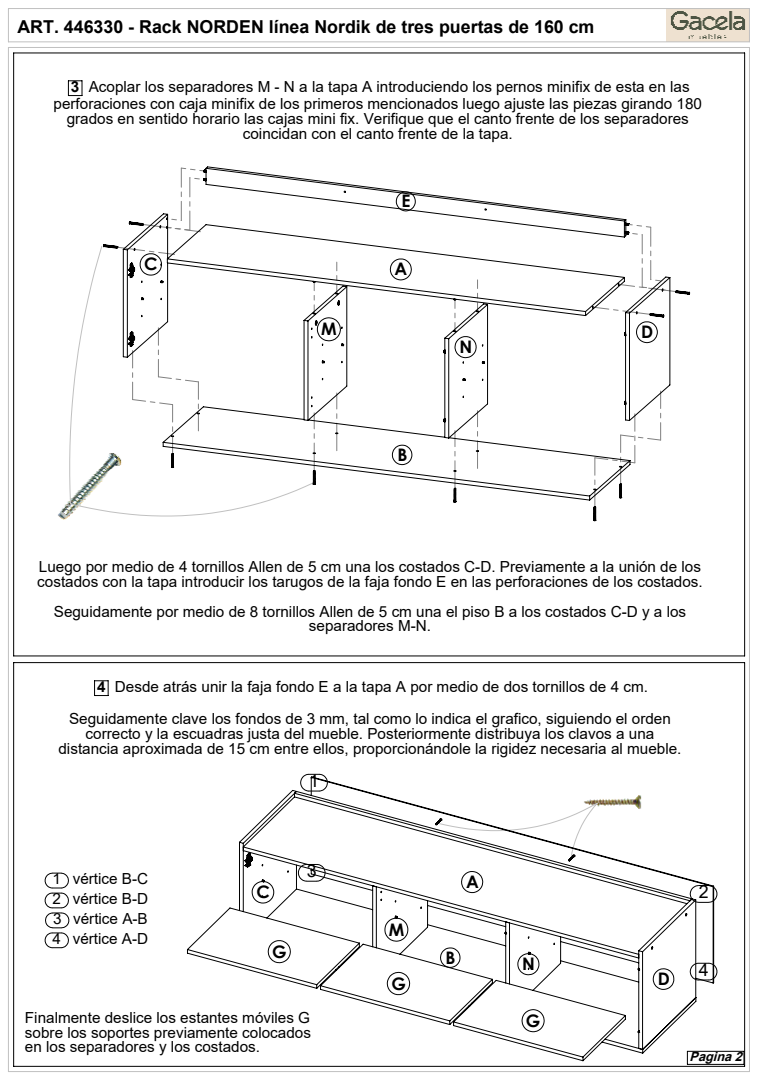
[picture p188: page 3]
1 vértice B-C 2 vértice B-D 3 vértice A-B 4 vértice A-D; separadores M-N.; en los separadores y los costados.; Pagina 2

3 Acoplar los separadores M - N a la tapa A introduciendo los pernos minifix de esta en las
perforaciones con caja minifix de los primeros mencionados luego ajuste las piezas girando 180
grados en sentido horario las cajas mini fix. Verifique que el canto frente de los separadores

coincidan con el canto frente de la tapa.

Luego por medio de 4 tornillos Allen de 5 cm una los costados C-D. Previamente a la unión de los
costados con la tapa introducir los tarugos de la faja fondo E en las perforaciones de los costados.
Seguidamente por medio de 8 tornillos Allen de 5 cm una el piso B a los costados C-D y a los

4 Desde atrás unir la faja fondo E a la tapa A por medio de dos tornillos de 4 cm.
Seguidamente clave los fondos de 3 mm, tal como lo indica el grafico, siguiendo el orden
correcto y la escuadras justa del mueble. Posteriormente distribuya los clavos a una
distancia aproximada de 15 cm entre ellos, proporcionándole la rigidez necesaria al mueble.

Finalmente deslice los estantes móviles G
sobre los soportes previamente colocados

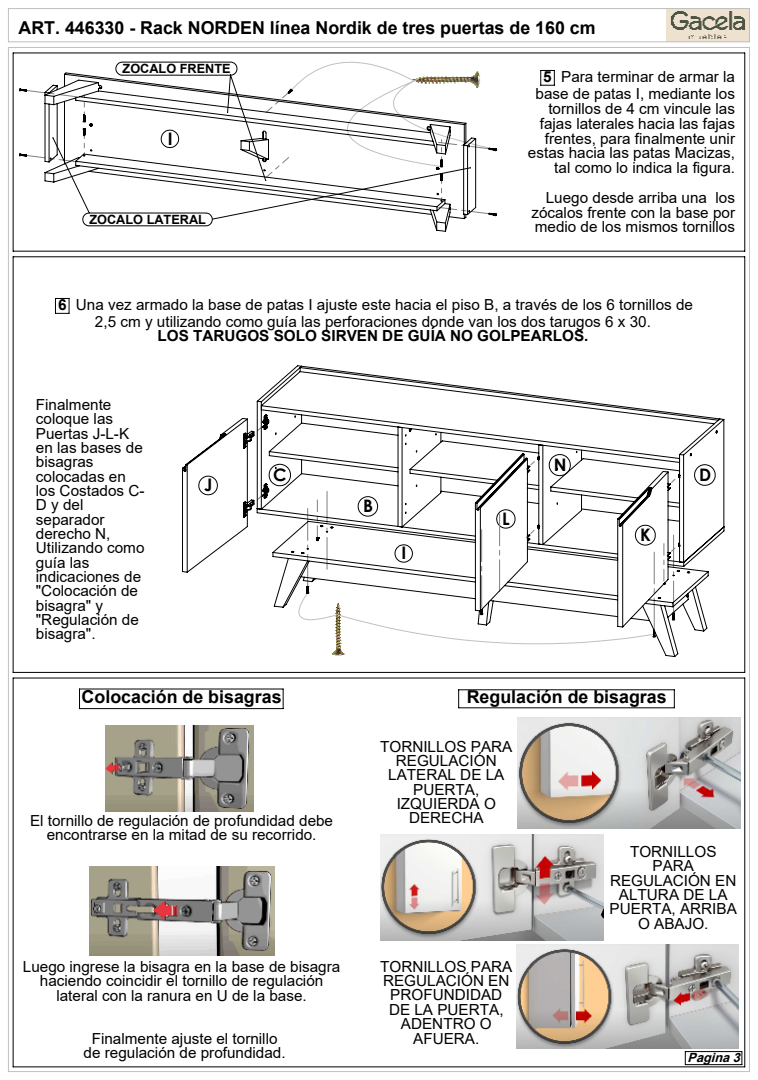
[picture p189: page 4]
ZOCALO LATERAL; ZOCALO FRENTE; El tornillo de regulación de profundidad debe; DERECHA; Pagina 3

5 Para terminar de armar la
base de patas I, mediante los
tornillos de 4 cm vincule las
fajas laterales hacia las fajas
frentes, para finalmente unir
estas hacia las patas Macizas,
tal como lo indica la figura.
Luego desde arriba una los
zócalos frente con la base por
medio de los mismos tornillos

6 Una vez armado la base de patas I ajuste este hacia el piso B, a través de los 6 tornillos de
2,5 cm y utilizando como guía las perforaciones donde van los dos tarugos 6 x 30. LOS TARUGOS SOLO SIRVEN DE GUÍA NO GOLPEARLOS.

Finalmente
coloque las
Puertas J-L-K
en las bases de
bisagras
colocadas en
los Costados C-
D y del
separador
derecho N,
Utilizando como
guía las
indicaciones de
"Colocación de
bisagra" y
"Regulación de
bisagra".

Colocación de bisagras

Regulación de bisagras

TORNILLOS PARA
REGULACIÓN
LATERAL DE LA
PUERTA,
IZQUIERDA O

encontrarse en la mitad de su recorrido.

TORNILLOS
PARA
REGULACIÓN EN
ALTURA DE LA
PUERTA, ARRIBA
O ABAJO.

Luego ingrese la bisagra en la base de bisagra
haciendo coincidir el tornillo de regulación
lateral con la ranura en U de la base.

PROFUNDIDAD
DE LA PUERTA,
ADENTRO O
AFUERA.

Finalmente ajuste el tornillo
de regulación de profundidad.
