infomueblesgacela/muebles-gacela-mvp/public/modelos_3d/linea-nordik/A742332/A742332.PDF

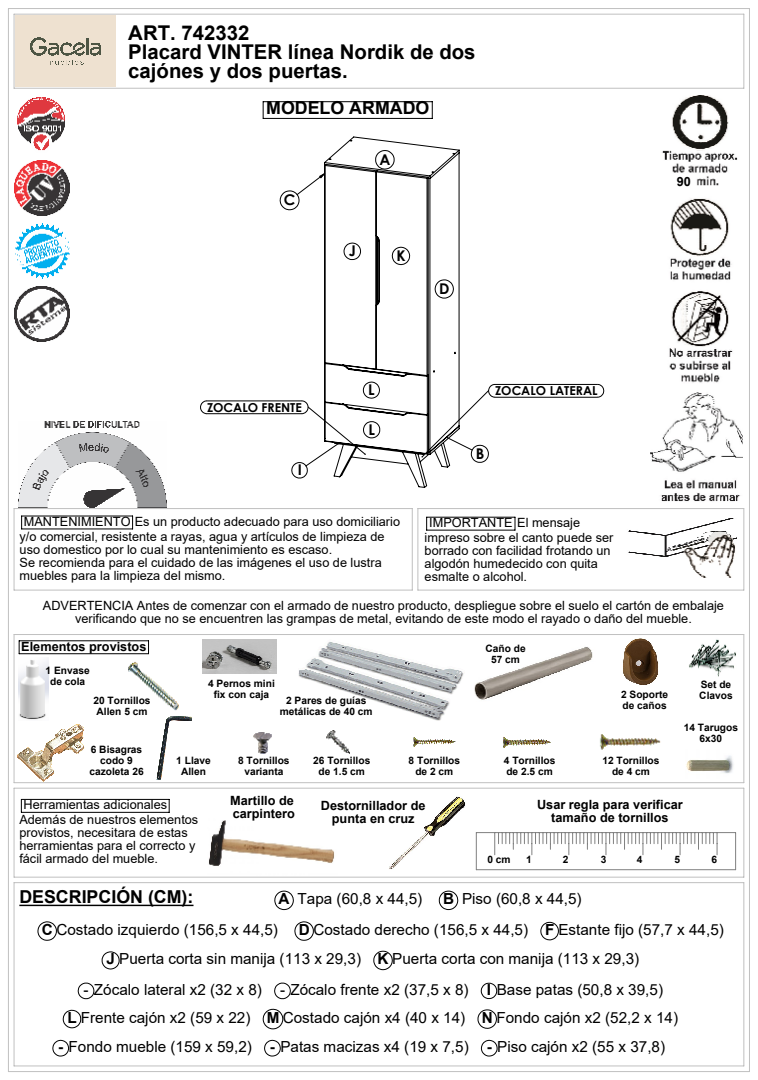
[picture p190: page 1]
ZOCALO FRENTE; ZOCALO LATERAL; A Tapa (60,8 x 44,5) B Piso (60,8 x 44,5); 2 Soporte de caños; 1 Llave; 8 Tornillos de 2 cm; 14 Tarugos; Set de; Martillo de; carpintero; Destornillador de; MODELO ARMADO; 12 Tornillos de 4 cm; 8 Tornillos; 20 Tornillos Allen 5 cm; 26 Tornillos de 1.5 cm; 6 Bisagras codo 9 cazoleta 26; Caño de 57 cm

ART. 742332
Placard VINTER línea Nordik de dos
cajónes y dos puertas.

MANTENIMIENTO Es un producto adecuado para uso domiciliario
y/o comercial, resistente a rayas, agua y artículos de limpieza de
uso domestico por lo cual su mantenimiento es escaso.
Se recomienda para el cuidado de las imágenes el uso de lustra
muebles para la limpieza del mismo.
ADVERTENCIA Antes de comenzar con el armado de nuestro producto, despliegue sobre el suelo el cartón de embalaje
verificando que no se encuentren las grampas de metal, evitando de este modo el rayado o daño del mueble.
Elementos provistos
1 Envase
de cola

IMPORTANTE El mensaje
impreso sobre el canto puede ser
borrado con facilidad frotando un
algodón humedecido con quita
esmalte o alcohol.

4 Pernos mini
fix con caja

2 Pares de guías
metálicas de 40 cm

4 Tornillos
Usar regla para verificar

Herramientas adicionales
Además de nuestros elementos
provistos, necesitara de estas
herramientas para el correcto y
fácil armado del mueble.
DESCRIPCIÓN (CM):
C Costado izquierdo (156,5 x 44,5) D Costado derecho (156,5 x 44,5) F Estante fijo (57,7 x 44,5)

punta en cruz tamaño de tornillos

J Puerta corta sin manija (113 x 29,3) K Puerta corta con manija (113 x 29,3)
- Zócalo lateral x2 (32 x 8) - Zócalo frente x2 (37,5 x 8) I Base patas (50,8 x 39,5)
L Frente cajón x2 (59 x 22) M Costado cajón x4 (40 x 14) N Fondo cajón x2 (52,2 x 14)
- Fondo mueble (159 x 59,2) - Patas macizas x4 (19 x 7,5) - Piso cajón x2 (55 x 37,8)

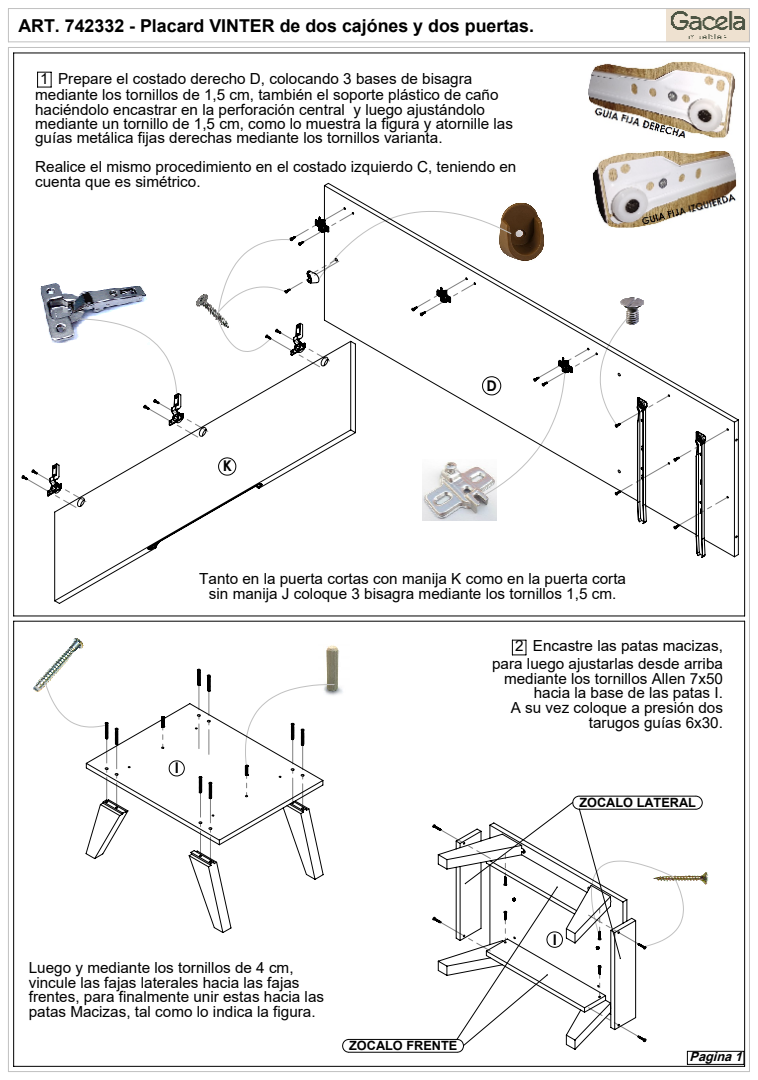
[picture p191: page 2]
ZOCALO LATERAL; ZOCALO FRENTE; Prepare el costado derecho D, colocando 3 bases de bisagra; Encastre las patas macizas,; tarugos guías 6x30.; Pagina 1

ART. 742332 - Placard VINTER de dos cajónes y dos puertas.

mediante los tornillos de 1,5 cm, también el soporte plástico de caño
haciéndolo encastrar en la perforación central y luego ajustándolo
mediante un tornillo de 1,5 cm, como lo muestra la figura y atornille las
guías metálica fijas derechas mediante los tornillos varianta.
Realice el mismo procedimiento en el costado izquierdo C, teniendo en
cuenta que es simétrico.

Tanto en la puerta cortas con manija K como en la puerta corta
sin manija J coloque 3 bisagra mediante los tornillos 1,5 cm.

para luego ajustarlas desde arriba
mediante los tornillos Allen 7x50
hacia la base de las patas I.
A su vez coloque a presión dos

Luego y mediante los tornillos de 4 cm,
vincule las fajas laterales hacia las fajas
frentes, para finalmente unir estas hacia las
patas Macizas, tal como lo indica la figura.

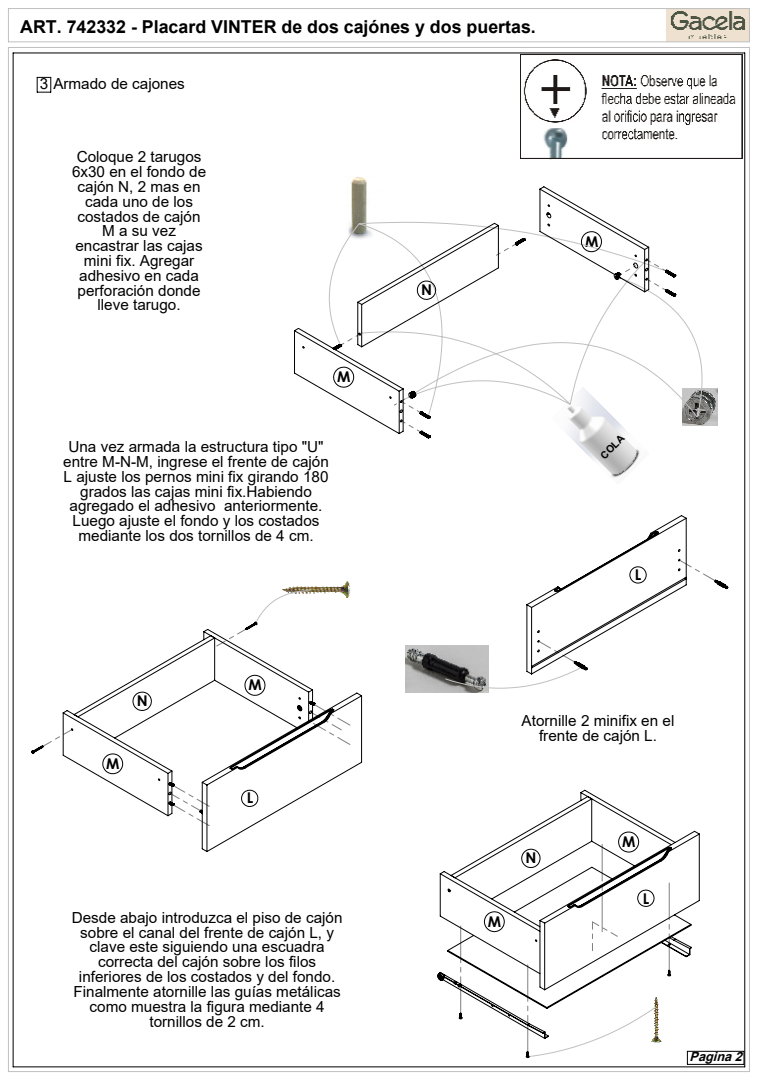
[picture p192: page 3]
Pagina 2

3 Armado de cajones

Coloque 2 tarugos
6x30 en el fondo de
cajón N, 2 mas en
cada uno de los
costados de cajón
M a su vez
encastrar las cajas
mini fix. Agregar
adhesivo en cada
perforación donde
lleve tarugo.

Una vez armada la estructura tipo "U"
entre M-N-M, ingrese el frente de cajón
L ajuste los pernos mini fix girando 180
grados las cajas mini fix.Habiendo
agregado el adhesivo anteriormente.
Luego ajuste el fondo y los costados
mediante los dos tornillos de 4 cm.

Atornille 2 minifix en el
frente de cajón L.

Desde abajo introduzca el piso de cajón
sobre el canal del frente de cajón L, y
clave este siguiendo una escuadra
correcta del cajón sobre los filos
inferiores de los costados y del fondo.
Finalmente atornille las guías metálicas
como muestra la figura mediante 4
tornillos de 2 cm.

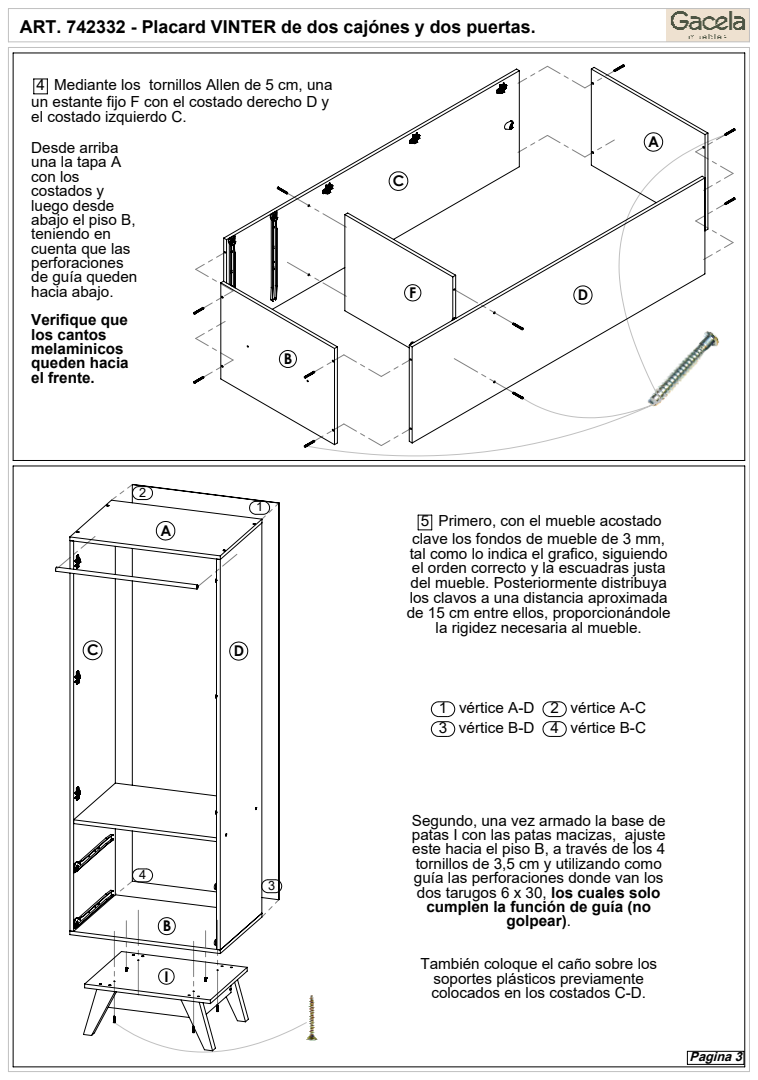
[picture p193: page 4]
Mediante los tornillos Allen de 5 cm, una; 1 vértice A-D 2 vértice A-C 3 vértice B-D 4 vértice B-C; Primero, con el mueble acostado; Pagina 3

un estante fijo F con el costado derecho D y
el costado izquierdo C.
Desde arriba
una la tapa A
con los
costados y
luego desde
abajo el piso B,
teniendo en
cuenta que las
perforaciones
de guía queden
hacia abajo.
Verifique que
los cantos
melaminicos
queden hacia
el frente.

clave los fondos de mueble de 3 mm,
tal como lo indica el grafico, siguiendo
el orden correcto y la escuadras justa
del mueble. Posteriormente distribuya
los clavos a una distancia aproximada
de 15 cm entre ellos, proporcionándole
la rigidez necesaria al mueble.

Segundo, una vez armado la base de
patas I con las patas macizas, ajuste
este hacia el piso B, a través de los 4
tornillos de 3,5 cm y utilizando como
guía las perforaciones donde van los
dos tarugos 6 x 30, los cuales solo
cumplen la función de guía (no golpear).

También coloque el caño sobre los
soportes plásticos previamente
colocados en los costados C-D.

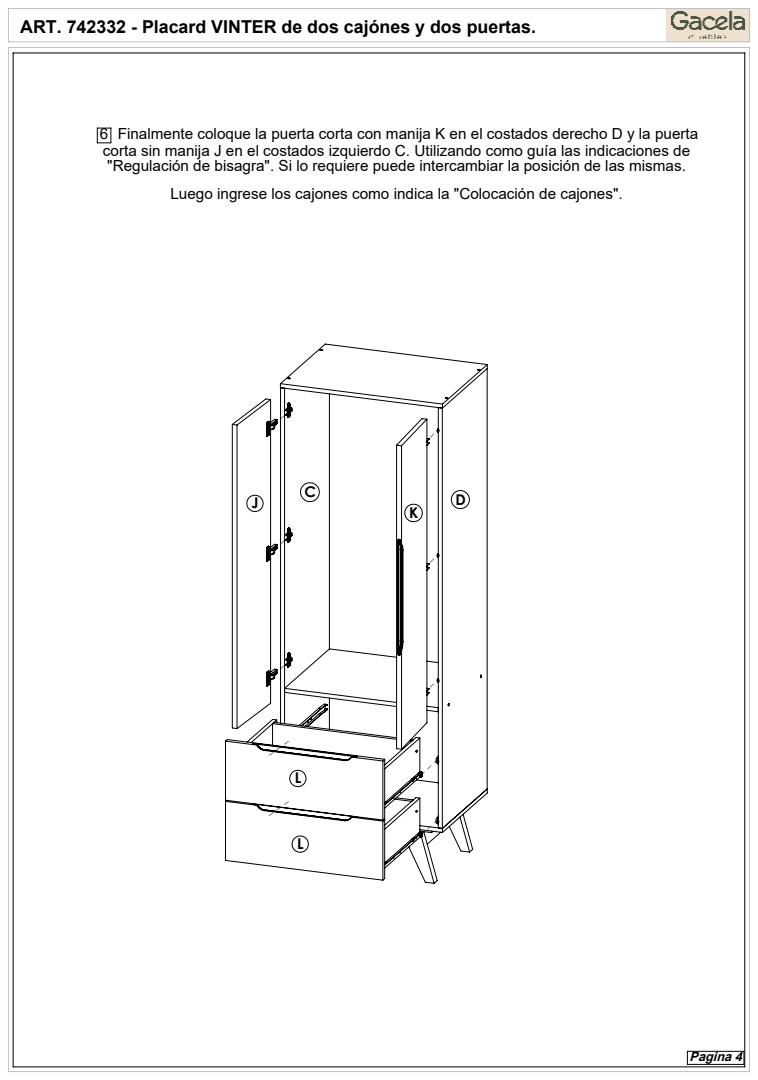
[picture p194: page 5]
Finalmente coloque la puerta corta con manija K en el costados derecho D y la puerta; Pagina 4

corta sin manija J en el costados izquierdo C. Utilizando como guía las indicaciones de
"Regulación de bisagra". Si lo requiere puede intercambiar la posición de las mismas.

Luego ingrese los cajones como indica la "Colocación de cajones".

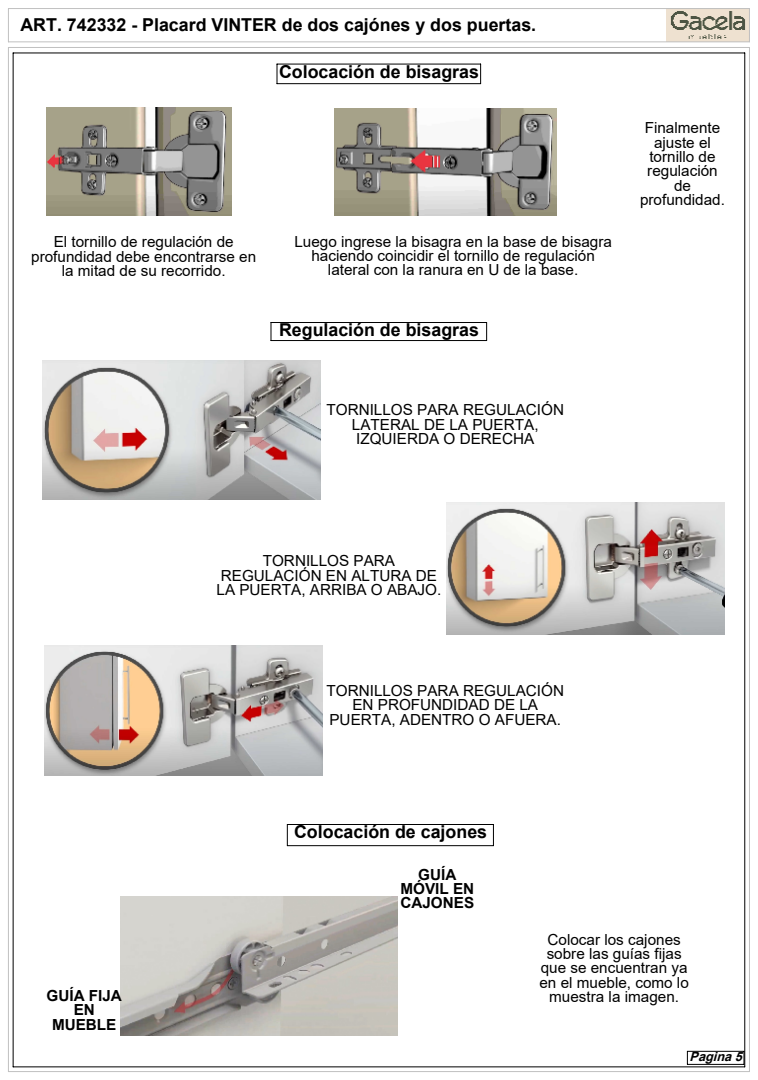
[picture p195: page 6]
ajuste el tornillo de; GUÍA FIJA; MÓVIL EN; Pagina 5

Colocación de bisagras

El tornillo de regulación de profundidad debe encontrarse en
la mitad de su recorrido.

Luego ingrese la bisagra en la base de bisagra
haciendo coincidir el tornillo de regulación
lateral con la ranura en U de la base.

Regulación de bisagras

TORNILLOS PARA REGULACIÓN
LATERAL DE LA PUERTA,
IZQUIERDA O DERECHA

TORNILLOS PARA
REGULACIÓN EN ALTURA DE
LA PUERTA, ARRIBA O ABAJO.

EN PROFUNDIDAD DE LA
PUERTA, ADENTRO O AFUERA.

Colocación de cajones

Colocar los cajones
sobre las guías fijas
que se encuentran ya
en el mueble, como lo
muestra la imagen.
