infomueblesgacela/muebles-gacela-mvp/public/modelos_3d/linea-nordik/A742336/A742336.PDF

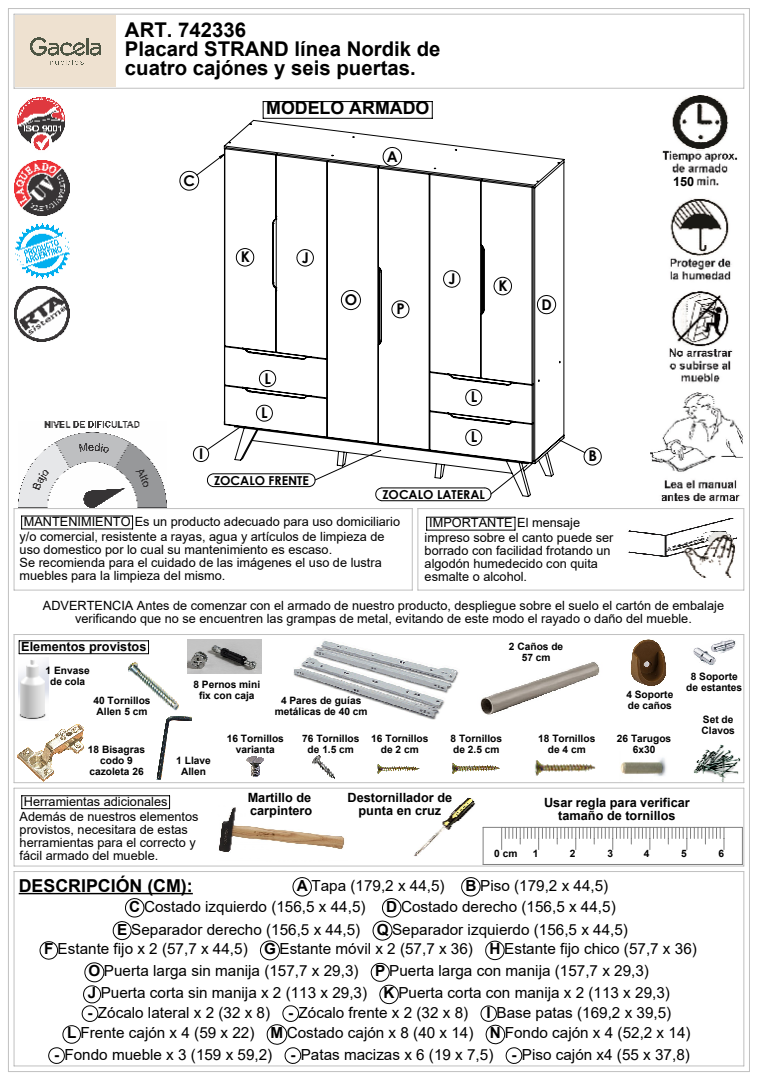
[picture p196: page 1]
ZOCALO FRENTE; A Tapa (179,2 x 44,5) B Piso (179,2 x 44,5); 4 Soporte de caños; 1 Llave; 16 Tornillos de 2 cm; 26 Tarugos; Set de; Martillo de; Destornillador de; MODELO ARMADO; 18 Tornillos de 4 cm; 16 Tornillos; 8 Tornillos de 2.5 cm; 40 Tornillos Allen 5 cm; 8 Soporte de estantes; 18 Bisagras codo 9 cazoleta 26; 2 Caños de 57 cm

ART. 742336
Placard STRAND línea Nordik de
cuatro cajónes y seis puertas.

ZOCALO LATERAL
IMPORTANTE El mensaje
impreso sobre el canto puede ser
borrado con facilidad frotando un
algodón humedecido con quita
esmalte o alcohol.

MANTENIMIENTO Es un producto adecuado para uso domiciliario
y/o comercial, resistente a rayas, agua y artículos de limpieza de
uso domestico por lo cual su mantenimiento es escaso.
Se recomienda para el cuidado de las imágenes el uso de lustra
muebles para la limpieza del mismo.
ADVERTENCIA Antes de comenzar con el armado de nuestro producto, despliegue sobre el suelo el cartón de embalaje
verificando que no se encuentren las grampas de metal, evitando de este modo el rayado o daño del mueble.
Elementos provistos
1 Envase
de cola

8 Pernos mini
fix con caja

4 Pares de guías
metálicas de 40 cm
76 Tornillos

Herramientas adicionales
Además de nuestros elementos
provistos, necesitara de estas
herramientas para el correcto y
fácil armado del mueble.
DESCRIPCIÓN (CM):

Usar regla para verificar

carpintero punta en cruz tamaño de tornillos

C Costado izquierdo (156,5 x 44,5) D Costado derecho (156,5 x 44,5)
E Separador derecho (156,5 x 44,5) Q Separador izquierdo (156,5 x 44,5)

F Estante fijo x 2 (57,7 x 44,5) G Estante móvil x 2 (57,7 x 36) H Estante fijo chico (57,7 x 36)
O Puerta larga sin manija (157,7 x 29,3) P Puerta larga con manija (157,7 x 29,3)
J Puerta corta sin manija x 2 (113 x 29,3) K Puerta corta con manija x 2 (113 x 29,3)
- Zócalo lateral x 2 (32 x 8) - Zócalo frente x 2 (32 x 8) I Base patas (169,2 x 39,5)
L Frente cajón x 4 (59 x 22) M Costado cajón x 8 (40 x 14) N Fondo cajón x 4 (52,2 x 14)
- Fondo mueble x 3 (159 x 59,2) - Patas macizas x 6 (19 x 7,5) - Piso cajón x4 (55 x 37,8)

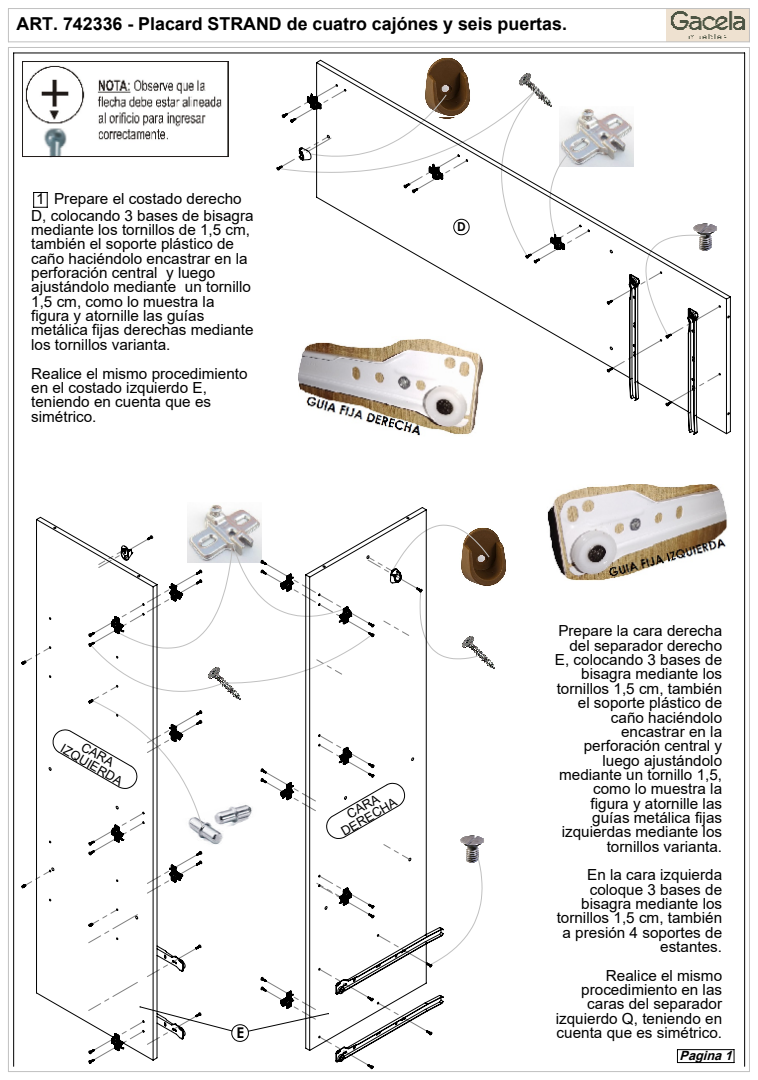
[picture p197: page 2]
CARA DERECHA; CARA IZQUIERDA; Prepare el costado derecho; Pagina 1

ART. 742336 - Placard STRAND de cuatro cajónes y seis puertas.

D, colocando 3 bases de bisagra
mediante los tornillos de 1,5 cm,
también el soporte plástico de
caño haciéndolo encastrar en la
perforación central y luego
ajustándolo mediante un tornillo
1,5 cm, como lo muestra la
figura y atornille las guías
metálica fijas derechas mediante
los tornillos varianta.
Realice el mismo procedimiento
en el costado izquierdo E,
teniendo en cuenta que es
simétrico.

Prepare la cara derecha
del separador derecho
E, colocando 3 bases de
bisagra mediante los
tornillos 1,5 cm, también
el soporte plástico de
caño haciéndolo
encastrar en la
perforación central y luego ajustándolo
mediante un tornillo 1,5,
como lo muestra la
figura y atornille las
guías metálica fijas
izquierdas mediante los
tornillos varianta.
En la cara izquierda
coloque 3 bases de
bisagra mediante los tornillos 1,5 cm, también
a presión 4 soportes de

estantes.
Realice el mismo
procedimiento en las
caras del separador
izquierdo Q, teniendo en

E cuenta que es simétrico.

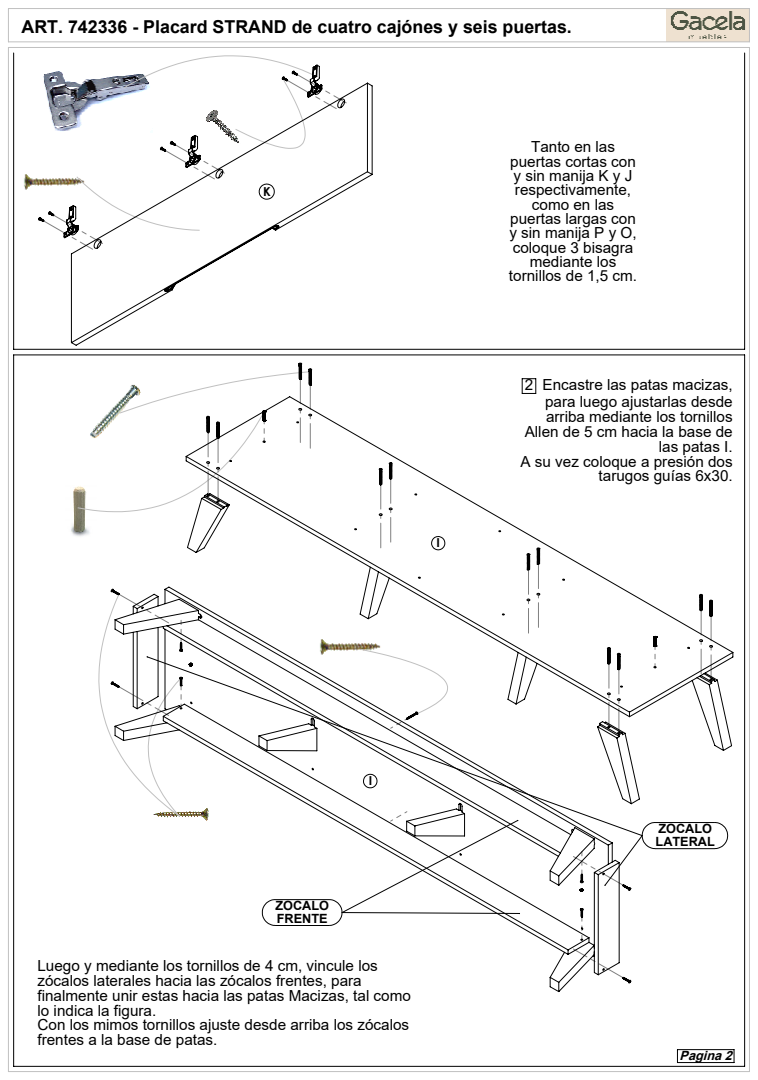
[picture p198: page 3]
Encastre las patas macizas,; las patas I. tarugos guías 6x30.; Pagina 2

Tanto en las
puertas cortas con
y sin manija K y J
respectivamente,
como en las
puertas largas con
y sin manija P y O,
coloque 3 bisagra
mediante los
tornillos de 1,5 cm.

para luego ajustarlas desde
arriba mediante los tornillos
Allen de 5 cm hacia la base de
A su vez coloque a presión dos

Luego y mediante los tornillos de 4 cm, vincule los
zócalos laterales hacia las zócalos frentes, para
finalmente unir estas hacia las patas Macizas, tal como
lo indica la figura.
Con los mimos tornillos ajuste desde arriba los zócalos
frentes a la base de patas.

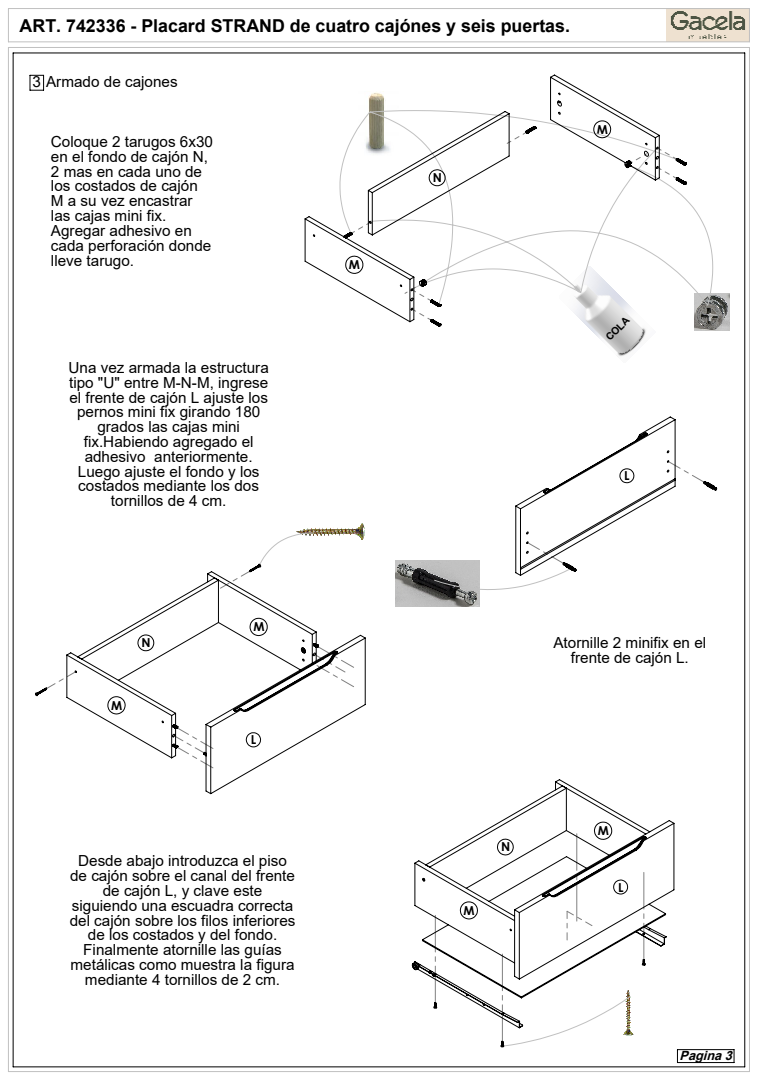
[picture p199: page 4]
Pagina 3

3 Armado de cajones

Coloque 2 tarugos 6x30
en el fondo de cajón N,
2 mas en cada uno de
los costados de cajón
M a su vez encastrar
las cajas mini fix.
Agregar adhesivo en
cada perforación donde
lleve tarugo.

Una vez armada la estructura
tipo "U" entre M-N-M, ingrese
el frente de cajón L ajuste los
pernos mini fix girando 180
grados las cajas mini
fix.Habiendo agregado el
adhesivo anteriormente.
Luego ajuste el fondo y los
costados mediante los dos
tornillos de 4 cm.

Atornille 2 minifix en el
frente de cajón L.

Desde abajo introduzca el piso
de cajón sobre el canal del frente
de cajón L, y clave este
siguiendo una escuadra correcta
del cajón sobre los filos inferiores
de los costados y del fondo.
Finalmente atornille las guías
metálicas como muestra la figura
mediante 4 tornillos de 2 cm.

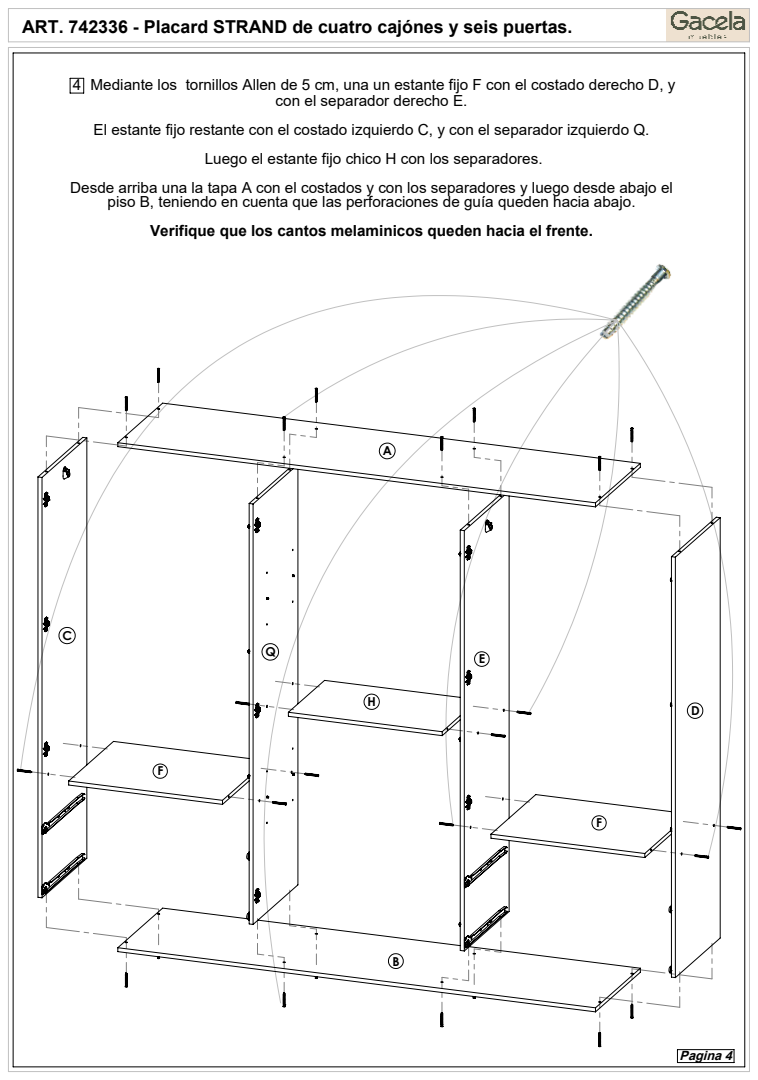
[picture p200: page 5]
Mediante los tornillos Allen de 5 cm, una un estante fijo F con el costado derecho D, y; Pagina 4

con el separador derecho E.

El estante fijo restante con el costado izquierdo C, y con el separador izquierdo Q.

Luego el estante fijo chico H con los separadores.

Desde arriba una la tapa A con el costados y con los separadores y luego desde abajo el piso B, teniendo en cuenta que las perforaciones de guía queden hacia abajo.

Verifique que los cantos melaminicos queden hacia el frente.

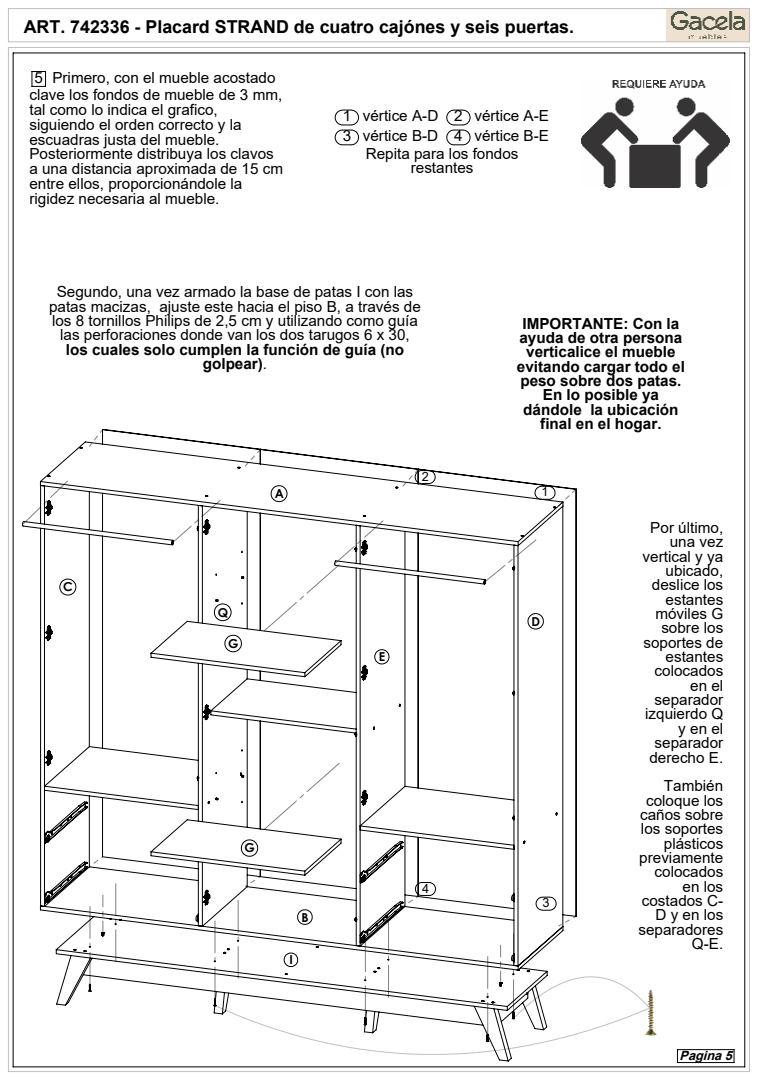
[picture p201: page 6]
Por último, una vez vertical y ya deslice los móviles G sobre los soportes de; en el izquierdo Q y en el derecho E.; coloque los caños sobre los soportes; en los costados C- D y en los; Primero, con el mueble acostado; Pagina 5

clave los fondos de mueble de 3 mm,
tal como lo indica el grafico,
siguiendo el orden correcto y la
escuadras justa del mueble.
Posteriormente distribuya los clavos
a una distancia aproximada de 15 cm
entre ellos, proporcionándole la
rigidez necesaria al mueble.

1 vértice A-D 2 vértice A-E
3 vértice B-D 4 vértice B-E
Repita para los fondos
restantes

Segundo, una vez armado la base de patas I con las
patas macizas, ajuste este hacia el piso B, a través de
los 8 tornillos Philips de 2,5 cm y utilizando como guía
las perforaciones donde van los dos tarugos 6 x 30,
los cuales solo cumplen la función de guía (no golpear).

IMPORTANTE: Con la
ayuda de otra persona
verticalice el mueble
evitando cargar todo el
peso sobre dos patas.
En lo posible ya dándole la ubicación
final en el hogar.

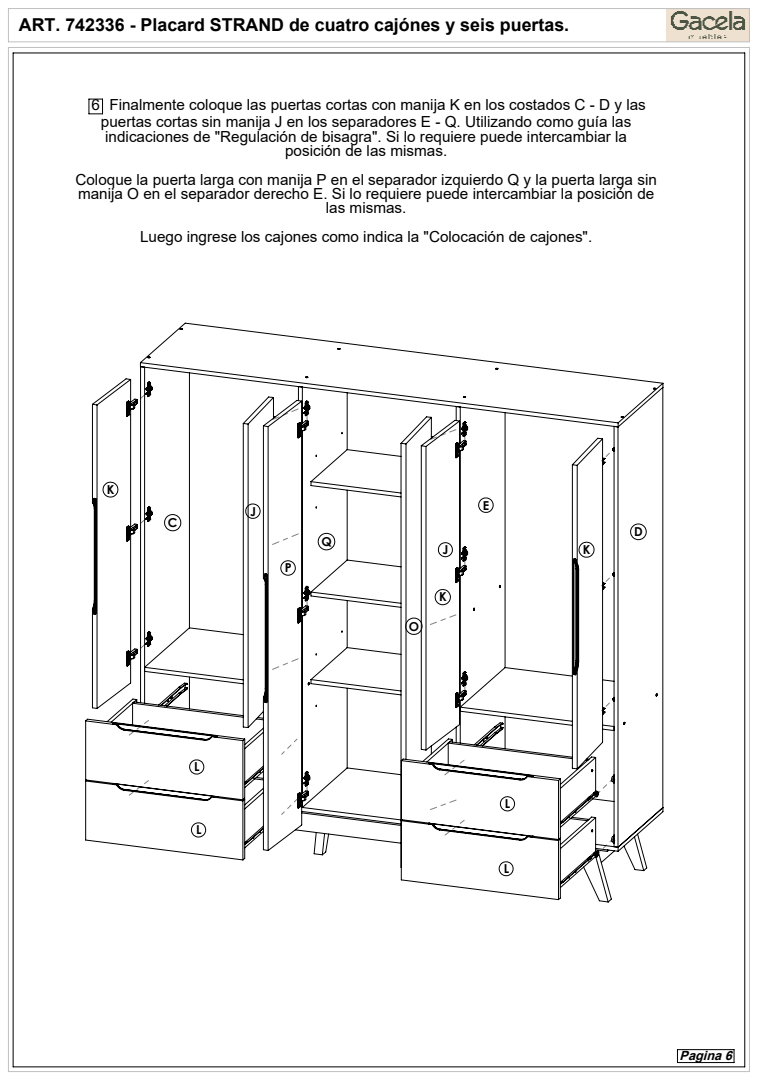
[picture p202: page 7]
Finalmente coloque las puertas cortas con manija K en los costados C - D y las; las mismas.; Pagina 6

puertas cortas sin manija J en los separadores E - Q. Utilizando como guía las
indicaciones de "Regulación de bisagra". Si lo requiere puede intercambiar la

posición de las mismas.

Coloque la puerta larga con manija P en el separador izquierdo Q y la puerta larga sin
manija O en el separador derecho E. Si lo requiere puede intercambiar la posición de

Luego ingrese los cajones como indica la "Colocación de cajones".

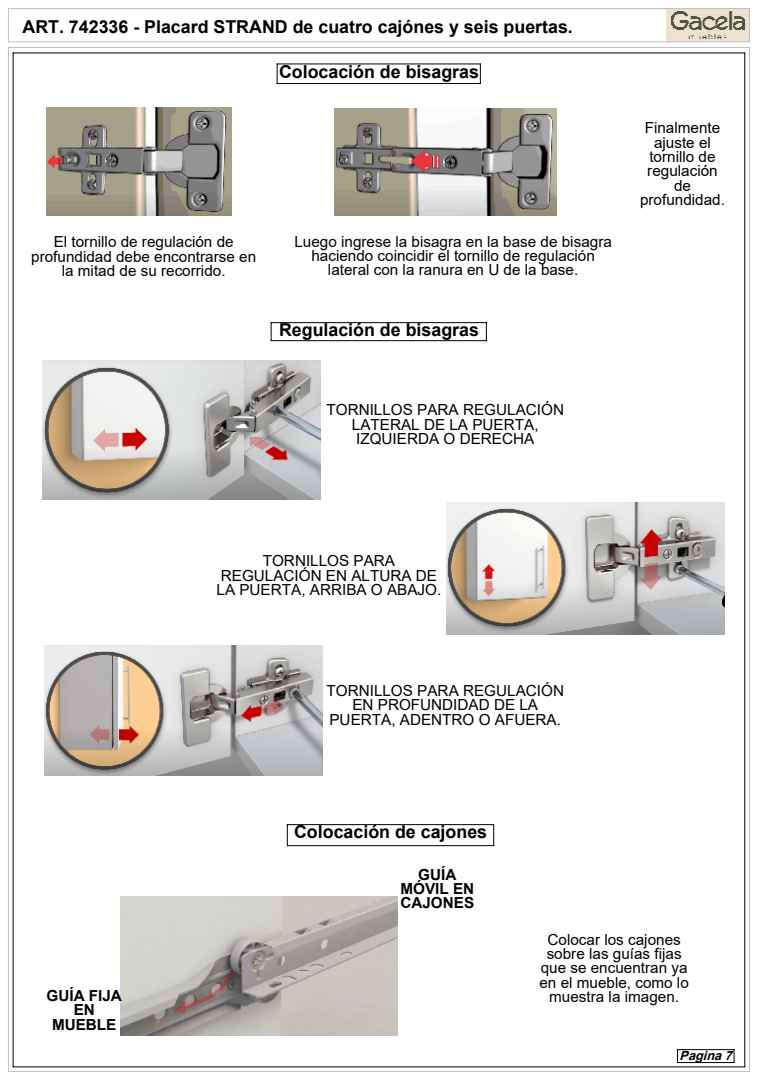
[picture p203: page 8]
ajuste el tornillo de; GUÍA FIJA; MÓVIL EN; Pagina 7

Colocación de bisagras

El tornillo de regulación de profundidad debe encontrarse en
la mitad de su recorrido.

Luego ingrese la bisagra en la base de bisagra
haciendo coincidir el tornillo de regulación
lateral con la ranura en U de la base.

Regulación de bisagras

TORNILLOS PARA REGULACIÓN
LATERAL DE LA PUERTA,
IZQUIERDA O DERECHA

TORNILLOS PARA
REGULACIÓN EN ALTURA DE
LA PUERTA, ARRIBA O ABAJO.

EN PROFUNDIDAD DE LA
PUERTA, ADENTRO O AFUERA.

Colocación de cajones

Colocar los cajones
sobre las guías fijas
que se encuentran ya
en el mueble, como lo
muestra la imagen.
