infomueblesgacela/muebles-gacela-mvp/public/articulos-gacela-muebles-2026/linea-clasica/art-748252-respaldo-yuki/a748252-ia-im00.pdf

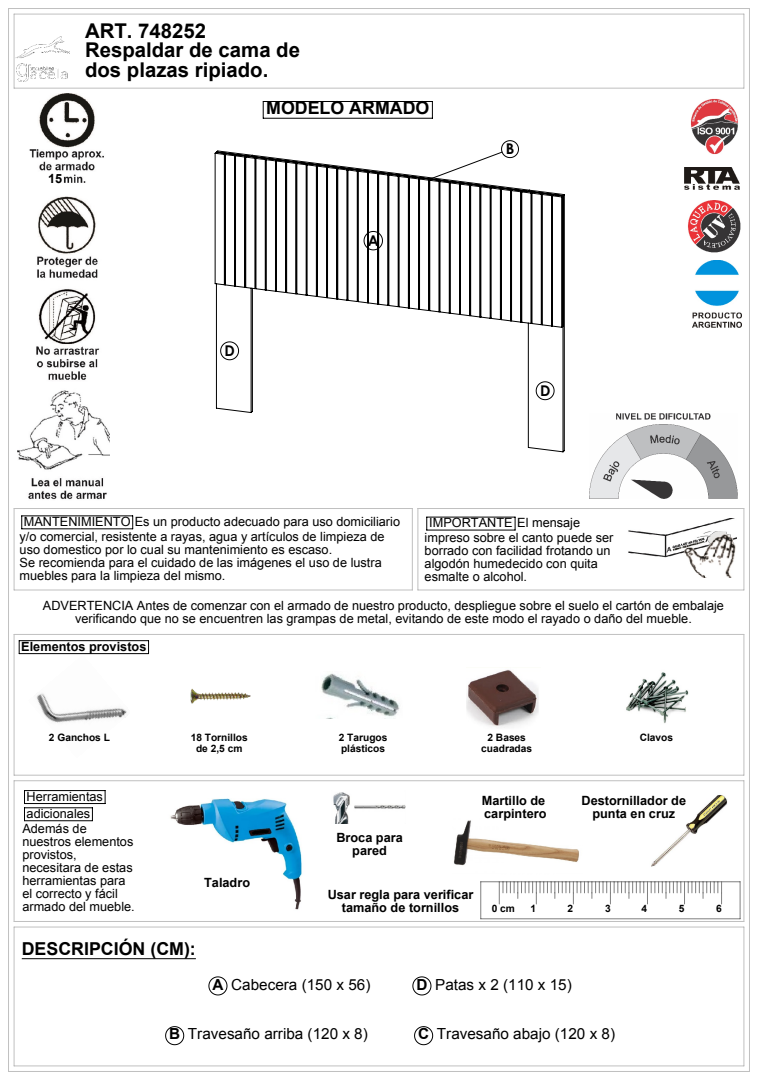
[picture p204: page 1]
A Cabecera (150 x 56); D Patas x 2 (110 x 15); B Travesaño arriba (120 x 8); C Travesaño abajo (120 x 8); Martillo de; Elementos provistos; MODELO ARMADO; 2 Ganchos L; 18 Tornillos; 2 Bases; 2 Tarugos; Broca para

ART. 748252
Respaldar de cama de
dos plazas ripiado.

MANTENIMIENTO Es un producto adecuado para uso domiciliario
y/o comercial, resistente a rayas, agua y artículos de limpieza de
uso domestico por lo cual su mantenimiento es escaso.
Se recomienda para el cuidado de las imágenes el uso de lustra
muebles para la limpieza del mismo.
ADVERTENCIA Antes de comenzar con el armado de nuestro producto, despliegue sobre el suelo el cartón de embalaje
verificando que no se encuentren las grampas de metal, evitando de este modo el rayado o daño del mueble.

IMPORTANTE El mensaje
impreso sobre el canto puede ser
borrado con facilidad frotando un
algodón humedecido con quita
esmalte o alcohol.

Herramientas
adicionales
Además de
nuestros elementos
provistos,
necesitara de estas
herramientas para
el correcto y fácil
armado del mueble.
DESCRIPCIÓN (CM):

Destornillador de
punta en cruz

Usar regla para verificar
tamaño de tornillos

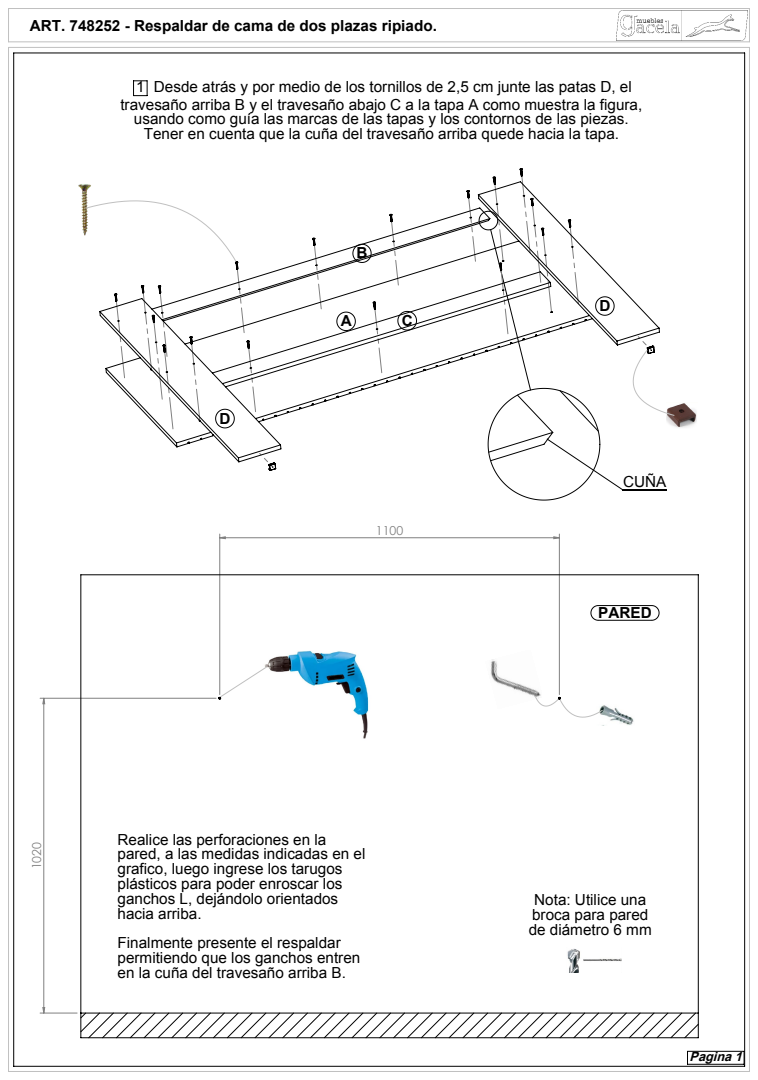
[picture p205: page 2]
Desde atrás y por medio de los tornillos de 2,5 cm junte las patas D, el; Pagina 1

ART. 748252 - Respaldar de cama de dos plazas ripiado.

travesaño arriba B y el travesaño abajo C a la tapa A como muestra la figura,
usando como guía las marcas de las tapas y los contornos de las piezas.
Tener en cuenta que la cuña del travesaño arriba quede hacia la tapa.

Realice las perforaciones en la
pared, a las medidas indicadas en el
grafico, luego ingrese los tarugos
plásticos para poder enroscar los
ganchos L, dejándolo orientados
hacia arriba.
Finalmente presente el respaldar
permitiendo que los ganchos entren
en la cuña del travesaño arriba B.

Nota: Utilice una
broca para pared
de diámetro 6 mm
