infomueblesgacela/muebles-gacela-mvp/public/articulos-gacela-muebles-2026/linea-clasica/art-839-5-comoda-alba/a008395-ia-im01.pdf

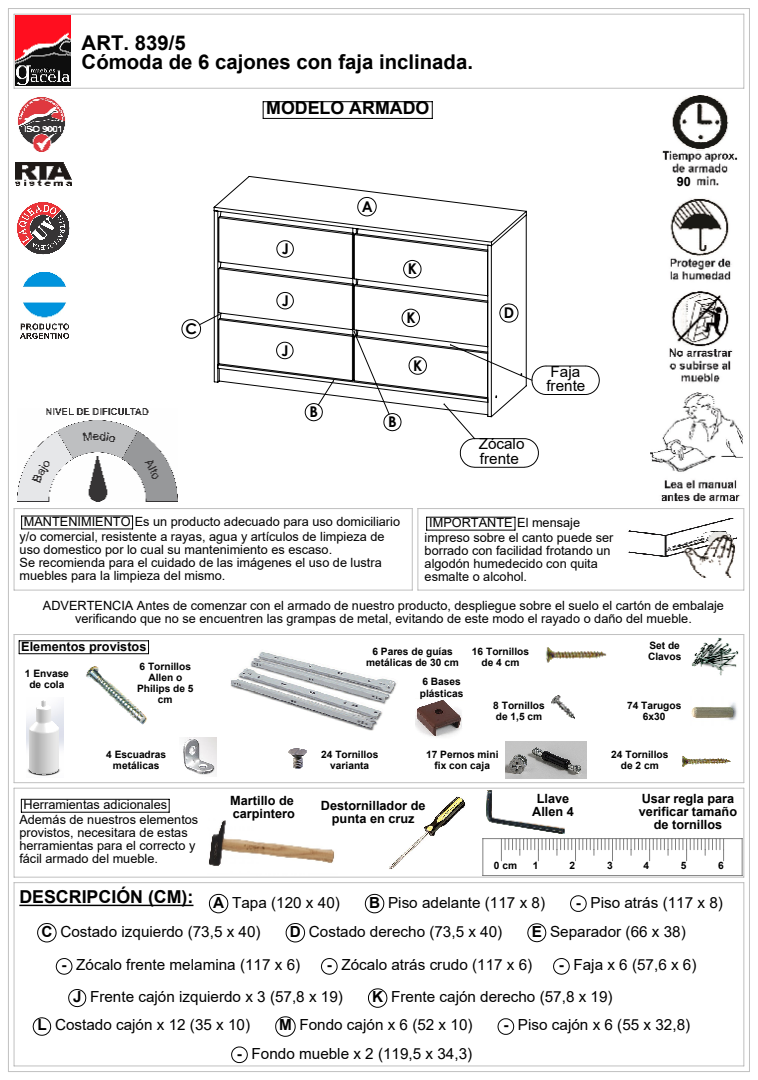
[picture p206: page 1]
A Tapa (120 x 40); B Piso adelante (117 x 8); - Piso atrás (117 x 8); J Frente cajón izquierdo x 3 (57,8 x 19); K Frente cajón derecho (57,8 x 19); - Fondo mueble x 2 (119,5 x 34,3); C Costado izquierdo (73,5 x 40); D Costado derecho (73,5 x 40); E Separador (66 x 38); L Costado cajón x 12 (35 x 10); M Fondo cajón x 6 (52 x 10); - Piso cajón x 6 (55 x 32,8); - Zócalo frente melamina (117 x 6); - Zócalo atrás crudo (117 x 6); - Faja x 6 (57,6 x 6); 74 Tarugos; Set de; Martillo de; carpintero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

ART. 839/5
Cómoda de 6 cajones con faja inclinada.

MANTENIMIENTO Es un producto adecuado para uso domiciliario
y/o comercial, resistente a rayas, agua y artículos de limpieza de
uso domestico por lo cual su mantenimiento es escaso.
Se recomienda para el cuidado de las imágenes el uso de lustra
muebles para la limpieza del mismo.
ADVERTENCIA Antes de comenzar con el armado de nuestro producto, despliegue sobre el suelo el cartón de embalaje
verificando que no se encuentren las grampas de metal, evitando de este modo el rayado o daño del mueble.
Elementos provistos

IMPORTANTE El mensaje
impreso sobre el canto puede ser
borrado con facilidad frotando un
algodón humedecido con quita
esmalte o alcohol.

6 Pares de guías
metálicas de 30 cm

17 Pernos mini
fix con caja

24 Tornillos
Usar regla para
verificar tamaño
de tornillos

Herramientas adicionales
Además de nuestros elementos
provistos, necesitara de estas
herramientas para el correcto y
fácil armado del mueble.
DESCRIPCIÓN (CM):

punta en cruz

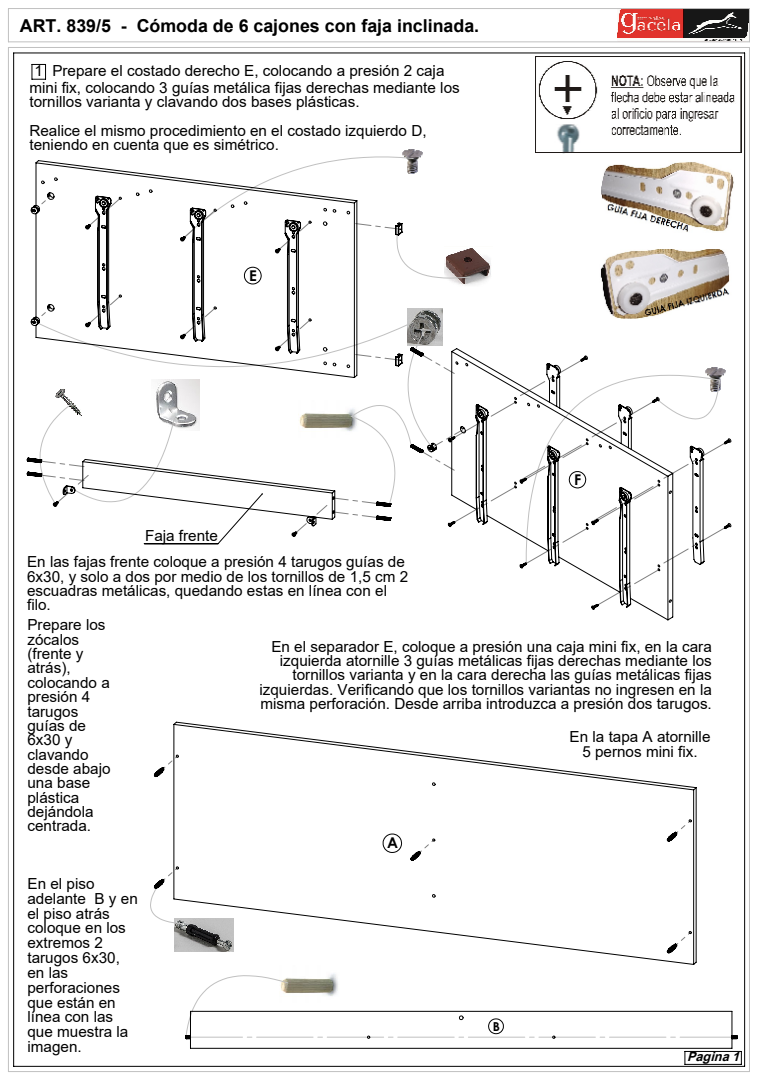
[picture p207: page 2]
Faja frente; Prepare el costado derecho E, colocando a presión 2 caja; imagen.; Pagina 1

ART. 839/5 - Cómoda de 6 cajones con faja inclinada.

mini fix, colocando 3 guías metálica fijas derechas mediante los
tornillos varianta y clavando dos bases plásticas.
Realice el mismo procedimiento en el costado izquierdo D,
teniendo en cuenta que es simétrico.

En las fajas frente coloque a presión 4 tarugos guías de
6x30, y solo a dos por medio de los tornillos de 1,5 cm 2
escuadras metálicas, quedando estas en línea con el
filo.
Prepare los
zócalos
(frente y
atrás),
colocando a
presión 4
tarugos
guías de
clavando
desde abajo
una base
plástica
dejándola
centrada.

En el separador E, coloque a presión una caja mini fix, en la cara
izquierda atornille 3 guías metálicas fijas derechas mediante los
tornillos varianta y en la cara derecha las guías metálicas fijas izquierdas. Verificando que los tornillos variantas no ingresen en la
misma perforación. Desde arriba introduzca a presión dos tarugos.

En la tapa A atornille
5 pernos mini fix.

En el piso
adelante B y en
el piso atrás
coloque en los
extremos 2
tarugos 6x30,
en las
perforaciones
que están en
línea con las
que muestra la

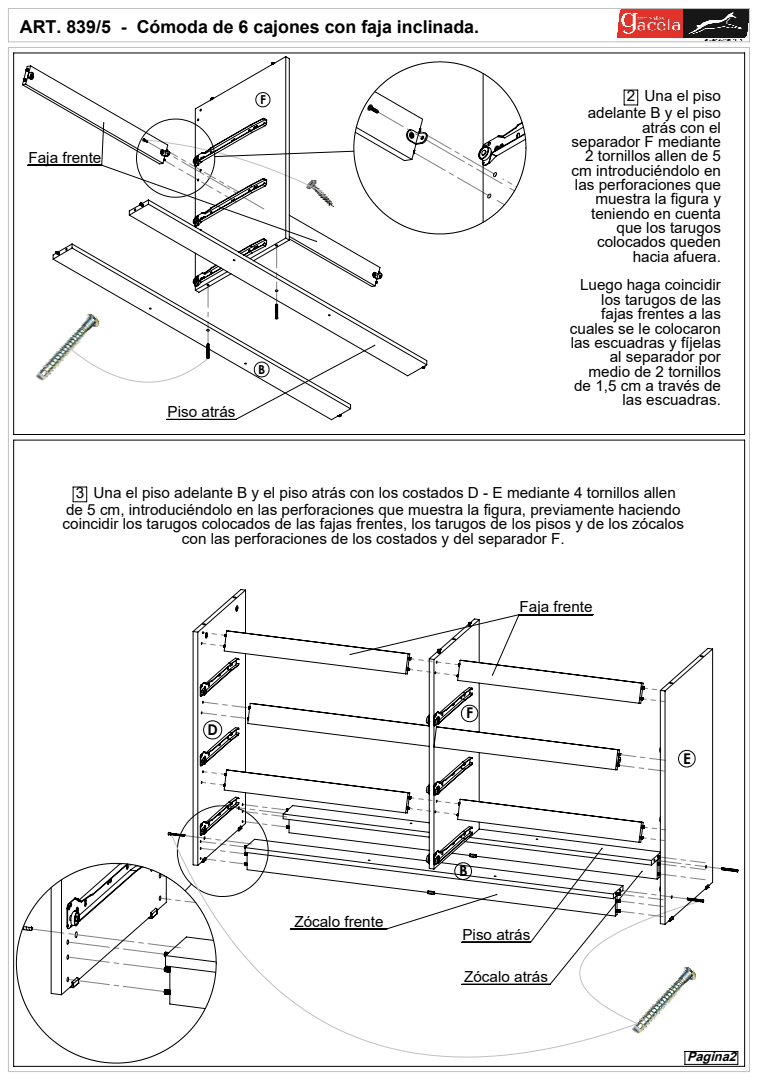
[picture p208: page 3]
Zócalo frente; Zócalo atrás; Faja frente; Piso atrás; Una el piso; separador F mediante; Una el piso adelante B y el piso atrás con los costados D - E mediante 4 tornillos allen

adelante B y el piso
atrás con el
2 tornillos allen de 5
cm introduciéndolo en
las perforaciones que
muestra la figura y
teniendo en cuenta
que los tarugos
colocados queden
hacia afuera.
Luego haga coincidir
los tarugos de las
fajas frentes a las
cuales se le colocaron
las escuadras y fíjelas
al separador por
medio de 2 tornillos
de 1,5 cm a través de
las escuadras.

de 5 cm, introduciéndolo en las perforaciones que muestra la figura, previamente haciendo
coincidir los tarugos colocados de las fajas frentes, los tarugos de los pisos y de los zócalos con las perforaciones de los costados y del separador F.

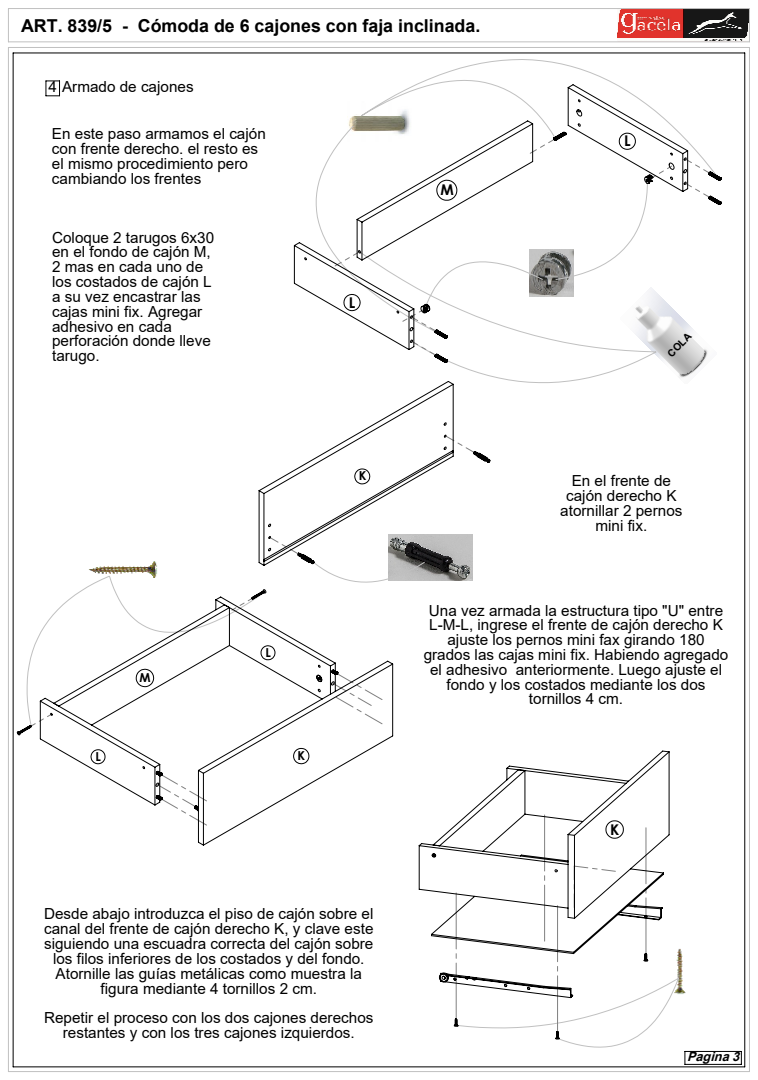
[picture p209: page 4]
tornillos 4 cm.; Pagina 3

4 Armado de cajones

En este paso armamos el cajón
con frente derecho. el resto es
el mismo procedimiento pero
cambiando los frentes

Coloque 2 tarugos 6x30
en el fondo de cajón M,
2 mas en cada uno de
los costados de cajón L
a su vez encastrar las
cajas mini fix. Agregar
adhesivo en cada
perforación donde lleve
tarugo.

En el frente de
cajón derecho K
atornillar 2 pernos
mini fix.

Una vez armada la estructura tipo "U" entre
L-M-L, ingrese el frente de cajón derecho K
ajuste los pernos mini fax girando 180
grados las cajas mini fix. Habiendo agregado
el adhesivo anteriormente. Luego ajuste el
fondo y los costados mediante los dos

Desde abajo introduzca el piso de cajón sobre el
canal del frente de cajón derecho K, y clave este
siguiendo una escuadra correcta del cajón sobre
los filos inferiores de los costados y del fondo.
Atornille las guías metálicas como muestra la
figura mediante 4 tornillos 2 cm.
Repetir el proceso con los dos cajones derechos
restantes y con los tres cajones izquierdos.

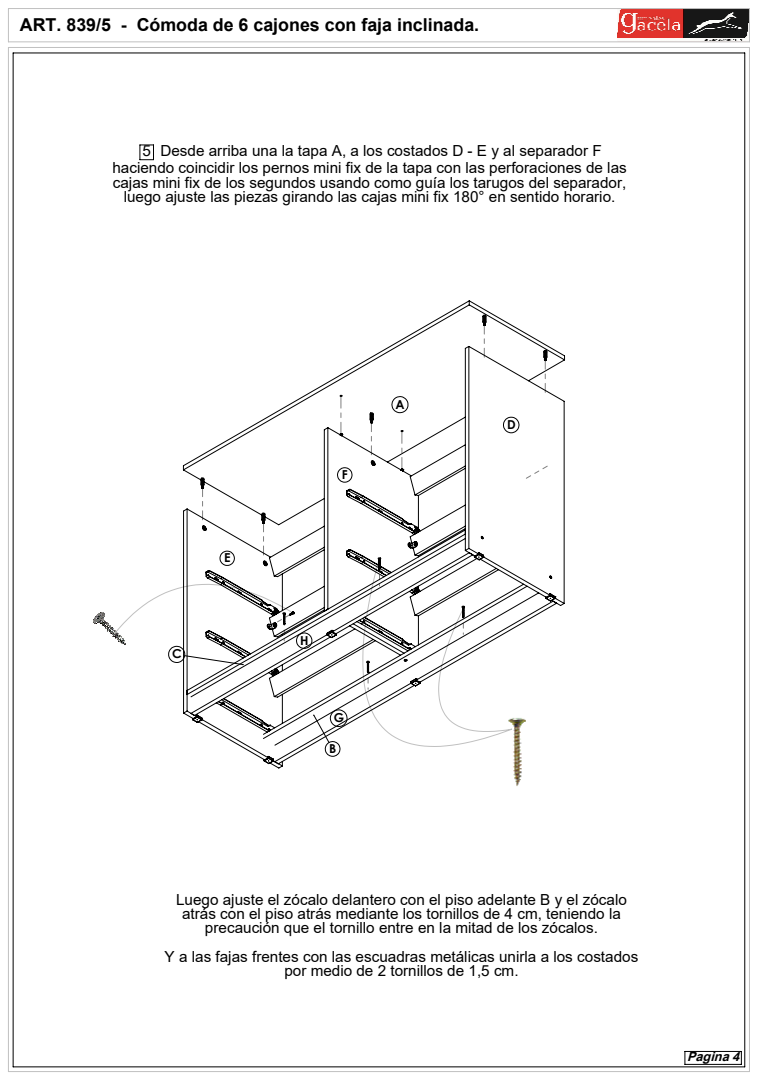
[picture p210: page 5]
Desde arriba una la tapa A, a los costados D - E y al separador F; Pagina 4

haciendo coincidir los pernos mini fix de la tapa con las perforaciones de las
cajas mini fix de los segundos usando como guía los tarugos del separador,
luego ajuste las piezas girando las cajas mini fix 180° en sentido horario.

Luego ajuste el zócalo delantero con el piso adelante B y el zócalo
atrás con el piso atrás mediante los tornillos de 4 cm, teniendo la
precaución que el tornillo entre en la mitad de los zócalos.
Y a las fajas frentes con las escuadras metálicas unirla a los costados

por medio de 2 tornillos de 1,5 cm.

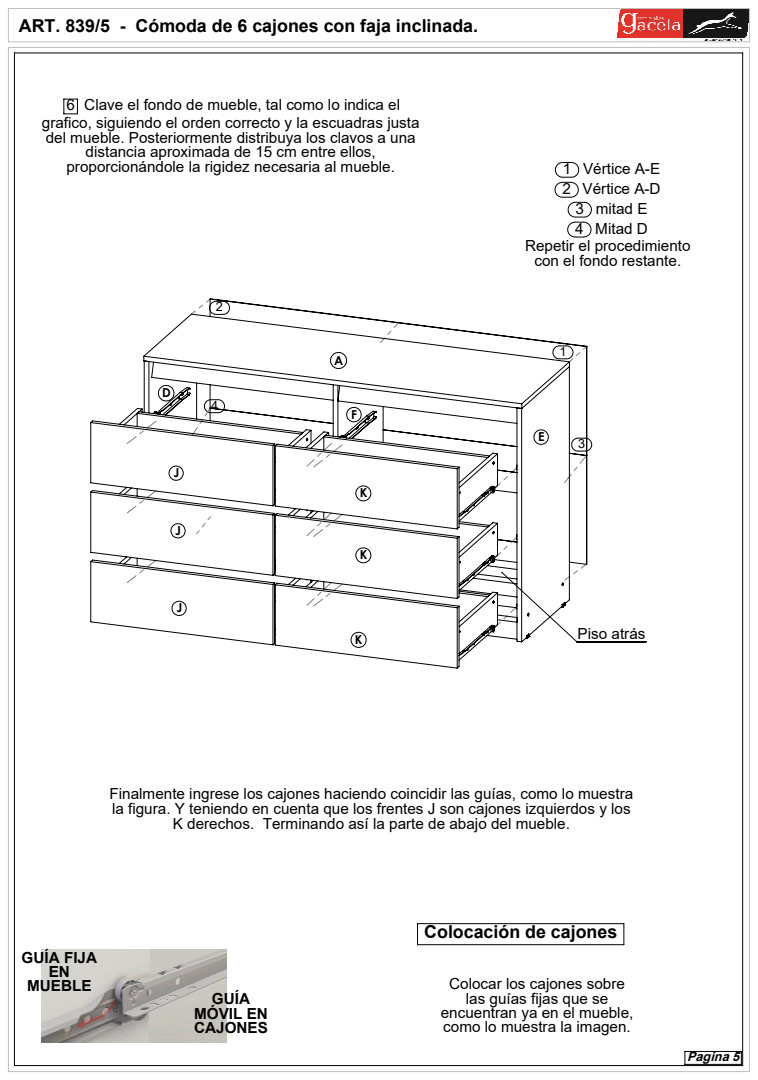
[picture p211: page 6]
Piso atrás; GUÍA FIJA; MÓVIL EN; Pagina 5

6 Clave el fondo de mueble, tal como lo indica el
grafico, siguiendo el orden correcto y la escuadras justa
del mueble. Posteriormente distribuya los clavos a una
distancia aproximada de 15 cm entre ellos,
proporcionándole la rigidez necesaria al mueble.

1 Vértice A-E
2 Vértice A-D
3 mitad E
4 Mitad D
Repetir el procedimiento
con el fondo restante.

Finalmente ingrese los cajones haciendo coincidir las guías, como lo muestra
la figura. Y teniendo en cuenta que los frentes J son cajones izquierdos y los
K derechos. Terminando así la parte de abajo del mueble.

Colocación de cajones

Colocar los cajones sobre las guías fijas que se
encuentran ya en el mueble,
como lo muestra la imagen.
