infomueblesgacela/muebles-gacela-mvp/public/modelos_3d/linea-clasica/A008285/A008285.PDF

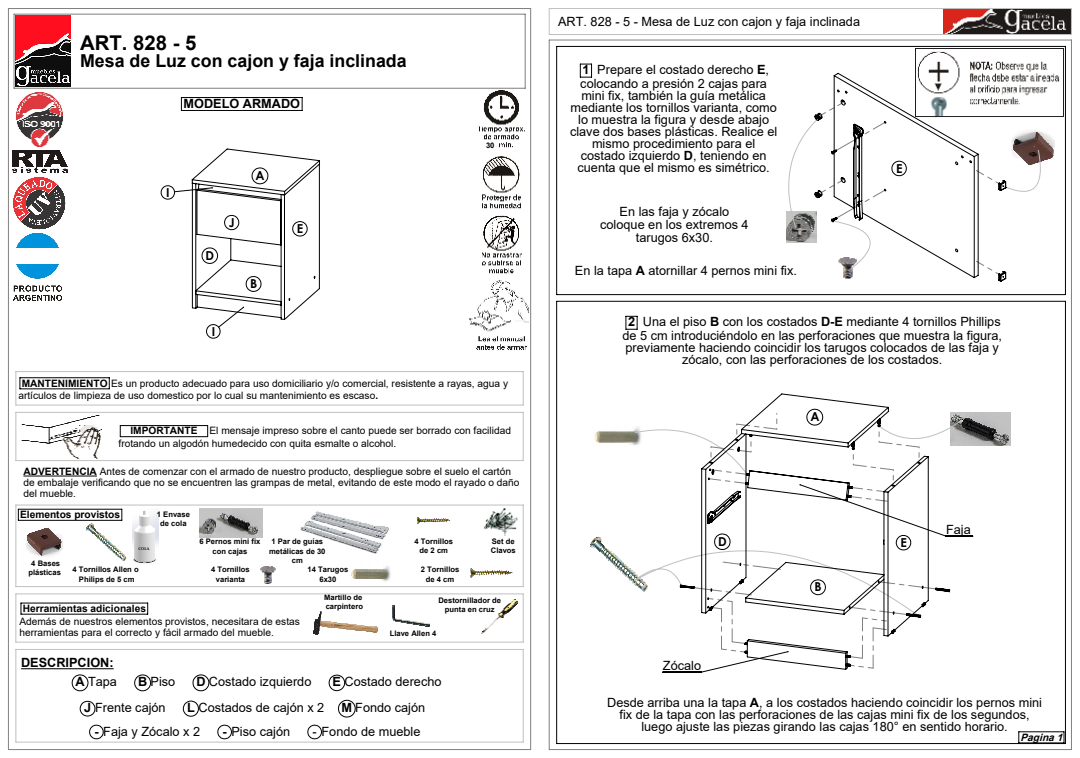
[picture p217: page 1]
A Tapa; B Piso; D Costado izquierdo; E Costado derecho; J Frente cajón; L Costados de cajón x 2 M Fondo cajón; - Faja y Zócalo x 2; - Piso cajón; - Fondo de mueble; 2 Tornillos de 4 cm; 1 Envase de cola; 4 Bases; Set de; carpintero; Destornillador de; Pagina 1; MODELO ARMADO; IMPORTANTE; El mensaje impreso sobre el canto puede ser borrado con facilidad; 4 Tornillos de 2 cm; Llave Allen 4

ART. 828 - 5 - Mesa de Luz con cajon y faja inclinada

ART. 828 - 5
Mesa de Luz con cajon y faja inclinada

1 Prepare el costado derecho E,
colocando a presión 2 cajas para
mini fix, también la guía metálica
mediante los tornillos varianta, como
lo muestra la figura y desde abajo
clave dos bases plásticas. Realice el
mismo procedimiento para el
costado izquierdo D, teniendo en
cuenta que el mismo es simétrico.

En las faja y zócalo
coloque en los extremos 4
tarugos 6x30.

En la tapa A atornillar 4 pernos mini fix.

2 Una el piso B con los costados D-E mediante 4 tornillos Phillips
de 5 cm introduciéndolo en las perforaciones que muestra la figura,
previamente haciendo coincidir los tarugos colocados de las faja y zócalo, con las perforaciones de los costados.

MANTENIMIENTO Es un producto adecuado para uso domiciliario y/o comercial, resistente a rayas, agua y
artículos de limpieza de uso domestico por lo cual su mantenimiento es escaso.

frotando un algodón humedecido con quita esmalte o alcohol.

ADVERTENCIA Antes de comenzar con el armado de nuestro producto, despliegue sobre el suelo el cartón
de embalaje verificando que no se encuentren las grampas de metal, evitando de este modo el rayado o daño
del mueble.
Elementos provistos

6 Pernos mini fix
con cajas
4 Tornillos
varianta

1 Par de guías
metálicas de 30
14 Tarugos
Martillo de

4 Tornillos Allen o
Philips de 5 cm

Herramientas adicionales
Además de nuestros elementos provistos, necesitara de estas
herramientas para el correcto y fácil armado del mueble.
DESCRIPCION:

punta en cruz

Desde arriba una la tapa A, a los costados haciendo coincidir los pernos mini
fix de la tapa con las perforaciones de las cajas mini fix de los segundos, luego ajuste las piezas girando las cajas 180° en sentido horario.

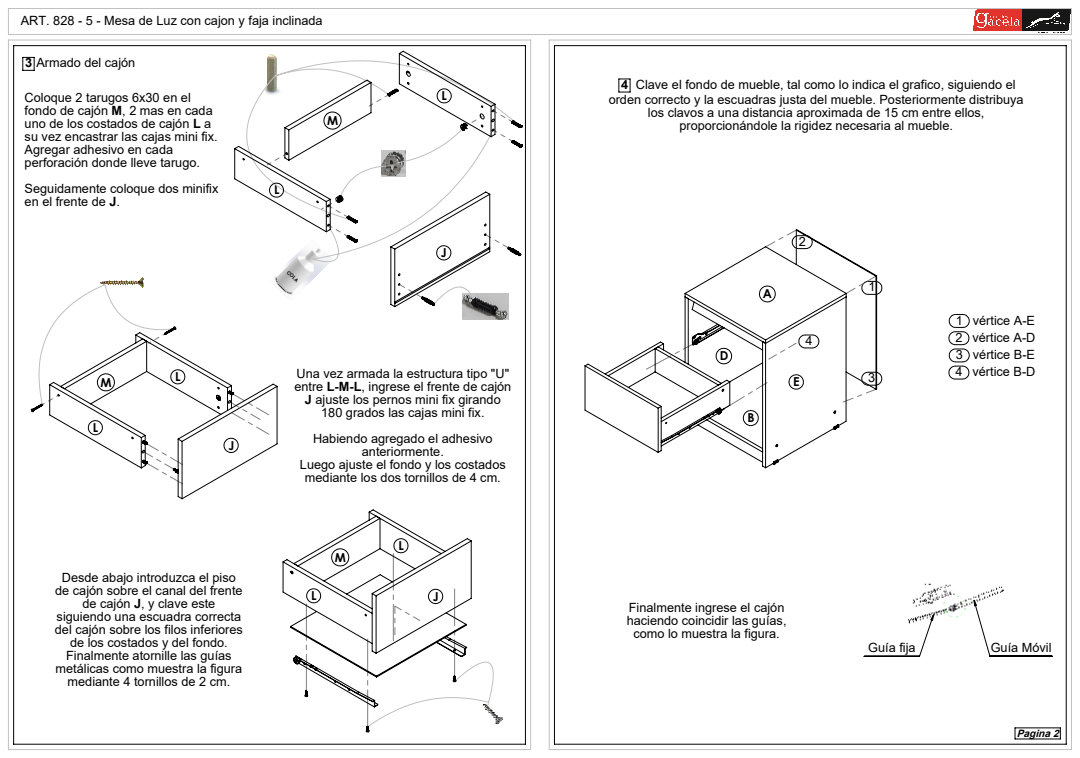
[picture p218: page 2]
Guía fija; Guía Móvil; 1 vértice A-E 2 vértice A-D 3 vértice B-E 4 vértice B-D; Pagina 2

ART. 828 - 5 - Mesa de Luz con cajon y faja inclinada

3 Armado del cajón

4 Clave el fondo de mueble, tal como lo indica el grafico, siguiendo el
orden correcto y la escuadras justa del mueble. Posteriormente distribuya
los clavos a una distancia aproximada de 15 cm entre ellos,
proporcionándole la rigidez necesaria al mueble.

Coloque 2 tarugos 6x30 en el
fondo de cajón M, 2 mas en cada
uno de los costados de cajón L a
su vez encastrar las cajas mini fix.
Agregar adhesivo en cada
perforación donde lleve tarugo.
Seguidamente coloque dos minifix
en el frente de J.

Una vez armada la estructura tipo "U"
entre L-M-L, ingrese el frente de cajón
J ajuste los pernos mini fix girando
180 grados las cajas mini fix.
Habiendo agregado el adhesivo
anteriormente.

Luego ajuste el fondo y los costados
mediante los dos tornillos de 4 cm.

Desde abajo introduzca el piso
de cajón sobre el canal del frente
de cajón J, y clave este
siguiendo una escuadra correcta
del cajón sobre los filos inferiores
de los costados y del fondo.
Finalmente atornille las guías
metálicas como muestra la figura
mediante 4 tornillos de 2 cm.

Finalmente ingrese el cajón
haciendo coincidir las guías,
como lo muestra la figura.
