infomueblesgacela/muebles-gacela-mvp/public/modelos_3d/linea-clasica/A009022/A009022.PDF

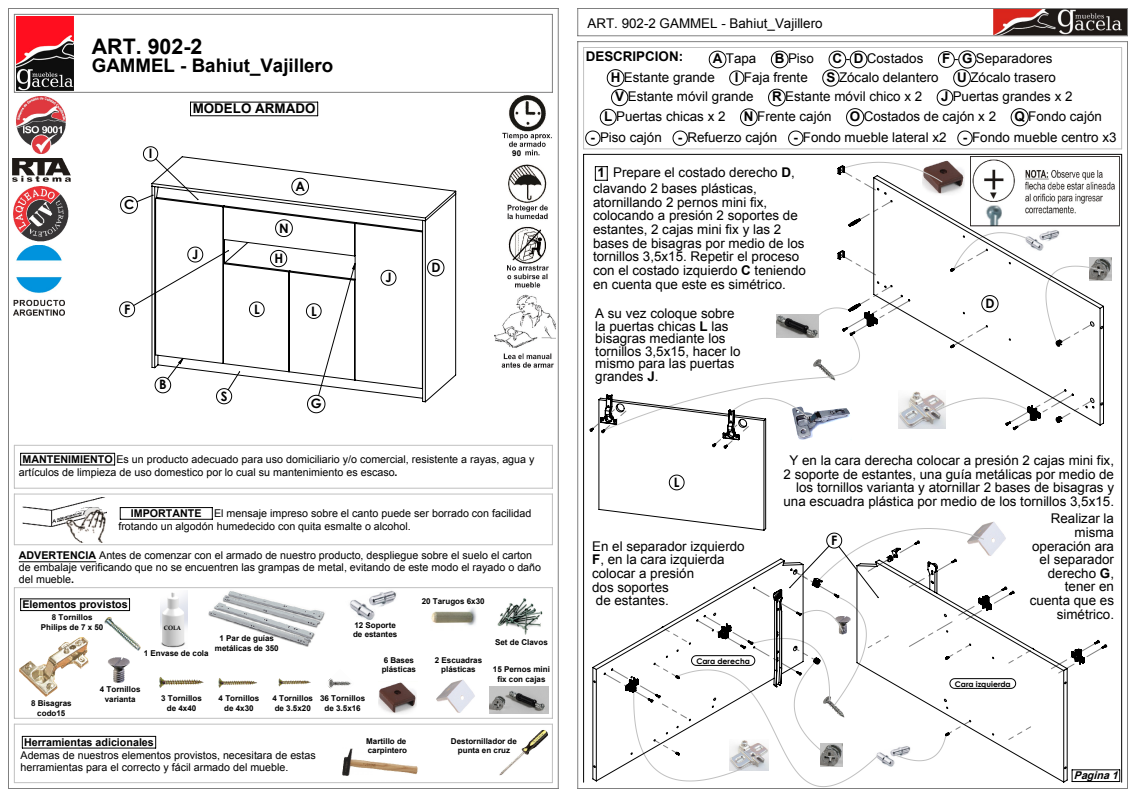
[picture p219: page 1]
Cara derecha; Cara izquierda; 36 Tornillos de 3.5x16; 3 Tornillos de 4x40; 1 Envase de cola; 2 Escuadras; 6 Bases; 12 Soporte de estantes; 4 Tornillos; 20 Tarugos 6x30; Martillo de; Pagina 1; MODELO ARMADO; IMPORTANTE; El mensaje impreso sobre el canto puede ser borrado con facilidad; 4 Tornillos de 3.5x20; ART. 902-2 GAMMEL - Bahiut_Vajillero; 4 Tornillos de 4x30

ART. 902-2 GAMMEL - Bahiut_Vajillero
DESCRIPCION:
H Estante grande I Faja frente S Zócalo delantero U Zócalo trasero
V Estante móvil grande R Estante móvil chico x 2 J Puertas grandes x 2
L Puertas chicas x 2 N Frente cajón O Costados de cajón x 2 Q Fondo cajón
- Piso cajón - Refuerzo cajón - Fondo mueble lateral x2 - Fondo mueble centro x3

A Tapa B Piso C - D Costados F - G Separadores

1 Prepare el costado derecho D,
clavando 2 bases plásticas,
atornillando 2 pernos mini fix,
colocando a presión 2 soportes de
estantes, 2 cajas mini fix y las 2
bases de bisagras por medio de los
tornillos 3,5x15. Repetir el proceso
con el costado izquierdo C teniendo
en cuenta que este es simétrico.
A su vez coloque sobre
la puertas chicas L las
bisagras mediante los
tornillos 3,5x15, hacer lo
mismo para las puertas
grandes J.

MANTENIMIENTO Es un producto adecuado para uso domiciliario y/o comercial, resistente a rayas, agua y
artículos de limpieza de uso domestico por lo cual su mantenimiento es escaso.

Y en la cara derecha colocar a presión 2 cajas mini fix,
2 soporte de estantes, una guía metálicas por medio de
los tornillos varianta y atornillar 2 bases de bisagras y
una escuadra plástica por medio de los tornillos 3,5x15.

frotando un algodón humedecido con quita esmalte o alcohol.

Realizar la
misma
operación ara
el separador
derecho G,
tener en
cuenta que es
simétrico.

En el separador izquierdo
F, en la cara izquierda
colocar a presión
dos soportes
de estantes.

ADVERTENCIA Antes de comenzar con el armado de nuestro producto, despliegue sobre el suelo el carton
de embalaje verificando que no se encuentren las grampas de metal, evitando de este modo el rayado o daño
del mueble.
Elementos provistos
8 Tornillos
Philips de 7 x 50

1 Par de guías
metálicas de 350

Set de Clavos

15 Pernos mini
fix con cajas

8 Bisagras
codo15
Herramientas adicionales
Ademas de nuestros elementos provistos, necesitara de estas
herramientas para el correcto y fácil armado del mueble.

Destornillador de
punta en cruz

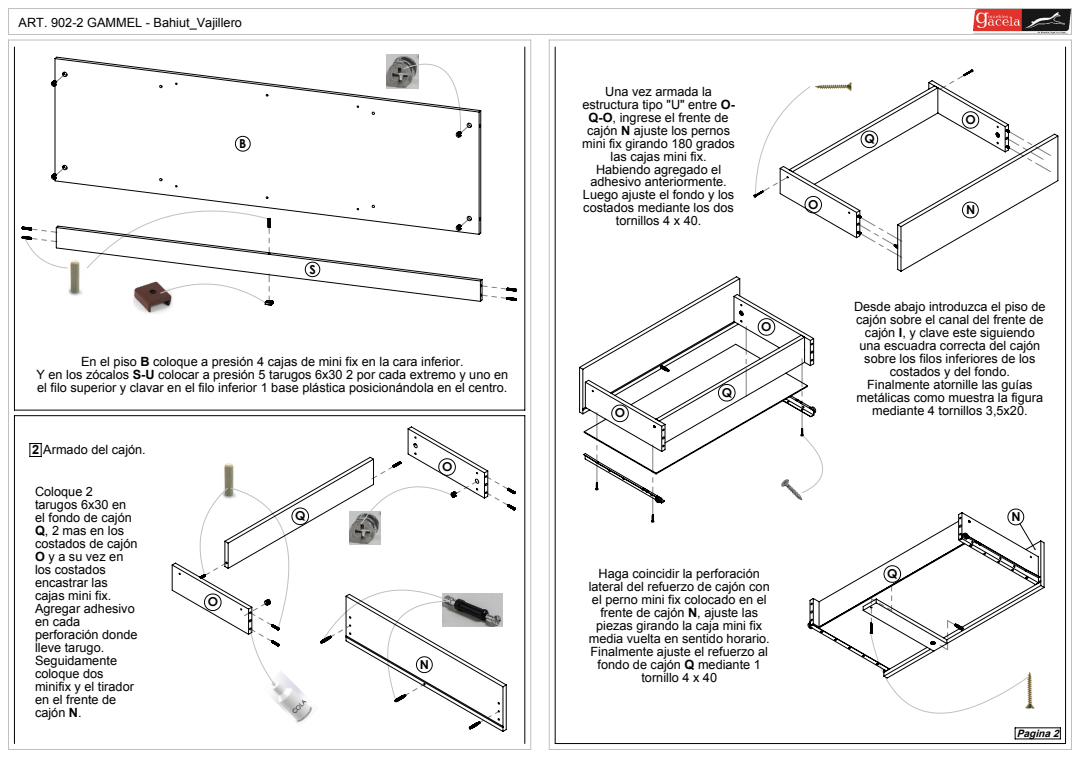
[picture p220: page 2]
Pagina 2

Una vez armada la
estructura tipo "U" entre O-
Q-O, ingrese el frente de
cajón N ajuste los pernos
mini fix girando 180 grados
las cajas mini fix.
Habiendo agregado el
adhesivo anteriormente.
Luego ajuste el fondo y los
costados mediante los dos
tornillos 4 x 40.

Desde abajo introduzca el piso de
cajón sobre el canal del frente de
cajón I, y clave este siguiendo
una escuadra correcta del cajón
sobre los filos inferiores de los
costados y del fondo.
Finalmente atornille las guías
metálicas como muestra la figura
mediante 4 tornillos 3,5x20.

En el piso B coloque a presión 4 cajas de mini fix en la cara inferior.
Y en los zócalos S-U colocar a presión 5 tarugos 6x30 2 por cada extremo y uno en
el filo superior y clavar en el filo inferior 1 base plástica posicionándola en el centro.

2 Armado del cajón.

Coloque 2
tarugos 6x30 en
el fondo de cajón
Q, 2 mas en los
costados de cajón
O y a su vez en
los costados
encastrar las
cajas mini fix.
Agregar adhesivo
en cada
perforación donde
lleve tarugo.
Seguidamente
coloque dos
minifix y el tirador
en el frente de
cajón N.

Haga coincidir la perforación
lateral del refuerzo de cajón con
el perno mini fix colocado en el
frente de cajón N, ajuste las
piezas girando la caja mini fix
media vuelta en sentido horario.
Finalmente ajuste el refuerzo al
fondo de cajón Q mediante 1
tornillo 4 x 40

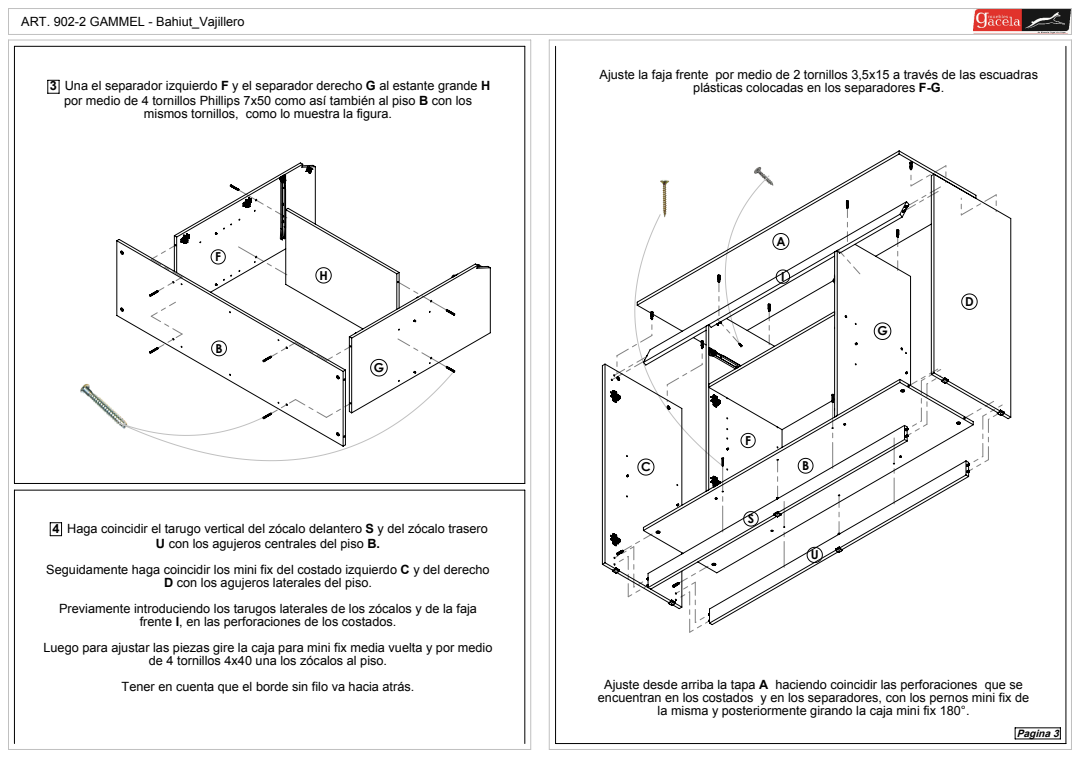
[picture p221: page 3]
Pagina 3

Ajuste la faja frente por medio de 2 tornillos 3,5x15 a través de las escuadras

3 Una el separador izquierdo F y el separador derecho G al estante grande H
por medio de 4 tornillos Phillips 7x50 como así también al piso B con los

plásticas colocadas en los separadores F-G.

mismos tornillos, como lo muestra la figura.

4 Haga coincidir el tarugo vertical del zócalo delantero S y del zócalo trasero

U con los agujeros centrales del piso B.

Seguidamente haga coincidir los mini fix del costado izquierdo C y del derecho

D con los agujeros laterales del piso.

Previamente introduciendo los tarugos laterales de los zócalos y de la faja

frente I, en las perforaciones de los costados.

Luego para ajustar las piezas gire la caja para mini fix media vuelta y por medio

de 4 tornillos 4x40 una los zócalos al piso.
Tener en cuenta que el borde sin filo va hacia atrás.

Ajuste desde arriba la tapa A haciendo coincidir las perforaciones que se
encuentran en los costados y en los separadores, con los pernos mini fix de

la misma y posteriormente girando la caja mini fix 180°.

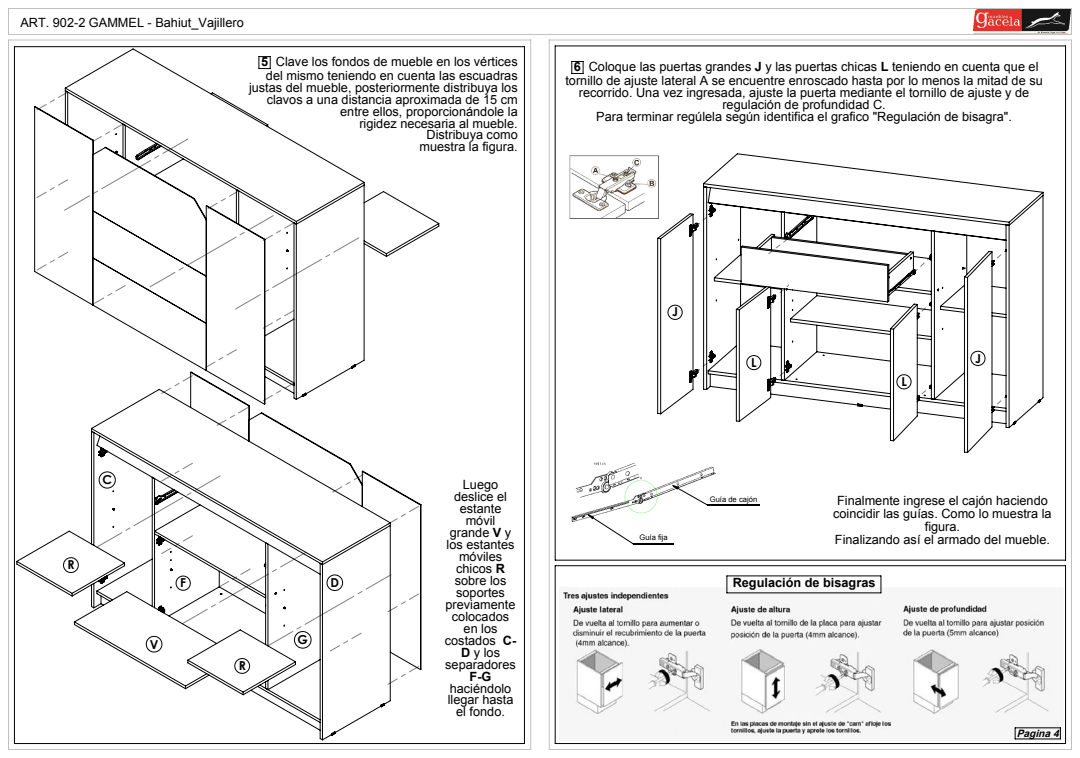
[picture p222: page 4]
deslice el; grande V y los estantes chicos R sobre los; en los costados C- D y los; llegar hasta el fondo.; Pagina 4

5 Clave los fondos de mueble en los vértices
del mismo teniendo en cuenta las escuadras
justas del mueble, posteriormente distribuya los
clavos a una distancia aproximada de 15 cm

6 Coloque las puertas grandes J y las puertas chicas L teniendo en cuenta que el
tornillo de ajuste lateral A se encuentre enroscado hasta por lo menos la mitad de su
recorrido. Una vez ingresada, ajuste la puerta mediante el tornillo de ajuste y de regulación de profundidad C. Para terminar regúlela según identifica el grafico "Regulación de bisagra".

entre ellos, proporcionándole la
rigidez necesaria al mueble.

Distribuya como
muestra la figura.

Guía de cajón

Finalmente ingrese el cajón haciendo
coincidir las guías. Como lo muestra la

Finalizando así el armado del mueble. Guía fija

Regulación de bisagras
