infomueblesgacela/muebles-gacela-mvp/public/modelos_3d/linea-clasica/A712151/A712151.PDF

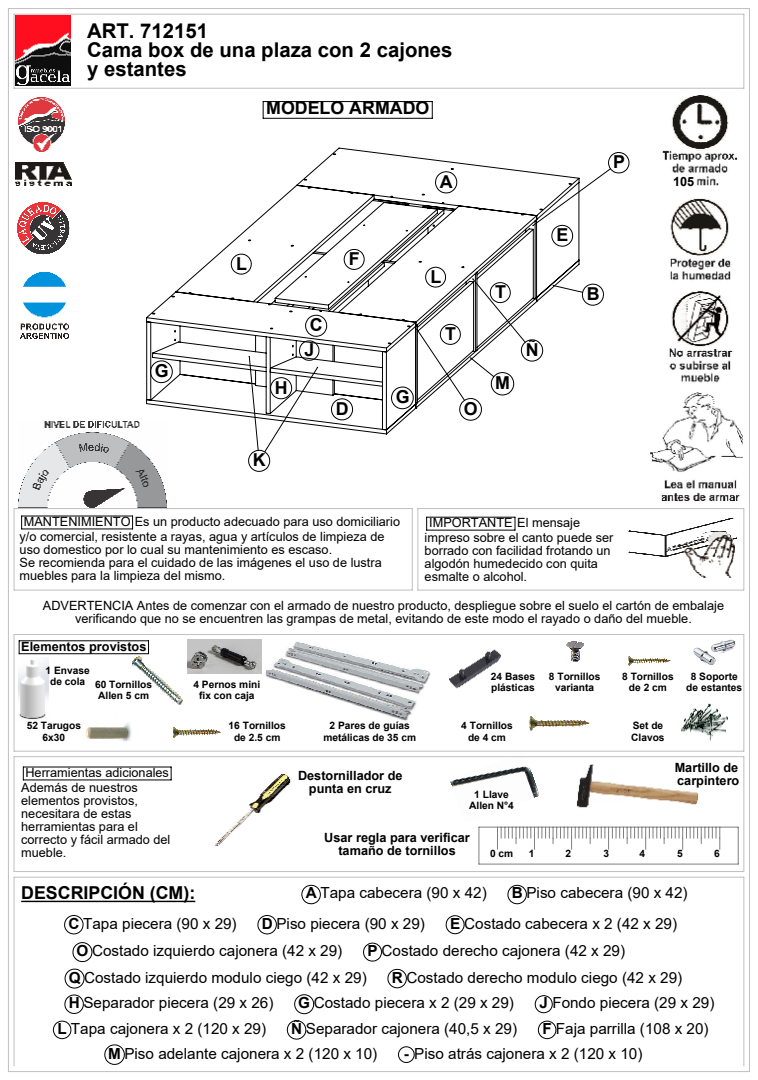
[picture p227: page 1]
O Costado izquierdo cajonera (42 x 29); P Costado derecho cajonera (42 x 29); C Tapa piecera (90 x 29) D Piso piecera (90 x 29); E Costado cabecera x 2 (42 x 29); H Separador piecera (29 x 26) G Costado piecera x 2 (29 x 29); J Fondo piecera (29 x 29); L Tapa cajonera x 2 (120 x 29) Ñ Separador cajonera (40,5 x 29); F Faja parrilla (108 x 20); M Piso adelante cajonera x 2 (120 x 10); - Piso atrás cajonera x 2 (120 x 10); 1 Llave Allen N°4; 8 Tornillos de 2 cm; 52 Tarugos; Set de; Martillo de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

ART. 712151
Cama box de una plaza con 2 cajones
y estantes

MANTENIMIENTO Es un producto adecuado para uso domiciliario
y/o comercial, resistente a rayas, agua y artículos de limpieza de
uso domestico por lo cual su mantenimiento es escaso.
Se recomienda para el cuidado de las imágenes el uso de lustra
muebles para la limpieza del mismo.
ADVERTENCIA Antes de comenzar con el armado de nuestro producto, despliegue sobre el suelo el cartón de embalaje
verificando que no se encuentren las grampas de metal, evitando de este modo el rayado o daño del mueble.
Elementos provistos
1 Envase
de cola 60 Tornillos

IMPORTANTE El mensaje
impreso sobre el canto puede ser
borrado con facilidad frotando un
algodón humedecido con quita
esmalte o alcohol.

4 Pernos mini
fix con caja

2 Pares de guías
metálicas de 35 cm

Herramientas adicionales
Además de nuestros
elementos provistos,
necesitara de estas
herramientas para el
correcto y fácil armado del
mueble.
DESCRIPCIÓN (CM):
Q Costado izquierdo modulo ciego (42 x 29) R Costado derecho modulo ciego (42 x 29)

carpintero Destornillador de
punta en cruz

Usar regla para verificar
tamaño de tornillos

A Tapa cabecera (90 x 42) B Piso cabecera (90 x 42)

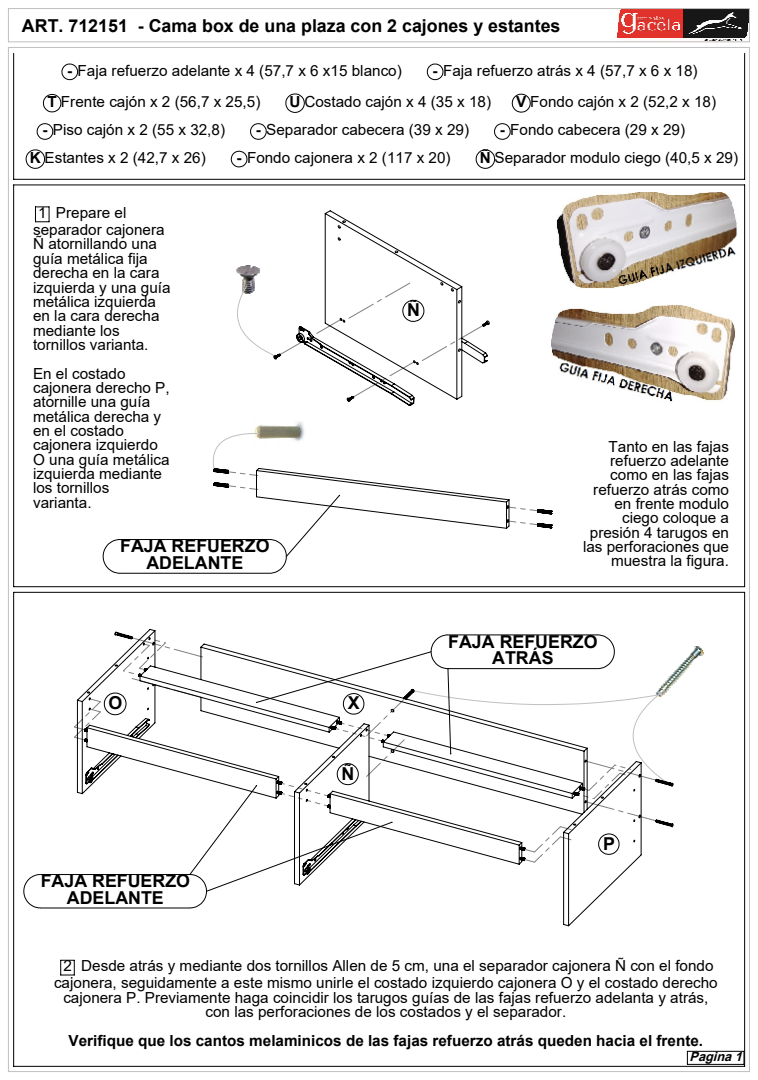
[picture p228: page 2]
FAJA REFUERZO; Prepare el; - Piso cajón x 2 (55 x 32,8); - Separador cabecera (39 x 29); - Fondo cabecera (29 x 29); T Frente cajón x 2 (56,7 x 25,5); U Costado cajón x 4 (35 x 18); V Fondo cajón x 2 (52,2 x 18); - Faja refuerzo adelante x 4 (57,7 x 6 x15 blanco); - Faja refuerzo atrás x 4 (57,7 x 6 x 18); Desde atrás y mediante dos tornillos Allen de 5 cm, una el separador cajonera Ñ con el fondo; K Estantes x 2 (42,7 x 26); - Fondo cajonera x 2 (117 x 20)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

ART. 712151 - Cama box de una plaza con 2 cajones y estantes

separador cajonera
Ñ atornillando una
guía metálica fija
derecha en la cara
izquierda y una guía
metálica izquierda
en la cara derecha
mediante los
tornillos varianta.
En el costado
cajonera derecho P,
atornille una guía
metálica derecha y
en el costado
cajonera izquierdo
O una guía metálica
izquierda mediante
los tornillos
varianta.

Tanto en las fajas
refuerzo adelante
como en las fajas refuerzo atrás como
en frente modulo
ciego coloque a
presión 4 tarugos en
las perforaciones que
muestra la figura.

cajonera, seguidamente a este mismo unirle el costado izquierdo cajonera O y el costado derecho
cajonera P. Previamente haga coincidir los tarugos guías de las fajas refuerzo adelanta y atrás, con las perforaciones de los costados y el separador.

Verifique que los cantos melaminicos de las fajas refuerzo atrás queden hacia el frente.

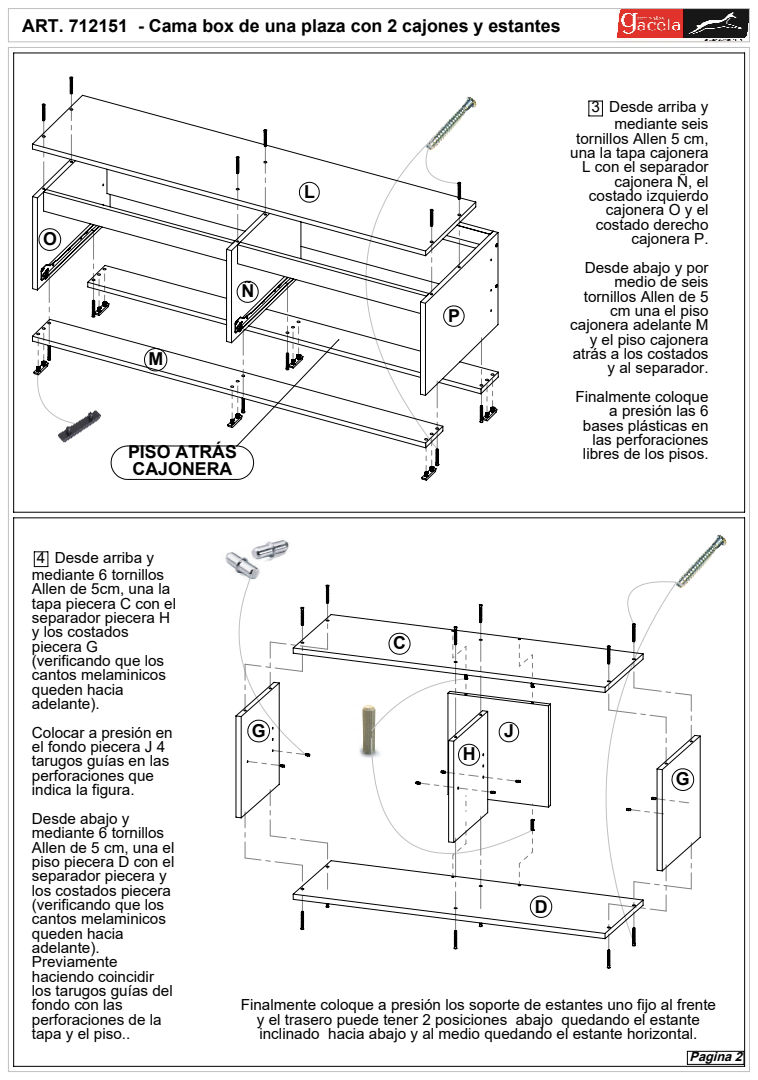
[picture p229: page 3]
PISO ATRÁS; Desde arriba y; Pagina 2

mediante seis
tornillos Allen 5 cm,
una la tapa cajonera
L con el separador cajonera Ñ, el
costado izquierdo
cajonera O y el
costado derecho
cajonera P.
Desde abajo y por
medio de seis
tornillos Allen de 5
cm una el piso
cajonera adelante M
y el piso cajonera
atrás a los costados
y al separador.
Finalmente coloque
a presión las 6
bases plásticas en
las perforaciones
libres de los pisos.

mediante 6 tornillos
Allen de 5cm, una la
tapa piecera C con el
separador piecera H
y los costados
piecera G
(verificando que los
cantos melaminicos
queden hacia
adelante).
Colocar a presión en
el fondo piecera J 4
tarugos guías en las
perforaciones que
indica la figura.
Desde abajo y
Allen de 5 cm, una el
piso piecera D con el
separador piecera y
los costados piecera
Previamente
haciendo coincidir
los tarugos guías del
fondo con las
perforaciones de la
tapa y el piso..

Finalmente coloque a presión los soporte de estantes uno fijo al frente
y el trasero puede tener 2 posiciones abajo quedando el estante
inclinado hacia abajo y al medio quedando el estante horizontal.

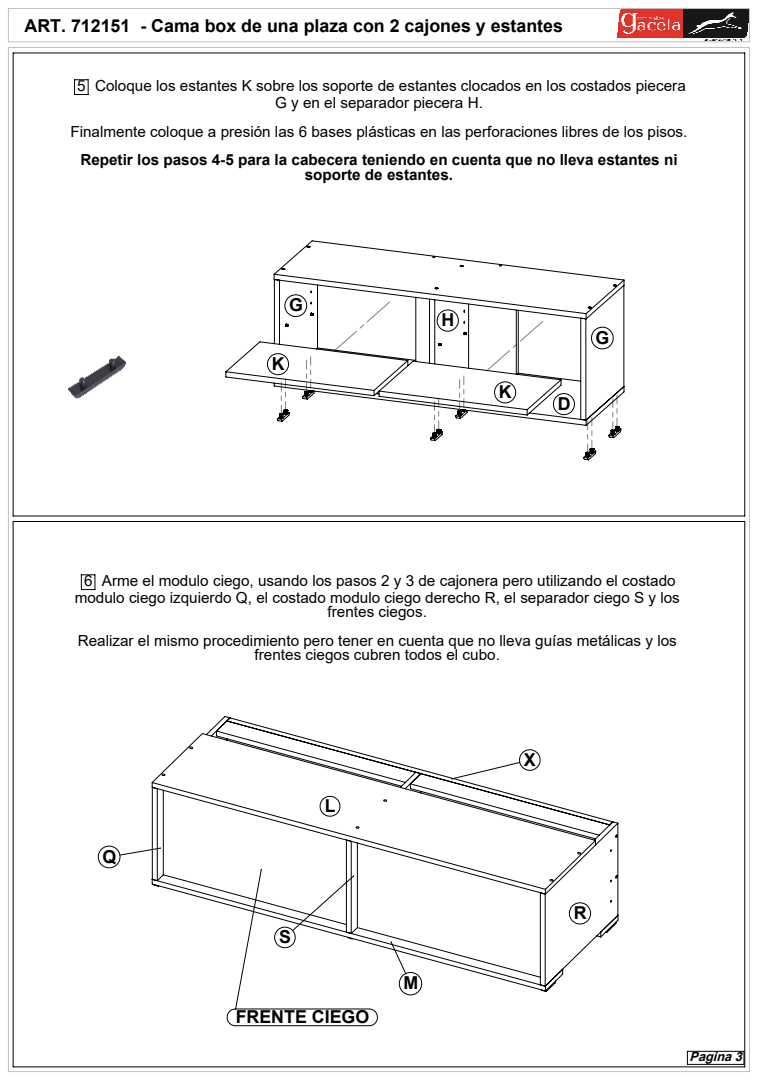
[picture p230: page 4]
FRENTE CIEGO; Coloque los estantes K sobre los soporte de estantes clocados en los costados piecera; Arme el modulo ciego, usando los pasos 2 y 3 de cajonera pero utilizando el costado; Pagina 3

G y en el separador piecera H.

Finalmente coloque a presión las 6 bases plásticas en las perforaciones libres de los pisos.
Repetir los pasos 4-5 para la cabecera teniendo en cuenta que no lleva estantes ni

soporte de estantes.

modulo ciego izquierdo Q, el costado modulo ciego derecho R, el separador ciego S y los frentes ciegos.

Realizar el mismo procedimiento pero tener en cuenta que no lleva guías metálicas y los frentes ciegos cubren todos el cubo.

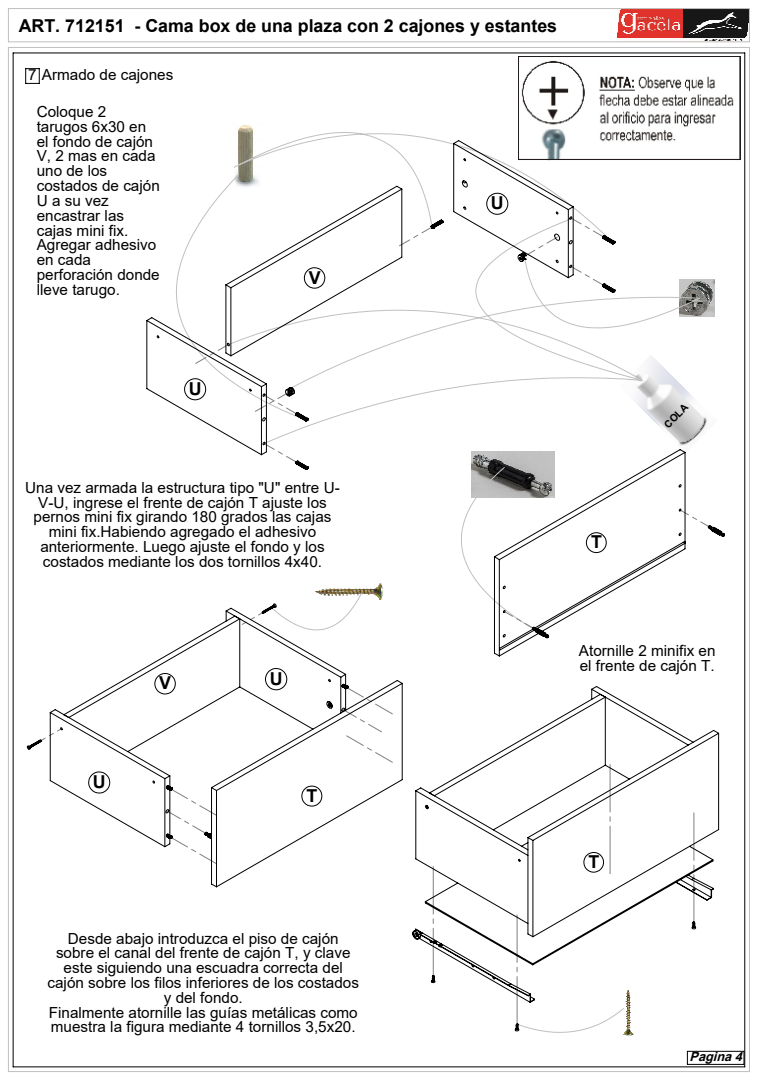
[picture p231: page 5]
y del fondo.; Pagina 4

7 Armado de cajones
Coloque 2
tarugos 6x30 en
el fondo de cajón
V, 2 mas en cada
uno de los
costados de cajón
U a su vez
encastrar las
cajas mini fix.
Agregar adhesivo
en cada
perforación donde
lleve tarugo.

Una vez armada la estructura tipo "U" entre U-
V-U, ingrese el frente de cajón T ajuste los
pernos mini fix girando 180 grados las cajas
mini fix.Habiendo agregado el adhesivo
anteriormente. Luego ajuste el fondo y los
costados mediante los dos tornillos 4x40.

Atornille 2 minifix en
el frente de cajón T.

Desde abajo introduzca el piso de cajón
sobre el canal del frente de cajón T, y clave
este siguiendo una escuadra correcta del
cajón sobre los filos inferiores de los costados
Finalmente atornille las guías metálicas como
muestra la figura mediante 4 tornillos 3,5x20.

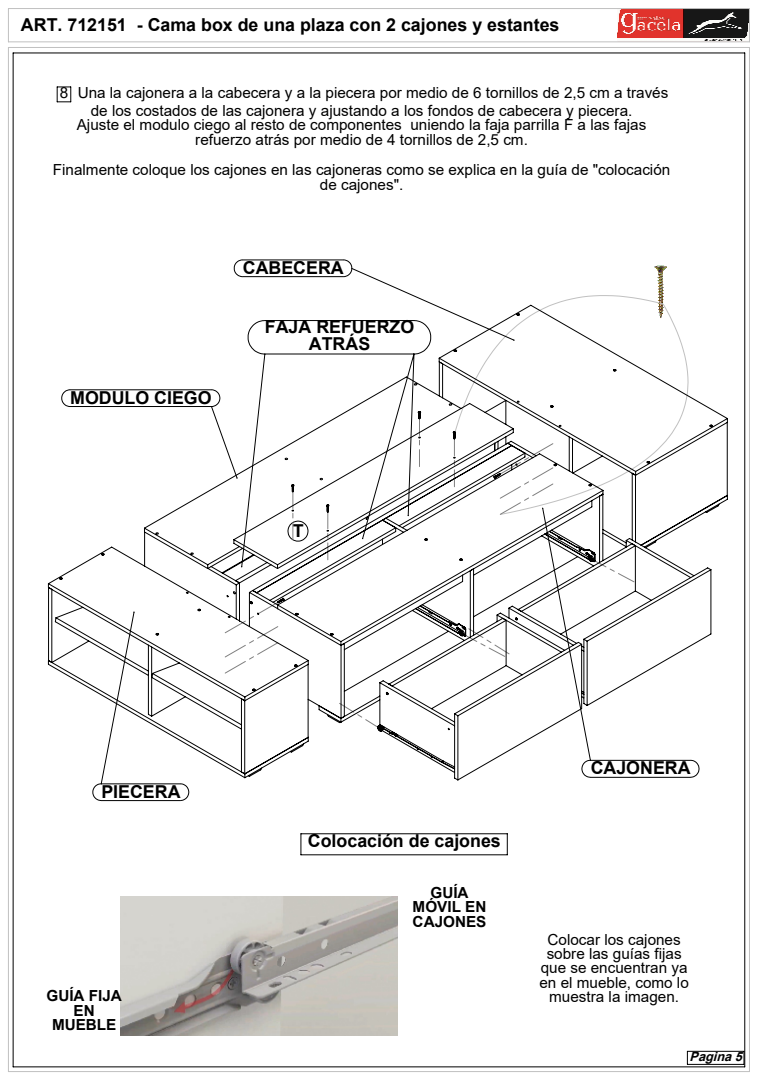
[picture p232: page 6]
MODULO CIEGO; FAJA REFUERZO; GUÍA FIJA; MÓVIL EN; Una la cajonera a la cabecera y a la piecera por medio de 6 tornillos de 2,5 cm a través; de cajones".; Pagina 5

de los costados de las cajonera y ajustando a los fondos de cabecera y piecera.
Ajuste el modulo ciego al resto de componentes uniendo la faja parrilla F a las fajas

refuerzo atrás por medio de 4 tornillos de 2,5 cm.

Finalmente coloque los cajones en las cajoneras como se explica en la guía de "colocación

Colocación de cajones

Colocar los cajones
sobre las guías fijas
que se encuentran ya
en el mueble, como lo
muestra la imagen.
