infomueblesgacela/muebles-gacela-mvp/public/modelos_3d/linea-clasica/A712152/A712152.PDF

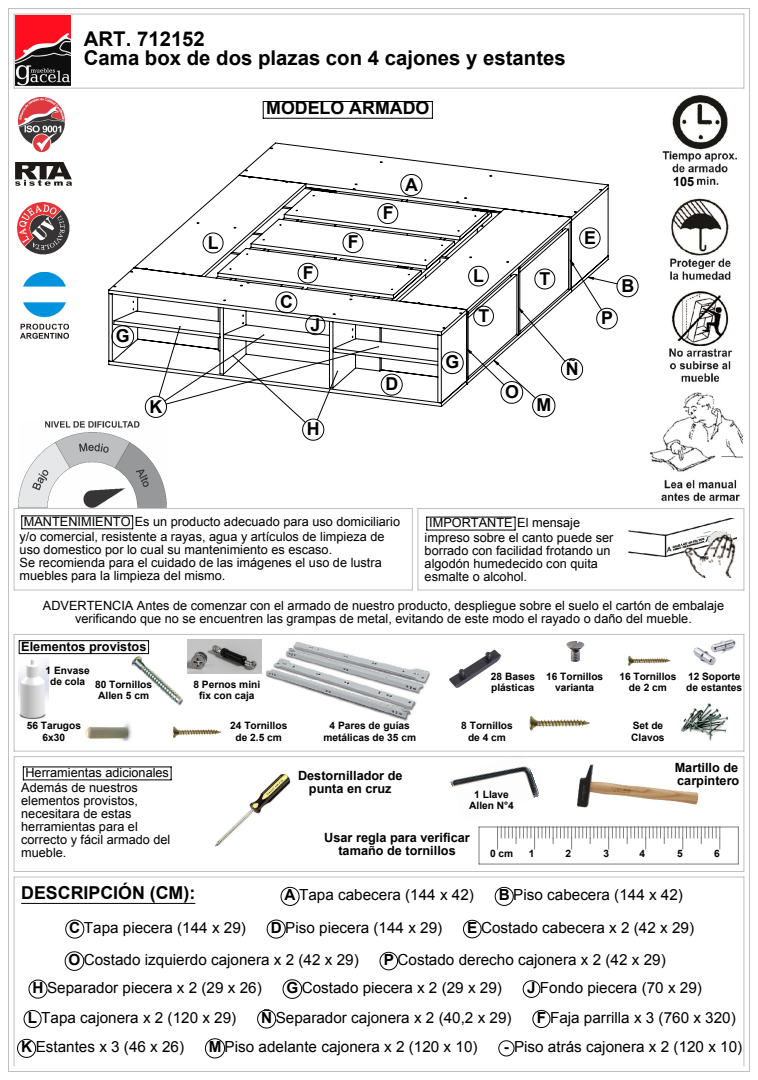
[picture p233: page 1]
O Costado izquierdo cajonera x 2 (42 x 29); P Costado derecho cajonera x 2 (42 x 29); A Tapa cabecera (144 x 42); B Piso cabecera (144 x 42); C Tapa piecera (144 x 29); D Piso piecera (144 x 29); E Costado cabecera x 2 (42 x 29); H Separador piecera x 2 (29 x 26); G Costado piecera x 2 (29 x 29); J Fondo piecera (70 x 29); L Tapa cajonera x 2 (120 x 29); Ñ Separador cajonera x 2 (40,2 x 29); F Faja parrilla x 3 (760 x 320); K Estantes x 3 (46 x 26); M Piso adelante cajonera x 2 (120 x 10)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

ART. 712152
Cama box de dos plazas con 4 cajones y estantes

MANTENIMIENTO Es un producto adecuado para uso domiciliario
y/o comercial, resistente a rayas, agua y artículos de limpieza de
uso domestico por lo cual su mantenimiento es escaso.
Se recomienda para el cuidado de las imágenes el uso de lustra
muebles para la limpieza del mismo.
ADVERTENCIA Antes de comenzar con el armado de nuestro producto, despliegue sobre el suelo el cartón de embalaje
verificando que no se encuentren las grampas de metal, evitando de este modo el rayado o daño del mueble.

IMPORTANTE El mensaje
impreso sobre el canto puede ser
borrado con facilidad frotando un
algodón humedecido con quita
esmalte o alcohol.

Elementos provistos
1 Envase
de cola 80 Tornillos

8 Pernos mini
fix con caja

4 Pares de guías
metálicas de 35 cm

Herramientas adicionales
Además de nuestros
elementos provistos,
necesitara de estas
herramientas para el
correcto y fácil armado del
mueble.
DESCRIPCIÓN (CM):

carpintero Destornillador de
punta en cruz

Usar regla para verificar
tamaño de tornillos

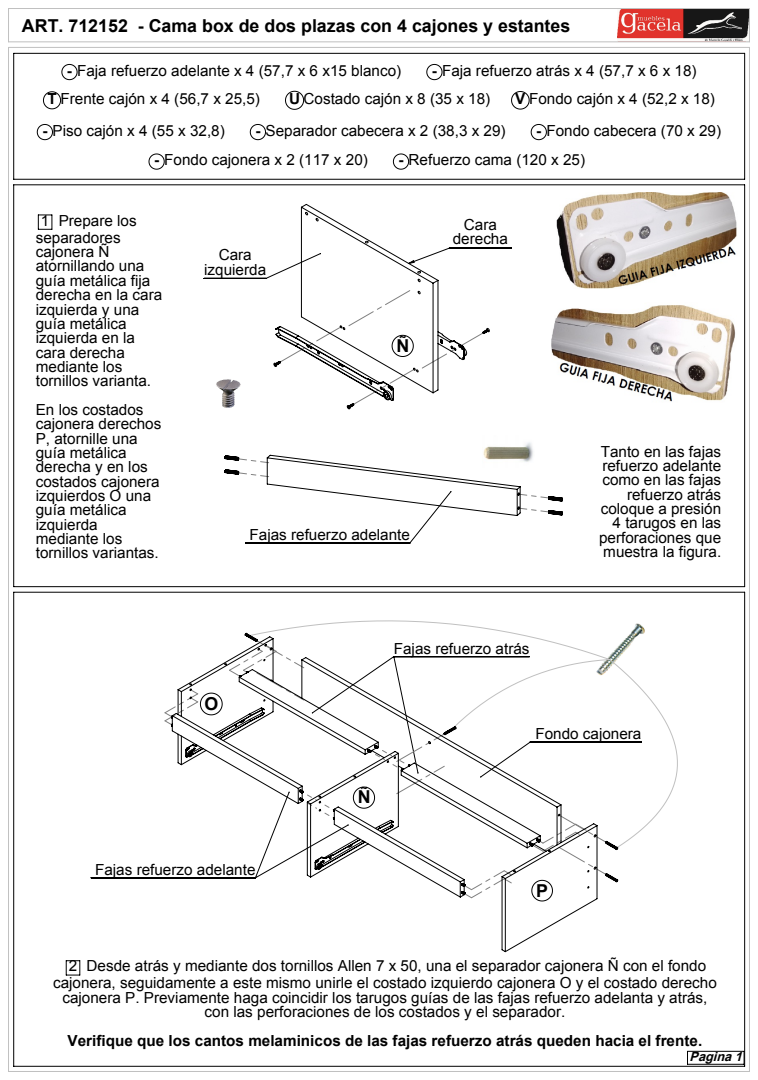
[picture p234: page 2]
Fondo cajonera; - Piso cajón x 4 (55 x 32,8); - Separador cabecera x 2 (38,3 x 29); - Fondo cabecera (70 x 29); T Frente cajón x 4 (56,7 x 25,5); U Costado cajón x 8 (35 x 18); V Fondo cajón x 4 (52,2 x 18); - Fondo cajonera x 2 (117 x 20); - Refuerzo cama (120 x 25); - Faja refuerzo adelante x 4 (57,7 x 6 x15 blanco); - Faja refuerzo atrás x 4 (57,7 x 6 x 18); Pagina 1

ART. 712152 - Cama box de dos plazas con 4 cajones y estantes

1 Prepare los
separadores
cajonera Ñ
atornillando una
guía metálica fija
derecha en la cara
izquierda y una
guía metálica
izquierda en la
cara derecha
mediante los
tornillos varianta.
En los costados
cajonera derechos
P, atornille una
derecha y en los
costados cajonera
izquierdos O una
izquierda
tornillos variantas.

Tanto en las fajas
refuerzo adelante
como en las fajas refuerzo atrás
coloque a presión
4 tarugos en las
perforaciones que
muestra la figura.

Fajas refuerzo adelante

Fajas refuerzo atrás

2 Desde atrás y mediante dos tornillos Allen 7 x 50, una el separador cajonera Ñ con el fondo
cajonera, seguidamente a este mismo unirle el costado izquierdo cajonera O y el costado derecho
cajonera P. Previamente haga coincidir los tarugos guías de las fajas refuerzo adelanta y atrás, con las perforaciones de los costados y el separador.

Verifique que los cantos melaminicos de las fajas refuerzo atrás queden hacia el frente.

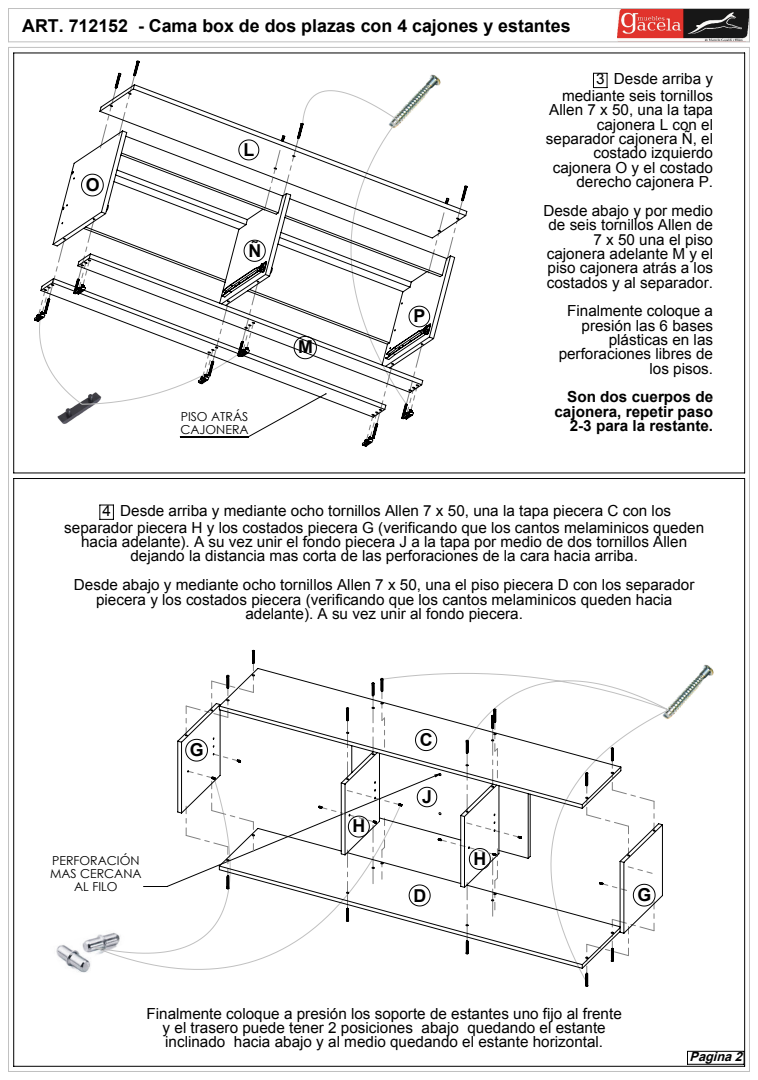
[picture p235: page 3]
MAS CERCANA AL FILO; PISO ATRÁS; Desde arriba y; los pisos.; Desde arriba y mediante ocho tornillos Allen 7 x 50, una la tapa piecera C con los; Pagina 2

mediante seis tornillos
Allen 7 x 50, una la tapa
cajonera L con el separador cajonera Ñ, el
costado izquierdo
cajonera O y el costado
derecho cajonera P.
Desde abajo y por medio
de seis tornillos Allen de
7 x 50 una el piso
cajonera adelante M y el
piso cajonera atrás a los
costados y al separador.
Finalmente coloque a
presión las 6 bases
plásticas en las
perforaciones libres de

Son dos cuerpos de
cajonera, repetir paso
2-3 para la restante.

separador piecera H y los costados piecera G (verificando que los cantos melaminicos queden hacia adelante). A su vez unir el fondo piecera J a la tapa por medio de dos tornillos Allen dejando la distancia mas corta de las perforaciones de la cara hacia arriba.

Desde abajo y mediante ocho tornillos Allen 7 x 50, una el piso piecera D con los separador piecera y los costados piecera (verificando que los cantos melaminicos queden hacia adelante). A su vez unir al fondo piecera.

Finalmente coloque a presión los soporte de estantes uno fijo al frente
y el trasero puede tener 2 posiciones abajo quedando el estante
inclinado hacia abajo y al medio quedando el estante horizontal.

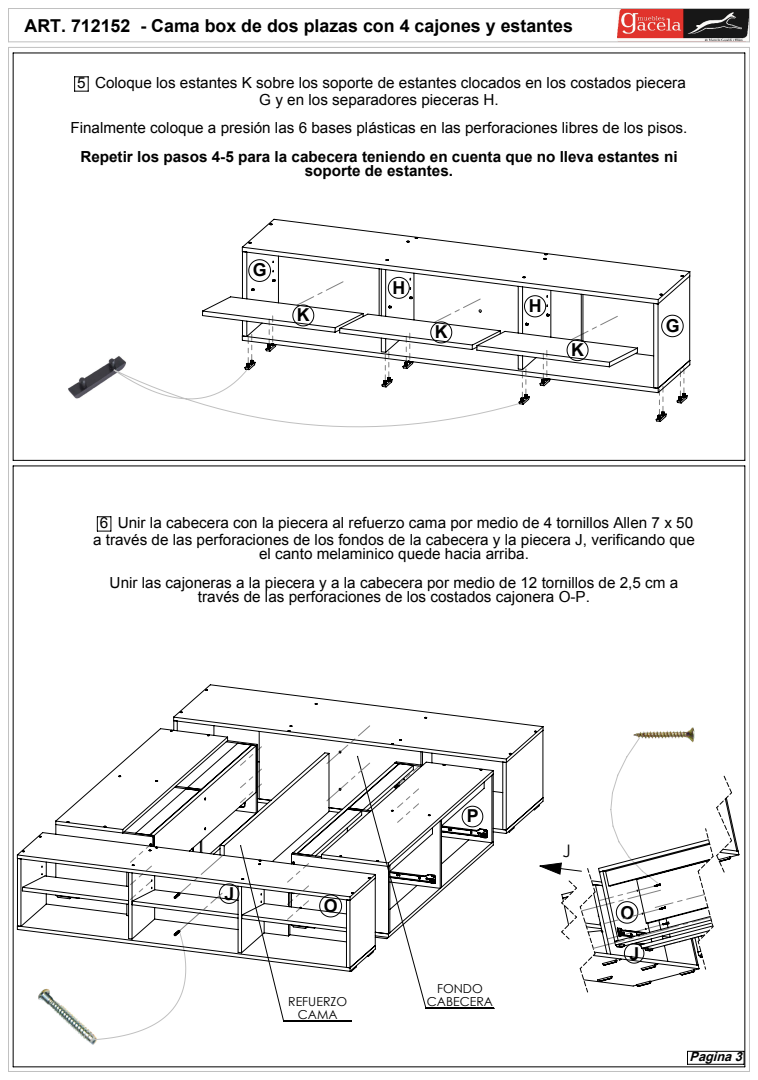
[picture p236: page 4]
Coloque los estantes K sobre los soporte de estantes clocados en los costados piecera; Unir la cabecera con la piecera al refuerzo cama por medio de 4 tornillos Allen 7 x 50; Pagina 3

G y en los separadores pieceras H.

Finalmente coloque a presión las 6 bases plásticas en las perforaciones libres de los pisos.
Repetir los pasos 4-5 para la cabecera teniendo en cuenta que no lleva estantes ni

soporte de estantes.

a través de las perforaciones de los fondos de la cabecera y la piecera J, verificando que

el canto melaminico quede hacia arriba.

Unir las cajoneras a la piecera y a la cabecera por medio de 12 tornillos de 2,5 cm a través de las perforaciones de los costados cajonera O-P.

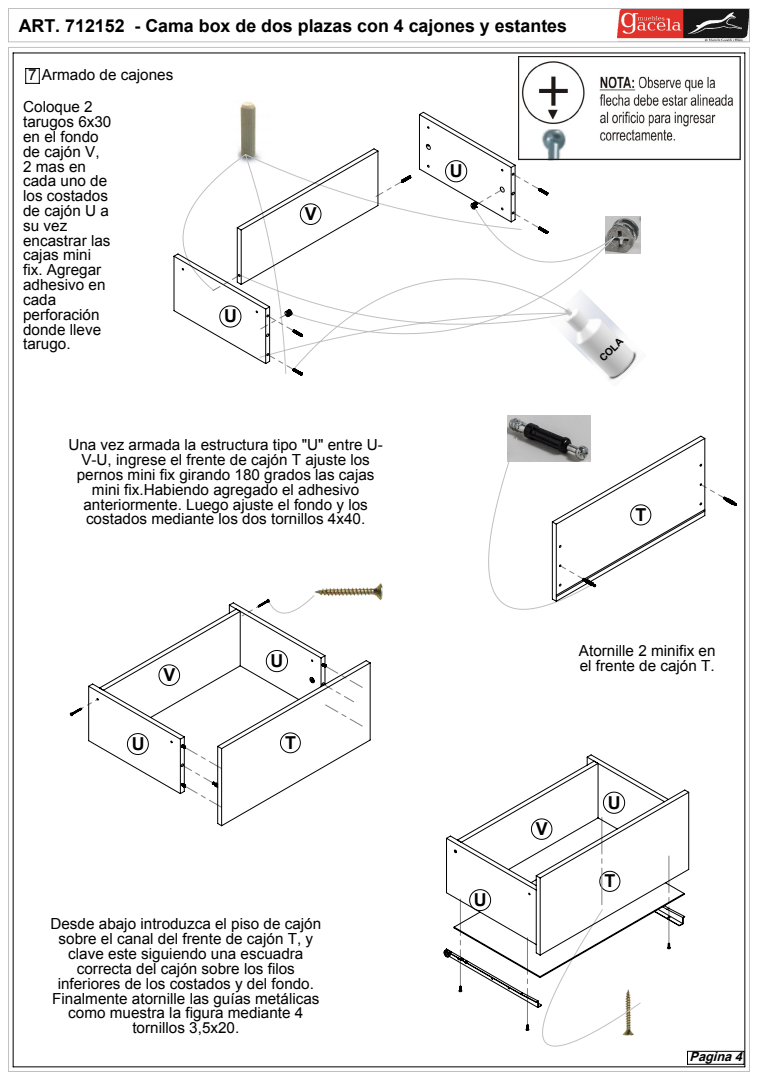
[picture p237: page 5]
tornillos 3,5x20.; Pagina 4

7 Armado de cajones
Coloque 2
tarugos 6x30
en el fondo
de cajón V,
2 mas en
cada uno de
los costados
de cajón U a
su vez
encastrar las
cajas mini
fix. Agregar
adhesivo en
cada
perforación
donde lleve
tarugo.

Una vez armada la estructura tipo "U" entre U-
V-U, ingrese el frente de cajón T ajuste los
pernos mini fix girando 180 grados las cajas
mini fix.Habiendo agregado el adhesivo
anteriormente. Luego ajuste el fondo y los
costados mediante los dos tornillos 4x40.

Atornille 2 minifix en
el frente de cajón T.

Desde abajo introduzca el piso de cajón
sobre el canal del frente de cajón T, y
clave este siguiendo una escuadra
correcta del cajón sobre los filos
inferiores de los costados y del fondo.
Finalmente atornille las guías metálicas
como muestra la figura mediante 4

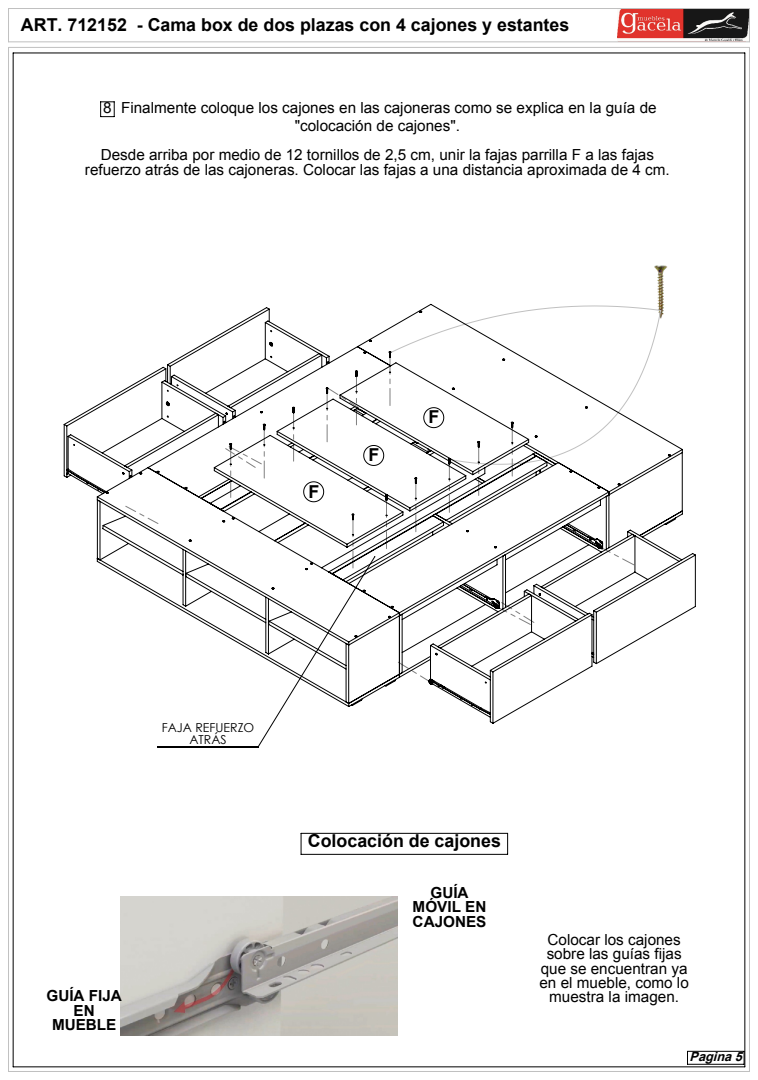
[picture p238: page 6]
FAJA REFUERZO; GUÍA FIJA; MÓVIL EN; Finalmente coloque los cajones en las cajoneras como se explica en la guía de; Pagina 5

"colocación de cajones".

Desde arriba por medio de 12 tornillos de 2,5 cm, unir la fajas parrilla F a las fajas
refuerzo atrás de las cajoneras. Colocar las fajas a una distancia aproximada de 4 cm.

Colocación de cajones

Colocar los cajones
sobre las guías fijas
que se encuentran ya
en el mueble, como lo
muestra la imagen.
