infomueblesgacela/muebles-gacela-mvp/public/modelos_3d/linea-comedores/A005571/A005571.PDF

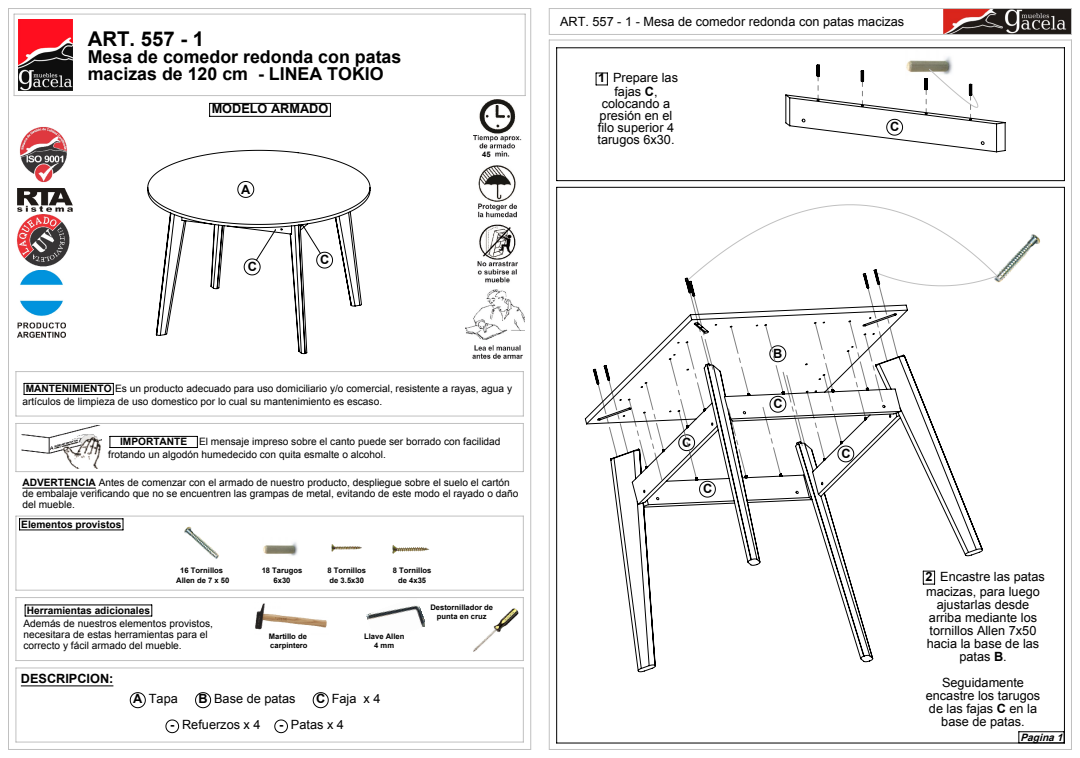
[picture p241: page 1]
A Tapa; B Base de patas; C Faja x 4; - Refuerzos x 4 - Patas x 4; 16 Tornillos Allen de 7 x 50; 18 Tarugos; Martillo de; Pagina 1; MODELO ARMADO; IMPORTANTE; El mensaje impreso sobre el canto puede ser borrado con facilidad; Llave Allen 4 mm; 8 Tornillos de 3.5x30; 8 Tornillos de 4x35

ART. 557 - 1 - Mesa de comedor redonda con patas macizas

ART. 557 - 1
Mesa de comedor redonda con patas
macizas de 120 cm - LINEA TOKIO

1 Prepare las
fajas C, colocando a
presión en el
filo superior 4
tarugos 6x30.

MANTENIMIENTO Es un producto adecuado para uso domiciliario y/o comercial, resistente a rayas, agua y
artículos de limpieza de uso domestico por lo cual su mantenimiento es escaso.

frotando un algodón humedecido con quita esmalte o alcohol.

ADVERTENCIA Antes de comenzar con el armado de nuestro producto, despliegue sobre el suelo el cartón
de embalaje verificando que no se encuentren las grampas de metal, evitando de este modo el rayado o daño
del mueble.
Elementos provistos

2 Encastre las patas
macizas, para luego
ajustarlas desde
arriba mediante los
tornillos Allen 7x50
hacia la base de las
patas B.
Seguidamente
encastre los tarugos
de las fajas C en la
base de patas.

Herramientas adicionales
Además de nuestros elementos provistos,
necesitara de estas herramientas para el
correcto y fácil armado del mueble.
DESCRIPCION:

Destornillador de
punta en cruz

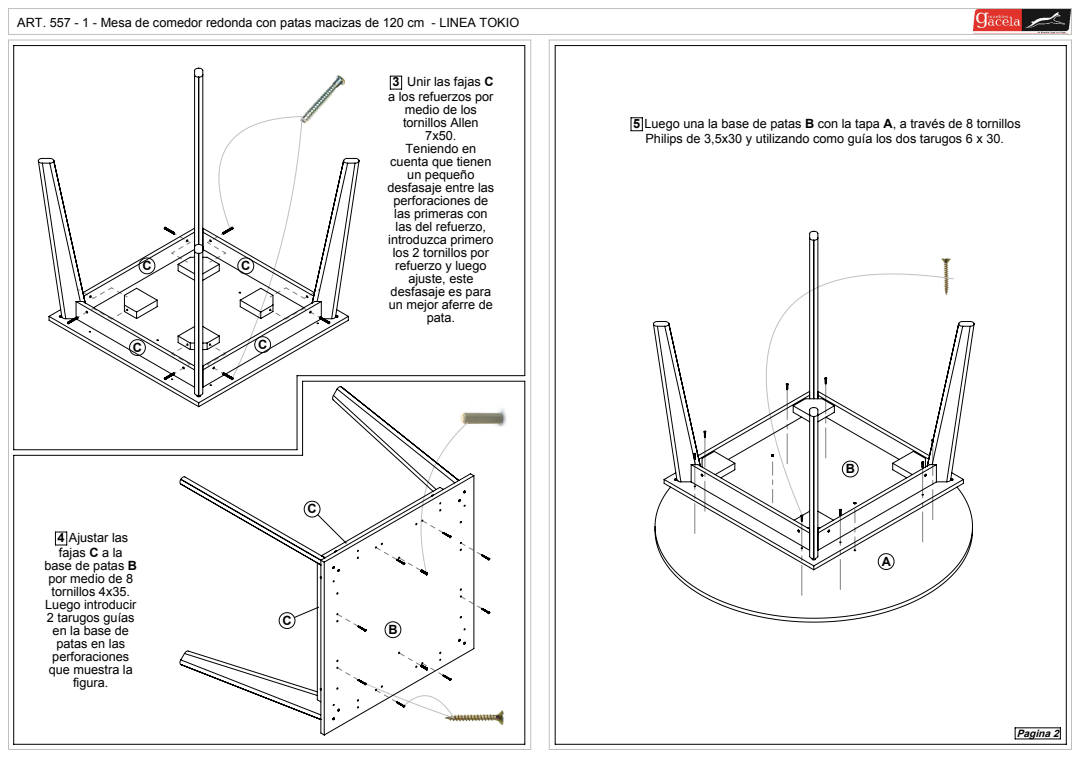
[picture p242: page 2]
Pagina 2

ART. 557 - 1 - Mesa de comedor redonda con patas macizas de 120 cm - LINEA TOKIO

3 Unir las fajas C
a los refuerzos por
medio de los
tornillos Allen
Teniendo en
cuenta que tienen
un pequeño
desfasaje entre las
perforaciones de
las primeras con
las del refuerzo,
introduzca primero
los 2 tornillos por
refuerzo y luego
ajuste, este
desfasaje es para
un mejor aferre de
pata.

5 Luego una la base de patas B con la tapa A, a través de 8 tornillos
Philips de 3,5x30 y utilizando como guía los dos tarugos 6 x 30.

4 Ajustar las
fajas C a la
base de patas B
por medio de 8
tornillos 4x35.
Luego introducir
2 tarugos guías
en la base de
patas en las
perforaciones
que muestra la
figura.
