infomueblesgacela/muebles-gacela-mvp/public/modelos_3d/linea-comedores/A005572/A005572.PDF

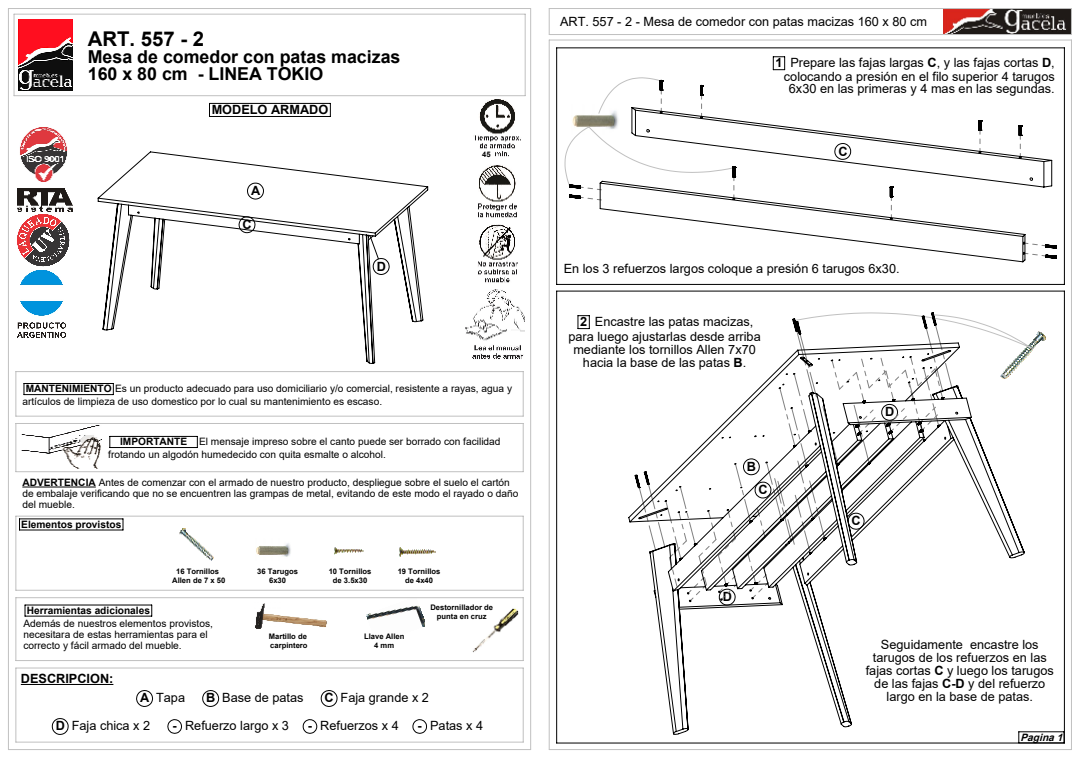
[picture p243: page 1]
A Tapa; B Base de patas; C Faja grande x 2; D Faja chica x 2; - Refuerzo largo x 3 - Refuerzos x 4 - Patas x 4; 16 Tornillos Allen de 7 x 50; 36 Tarugos; Martillo de; Pagina 1; MODELO ARMADO; IMPORTANTE; El mensaje impreso sobre el canto puede ser borrado con facilidad; Llave Allen 4 mm; 10 Tornillos de 3.5x30; 19 Tornillos de 4x40

ART. 557 - 2 - Mesa de comedor con patas macizas 160 x 80 cm

ART. 557 - 2
Mesa de comedor con patas macizas
160 x 80 cm - LINEA TOKIO

1 Prepare las fajas largas C, y las fajas cortas D,
colocando a presión en el filo superior 4 tarugos
6x30 en las primeras y 4 mas en las segundas.

En los 3 refuerzos largos coloque a presión 6 tarugos 6x30.

2 Encastre las patas macizas,
para luego ajustarlas desde arriba
mediante los tornillos Allen 7x70
hacia la base de las patas B.

MANTENIMIENTO Es un producto adecuado para uso domiciliario y/o comercial, resistente a rayas, agua y
artículos de limpieza de uso domestico por lo cual su mantenimiento es escaso.

frotando un algodón humedecido con quita esmalte o alcohol.

ADVERTENCIA Antes de comenzar con el armado de nuestro producto, despliegue sobre el suelo el cartón
de embalaje verificando que no se encuentren las grampas de metal, evitando de este modo el rayado o daño
del mueble.
Elementos provistos

Herramientas adicionales
Además de nuestros elementos provistos,
necesitara de estas herramientas para el
correcto y fácil armado del mueble.
DESCRIPCION:

Destornillador de
punta en cruz

Seguidamente encastre los
tarugos de los refuerzos en las
fajas cortas C y luego los tarugos
de las fajas C-D y del refuerzo
largo en la base de patas.

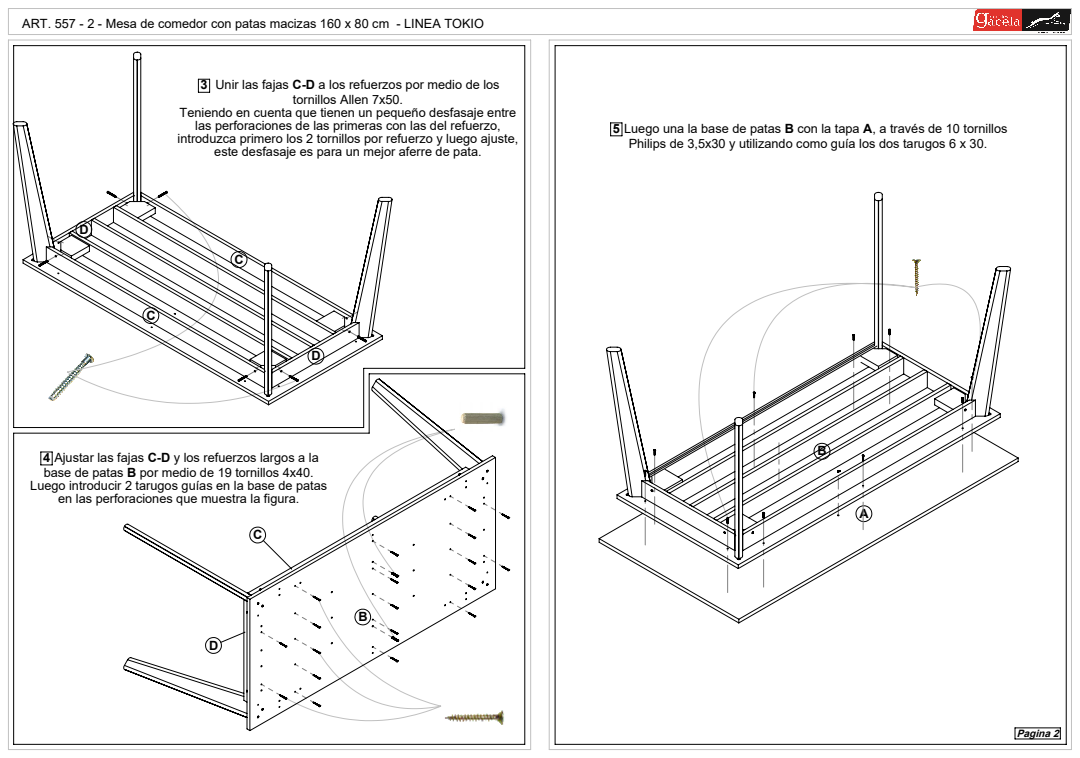
[picture p244: page 2]
tornillos Allen 7x50.; Pagina 2

ART. 557 - 2 - Mesa de comedor con patas macizas 160 x 80 cm - LINEA TOKIO

3 Unir las fajas C-D a los refuerzos por medio de los
Teniendo en cuenta que tienen un pequeño desfasaje entre
las perforaciones de las primeras con las del refuerzo,
introduzca primero los 2 tornillos por refuerzo y luego ajuste,
este desfasaje es para un mejor aferre de pata.

5 Luego una la base de patas B con la tapa A, a través de 10 tornillos
Philips de 3,5x30 y utilizando como guía los dos tarugos 6 x 30.

4 Ajustar las fajas C-D y los refuerzos largos a la
base de patas B por medio de 19 tornillos 4x40.
Luego introducir 2 tarugos guías en la base de patas
en las perforaciones que muestra la figura.
