infomueblesgacela/muebles-gacela-mvp/public/modelos_3d/linea-curvalba/A334271/A334271.PDF

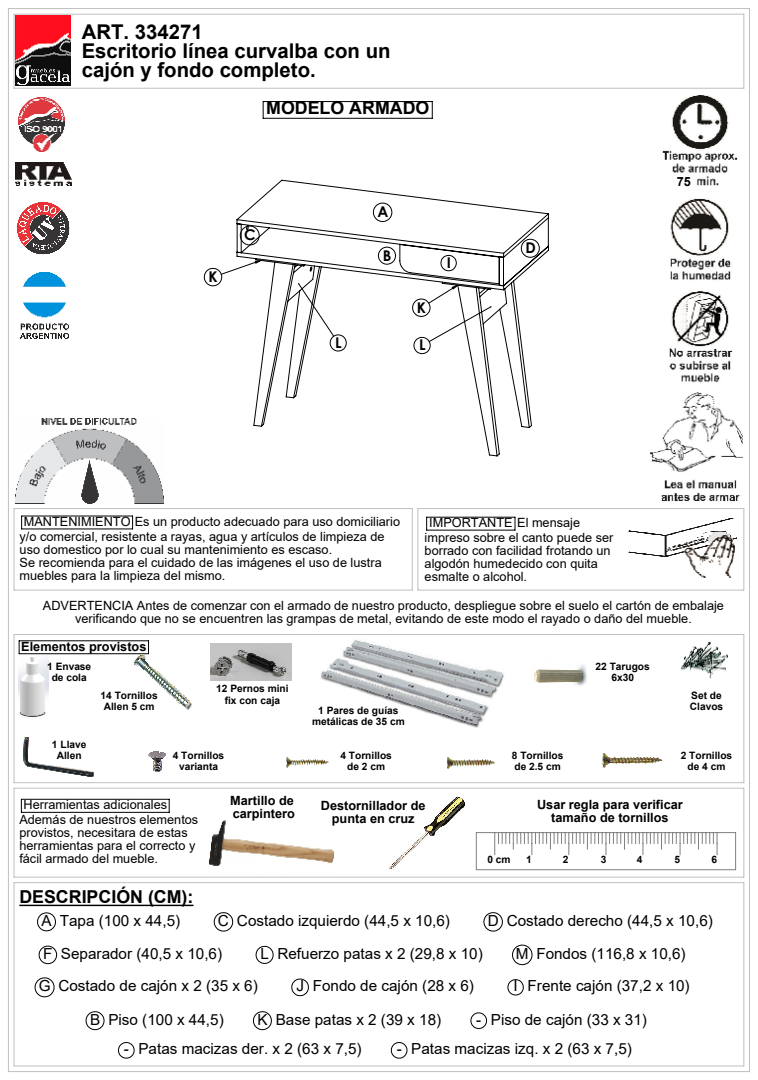
[picture p249: page 1]
B Piso (100 x 44,5); K Base patas x 2 (39 x 18); - Piso de cajón (33 x 31); G Costado de cajón x 2 (35 x 6); J Fondo de cajón (28 x 6); I Frente cajón (37,2 x 10); F Separador (40,5 x 10,6); L Refuerzo patas x 2 (29,8 x 10); M Fondos (116,8 x 10,6); - Patas macizas der. x 2 (63 x 7,5); - Patas macizas izq. x 2 (63 x 7,5); A Tapa (100 x 44,5); C Costado izquierdo (44,5 x 10,6); D Costado derecho (44,5 x 10,6); 1 Llave; Allen; 4 Tornillos; 22 Tarugos; Set de; Martillo de; carpintero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

ART. 334271
Escritorio línea curvalba con un
cajón y fondo completo.

MANTENIMIENTO Es un producto adecuado para uso domiciliario
y/o comercial, resistente a rayas, agua y artículos de limpieza de
uso domestico por lo cual su mantenimiento es escaso.
Se recomienda para el cuidado de las imágenes el uso de lustra
muebles para la limpieza del mismo.
ADVERTENCIA Antes de comenzar con el armado de nuestro producto, despliegue sobre el suelo el cartón de embalaje
verificando que no se encuentren las grampas de metal, evitando de este modo el rayado o daño del mueble.
Elementos provistos
1 Envase
de cola

IMPORTANTE El mensaje
impreso sobre el canto puede ser
borrado con facilidad frotando un
algodón humedecido con quita
esmalte o alcohol.

12 Pernos mini
fix con caja

1 Pares de guías
metálicas de 35 cm

Herramientas adicionales
Además de nuestros elementos
provistos, necesitara de estas
herramientas para el correcto y
fácil armado del mueble.
DESCRIPCIÓN (CM):

Usar regla para verificar

punta en cruz tamaño de tornillos

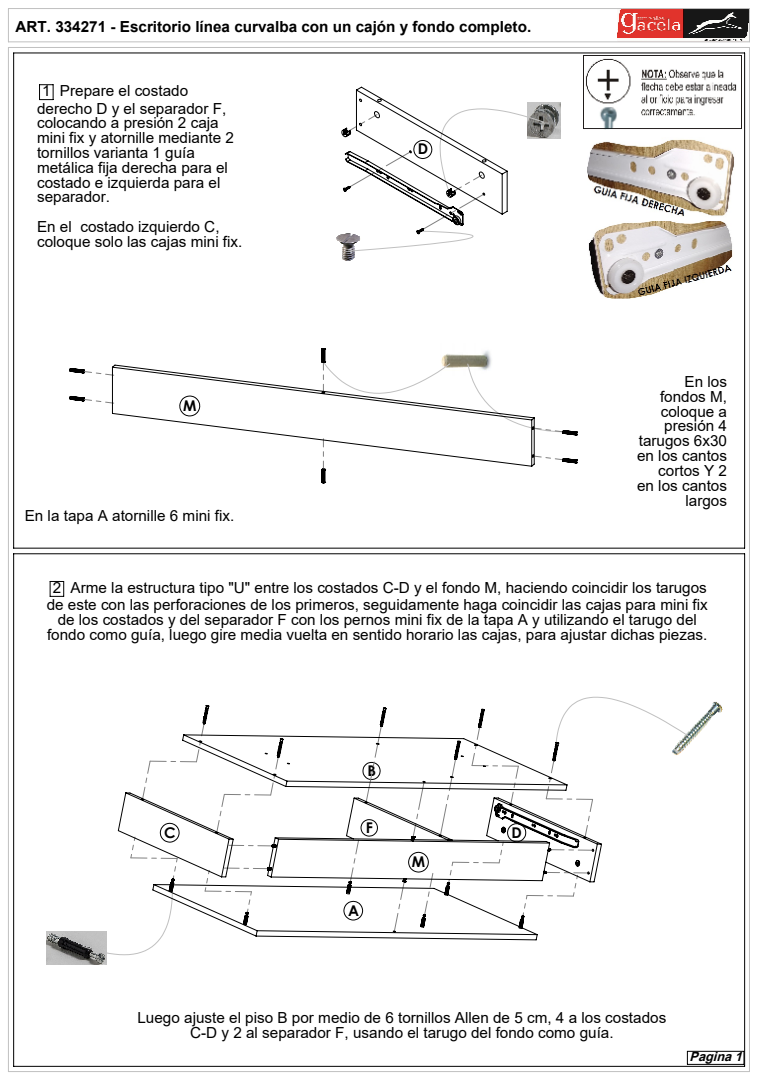
[picture p250: page 2]
Prepare el costado; Arme la estructura tipo "U" entre los costados C-D y el fondo M, haciendo coincidir los tarugos; Pagina 1

ART. 334271 - Escritorio línea curvalba con un cajón y fondo completo.

derecho D y el separador F,
colocando a presión 2 caja
mini fix y atornille mediante 2
tornillos varianta 1 guía
metálica fija derecha para el
costado e izquierda para el
separador.
En el costado izquierdo C,
coloque solo las cajas mini fix.

En los
fondos M,
coloque a
presión 4
tarugos 6x30
en los cantos
cortos Y 2
largos

En la tapa A atornille 6 mini fix.

de este con las perforaciones de los primeros, seguidamente haga coincidir las cajas para mini fix
de los costados y del separador F con los pernos mini fix de la tapa A y utilizando el tarugo del
fondo como guía, luego gire media vuelta en sentido horario las cajas, para ajustar dichas piezas.

Luego ajuste el piso B por medio de 6 tornillos Allen de 5 cm, 4 a los costados
C-D y 2 al separador F, usando el tarugo del fondo como guía.

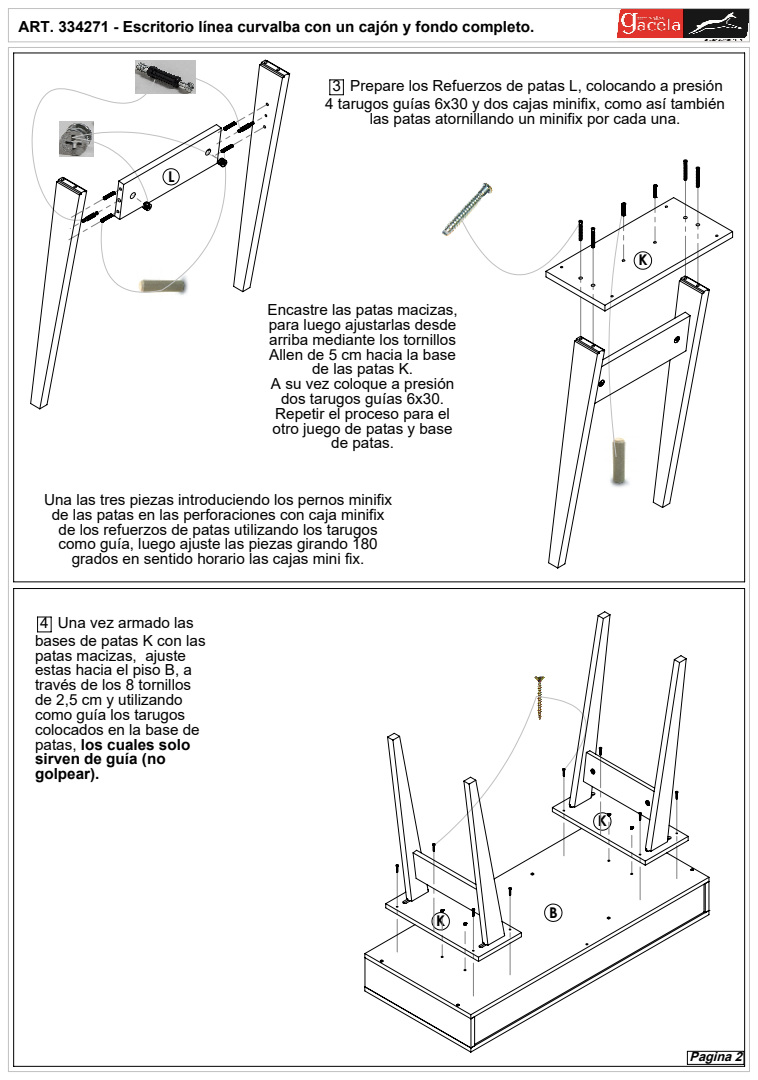
[picture p251: page 3]
Prepare los Refuerzos de patas L, colocando a presión; Una vez armado las; Pagina 2

4 tarugos guías 6x30 y dos cajas minifix, como así también
las patas atornillando un minifix por cada una.

Encastre las patas macizas,
para luego ajustarlas desde
arriba mediante los tornillos
Allen de 5 cm hacia la base
de las patas K.
A su vez coloque a presión
dos tarugos guías 6x30.
Repetir el proceso para el
otro juego de patas y base
de patas.

Una las tres piezas introduciendo los pernos minifix
de las patas en las perforaciones con caja minifix
de los refuerzos de patas utilizando los tarugos
como guía, luego ajuste las piezas girando 180
grados en sentido horario las cajas mini fix.

bases de patas K con las
patas macizas, ajuste
estas hacia el piso B, a
través de los 8 tornillos
de 2,5 cm y utilizando
como guía los tarugos
colocados en la base de
patas, los cuales solo
sirven de guía (no
golpear).

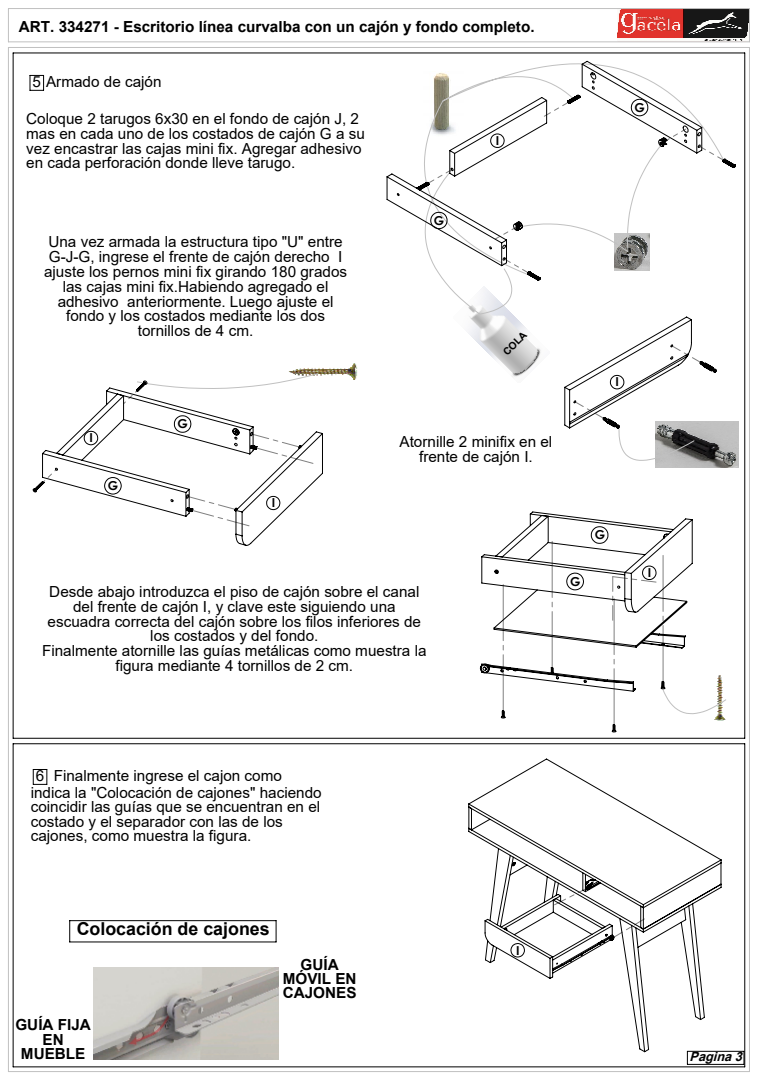
[picture p252: page 4]
Finalmente ingrese el cajon como; GUÍA FIJA; MÓVIL EN; Pagina 3

5 Armado de cajón
Coloque 2 tarugos 6x30 en el fondo de cajón J, 2
mas en cada uno de los costados de cajón G a su
vez encastrar las cajas mini fix. Agregar adhesivo
en cada perforación donde lleve tarugo.

Una vez armada la estructura tipo "U" entre
G-J-G, ingrese el frente de cajón derecho I
ajuste los pernos mini fix girando 180 grados
las cajas mini fix.Habiendo agregado el
adhesivo anteriormente. Luego ajuste el
fondo y los costados mediante los dos

tornillos de 4 cm.

Atornille 2 minifix en el
frente de cajón I.

Desde abajo introduzca el piso de cajón sobre el canal
del frente de cajón I, y clave este siguiendo una
escuadra correcta del cajón sobre los filos inferiores de
Finalmente atornille las guías metálicas como muestra la

los costados y del fondo.
figura mediante 4 tornillos de 2 cm.

indica la "Colocación de cajones" haciendo
coincidir las guías que se encuentran en el
costado y el separador con las de los
cajones, como muestra la figura.

Colocación de cajones
