infomueblesgacela/muebles-gacela-mvp/public/modelos_3d/linea-curvalba/A334272/A334272.PDF

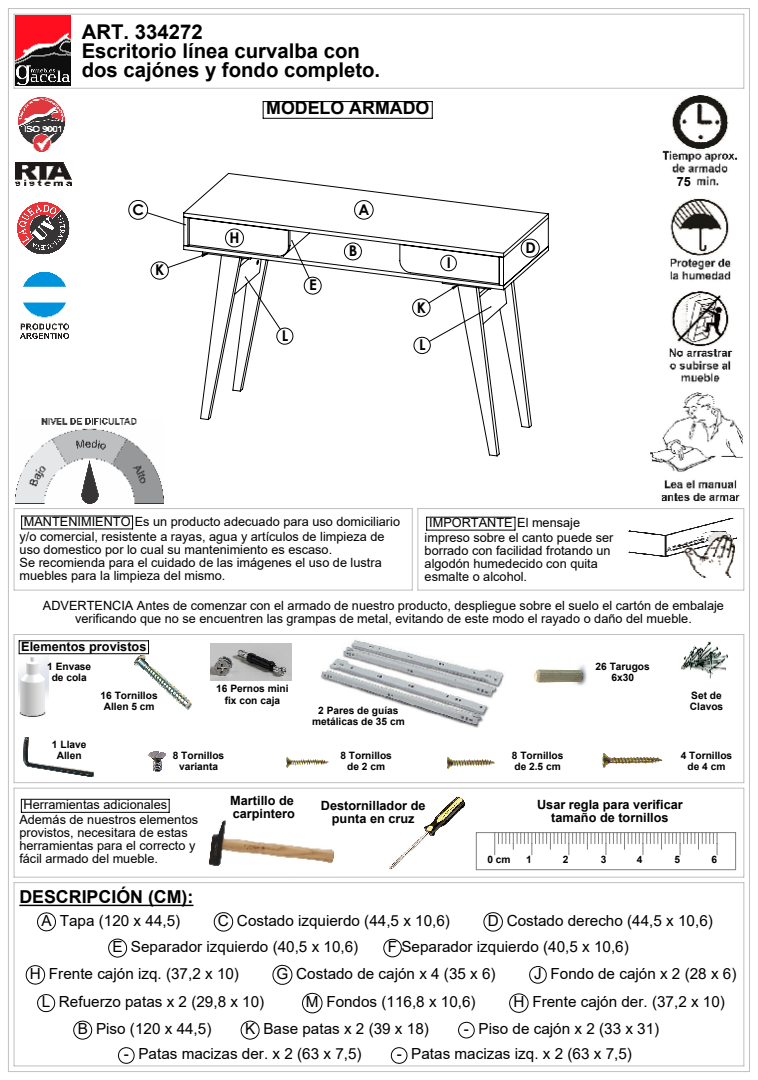
[picture p253: page 1]
B Piso (120 x 44,5); K Base patas x 2 (39 x 18); - Piso de cajón x 2 (33 x 31); H Frente cajón izq. (37,2 x 10); G Costado de cajón x 4 (35 x 6); J Fondo de cajón x 2 (28 x 6); E Separador izquierdo (40,5 x 10,6); F Separador izquierdo (40,5 x 10,6); - Patas macizas der. x 2 (63 x 7,5); - Patas macizas izq. x 2 (63 x 7,5); L Refuerzo patas x 2 (29,8 x 10); M Fondos (116,8 x 10,6); H Frente cajón der. (37,2 x 10); A Tapa (120 x 44,5); C Costado izquierdo (44,5 x 10,6)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

ART. 334272
Escritorio línea curvalba con
dos cajónes y fondo completo.

MANTENIMIENTO Es un producto adecuado para uso domiciliario
y/o comercial, resistente a rayas, agua y artículos de limpieza de
uso domestico por lo cual su mantenimiento es escaso.
Se recomienda para el cuidado de las imágenes el uso de lustra
muebles para la limpieza del mismo.
ADVERTENCIA Antes de comenzar con el armado de nuestro producto, despliegue sobre el suelo el cartón de embalaje
verificando que no se encuentren las grampas de metal, evitando de este modo el rayado o daño del mueble.
Elementos provistos
1 Envase
de cola

IMPORTANTE El mensaje
impreso sobre el canto puede ser
borrado con facilidad frotando un
algodón humedecido con quita
esmalte o alcohol.

16 Pernos mini
fix con caja

2 Pares de guías
metálicas de 35 cm

Herramientas adicionales
Además de nuestros elementos
provistos, necesitara de estas
herramientas para el correcto y
fácil armado del mueble.
DESCRIPCIÓN (CM):

Usar regla para verificar

punta en cruz tamaño de tornillos

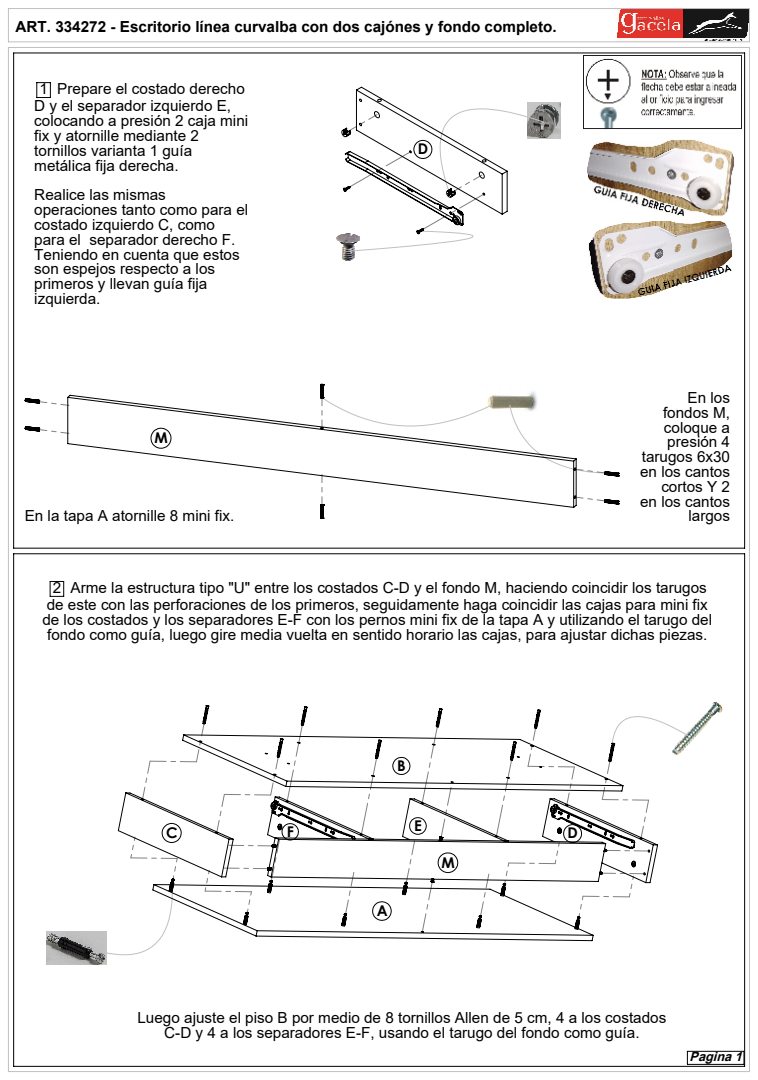
[picture p254: page 2]
Prepare el costado derecho; Arme la estructura tipo "U" entre los costados C-D y el fondo M, haciendo coincidir los tarugos; Pagina 1

ART. 334272 - Escritorio línea curvalba con dos cajónes y fondo completo.

D y el separador izquierdo E,
colocando a presión 2 caja mini
fix y atornille mediante 2
tornillos varianta 1 guía
metálica fija derecha.
Realice las mismas
operaciones tanto como para el
costado izquierdo C, como
para el separador derecho F.
Teniendo en cuenta que estos
son espejos respecto a los
primeros y llevan guía fija
izquierda.

En los
fondos M,
coloque a
presión 4
tarugos 6x30
en los cantos
cortos Y 2
largos

En la tapa A atornille 8 mini fix.

de este con las perforaciones de los primeros, seguidamente haga coincidir las cajas para mini fix
de los costados y los separadores E-F con los pernos mini fix de la tapa A y utilizando el tarugo del
fondo como guía, luego gire media vuelta en sentido horario las cajas, para ajustar dichas piezas.

Luego ajuste el piso B por medio de 8 tornillos Allen de 5 cm, 4 a los costados
C-D y 4 a los separadores E-F, usando el tarugo del fondo como guía.

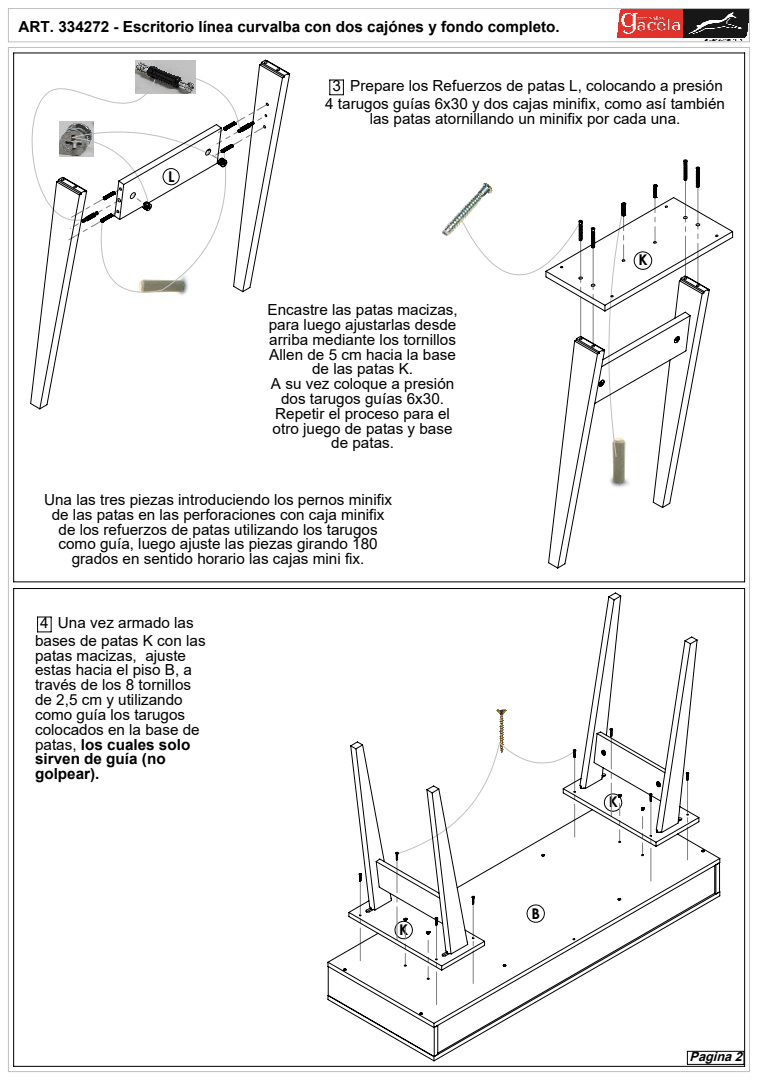
[picture p255: page 3]
Prepare los Refuerzos de patas L, colocando a presión; Una vez armado las; Pagina 2

4 tarugos guías 6x30 y dos cajas minifix, como así también
las patas atornillando un minifix por cada una.

Encastre las patas macizas,
para luego ajustarlas desde
arriba mediante los tornillos
Allen de 5 cm hacia la base
de las patas K.
A su vez coloque a presión
dos tarugos guías 6x30.
Repetir el proceso para el
otro juego de patas y base
de patas.

Una las tres piezas introduciendo los pernos minifix
de las patas en las perforaciones con caja minifix
de los refuerzos de patas utilizando los tarugos
como guía, luego ajuste las piezas girando 180
grados en sentido horario las cajas mini fix.

bases de patas K con las
patas macizas, ajuste
estas hacia el piso B, a
través de los 8 tornillos
de 2,5 cm y utilizando
como guía los tarugos
colocados en la base de
patas, los cuales solo
sirven de guía (no
golpear).

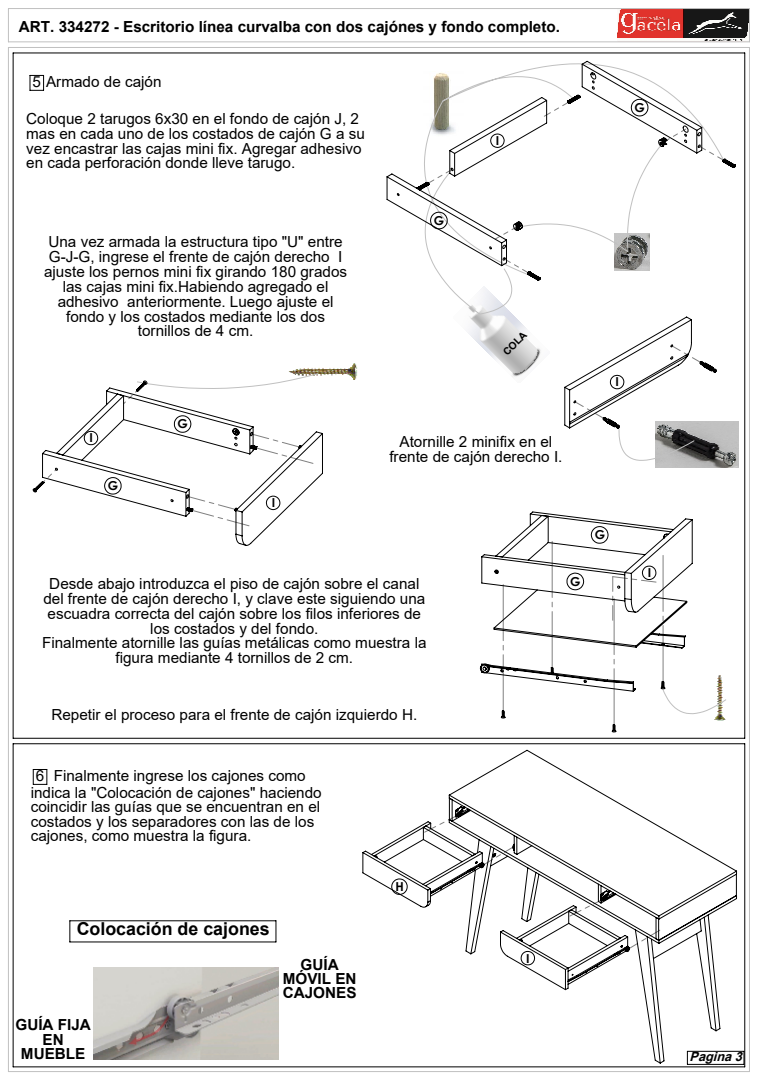
[picture p256: page 4]
Finalmente ingrese los cajones como; GUÍA FIJA; MÓVIL EN; Pagina 3

5 Armado de cajón
Coloque 2 tarugos 6x30 en el fondo de cajón J, 2
mas en cada uno de los costados de cajón G a su
vez encastrar las cajas mini fix. Agregar adhesivo
en cada perforación donde lleve tarugo.

Una vez armada la estructura tipo "U" entre
G-J-G, ingrese el frente de cajón derecho I
ajuste los pernos mini fix girando 180 grados
las cajas mini fix.Habiendo agregado el
adhesivo anteriormente. Luego ajuste el
fondo y los costados mediante los dos

tornillos de 4 cm.

Atornille 2 minifix en el
frente de cajón derecho I.

Desde abajo introduzca el piso de cajón sobre el canal
del frente de cajón derecho I, y clave este siguiendo una
escuadra correcta del cajón sobre los filos inferiores de
Finalmente atornille las guías metálicas como muestra la

los costados y del fondo.
figura mediante 4 tornillos de 2 cm.

Repetir el proceso para el frente de cajón izquierdo H.

indica la "Colocación de cajones" haciendo
coincidir las guías que se encuentran en el
costados y los separadores con las de los
cajones, como muestra la figura.

Colocación de cajones
