infomueblesgacela/muebles-gacela-mvp/public/modelos_3d/linea-curvalba/A353270/A353270.PDF

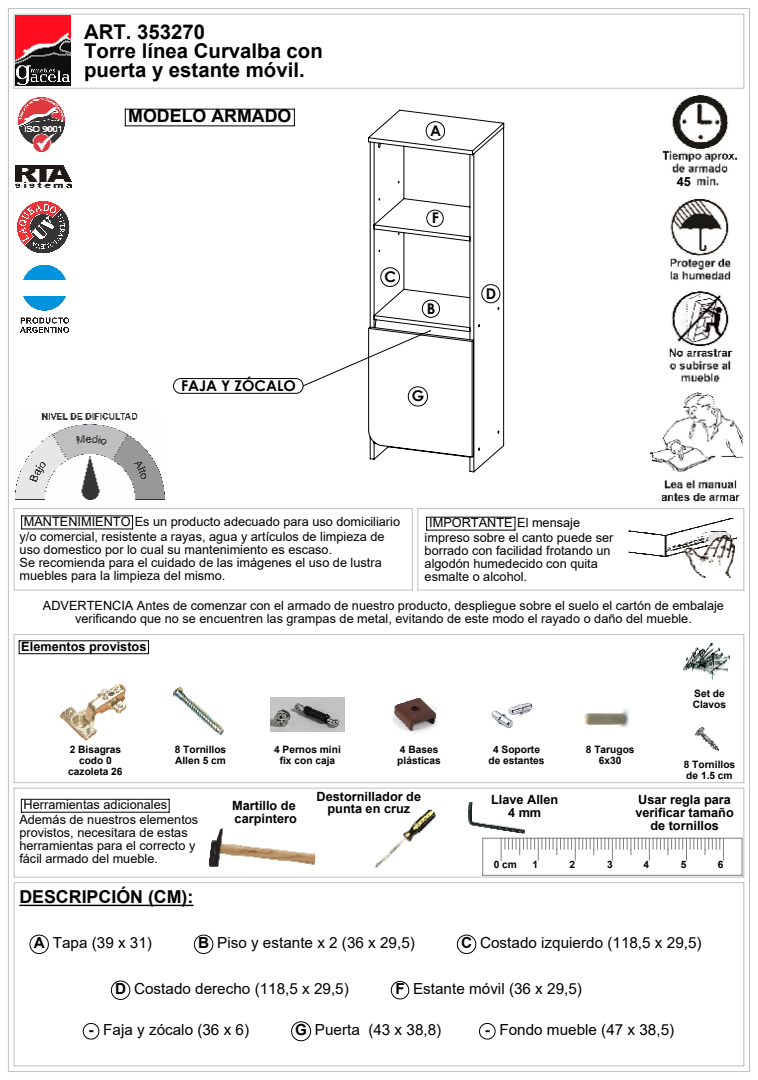
[picture p257: page 1]
FAJA Y ZÓCALO; A Tapa (39 x 31); B Piso y estante x 2 (36 x 29,5); C Costado izquierdo (118,5 x 29,5); D Costado derecho (118,5 x 29,5); F Estante móvil (36 x 29,5); - Faja y zócalo (36 x 6); G Puerta (43 x 38,8); - Fondo mueble (47 x 38,5); Llave Allen 4 mm; 8 Tarugos; Set de; Martillo de; 4 Bases; 8 Tornillos; Allen 5 cm; 4 Soporte de estantes

ART. 353270
Torre línea Curvalba con
puerta y estante móvil.
MODELO ARMADO

MANTENIMIENTO Es un producto adecuado para uso domiciliario
y/o comercial, resistente a rayas, agua y artículos de limpieza de
uso domestico por lo cual su mantenimiento es escaso.
Se recomienda para el cuidado de las imágenes el uso de lustra
muebles para la limpieza del mismo.
ADVERTENCIA Antes de comenzar con el armado de nuestro producto, despliegue sobre el suelo el cartón de embalaje
verificando que no se encuentren las grampas de metal, evitando de este modo el rayado o daño del mueble.
Elementos provistos

IMPORTANTE El mensaje
impreso sobre el canto puede ser
borrado con facilidad frotando un
algodón humedecido con quita
esmalte o alcohol.

2 Bisagras
codo 0
cazoleta 26
Herramientas adicionales
Además de nuestros elementos
provistos, necesitara de estas
herramientas para el correcto y
fácil armado del mueble.
DESCRIPCIÓN (CM):

4 Pernos mini
fix con caja
Destornillador de
punta en cruz

Usar regla para
verificar tamaño
de tornillos

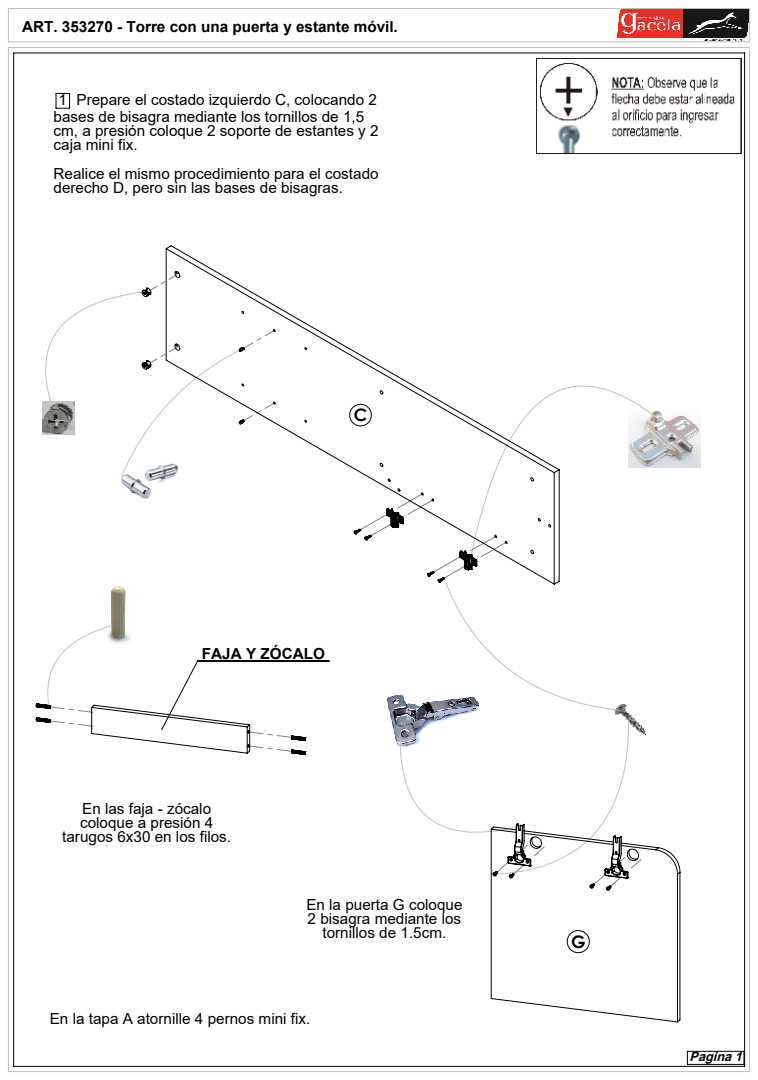
[picture p258: page 2]
FAJA Y ZÓCALO; Prepare el costado izquierdo C, colocando 2; Pagina 1

ART. 353270 - Torre con una puerta y estante móvil.

bases de bisagra mediante los tornillos de 1,5
cm, a presión coloque 2 soporte de estantes y 2
caja mini fix.
Realice el mismo procedimiento para el costado
derecho D, pero sin las bases de bisagras.

En las faja - zócalo
coloque a presión 4
tarugos 6x30 en los filos.

En la puerta G coloque
2 bisagra mediante los
tornillos de 1.5cm.

En la tapa A atornille 4 pernos mini fix.

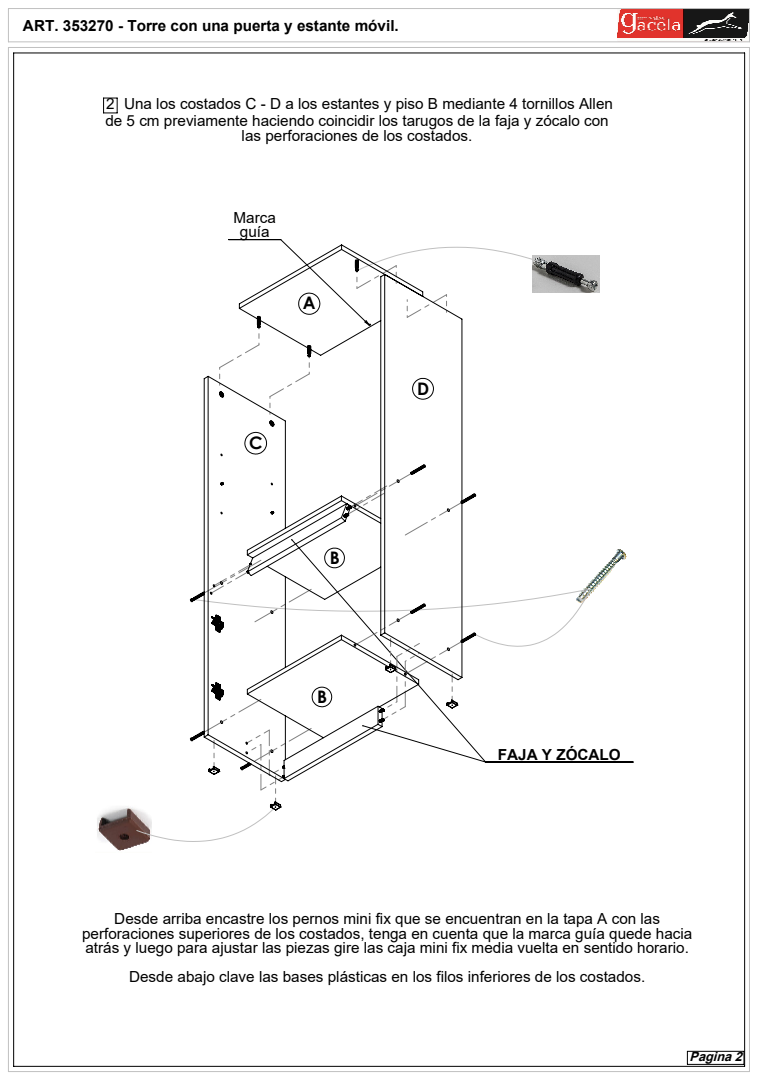
[picture p259: page 3]
FAJA Y ZÓCALO; Pagina 2

2 Una los costados C - D a los estantes y piso B mediante 4 tornillos Allen
de 5 cm previamente haciendo coincidir los tarugos de la faja y zócalo con las perforaciones de los costados.

Desde arriba encastre los pernos mini fix que se encuentran en la tapa A con las
perforaciones superiores de los costados, tenga en cuenta que la marca guía quede hacia
atrás y luego para ajustar las piezas gire las caja mini fix media vuelta en sentido horario.
Desde abajo clave las bases plásticas en los filos inferiores de los costados.

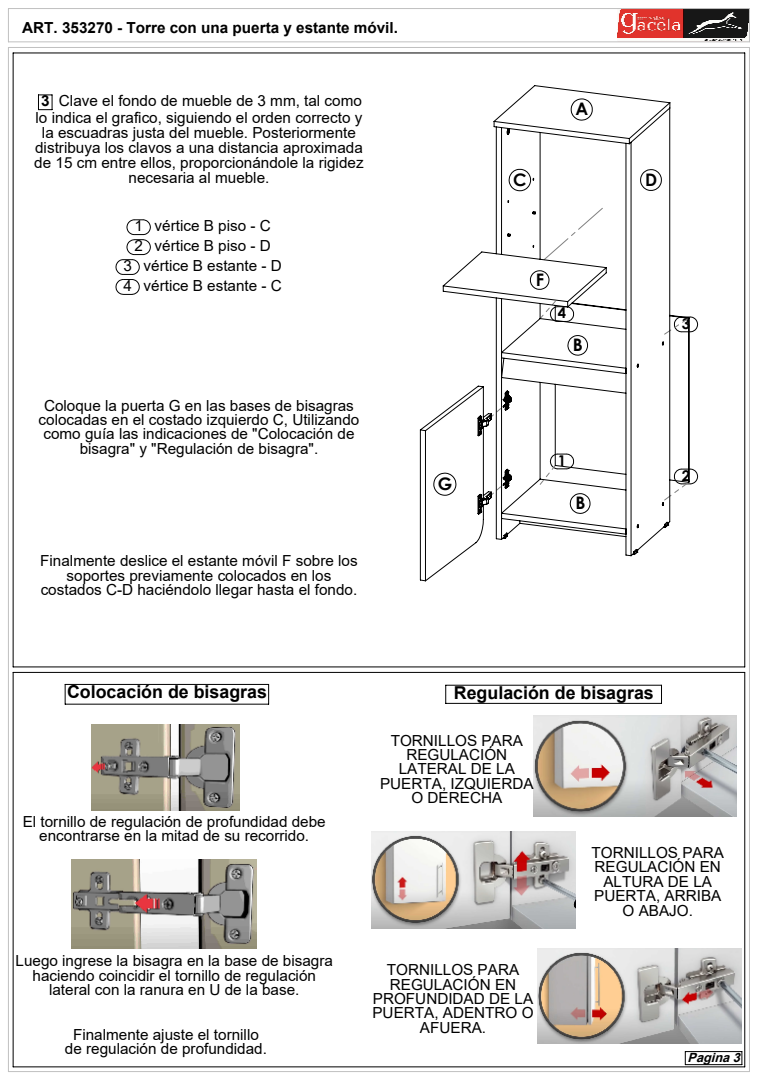
[picture p260: page 4]
1 vértice B piso - C 2 vértice B piso - D 3 vértice B estante - D 4 vértice B estante - C; Pagina 3

3 Clave el fondo de mueble de 3 mm, tal como
lo indica el grafico, siguiendo el orden correcto y
la escuadras justa del mueble. Posteriormente
distribuya los clavos a una distancia aproximada
de 15 cm entre ellos, proporcionándole la rigidez

necesaria al mueble.

Coloque la puerta G en las bases de bisagras
colocadas en el costado izquierdo C, Utilizando
como guía las indicaciones de "Colocación de bisagra" y "Regulación de bisagra".

Finalmente deslice el estante móvil F sobre los
soportes previamente colocados en los
costados C-D haciéndolo llegar hasta el fondo.

Colocación de bisagras

Regulación de bisagras

TORNILLOS PARA
REGULACIÓN
LATERAL DE LA
PUERTA, IZQUIERDA
O DERECHA

El tornillo de regulación de profundidad debe
encontrarse en la mitad de su recorrido.

REGULACIÓN EN
ALTURA DE LA
PUERTA, ARRIBA
O ABAJO.

Luego ingrese la bisagra en la base de bisagra
haciendo coincidir el tornillo de regulación
lateral con la ranura en U de la base.

PROFUNDIDAD DE LA
PUERTA, ADENTRO O
AFUERA.

Finalmente ajuste el tornillo
de regulación de profundidad.
