infomueblesgacela/muebles-gacela-mvp/public/modelos_3d/linea-curvalba/A372150/A372150.PDF

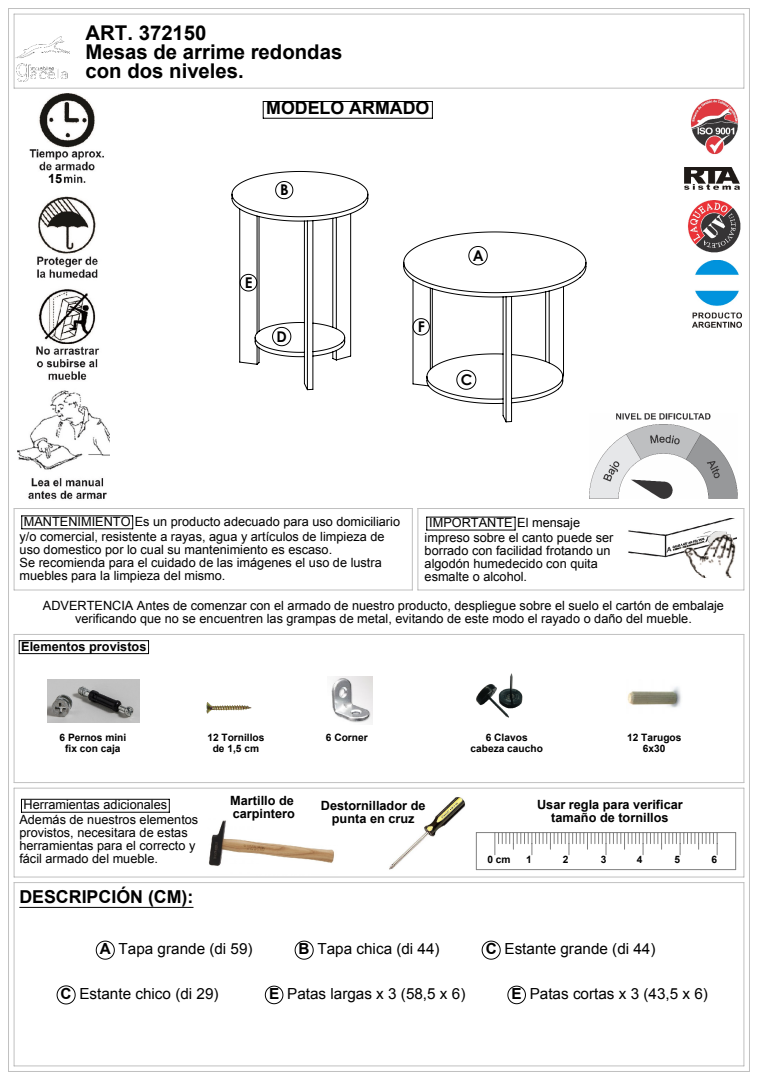
[picture p261: page 1]
A Tapa grande (di 59); B Tapa chica (di 44); C Estante grande (di 44); C Estante chico (di 29); E Patas largas x 3 (58,5 x 6); E Patas cortas x 3 (43,5 x 6); 12 Tarugos; Martillo de; carpintero; Destornillador de; Elementos provistos; MODELO ARMADO; 12 Tornillos de 1,5 cm; 6 Clavos cabeza caucho; 6 Corner

ART. 372150
Mesas de arrime redondas
con dos niveles.

MANTENIMIENTO Es un producto adecuado para uso domiciliario
y/o comercial, resistente a rayas, agua y artículos de limpieza de
uso domestico por lo cual su mantenimiento es escaso.
Se recomienda para el cuidado de las imágenes el uso de lustra
muebles para la limpieza del mismo.
ADVERTENCIA Antes de comenzar con el armado de nuestro producto, despliegue sobre el suelo el cartón de embalaje
verificando que no se encuentren las grampas de metal, evitando de este modo el rayado o daño del mueble.

IMPORTANTE El mensaje
impreso sobre el canto puede ser
borrado con facilidad frotando un
algodón humedecido con quita
esmalte o alcohol.

6 Pernos mini
fix con caja

Herramientas adicionales
Además de nuestros elementos
provistos, necesitara de estas
herramientas para el correcto y
fácil armado del mueble.
DESCRIPCIÓN (CM):

Usar regla para verificar

punta en cruz tamaño de tornillos

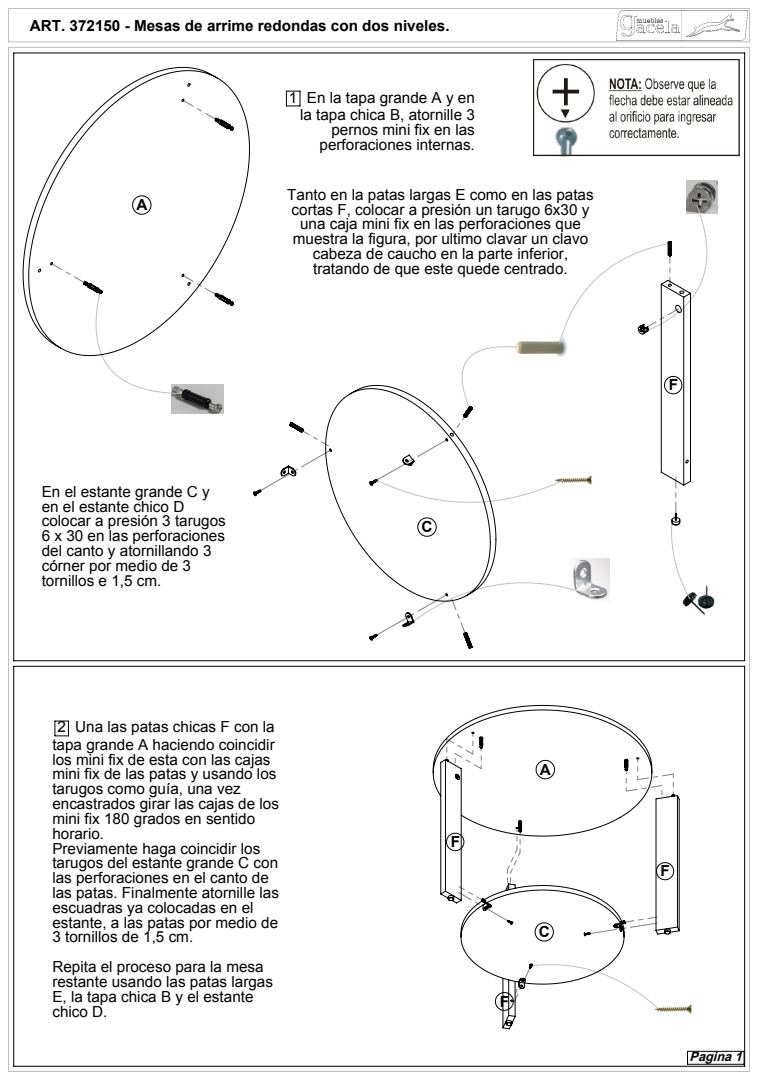
[picture p262: page 2]
Una las patas chicas F con la; En la tapa grande A y en; Pagina 1

ART. 372150 - Mesas de arrime redondas con dos niveles.

la tapa chica B, atornille 3
pernos mini fix en las
perforaciones internas.

Tanto en la patas largas E como en las patas
cortas F, colocar a presión un tarugo 6x30 y
una caja mini fix en las perforaciones que
muestra la figura, por ultimo clavar un clavo
cabeza de caucho en la parte inferior,
tratando de que este quede centrado.

En el estante grande C y
en el estante chico D
colocar a presión 3 tarugos
6 x 30 en las perforaciones
del canto y atornillando 3
córner por medio de 3
tornillos e 1,5 cm.

tapa grande A haciendo coincidir
los mini fix de esta con las cajas
mini fix de las patas y usando los
tarugos como guía, una vez
encastrados girar las cajas de los
mini fix 180 grados en sentido
horario.
Previamente haga coincidir los
tarugos del estante grande C con
las perforaciones en el canto de
las patas. Finalmente atornille las
escuadras ya colocadas en el
estante, a las patas por medio de
3 tornillos de 1,5 cm.
Repita el proceso para la mesa
restante usando las patas largas
E, la tapa chica B y el estante
chico D.
