infomueblesgacela/muebles-gacela-mvp/public/modelos_3d/linea-curvalba/A405270/A405270.PDF

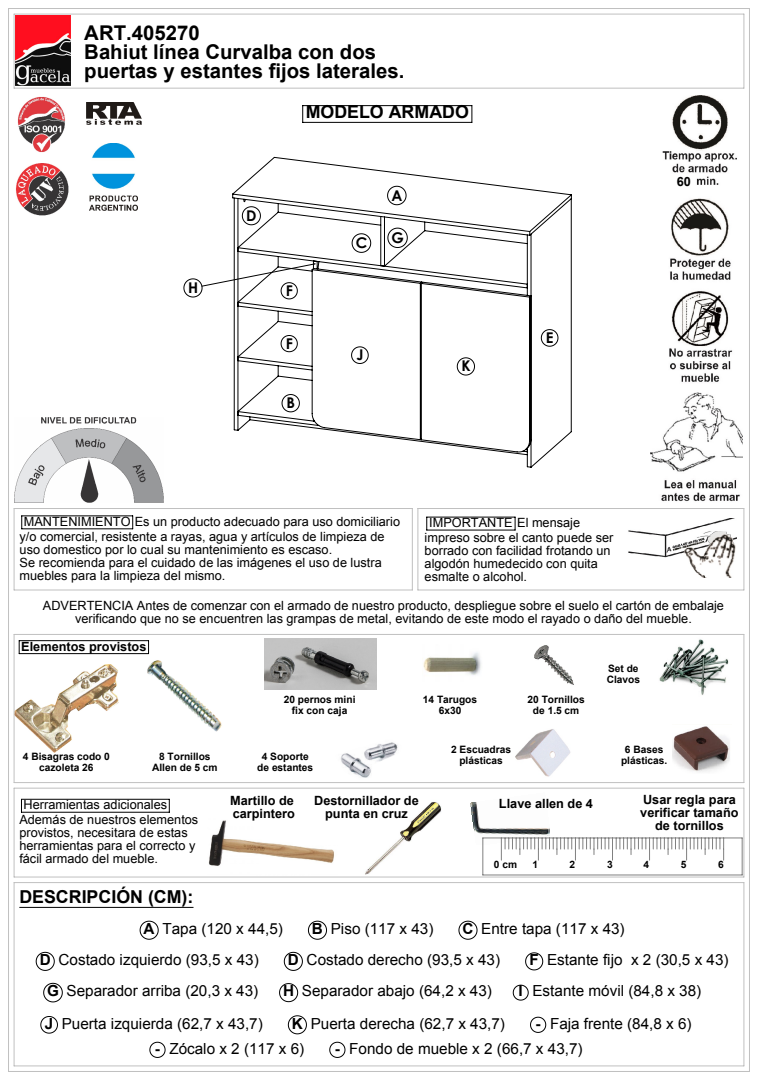
[picture p263: page 1]
G Separador arriba (20,3 x 43); H Separador abajo (64,2 x 43); I Estante móvil (84,8 x 38); D Costado izquierdo (93,5 x 43); D Costado derecho (93,5 x 43); F Estante fijo x 2 (30,5 x 43); - Zócalo x 2 (117 x 6); - Fondo de mueble x 2 (66,7 x 43,7); J Puerta izquierda (62,7 x 43,7); K Puerta derecha (62,7 x 43,7); - Faja frente (84,8 x 6); A Tapa (120 x 44,5); B Piso (117 x 43); C Entre tapa (117 x 43); Set de; Martillo de; Elementos provistos; MODELO ARMADO; 20 Tornillos de 1.5 cm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

ART.405270
Bahiut línea Curvalba con dos
puertas y estantes fijos laterales.

MANTENIMIENTO Es un producto adecuado para uso domiciliario
y/o comercial, resistente a rayas, agua y artículos de limpieza de
uso domestico por lo cual su mantenimiento es escaso.
Se recomienda para el cuidado de las imágenes el uso de lustra
muebles para la limpieza del mismo.
ADVERTENCIA Antes de comenzar con el armado de nuestro producto, despliegue sobre el suelo el cartón de embalaje
verificando que no se encuentren las grampas de metal, evitando de este modo el rayado o daño del mueble.

IMPORTANTE El mensaje
impreso sobre el canto puede ser
borrado con facilidad frotando un
algodón humedecido con quita
esmalte o alcohol.

20 pernos mini
fix con caja

8 Tornillos
Allen de 5 cm

Herramientas adicionales
Además de nuestros elementos
provistos, necesitara de estas
herramientas para el correcto y
fácil armado del mueble.
DESCRIPCIÓN (CM):

Destornillador de
punta en cruz

Llave allen de 4

Usar regla para
verificar tamaño
de tornillos

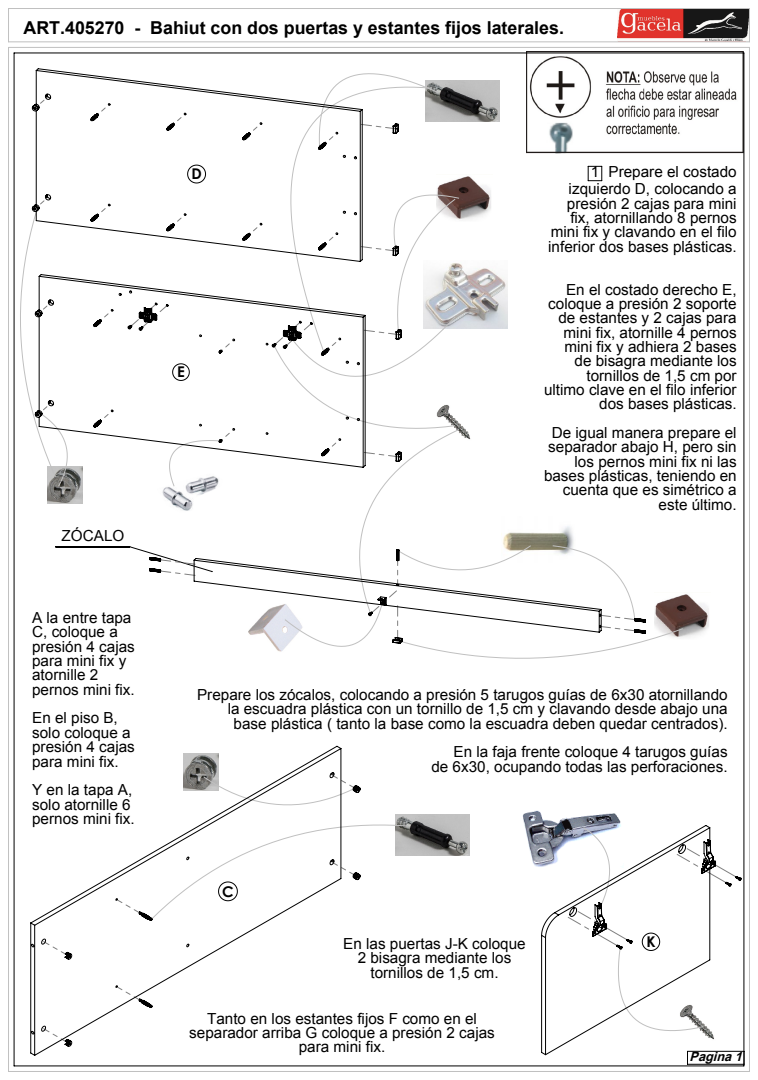
[picture p264: page 2]
En las puertas J-K coloque; Prepare el costado; este último.; Tanto en los estantes fijos F como en el separador arriba G coloque a presión 2 cajas para mini fix.; Pagina 1

ART.405270 - Bahiut con dos puertas y estantes fijos laterales.

izquierdo D, colocando a
presión 2 cajas para mini
fix, atornillando 8 pernos
mini fix y clavando en el filo
inferior dos bases plásticas.

En el costado derecho E,
coloque a presión 2 soporte
de estantes y 2 cajas para
mini fix, atornille 4 pernos
mini fix y adhiera 2 bases
de bisagra mediante los
tornillos de 1,5 cm por
ultimo clave en el filo inferior
dos bases plásticas.
De igual manera prepare el
separador abajo H, pero sin los pernos mini fix ni las
bases plásticas, teniendo en
cuenta que es simétrico a

A la entre tapa
C, coloque a
presión 4 cajas
para mini fix y
atornille 2
pernos mini fix.
En el piso B,
solo coloque a
para mini fix.
Y en la tapa A,
solo atornille 6

Prepare los zócalos, colocando a presión 5 tarugos guías de 6x30 atornillando
la escuadra plástica con un tornillo de 1,5 cm y clavando desde abajo una
base plástica ( tanto la base como la escuadra deben quedar centrados).

En la faja frente coloque 4 tarugos guías de 6x30, ocupando todas las perforaciones.

2 bisagra mediante los
tornillos de 1,5 cm.

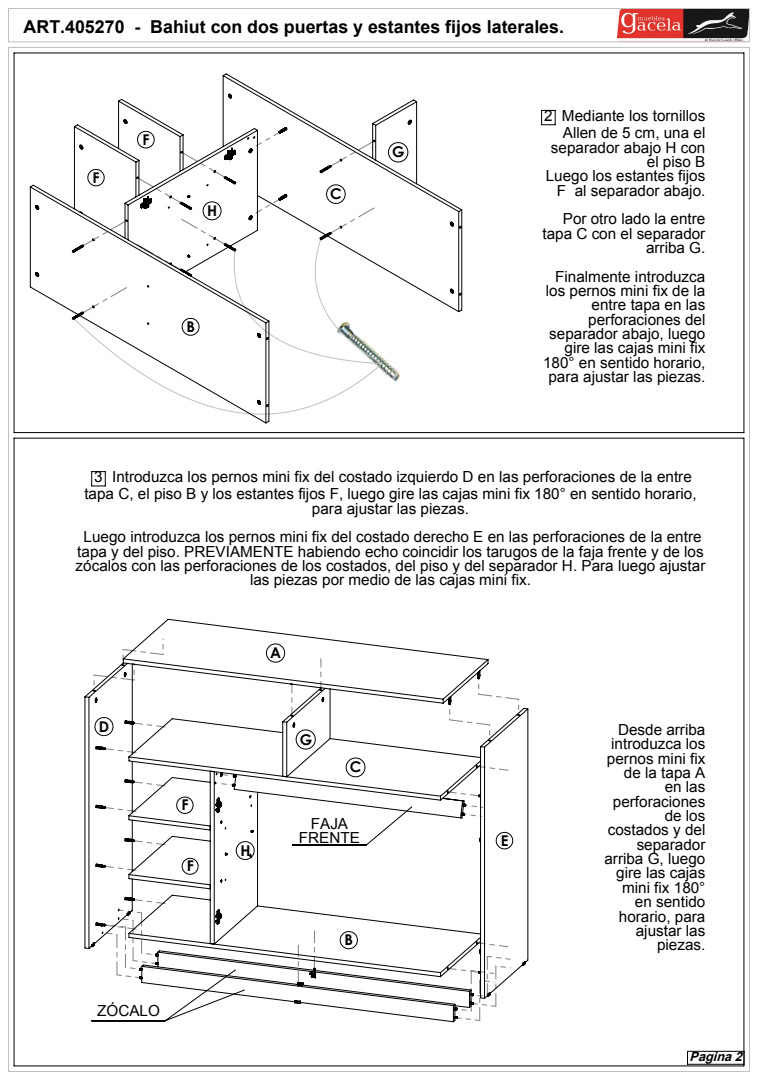
[picture p265: page 3]
el piso B; arriba G.; Pagina 2

2 Mediante los tornillos
Allen de 5 cm, una el
separador abajo H con
Luego los estantes fijos
F al separador abajo.
Por otro lado la entre
tapa C con el separador

Finalmente introduzca
los pernos mini fix de la
entre tapa en las
perforaciones del
separador abajo, luego gire las cajas mini fix 180° en sentido horario,

para ajustar las piezas.

3 Introduzca los pernos mini fix del costado izquierdo D en las perforaciones de la entre
tapa C, el piso B y los estantes fijos F, luego gire las cajas mini fix 180° en sentido horario,

Luego introduzca los pernos mini fix del costado derecho E en las perforaciones de la entre
tapa y del piso. PREVIAMENTE habiendo echo coincidir los tarugos de la faja frente y de los
zócalos con las perforaciones de los costados, del piso y del separador H. Para luego ajustar las piezas por medio de las cajas mini fix.

Desde arriba
introduzca los
pernos mini fix
de la tapa A
en las
perforaciones
de los
costados y del
separador
arriba G, luego
gire las cajas
mini fix 180°
en sentido
horario, para
ajustar las
piezas.

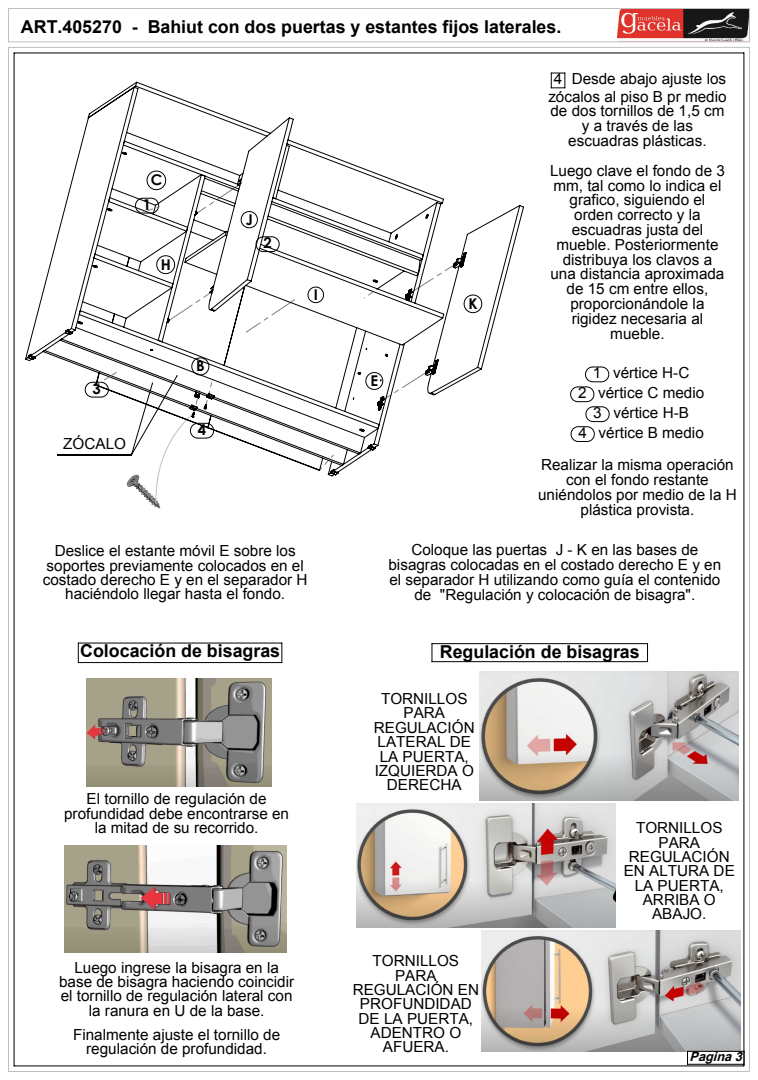
[picture p266: page 4]
Colocación de bisagras; Regulación de bisagras; REGULACIÓN EN DE LA PUERTA, ADENTRO O; EN ALTURA DE LA PUERTA, ARRIBA O; LATERAL DE LA PUERTA, IZQUIERDA O; Pagina 3

4 Desde abajo ajuste los
zócalos al piso B pr medio
de dos tornillos de 1,5 cm
y a través de las
escuadras plásticas.
Luego clave el fondo de 3
mm, tal como lo indica el
grafico, siguiendo el
orden correcto y la
escuadras justa del
mueble. Posteriormente
distribuya los clavos a
una distancia aproximada
de 15 cm entre ellos,
proporcionándole la
rigidez necesaria al
mueble.

1 vértice H-C
2 vértice C medio
3 vértice H-B
4 vértice B medio
Realizar la misma operación
con el fondo restante
uniéndolos por medio de la H
plástica provista.

Deslice el estante móvil E sobre los
soportes previamente colocados en el
costado derecho E y en el separador H haciéndolo llegar hasta el fondo.

Coloque las puertas J - K en las bases de
bisagras colocadas en el costado derecho E y en
el separador H utilizando como guía el contenido
de "Regulación y colocación de bisagra".

El tornillo de regulación de profundidad debe encontrarse en
la mitad de su recorrido.

Luego ingrese la bisagra en la
base de bisagra haciendo coincidir
el tornillo de regulación lateral con
la ranura en U de la base.
Finalmente ajuste el tornillo de
regulación de profundidad.
