infomueblesgacela/muebles-gacela-mvp/public/modelos_3d/linea-curvalba/A446270/A446270.PDF

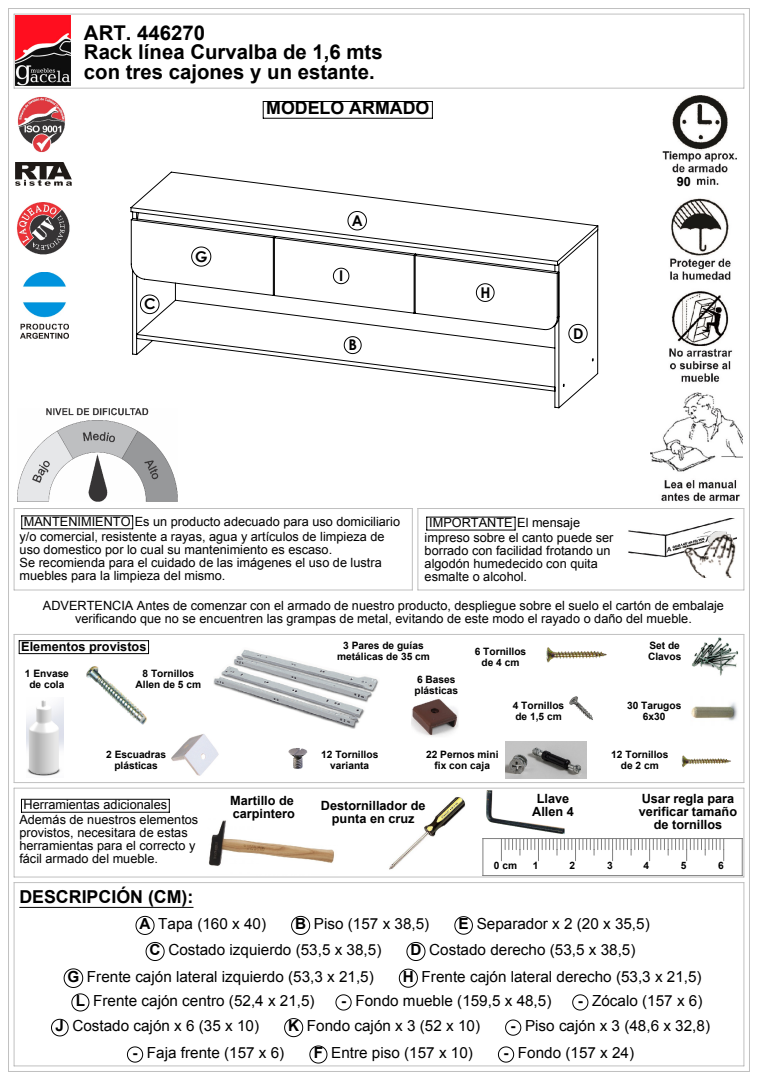
[picture p267: page 1]
J Costado cajón x 6 (35 x 10); K Fondo cajón x 3 (52 x 10); - Piso cajón x 3 (48,6 x 32,8); C Costado izquierdo (53,5 x 38,5); D Costado derecho (53,5 x 38,5); - Faja frente (157 x 6); F Entre piso (157 x 10); - Fondo (157 x 24); L Frente cajón centro (52,4 x 21,5); - Fondo mueble (159,5 x 48,5); - Zócalo (157 x 6); G Frente cajón lateral izquierdo (53,3 x 21,5); H Frente cajón lateral derecho (53,3 x 21,5); A Tapa (160 x 40); B Piso (157 x 38,5); E Separador x 2 (20 x 35,5); 30 Tarugos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

ART. 446270
Rack línea Curvalba de 1,6 mts
con tres cajones y un estante.

MANTENIMIENTO Es un producto adecuado para uso domiciliario
y/o comercial, resistente a rayas, agua y artículos de limpieza de
uso domestico por lo cual su mantenimiento es escaso.
Se recomienda para el cuidado de las imágenes el uso de lustra
muebles para la limpieza del mismo.
ADVERTENCIA Antes de comenzar con el armado de nuestro producto, despliegue sobre el suelo el cartón de embalaje
verificando que no se encuentren las grampas de metal, evitando de este modo el rayado o daño del mueble.

IMPORTANTE El mensaje
impreso sobre el canto puede ser
borrado con facilidad frotando un
algodón humedecido con quita
esmalte o alcohol.

3 Pares de guías
metálicas de 35 cm

8 Tornillos
Allen de 5 cm

22 Pernos mini
fix con caja

12 Tornillos
Usar regla para
verificar tamaño
de tornillos

Herramientas adicionales
Además de nuestros elementos
provistos, necesitara de estas
herramientas para el correcto y
fácil armado del mueble.
DESCRIPCIÓN (CM):

punta en cruz

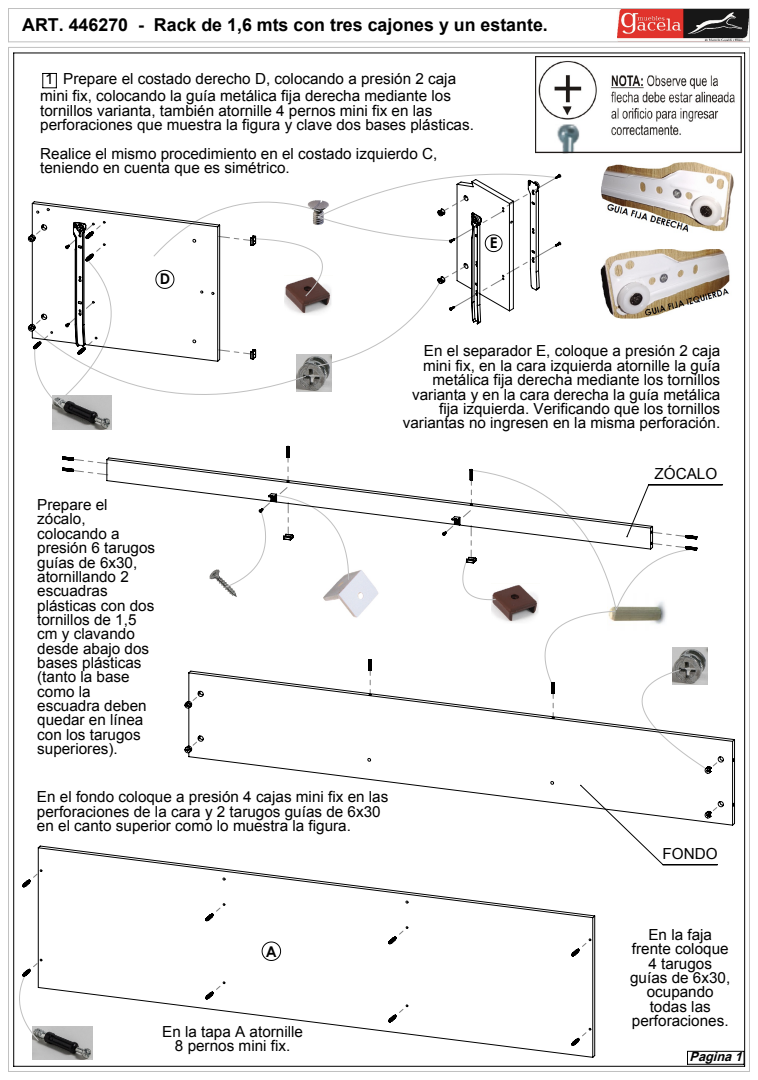
[picture p268: page 2]
Pagina 1

ART. 446270 - Rack de 1,6 mts con tres cajones y un estante.

1 Prepare el costado derecho D, colocando a presión 2 caja
mini fix, colocando la guía metálica fija derecha mediante los
tornillos varianta, también atornille 4 pernos mini fix en las
perforaciones que muestra la figura y clave dos bases plásticas.
Realice el mismo procedimiento en el costado izquierdo C,
teniendo en cuenta que es simétrico.

En el separador E, coloque a presión 2 caja
mini fix, en la cara izquierda atornille la guía
metálica fija derecha mediante los tornillos
varianta y en la cara derecha la guía metálica fija izquierda. Verificando que los tornillos variantas no ingresen en la misma perforación.

Prepare el
zócalo,
colocando a
presión 6 tarugos
guías de 6x30,
atornillando 2
escuadras
plásticas con dos
tornillos de 1,5
cm y clavando
desde abajo dos
bases plásticas
(tanto la base
como la
escuadra deben
quedar en línea
con los tarugos
superiores).

En el fondo coloque a presión 4 cajas mini fix en las
perforaciones de la cara y 2 tarugos guías de 6x30
en el canto superior como lo muestra la figura.

En la faja frente coloque
4 tarugos
ocupando
todas las

perforaciones. En la tapa A atornille
8 pernos mini fix.

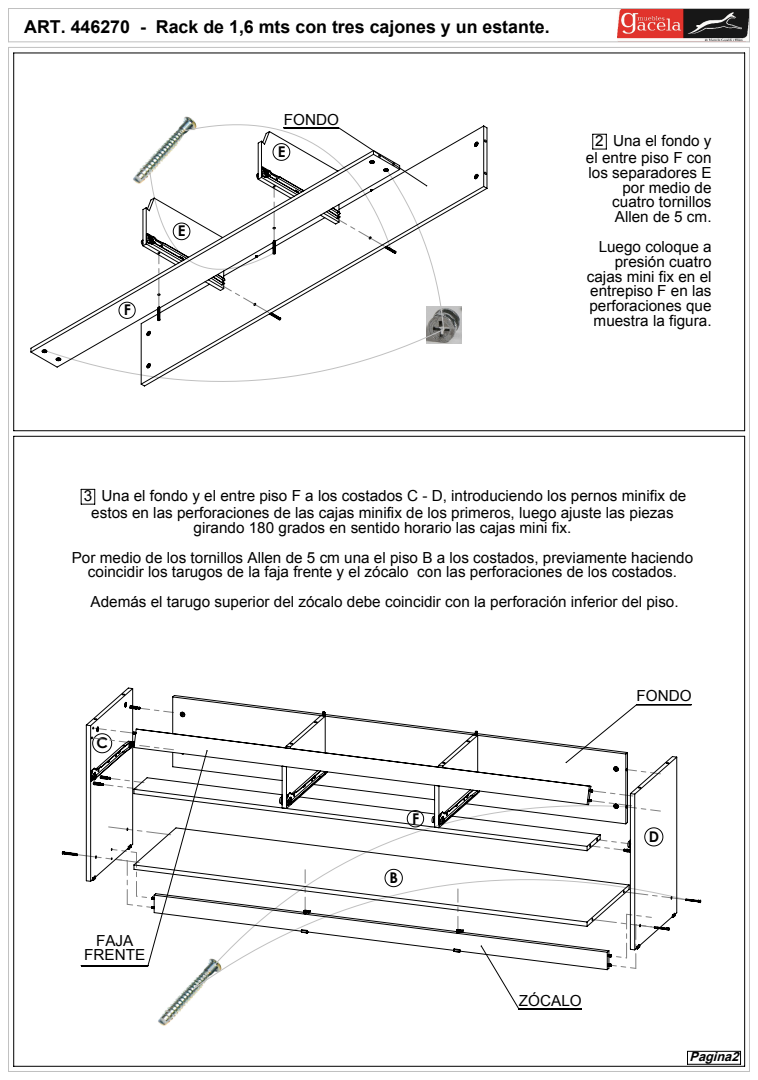
[picture p269: page 3]

2 Una el fondo y
el entre piso F con
los separadores E
por medio de
cuatro tornillos
Allen de 5 cm.
Luego coloque a
presión cuatro
cajas mini fix en el
entrepiso F en las
perforaciones que
muestra la figura.

3 Una el fondo y el entre piso F a los costados C - D, introduciendo los pernos minifix de
estos en las perforaciones de las cajas minifix de los primeros, luego ajuste las piezas

girando 180 grados en sentido horario las cajas mini fix.

Por medio de los tornillos Allen de 5 cm una el piso B a los costados, previamente haciendo
coincidir los tarugos de la faja frente y el zócalo con las perforaciones de los costados.
Además el tarugo superior del zócalo debe coincidir con la perforación inferior del piso.

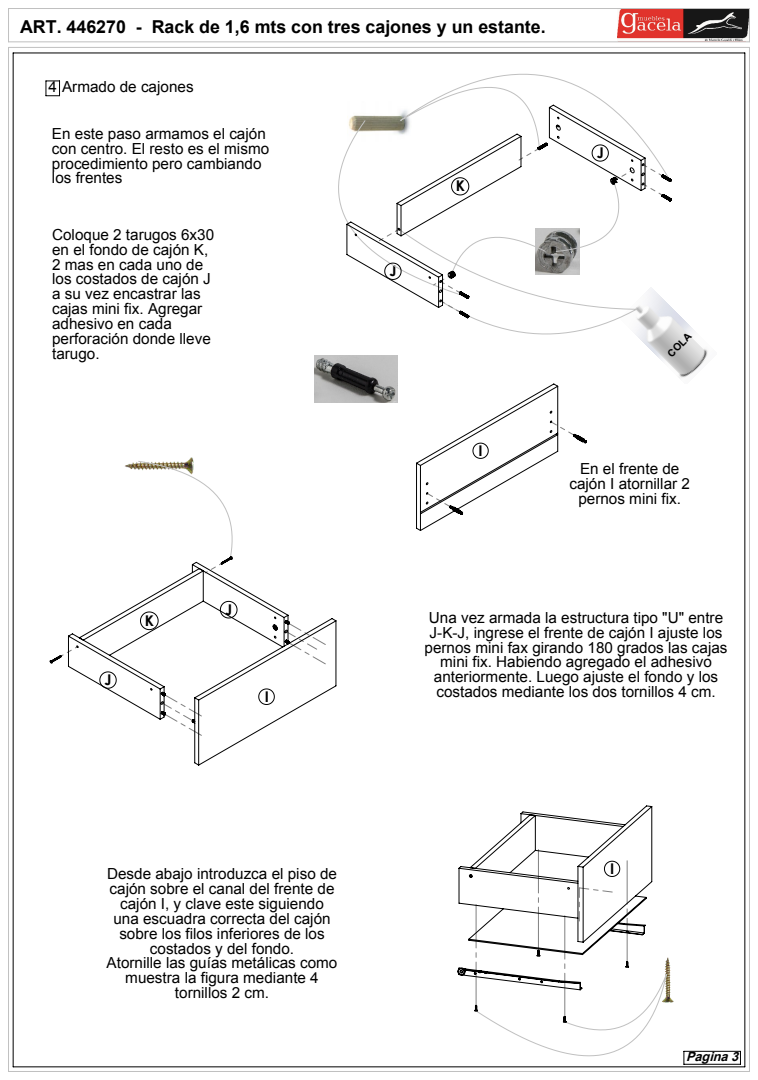
[picture p270: page 4]
Pagina 3

4 Armado de cajones

En este paso armamos el cajón
con centro. El resto es el mismo
procedimiento pero cambiando
los frentes

Coloque 2 tarugos 6x30
en el fondo de cajón K,
2 mas en cada uno de
los costados de cajón J
a su vez encastrar las
cajas mini fix. Agregar
adhesivo en cada
perforación donde lleve
tarugo.

En el frente de
cajón I atornillar 2
pernos mini fix.

Una vez armada la estructura tipo "U" entre
J-K-J, ingrese el frente de cajón I ajuste los
pernos mini fax girando 180 grados las cajas
mini fix. Habiendo agregado el adhesivo
anteriormente. Luego ajuste el fondo y los
costados mediante los dos tornillos 4 cm.

Desde abajo introduzca el piso de
cajón sobre el canal del frente de
cajón I, y clave este siguiendo
una escuadra correcta del cajón
sobre los filos inferiores de los
costados y del fondo.
Atornille las guías metálicas como
muestra la figura mediante 4
tornillos 2 cm.

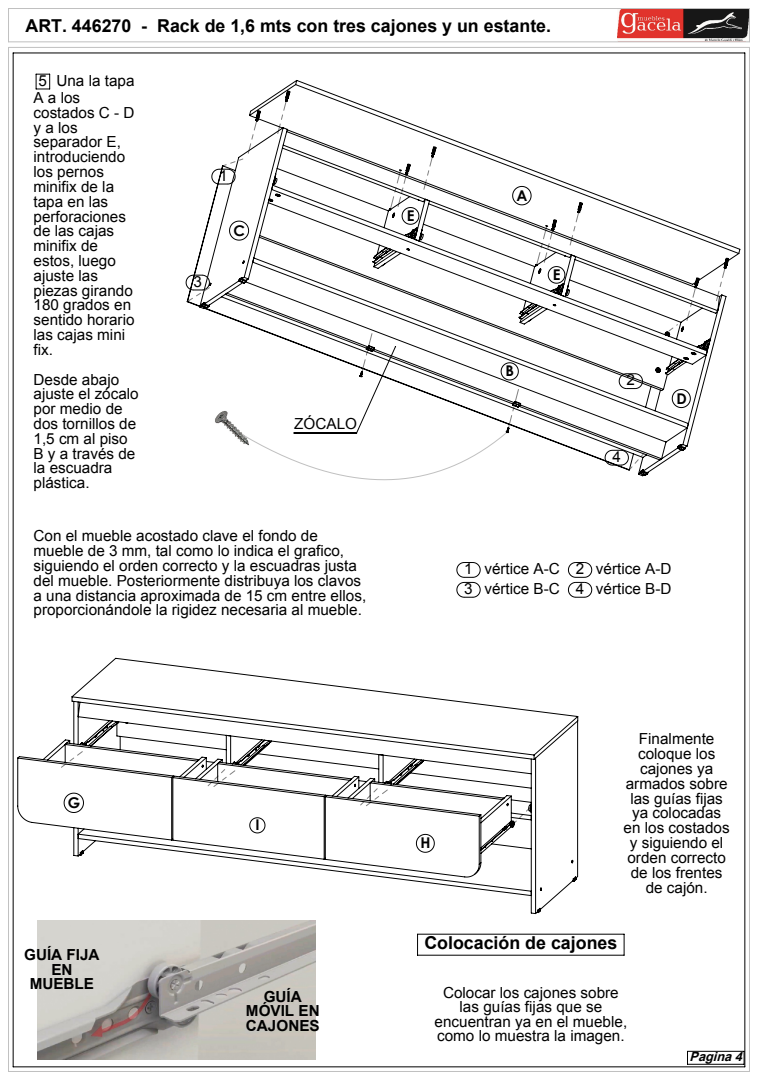
[picture p271: page 5]
1 vértice A-C 2 vértice A-D 3 vértice B-C 4 vértice B-D; MÓVIL EN; GUÍA FIJA; Pagina 4

5 Una la tapa
A a los
costados C - D
y a los
separador E,
introduciendo
los pernos
minifix de la
tapa en las
perforaciones
de las cajas
minifix de
estos, luego
ajuste las
piezas girando
180 grados en
sentido horario
las cajas mini
fix.
Desde abajo
ajuste el zócalo
por medio de
dos tornillos de
1,5 cm al piso
B y a través de
la escuadra
plástica.

Con el mueble acostado clave el fondo de
mueble de 3 mm, tal como lo indica el grafico,
siguiendo el orden correcto y la escuadras justa
del mueble. Posteriormente distribuya los clavos
a una distancia aproximada de 15 cm entre ellos,
proporcionándole la rigidez necesaria al mueble.

Finalmente
coloque los
cajones ya
armados sobre
las guías fijas
ya colocadas
en los costados
y siguiendo el
orden correcto
de los frentes
de cajón.

Colocación de cajones

Colocar los cajones sobre las guías fijas que se
encuentran ya en el mueble,
como lo muestra la imagen.
