infomueblesgacela/muebles-gacela-mvp/public/modelos_3d/linea-curvalba/A732270/A732270.PDF

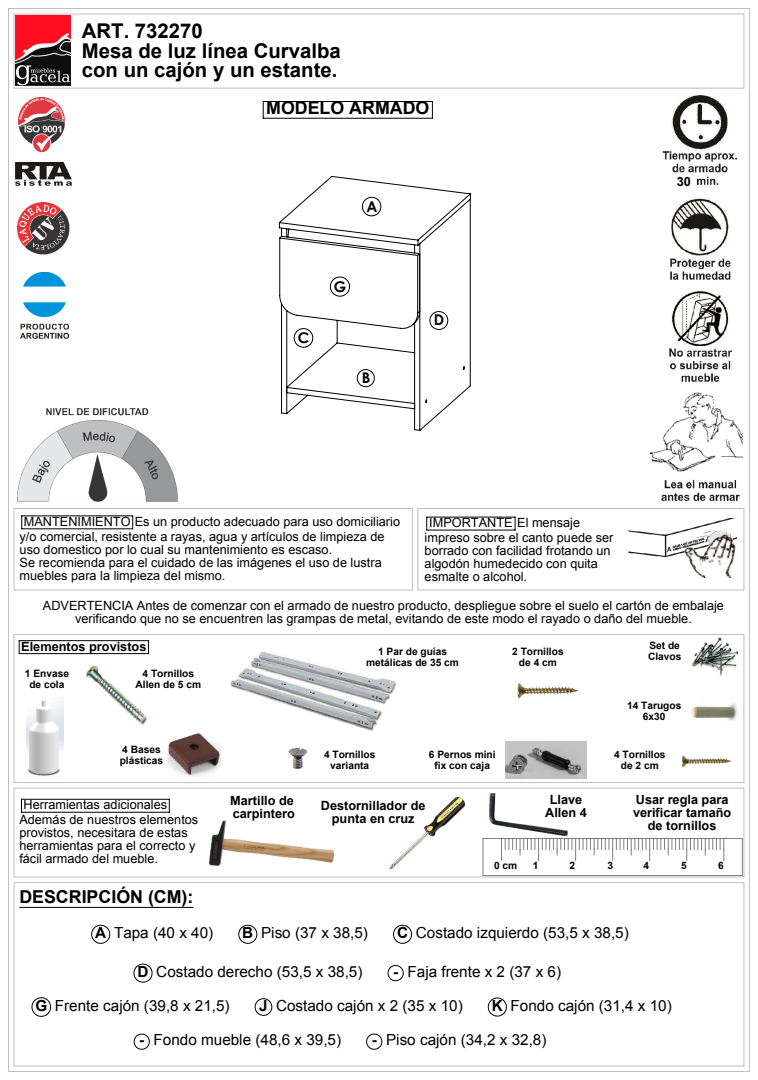
[picture p272: page 1]
A Tapa (40 x 40); B Piso (37 x 38,5); C Costado izquierdo (53,5 x 38,5); G Frente cajón (39,8 x 21,5); J Costado cajón x 2 (35 x 10); K Fondo cajón (31,4 x 10); - Fondo mueble (48,6 x 39,5); - Piso cajón (34,2 x 32,8); D Costado derecho (53,5 x 38,5); - Faja frente x 2 (37 x 6); 14 Tarugos; Set de; Martillo de; carpintero; Destornillador de; Elementos provistos; MODELO ARMADO; 2 Tornillos de 4 cm; 4 Tornillos; 1 Envase de cola; Allen 4; 4 Bases

ART. 732270
Mesa de luz línea Curvalba
con un cajón y un estante.

MANTENIMIENTO Es un producto adecuado para uso domiciliario
y/o comercial, resistente a rayas, agua y artículos de limpieza de
uso domestico por lo cual su mantenimiento es escaso.
Se recomienda para el cuidado de las imágenes el uso de lustra
muebles para la limpieza del mismo.
ADVERTENCIA Antes de comenzar con el armado de nuestro producto, despliegue sobre el suelo el cartón de embalaje
verificando que no se encuentren las grampas de metal, evitando de este modo el rayado o daño del mueble.

IMPORTANTE El mensaje
impreso sobre el canto puede ser
borrado con facilidad frotando un
algodón humedecido con quita
esmalte o alcohol.

1 Par de guías
metálicas de 35 cm

4 Tornillos
Allen de 5 cm

6 Pernos mini
fix con caja

Usar regla para
verificar tamaño
de tornillos

Herramientas adicionales
Además de nuestros elementos
provistos, necesitara de estas
herramientas para el correcto y
fácil armado del mueble.
DESCRIPCIÓN (CM):

punta en cruz

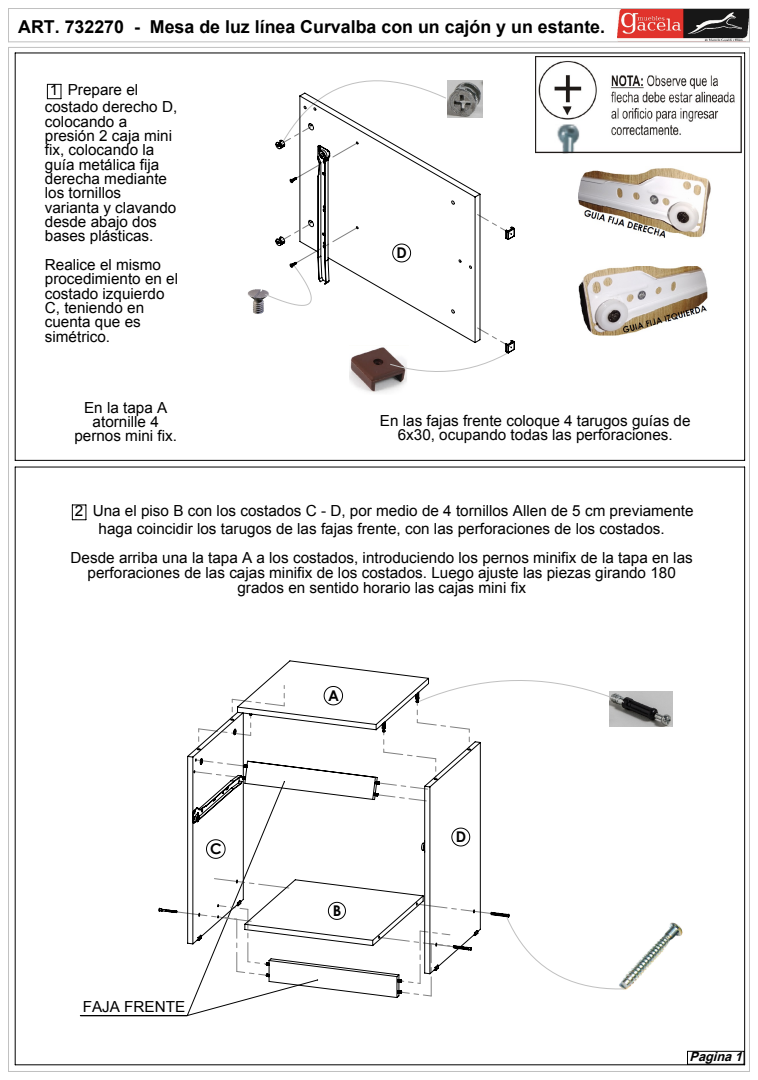
[picture p273: page 2]
FAJA FRENTE; Pagina 1

ART. 732270 - Mesa de luz línea Curvalba con un cajón y un estante.

1 Prepare el
costado derecho D,
colocando a
presión 2 caja mini
fix, colocando la
guía metálica fija
derecha mediante
los tornillos
varianta y clavando
desde abajo dos
bases plásticas.
Realice el mismo
procedimiento en el
costado izquierdo
C, teniendo en
cuenta que es
simétrico.

En la tapa A
atornille 4
pernos mini fix.

En las fajas frente coloque 4 tarugos guías de 6x30, ocupando todas las perforaciones.

2 Una el piso B con los costados C - D, por medio de 4 tornillos Allen de 5 cm previamente
haga coincidir los tarugos de las fajas frente, con las perforaciones de los costados.
Desde arriba una la tapa A a los costados, introduciendo los pernos minifix de la tapa en las
perforaciones de las cajas minifix de los costados. Luego ajuste las piezas girando 180

grados en sentido horario las cajas mini fix

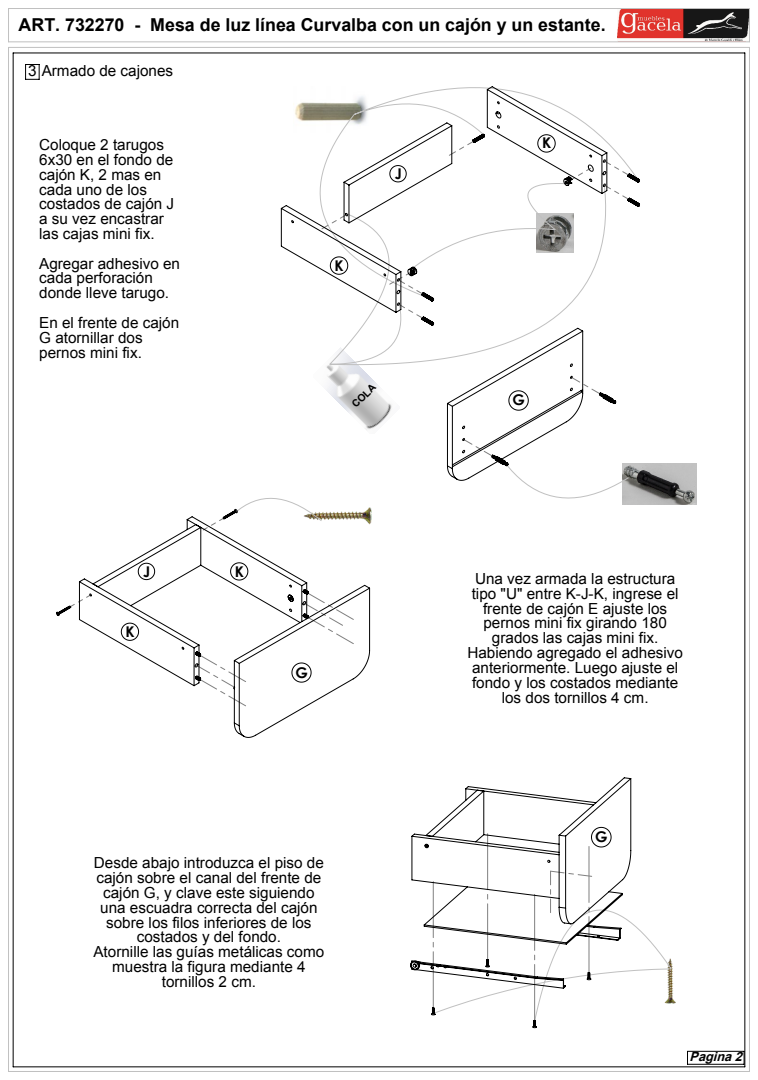
[picture p274: page 3]
Pagina 2

3 Armado de cajones

Coloque 2 tarugos
6x30 en el fondo de
cajón K, 2 mas en
cada uno de los
costados de cajón J
a su vez encastrar
las cajas mini fix.
Agregar adhesivo en
cada perforación
donde lleve tarugo.
En el frente de cajón
G atornillar dos
pernos mini fix.

Una vez armada la estructura
tipo "U" entre K-J-K, ingrese el
frente de cajón E ajuste los
pernos mini fix girando 180
grados las cajas mini fix.
Habiendo agregado el adhesivo
anteriormente. Luego ajuste el
fondo y los costados mediante
los dos tornillos 4 cm.

Desde abajo introduzca el piso de
cajón sobre el canal del frente de
cajón G, y clave este siguiendo
una escuadra correcta del cajón
sobre los filos inferiores de los
costados y del fondo.
Atornille las guías metálicas como
muestra la figura mediante 4
tornillos 2 cm.

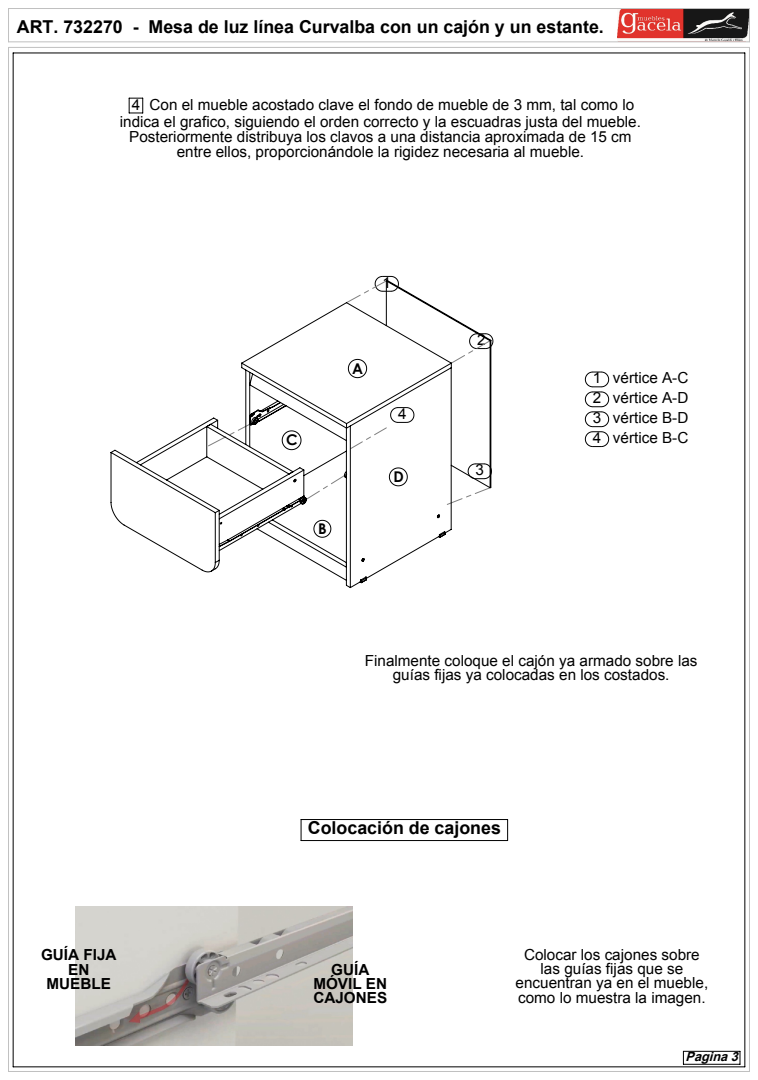
[picture p275: page 4]
1 vértice A-C 2 vértice A-D 3 vértice B-D 4 vértice B-C; Con el mueble acostado clave el fondo de mueble de 3 mm, tal como lo; MÓVIL EN; GUÍA FIJA; Pagina 3

indica el grafico, siguiendo el orden correcto y la escuadras justa del mueble.
Posteriormente distribuya los clavos a una distancia aproximada de 15 cm
entre ellos, proporcionándole la rigidez necesaria al mueble.

Finalmente coloque el cajón ya armado sobre las
guías fijas ya colocadas en los costados.

Colocación de cajones

Colocar los cajones sobre las guías fijas que se
encuentran ya en el mueble,
como lo muestra la imagen.
