infomueblesgacela/muebles-gacela-mvp/public/modelos_3d/linea-curvalba/A742270/A742270.PDF

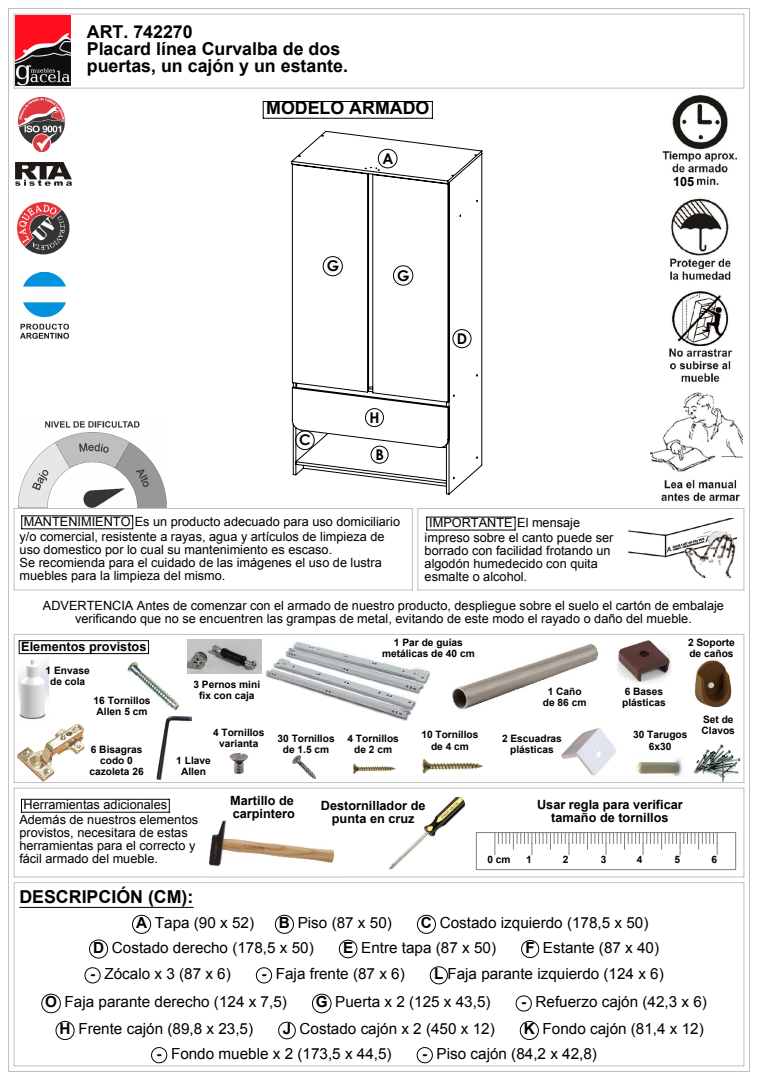
[picture p276: page 1]
A Tapa (90 x 52); B Piso (87 x 50); C Costado izquierdo (178,5 x 50); H Frente cajón (89,8 x 23,5); J Costado cajón x 2 (450 x 12); K Fondo cajón (81,4 x 12); - Zócalo x 3 (87 x 6); - Faja frente (87 x 6); L Faja parante izquierdo (124 x 6); - Fondo mueble x 2 (173,5 x 44,5); - Piso cajón (84,2 x 42,8); D Costado derecho (178,5 x 50); E Entre tapa (87 x 50); F Estante (87 x 40); O Faja parante derecho (124 x 7,5); G Puerta x 2 (125 x 43,5); - Refuerzo cajón (42,3 x 6); 2 Soporte de caños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

ART. 742270
Placard línea Curvalba de dos
puertas, un cajón y un estante.

MANTENIMIENTO Es un producto adecuado para uso domiciliario
y/o comercial, resistente a rayas, agua y artículos de limpieza de
uso domestico por lo cual su mantenimiento es escaso.
Se recomienda para el cuidado de las imágenes el uso de lustra
muebles para la limpieza del mismo.
ADVERTENCIA Antes de comenzar con el armado de nuestro producto, despliegue sobre el suelo el cartón de embalaje
verificando que no se encuentren las grampas de metal, evitando de este modo el rayado o daño del mueble.

IMPORTANTE El mensaje
impreso sobre el canto puede ser
borrado con facilidad frotando un
algodón humedecido con quita
esmalte o alcohol.

1 Par de guías
metálicas de 40 cm

3 Pernos mini
fix con caja

Herramientas adicionales
Además de nuestros elementos
provistos, necesitara de estas
herramientas para el correcto y
fácil armado del mueble.
DESCRIPCIÓN (CM):

Usar regla para verificar

punta en cruz tamaño de tornillos

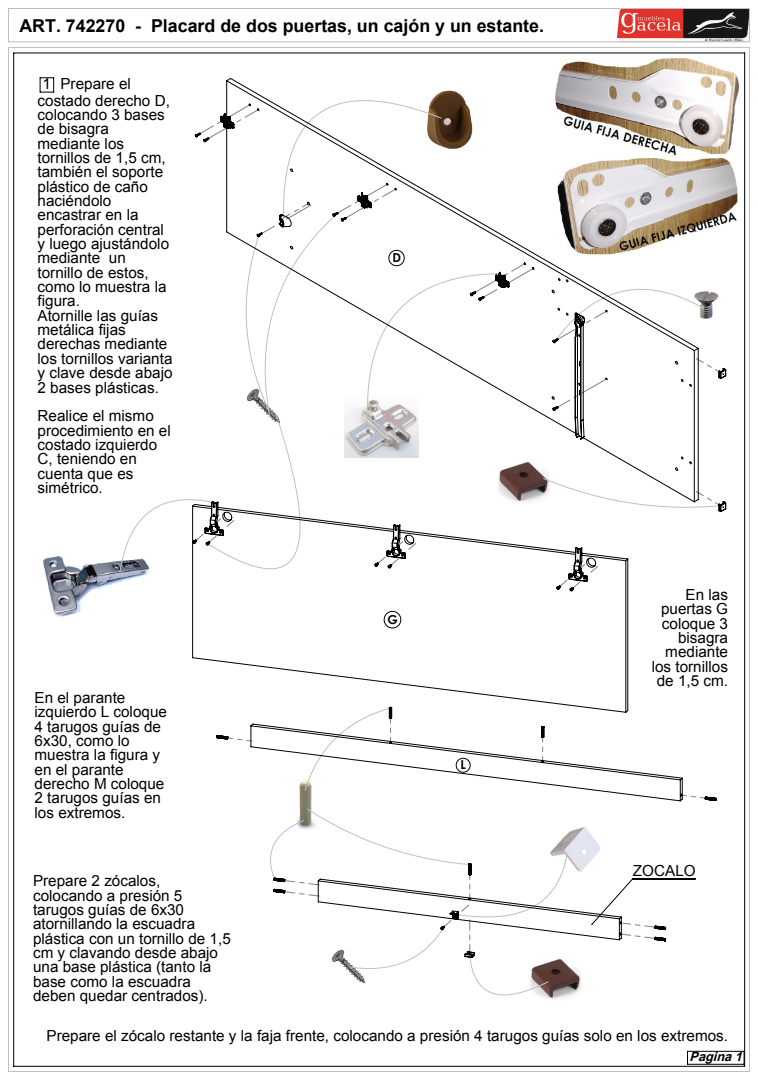
[picture p277: page 2]
En las puertas G coloque 3; los tornillos de 1,5 cm.; Pagina 1

ART. 742270 - Placard de dos puertas, un cajón y un estante.

1 Prepare el
costado derecho D,
colocando 3 bases
de bisagra
mediante los
tornillos de 1,5 cm,
también el soporte
plástico de caño
haciéndolo
encastrar en la
perforación central
y luego ajustándolo
mediante un
tornillo de estos,
como lo muestra la
figura.
Atornille las guías
metálica fijas
derechas mediante
los tornillos varianta
y clave desde abajo
2 bases plásticas.
Realice el mismo
procedimiento en el
costado izquierdo
C, teniendo en
cuenta que es
simétrico.

En el parante
izquierdo L coloque
4 tarugos guías de
6x30, como lo
muestra la figura y
en el parante
derecho M coloque
2 tarugos guías en
los extremos.

Prepare 2 zócalos,
colocando a presión 5
tarugos guías de 6x30
atornillando la escuadra
plástica con un tornillo de 1,5
cm y clavando desde abajo
una base plástica (tanto la
base como la escuadra
deben quedar centrados).

Prepare el zócalo restante y la faja frente, colocando a presión 4 tarugos guías solo en los extremos.

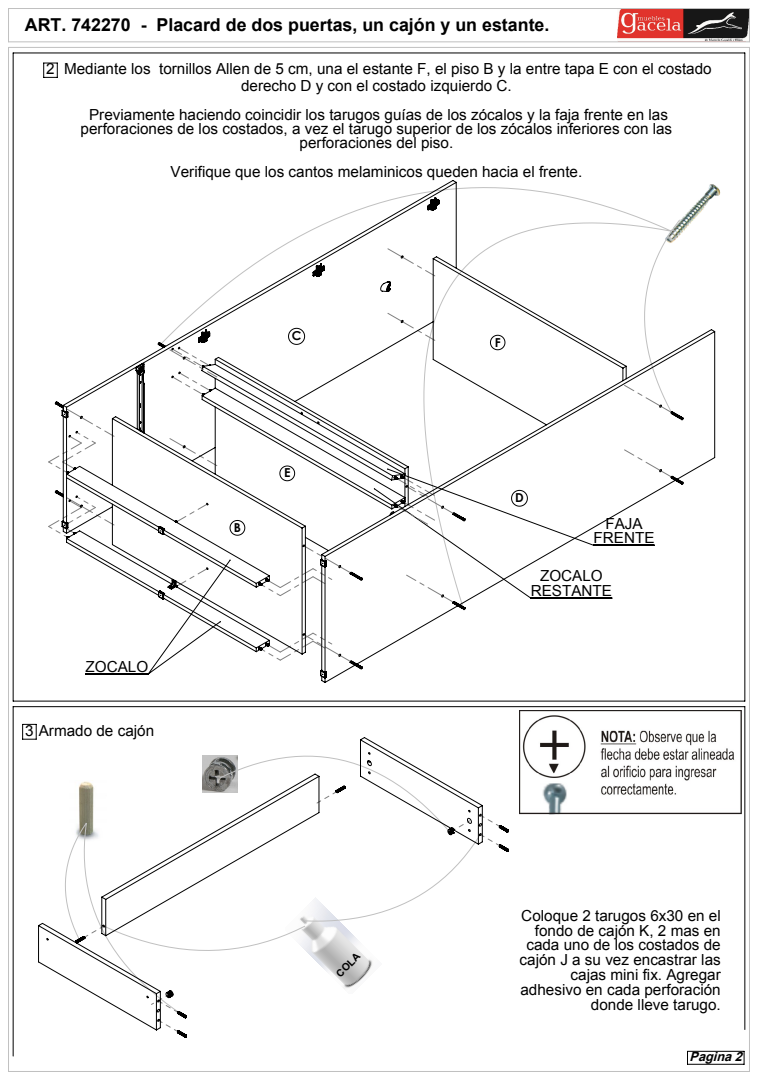
[picture p278: page 3]
Pagina 2

2 Mediante los tornillos Allen de 5 cm, una el estante F, el piso B y la entre tapa E con el costado

derecho D y con el costado izquierdo C.

Previamente haciendo coincidir los tarugos guías de los zócalos y la faja frente en las
perforaciones de los costados, a vez el tarugo superior de los zócalos inferiores con las perforaciones del piso.

Verifique que los cantos melaminicos queden hacia el frente.

3 Armado de cajón

Coloque 2 tarugos 6x30 en el
fondo de cajón K, 2 mas en
cada uno de los costados de
cajón J a su vez encastrar las
cajas mini fix. Agregar
adhesivo en cada perforación

donde lleve tarugo.

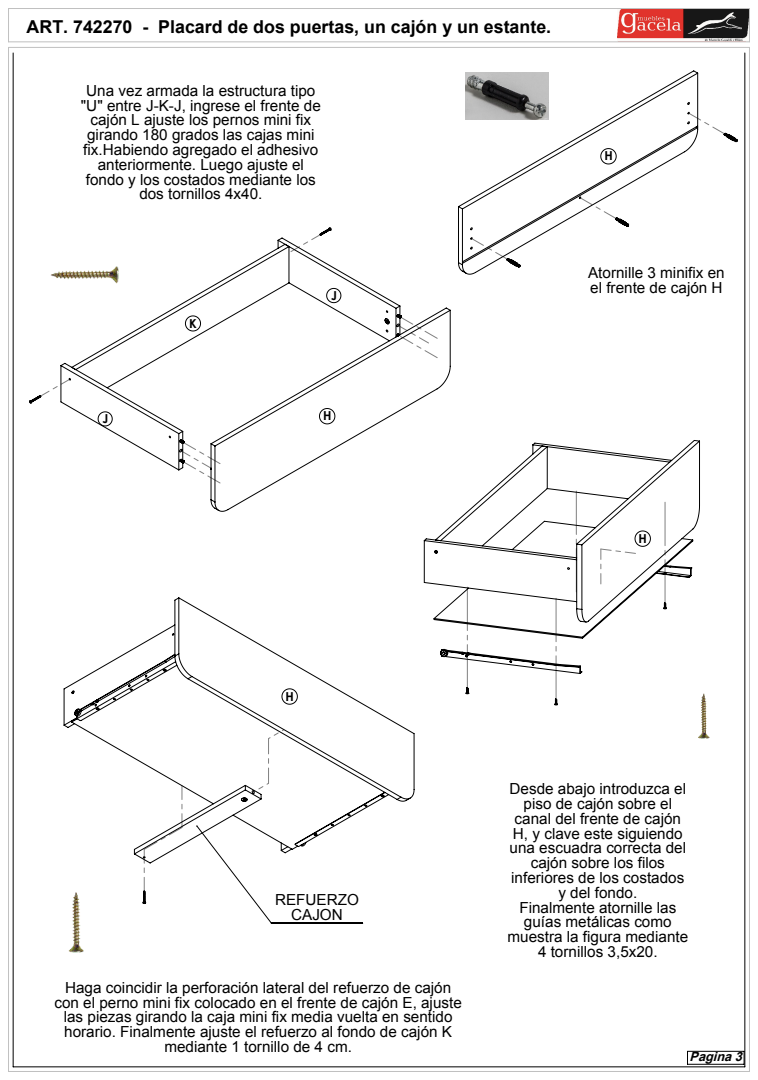
[picture p279: page 4]
Pagina 3

Una vez armada la estructura tipo
"U" entre J-K-J, ingrese el frente de
cajón L ajuste los pernos mini fix
girando 180 grados las cajas mini
fix.Habiendo agregado el adhesivo
anteriormente. Luego ajuste el
fondo y los costados mediante los
dos tornillos 4x40.

Atornille 3 minifix en
el frente de cajón H

Desde abajo introduzca el
piso de cajón sobre el
canal del frente de cajón
H, y clave este siguiendo
una escuadra correcta del
cajón sobre los filos
inferiores de los costados
y del fondo.
Finalmente atornille las
guías metálicas como
muestra la figura mediante
4 tornillos 3,5x20.

Haga coincidir la perforación lateral del refuerzo de cajón
con el perno mini fix colocado en el frente de cajón E, ajuste
las piezas girando la caja mini fix media vuelta en sentido
horario. Finalmente ajuste el refuerzo al fondo de cajón K

mediante 1 tornillo de 4 cm.

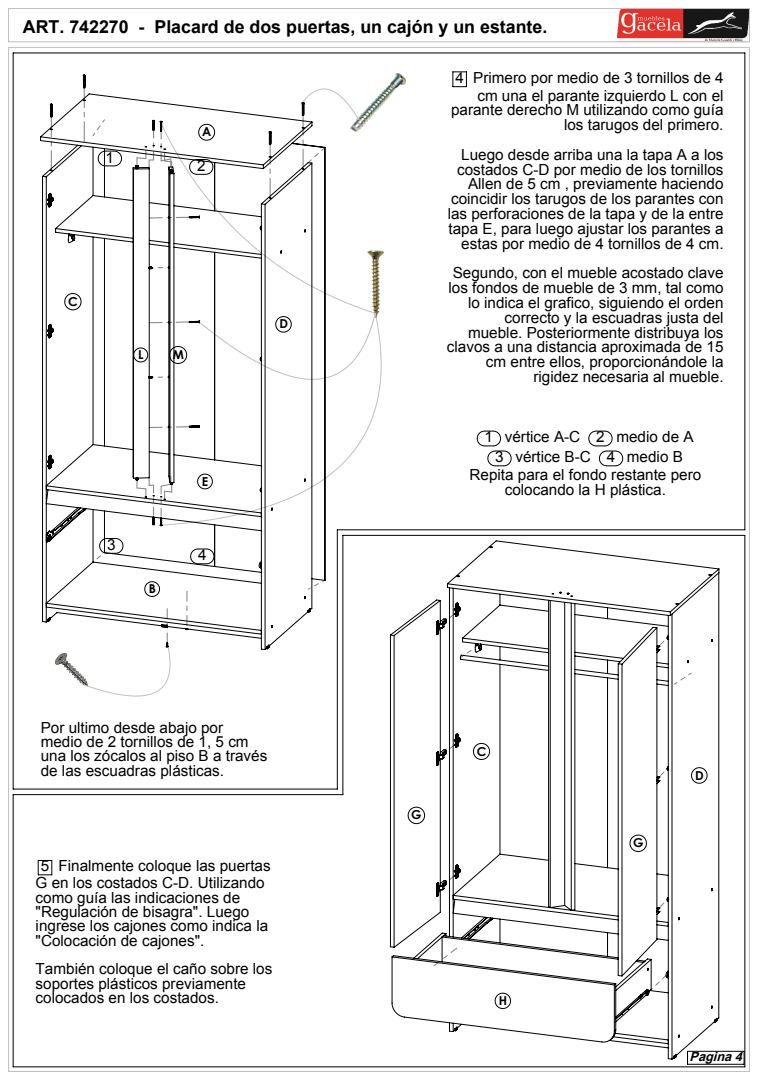
[picture p280: page 5]
Finalmente coloque las puertas; Primero por medio de 3 tornillos de 4; Pagina 4

cm una el parante izquierdo L con el
parante derecho M utilizando como guía

los tarugos del primero.

Luego desde arriba una la tapa A a los
costados C-D por medio de los tornillos
Allen de 5 cm , previamente haciendo
coincidir los tarugos de los parantes con
las perforaciones de la tapa y de la entre
tapa E, para luego ajustar los parantes a
estas por medio de 4 tornillos de 4 cm.
Segundo, con el mueble acostado clave
los fondos de mueble de 3 mm, tal como
lo indica el grafico, siguiendo el orden
correcto y la escuadras justa del
mueble. Posteriormente distribuya los
clavos a una distancia aproximada de 15
cm entre ellos, proporcionándole la
rigidez necesaria al mueble.

1 vértice A-C 2 medio de A
3 vértice B-C 4 medio B
Repita para el fondo restante pero
colocando la H plástica.

Por ultimo desde abajo por
medio de 2 tornillos de 1, 5 cm
una los zócalos al piso B a través
de las escuadras plásticas.

G en los costados C-D. Utilizando
como guía las indicaciones de
"Regulación de bisagra". Luego
ingrese los cajones como indica la
"Colocación de cajones".
También coloque el caño sobre los
soportes plásticos previamente
colocados en los costados.

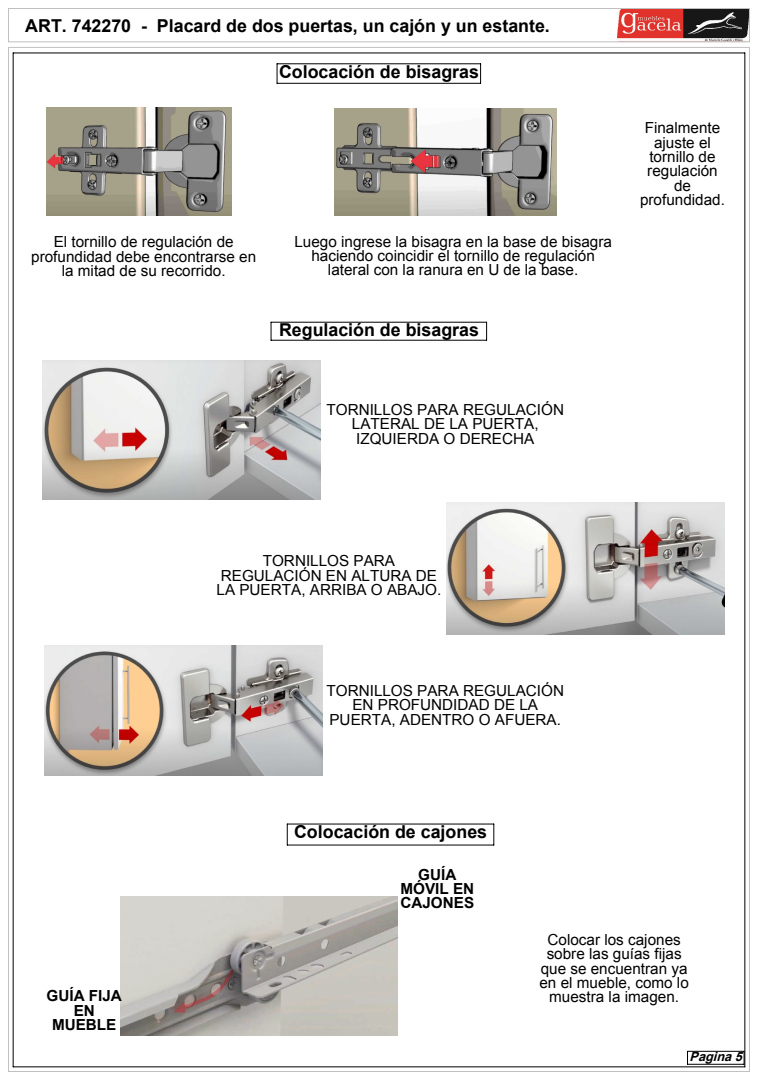
[picture p281: page 6]
ajuste el tornillo de; GUÍA FIJA; MÓVIL EN; Pagina 5

Colocación de bisagras

El tornillo de regulación de profundidad debe encontrarse en
la mitad de su recorrido.

Luego ingrese la bisagra en la base de bisagra
haciendo coincidir el tornillo de regulación
lateral con la ranura en U de la base.

Regulación de bisagras

TORNILLOS PARA REGULACIÓN
LATERAL DE LA PUERTA,
IZQUIERDA O DERECHA

TORNILLOS PARA
REGULACIÓN EN ALTURA DE
LA PUERTA, ARRIBA O ABAJO.

EN PROFUNDIDAD DE LA
PUERTA, ADENTRO O AFUERA.

Colocación de cajones

Colocar los cajones
sobre las guías fijas
que se encuentran ya
en el mueble, como lo
muestra la imagen.
