infomueblesgacela/muebles-gacela-mvp/public/modelos_3d/linea-curvalba/A742272/A742272.PDF

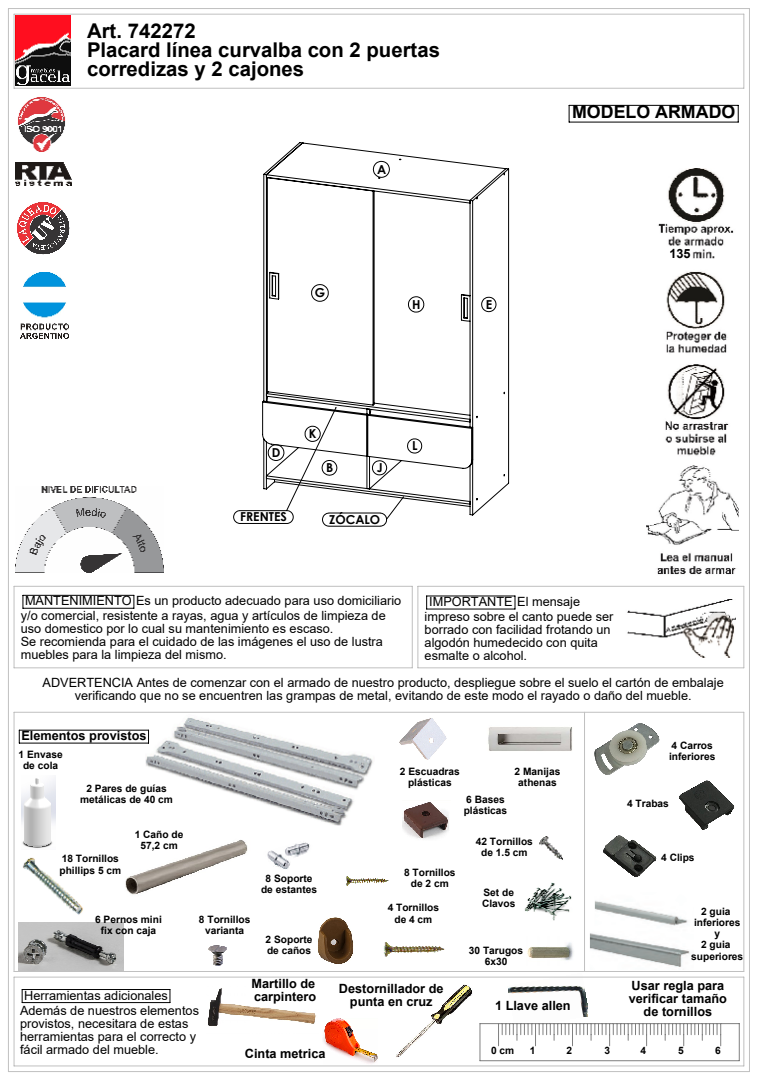
[picture p282: page 1]
2 Soporte de caños; 8 Tornillos de 2 cm; 30 Tarugos; Set de; carpintero; Destornillador de; Elementos provistos; MODELO ARMADO; 4 Tornillos; 8 Tornillos; 1 Envase de cola; 18 Tornillos phillips 5 cm; 42 Tornillos de 1.5 cm; 8 Soporte de estantes; verificar tamaño; 1 Caño de 57,2 cm; 2 Escuadras; 6 Bases; 2 Manijas; 2 guia; 4 Clips; 4 Trabas; 4 Carros; Cinta metrica

Art. 742272
Placard línea curvalba con 2 puertas
corredizas y 2 cajones

MANTENIMIENTO Es un producto adecuado para uso domiciliario
y/o comercial, resistente a rayas, agua y artículos de limpieza de
uso domestico por lo cual su mantenimiento es escaso.
Se recomienda para el cuidado de las imágenes el uso de lustra
muebles para la limpieza del mismo.
ADVERTENCIA Antes de comenzar con el armado de nuestro producto, despliegue sobre el suelo el cartón de embalaje
verificando que no se encuentren las grampas de metal, evitando de este modo el rayado o daño del mueble.

IMPORTANTE El mensaje
impreso sobre el canto puede ser
borrado con facilidad frotando un
algodón humedecido con quita
esmalte o alcohol.

2 Pares de guías
metálicas de 40 cm

6 Pernos mini
fix con caja

Martillo de Usar regla para 1 Llave allen de tornillos

Herramientas adicionales
Además de nuestros elementos
provistos, necesitara de estas
herramientas para el correcto y
fácil armado del mueble.

punta en cruz

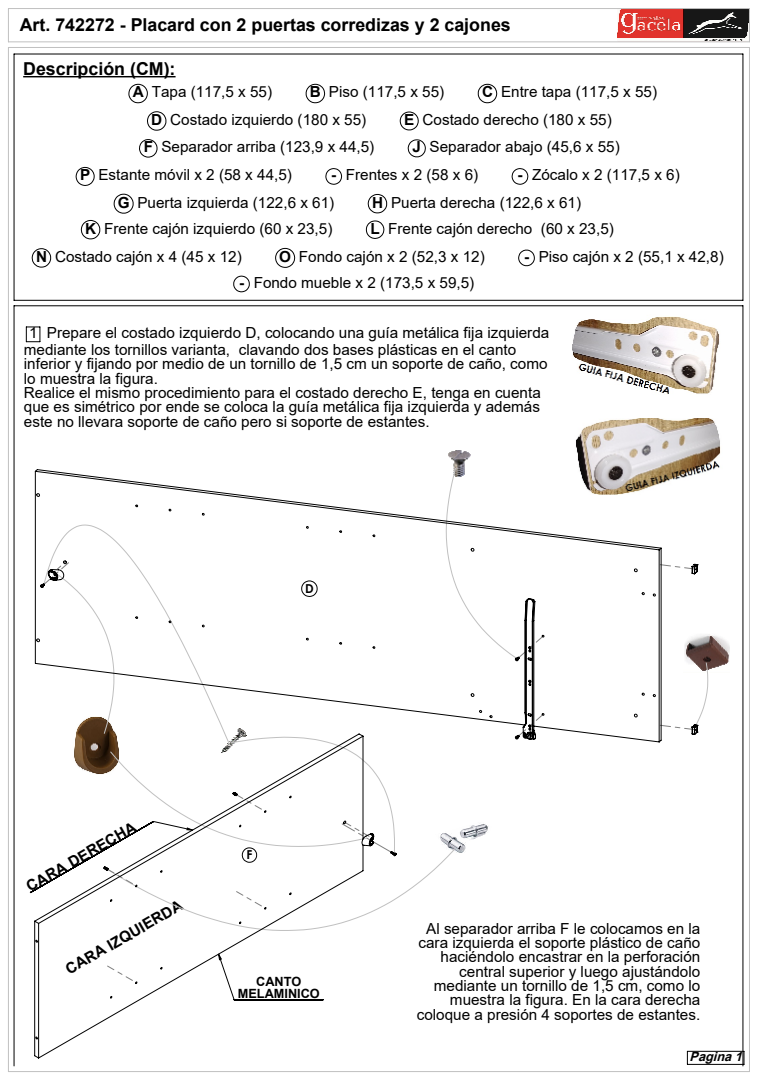
[picture p283: page 2]
CARA DERECHA; K Frente cajón izquierdo (60 x 23,5); L Frente cajón derecho (60 x 23,5); - Fondo mueble x 2 (173,5 x 59,5); G Puerta izquierda (122,6 x 61); H Puerta derecha (122,6 x 61); P Estante móvil x 2 (58 x 44,5); - Frentes x 2 (58 x 6); - Zócalo x 2 (117,5 x 6); A Tapa (117,5 x 55); B Piso (117,5 x 55); C Entre tapa (117,5 x 55); F Separador arriba (123,9 x 44,5); J Separador abajo (45,6 x 55); D Costado izquierdo (180 x 55); E Costado derecho (180 x 55); N Costado cajón x 4 (45 x 12)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

Art. 742272 - Placard con 2 puertas corredizas y 2 cajones
Descripción (CM):

mediante los tornillos varianta, clavando dos bases plásticas en el canto
inferior y fijando por medio de un tornillo de 1,5 cm un soporte de caño, como
lo muestra la figura.
Realice el mismo procedimiento para el costado derecho E, tenga en cuenta
que es simétrico por ende se coloca la guía metálica fija izquierda y además
este no llevara soporte de caño pero si soporte de estantes.

Al separador arriba F le colocamos en la
cara izquierda el soporte plástico de caño
haciéndolo encastrar en la perforación
central superior y luego ajustándolo
mediante un tornillo de 1,5 cm, como lo
muestra la figura. En la cara derecha
coloque a presión 4 soportes de estantes.

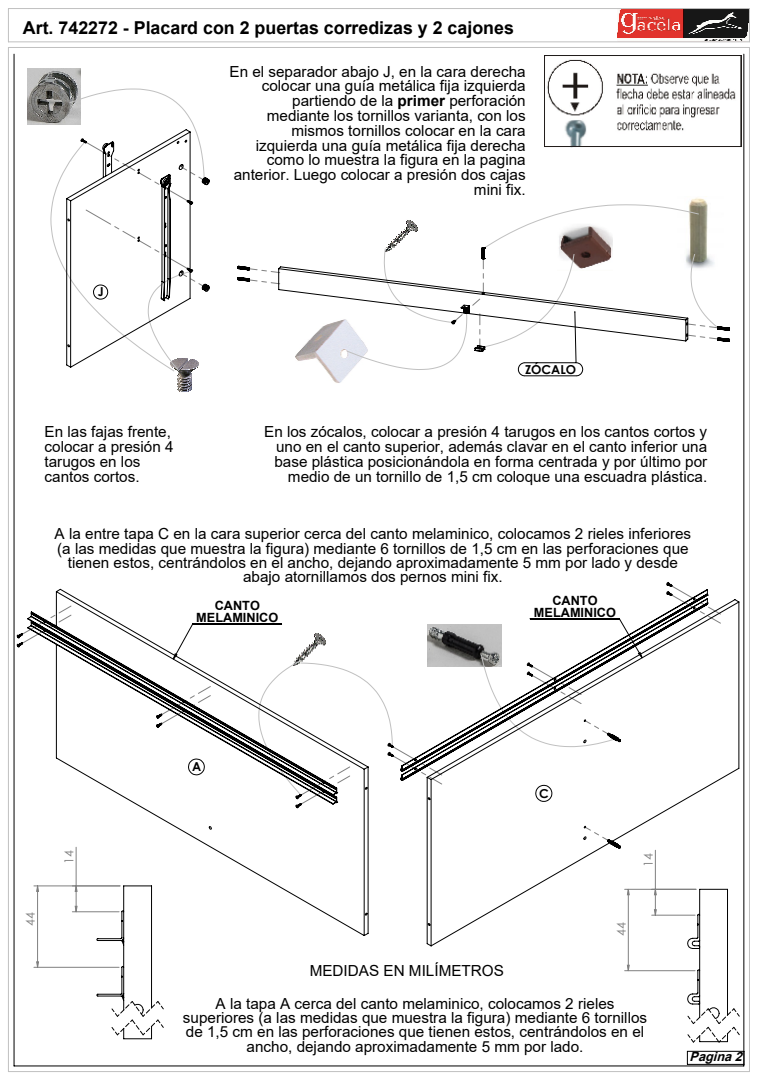
[picture p284: page 3]
mini fix.; Pagina 2

En el separador abajo J, en la cara derecha
colocar una guía metálica fija izquierda
partiendo de la primer perforación
mediante los tornillos varianta, con los
mismos tornillos colocar en la cara
izquierda una guía metálica fija derecha
como lo muestra la figura en la pagina
anterior. Luego colocar a presión dos cajas

En las fajas frente,
colocar a presión 4
tarugos en los
cantos cortos.

En los zócalos, colocar a presión 4 tarugos en los cantos cortos y
uno en el canto superior, además clavar en el canto inferior una
base plástica posicionándola en forma centrada y por último por
medio de un tornillo de 1,5 cm coloque una escuadra plástica.

A la entre tapa C en la cara superior cerca del canto melaminico, colocamos 2 rieles inferiores
(a las medidas que muestra la figura) mediante 6 tornillos de 1,5 cm en las perforaciones que
tienen estos, centrándolos en el ancho, dejando aproximadamente 5 mm por lado y desde abajo atornillamos dos pernos mini fix.

MEDIDAS EN MILÍMETROS

A la tapa A cerca del canto melaminico, colocamos 2 rieles
superiores (a las medidas que muestra la figura) mediante 6 tornillos
de 1,5 cm en las perforaciones que tienen estos, centrándolos en el
ancho, dejando aproximadamente 5 mm por lado.

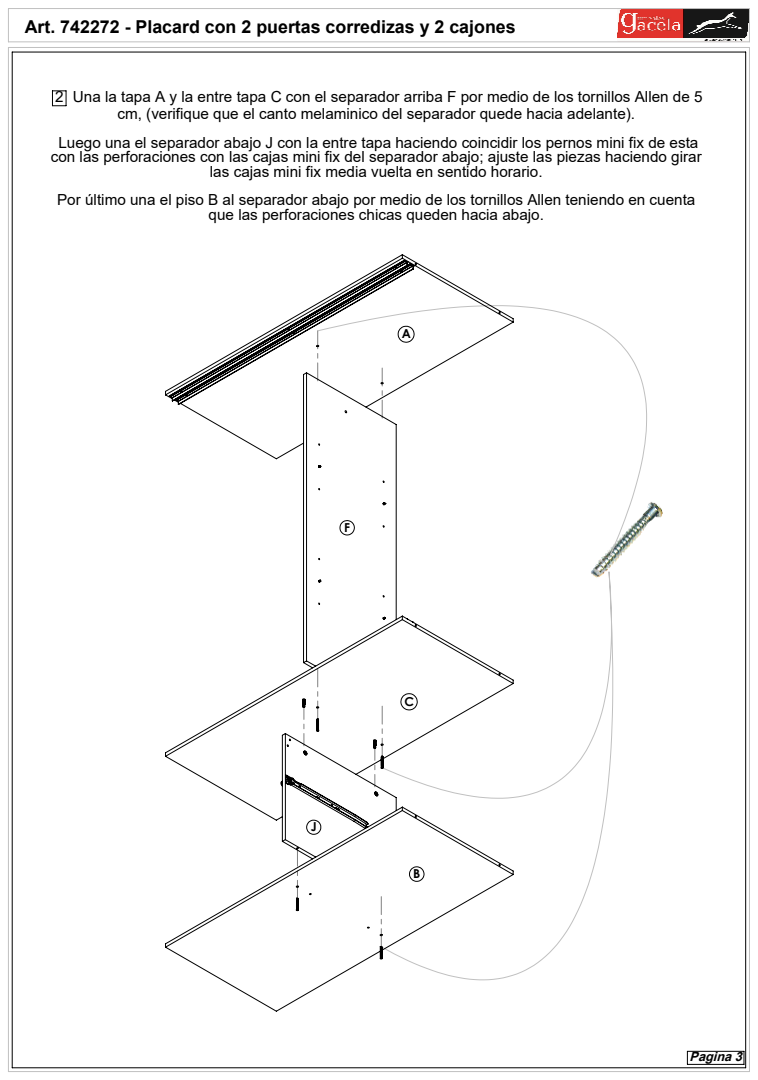
[picture p285: page 4]
Una la tapa A y la entre tapa C con el separador arriba F por medio de los tornillos Allen de 5; Pagina 3

cm, (verifique que el canto melaminico del separador quede hacia adelante).
Luego una el separador abajo J con la entre tapa haciendo coincidir los pernos mini fix de esta
con las perforaciones con las cajas mini fix del separador abajo; ajuste las piezas haciendo girar las cajas mini fix media vuelta en sentido horario.

Por último una el piso B al separador abajo por medio de los tornillos Allen teniendo en cuenta que las perforaciones chicas queden hacia abajo.

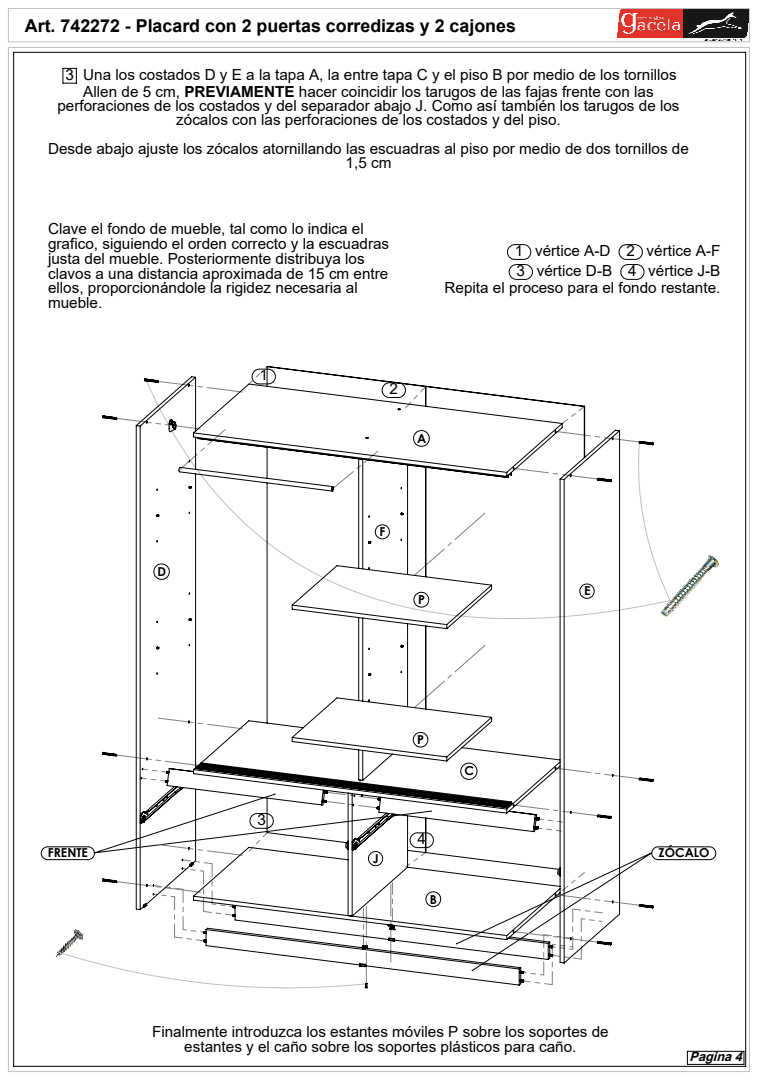
[picture p286: page 5]
1 vértice A-D 2 vértice A-F 3 vértice D-B 4 vértice J-B; Una los costados D y E a la tapa A, la entre tapa C y el piso B por medio de los tornillos; Pagina 4

Allen de 5 cm, PREVIAMENTE hacer coincidir los tarugos de las fajas frente con las perforaciones de los costados y del separador abajo J. Como así también los tarugos de los zócalos con las perforaciones de los costados y del piso.

Desde abajo ajuste los zócalos atornillando las escuadras al piso por medio de dos tornillos de

Clave el fondo de mueble, tal como lo indica el
grafico, siguiendo el orden correcto y la escuadras
justa del mueble. Posteriormente distribuya los
clavos a una distancia aproximada de 15 cm entre
ellos, proporcionándole la rigidez necesaria al
mueble.

Repita el proceso para el fondo restante.

Finalmente introduzca los estantes móviles P sobre los soportes de
estantes y el caño sobre los soportes plásticos para caño.

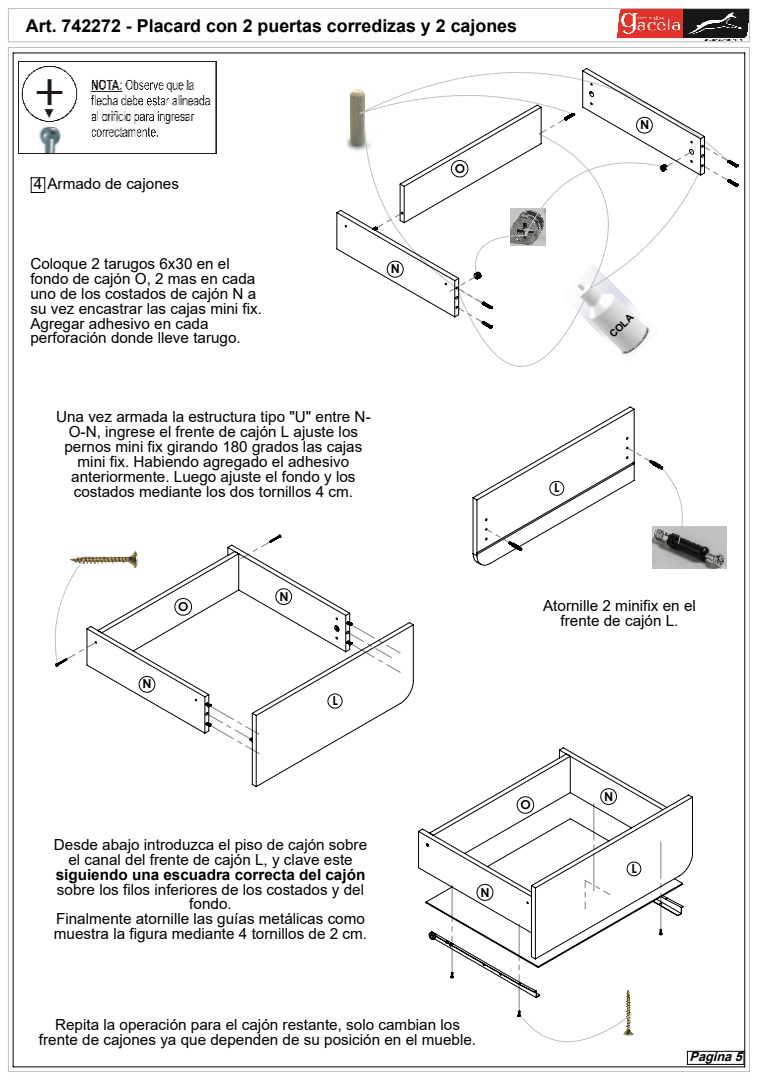
[picture p287: page 6]
Pagina 5

4 Armado de cajones

Coloque 2 tarugos 6x30 en el
fondo de cajón O, 2 mas en cada
uno de los costados de cajón N a
su vez encastrar las cajas mini fix.
Agregar adhesivo en cada
perforación donde lleve tarugo.

Una vez armada la estructura tipo "U" entre N-
O-N, ingrese el frente de cajón L ajuste los
pernos mini fix girando 180 grados las cajas
mini fix. Habiendo agregado el adhesivo
anteriormente. Luego ajuste el fondo y los
costados mediante los dos tornillos 4 cm.

Atornille 2 minifix en el
frente de cajón L.

Desde abajo introduzca el piso de cajón sobre
el canal del frente de cajón L, y clave este
siguiendo una escuadra correcta del cajón
sobre los filos inferiores de los costados y del
Finalmente atornille las guías metálicas como
muestra la figura mediante 4 tornillos de 2 cm.

Repita la operación para el cajón restante, solo cambian los
frente de cajones ya que dependen de su posición en el mueble.

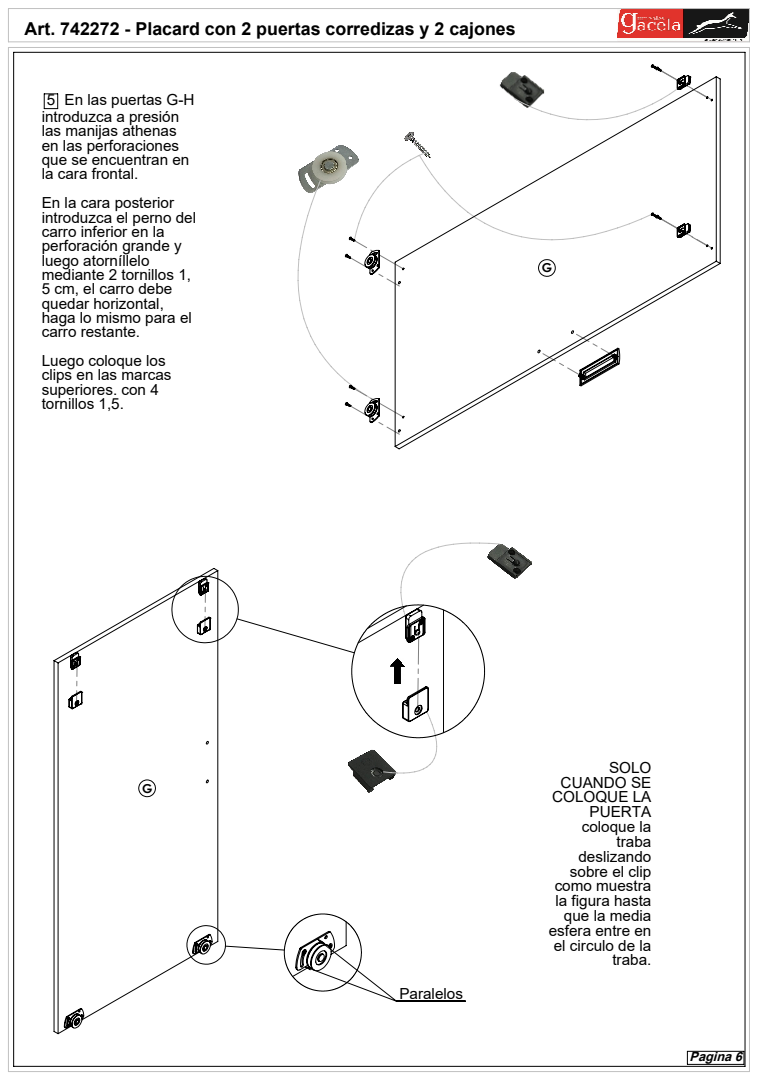
[picture p288: page 7]
Pagina 6

5 En las puertas G-H
introduzca a presión
las manijas athenas
en las perforaciones
que se encuentran en
la cara frontal.
En la cara posterior
introduzca el perno del
carro inferior en la
perforación grande y
luego atorníllelo
mediante 2 tornillos 1,
5 cm, el carro debe
quedar horizontal,
haga lo mismo para el
carro restante.
Luego coloque los
clips en las marcas
superiores. con 4
tornillos 1,5.

SOLO
CUANDO SE
COLOQUE LA
PUERTA
coloque la
traba
deslizando
sobre el clip
como muestra
la figura hasta
que la media
esfera entre en
el circulo de la
traba.

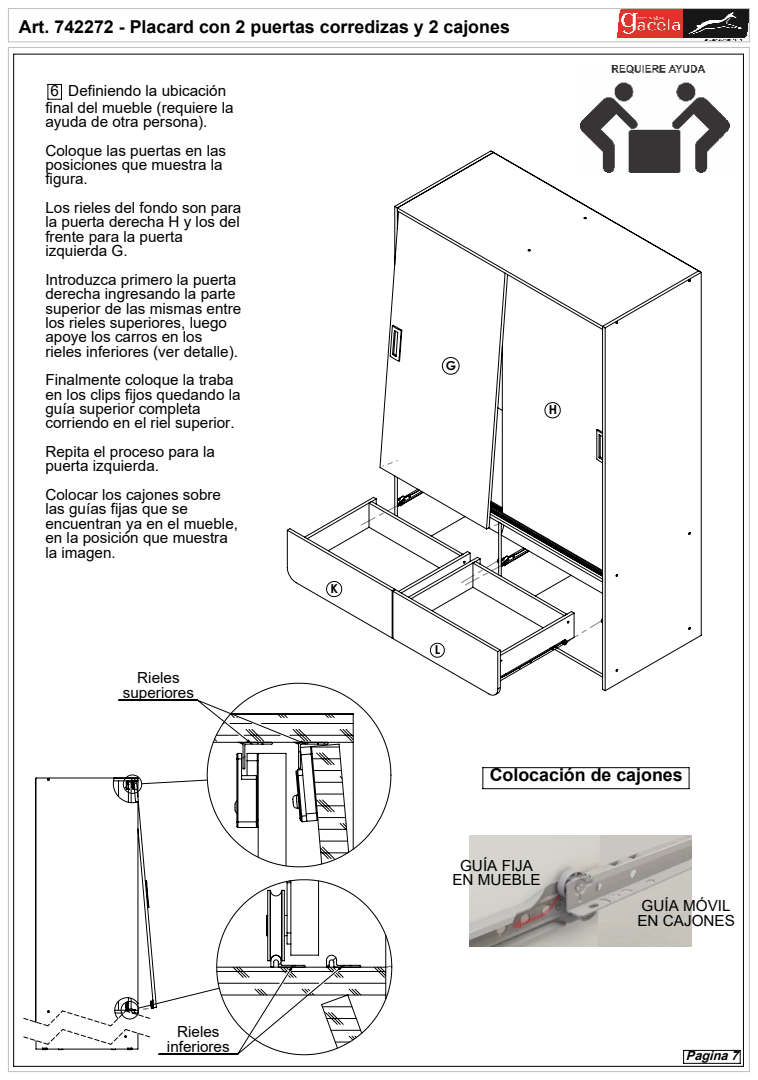
[picture p289: page 8]
GUÍA FIJA EN MUEBLE; GUÍA MÓVIL EN CAJONES; Pagina 7

6 Definiendo la ubicación
final del mueble (requiere la
ayuda de otra persona).
Coloque las puertas en las
posiciones que muestra la
figura.
Los rieles del fondo son para
la puerta derecha H y los del
frente para la puerta
izquierda G.
Introduzca primero la puerta
derecha ingresando la parte
superior de las mismas entre
los rieles superiores, luego
apoye los carros en los
rieles inferiores (ver detalle).
Finalmente coloque la traba
en los clips fijos quedando la
guía superior completa
corriendo en el riel superior.
Repita el proceso para la
puerta izquierda.
Colocar los cajones sobre
las guías fijas que se
encuentran ya en el mueble,
en la posición que muestra
la imagen.

Colocación de cajones
