infomueblesgacela/muebles-gacela-mvp/public/modelos_3d/linea-curvalba/A742273/A742273.PDF

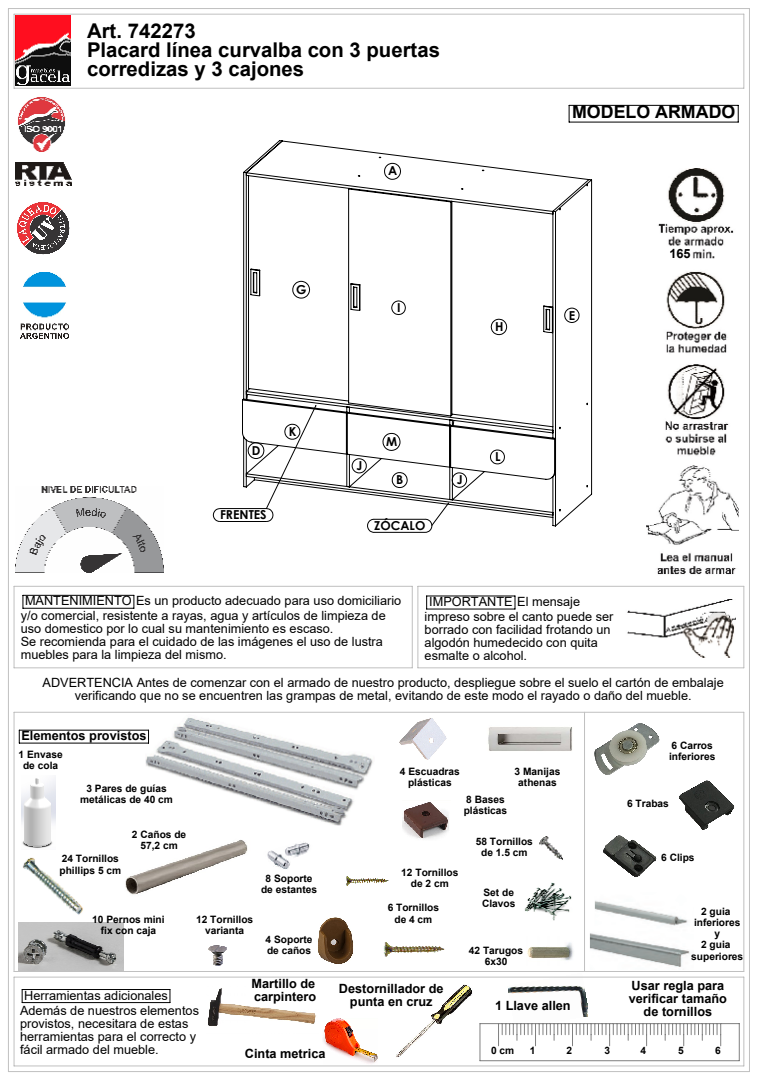
[picture p290: page 1]
ZÓCALO FRENTES; 4 Soporte de caños; 12 Tornillos de 2 cm; 42 Tarugos; Set de; carpintero; Destornillador de; Elementos provistos; MODELO ARMADO; 6 Tornillos; 12 Tornillos; 1 Envase de cola; 24 Tornillos phillips 5 cm; 58 Tornillos de 1.5 cm; 8 Soporte de estantes; verificar tamaño; 2 Caños de 57,2 cm; 4 Escuadras; 8 Bases; 3 Manijas; 2 guia; 6 Clips; 6 Trabas; 6 Carros; Cinta
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
