infomueblesgacela/muebles-gacela-mvp/(commit log)

2026-07-28 Initial clean commit (optimized size)
    [A000238-ALTA.STEP, A000557.STEP, A002381-BAJA.STEP, A005571.STEP, A005572.STEP, A008285.STEP, A008395.STEP, A009022.STEP]
2026-08-23 fix(assets): track public/articulos-gacela-muebles-2026 product images for production deployment
2026-08-24 feat(assembly): track and enable guided assembly (GaciStepByStep) assets and refine support buttons
2026-08-24 fix(copy): update design philosophy and bedroom descriptions for all 5 nightstands (mesas de luz)
2026-08-25 feat(analytics): implement GA4 standard dataLayer tracking for product views, 3D models, AR launches, assembly guides, manual downloads, and catalog filters
2026-08-25 feat(analytics): connect direct GA4 measurement stream (G-WMX6XWYNVY) with automatic view_item, 3D, AR, and assembly guide events
2026-08-30 feat: burbuja flotante de GaciBot en produccion con popup teaser y base de armado
2026-08-31 feat: persistencia total del chat y sesion de GaciBot en localStorage y sessionStorage
2026-10-18 fix(rrhh): guardar CVs en Vercel Blob privado con link firmado permanente
    tmpfiles.org borraba los CVs a los 60 minutos y el link del mail a RRHH
    quedaba vencido. Ahora el CV se guarda en el Blob privado del proyecto
    y el mail incluye un link firmado a /api/cv que no vence.
